eleanor-wsyy/EffMeet2/docs/handoff/README.md

# 交接记录入口

## 装配与硬件（现行）

[2026-10-21装配实施方案](2026-10-21-装配实施方案.md)：今晚装配执行版——跨轴 11 根、全杜邦、唯一焊点=喇叭端 2；屏接线与固件、P03 决策门、执行顺序。

机器人设计正文、BOM、模型与视觉稿统一在 [hardware/robot-design](../../hardware/robot-design/README.md)；历次打印作业包归档在 [hardware/print-jobs](../../hardware/print-jobs/README.md)。

## 软件与联调

[2026-10-20 ESP32 实机 bring-up](2026-10-20-esp32-bringup.md)：烧录、外设驱动、全链路现状与踩坑。

[2026-10-20 换机环境重建](2026-10-20-machine-switch.md)：换机后的环境重建与联调拓扑，异地演示前对照。

[2026-10-19 GitHub 新版用户端 APP 审查](2026-10-19-github-app-review.md)：远端 `apps/web` 已重写为纯本地演示版（localStorage，不接后端/音视频/ASR/AI/硬件）；建议保留功能版 `/app/`，新版作为 UI 参考或独立演示，不直接合并。

[2026-10-19路线A远程音频链路](2026-10-19-software-route-a.md)：用户端 LiveKit 入会/按需发布麦克风/离开、服务端 token 与 relay 解耦、CSP 放行；真实服务器与两端音频仍未验收。

[2026-10-16未完成软件搭框架](2026-10-16-software-scaffold.md)：ESP32 固件骨架、LiveKit 部署骨架、连续实机验收 harness，全部 NOT-VERIFIED/NOT_RUN。

[装配联调计划](2026-10-07-装配联调计划.md)（10-07；尺寸口径已被文首横幅作废）：机械装配后的功能联调七步，仍是计划而非执行记录。

[AFE 配置与双讲样例](2026-10-06-afe配置与双讲样例.md)（10-06）：AEC 目前为桩，这是后续实做时的配置与样例依据。

[场景测试用例表](2026-10-06-场景测试用例表.md)（10-06）：20 条演示/决赛前回归用例。

## 历史记录

10-05 台架交接组、10-06 任务单组、10-10 设计交接 stub 等已移入 [docs/archive/handoff/](../archive/handoff/)；旧版产品文档（整改、分工、D 端任务书等）在 [docs/archive/product/](../archive/product/)。历史记录只代表当日状态，不当作今日测试结果。

各记录按日期及模块判读；新增设计交接不自动表示软件、硬件或连续真人链路已经验收。
