eleanor-wsyy/EffMeet2/hardware/robot-design/layout-options/README.md

# 布局候选 · 二选一（2026-10-11 推出，未决策）

> **状态：两个候选并行准备，未选定。** 决策人：组长。决策前**不得下单 E04/E05，不得开模打印**。
> 本目录**不是 BOM，不替代** [round-yaw-v2/BOM.md](../round-yaw-v2/BOM.md)。BOM §12 在决策后统一更新，采购最终以 BOM §12 为准。

## 前提（两个候选共用）

- **主板走方案 W**：微雪 `ESP32-S3-CAM-OV3660`（一板替代原 E01+E02，板载 OV3660，Type-C，3.7V 充放）
- **材料**：**PLA Matte 哑光**（机身灰 / 细节黑，已下单 2 灰 + 1 黑），PETG 仅作 A1 配合验证件，普通 0.4mm 喷嘴
- **外观方向**：NOMI 球头 + 近圆黑面板 + 中央矩形 LCD 窗；形态服从功能位与实物尺寸，不反推概念图
- **打印路线**：A1 + PETG 打 1:1 配合样片 → 小件走 A1、三件大壳走学校 H2D/H2S（见 PRINT_PLAN §4.5）→ 去毛刺 → 螺接装配

## 建模先读：[`MODELING_BRIEF.md`](MODELING_BRIEF.md)

**美学锁死、工程重做。** 上一版（NOMI 方向）的审美模式原样保留，只换工程实现。
内含：美学不变量（禁止改动）、15 条「不许乱整」红线、因换主板/布局而变的工程变量、更新版功能位规格表 12 项。
旧功能位表（`archive/legacy-enclosure/EffMeet2_外壳说明_v2.md` §7）含旧尺寸 90×90×110 与旧 ±120°，**已作废**。

## 两个候选的本质差异

| | **方案 A · 板在底座** | **方案 B · 整板进头部** |
|---|---|---|
| 主板位置 | 底座 | 头部 |
| 跨轴线束 | **LCD FPC + 摄像 FPC + 电源 + 舵机 PWM + 键/灯**（多） | **电源 + 舵机 PWM + 键/灯**（少） |
| E04 / E05 | **必须买**（定长跨轴 FPC） | **删除** |
| **麦克风** | **固定在底座，拾音整间** ✅ | **随头转** ⚠️ 需改写 C06 |
| 头部重量/惯量 | 轻 | **重**，SG90 带载与 E10 供电须重核 |
| 过轴断帧/夹线风险 | **高**（两条 FPC 反复弯折） | 低 |
| 头部散热 | 无压力 | 主板在头，须核 |
| 装配复杂度 | 高 | 低 |
| 材料成本 | 多两条定长 FPC | 少 |
| 产品语义 | ✅ 麦不随头转，符合会议拾音 | ⚠️ 麦随头转，与既有结论冲突 |

## 决策判据（按权重）

1. **麦克风要不要随头转**——这是产品语义问题，不是工程问题。会议设备的麦应固定拾音整间；随头转会让转头动作改变拾音特性。
2. **过轴 FPC 能否接受反复弯折**——需要实测寿命，本轮只有 10 天，做不到 50 次循环以外的验证。
3. **SG90 带载余量**——方案 B 头部加重后，舵机啸叫/抖动若影响会议，即判不达标。

**倾向：方案 A。** 理由是判据 1 权重最高，且 A 的代价（多两条 FPC）是可控的采购与结构问题，B 的代价（麦随头转）是产品缺陷。

## 决策后必须同步修改的文档

- [ ] `round-yaw-v2/BOM.md` §12.1 末段声明（不采用微雪分支 → 采用 W + 选定布局）
- [ ] `round-yaw-v2/BOM.md` §12.2 的 E01 / E02 / E03 / E04 / E05 / E07 / E08 / E13
- [ ] `round-yaw-v2/BOM.md` §12.4 第一批清单
- [ ] `round-yaw-v2/BOM.md` §12.2 C01 机身色（白 → 灰，若最终用灰）
- [ ] `HANDOFF.md` 主板节（待定 → 已定）
- [ ] `round-yaw-v2/README.md` + `parameters.json`（标注封装布局需按选定布局重做）
- [ ] `manifest.json` **不动状态字段**（AGENTS.md：未验证项不能改写成已完成）
- [ ] 未选中的候选目录移入 `archive/`

## 与本目录相关的红线

- 本目录两个候选都是**计划**，不是已完成、不是 PASS、不是制造放行
- 不得以任一候选的尺寸反推当前 `round-yaw-v2/` 的 .blend 结论
- 两个候选的采购清单有**互斥项**（E04/E05），下单前必须先决策
