eleanor-wsyy/EffMeet2/hardware/robot-design/round-yaw-v2/fit-coupons/README.md

# 上机样片包 · 外观/材料样片 + 1:1 公差阶梯

> **材料用 PLA Matte 灰（2026-10-12 已到货）**——用它打，选出的公差档就是正式件的档位。
> 黑色 PLA Matte 尚未到货；以下 5 件**颜色无关**（A0 球冠模拟的头壳本身就是灰色），**用灰料全打**。
> **在自有 A1 打**，不必占用学校机时（学校留给三件灰料大壳）。
> PETG 仅在 PLA 未到货时作过渡；**PETG 的档位不能直接当正式料档位**（收缩率不同）。

## A0_appearance_coupon.stl —— 外观／材料样片（**先打这个**）

单件，148×97×54mm，落在平台上（Z 0→53.8），一盘可打完。

| 部位 | 验什么 |
|---|---|
| **球冠 R70 × Ø88** | **曲面质量与层纹**（贴近头壳曲率 70mm 量级）——判断哑光观感是否可接受 |
| **45° 悬臂** | **支撑痕**（需支撑，看接触面质量） |
| **2.4mm 薄壁** | 名义壁厚是否透光/变形 |
| **孔阶梯 Ø2/3/4/5/6** | 小孔成形质量 |
| **R4 圆角块** | 倒角/圆角表面 |
| **竖直平面** | 层线密度与均匀度 |

**判据**：PRINT_PLAN 要求「样片接受裸打哑光后才继续」。**这一件就是那个判据的载体。**
- 接受 → 记录层高/朝向参数，采买正式件
- 不接受 → 换层高/朝向重打，或重估外观预期

**切片起点**：0.2mm 层高、3–4 墙、20–30% 填充、**开启支撑**（45°悬臂需要）、平放不加裙边。

---

**用途**：验「装不装得进、哪一档公差合适、装配顺序对不对」。**不验最终材料强度。**
最终公差要在正式材料（PLA Matte）上再打一组同尺寸复验。
生成脚本：`generate_fit_coupons.py`（Blender 无头，`blender --background --python generate_fit_coupons.py`）。

尺寸来源：`BOM.md` §12.2 —— M02 轴承 6806 = **内径 30 / 外径 42 / 厚 7**；M01 舵机 MG90S 本体 **22.8×12.2×28.5**；转轴名义外径 **46**；头-底座间距 **14**。

---

## 01_bearing_OD_ladder.stl — 轴承外圈压配（188×52×7）

四档 Ø42 孔，从左到右：

| 位置 | 孔径 | 用途 |
|---|---|---|
| 1（最左） | **Ø42.0** | 名义值，通常过紧 |
| 2 | **Ø42.2** | |
| 3 | **Ø42.4** | 通常最接近可用 |
| 4（最右） | **Ø42.6** | 偏松 |

**怎么判**：手压轴承外圈进孔。**能推进去、不晃、不裂**的最小那档就是设计值。
⚠️ **不许用锤子强装**——PLA/PETG 脆，强压会裂（`BOM.md` M04 明确要求分体夹紧/螺接，不做强过盈）。

## 02_bearing_ID_and_shaft_ladder.stl — 内圈/轴配合（208×52×7）

从左到右：

| 位置 | 孔径 | 用途 |
|---|---|---|
| 1 | **Ø30.0** | 轴承内圈名义 |
| 2 | **Ø30.1** | |
| 3 | **Ø30.2** | |
| 4（最右） | **Ø46.0** | **转轴名义外径校核** |

**怎么判**：Ø30 三档试轴承内圈 / 轴肩；Ø46 试转轴外径是否打得准。

## 03_servo_pocket_and_wall.stl — 舵机口袋 + 壁厚/孔质量（90×70×6）

| 部位 | 内容 |
|---|---|
| 左半凹槽 | **MG90S 口袋 22.8×12.2，深 5mm** |
| 凹槽两侧 | 舵机固定耳孔 **Ø3.2**（间距 32mm，**按实测再调**） |
| 右上一排 | 通孔阶梯 **Ø2 / Ø3 / Ø4 / Ø5 / Ø6** |
| 右下窄梁 | **2.4mm 名义壁厚**（看层纹与强度观感） |

**怎么判**：舵机能不能落进口袋、耳孔对不对得上、孔是否圆、壁厚梁是否透光/开裂。

## 04_shortneck_clearance.stl — 短颈裙边间隙（Ø58×14）

外径 Ø58（= 46 轴 + 两侧各 6 壁）、内孔 **Ø46**、**高度 14 = 头-底座真实间距**。

**怎么判**：套在转轴上看 14mm 这段里裙边能不能藏住、又留出诚实间隙（见 [`../MODELING_BRIEF.md`](../MODELING_BRIEF.md) §1.5：装饰裙边必须与底座有可见间隙，不许焊死、不许为好看缩间距）。

---

## 上机安排（2026-10-12）

**分两盘**（A1 256³）：

| 盘 | 件 | 层高 | 支撑 | 说明 |
|---|---|---|---|---|
| **盘1** | `A0_appearance_coupon` | 0.2mm（可另跑 0.16 对比） | **开** | 单独一盘，看观感；95×148，居中 |
| **盘2** | `01` + `02` + `03` + `04` | 0.2mm | 不需要 | 01(188×52) 与 02(208×52) 上下叠放，03(90×70) 与 04(58×58) 并排放下方 |

> 盘2 总占约 208×174，A1 摆得下。两盘都可一次跑完。

## 打印参数（PLA Matte 为主）

| 项 | 建议 |
|---|---|
| 材料 | **PLA Matte（正式料）**；PLA 未到货时 PETG 过渡 |
| 层高 | 配合样片 0.2mm；**外观样片可试 0.16 / 0.2 对比** |
| 墙 | 3–4 |
| 填充 | 20–30%（样片不需要实心） |
| 支撑 | 仅 A0 的 45° 悬臂需要；配合样片不需要 |
| 朝向 | 平放，孔轴朝 Z |

## 旧表（保留）

| 项 | 建议 |

| 项 | 建议 |
|---|---|
| 层高 | 0.2mm |
| 墙 | 3–4 |
| 填充 | 20–30%（样片不需要实心） |
| 支撑 | 不需要（全是通孔/开口朝上） |
| 朝向 | **平放**，孔轴朝 Z |
| 材料 | 见上 |

## 打完记录

把结果写进 `TEST_RECORD_TEMPLATE.csv`，或直接记：

```
01 轴承外圈：Ø42.__ 合适 / 02 内圈：Ø30.__ 合适 / 02 轴径 Ø46 实测 __
03 舵机口袋：松紧 __ / 耳孔对位：对/差 __mm
04 短颈 14mm：间隙 OK / 夹线 OK
```

**这四档里挑出来的数值，就是后面正式建模 `parameters.json` 要写进去的设计值。**
