eleanor-wsyy/EffMeet2/hardware/robot-design/round-yaw-v2/stl/README.md

# 历史STL草案：不是v4打印放行包

保留本目录既有STL用于追溯。它们由旧build_print_parts.py生成，不能对应当前GOOUU／NOMI-v4的屏窗、头颈接收、动态走线和真实支架。

**不要直接整机打印／下单。** 当前入口见[新版v4](../revision-20261011-nomi-layoutA/README.md)，正式打印条件见[PRINT_PLAN](../PRINT_PLAN.md)。配合样片可在核尺寸和打印安全后单独试验，不代表全件通过。
