eleanor-wsyy/EffMeet2/hardware/enclosure/EffMeet2_外壳说明_v2.md

# 外壳说明v2（历史入口）

原文已移至[历史外壳说明](../robot-design/archive/legacy-enclosure/EffMeet2_外壳说明_v2.md)。

当前圆润转头版见[统一README](../robot-design/README.md)、[交接说明](../robot-design/HANDOFF.md)及[当前BOM](../robot-design/round-yaw-v2/BOM.md)。旧说明不是当前外观/打印规格。
