eleanor-wsyy/EffMeet2/hardware/robot-design/round-yaw-v2/GOOUU-BOARD-SPEC.md

# GOOUU ESP32-S3-CAM · 硬件规格（建模依据）

> **⚠️ 2026-10-13 v6/A2 口径更新（优先于下文 v4 内容）：** 核心板装在**头部**（旧"板在底座"作废）；**电池/TP4056 推迟到路线B/决赛，本轮不装、不买**；**扩展板实测 95×87×12 放不下，v6 不装**；底座内腔与整机按 v6/A2 重建（153×139.4×200.8）。下文 §4.5/§5/§6 的扩展板与电池讨论仅作历史。

> **安装安全补充（v4）：** 采购与下单记录保持不变。排针上存在GPIO不等于可随意分配；摄像／SPI触摸／I2S／PSRAM／启动脚／LED必须统一核表。HSD028309丝印和14针只能支持SPI推断，不能证明驱动型号或实际针序。TP4056保护版不是5V升压、也不自动支持安全边充边用；Demo默认外置5V，电池独立运行另验。扩展板未实测，当前模型不声称它放得下。

> 来源：淘宝「深圳市轩特佳电子」商品页 + 官方尺寸图/引脚图抓取，2026-10-12。
> **当前采购口径。** 微雪 ESP32-S3-CAM-OV3660 的评估已归档到 `archive/waveshare-board-eval-20261012/`。

---

## 0. 一句话结论

**买得到、明天到、尺寸已知（62.6×28.3mm），但没有板载音频**——麦克风/功放/电池管理要靠外接模块补。
选它的唯一理由是**交付速度**：微雪那块省事得多（板载双麦 + 音频编解码），但国内拿货要等。

---

## 1. 商品与采购

| 项 | 值 |
|---|---|
| 商品 | **GOOUU ESP32-S3-CAM 核心开发板**（+ 可选扩展板） |
| 店铺 | 深圳市轩特佳电子（4.7 分、7 蓝冠） |
| 销量/口碑 | **已售 2000+、评价 700+、近 3 月好评 100%**、回头客 140 |
| 价格 | 单板 **¥7 起**；**已下单套装 ¥86.5** |
| 物流 | **今日发、次日 18 点前到**（深圳→广州） |
| 售后 | 7 天无理由、极速退款 |
| 链接 | https://item.taobao.com/item.htm?id=865566019186 |
| **下单记录** | **2026-10-12 已下单 SKU ⑩「核心板+OV3660+扩展板+2.8寸TFT」，¥86.5，预计次日达** |

### 该选哪个 SKU

| SKU | 买？ |
|---|---|
| **核心板+OV3660+扩展板+2.8寸TFT** | ✅ **已下单（¥86.5）**——一套齐、有实拍在跑 |
| ESP32-S3-CAM（带 OV3660 摄像头） | 备选：不想带扩展板/屏时选这个 |
| ESP32-S3-CAM 单板（不带摄像头） | ❌ 没镜头 |
| ESP32-S3-N16R8 模组 | ❌ 只是裸模组 |
| 单独扩展板 | 按需，见 §5 |

---

## 2. 板体尺寸（尺寸图实测标注）**建模直接可用**

| 参数 | 数值 |
|---|---|
| **板长** | **62.6 mm** |
| **板宽** | **28.3 mm** |
| 排针内侧间距 | 24.7 mm |
| 排针间距 | 2.54 mm（标准） |
| 摄像头 | 经 FPC 连出，**镜头突出量待实物实测** |
| Type-C 凸出量 | **待实物实测** |

---

## 3. 引脚（全部 GPIO 引出到 2.54mm 排针）

| 位置 | 引脚 |
|---|---|
| 左列（上→下） | `3V3` `G4` `G5` `G6` `G7` `G15` `G16` `G17` `G18` `G3` `G46` `G9` `G10` `G11` `G12` `G13` `G14` |
| 右列（上→下） | `3V3` `G43` `G44` `G1` `G2` `G42` `G41` `G40` `G39` `G38` `G37` `G36` `G35` `G0` `G45` `G48` `G47` `G21` `G19` `G20` |
| 底部 | `5V` `RST` `BOOT` `GND` + USB |

**关键**：`G10–G14` 都在排针上 → **I2S 可以用**（外接麦克风与功放）。
`G0` 是 BOOT 键，可复用为停止键。

---

## 4. 板载有什么 / 没有什么

| 有 | 没有（必须外接） |
|---|---|
| ESP32-S3-**N16R8**（16MB Flash + 8MB PSRAM） | ❌ **麦克风** |
| 摄像头 FPC 座（OV2640/OV3660/OV5640 可选） | ❌ **音频编解码（ES8311/ES7210）** |
| **USB Type-C**（+ 另一 USB 口） | ❌ **功放（NS4150B）** |
| TF 卡槽 | ❌ **喇叭接口** |
| **W2812B RGB 灯** | ❌ **电池充放管理** |
| 0.96″ OLED 座 | ❌ 18PIN LCD 专用座（屏经排针接） |
| 45 GPIO / SPI / **I2S** / I2C / PWM / RMT / ADC / UART | |

**⚠️ 对方案的影响**：「可核对的会后记录」依赖麦克风拾音，本板无麦 → 必须外接，**这是选它付出的代价**。

---

## 4.5 套装里额外含「扩展板」——体积要留意（历史讨论；v6 结论：不装）

商品实拍显示：核心板插在**扩展板**上，扩展板带屏幕座、Type-C、蓝色接线端子、排针，2.8″ TFT 直接插上即可运行。

**v6 结论（2026-10-13）：扩展板实测 95×87×12，放不下，不装。** 以下决策点仅作历史：
- ~~用扩展板：省接线、有屏幕座，但整体体积大，底座内腔 180×164×76 塞不塞得下要算~~（旧 v4 内腔；v6/A2 已重建为整机 153×139.4×200.8）
- 不用扩展板：核心板直接排线接屏与模块 ← **v6 采用这条**

## 5. 外接件（v6 实配：麦＋功放；电池/TP4056 推迟）

| 件 | 型号 | 数量 | 作用 | 参考价 |
|---|---|---|---|---|
| I2S 麦克风 | **INMP441** | **2** | 双麦拾音（替代板载麦阵列） | ¥8–15/个 |
| I2S 功放 | **MAX98357A** | 1 | 接喇叭播放提醒 | ¥8–12 |
| 锂电充电／保护 | **TP4056**（带保护） | **0（推迟）** | v6 不装；路线B/决赛再议 | — |

**代价（如实记录）**：
- 多 3 类模块 + 接线，比微雪方案麻烦
- **AEC 更难**：无硬件回声参考通路，只能软件兜底
- 双麦阵列要自己搭，声学通道自己设计
- **C06 麦孔不再按整板开**，改为按 **INMP441 模块**安装位开

---

## 6. 对建模的直接结论

| 项 | 结论 |
|---|---|
| **板体尺寸** | ✅ **62.6 × 28.3 mm**，可立即开腔体 |
| 摄像头 | 经 FPC 外接，**镜头位置由实际安装方式定**，到货实测 |
| 麦克风 | 装 **INMP441 ×2**，固定在**底座**（不随头转；v6 布局A2：麦/功放/喇叭/舵机/按键都在底座） |
| 喇叭 | MAX98357 → 扬声器，底座前部声槽不变 |
| 电池 | **不装**（v6 外供 5V≥2A；TP4056＋锂电推迟到路线B/决赛） |
| 屏 | **2.8″ TFT 带触摸（随套装）**：面板丝印 `HSD028309 A6`；**单排 14 针 J2 连接器** → 判定为 **SPI**（高置信度，非规格书）；标准分配 VCC/GND/CS/RESET/DC/MOSI/SCK/BL/MISO + 触摸 5 线 |
| 停止键 | 复用板载 `BOOT(G0)` 或另接轻触开关 |
| 舵机 PWM | 核空闲可输出GPIO及启动／摄像／屏／音频占用后用LEDC/RMT |

---

## 7. 仍缺的（到货当天实测）

| 缺项 | 怎么拿 |
|---|---|
| 镜头突出量 | 卡尺实测 |
| Type-C 凸出量 | 实测 |
| 摄像头 FPC 出口方向与长度 | 实测 |
| 扩展板外形尺寸（若用） | 实测 |
| INMP441 / MAX98357 模块外形 | 到货实测 |

---

## 8. 参考

| 资源 | 地址 |
|---|---|
| 商品页 | https://item.taobao.com/item.htm?id=865566019186 |
| 资料网盘（含烧录视频教程） | 见商品图文详情 |
| 微雪方案评估（已归档，未采用） | `archive/waveshare-board-eval-20261012/WAVESHARE-BOARD-SPEC.md` |

> **未采用微雪的原因**：国内拿货要等（官方店海外仓/代理链路），赶不上 10.21。
> 若后续微雪国内现货到位，其**板载双麦 + ES8311/ES7210 + NS4150B** 明显更省事，可再评估切换。
