eleanor-wsyy/EffMeet2/hardware/robot-design/round-yaw-v2/MODELING_BRIEF.md

> **v5/v4 均为历史；当前见 [v6](revision-20261011-nomi-layoutA/print-split-v6/README.md)。** 本文以下为 v4 建模任务书，仅作追溯。

# 建模更新任务书 · 美学锁死 / 工程重做（2026-10-11 · 布局 A 已定案）

> **⛔ 历史建模任务书（v4，2026-10-11）。** 现行执行是 v6 布局A2（板/屏/摄像头在头部）、32 件；**TP4056/电池推迟、扩展板不装**。尺寸以 parameters.json 与 [v6 README](revision-20261011-nomi-layoutA/print-split-v6/README.md) 为准；下文的 180×164×222、Ø106、1:1 传动与 TP4056 预留仅供追溯。

> **原则：上一版（NOMI 方向）的审美模式原样保留；只换工程实现。**
> 来源：`round-yaw-v2/concept/nomi-aligned-20261010/prompt.txt`（审美契约原文）+ `round-yaw-v2/EXTERIOR_ASSEMBLY_REVISION.md`（组装接口）。
> **本文件不是 CAD、不是制造放行、不是实机验收。** 未验证项一律不得标 PASS。

---

## 0. 为什么写这份

工程方案变了（主板 Korvo → **GOOUU ESP32-S3-CAM**，屏/相机/线材随之更换），但**外观审美不许跟着乱动**。
仓库里 `archive/legacy-enclosure/EffMeet2_外壳说明_v2.md` §0.1 记着 v3-a 的失败教训：

> 「仅用形态描述建模……结果**功能全丢**。**教训：形态描述会压倒功能描述，功能必须逐项显式点名。**」

本次的对偶风险是反过来的：**工程改造会压倒审美**。所以这份文件把审美先锁死，再改工程。

---

# 第一部分 · 美学不变量（**禁止改动**）

以下逐条摘自已认可的 NOMI 方向审美契约。**建模时逐条对账，任何一条不满足即打回。**

## 1.1 头部形态

- 近球形、轻微压扁的柔软头部，名义 **150 × 128 × 144 mm**
- 灰色PLA Matte柔和外壳，**真实球面侧体量、圆剪影**
- **禁止方脸颊、方形侧壁**
- 分模缝细、零件边界极少
- 头部几何可极轻微朝上，但**不得增加任何俯仰机构**
- **禁止**：椭圆肖像框、圆角方屏、巨大白额头上的小黑药丸

## 1.2 面部语言（这是审美核心）

- **Ø104–108 mm 圆形黑面板**，居中偏前，周围只留克制的白壳边
- 必须读作「球头上的一个黑圆」，**不是**显示屏、**不是**圆角矩形监视器
- 圆面板是**哑光打印炭黑板**（PLA Matte 裸打），**不是**圆屏、**不是**玻璃罩、**不是**光学透明片
- 中央是**真实矩形 LCD 贯通窗**；屏面接近齐平，矩形边是**低对比细缝**，近看才隐约可见
- **禁止**：粗凸起的矩形边框、大面积高光圆片、曲面玻璃、宣称"完美 OLED 黑"

## 1.3 眼睛

- **只有两只**，在矩形 LCD 有效区**内**（不得溢出 49mm 屏宽）
- 暖白色、柔和弯月形闭眼/微笑，或简单直立小椭圆，表情松弛
- **眼睛是视觉焦点**——不是"小平板贴在大盘子上"
- **禁止**：嘴、文字、其他 UI 元素

## 1.4 摄像头与隐私

- 小镜头 + **物理滑动遮罩**，位于圆面板内**上部居中**
- 低对比黑细节，融入深色板；镜头近看可见，滑盖齐平
- **禁止**：明显方块徽章、把摄像头移到白额头、为视觉隐藏而删掉隐私操作

## 1.5 转颈（短、藏）

- **极短居中 yaw 接头**，轴外径名义 **46 mm**，头-底座真实间距 **14 mm**
- 克制的嵌套壳/领口 + 阴影间隙，把转轴**藏在球头下缘**
- 装饰裙边**必须与固定底座有诚实间隙**——不焊死、不悬空飘头
- **禁止**：高白管/黑管、为藏转轴而缩小真实机械间距、把裙边与底座粘连成环

## 1.6 底座

- 软圆灰色椭圆鹅卵石，**180 × 164 × 76 mm + 2mm 黑硅胶脚垫**
- 产品总高约 **222 mm**；**头部明显比底座窄**
- 平滑宽肩、下缘圆角，**有实质内部体积**
- **禁止**：薄的 NOMI 车机垫、花瓶细腰、第二层叠底座
- 保留既有上盖/杯体细缝，可拆修

## 1.7 开孔与细节

- **扬声器**：直接开在下前白壳，**3–4 条短槽、宽约 35–40 mm**，**无对比色喇叭徽章**
- **麦克风**：小而安静的开孔
- **停止键**：前肩部**小齐平帽**
- **状态指示**：**微小暖珊瑚色短划**（在底座）——不是环形灯带、不是 RGB 灯带
- **外供电**从**后部固定底座**进入，**无可见乱线**
- 硅胶脚垫薄、黑、大部分隐蔽

## 1.8 材质与质感

- **灰 + 黑，未喷漆哑光 PLA Matte**，裸打，**全部打印件同一种料**（件数以拆分结果为准）
- 真实细聚合物纹理 + 细微规则层纹
- **禁止**：绒面 / 石膏 / 水泥质感
- 圆面板的反光**只应来自里面的矩形 LCD**——不得把打印面做成/画成光学玻璃
- **PLA Matte 热变形约 55℃**：结构设计不得依赖高温工况；散热缝与内部风道仍按 §第四部分 保留

---

# 第二部分 · 「不许乱整」红线清单

任何一条命中即打回重做：

| # | 禁止项 |
|---|---|
| 1 | 加耳、帽、手臂、金属饰条、品牌标识 |
| 2 | 砂磨、补土、喷漆、退火、喷漆服务 |
| 3 | 激光切割亚克力/PC 透明罩、圆屏/AMOLED、LED 灯带 |
| 4 | 复制 NOMI 商标、车内安装、音乐图标、吐舌表情 |
| 5 | 带回上一轮的「小横窗 / 大白脸颊」 |
| 6 | 做成椭圆肖像框或圆角方屏 |
| 7 | 把摄像头移到白额头 |
| 8 | 为藏转轴而缩小真实机械间距（14mm 不许动） |
| 9 | 为好看而缩孔、缩小声槽、盖住麦孔 |
| 10 | 移动实板麦孔去迎合图上的对称装饰 |
| 11 | 把 PLA Matte 打印面做成/画成玻璃或高光 |
| 12 | 用涂料修补装不上的接口 |
| 13 | 编造爆炸图、制造放行、实机验收结论 |
| 14 | **只写形态描述不逐条点名功能位**（v3-a 原罪） |
| 15 | **让工程改动吃掉上表第一部分的任何一条**（本次的对偶风险） |

---

# 第三部分 · 工程变量（本次真正要改的）

## 3.1 因换主板而变

| 项 | 原（Korvo） | 新（GOOUU ESP32-S3-CAM） | 对建模的影响 |
|---|---|---|---|
| 主板 | Korvo-2 V3.1（底座） | **GOOUU ESP32-S3-CAM（62.6×28.3mm，含 OV3660）** | 板体尺寸已知，**预留盒按此重做** |
| 屏 | 乐鑫 Korvo-2-LCD 2.4″（有效区约 49×37mm） | **2.8″ SPI TFT（240×320）** | **圆面板 Ø104–108 与中央矩形窗按 240×320 竖放重算**；1.2 的面板语言保持不变 |
| 摄像头 | 外接 OV2640 | **OV3660 经 FPC 接板** | 镜头为**独立模组**，安装位由我们定；面板开孔按实际安装迁就，不为对称好看挪孔 |
| USB | Micro-USB | **Type-C** | 底座侧面浅凹槽**重开**（1.7 的位置语言不变） |
| 舵机 PWM | 可能要 E13 扩展板 | LEDC/RMT 直出 | E13 删除，内部空间释放 |
| 电池 | 无 | **3.7V 锂电 + TP4056 模块** | 底座内部容积/重心重算 |
| 音频 | ES7210/ES8311/NS4150B | **GOOUU 板无音频** → 外接 **INMP441×2 + MAX98357** | 麦/喇叭全部外接；**AEC 只能软件兜底，风险高于原方案** |

## 3.2 布局 A（已定案）带来的工程变量

| 项 | 内容 |
|---|---|
| 主板位置 | **底座**（与电源、电池、扬声器、舵机同舱） |
| 头部腔体 | **只装 LCD + 摄像头**（轻，利于转头） |
| 跨轴通道 | **LCD（E04，SPI 6–8 芯）+ 摄像（E05）** + 电源 + 舵机 PWM + 键/灯。引脚与尺寸见 [`GOOUU-BOARD-SPEC.md`](GOOUU-BOARD-SPEC.md) |
| **麦克风** | **固定在底座上缘，不随头转**（C06 维持原结论） |
| 扬声器 | 底座前下，3–4 条短槽 |
| 散热 | 底座内主板 + 电源，背部细缝保留 |
| 头部重量 | 轻，SG90 带载宽松 |

**美学不变量在布局 A 下不变**——开孔的归属件固定为：麦孔/声槽/USB/状态短划在底座，屏窗/镜头/滑盖在头部。

---

# 第三部分之二 · 建模任务清单（布局 A，逐件）

> 按 AGENTS.md：保留原生 Screw/Boolean 控制、分件与姿态依赖；未验证项不得标 PASS；不导出伪参数 CAD。
> **前置：板体尺寸已知（62.6×28.3mm）**，可直接开腔体；镜头/Type-C/FPC 出口到货实测后回填。

| # | 零件 | 要做什么 | 关键约束 |
|---|---|---|---|
| 1 | **头壳** | 腔体只容纳 LCD＋摄像头（轻）；预留 FPC 过轴通道与弯折半径；**镜头开孔坐标由实板决定** | 过轴孔不得夹线；内悬垂可取支撑；面罩口 Ø104–108 不变 |
| 2 | **底座杯体** | 容纳 GOOUU 主板、TP4056+锂电、5V 电源、扬声器、舵机、按钮；**预留 INMP441×2 麦模块位与 2 路声孔** | 板柱/出声孔/麦孔直接建入 CAD；底面朝下、杯口朝上 |
| 3 | **底座上盖** | 保留可拆接缝 + 转轴孔；承力区局部加肋 | 接缝藏于隐藏面 |
| 4 | **圆形黑面板** | 近圆黑框 + 中央真实矩形 LCD 窗贯通 | **窗尺寸按新屏（E02′）重算**；屏自带面板露出，不做透明盖 |
| 5 | **短颈** | 颈内藏边 + 两条 FPC 通过空间 | 与头壳接收面配作；裙边留诚实间隙 |
| 6 | **轴承座 ×2** | 按 6806（30×42×7）实尺寸 | **分体夹紧/螺接**，不做强过盈；先打轴配合样片 |
| 7 | **舵机架** | 按 MG90S 实测固定耳/花键 | 不自造未经核验的花键 |
| 8 | **轮毂/连接盘** | 与轴承座、舵盘配合 | 螺接，不胶粘定位 |
| 9 | **同齿数带轮 ×2** | 齿形 + 中央孔按实测 | 先验证齿形/花键连接 |
| 10 | **滑盖/按钮帽/线夹/硬声学通道** | 同批黑料小件 | 滑槽行程靠试片调 |
| 11 | **过轴通道结构（A 特有）** | LCD SPI + 摄像排线的固定、导向、防夹、限弯 | 线序到货点清后定；仍须 1:1 打样验证 50 次循环 |
| 12 | **parameters.json** | 记录新腔体/孔位/过轴尺寸 | 未实测项标 `unverified` |

### 建模顺序（按风险）

1. **过轴通道 + 头壳 LCD/摄像支架**——先证布局 A 成立
2. 底座杯体（主板/电池/扬声器/麦孔布局）
3. 面板 + 短颈 + 上盖
4. 受力件（轴承座/舵机架/轮毂）
5. 小件

### 验收要点

| 项 | 通过标准 |
|---|---|
| **过轴 FPC 寿命** | 连续 50 次 ±45° 转向无断屏/断帧/断线（**第一验收项**） |
| 夹线 | 转动全程不夹线、不磨线 |
| 转向 | 1–2s 单次、头角误差 ≤3°、无啸叫影响会议 |
| **麦克风拾音** | **底座固定双麦**，1m 正常说话可转写、3m 小声触发 AGC |
| AEC | 重测（换板必做）；初赛不阻塞，决赛 11.5 前必须 |

---

# 第四部分 · 功能位规格表（更新版，建模强制输入）

> 原表见 `archive/legacy-enclosure/EffMeet2_外壳说明_v2.md` §7，含**旧尺寸 90×90×110 与旧 ±120°**，已作废。
> 下表按当前 round-yaw-v2 尺寸与 NOMI 审美契约重写，**建模时逐条点名**。

| # | 功能位 | 位置 | 数量/规格 | 可见性 | 本次变更 |
|---|---|---|---|---|---|
| 1 | 圆形黑面板 | 头部正面居中 | **Ø104–108mm** 哑光打印炭黑板 | 外露 | 面板直径起点不变；**中央矩形窗按新屏重算** |
| 2 | 双眼 | 矩形 LCD 有效区内下部 | 左右各 1，暖白弯月/小椭圆 | 屏内显示 | 屏变则眼距按比例；**不得溢出屏宽** |
| 3 | 摄像头 | 圆面板内**上部居中** | 1 颗小型广角 | 近看可见 | **改板载 OV3660，开孔坐标由实板决定** |
| 4 | 遮罩拨片 | 镜头旁 | 1 个上下拨动拨片 | 外露可拨 | 随板载镜头位置重排 |
| 5 | 停止/静音键 | **前肩部** | 1 个小齐平帽 | 外露 | 不变（B 则信号过轴） |
| 6 | 状态指示 | **底座前部** | 1 条微小暖珊瑚短划 | 外露发光 | 不变；**不是环灯带**（B 则信号过轴） |
| 7 | 舵机颈段 | 头与底座之间 | 短颈 + 轴外径约 46mm，**±45°** | 外露，裙边留诚实间隙 | **腔内走线通道按 A/B 重做**；间距 14mm 不许动 |
| 8 | 麦克风 | **底座上缘（布局 A）** | **2× INMP441 模块**，安装位由我们定 | 微孔可见 | **模块外接**，不随头转；开孔按模块尺寸 |
| 9 | 扬声器开孔 | **A：底座前下 / B：待定** | 3–4 条短槽，宽 35–40mm | 槽可数 | **不加对比色徽章**；开孔率/声腔另测 |
| 10 | USB-C | 底座侧面 | 1 个，带浅凹槽 | 外露 | **Micro-USB → Type-C，凹槽重开** |
| 11 | 散热缝 | 背部中线 | 1 条细长缝 | 外露 | 不变；**B 方案内部加散热路径** |
| 12 | 硅胶脚垫 | 底面 | 1 圈环形约 2mm | 底部 | 不变 |

**建模 prompt 必带句式**（替代旧的 90×90×110 版本）：

> 形态比例（**180×164×222mm**，头 150×128×144，底座 180×164×76+2mm）+ 上表 12 项**逐条点名** + 材质（灰色哑光 PLA Matte 裸打 / 炭黑哑光 PLA Matte 面板 / 屏内暖白眼睛 + 底座微小珊瑚短划）+ 纯中性背景。
> **只写「圆润造型 + 黑面板」会丢掉全部功能位。**

---

# 第五部分 · 建模作业约束（按 AGENTS.md）

- 保留模型**原生 Screw/Boolean 控制**、分件与姿态依赖
- 新建模遵循适用 Blender 技能；不以预览动画代替固件验收
- `parameters.json` 与现有 `.blend` 的旧检查证据**不改写**；新参数另记并标 `unverified`
- `manifest.json` 的 `stage` **保留 `reversible_blockout`**（枚举）；`manufacturing_ready` / `hardware_validated` **保持 false**
- 不导出伪参数 CAD（不把三角网格换后缀充当 STEP）
- **导出白名单**：只导出已完成结构的零件；排除 MAINBOARD/LCD/CAMERA/SERVO/BEARING/SPEAKER 代理、KEEP_OUT 与布尔控制

## 建模顺序

1. **先无电测件**：新屏总厚度/有效区、板载镜头突出量、FPC 出口方向、Type-C 凸出量
2. **圆面板 + 矩形窗**（审美核心，先定死）
3. 头部腔体（按 A 或 B）
4. 短颈 + 转轴接收面（14mm 间距、46mm 轴径）
5. 底座杯体 + 上盖
6. 受力件（轴承座/舵机架/轮毂/带轮）
7. 小件（滑盖/按钮帽/线夹/声学通道）
8. 更新 `parameters.json`（新参数标 unverified）

---

# 第六部分 · 与本文件配套

| 文件 | 关系 |
|---|---|
| `concept/nomi-aligned-20261010/prompt.txt` | **审美契约原文**，本文件第一部分的来源 |
| `round-yaw-v2/EXTERIOR_ASSEMBLY_REVISION.md` | 组装接口与装入顺序 |
| `layout-options/README.md` | A/B 二选一与决策判据 |
| `layout-options/layout-A-base-board.md` / `layout-B-head-board.md` | 各布局的采购 + 建模包 |
| `archive/legacy-enclosure/EffMeet2_外壳说明_v2.md` §7 | **旧功能位表（含旧尺寸/±120°，作废）** |

**已定**：布局 A、机身灰/细节黑（PLA Matte 已下单）、打印走 A1 + 学校机器分工、主板 GOOUU（**板体 62.6×28.3mm 已知**）。**可开工**：不依赖摄像/屏实物的零件先建；腔体按 62.6×28.3 预留，实物差异到货回填。
