eleanor-wsyy/EffMeet2/hardware/robot-design/layout-options/layout-B-head-board.md

# 方案 B · 整板进头部（2026-10-11 候选，未决策）

> **状态：候选，未选定。** 决策前**不得开模**。
> 本文件不是 BOM；采购最终以 `round-yaw-v2/BOM.md` §12（决策后更新）为准。

**一句话**：微雪整板连 LCD、摄像头、麦克风全进头部；底座只留舵机、电源、电池、按钮/灯。跨轴只剩电源 + 舵机 PWM + 键/灯等低速细线，**E04/E05 可删**。代价是**麦克风随头转**、头部加重。

---

## 1. 采购清单

### 1.1 与方案 A 共用（两套都要买，可先下）

| ID | 物料 | 数量 | 参考 | 备注 |
|---|---|---|---|---|
| E01 | **微雪 ESP32-S3-CAM-OV3660** | 1 | ≈¥180 | **必须 OV3660 版**（带硬件 JPEG；GC 系列没有） |
| E02′ | 微雪 18PIN FPC 屏模块 | 1 | 待定 | 2.0″ 或 2.8″，**必须先拿接口定义再下单** |
| E06 | 4Ω/3W 扬声器 ≤Ø40×18 | 1 | — | **本方案放头部**，深度约束更紧，须核头部容积 |
| E07 | Type-C 数据线 | 1 | 复用 | 烧录/日志，必须传数据 |
| E08 | Type-C 供电线 | 1 | 复用 | 足够电流 + 插头弯曲空间 |
| E09 | 5V/≥2A 合规电源 | 1 | 复用 | 不是裸无保护板 |
| E10 | 舵机独立稳压供电 + 保护线 | 1套 | — | **本方案头部加重，须核额定与压降** |
| E11 | 轻触开关 / 板载 MUTE 引出 | 1套 | — | **键位在底座，信号须过轴** |
| E12 | 板载状态灯 + 导光窗 | 0 新增 | — | **灯在底座，信号须过轴** |
| 新增 | 3.7V 锂电池（板载充放） | 1 | 待定 | 演示可脱线 |
| M01 | MG90S 位置舵机 | 1 | — | **本方案带载更大，啸叫/抖动须实测** |
| M02 | 6806-2Z/ZZ 轴承 30×42×7 | 2 | — | 旧 56×18 预留不保证仍在 |
| M03 | 打印同齿数带轮 + GT2 带 | 2 + 1 | — | 长度按 CAD |
| M04 | PLA Matte 轴承座/舵机架/轮毂 | 各1套 | — | 与外壳同材同喷嘴，螺接 |
| M05 | 软行程 + 机械挡块 | 左右各1 | — | 软目标 ±45° |
| M07 | 线夹 + 柔性护套 | 1套 | — | **走线按本方案重做**（只剩细线） |
| M08 | 接插件/线材/绝缘件 | 小套装 | — | 杜邦线不作最终活动线束 |
| M09 | M2.5/M3 螺钉、安装柱、黄铜嵌件 | 小套装 | — | 定长螺钉等实板 |
| C01 | 头壳 / 底座杯体 / 上盖 | 各1 | PLA Matte 灰 | **腔体结构按本方案重切** |
| C02 | 近圆黑面板（面罩框） | 1 | PLA Matte 黑 | 中央矩形 LCD 窗贯通，不采购透明板 |
| C03 | 隐私滑盖 + 打印导向 | 1套 | PLA Matte 黑 | 同批打印 |
| C04 | 按钮帽 + LED 出光小孔 | 1 + 0 | PLA Matte 黑 | 取消第三色/喷漆 |
| C05 | 闭孔硅胶/EPDM 声学垫片 | 小片 | 买现成片材 | 不打印密封圈 |
| C06 | **头部**麦声孔通道 + 密封片 | 2路 | — | **孔位按实板；麦随头转，C06 必须改写** |
| C07 | 防滑硅胶片 ≈2mm | 1份裁切 | 买现成 | |
| **料** | PLA Matte 灰 + 黑 | 已下单 2 灰 + 1 黑 | 拓竹官方店 | **全件同料**；A1 配合样片另用现有 PETG |
| **料** | PETG | 1卷（有则不买） | | 仅 A1 配合验证件 |
| **喷嘴** | 0.4mm 硬化钢（H2S） | 1 | | 优先学校已有；玻纤料必须硬化 |

### 1.2 方案 B 特有

| ID | 物料 | 数量 | 备注 |
|---|---|---|---|
| **M08-B** | 过轴低速细线束（电源 + 舵机 PWM + 键 + 灯） | 1套 | 比 FPC 容易做，可用常规线 + 软护套 |
| **C01-B 散热** | 头壳内散热路径（导热垫/风道预留） | 按需 | 主板在头，先按被动散热设计 |

### 1.3 本方案**删除**（这是 B 的主要收益）

| ID | 原方案 | 为什么删 |
|---|---|---|
| **E04** | LCD 跨轴 FPC | 屏与板同在头部，无跨轴 |
| **E05** | 摄像跨轴 FPC | 同上 |
| **E13** | PWM 扩展板 | LEDC/RMT 直出 |

### 1.4 本方案不买

- 圆屏/AMOLED、PC/PAHT-CF/PPA-CF、亚克力/PC 透明面板、喷漆补土、激光切割
- 零位传感器、配重、滑环、连续旋转舵机、RGB 环带

---

## 2. 建模任务清单

> 按 AGENTS.md：保留原生 Screw/Boolean 控制、分件与姿态依赖；未验证项不得标 PASS；不导出伪参数 CAD。
> 前置：**先拿到微雪板体尺寸图 + 18PIN 屏接口定义 + 镜头位置 + 板载麦孔位置**，再动手。

| # | 零件 | 本方案要做什么 | 关键约束 |
|---|---|---|---|
| 1 | **头壳** | 腔体容纳 **主板 + LCD + 摄像头 + 双麦 + 扬声器**（重）；镜头开孔坐标**由实板决定**；**麦声孔在头壳**（C06）；散热路径 | **本方案最大风险点：容积与重量**；内悬垂可取支撑 |
| 2 | **底座杯体** | 只留舵机、5V 电源、3.7V 电池、按钮/灯；容积压力小 | 底面朝下、杯口朝上 |
| 3 | **底座上盖** | 保留可拆接缝 + 转轴孔 | 与头壳接收面配作 |
| 4 | **圆形黑面板** | 近圆黑框 + 中央真实矩形 LCD 窗贯通 | 屏尺寸随 E02′ 实物 |
| 5 | **短颈** | 颈内藏边 + 低速细线通过空间 | 线少，比 A 好做 |
| 6 | **轴承座 ×2** | 按 6806（30×42×7）实尺寸 | 先打轴配合样片 |
| 7 | **舵机架** | 按 MG90S 实测固定耳/花键 | **头部加重后须复核带载** |
| 8 | **轮毂/连接盘** | 与轴承座、舵盘配合 | 螺接，不胶粘定位 |
| 9 | **同齿数带轮 ×2** | 齿形 + 中央孔按实测 | 先验证齿形/花键连接 |
| 10 | **滑盖 / 按钮帽 / 线夹 / 硬声学通道** | 同批黑料小件 | 滑槽行程靠试片调 |
| 11 | **过轴细线通道（B 特有）** | 电源 + PWM + 键/灯 的固定、导向、限弯 | 比 A 简单，但仍要防夹 |
| 12 | **散热路径（B 特有）** | 头壳被动散热（导热垫/风道预留） | 不承诺主动散热 |
| 13 | **parameters.json 更新** | 记录新腔体/孔位/重量 | 未实测项标 unverified |

### 建模顺序（按风险）

1. **头壳容积与重量核算**——先证 B 方案装得下且转得动
2. 头壳 LCD/摄像/麦孔/散热
3. 底座杯体（舵机/电源/电池）
4. 面板 + 短颈 + 上盖
5. 受力件（轴承座/舵机架/轮毂）
6. 小件

---

## 3. 验收要点（本方案特有）

| 项 | 通过标准 | 说明 |
|---|---|---|
| **头部重量/惯量** | 装整头后 SG90 仍能 1–2s 转向、头角误差 ≤3°、无明显啸叫抖动影响会议 | **本方案第一验收项**；不达标即判不通过 |
| 转动连续 50 次 | 无断屏/断帧/复位/夹线 | |
| **麦克风拾音** | **头部双麦随头转**——转头时拾音特性变化须实测并写入说明 | ⚠️ **C06 必须改写**；不得宣称"转头实现指向性拾音" |
| 温升 | 30 分钟组合运行记录板端压降与头部温升 | 被动散热不够即须改结构 |
| AEC | 重测（换板 + 麦位变化） | **比 A 更需要重测**；初赛不阻塞，决赛 11.5 前必须 |

---

## 4. 工期影响

| 环节 | 说明 |
|---|---|
| 采购 | 无定长 FPC，**全部可第一批下**，不压节点 |
| 建模 | 头壳容积/重量/散热是新增核算，但少做一条过轴通道 |
| 打印 | 无额外 |
| 装配 | 穿线简单，约省 0.5 天 |
| **合计** | 比方案 A 约**省 1 天**，但多出麦随头转的产品问题 |

**风险**：头部加重导致 SG90 带载不达标 / 啸叫影响会议 —— 这是本方案的硬风险。
**缓释**：先用现有 SG90 打 1:1 头部配重件试转，不达标就退回方案 A（此时 A 的 FPC 尚未下单，回退窗口仍在）。

---

## 5. 若采用本方案，必须改写的既有文档

- `round-yaw-v2/BOM.md` **C06**：「板载双麦固定在**底座**」→「固定在**头部**」
- 删除同条中的「**麦克风不随头转**，不能宣称通过转头实现指向性拾音」——**该结论在 B 下不成立，须改为"麦随头转，转头会改变拾音特性"**
- `TEST_GUIDE` T07/T08：拾音验收增加"转头工况"测试
- `EffMeet2_判断样例与提示文案_v1.md` §3.3 状态表：不受影响，但 `apps/web` 与产品说明中"现场拾音"的表述须复核
