eleanor-wsyy/EffMeet2/hardware/robot-design/layout-options/MODELING_BRIEF.md

# 建模更新任务书 · 美学锁死 / 工程重做（2026-10-11）

> **原则：上一版（NOMI 方向）的审美模式原样保留；只换工程实现。**
> 来源：`round-yaw-v2/concept/nomi-aligned-20261010/prompt.txt`（审美契约原文）+ `round-yaw-v2/EXTERIOR_ASSEMBLY_REVISION.md`（组装接口）。
> **本文件不是 CAD、不是制造放行、不是实机验收。** 未验证项一律不得标 PASS。

---

## 0. 为什么写这份

工程方案变了（主板 Korvo → 微雪 ESP32-S3-CAM-OV3660，屏/相机/线材随之更换），但**外观审美不许跟着乱动**。
仓库里 `archive/legacy-enclosure/EffMeet2_外壳说明_v2.md` §0.1 记着 v3-a 的失败教训：

> 「仅用形态描述建模……结果**功能全丢**。**教训：形态描述会压倒功能描述，功能必须逐项显式点名。**」

本次的对偶风险是反过来的：**工程改造会压倒审美**。所以这份文件把审美先锁死，再改工程。

---

# 第一部分 · 美学不变量（**禁止改动**）

以下逐条摘自已认可的 NOMI 方向审美契约。**建模时逐条对账，任何一条不满足即打回。**

## 1.1 头部形态

- 近球形、轻微压扁的柔软头部，名义 **150 × 128 × 144 mm**
- 白 / 米白柔和外壳，**真实球面侧体量、圆剪影**
- **禁止方脸颊、方形侧壁**
- 分模缝细、零件边界极少
- 头部几何可极轻微朝上，但**不得增加任何俯仰机构**
- **禁止**：椭圆肖像框、圆角方屏、巨大白额头上的小黑药丸

## 1.2 面部语言（这是审美核心）

- **Ø104–108 mm 圆形黑面板**，居中偏前，周围只留克制的白壳边
- 必须读作「球头上的一个黑圆」，**不是**显示屏、**不是**圆角矩形监视器
- 圆面板是**哑光打印炭黑板**（PLA Matte 裸打），**不是**圆屏、**不是**玻璃罩、**不是**光学透明片
- 中央是**真实矩形 LCD 贯通窗**；屏面接近齐平，矩形边是**低对比细缝**，近看才隐约可见
- **禁止**：粗凸起的矩形边框、大面积高光圆片、曲面玻璃、宣称"完美 OLED 黑"

## 1.3 眼睛

- **只有两只**，在矩形 LCD 有效区**内**（不得溢出 49mm 屏宽）
- 暖白色、柔和弯月形闭眼/微笑，或简单直立小椭圆，表情松弛
- **眼睛是视觉焦点**——不是"小平板贴在大盘子上"
- **禁止**：嘴、文字、其他 UI 元素

## 1.4 摄像头与隐私

- 小镜头 + **物理滑动遮罩**，位于圆面板内**上部居中**
- 低对比黑细节，融入深色板；镜头近看可见，滑盖齐平
- **禁止**：明显方块徽章、把摄像头移到白额头、为视觉隐藏而删掉隐私操作

## 1.5 转颈（短、藏）

- **极短居中 yaw 接头**，轴外径名义 **46 mm**，头-底座真实间距 **14 mm**
- 克制的嵌套壳/领口 + 阴影间隙，把转轴**藏在球头下缘**
- 装饰裙边**必须与固定底座有诚实间隙**——不焊死、不悬空飘头
- **禁止**：高白管/黑管、为藏转轴而缩小真实机械间距、把裙边与底座粘连成环

## 1.6 底座

- 软圆白椭圆鹅卵石，**180 × 164 × 76 mm + 2mm 黑硅胶脚垫**
- 产品总高约 **222 mm**；**头部明显比底座窄**
- 平滑宽肩、下缘圆角，**有实质内部体积**
- **禁止**：薄的 NOMI 车机垫、花瓶细腰、第二层叠底座
- 保留既有上盖/杯体细缝，可拆修

## 1.7 开孔与细节

- **扬声器**：直接开在下前白壳，**3–4 条短槽、宽约 35–40 mm**，**无对比色喇叭徽章**
- **麦克风**：小而安静的开孔
- **停止键**：前肩部**小齐平帽**
- **状态指示**：**微小暖珊瑚色短划**（在底座）——不是环形灯带、不是 RGB 灯带
- **外供电**从**后部固定底座**进入，**无可见乱线**
- 硅胶脚垫薄、黑、大部分隐蔽

## 1.8 材质与质感

- **灰 + 黑，未喷漆哑光 PLA Matte**，裸打，**全 14 件同一种料**
- 真实细聚合物纹理 + 细微规则层纹
- **禁止**：绒面 / 石膏 / 水泥质感
- 圆面板的反光**只应来自里面的矩形 LCD**——不得把打印面做成/画成光学玻璃
- **PLA Matte 热变形约 55℃**：结构设计不得依赖高温工况；散热缝与内部风道仍按 §第四部分 保留

---

# 第二部分 · 「不许乱整」红线清单

任何一条命中即打回重做：

| # | 禁止项 |
|---|---|
| 1 | 加耳、帽、手臂、金属饰条、品牌标识 |
| 2 | 砂磨、补土、喷漆、退火、喷漆服务 |
| 3 | 激光切割亚克力/PC 透明罩、圆屏/AMOLED、LED 灯带 |
| 4 | 复制 NOMI 商标、车内安装、音乐图标、吐舌表情 |
| 5 | 带回上一轮的「小横窗 / 大白脸颊」 |
| 6 | 做成椭圆肖像框或圆角方屏 |
| 7 | 把摄像头移到白额头 |
| 8 | 为藏转轴而缩小真实机械间距（14mm 不许动） |
| 9 | 为好看而缩孔、缩小声槽、盖住麦孔 |
| 10 | 移动实板麦孔去迎合图上的对称装饰 |
| 11 | 把 PLA Matte 打印面做成/画成玻璃或高光 |
| 12 | 用涂料修补装不上的接口 |
| 13 | 编造爆炸图、制造放行、实机验收结论 |
| 14 | **只写形态描述不逐条点名功能位**（v3-a 原罪） |
| 15 | **让工程改动吃掉上表第一部分的任何一条**（本次的对偶风险） |

---

# 第三部分 · 工程变量（本次真正要改的）

## 3.1 因换主板而变

| 项 | 原（Korvo） | 新（微雪 ESP32-S3-CAM-OV3660） | 对建模的影响 |
|---|---|---|---|
| 主板 | Korvo-2 V3.1（底座） | 微雪单板（含摄像头） | 板体尺寸/孔位/高度全变，**预留盒重做** |
| 屏 | 乐鑫 Korvo-2-LCD 2.4″（有效区约 49×37mm） | 微雪 18PIN FPC 屏（2.0″ 或 2.8″） | **圆面板 Ø104–108 与中央矩形窗必须按新屏重算**；1.2 的面板语言保持不变 |
| 摄像头 | 外接 OV2640，可自由定位 | **板载 OV3660，镜头位置由板决定** | **面板上部开孔坐标迁就实板**，不得为对称好看挪孔 |
| USB | Micro-USB | **Type-C** | 底座侧面浅凹槽**重开**（1.7 的位置语言不变） |
| 舵机 PWM | 可能要 E13 扩展板 | LEDC/RMT 直出 | E13 删除，内部空间释放 |
| 电池 | 无 | **新增 3.7V 锂电** | 底座内部容积/重心重算 |
| 音频 | ES7210/ES8311/NS4150B | **相同芯片组** | 麦/扬声器接法可迁移；**AEC 必须重测** |

## 3.2 因布局 A/B 而变（二选一，见 `layout-options/`）

| | **A · 板在底座** | **B · 整板进头部** |
|---|---|---|
| 头部腔体 | 只装 LCD + 摄像头（轻） | 装主板 + LCD + 摄像 + 麦 + 扬声器（重） |
| 底座腔体 | 主板 + 电源 + 电池 + 扬声器 + 舵机 | 舵机 + 电源 + 电池 |
| 跨轴通道 | **LCD FPC + 摄像 FPC** + 电源 + PWM + 键灯 | 只剩电源 + PWM + 键灯 |
| **麦克风位置** | **底座上缘**（1.7 的"安静开孔"在底座） | **头部**（随头转，须改写 C06） |
| 扬声器位置 | 底座前下 | 可能上移至头部 |
| 散热 | 无压力 | **需加强**（背部细缝 1.7 保留，内部加散热路径） |
| 头部重量 | 轻 | **重**，须复核 SG90 带载 |

**美学不变量在 A/B 下都不变**——只是开孔的**归属件**（头壳还是底座）不同。

---

# 第四部分 · 功能位规格表（更新版，建模强制输入）

> 原表见 `archive/legacy-enclosure/EffMeet2_外壳说明_v2.md` §7，含**旧尺寸 90×90×110 与旧 ±120°**，已作废。
> 下表按当前 round-yaw-v2 尺寸与 NOMI 审美契约重写，**建模时逐条点名**。

| # | 功能位 | 位置 | 数量/规格 | 可见性 | 本次变更 |
|---|---|---|---|---|---|
| 1 | 圆形黑面板 | 头部正面居中 | **Ø104–108mm** 哑光打印炭黑板 | 外露 | 面板直径起点不变；**中央矩形窗按新屏重算** |
| 2 | 双眼 | 矩形 LCD 有效区内下部 | 左右各 1，暖白弯月/小椭圆 | 屏内显示 | 屏变则眼距按比例；**不得溢出屏宽** |
| 3 | 摄像头 | 圆面板内**上部居中** | 1 颗小型广角 | 近看可见 | **改板载 OV3660，开孔坐标由实板决定** |
| 4 | 遮罩拨片 | 镜头旁 | 1 个上下拨动拨片 | 外露可拨 | 随板载镜头位置重排 |
| 5 | 停止/静音键 | **前肩部** | 1 个小齐平帽 | 外露 | 不变（B 则信号过轴） |
| 6 | 状态指示 | **底座前部** | 1 条微小暖珊瑚短划 | 外露发光 | 不变；**不是环灯带**（B 则信号过轴） |
| 7 | 舵机颈段 | 头与底座之间 | 短颈 + 轴外径约 46mm，**±45°** | 外露，裙边留诚实间隙 | **腔内走线通道按 A/B 重做**；间距 14mm 不许动 |
| 8 | 麦克风 | **A：底座上缘 / B：头部** | 按实板双麦孔位（不照抄 20 孔阵） | 微孔可见 | **A/B 分叉点**；B 须改写 C06 |
| 9 | 扬声器开孔 | **A：底座前下 / B：待定** | 3–4 条短槽，宽 35–40mm | 槽可数 | **不加对比色徽章**；开孔率/声腔另测 |
| 10 | USB-C | 底座侧面 | 1 个，带浅凹槽 | 外露 | **Micro-USB → Type-C，凹槽重开** |
| 11 | 散热缝 | 背部中线 | 1 条细长缝 | 外露 | 不变；**B 方案内部加散热路径** |
| 12 | 硅胶脚垫 | 底面 | 1 圈环形约 2mm | 底部 | 不变 |

**建模 prompt 必带句式**（替代旧的 90×90×110 版本）：

> 形态比例（**180×164×222mm**，头 150×128×144，底座 180×164×76+2mm）+ 上表 12 项**逐条点名** + 材质（灰色哑光 PLA Matte 裸打 / 炭黑哑光 PLA Matte 面板 / 屏内暖白眼睛 + 底座微小珊瑚短划）+ 纯中性背景。
> **只写「圆润造型 + 黑面板」会丢掉全部功能位。**

---

# 第五部分 · 建模作业约束（按 AGENTS.md）

- 保留模型**原生 Screw/Boolean 控制**、分件与姿态依赖
- 新建模遵循适用 Blender 技能；不以预览动画代替固件验收
- `parameters.json` 与现有 `.blend` 的旧检查证据**不改写**；新参数另记并标 `unverified`
- `manifest.json` 的 `stage / manufacturing_ready / hardware_validated` **保持 false**
- 不导出伪参数 CAD（不把三角网格换后缀充当 STEP）
- **导出白名单**：只导出已完成结构的零件；排除 MAINBOARD/LCD/CAMERA/SERVO/BEARING/SPEAKER 代理、KEEP_OUT 与布尔控制

## 建模顺序

1. **先无电测件**：新屏总厚度/有效区、板载镜头突出量、FPC 出口方向、Type-C 凸出量
2. **圆面板 + 矩形窗**（审美核心，先定死）
3. 头部腔体（按 A 或 B）
4. 短颈 + 转轴接收面（14mm 间距、46mm 轴径）
5. 底座杯体 + 上盖
6. 受力件（轴承座/舵机架/轮毂/带轮）
7. 小件（滑盖/按钮帽/线夹/声学通道）
8. 更新 `parameters.json`（新参数标 unverified）

---

# 第六部分 · 与本文件配套

| 文件 | 关系 |
|---|---|
| `concept/nomi-aligned-20261010/prompt.txt` | **审美契约原文**，本文件第一部分的来源 |
| `round-yaw-v2/EXTERIOR_ASSEMBLY_REVISION.md` | 组装接口与装入顺序 |
| `layout-options/README.md` | A/B 二选一与决策判据 |
| `layout-options/layout-A-base-board.md` / `layout-B-head-board.md` | 各布局的采购 + 建模包 |
| `archive/legacy-enclosure/EffMeet2_外壳说明_v2.md` §7 | **旧功能位表（含旧尺寸/±120°，作废）** |

**待你醒来一并定的三件事**：布局 A/B、机身色（官方灰 已有货 / 白）、打印机约 H2D 还是 H2S。
