eleanor-wsyy/EffMeet2/hardware/robot-design/layout-options/layout-A-base-board.md

# 方案 A · 板在底座（2026-10-11 候选，未决策）

> **状态：候选，未选定。** 决策前**不得下单 E04/E05，不得开模**。
> 本文件不是 BOM；采购最终以 `round-yaw-v2/BOM.md` §12（决策后更新）为准。

**一句话**：主板、电源、电池、扬声器、舵机全在底座；头部只留 LCD + 摄像头，靠两条 FPC 跨轴送上去。**麦克风固定在底座，不随头转。**

---

## 1. 采购清单

### 1.1 与方案 B 共用（两套都要买，可先下）

| ID | 物料 | 数量 | 参考 | 备注 |
|---|---|---|---|---|
| E01 | **微雪 ESP32-S3-CAM-OV3660** | 1 | ≈¥180 | **必须 OV3660 版**（带硬件 JPEG；GC 系列没有） |
| E02′ | 微雪 18PIN FPC 屏模块 | 1 | 待定 | 2.0″ 或 2.8″，**必须先拿接口定义再下单** |
| E06 | 4Ω/3W 扬声器 ≤Ø40×18 | 1 | — | 板若含喇叭也不能直接用，须按尺寸/声腔独立确认 |
| E07 | Type-C 数据线 | 1 | 复用 | 烧录/日志，必须传数据 |
| E08 | Type-C 供电线 | 1 | 复用 | 足够电流 + 插头弯曲空间 |
| E09 | 5V/≥2A 合规电源 | 1 | 复用 | 不是裸无保护板 |
| E10 | 舵机独立稳压供电 + 保护线 | 1套 | — | MG90S 按 4.8V 基线，不默认喂 6V |
| E11 | 轻触开关 / 板载 MUTE 引出 | 1套 | — | 停止播报用，不承诺硬件断麦 |
| E12 | 板载状态灯 + 导光窗 | 0 新增 | — | 状态表冻结后再定灯色 |
| 新增 | 3.7V 锂电池（板载充放） | 1 | 待定 | 演示可脱线 |
| M01 | MG90S 位置舵机 | 1 | — | 已有 SG90 先用其验证 |
| M02 | 6806-2Z/ZZ 轴承 30×42×7 | 2 | — | 旧 56×18 预留不保证仍在 |
| M03 | 打印同齿数带轮 + GT2 带 | 2 + 1 | — | 长度按 CAD |
| M04 | ABS-GF 轴承座/舵机架/轮毂 | 各1套 | — | 与外壳同材同喷嘴，螺接 |
| M05 | 软行程 + 机械挡块 | 左右各1 | — | 软目标 ±45° |
| M07 | 线夹 + 柔性护套 | 1套 | — | **走线按本方案重做** |
| M08 | 接插件/线材/绝缘件 | 小套装 | — | 杜邦线不作最终活动线束 |
| M09 | M2.5/M3 螺钉、安装柱、黄铜嵌件 | 小套装 | — | 定长螺钉等实板 |
| C01 | 头壳 / 底座杯体 / 上盖 | 各1 | ABS-GF 机身色 | **腔体结构按本方案重切** |
| C02 | 近圆黑面板（面罩框） | 1 | ABS-GF 黑 | 中央矩形 LCD 窗贯通，不采购透明板 |
| C03 | 隐私滑盖 + 打印导向 | 1套 | ABS-GF 黑 | 同批打印 |
| C04 | 按钮帽 + LED 出光小孔 | 1 + 0 | ABS-GF 黑 | 取消第三色/喷漆 |
| C05 | 闭孔硅胶/EPDM 声学垫片 | 小片 | 买现成片材 | 不打印密封圈 |
| C06 | **底座**麦声孔通道 + 密封片 | 2路 | — | **孔位按实板，麦克风固定在底座** |
| C07 | 防滑硅胶片 ≈2mm | 1份裁切 | 买现成 | |
| **料** | ABS-GF 机身色 + 黑 | 各1kg 起 | 官方店 | **白黑同品牌**；A1 验证另用 PETG |
| **料** | PETG | 1卷（有则不买） | | 仅 A1 配合验证件 |
| **喷嘴** | 0.4mm 硬化钢（H2S） | 1 | | 优先学校已有；玻纤料必须硬化 |

### 1.2 方案 A 特有（**决策为 A 才买**）

| ID | 物料 | 数量 | 备注 |
|---|---|---|---|
| **E04** | **LCD 跨轴 FPC（18PIN，微雪规格）** | 1 + 备件1 | **必须先拿微雪 18PIN 接口定义**；连接器方向、过轴弯折半径、头转不断帧须实测 |
| **E05** | **摄像跨轴 FPC（24PIN DVP）** | 1 + 备件1 | 同针数不等于通用；须核信号与方向 |
| **M07-A** | 过轴线束固定/防夹结构件 | 1套 | 随结构打印，不在外购清单 |

### 1.3 本方案不买

- **E13 PWM 扩展板**（LEDC/RMT 直出）
- 圆屏/AMOLED、PC/PAHT-CF/PPA-CF、亚克力/PC 透明面板、喷漆补土、激光切割
- 零位传感器、配重、滑环、连续旋转舵机、RGB 环带

---

## 2. 建模任务清单

> 按 AGENTS.md：保留原生 Screw/Boolean 控制、分件与姿态依赖；未验证项不得标 PASS；不导出伪参数 CAD。
> 前置：**先拿到微雪板体尺寸图 + 18PIN 屏接口定义 + 镜头位置**，再动手。

| # | 零件 | 本方案要做什么 | 关键约束 |
|---|---|---|---|
| 1 | **头壳** | 腔体只容纳 **LCD + 摄像头**（轻）；预留 FPC 过轴通道与弯折半径；镜头开孔坐标**由实板决定** | 过轴孔不得夹线；内悬垂可取支撑 |
| 2 | **底座杯体** | 容纳主板、5V 电源、3.7V 电池、扬声器、舵机、按钮；**底座壁开 2 路麦声孔**（C06） | 板柱/出声孔/麦孔直接建入 CAD；底面朝下、杯口朝上 |
| 3 | **底座上盖** | 保留可拆接缝 + 转轴孔；承力区局部加肋 | 接缝藏于隐藏面 |
| 4 | **圆形黑面板** | 近圆黑框 + 中央真实矩形 LCD 窗贯通 | 屏尺寸随 E02′ 实物；屏自带面板露出，不做透明盖 |
| 5 | **短颈** | 颈内藏边 + FPC 通过空间 | 与头壳接收面配作 |
| 6 | **轴承座 ×2** | 按 6806（30×42×7）实尺寸 | 先打轴配合样片，不靠强装 |
| 7 | **舵机架** | 按 MG90S 实测固定耳/花键 | 不自造未经核验的花键 |
| 8 | **轮毂/连接盘** | 与轴承座、舵盘配合 | 螺接，不胶粘定位 |
| 9 | **同齿数带轮 ×2** | 齿形 + 中央孔按实测 | 先验证齿形/花键连接 |
| 10 | **滑盖 / 按钮帽 / 线夹 / 硬声学通道** | 同批黑料小件 | 滑槽行程靠试片调 |
| 11 | **过轴通道结构（A 特有）** | 两条 FPC 的固定、导向、防夹、限弯 | **本方案最大风险点**，必须 1:1 打样验证 |
| 12 | **parameters.json 更新** | 记录新腔体/孔位/过轴尺寸 | 未实测项标 unverified |

### 建模顺序（按风险）

1. **过轴通道 + 头壳 LCD/摄像支架**——先证 A 方案成立
2. 底座杯体（主板/电池/扬声器布局）
3. 面板 + 短颈 + 上盖
4. 受力件（轴承座/舵机架/轮毂）
5. 小件

---

## 3. 验收要点（本方案特有）

| 项 | 通过标准 | 说明 |
|---|---|---|
| **过轴 FPC 寿命** | 连续 50 次 ±45° 转向无断屏/断帧/断线 | **本方案第一验收项** |
| 夹线 | 转动全程不夹线、不磨线 | 软限位 + 硬挡都要查 |
| 头部重量 | 比 B 轻，SG90 转向 1–2s、头角误差 ≤3° | 首轮目标，非已实现性能 |
| **麦克风拾音** | **底座固定双麦**，1m 正常说话可转写、3m 小声触发 AGC | C06 按底座孔位，不随头转 |
| AEC | 重测（换板必做） | 初赛不阻塞，决赛 11.5 前必须 |

---

## 4. 工期影响

| 环节 | 说明 |
|---|---|
| 采购 | E04/E05 是**定长件**，必须等实板与 CAD 才能定长度 → 落在第二批，可能压 10.16 打印节点 |
| 建模 | 过轴通道是新增工作量，约多 0.5–1 天 |
| 打印 | 无额外 |
| 装配 | 过轴穿线是精细活，约多 0.5 天 |
| **合计** | 比方案 B 约多 **1 天**，但换来麦不随头转 |

**风险**：若 FPC 定长件到不了，本方案无法装配 → 这是它相对 B 的唯一硬风险。
**缓释**：下单时同步问卖家是否可发**通用长线 + 现场裁剪/折叠固定**作为过渡。
