eleanor-wsyy/EffMeet2/hardware/robot-design/round-yaw-v2/revision-20261011-nomi-layoutA/SPLIT_PLAN.md

> **执行产物入口：[v5独立件交付](print-split-v5/README.md)。本文件仍是v1.1任务书；真实件数/起点盘/朝向以v5件表为准，不能按任务书预设件数。**

# 在议 · 打印件拆分方案（交给建模接管方）

> **文件性质：任务书 + 现状说明，不是已完成拆分。** 2026-10-12 由 A 位起草，交给接管 v4 建模的一方执行。
> **v1.1 修正（采纳执行方反馈）**：①朝向不得写死，须切片＋样片决定；②PLA 受潮仍须按官方干燥参数，不得称「免干燥」；③`stage` 保留 `reversible_blockout`（是枚举不是 false）；④件数与盘数不预设，待拆分结果冻结。
> **建模、渲染、拆分本轮全部交由该方**；本文件只定义「拆什么、按什么规则拆、拆完要满足什么」。
> 尺寸真源：[`../parameters.json`](../parameters.json) · 采购真源：[`../BOM.md` §12](../BOM.md#final-purchase-decision) · 模型入口：[`README.md`](README.md)

---

# 一、硬件现状（拆分前必须知道）

## 1.1 主板：GOOUU ESP32-S3-CAM 套装

| 项 | 现状 |
|---|---|
| 下单 | ✅ **已下单 ¥86.5**，套装 = 核心板 + OV3660 摄像头 + 扩展板 + 2.8″TFT |
| 物流 | 深圳发出，预计次日达 |
| **板体尺寸** | **62.6 × 28.3 mm**（尺寸图记录，可用于预留） |
| 芯片 | ESP32-S3-**N16R8**（16MB Flash + 8MB PSRAM） |
| 接口 | USB Type-C（+另一 USB）、TF 卡槽、W2812B RGB、44 路 GPIO 全引出排针 |
| **无板载音频** | ❌ 无麦、无音频编解码、**无功放**、**无电池管理** → 必须外接 |
| **扩展板** | ⚠️ **尺寸未测**，v4 模型**不把它算进"放得下"**；当前作台架工具，到货量尺寸后决定用不用 |

## 1.2 外接模块（GOOUU 无音频，必须补）

| 模块 | 数量 | v4 模型预算尺寸 | 位置（v4 候选） | 状态 |
|---|---|---|---|---|
| **INMP441** I2S 麦克风 | **2** | 16×6×12 | 中心 (±16.3, 69, 52) | 🔴 待下单；实模块未测 |
| **MAX98357A** I2S 功放 | 1 | 23×16×4 | 中心 (38, −31, 20) | 🔴 待下单；实模块未测 |
| **TP4056** 充电/保护 | 1 | 28×17×4 | 中心 (−40, 36, 16) | 🔴 待下单；**不是 5V 升压** |
| 扬声器 4Ω/3W | 1 | ≤Ø40×18 | 底座前部 | 🔴 待下单 |
| 3.7V 受保护锂电 | 1 | 55×30×10 | 右下 | 🔴 待下单 |

> ⚠️ 上表"预算尺寸"**是本轮为建模留的占位，不是实际 PCB 尺寸**。到货实测后必须回填。

## 1.3 机构件

| 件 | 规格 | 状态 |
|---|---|---|
| **轴承** | **6806-2Z/ZZ，30 内径 × 42 外径 × 7 厚，2 只** | 🔴 待下单；v4 分置 Z49.5 / Z69.5 |
| **舵机** | **MG90S**（本体 22.8×12.2×28.5，固定耳/花键须实测）；已有 SG90 可先验 | 🔴 待下单 |
| **传动** | 1:1 GT2，**64T/64T、中心距 50mm、节线长 228mm 仅是 v4 匹配起点** | 🔴 待定；齿形/舵盘/带长/张紧须核 |
| 螺钉/嵌件/线材/接插件 | M2.5/M3 小套装 | 🔴 待下单 |

## 1.4 硬件边界（拆分不得违反）

1. **排针上有 GPIO ≠ 可随意分配**——摄像、SPI 触摸、I2S、PSRAM、启动脚、LED 需要一张统一分配表。
2. **BOOT/G0 是启动脚**，按下状态跨复位/上电必须验证；v4 已优先改用**前肩外接轻触键**，不用机械连杆硬推后部板载键。
3. **TP4056 不是 5V 升压，也不自动等于安全边充边用**；Demo 默认外供合规 5V。
4. **屏是 J2 单排 14 针**，SPI 只是商品图推断；**驱动 IC、针序、电压未冻结**。不得沿用微雪的 18PIN 定义。
5. **摄像 FPC 禁止裁剪**；延长须用厂家支持方式。

---

# 二、打印工作室现状

## 2.1 学校实验室（主力大件）

| 项 | 现状 |
|---|---|
| 名称 | 广州美术学院 实验教学中心 **模型实验室** |
| 设备 | **拓竹 P2S ×8、H2S ×10、H2D ×10**（共 28 台）+ 高精密激光切割机 ×2 |
| **通风限制** | ⚠️ **目前不允许打印 ABS/ASA**（后期改造后才放开）→ **这是本项目改用 PLA 的直接原因** |
| 喷嘴 | 实验室通用 **0.4mm**；**0.2mm 需自备** |
| H2D | 双喷嘴，可上专用支撑材料（若可用，内部悬垂处理更好） |
| 预约 | 需走实验室预约/审批流程 |

## 2.2 自有机器（小件与迭代）

| 项 | 现状 |
|---|---|
| 机器 | 自有 **拓竹 A1**（256³，非封箱） |
| 材料 | **PETG 现有库存**（配合样片用） |
| 定位 | 打配合样片、小件、需要反复迭代的件 |

## 2.3 材料（已下单）

| 材料 | 数量 | 用途 | 状态 |
|---|---|---|---|
| **PLA Matte 灰** | 2 卷 | 机身（头壳 / 底座杯 / 上盖） | ✅ 已下单 |
| **PLA Matte 黑** | 1 卷 | 细节（面板 / 短颈 / 支架 / 带轮 / 小件） | ✅ 已下单 |
| PETG | 现有 | 仅配合样片 | ✅ 有 |

- **全件同一种料**，不做一件多色反复换料
- PLA **不需要硬化喷嘴、不需要封箱**（普通 0.4 即可）；**吸湿性低于 ABS/PA，拆封即可打**，但**受潮时仍须按拓竹官方 PLA 干燥参数处理**——**不得写成"免干燥材料"**
- ⚠️ **PLA 热变形约 55℃**，禁止暴晒/密闭高温

## 2.4 机器分工（已定）

| 谁打 | 打什么 | 理由 |
|---|---|---|
| **自有 A1** | 配合样片 + 全部小件（含圆黑面板） | 迭代快、打废立刻重来 |
| **学校机器** | **三件大壳**：头壳、底座杯体、上盖 | 体积大、CoreXY 封箱更稳、可并行且有重打余量 |

> 具体到件、到盘的分配见 [§五 合盘策略](#五合盘策略重要不要把每件单独打一盘)；拆出多少件、哪些是"大件"，以拆分完成后的件表为准。

---

# 三、建模现状（v4，接管起点）

**模型**：[`EffMeet2_NOMI_布局A_工程候选_v4.blend`](EffMeet2_NOMI_布局A_工程候选_v4.blend) · 场景 `N4_NOMI_LAYOUT_A_CANDIDATE`
**生成源**：[`update_nomi_layoutA.py`](update_nomi_layoutA.py) · **工程复核**：[`ENGINEERING_REVIEW.md`](ENGINEERING_REVIEW.md)

## 3.1 已拆出制造边界的只有 5 件

| 对象名 | 件 | 修改器栈 | 是否可打印 |
|---|---|---|---|
| `N4_HEAD_SHELL` | 头壳 | SCREW + LATTICE + SOLIDIFY + 6×BOOLEAN | 有边界，**未放行** |
| `N4_FACE_PANEL` | 圆黑面板 | 3×BOOLEAN | 有边界，**未放行** |
| `N4_SHORT_YAW_NECK` | 短颈 | 4×BOOLEAN | 有边界，**未放行** |
| `N4_BASE_LID` | 底座上盖 | SCREW + 2×BOOLEAN | 有边界，**未放行** |
| `N4_BASE_CUP` | 底座杯体 | SCREW + 5×BOOLEAN | 有边界，**未放行** |

`production/construction_graph.json` 明确写着 **`part_graph_status: provisional`**，每件还带 **`blockout_proxy: True`**。

## 3.2 机构件**全部是代理/包络，一个都没拆**

| 应该是打印件的 | v4 里的现状 | 要做的 |
|---|---|---|
| 轴承座 ×2 | `N4_BEARING_LOWER_SEAT_PROXY` / `UPPER_SEAT_PROXY`（+`_BORE`） | **拆成真件** |
| 同齿数带轮 ×2 | `N4_DRIVER_PULLEY_ENVELOPE` / `DRIVEN_PULLEY_ENVELOPE` | **拆成真件（含齿形）** |
| 空心轴 / 轮毂 / 连接盘 | `N4_HOLLOW_SHAFT_PROXY`（+`_BORE`） | **拆成真件** |
| 舵机架 | **无独立对象**（只有外购 `N4_SERVO` + `N4_KEEP_OUT_SERVO`） | **新建** |
| 隐私滑盖 + 导向 | `N4_PRIVACY_SLIDER_PROXY` | **拆成真件** |
| 停止键帽 | `N4_STOP_BUTTON_CAP_PROXY` | **拆成真件** |
| 线夹 | **无** | **新建** |
| 硬声学通道 | **无**（只有壳上的孔） | **新建或明确建入壳体** |
| 限位（软行程 + 硬挡） | **无** | **新建** |
| 独立电子支架 | **无** | **新建（主板/麦×2/功放/充电各一）** |

> v4 的 `README.md` 也自述：「电子件、**轴承座、轮／带是名义占位，不照图下单打印**」；「待完成：**独立电子支架**、滑盖导向防脱、**分体轴承座到底座的承力固定**、轴向锁定、**带轮齿形／舵盘／张紧**…」

## 3.3 不是件、不要误拆的

- **15 个 `N4_KEEP_OUT_*`**：遮挡盒（排版检查用）
- **外购件占位**：`N4_MAINBOARD` / `N4_SERVO` / `N4_SPEAKER` / `N4_I2S_AMP` / `N4_BATTERY` / `N4_BATTERY_CHARGER` / `N4_BEARING_LOWER|UPPER` / `N4_KEY` / `N4_PURCHASED_SILICONE_FOOT`
- **评审/控制件**：`N4_TWO_EYES_REVIEW` / `N4_STATUS_DISPLAY_REVIEW` / `N4_HEAD_LATTICE` / `N4_YAW_LAYOUT_ANCHOR` / 各类 `_SOURCE` `_CONTROL` `_BORE`
- **历史场景**：`EFFMEET2_PACKAGING_V1`、`R2_ROUND_YAW_BLOCKOUT`、`Scene` —— **不得覆盖**

## 3.4 必须保留的模型约定（AGENTS.md + modeling_contract）

- 保留**原生 Screw / Boolean / Lattice / Solidify**，不得烘成死网格冒充成品
- **单一连续壳体必须单连通分量**
- **难度不是有效的分离理由**（`difficulty_is_valid_separation_reason: False`）
- **功能/细节不得先于过渡**（`functional_or_detail_before_transition_allowed: False`）
- **材质/灯光不得掩盖几何失败**
- **需要线框验收 + 真实倒角几何**
- 所有头部布尔控制**跟随同一 yaw 姿态锚点**
- 不把三角网格换后缀冒充 STEP

---

# 四、拆分任务清单（**交给接管方执行**）

> 目标：把全部可打印件拆成**独立、闭合、可导出**的实体，且每件能单独上机。
> **件数不预设。** BOM §12.2 的打印件**条目**为 14 类，但**实际件数会多于 14**：分体轴承座可能每只拆 2 片、滑盖＋导向是 2 件、电子支架按模块数拆（主板/麦×2/功放/充电）……**件数以拆分结果为准，不得硬凑**。
> **拆完不是制造放行**，仍须样片与实测。

## 4.1 已拆的 5 件：复核并转正

| # | 件 | 要做 |
|---|---|---|
| 1 | `N4_HEAD_SHELL` 头壳 | 复核闭合/单连通；确认面罩口 Ø104–108、Ø22 过轴通道、头底接收面 3.2、Ø62 法兰、两处 M3 孔；**清掉独立审计提示的亚打印尺度布尔短边/小面** |
| 2 | `N4_FACE_PANEL` 圆黑面板 | 复核矩形贯通窗 58.2×43.8（按屏预算）、摄像孔、滑盖槽；确认 Ø106 外圈 |
| 3 | `N4_SHORT_YAW_NECK` 短颈 | 复核外露 Ø46、内孔、裙边与底座**诚实间隙**（14mm 间距不许缩） |
| 4 | `N4_BASE_LID` 底座上盖 | 复核可拆接缝、转轴孔、承力区加肋 |
| 5 | `N4_BASE_CUP` 底座杯体 | 复核 4 条 38mm 前声槽、后通风/线口、Type-C 口、麦孔、停止键孔、状态窗、底脚槽 |

## 4.2 待新建/拆出的件

| # | 件 | 数量 | 拆分要点 | 打印方向 | 颜色 |
|---|---|---|---|---|---|
| 6 | **轴承座（分体夹紧式）** | **2** | **必须分体/抱箍 + 螺钉夹紧**；抱 Ø42 外圈，**不做强过盈、不做薄壁压配**；与底座有承力固定接口与轴向锁定位 | **待定**（见 §5.2 朝向导则） | 黑 |
| 7 | **舵机架** | 1 | 按 MG90S 实测固定耳与花键；**不自造未经核验的花键**；侧置 | 平放 | 黑 |
| 8 | **空心轴 / 轮毂 / 连接盘** | 1套 | 中央走线（Ø22 通道）、30mm 轴级、D 形扁位（从 Z73 起）、与轴承内圈接口；**螺接定位，不胶粘** | 轴线竖直 | 黑 |
| 9 | **同齿数带轮** | **2** | **64T GT2 齿形**；与舵盘/轴的接口按实测；张紧槽配合位 | 平放（齿朝上） | 黑 |
| 10 | **隐私滑盖 + 导向** | 1套 | 滑槽间隙与行程；**导向防脱**；去毛刺即可滑动 | 平放 | 黑 |
| 11 | **停止键帽** | 1 | 前肩齐平小帽；配合实际开关行程/盖板孔 | 平放 | 黑 |
| 12 | **线夹** | 1套 | 固定两路跨轴线束**两端**；**弯折区不固定死**；接触排线处留软护套位 | 随意 | 黑 |
| 13 | **硬声学通道** | 1套 | 麦通道（对 INMP441 实际端口）+ 喇叭通道；**不堵振膜/出声孔**；或明确建入壳体并说明 | — | 黑 |
| 14 | **限位（软行程 + 硬挡）** | 左右各1 | 软目标 ±45°；硬挡不得被正常动作反复顶撞 | 随结构 | 黑 |
| 15 | **电子支架（新增，v4 列为待完成）** | 主板1 / 麦×2 / 功放1 / 充电1 | 各模块独立可拆小支架；**减少大壳重打**；板柱/螺钉孔按实测 | 平放 | 黑 |

## 4.3 每件必须交付的属性

对**每一个**拆出的件：

- [ ] **独立对象**，命名单一（建议 `P_<件名>` 或沿用 `N4_` 前缀）
- [ ] **闭合网格**：`boundary_edges = 0`、`nonmanifold_edges = 0`、`loose_edges = 0`、`zero_area_faces = 0`、`components = 1`
- [ ] **无亚打印尺度面**（`sub_print_scale_faces = 0`）
- [ ] **真实壁厚**（名义 2.4mm 起；受力区局部加肋）
- [ ] **打印方向 + 支撑建议**（写进件表）
- [ ] **材料/颜色**（灰 / 黑）
- [ ] **关键接口尺寸标注**（在件表里，不要求出正式工程图）
- [ ] 加进 `production/construction_graph.json` 的 `parts`（`separation_policy` / `construction_method` / `final_object_name`）
- [ ] 更新 `production/evaluated-shells.json`

---

# 五、合盘策略（**重要：不要把每件单独打一盘**）

> 小件单件单盘是纯浪费——每次都有升温/调平/首层/冷却的固定开销，且喷嘴擦料在小件上占比极高。
> **拆分完成后，按下面的盘表合盘切片。** 盘表的件清单会随拆分结果更新。

## 5.1 分组约束（决定哪些能同盘）

| 约束 | 说明 |
|---|---|
| **颜色** | 灰 / 黑**不能混盘**（单喷嘴换色会反复冲刷，浪费且拖时间） |
| **层高** | 同一盘共用层高最省事；外观件要 0.16，结构件 0.20 |
| **朝向** | **每件单独设朝向是允许的**（切片器支持逐件设置），不受同盘限制 |
| **墙/填充** | 结构件要 4–6 墙 + 局部加肋；外观件不需要。同盘可用逐件参数 |
| **风险隔离** | **最高风险的件不与非关键件混盘**——一件失败会拖累整盘 |
| **备件** | 小件**同盘多打 2–3 个备件**，成本几乎为零，省一次重打 |

## 5.2 盘表

### 灰 · 大件（3 盘，各件独立成盘）

| 盘 | 件 | 尺寸 | 理由 |
|---|---|---|---|
| **G1** | 头壳 | 150×128×144 | 体积大、耗时长；失败即重打，不与其他件捆绑 |
| **G2** | 底座杯体 | 180×164×78 | 同上；且是承力主体 |
| **G3** | 底座上盖 | 180×164×~10 | 可与其他灰小件同盘（若有），目前无其他灰件 |

> 三件大壳**不建议互相合盘**：单件失败会整盘报废，而它们是最耗时也最需要重打余量的件。
> 走学校机器**并行**（3 台同时打），比合盘更省时间。

### 黑 · 外观盘（**B1**，1 盘）

| 件 | 数量 | 层高建议 |
|---|---|---|
| 圆黑面板 | 1 | **0.16mm**（审美核心，表面优先） |
| 短颈外观件 | 1 | 0.16mm |
| 隐私滑盖 + 导向 | 1套 | 0.16mm |
| 停止键帽 | 1 + **备2** | 0.16mm |

> 这四件都是**外露可见**的，共用 0.16mm 层高合理。朝向逐件设：面板平放、短颈轴线竖直、滑盖平放。

### 黑 · 结构盘（**B2**，1 盘）

| 件 | 数量 | 层高建议 |
|---|---|---|
| 轴承座（分体夹紧） | **2 + 备1套** | 0.20mm |
| 舵机架 | 1 | 0.20mm |
| 空心轴 / 轮毂 / 连接盘 | 1套 | 0.20mm |
| 同齿数带轮 | **2 + 备1** | 0.20mm |

> **朝向逐件设，但不得在任务书里写死。** 朝向须**同时权衡孔形、受力层向与支撑**，最终由**切片预览 + 样片实打**决定，本文件只给待验证的起点：
> - 轴承座：孔轴线方向与受力层向要一起看——水平打印有利于孔形，**但不构成充分条件**，须切片验证
> - 带轮：齿面朝向与层间强度、齿形精度一起权衡
> - 轮毂：轴线方向与承力层向一起权衡
> ⚠️ 本表**不预设任何件的最终朝向**；由执行方切片与样片后确定并回填。
> **墙 4–6 + 受力区加肋**；这盘是受力件集中盘。
> ⚠️ **轴承座是最高风险件**——它若失败会拖累整盘。两种处理：
> - **优选**：轴承座**先单独与配合样片一起验证**，通过后再进 B2 合盘
> - 或利用 Bambu 的**跳过失败对象**功能，失败单件不整盘报废

### 黑 · 小件盘（**B3**，可并入 B2）

| 件 | 数量 |
|---|---|
| 线夹 | 1套 + **备2** |
| 硬声学通道 | 1套 |
| 限位（软行程 + 硬挡） | 左右各1 + **备** |

> 层高/朝向与 B2 一致，**建议直接并入 B2**，减少一次打印。件小、不占地方。

## 5.3 样片（**必须先跑，且独立成盘**）

| 盘 | 件 | 材料 | 机器 | 目的 |
|---|---|---|---|---|
| **S1** | 配合样片 4 件（轴承内外圈阶梯/舵机口袋/壁厚孔质量/短颈间隙） | **PETG（现有）** | **自有 A1** | 定公差档，打废立刻重来 |
| **S2** | 同尺寸配合样片 + 曲面样片 | **PLA Matte（正式料）** | 学校或 A1 | **验证 PLA 收缩/孔径/表面/支撑界面** |

> ⚠️ **PETG 试片不能代替 PLA 正式料配合**——收缩率不同，配合孔/轴承座/滑槽必须在正式料上重新验证。
> ⚠️ **不用缩比样件验收安装孔，必须 1:1。**

## 5.4 汇总

| # | 盘 | 件数 | 材料 | 建议机器 |
|---|---|---|---|---|
| S1 | 配合样片 | 4 | PETG | 自有 A1 |
| S2 | 正式料样片 | 4+1 | PLA Matte 黑/灰 | 学校或 A1 |
| G1 | 头壳 | 1 | PLA Matte 灰 | 学校 |
| G2 | 底座杯体 | 1 | PLA Matte 灰 | 学校 |
| G3 | 底座上盖 | 1 | PLA Matte 灰 | 学校 |
| **B1** | 面板 + 短颈 + 滑盖 + 键帽 | 4类 | PLA Matte 黑 | 自有 A1 |
| **B2** | 轴承座 + 舵机架 + 轮毂 + 带轮（+B3 小件） | 6类 | PLA Matte 黑 | 自有 A1 |

**上表是分组原则，不是锁定的盘数。** 件表确定后再冻结盘数——分体式轴承座、滑盖导向、电子支架会增加实际零件数，**盘数随之变化，不得提前写死**。

**自有 A1 承担 3 盘**（S1、B1、B2）；**学校承担 3 盘**（G1/G2/G3 并行）；S2 可任一侧跑。

---

# 六、拆分铁律（违反即返工）

1. **不做强过盈压装**——轴承座必须分体夹紧/螺接。PLA 偏脆，压装会裂。
2. **不做薄弹性卡扣**——一切靠螺钉 + 圆角 + 受力肋。
3. **不靠材料弹性变形做功能**。
4. **不为好看缩孔、不为省空间折死排线**。
5. **不删功能换外观**：声槽、麦孔、通风、Type-C 口、停止键、状态窗都是真开孔。
6. **不移动实板麦孔去迎合对称装饰**。
7. **不改 `manifest.json` 的状态字段**：`stage` **保留 `reversible_blockout`**（它是阶段枚举，不是布尔，**不要写成 false**）；`final_design_approved` / `manufacturing_ready` / `hardware_validated` 保持 `false`。
8. **不生成"伪装成放行件"的 STL**，不把网格改后缀冒充 STEP。
9. **不覆盖旧场景**（`EFFMEET2_PACKAGING_V1` / `R2_*` / `Scene`）。
10. **未实测的项一律标 `unverified`**，不得写 PASS。

---

# 七、拆完之后：仍是待实测项

拆完只代表"几何可生产"，**不等于可以打印整机**。以下必须等实物：

| 待实测 | 影响 |
|---|---|
| GOOUU 完整排针 / 双 USB / 元件最高点 / 四孔位置 / Type-C 凸出 | 主板支架、底座凹槽 |
| **扩展板外形** | 决定用不用扩展板（用则重算内腔） |
| HSD028309 的玻璃 / PCB / 厚度 / J2 针序 / 驱动 IC | 屏窗、屏支架、跨轴线数 |
| OV3660 模组外形 / 镜头突出 / FPC 触点方向 | 面板摄像孔、头部支架 |
| INMP441 / MAX98357 / TP4056 实际模组 | 电子支架、麦孔位置 |
| MG90S 固定耳 / 舵盘孔距 / 输出轴偏心 | 舵机架、带轮接口 |
| 6806 实物公差 / 轴肩 | 轴承座夹紧量 |
| 电池 / 扬声器 / 接头 | 底座布局 |
| **正式 PLA 配合样片** | 所有功能孔/配合尺寸的最终档位 |

> 回填流程：**实测 → 填 `parameters.json` → 更新生成源 → 重建模型与证据**。不用旧报告给改动后的件背书。

---

# 八、参考文件（按优先级）

| # | 文件 | 用途 |
|---|---|---|
| 1 | [`README.md`](README.md) | v4 成果入口、发布边界 |
| 2 | [`ENGINEERING_REVIEW.md`](ENGINEERING_REVIEW.md) | 电子舱布局、电气边界、待实测清单 |
| 3 | [`../parameters.json`](../parameters.json) | **尺寸唯一真源** |
| 4 | [`../BOM.md` §12](../BOM.md#final-purchase-decision) | **采购唯一真源**（C01–C08 / M03–M07 是打印件条目） |
| 5 | [`../MODELING_BRIEF.md`](../MODELING_BRIEF.md) | **美学不变量 + 15 条"不许乱整"红线 + 功能位规格表** |
| 6 | [`../PRINT_PLAN.md`](../PRINT_PLAN.md) | 机器分工、切片起点 |
| 7 | [`../ASSEMBLY_GUIDE.md`](../ASSEMBLY_GUIDE.md) | 装配顺序（拆完要同步更新） |
| 8 | [`../GOOUU-BOARD-SPEC.md`](../GOOUU-BOARD-SPEC.md) | 主板规格与必配外接件 |
| 9 | [`../../AGENTS.md`](../../AGENTS.md) | 目录协作规则 |

---

**起草：A 位（2026-10-12） · 执行：建模接管方 · 本文件只定义需求，不含已完成的拆分成果**
