eleanor-wsyy/EffMeet2/hardware/robot-design/round-yaw-v2/revision-20261011-nomi-layoutA/ENGINEERING_REVIEW.md

# v4 · GOOUU布局A工程复核

> **⛔ 历史文档（v4，2026-10-11）。** 现行接口门槛与状态见 [print-split-v6/INTERFACE_GATES.md](print-split-v6/INTERFACE_GATES.md)；本文的 180×164×222、Ø106 圆脸、TP4056 预留等均为旧口径，勿作当前依据。

当前采购定案与下单记录见 [GOOUU-BOARD-SPEC](../GOOUU-BOARD-SPEC.md) 和唯一 [BOM§12](../BOM.md#final-purchase-decision)。此前微雪原型已被当前方案替代；不复用其麦克风／功放／屏接口结论。

## 外观不变量和实际改造

- 保留NOMI圆润球头、Ø106哑光圆黑脸、暖白双眼和短连接；180×164×222外包络、14mm真实间隔、±45°、固定宽底座不变。
- 头部母体150×128×144，Z92截底后占位高约130；原生Screw/Lattice/Solidify/Boolean保持可编辑。
- 为套装屏背板预算，前口曲面与接收唇略加宽，圆脸仍Ø106。58.2×43.8矩形贯通窗，玻璃占位73.06×50.54、PCB占位85×55，仅是**预算而非HSD028309实测**。
- 3.2mm头底接收、Ø46.6孔、隐藏Ø62法兰、两处M3候选孔、30mm轴级阶梯D接收、Ø22通道保持；螺母接收、轴向锁定／公差未放行。
- 四条38mm前声槽、固定外接麦声孔、后通风与线入口、齐平停止帽和状态窗都是真实开孔，不为了外观删功能。

## 最新电子舱（固定底座）

| 部件 | 本轮模型／位置（mm） | 证据边界 |
|---|---|---|
| GOOUU核心板 | 板体62.6×28.3；中心(0,54,48)；预留72×18×36，后部竖置 | 板体来自仓库采购尺寸图记录；完整排针／USB／元件高待到货 |
| INMP441×2 | 候选中心(±16.3,69,52)，模块预算16×6×12 | 两只固定，不随头转；实际模块／底声孔位置／接头未测 |
| MAX98357A | 候选中心(38,-31,20)，预算23×16×4 | 外置I2S功放，喇叭接差分端，不拿微雪板载功放作替代 |
| TP4056保护版 | 候选中心(-40,36,16)，预算28×17×4 | 充电／保护；不是5V升压或自动电源路径 |
| 扬声器／电池 | 前扬声器；右下55×30×10电池预算 | 实际壳体／焊片／接头、锂电极性／保护与稳定性待测 |
| 舵机／轴承／传动 | 双6806分置Z49.5／69.5，侧置MG90S，64T/64T GT2候选 | 分体座到底座承力固定、齿形／舵盘／张紧／轴向锁定未完成 |

**套装扩展板未测，当前不宣称“整个套装放得下”。** 当前整机候选采用核心板＋标号直连线束；扩展板保留作台架联调工具。到货尺寸可容纳时再复用以减少接线，不丢弃已有件、不额外买一块屏。

## 转动头部与线束

- 只有套装2.8TFT和OV3660模组进入头部。显示为14PIN J2，SPI是照片推断，触摸／MISO／电源会影响实际线数；驱动芯片、针序和电压尚需冻结。
- 显示线束＋摄像FPC两路跨轴，不是微雪18PIN LCD＋24PIN相机固定定义。其余主板／功放／麦／按钮／灯／舵机线留在底座。
- 完整端接必须通过实际Ø22通道。两个7芯接头只是装配候选，不能未经对角线／公差检查就宣称可穿入。
- 禁止裁剪摄像FPC，禁止折死／塞入轴承。两路一起穿装、信号完整性与50循环需要实机；预留立方体不是最小弯折半径证明。

**额外静态复核：** 舵机本体下移到Z38，顶面52.25低于主动轮底55.3，名义间隙3.05mm；空心轴45–93覆盖两只7mm内圈，D扁位从73开始不在短颈内保留错误圆段。实际舵盘偏心／轴向锁定仍需样件。活动区105–129位于隐藏法兰99.2之上，不能把原低位预留与法兰叠在一起。

## 电气边界

1. Demo默认外供合规5V，舵机独立额定稳压供电／信号共地。TP4056＋电池不是自动的5V整机电源；独立电池模式需额外确认转换与充电电源路径。
2. INMP441实际供电／L/R／I2S同步，MAX98357供电和差分喇叭接法按模块资料，不能直接照猜测GPIO接。
3. 排针引出的GPIO不等于都空闲：摄像、SPI触摸、I2S、PSRAM、启动脚与LED需要一张统一分配表。BOOT/G0复用停止键时，按下状态跨复位／上电必须验证。
4. 不宣称GOOUU与微雪的AEC／音频性能相同。外接音频和软件AEC、真实停止／回执需要重新跑T07–T25。

## 已检查与未通过项

五个外观／颈部评估网格闭合及连通；十五个名义预留盒内轮廓容纳；三姿态头壳体积／14mm间隙。不是全件装配、工具空间、插头／排线、打印或硬件测试。

独立评估审计的微小布尔短边／小面提示保留原始状态，不改成PASS；正式制造导出前要清理。当前综合状态WARN，manufacturing_ready／hardware_validated仍false。

## 到货后只补这些实测

核心板完整排针／双USB；扩展板外形；HSD028309的玻璃／PCB／厚度／J2定义；OV3660与FPC；INMP441／MAX98357／TP4056完整模组；舵机耳／舵盘、轴承／轴肩；电池／扬声器／真实接头；正式PLA配合样片。填写parameters.json，更新源并重建证据，不用旧15-box报告背书改变后的件。
