eleanor-wsyy/EffMeet2/today-20261019/cards/PLATE-CARD-P15P17P26P29.md

# PLATE-CARD · TMP-FIX-P15P17P26P29_BLACK_016（v2 · 2026-10-19）

> 配合缺陷修复批。**v2 修正**：P26 已按 `PARTS.csv 90×0×0` 在盘里转 90°（镜管朝床）；P15/P17 改为局部支撑；补 P24 摄像孔 4.2→6.8。原 v1 盘“P26 未转、四件全无支撑”与件表/实际悬垂不符，已替换。

## 返工原因（来自 build_v6.py FITFIX）

| 件 | 原问题 | 修复 |
|---|---|---|
| **P15** | MG90S 舵机口袋 12.5+0.6 太紧，舵机塞不进 | 口袋 **+1.2 → 13.7**（`SERVO_BODY_POCKET` / `wy +0.3`） |
| **P17** | 功放只有单柱、板位偏低；MAX98357A 孔距 12.6 对不上 | 改 **两 M2 柱（12.6 距、Ø4.5、孔 Ø1.7）**；代理抬高 2.5；`M2×4` 手拧 |
| **P26** | 镜管 4.6 装不进 6.5 镜头；摄像头腔太紧 | 镜管 **Ø6.5**；腔 **+1.2 → 9.2×9.2** |
| **P29** | 核心板槽 1.6+0.5=2.1 太松，板会晃 | 槽 **1.8（1.6+0.2）**；两侧 rail slot 同步 |
| **P24** | **上次漏改**：摄像孔仍是 4.2，配不上 P26 的 6.5 镜管 | 建模 `CAMERA_APERTURE = camera_lens_d+.3 = 6.8`；已重出 `candidate-stl/P24`；**旧 P24 打印件需钻到 6.8** |

## 一盘决策

| 项 | 值 |
|---|---|
| 盘文件 | `TMP-FIX-P15P17P26P29_BLACK_016.3mf` / `.stl` |
| 件 | P15 舵机耳架、P17 功放托盘、P26 摄像头托架（**绕 X 转 90°**）、P29 核心板托架 |
| 材料/色 | PLA Matte 黑（**先烘干 45–55℃ 4–6h**；黑卷曾确认受潮） |
| 层高 | 0.16 |
| 为何合一盘 | 4 件同料同色同层高；最大 P29 46.1mm；一盘放得下 |

## 朝向与支撑（v2 关键）

| 件 | 朝向 | 支撑 |
|---|---|---|
| **P15** | 口袋朝上；底面朝下 | **局部树支撑**：z≈15–16（72 mm²）+ z≈20–21（142 mm²，耳垫/高墙下沿）。5% 树、仅打印板；若支撑落在舵机耳垫接触面，刷阻挡器，让 8mm 耳垫桥接 |
| **P17** | 托盘朝上；底面朝下 | **局部树支撑**：z≈7–8 的 **376 mm² 托盘下沿**（托盘比 12×12 底座外挑 5mm）。5% 树、仅打印板；支撑落在托盘**外沿**，不碰功放口袋 |
| **P26** | **已绕 X 转 90°：镜管朝床**；摄像头腔朝前 | **关**（镜管垂直、腔侧开；盘里已转好，不要再翻） |
| **P29** | 底朝下 | **关**（>45° 悬垂 0）+ 5mm brim |

> **不要再用 v1 的“四件全无支撑”**：P15 214 mm²、P17 376 mm² 悬垂会塌；P26 v1 盘没转 90°，镜管 6.5 水平桥会垂。v2 已把 P26 转好、P15/P17 改局部支撑。

## 质量参数

| 参数 | 值 |
|---|---|
| 墙层数 | 4；Classic；检查薄壁开 |
| 填充 | 20% gyroid |
| 支撑 | 树状、**仅在打印板生成**、密度 **5%**、分支 **2mm**、顶距 **0.2**、界面 **1 层**、XY **0.5** |
| Brim | 仅 P29 **5mm**；P15/P17/P26 不加 |
| 其他 | Z-hop 0.4；最小层时间 8s；风扇 100%；小周长 30mm/s；接缝对齐 |
| 预设 | 0.16 新预设；**不要用旧 `EffMeet2-v6 0.20 H2S`（wall 6 / sbpo 0）** |

## 切片后预览必看

1. **P26**：镜管是**竖直**的（不是水平）；第一层是镜头面；摄像头腔侧开；无支撑。
2. **P15**：支撑只在 z≈15–16 和 20–21 的下沿；不在舵机耳垫接触面。
3. **P17**：支撑只在 z≈7–8 的托盘外沿；不在功放口袋/柱顶。
4. **P29**：无支撑，5mm brim 完整。
5. 层数：P29 288、P15 148、P17 75、P26 81（13/0.16）。

## 打印后检验

- **P15**：MG90S 滑入 **13.7** 口袋，留 ±2mm 张紧；耳孔对架孔。
- **P17**：MAX98357A 落在 **12.6 距两柱**，`M2×4` 手拧入，板贴平、排针侧不顶围边；总高 12.1。
- **P26**：镜头凸台进 **Ø6.5** 镜管到底、模组不晃；FPC 不折死。
- **P24**：摄像孔 **Ø6.8**（旧件 4.2 需钻）；与 P26 6.5 镜管同轴。
- **P29**：核心板插 **1.8** 槽到底不晃；2×M3 对 P23 头底柱。
- 任一判据不过 → 停，按 `MEASUREMENTS.csv` 记 MEASURED_UNFITTED，不硬装。

## 装前 30 秒

量 **P26 镜管内径 ≈6.5**、**P24 摄像孔 ≈6.8**、**P15 口袋宽 ≈13.7**、**P17 总高 ≈12.1**、**P29 槽宽 ≈1.8**。
