eleanor-wsyy/EffMeet2/hardware/enclosure/README.md

# 外壳资料入口已统一

当前外观、可编辑建模、参数、视觉稿及BOM统一位于[../robot-design/README.md](../robot-design/README.md)。

原有外壳说明和图片归档到[历史资料](../robot-design/archive/README.md)，不再作为当前制造规格。
