eleanor-wsyy/EffMeet2/assets/enclosure/README.md

# 外观视觉资料入口已统一

当前AI主视觉、建模审阅、旧概念图和模型源文件全部迁移到[hardware/robot-design](../../hardware/robot-design/README.md)。

本目录仅保持历史导航，不再分散存放/维护第二份设计资料。
