eleanor-wsyy/EffMeet2/hardware/robot-design/round-yaw-v2/concept/nomi-aligned-20261010/SOURCE.md

# NOMI方向效果图依据

2026-10-10，按用户明确要求重新参考蔚来官方NOMI；不继续白色大脸颊/小横窗方向。

参考角色：

1. 本项目上一轮候选仅用于现有硬件/底座体积/配色约束，不保留其小横窗。
2. [蔚来官方近景](https://cdn-public.nio.com/www-nio-cn/sheng-ji-ang-ran-ling-gan-ji-fa/es6-2025/cockpit/carousel-screen-04-desktop.jpg)和[官方ES6页面](https://www.nio.cn/es6)用于球头、圆面部与短连接的形式参考；不复制商标、车内安装或性能。

仍是普通矩形LCD＋圆形黑打印面板。图像生成不能证明黑框/屏背景真正完全一致，不能从生成图量毫米尺寸。物料/核心布局不换，既有参数文件不改；孔位、面板接收和短颈内藏边以[组装接口更新](../../EXTERIOR_ASSEMBLY_REVISION.md)为待CAD落实事项。

完整提示词见prompt.txt，付费账户/平台回执仅存local-only。图片不作为制造或实机放行。
