eleanor-wsyy/EffMeet2/hardware/robot-design/round-yaw-v2/concept/refined-friendly-20261010/DESIGN_NOTES.md

# 圆润转头版 · 外观整合优化候选

2026-10-10。用户反馈上一版效果图不好看，要求在工程实际基础上优化。此目录保存新的外观候选，不覆盖原模型、BOM或已记录的尺寸验证。

## 改哪里

- 缩小黑面部占比，改为约90×96mm圆角面部区域，白色头壳形成明显的脸颊和额头。
- 仍用普通2.4英寸矩形LCD；周围黑框与屏背景颜色靠近，窗口边缘简洁，但不假装是整片曲面屏。
- 白色短颈外观与头壳连接，降低裸黑轴视觉存在感，仍保留独立转轴和运动间隙。
- 底座保留约180×164×76mm空间目标，改圆润肩部/侧面，不能为好看变成薄盘或缩掉主板空间。
- 取消独立灰色喇叭装饰罩，直接在壳体开短槽；按钮齐平并保持可达，滑盖保留。

## 不增加的工艺

ABS-GF白/黑裸打，不喷漆、不激光切整面透明罩、不采购圆屏/AMOLED，不改成无刷机构。白色按钮/颈属于本候选外观改动，不代表旧打印配色说明已冻结。

## 工程事实与待验证项

现有板形/器件和外包络作为约束目标保持；生成图不保证每处尺寸精确。约90×96mm黑面部仅是设计起点，应检查79.4×58.4mm显示PCB、镜头/滑盖、安装柱和曲面内腔是否能同时容纳。

新底座轮廓、白颈包络及孔位尚未建模。后续CAD需重新核对主板125×90×22mm预留、转台/传动/走线区域、±45°间隙、支撑可取性、线孔与声学。不得把旧fit-report用于证明新轮廓“已经放得下”。

这是AI图生图外观提案，不是新STL/3MF、打印放行或实机等效验证。用户确认方向后再落实CAD/BOM对应改动；不自动升为最终认可视觉。

## 来源

输入为用户本次提供的上一版效果图；完整提示词见prompt.txt。生成平台原始回执只存local-only。

## 候选收敛

候选01仍保留较大的竖向黑面部，只作为过渡稿。候选02进一步改为约82–86×64–68mm的横向小表情框，摄像头和白色滑盖独立放在额头，白壳占比明显增加；这是本轮优先方向。

候选02初始AI图把圆角黑框和屏幕反光画得过于一体，容易被误读为定制胶囊屏。随后局部修订明确：外圈是哑光打印黑框，中间才是普通4:3矩形LCD；不增加整片透明盖。圆角外框可以遮边，不能为了造型切割LCD有效区；实际显示范围与边框设计仍由CAD/实板确认。

各候选约束均未通过新轮廓实物验证，不继承旧布局报告的装配结论。

## 本轮建议展示稿

优先看[白色脸颊＋普通矩形LCD效果图](EffMeet2_白色脸颊_普通LCD_优化效果图.png)。它保留白壳占比、圆润基座和低存在感短颈，同时明确普通矩形LCD与圆角打印框的区别。候选02原图作为视觉探索保留，不作为定制圆角玻璃屏采购依据。

本轮只是外观改进，未改模型及现有装配/测试记录；新小面框和底座曲线仍要实板复核。
