eleanor-wsyy/EffMeet2/docs/handoff/2026-10-21-app-ux-refinement.md

# 2026-10-21 手机端 APP UX/UI 精修

## 范围

真正修改的是 `apps/web-demo/` 可交互 APP，不是只改展示页。展示页 `docs/showcase/在议-手机端界面全景.html` 在 APP 验证后重新截图生成。

修改文件：

- `apps/web-demo/index.html`：首页信息层级、加入会议、候选弹层、地图筛选、我的、状态提示
- `apps/web-demo/app.js`：设备状态、候选状态机、拒绝/过期、参与状态、地图筛选
- `apps/web-demo/styles.css`：品牌色、状态时间线、筛选、套餐折叠、粘性加入按钮
- `apps/web-demo/state.js`：候选状态文案
- `apps/web-demo/store.js`：演示设备默认值
- `apps/web-demo/assets/effmeetbot-logo.png`：正式 Logo
- `apps/web-demo/assets/mic.svg`、`robot.svg`：品牌色替换

## 品牌

- 深海军蓝 `#0A0B27`：标题、主文字
- 亮蓝 `#2857F3`：主操作、焦点、品牌强调
- 暖白 `#F7F6F2`：页面底色
- 语义色保留：绿色已回应、琥珀可能未回应/待核对、红色危险操作
- 橙色不再作为 APP 默认强调色；APP 内所有品牌强调已替换为亮蓝

APP 顶栏改用正式 `effmeetbot` Logo + 中文「在议」，不再使用字体拼写或旧徽章。

## 关键修正

### 1. 演示设备状态

- 默认设备改为 `{connected:false, virtual:true}`。
- 首页显示「演示机器人 · 虚拟设备」，电量显示「76% · 示意」。
- 「重新连接机器人」改为「设备说明」，点击只解释演示环境，不再伪造连接成功。
- 会中/首页均明确「演示环境 · 不连接实体机器人」。

### 2. 候选文案与概念

- 「你的观点可能还没被现场听到」→「你的观点可能尚未得到现场回应。」
- 候选卡显示说话人、原始时间、证据条数。
- AI 判断保持为候选，不写成确定事实。
- 两个操作同等清晰：「请机器人提醒」/「暂不提醒」。

### 3. 确认后的状态

候选状态机：`awaiting_confirmation → queued → broadcasting → completed`。

- 确认后按钮变为「已确认 · 等待处理」，不可重复提交。
- 2.1 秒后进入「本地模拟执行中…」。
- 4.5 秒后进入「已确认」，显示「已生成模拟播报回执 · 未连接真实机器人」。
- 新增三步时间线：本人确认 → 命令生成 → 回执记录。
- 不再出现确认后按钮仍写「请机器人提醒」的问题。

### 4. 拒绝与过期

- 拒绝：按钮变为「已暂不提醒」并禁用；提示「未生成播报命令」；会中参与状态同步为「已暂不提醒」。
- 过期：显示「已过期 · 未提交提醒」；按钮为「重新校验并提醒」，只有显式点击才重新校验并开始新的 120 秒窗口。
- 刷新页面不会自动重新激活已过期候选。
- 重复点击由 `promptBusy` 与状态判断拦截。

### 5. 首页层级

顺序改为：

1. 加入会议（大面积主 CTA）/ 快速会议 / 预定会议
2. 机器人状态（虚拟设备、示意电量、设备说明）
3. 最近会议
4. 更多（扫码加入）

最近会议仍是标题、日期、人数、摘要；扫码从首屏主路径移到次级区域。

### 6. 会中

- 新增「我的参与」状态行：线上成员 / 1 条观点待确认 / 已请求提醒 / 提醒回执已记录 / 已暂不提醒 / 候选已过期。
- 观点地图保留为显眼次级入口。
- 共享内容与转写保持原结构。

### 7. 观点地图

- 新增筛选：全部 / 已回应 / 待核对，实际过滤卡片。
- 统计保持全部观点、已回应、待核对。
- 卡片新增关系表达：「原始观点 → 现场回应」/「原始观点 → 尚待核对」。
- 原话展开保留；证据缺失时显示「暂无关联原话」。

### 8. 我的

- 套餐对比改为折叠的「套餐与额度」，默认收起，降低商业化感。
- AI 额度继续标注「本地演示值，不连接真实计费系统」。
- 联系人、演示模式、重置、设置保持原结构。

### 9. 加入会议

- 标题改为「连接现场，让你的观点进入讨论」。
- 会议号与昵称预填示例值，一次点击即可进入。
- 麦克风/摄像头授权仍为可选模拟，不声称真实采集。
- 「进入会议」按钮改为粘性底部，滚动时始终可见。

## 验收

### 核心状态流（Playwright，390×844）

| 步骤 | 结果 |
|---|---|
| 首页 | 设备显示「演示机器人 · 虚拟设备」；加入会议为最大 CTA |
| 快速会议 → 候选 | 标题「…尚未得到现场回应」；按钮「请机器人提醒」 |
| 确认 → queued | 按钮「已确认 · 等待处理」；时间线出现 |
| 2.1 s → broadcasting | 按钮「本地模拟执行中…」 |
| 4.5 s → completed | 按钮「已确认」禁用；显示模拟回执 |
| 拒绝 | 按钮「已暂不提醒」禁用；待确认卡显示「已暂不提醒」 |
| 过期 | 按钮「重新校验并提醒」；点击后开始新的 120 秒窗口 |
| 地图筛选 | 全部 7 → 已回应 3 → 待核对 4 |
| 390 横向溢出 | 0 |

### 自动化

- `node --test tests/*.test.js`：32 项全过。
- 页面无 JS 错误；资源 200。

## 截图与展示页

- 12 张真实截图：`dist/review/screens/`（01–07、09、11–14）
- 展示页：`docs/showcase/在议-手机端界面全景.html`
- 展示页新增「候选的其他状态」：已暂不提醒、已过期
- 桌面/移动验收图：`assets/submission/screens/local/gallery-*.png`

## 线上静态 Demo

- 地址：https://codyning-effmeetbot.ms.show/demo/
- 已同步 `apps/web-demo/` 并重新部署，静态站状态 `Running`。
- 公网实测：首页显示「演示机器人 · 虚拟设备」；快速会议 → 候选标题更新；确认后按钮为「已确认」且禁用，回执文案为「已生成模拟播报回执 · 未连接真实机器人」。

## 仍未实现

- 执行失败状态：状态机与文案支持 `failed`，但本地演示没有可触发的失败路径，未伪造。
- 真实设备连接、真实机器人转头/灯光/语音联动：仍为集成中/未验收。
- 真实计费、账号、多人服务：保持本地模拟。
- 完整观点关系画布：本轮只做关系标签与筛选，不做无限画布。

## 功能版 apps/web 同步（2026-10-22 收尾）

功能版连接真实控制器，本轮只改 UI 文案、品牌与确认态，不改后端契约、鉴权或 media 逻辑。

- 页眉/会议页改用正式 `effmeetbot` Logo + 在议，移除旧的 EffMeet 2 文案
- 品牌橙 → 深海军蓝/亮蓝；麦克风图标同步；背景从中性暖黄改为冷白/浅蓝
- 候选标题改为「你的观点可能尚未得到现场回应。」
- 候选 helper 改为「只有你确认后，才会请求机器人介入现场。它会在停顿处复述原话，不替人下结论。」
- 次按钮改为「暂不提醒」
- 确认后按钮按真实状态显示：已确认等待处理 / 正在提醒现场… / 已确认 / 执行失败 / 重新校验并提醒，不再停留在「请机器人提醒」
- 候选标签同步为诚实口径（已过期未提交、已暂不提醒等）

验证：

- `apps/web` 前端测试 41/41 通过
- 本地控制器 `/app/` 390px 加载正常，无 JS 错误（仅 favicon 404）
- 全仓 Python 129 项测试通过
