eleanor-wsyy/EffMeet2/docs/product/Spotlight_在议_2026-10-21.md

# 在议：让线上成员的观点真正进入讨论

**在线，不等于在场。**

在议整机渲染

混合会议里，远程成员常常“在场”了，却没有真正进入讨论。话被扬声器播出来，现场继续聊别的；会后记录里有一句话，但没有人回应过它。

在议是一台守在会议桌边的 AI 桌面伙伴。它不替人喊话，而是先判断“这条观点是否已经得到现场回应”，再把决定权交还给观点本人。

---

## 一个常见的会议瞬间

回收箱方案评审，线上丙说：

> 满溢检测的话，用重量传感器比摄像头便宜很多，而且不用处理隐私问题。

接下来的四十秒，现场甲和乙继续争论折叠结构的强度、卡扣和开模成本。没有人提到重量传感器。

这不是注意力问题，是结构问题：发言被记录了，观点却没有进入讨论。

**被听见，不等于被回应。**

---

## 五个动作，一条证据链

### 01 提出观点

线上成员在客户端发言。转写结果带上 `utterance_id` 与说话人归属，实时写入本地事件账本。

会中界面

### 02 识别遗漏

千问对照观点之后的现场窗口，只回答一个问题：有没有可关联的回应。证据不足、说话人不明，就弃权。

```
possibly_unresponded   观点明确，窗口内无关联回应
responded              时间邻近，语义明确承接
uncertain              证据不足，交人工核对
```

### 03 私人确认

候选只发给观点本人。卡片里是原话与倒计时，不是系统替人写好的结论。120 秒未确认自动取消。

本人确认

### 04 现场发声

确认后，机器人转向现场，在停顿处复述观点要点。它复述原话，不替人下结论，也不参与争论。

**当前为模拟回执**：实体整机的连续会议播报仍在装配与联调，不宣称已完成。

### 05 回到地图

散会后打开观点地图：聊了什么、谁持什么观点、哪些问题仍未回应。每条记录都能回到当时那句原话。

观点地图

---

## 给观点一副身体

200 毫米高，一只手掌的占地。头与底座之间只有一圈短颈：转头时，麦克风留在桌面，声音不跟着晃。

正面渲染

- 整机包络：153 × 139 × 201 mm
- 打印件：32 件
- 跨轴走线：11 根
- 焊接：仅喇叭 2–4 处

核心板、摄像头与屏在头部；双麦、功放、喇叭、舵机与停止键在底座。PLA Matte 分段打印，螺纹与卡扣保留在模型原生几何里。

内部结构

以上为 v6 工程模型渲染，不是实机照片。装配与连续会议验收进行中。

---

## 你不点头，它不开口

1. **本人确认**：只有观点所有者能授权提醒。120 秒未确认，候选自动取消。
2. **不确定则弃权**：证据不足、说话人不明、多人混说，一律输出 `uncertain`。宁可不问。
3. **原文可追溯**：每条提醒绑定原始 `utterance_id`，点一下回到当时那句原话。
4. **人保留最终控制权**：AI 只产出候选与证据，不生成动作指令，不评价观点对错。

---

## AI 只提出候选

技术链路：语音输入 → FunASR 转写 → SQLite 事件账本 → 千问三态判断 → 服务端校验 → 本人确认门控 → 机器人 / 观点地图。

实验台使用真实 `qwen-plus`，结果经 `AnalysisResult` 契约校验。三组预设的真实结果：

| 预设 | 真实状态 | 耗时 | 说明 |
|---|---|---|---|
| A 可能未回应 | `uncertain` | 5.5 s | 模型认为现场只讨论折叠结构，证据不足，弃权 |
| B 已回应 | `responded` | 7.6 s | 现场发言明确承接观点，回应证据成立 |
| C 不确定 | `uncertain` | 7.3 s | 转写破碎、多人抢话，无法确认回应关系 |

A 的预设名称与真实结果不一致，这是有意保留的事实：模型在证据不足时弃权，没有为了演示效果改成正向候选。

AI 判断实验台

---

## 现在可以体验

- **产品官网**：https://www.modelscope.cn/studios/CodyNing/effmeetbot
- **AI 判断实验台**：https://www.modelscope.cn/studios/CodyNing/effmeetbot-ai
- **主视频（74 秒）**：https://codyning-effmeetbot.ms.show/assets/film/effmeetbot-film-1080p.mp4
- **GitHub**：https://github.com/eleanor-wsyy/EffMeet2

软件闭环可以完整演示：新建会议、加入发言、以线上成员身份收到候选、确认后看到模拟播报、回到观点地图。整机装配与连续会议验收仍在进行，未完成的部分不写成已完成。

---

## 边界

- 机器人播报与转头为模拟回执；整机装配中。
- 官网机器人图为工程渲染，不是实机照片。
- 公共 Demo 使用免费 CPU，冷启动可能需要数十秒。
- 原始音频与会议记录留在本机；云端只接收必要的发言文本用于判断。

**AI 提出候选，人保留决定权。**
