eleanor-wsyy/EffMeet2/docs/product/官方表单填写稿_2026-10-21.md

# 官方表单填写稿 · 2026-10-21

> 依据天猫 AI 黑客松提交页（2026-10-21 核对）。带 * 为必填；队伍信息需本人补全。

## 队伍信息

| 字段 | 填写内容 |
|---|---|
| 队伍名称* | 待填 |
| 队长姓名* | 待填 |
| 联系手机* | 待填 |
| 学校 / 院系* | 待填 |
| 队员姓名 | 待填 |

## 参赛赛道*

`效率进化`（用 AI 重构学习、研究与工作方式）

## 作品信息

**作品名称***（29/30）

```
在议（effmeetbot）｜让线上成员坐回桌边的会议伙伴
```

**作品介绍***（344/500）

```
在线，不等于在场。在议是一台守在会议桌边的 AI 桌面伙伴，面向 3–6 人线上线下混合的科研组与课程项目组。它替线上成员看见现场：白板与图纸随手一拍，原图直达手机。它替观点开口：本地 FunASR 实时转写，千问判断观点是否已获现场回应，证据不足就弃权；只有本人确认后，机器人才转向现场复述原话，120 秒未确认自动取消；会后观点地图可回到每条原话。当前软件闭环可完整演示，实体整机装配与联调进行中。体验：https://www.modelscope.cn/studios/CodyNing/effmeetbot ，AI 实验台：https://www.modelscope.cn/studios/CodyNing/effmeetbot-ai 。未选择特别赛题，参加「效率进化」主赛道。
```

**作品封面***：`assets/submission/cover-1920x1080-dark.png`（1920×1080，16:9）

**作品提交方式***：魔搭创空间链接

```
https://www.modelscope.cn/studios/CodyNing/effmeetbot
```

## AI 实践说明

**使用的 AI 模型 / 工具 / 开发平台***：千问 Qwen、百炼、其他（本地 FunASR / SenseVoiceSmall）

**AI 技术实践说明***（235/300）

```
本地 FunASR 完成实时转写与说话人归属；云端 qwen-plus 判断线上观点是否已有现场回应，输出 responded / possibly_unresponded / uncertain 三态与证据 utterance_id。服务端校验 JSON、状态、证据是否存在，虚构证据与无现场回应一律报错；不确定直接弃权，不生成提醒。qwen3-vl-plus 用于现场照片文字识别。所有 AI 输出只是候选，须本人在手机端确认后才触发播报，120 秒未确认自动取消。
```

**BONUS · 端云协同技术加分**（选填）

```
端云协同：本地电脑承担 FunASR 转写、SQLite 事件账本与确认门控，原始音频不出本机；云端 qwen-plus 只接收必要的发言文本做候选判断，返回结构化证据。断网时本地仍可转写与记录，联网后补判断。
```

## 同意规则

勾选：我已阅读并同意《活动须知》，承诺作品为本届原创，所提交内容真实有效。

## 提交后回填

- 提交确认截图保存到 `assets/submission/`
- 在 `docs/handoff/2026-10-21-submission-validation.md` 记录提交时间与状态

## 提交结果

- 状态：**已提交**（用户确认，2026-10-21 晚）
- 应用（创空间）：`https://modelscope.cn/studios/CodyNing/effmeetbot`
- 实践内容：**留空**（平台只接受 `modelscope.cn/spotlight/...` 站内链接，当前没有站内发布记录）
- 模型 / 数据集 / Notebook / MCP / Skill：留空
- 公网补充材料（未填入表单，可作传播）：
  - 图文：https://codyning-effmeetbot.ms.show/spotlight/
  - 主视频：https://codyning-effmeetbot.ms.show/assets/film/effmeetbot-film-1080p.mp4
  - 手机端全景：https://codyning-effmeetbot.ms.show/mobile-ui.html
