eleanor-wsyy/EffMeet2/docs/product/参赛提交文案_2026-10-21.md

# 初赛提交文案 · 2026-10-21（截止当日）

> 按官方表单字段拆解（依据：docs/product/EffMeet2_论文依据与技术路径.html §提交要求，2026-10-04 核对）。
> 字数已用脚本核验：名称 29/30，简介 362/500，AI 说明 216/300。

## 作品名称（≤30 字符）

```
在议（effmeetbot）｜让线上成员坐回桌边的会议伙伴
```

## 作品简介（≤500 字符）

```
在线，不等于在场。在议是一台守在会议桌边的桌面机器人，帮线上参会的人重新"坐回桌边"。它替你看：白板草图、摊开的图纸，随手一拍，原图直达远程成员手机；它替你开口：它安静旁听全程，发现你的观点被讨论淹没时，不替你喊——先悄悄问你"要我提醒大家吗"，你点头，它才转向现场替你发声；它替你记住：散会后打开软件，观点地图一目了然——聊了什么、谁持什么观点、哪些问题待回应，点一下回到当时的原话。分寸感是它的底线：你不点头它不开口，拿不准宁可不问，每句提醒都能回溯到你的原话，一键即可静音。技术上，本地语音识别加千问大模型判断，配合"候选—本人确认—播报"门控与证据链设计，把 AI 的发言权牢牢关进人的决定权里。首发场景为 3–6 人线上线下混合的科研组与课程项目组。软件闭环已可完整演示，实体机型装配与联调进行中。
```

## AI 使用实况说明（≤300 字符）

```
本作品使用阿里云百炼/DashScope 模型服务：本地 FunASR 完成实时语音转写；千问 qwen-plus 依据自研候选规则提示词（YAML 管理）判断"哪个观点可能被忽视"，产出带原文引用的结构化候选；qwen3-vl-plus 负责现场照片内容核对。所有 AI 输出仅作为候选，须经本人在网页端确认后才播报，120 秒未确认自动取消，重复命令幂等去重；每条提醒可回溯到发言原文。AI 不替任何人做决定，人保留全部控制权。
```

## 提交链接与配套物料

- 产品官网（静态创空间）：https://www.modelscope.cn/studios/CodyNing/effmeetbot
- AI 判断实验台（Gradio 创空间）：https://www.modelscope.cn/studios/CodyNing/effmeetbot-ai
- 产品交互 Demo：随官网部署在 `/demo/`，无需登录
- 封面：`assets/submission/cover-1080x1920.png`（1080×1920）
- 附件：ZIP 由 `scripts/package_submission.py` 生成，含 `site/`、`apps/web-demo/`、运行说明与技术资料
- 视频：按 `docs/product/EffMeet2_演示脚本_v1.md` 录屏，跳过转头节拍（舵机未实机验收），建议 ≤90 秒；当前状态：未录制

## 提交前操作

1. 用 `site/` 发布静态创空间，确认公开地址可匿名访问。
2. 用 `apps/ai-demo/` 发布 Gradio 创空间，在 Secrets 配 `QWEN_API_KEY`，跑通三组预设并截图留档。
3. 把两个地址回填到官网 `index.html` 的 `#ai-demo-link` 与本文档。
4. 在赛事后台填写必填项，保存提交确认截图。

## 红线自查（提交前过一遍）

- 不写"机器人已实机转头/实播"——舵机与实播未验收
- 不写"LiveKit 公网链路已完成"——真实服务器两端音频未验收
- 现状表述只用："软件闭环可完整演示，实体机型装配联调进行中"
