eleanor-wsyy/EffMeet2/docs/product/EffMeet2_演示脚本_v1.md

# 在议 演示脚本 v1

> 用途：黑客松初赛演示 + B/E 的测试基准。主流程约 5 分钟，负例作为评委问答备答。
> 角色：**甲**（现场成员·主持人）、**乙**（现场成员）、**丙**（远程成员，线上参会）。
> 模式约定：每节拍标注【实时】/【mock】/【人工】——演示时如实标注，不伪称自动成功。

---

## 0. 演示设定

**讨论主题**：课程设计作业——"校园智能回收箱"方案评审（选它的原因：有实体、好画草图、天然产生"传感器选型"这类容易被淹没的技术观点）。

**物理布置**：
- 桌面：机器人（固定底座）、一张 A4 手绘草图、主持电脑
- **丙的声音来源：会议电脑的扬声器外放**（远程人声与现场人声会同时进入机内拾音——这是刻意的，演示 AEC 与来源分离的真实工况）
- 丙的视角：手机或另一台电脑打开软件入口

**测试草图规格**（给 B/E 的固定道具）：
- A4 横向，纸面画回收箱正面结构：顶部投放口、箱体分三格（可回收/厨余/其他）、正面一块小屏幕位置、顶部标注"满溢检测？"——**"满溢检测"处留一个问号，这是丙后面要接的话头**
- 手绘感即可，不需要精美；线条用黑色粗记号笔，保证抓拍可辨认

---

## 1. 主流程逐句脚本

### 节拍 1 · 看见现场【实时：抓拍】

| 时间 | 谁 | 台词/动作 | 系统事件 |
|---|---|---|---|
| 0:00 | 甲 | "人齐了，我们开始。今天把回收箱的方案定下来。" | meeting.created |
| 0:10 | 甲 | （在纸上画草图）"我先画个大概——投放口在顶上，里面分三格。" | utterance.final ×n（现场声道） |
| 0:40 | 丙 | （线上）"等一下，我这儿看不清你画的，摄像头里就是一团影子。" | utterance.final（remote 声道） |
| 0:50 | 甲 | "我让它拍一张给你。"（按机身上的抓拍键） | capture.created |
| 1:00 | 旁白/画面 | 丙的手机弹出原图 + 一行 AI 辅助描述："手绘草图：三格回收箱正面，顶部投放口，右上有'满溢检测？'标注" | analysis（视觉描述，mock 可预置） |
| 1:10 | 丙 | "看到了看到了，哦你还标了满溢检测。" | utterance.final |

**评委视角要点**：线上成员看到的**是原图**，AI 描述只是辅助——说清楚"描述可以回查原图核对"。

### 节拍 2 · 观点被淹没【实时：转写 + 候选】

| 时间 | 谁 | 台词/动作 | 系统事件 |
|---|---|---|---|
| 1:20 | 乙 | "我觉得箱体用折叠的，运输方便。" | utterance.final |
| 1:30 | 甲 | "折叠的结构强度够不够？回收箱会被撞。" | utterance.final |
| 1:40 | 丙 | （线上，认真提）"我说个事——满溢检测的话，**用重量传感器比摄像头便宜很多**，而且不用处理隐私问题。" | utterance.final（remote；**这是种子观点**） |
| 1:50 | 乙 | （没听见/没接话，继续争）"折叠的那个连接件可以用……" | utterance.final |
| 2:00 | 甲 | （也没接丙的话）"对，而且折叠的模具成本高。" | utterance.final；现场讨论继续滚动 |
| 2:10 | 旁白/画面 | 后台：千问分析——丙的观点 40 秒无人回应，且与当前话题（结构/成本）相关 | analysis.completed（status=possibly_unresponded，附 evidence_ids） |
| 2:20 | 旁白/画面 | **丙的手机弹出候选卡**："你的观点可能还没被现场听到：'满溢检测用重量传感器比摄像头便宜'——要请机器人提醒一下吗？" 按钮：请机器人提醒 / 不必提醒（120 秒倒计时） | intervention.created（awaiting_confirmation） |

**评委视角要点**：候选卡上**能看到丙自己的原话**（证据），不是 AI 的凭空判断；强调"AI 提候选，不做判决"。

### 节拍 3 · 本人确认 → 机器人提示【实时：确认 + 播报】

| 时间 | 谁 | 台词/动作 | 系统事件 |
|---|---|---|---|
| 2:35 | 丙 | （看一眼，点）"请机器人提醒。" | intervention.decided（confirm；校验 owner + revision） |
| 2:40 | 旁白/画面 | 机器人**没有立刻开口**——等乙把当前这句话说完（安全停顿），执行前再复核一次：这 15 秒内仍无人回应 | （停顿检测 + 回应复核，复核通过） |
| 2:50 | 机器人 | （转头朝向现场，温和地）"打扰一下——刚才线上成员提到，满溢检测可以试试重量传感器，成本会低一些。现场可以回应一下吗？" | robot.command（speak）→ receipt: accepted → started → completed |
| 3:10 | 甲 | （抬头）"哎这个有道理，重量传感器确实比摄像头便宜一半都不止。" | utterance.final |
| 3:20 | 乙 | "而且不用担心拍到人。那满溢检测就这么定？" | utterance.final；response 绑定到丙的观点（ai_suggested） |

**评委视角要点**：三处设计要讲——①确认后仍等安全停顿；②开口前复核是否已被回应；③机器人说的是**丙的原话摘要**，不是模型即兴发挥。

### 节拍 4 · 会后观点地图【实时：记录生成】

| 时间 | 谁 | 台词/动作 | 系统事件 |
|---|---|---|---|
| 3:50 | 甲 | "今天先到这，散会。" | meeting.ended（或 summary 生成触发） |
| 4:00 | 旁白/画面 | 甲乙丙三人各自打开软件，**看到同一张观点地图**：3 个观点 → "折叠箱体"（甲/乙讨论中，待核对）、"满溢检测用重量传感器"（丙提出，**已回应**·经现场确认）、"连接件方案"（乙提出，待核对） | summary.updated（每项带 evidence_ids + verification_status） |
| 4:20 | 丙 | （点"已回应"那条）"能回到我的原话"——展开当时的转写原文 | 原文回溯演示 |
| 4:35 | 旁白 | "注意地图里**没有伪造任何已达成的决议**——待核对的就标待核对，AI 推测的回应关系和本人确认过的分开标。" | — |

**收尾话术**（甲对镜头/评委）："刚才这个过程里，AI 只做了一件事：提出有证据的候选。要不要提醒，是丙自己决定的；说什么，是丙自己的话。**它把话题还给人，而不是替人说话。**"

---

## 2. 负例备答（评委追问时现场演示，各 30 秒）

| 场景 | 操作 | 预期 |
|---|---|---|
| 无确认不播报 | 重演节拍 2，丙不点任何按钮，等 120 秒倒计时结束 | 候选过期，机器人全程安静 |
| "不必提醒" | 丙点"不必提醒" | 不产生任何动作；地图上该观点如实标"未被回应" |
| 已回应不打扰 | 乙当场接了丙的话之后，系统不再生成候选 | 无候选卡弹出 |
| 不确定就弃权 | 多人同时说话/语音不清的片段 | 状态标"需人工核对"，不产生候选 |
| 重复点击 | 丙连点三次"请提醒" | 只播报一次（幂等） |
| 别人不能替你决定 | 甲的界面上尝试替丙确认 | 被拒绝（403） |

## 3. 给 B/E 的逐句发言文本（测试喂数据用）

上面的台词表就是逐句文本。单独抽出的纯文本版（按 utterance 逐行，格式：`[声道] 说话人: 文本`）见附录 A；**所有数字、观点措辞以台词表为准，测试时不得自由发挥**——同样的输入才能复现同样的候选。

## 4. 演示纪律（红线）

- 每个环节开场先报模式："这段是实时转写 / 这段是预录回放"
- 任何环节失败 → 按 L1/L2 降级路径走（L1 人工补录转写、L2 预录回放），并在界面标注，**不伪装成实时成功**
- 机器人播报期间，旁白必须点一句："它播报的声音不会进入自己的判断链路（自触发抑制）"

---

## 附录 A · 纯文本台词（测试喂数据用）

格式：`[声道] 说话人: 文本`。声道 = onsite / remote。

```
[onsite] 甲: 人齐了，我们开始。今天把回收箱的方案定下来。
[onsite] 甲: 我先画个大概，投放口在顶上，里面分三格。
[remote] 丙: 等一下，我这儿看不清你画的，摄像头里就是一团影子。
[remote] 丙: 看到了看到了，哦你还标了满溢检测。
[onsite] 乙: 我觉得箱体用折叠的，运输方便。
[onsite] 甲: 折叠的结构强度够不够？回收箱会被撞。
[remote] 丙: 我说个事，满溢检测的话，用重量传感器比摄像头便宜很多，而且不用处理隐私问题。
[onsite] 乙: 折叠的那个连接件可以用卡扣，拆装很方便。
[onsite] 甲: 对，而且折叠的模具成本高。
[onsite] 甲: 哎这个有道理，重量传感器确实比摄像头便宜一半都不止。
[onsite] 乙: 而且不用担心拍到人。那满溢检测就这么定？
[onsite] 甲: 今天先到这，散会。
```

**喂数注意**：丙的两句 remote 台词之间必须间隔足够现场台词（乙、甲各一句不接话），候选才成立；"甲: 哎这个有道理……"这句是**对丙观点的现场回应**，回应绑定测试以它为准。负例测试时删掉这句即得"未被回应"场景；把丙的台词换成含糊语气（"呃这个好像也行吧"）即得"不确定"场景。

---

## 附录：手机用户端合成候选演示节奏（2026-10-09）

仅用于本机/临时 HTTPS 的 mock 联调，不替代正文的真实会议验收，也不代表真实模型或机器人实播。

1. 先准备手机、麦克风授权、可信 HTTPS 与屏幕录制，再生成合成会议。
2. 从最后一次生成候选起，**60 秒内**打开新邀请链接并演示「查看状态 → 请机器人提醒」；60 秒是演示节奏建议，**服务端有效期仍为 120 秒**。倒计时以服务器为准，打开/刷新/轮询不会续期。
3. 保留其余独立候选，展示不同候选的确认或不提醒；不要在候选生成后再等待数分钟配置设备。
4. 初始待确认演示超时，可重新生成一场合成会议并使用新的邀请链接。本机控制器默认 8765 端口的备用命令：

   ```powershell
   ./.venv/Scripts/python.exe scripts/seed_participant_demo.py --port 8765 --candidates 4
   ```

   如端口不同，替换 `--port`；临时 HTTPS 网关仅开放其绑定会议，应重新启动原 HTTPS 启动命令并使用新地址/口令/会议 ID，不能把本机新建会议 ID 塞进旧网关链接。
5. 已过期候选可由本人显式重新校验，是否可提醒取决于服务端上下文和最终状态。这与展示「首次生成且未过期」不同，不要当作自动续期。
6. 不增加 `--ttl`，不修改 120 秒产品规则。模拟完成回执只说明 mock 流程成功；真实设备播报与安全停顿由团队联调验证。
