eleanor-wsyy/EffMeet2/docs/product/EffMeet2_报告修改指南_v2.md

# EffMeet2 报告修改指南 v2（增量版）

> 前提：v1 指南的大部分内容已被团队第二修订（commit `3e17e66`）覆盖——**双路线、桌面宠物形态、观点地图、DashScope 均已落地，且双路线口径经宁导线下拍板确认，不再讨论**。
> v2 只列剩余增量。基准版本：报告文本截至 commit `c2e847a`（2026-10-04 20:22）。
> 预计工时：30–45 分钟。

---

## A. "谁使用"扩宽（宁导拍板，10-04）

报告当前口径："以校园科研与课程项目小组作为首个使用场景"——这是场景选择，不是产品定义。黑客松评的是产品，产品定义要放开。

| 位置 | 改法 |
|---|---|
| 开头 hero 定位段 | "以校园科研与课程项目小组作为首个使用场景" → "面向有固定讨论节奏、线上线下并存的小团队；以校园科研与课程项目小组作为首发验证场景" |
| 作品定位块 | 同步一句："首版范围定为小组混合讨论；同一形态适用于分布式小团队例会、远程协作工作坊"（保留"大型会议室/任意会议软件兼容不进首版"的原有边界） |
| 表单草稿·作品介绍 | 见 §C 的新版全文 |

## B. 路线 B 补"账号绑定"（当前缺口）

路线 B 现在只写"接电、连 Wi-Fi 即用，仅需平板或手机"——**缺了账号**。多端软件 + 云端服务的终态必须有账号体系承载身份（契约里的 speaker 是会议内别名，需要账号映射；机器人与用户的归属关系也要靠绑定）。样机阶段用配对码即可，但叙事先立住。

| 位置 | 改法 |
|---|---|
| 产品使用路径块（路线 B 部分） | 补一句："首次使用：注册/登录账号、扫码绑定机器人并完成配网；之后设备上电自动在线，任何成员在自己的手机或平板上加入会议。" |
| 三阶段表·"首个可交付产品"行 | 路线 B 描述后补："账号绑定设备；配网、静音、升级、故障恢复与数据删除纳入验收"（后半句原有，合并即可） |

## C. 外层传播文案（眼球层）

报告整体是工程叙述，缺一个能让路人停下来的入口。两处改动：

**C1. 首页 hero 加痛点钩子**（主标为宁导定稿文案，保留现有副标作为展开）：

> 主标：**"在线，不等于在场。"**
> 副标（保留现状）："让线上观点，进入现场。"

**C2. 表单草稿两段重写**（直接替换现有草稿；字符数已按表单上限控制）：

**作品介绍（≤500 字符）**：

> 在线，不等于在场。EffMeet 2 是一款桌面会议机器人，帮线上的人"坐回桌边"：混合会议里，远程成员的发言划过屏幕、滚出讨论。它以桌面宠物形态守在桌边，替远程成员存在：替他拍下现场草图，原图直达手机；安静倾听讨论，发现观点被淹没时先问一句"要提醒大家吗"——本人点头，它才开口转述原话；散会后打开 App，观点地图一目了然：聊了什么、谁持什么观点、哪些问题待回应，每项都能回到当时的原话。无确认不播报，不确定则弃权。当前参赛 Demo 以电脑伴侣承载本地 AI；最终形态去除电脑依赖，机器人直连云端，平板手机即可完整使用。首个验证场景为校园科研组与课程项目小组，选择「效率进化」自由创作方向。

**AI 技术实践说明（≤300 字符）**：

> 机内 ESP32-S3 负责拾音前处理、Wi-Fi、播放与动作。路线A（Demo）：电脑伴侣应用运行 FunASR、事件账本与安全编排，云端千问（阿里云百炼 DashScope，qwen-plus）产出带原文证据的观点/回应候选、抓拍描述与观点地图数据；API Key 仅存服务端。路线B（最终形态）：机器人经 Wi-Fi 直连云端 ASR 与理解服务。远程音轨与业务事件分通道传输并取得成员同意；候选 120 秒未确认自动弃权，机器人仅在本人确认后播报，机内播放回执逐段记录。按统一契约实施，展示端云分工与完整体验闭环。

## D. 规则数字化小补（一处）

- "播报语气与时机"段："候选过期就取消" → "**候选 120 秒未确认自动取消**（与控制器实现一致）"；段末补："同一观点仅提醒一次；两次播报之间至少间隔 60 秒（防连续打扰，冷却值为建议值，待 B 在控制器实现后确认）"。

## E. 给 B 的同步项（不改报告，改实现）

1. `demo.html` 按钮文字统一为「**请机器人提醒 / 不必提醒**」。文案归 A 管，只换字符串，不动逻辑。
2. README 自述"冷却策略留给后续模块"——全局冷却 60 秒为 A 侧建议值，排进后续迭代即可，不阻塞本周。

## F. 明确不动（防改过头）

契约 JSON、双路线结构、宠物形态、观点地图、DashScope 选型、PNAS 引用区、M0–M5 计划、A–F 分工表——全部保持现状。

## 验收 Checklist

- [ ] 全文搜索"首个使用场景"，仅剩首发验证场景语境
- [ ] 路线 B 相关段落出现"账号绑定"
- [ ] 表单两段草稿已替换，字数在限内
- [ ] "候选 120 秒"出现在产品规则处
- [ ] 保护清单（§F）diff 为空
