eleanor-wsyy/EffMeet2/docs/product/EffMeet2_整改核实记录_2026-10-09.md

# EffMeet2 总体整改方案：核实与实施记录

核实日期：2026-10-09。原始基线：`923a8d0`（计划以此前 `0e35865` 为基线）。本记录只区分能核实的代码事实、环境观察与本轮实施结果，不把原方案当作已经证明的结论。

## 逐项核实

| 项目 | 本轮证据 | 处理 |
|---|---|---|
| P0-1 WAL 只读故障 | 初始化无条件请求 WAL 属实。本机 Python 3.13.13 / SQLite 3.51.2，修改前 88 项测试全部通过；没有复现 A 的 SQLite 3.53.1 环境故障，不能宣称所有平台必现或零业务缺陷。 | 增加只在事务开始前触发的受控 DELETE 降级，以及显式存储配置；故障注入测试，不伪称 Windows 故障已现场复现。 |
| P1-1 bench 异常隐藏/失败状态写入再次报错 | `work_once` 对非业务异常仅转成 `ANALYSIS_FAILED`，缺原始堆栈；失败状态 UPDATE 没有二次保护，worker 可被存储异常终止。 | 保留原错误码与异常日志；写失败时保留内存终态并重试持久化，不重跑模型；worker 遇 SQLite 故障重试，重启仍由已有 recover 标记中断任务失败。 |
| P1-2 重复整仓快照 | 本轮原 HEAD 251 个受控文件（250 加整改方案），其中快照 122 个、4,693,351 字节。四个前端主文件逐字节相同；确有重复后端。 | 删除重复实现，保留用户指定名称下的 README 交付入口；唯一代码源为根 `apps/web/` 与 `services/`。完整快照在 Git 历史 `0e35865`/`923a8d0` 可恢复，并有仓库外本地 ZIP 备份。 |
| P2-1 米白背景 | 用户此前已明确提供白色到 `#FFEFBA` 渐变并要求更换背景；无需再次猜测。 | 完全保留前端文字、样式与交互；本轮不擅改硬件环灯/Figma。 |
| P2-2 候选过期/演示节奏 | 脚本遵守服务器 120 秒 TTL 属实；数分钟后打开会过期是预期行为，不是需放宽规则的 bug。 | 演示脚本增加生成后 60 秒内确认、重新 seed/重新启动 HTTPS 网关的操作说明，不增 `--ttl`。 |

## 没有照搬的部分

- 不使用 `Store._journal_fallback` 这类影响所有数据库的类级布尔开关；按规范化数据库路径共享本进程连接锁和降级状态，不同数据库独立。
- 不在降级验证成功前宣称「已修复」。仅对 WAL、只读错误、事务开始失败进行尝试；切换被其他进程占用或实际权限不允许时保留原异常与原因。
- 初始化 PRAGMA 也纳入故障注入覆盖，不能断言它在一切环境中绝不会失败。
- 不捕获异常后重放整个业务事务，避免重复发命令。已进入事务主体的错误回滚后原样抛出；回滚本身的异常另记日志，不盖掉原异常。
- 仅将带 SQLite BUSY/LOCKED/READONLY 错误码的请求故障返回 retryable 503；缺表、坏 SQL 等不冒充可重试 `STORE_BUSY`。
- 「robot.calls 为 1，因此幂等不依赖事务」不成立：当前决定路径在写事务中校验已有结果、创建命令并存结果。并发测试能证明这条 mock 路径不重复派发，不能证明真实设备网络副作用 exactly-once。真实投递仍需 outbox/设备幂等和团队联调。
- 不依据未在当前可见历史找到的 `4cba335` 作恢复承诺；使用实际存在的历史提交。

## 验证范围

修改前：Python 全量 88 项通过。本轮新增存储/台架恢复回归测试，覆盖 WAL BEGIN/初始化故障、降级验证失败、不同数据库隔离、并发确认仅一次、事务主体不重放、回滚错误保留原因、API 故障分类、bench 终态写入恢复、worker 存储故障存活。

修改后：Python 全量 **102 项通过**（原 88 + 新增 14），前端 Node **32 项通过**。git diff --check 通过，四个前端主文件与原工作台 HTML/JS 对 HEAD 的差异为空。前端四个主文件及原工作台 HTML/JS 不在本轮修改范围。候选 120 秒、身份/版本/上下文保护和 HTTPS 网关隔离不改变。

## 不可由本轮代码测试代替的验收

仍需实际手机信任证书、浏览器权限/PWA/弱网与 4G、真实音频发布、模型描述、真实机器人回执及安全播报、会议结束链路的成员协同验证。当前 LAN HTTPS 不等于长期公网部署。本轮不能宣称 D 或整个项目的实机验收已经全部完成。
