eleanor-wsyy/EffMeet2/docs/product/D端界面说明_v1.md

# D 端界面说明 v1 · 移动优先 PWA + 可选安卓壳

> 给 D（明天 10.06 接管 `apps/web`）的产品方向说明。A 定调，10-05。
> 一句话：**主线是移动优先的 PWA 网页；安卓壳只是条件触发的展示件，永远不进主演示链路。**

---

## 1. 决策与纪律

| 形态 | 定位 | 触发条件 |
|---|---|---|
| **移动优先 PWA**（主线） | 远程成员的唯一入口：入会、看原图、确认候选、观点地图 | 无——这就是原计划 |
| 安卓 WebView 壳 APK（可选） | 评委问"有没有 APP"时的展示件 | **10-07 中午前 Web 全流程跑通才允许开工**；只做三个画面（入会、确认卡、观点地图）；崩了不影响演示 |
| 原生/Flutter 重写、iOS、小程序 | 不做 | — |

纪律三条：

1. PWA 必须可"添加到主屏"（manifest + 图标 + 全屏 standalone）——演示录像里从主屏点开全屏应用，与真 APP 视觉无差别，这就是路线 B"仅需平板或手机"的证据。
2. 麦克风权限被拒时必须**可见提示并给重试引导**，不静默降级（这条本来就在 D 的验收里，移动端浏览器尤其重要）。
3. APK 若做，单独目录 `apps/android-shell/`，不污染 `apps/web`；任何人不许为壳改 Web 代码。

## 2. 三个核心画面（线框稿 v2，Figma 可编辑）

线框以 **SVG 交付，直接进 Figma**：`assets/wireframes/屏1_会中-远程成员_v2.svg`、`屏2_会后-观点地图_v2.svg`。

**导入方法**：Figma 画布上直接把 SVG 文件拖入（或 File → Place image，Ctrl/Cmd+Shift+K）。图层结构（frame/文本/图形）完整保留，全部可继续编辑。注意：原稿字体是 Sarasa Gothic SC，团队字体库没有的话导入后全选文字统一换成你们的设计字体即可。

D 照信息架构实现，视觉风格自定但遵守三条：状态色只用红（录音中）/绿（已回应）/黄（待核对/可能未回应）；确认卡是**浮层**；字号手机端正文 ≥14px。

1. **会中页**：现场原图 + AI 描述（可点核对原图）、我的观点列表（带状态标）、候选确认浮层卡（标题/原话/「请机器人提醒」「不必提醒」/倒计时）、录音中红点常亮
2. **观点地图页**：统计条 + 观点卡（提出人、状态、回应摘要、查看原话）+ 导出
3. **入会页**（PWA 首页）：输入会议链接/粘贴邀请 → 填名字 → 麦克风授权引导 → 进入会中页

## 3. 可参考的现成 APP（照着看，别照抄）

| 参考对象 | 看什么 | 用在哪 |
|---|---|---|
| **Loona（KEYi）配套 App** | 桌面机器人产品的设备绑定、配网、设备状态页的气质——"宠物"感如何通过界面传递 | 设备绑定流程、状态页氛围 |
| **米家** | 扫码绑定设备 → 配网 → 归入账号的 onboarding 流水线，中文用户零学习成本 | 路线 B 叙事的"账号绑定机器人"流程参考 |
| **腾讯会议移动端** | 成员列表、发言状态、举手的表达密度；**同时当反参考**——我们不做完整会议平台，别学它的重 | 会中页的信息密度边界 |
| **企业微信审批卡 / iOS 通知操作** | "一条通知 + 两个动作按钮"的确认交互，按钮主次（主实底/次描边） | 候选确认浮层卡 |
| **flomo** | 卡片流的呼吸感：每条内容一张卡、标签小而清晰、时间戳弱化 | 观点地图的卡片列表气质 |
| **X (Twitter) PWA / Starbucks PWA** | "Web 即 APP"的标杆：主屏图标、离线壳、全屏体验 | PWA 工程参照 |

看的方式：每个装一遍/翻一遍对应页面截图，提炼**布局和交互**，配色字体不搬。

## 4. 移动端特有注意点

- 竖屏优先，不做横屏适配；iOS Safari 与安卓 Chrome 各过一遍麦克风授权流程（两者权限文案和时机不同）
- 页面要在 4G 弱网下可用：原图单独加载占位、事件列表先文字后图
- 任何按钮热区 ≥44px；确认卡两按钮必须拇指可达（下半屏）

## 5. 验收（10-07 晚冻结前）

- [ ] 手机浏览器打开链接 → 授权麦克风 → 入会 → 看到原图与描述
- [ ] 候选弹出 → 点「请机器人提醒」→ 看到状态流转（等待→播报中→已完成）
- [ ] 会后观点地图：三态标签正确、每项可点回原话
- [ ] 主屏添加 PWA，从图标启动全屏运行
- [ ] 刷新/断线重连不重复弹候选（契约已保证，界面验证）
