eleanor-wsyy/EffMeet2/hardware/robot-design/archive/layout-candidates-20261011/README.md

# 归档 · 布局候选（2026-10-11）

> **历史文件，不是当前依据。** 当前方案见 [`../../round-yaw-v2/`](../../round-yaw-v2/README.md) 与 [`../../round-yaw-v2/MODELING_BRIEF.md`](../../round-yaw-v2/MODELING_BRIEF.md)。
> 采购以 [`../../round-yaw-v2/BOM.md`](../../round-yaw-v2/BOM.md) §12 为准。**不得据此采购或建模。**

## 结论

**已定案：布局 A（板在底座，麦克风固定不随头转）**，主板走方案 W（微雪 `ESP32-S3-CAM-OV3660`）。

## 本目录内容

| 文件 | 性质 |
|---|---|
| `layout-A-base-board.md` | 布局 A 候选提案全文（采购包 + 建模包 + 验收 + 工期）。**其有效内容已并入 BOM §12 与 `round-yaw-v2/MODELING_BRIEF.md`**，本文件仅留档 |
| `layout-B-head-board.md` | 布局 B 候选提案全文（整板进头部、麦克风随头转）。**已否决，永不采用** |
| `DECISION-RATIONALE.md` | 当时的二选一说明与决策判据（原文留档，其"未决策"表述已被上文结论取代） |

## 布局 B 被否决的理由（备查）

1. **麦克风随头转**——拾音特性随头角变化，ASR 准确率变成头部朝向的函数；而机器人转头的时刻恰是最需要稳定拾音的时刻。
2. 推翻既有产品规则（`BOM.md` C06）：「麦克风不随头转，不能宣称通过转头实现指向性拾音」。
3. 头部加重，SG90 带载吃紧，宠物形态的灵动性下降。
4. 代价性质不对等：A 的代价是工程努力（两条排线 + 过轴寿命验证），B 的代价是产品功能缺陷（拾音不稳，修不了）。

## 保留价值

- `layout-B` 的采购删减清单（E04/E05/E13 可删）**不适用于布局 A**，仅作历史参考。
- 若未来改用无刷机构或板载麦克风方案重新评审，可从本目录取材；**但在本轮不得复活。**
