eleanor-wsyy/EffMeet2/hardware/robot-design/archive/procurement/README.md

# 原始采购依据（历史）

- [2026-10-05通用清单](2026-10-05-hardware-purchase-list.md)：从原docs/handoff目录迁移，原文保留。
- [2026-10-09分享清单](2026-10-09-original-shared-list.md)：用户提供的《EffMeet2-硬件采购清单-分享版.md》原文副本；源文件未改动。链接均是搜索入口。

当前采购使用[圆润转头版BOM](../../round-yaw-v2/BOM.md)，不按旧资料直接下单。
