eleanor-wsyy/EffMeet2/hardware/robot-design/archive/procurement/2026-10-09-original-shared-list.md

# 在议 硬件采购清单（分享版）

更新日期：2026-10-09

用途：完成机器人拾音、播放、摄像头抓拍、Wi-Fi 通信及 AEC 实机验证。当前先采购开发板与配套器件，之后确定机构和外壳。

**链接说明：以下均为淘宝搜索入口，不是已核验的具体商品页，也不保证搜索结果中的商品兼容。购买前向商家确认板卡版本、接口、供电和套装内容。**

| 物品 | 数量 | 淘宝链接 | 购买注意 |
|---|---:|---|---|
| ESP32-S3 音频开发板 | 1 | [淘宝搜索](https://s.taobao.com/search?q=ESP32-S3-Korvo-2) | 先核对版本、套装内容和电路资料 |
| 麦克风／麦阵列 | 按需 1 套 | [淘宝搜索](https://s.taobao.com/search?q=ESP32%20Korvo%20%E9%BA%A6%E5%85%8B%E9%A3%8E%E9%98%B5%E5%88%97) | 板载已有则不重复购买；匹配音频采集接口 |
| 扬声器 | 1 | [淘宝搜索](https://s.taobao.com/search?q=ESP32%20%E5%BC%80%E5%8F%91%E6%9D%BF%20%E6%89%AC%E5%A3%B0%E5%99%A8) | 阻抗、功率与插头按板载功放要求选 |
| 功放模块 | 按需 1 | [淘宝搜索](https://s.taobao.com/search?q=I2S%20%E5%8A%9F%E6%94%BE%E6%A8%A1%E5%9D%97) | 板载已有则不用买；匹配音频接口 |
| USB 数据线 | 1–2 | [淘宝搜索](https://s.taobao.com/search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) | 确认板卡接口，并支持数据传输 |
| USB 电源适配器 | 1 | [淘宝搜索](https://s.taobao.com/search?q=5V%20USB%20%E7%94%B5%E6%BA%90%E9%80%82%E9%85%8D%E5%99%A8%203A) | 电压及电流按板卡和整机负载确定 |
| 充电宝 | 可选 1 | [淘宝搜索](https://s.taobao.com/search?q=%E5%85%85%E7%94%B5%E5%AE%9D%20%E5%B0%8F%E7%94%B5%E6%B5%81%E6%A8%A1%E5%BC%8F) | 可替代适配器；检查低负载自动关断 |
| 摄像头模块 | 1 | [淘宝搜索](https://s.taobao.com/search?q=ESP32-S3%20OV2640%20%E6%91%84%E5%83%8F%E5%A4%B4) | 核对主板接口、引脚及驱动 |
| 摄像头排线 | 按需 1 | [淘宝搜索](https://s.taobao.com/search?q=%E6%91%84%E5%83%8F%E5%A4%B4%20FPC%20%E6%8E%92%E7%BA%BF) | 针数、间距和同向／反向须匹配 |
| 杜邦线 | 1 套 | [淘宝搜索](https://s.taobao.com/search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) | 用于临时接线 |
| 接插件、排针 | 1 套 | [淘宝搜索](https://s.taobao.com/search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) | 间距按板卡确认 |
| 螺丝、铜柱 | 1 套 | [淘宝搜索](https://s.taobao.com/search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) | 按安装孔径选尺寸 |
| 单轴舵机 | 1 | [淘宝搜索](https://s.taobao.com/search?q=SG90%20%E8%88%B5%E6%9C%BA) | 按头部重量选扭矩；SG90 通常为塑料齿轮 |
| 舵机支架 | 1 | [淘宝搜索](https://s.taobao.com/search?q=SG90%20%E8%88%B5%E6%9C%BA%20%E6%94%AF%E6%9E%B6) | 与实际舵机型号匹配 |
| 静音／停止按键 | 1 | [淘宝搜索](https://s.taobao.com/search?q=%E8%BD%BB%E8%A7%A6%E6%8C%89%E9%94%AE%E6%A8%A1%E5%9D%97) | 核对电平及接线 |
| 状态灯 | 1 套 | [淘宝搜索](https://s.taobao.com/search?q=RGB%20LED%20%E6%A8%A1%E5%9D%97%203.3V) | 按 GPIO 和供电条件选择 |
| 稳压模块 | 按需 | [淘宝搜索](https://s.taobao.com/search?q=5V%20%E5%8D%87%E9%99%8D%E5%8E%8B%20%E7%A8%B3%E5%8E%8B%E6%A8%A1%E5%9D%97) | 输入范围和输出电流匹配电池及负载 |
| 外壳 | 1 | [淘宝搜索](https://s.taobao.com/search?q=3D%E6%89%93%E5%8D%B0%20%E5%A4%96%E5%A3%B3%20%E5%AE%9A%E5%88%B6) | 机构尺寸确定后下单 |

## 采购顺序

1. 音频开发板、配套扬声器、数据线、电源。
2. 确认板卡兼容后，采购摄像头及排线、缺少的麦克风或功放。
3. 音频链路验证后，采购舵机、支架、状态灯和停止按键。
4. 尺寸与布局确定后，定制外壳及固定件。

## 配套与供电

- Korvo-2 搭载双麦克风阵列；购买完整开发板后，先核对是否还需要额外麦克风和功放，避免重复购买。参见 [乐鑫官方说明](https://www.espressif.com/en/dev-board/esp32-s3-korvo-2-cn)。
- 开发阶段优先使用符合板卡要求的 USB 电源或充电宝。干电池可经合适的稳压模块供电，不能只按电池节数判断电压稳定性。
- 扬声器阻抗、功率和接口随板卡确定，不能把任意小音箱视为通用配件。
- AEC 需要匹配的播放参考路径和实际声学测试；仅有麦克风与功放不能保证 AEC 效果。

## 到货验收

烧录与串口日志 → 拾音 → 播放及停止 → Wi-Fi 音频和回执 → AEC 回声参考与双讲 → 摄像头抓拍 → 舵机及整机。
