eleanor-wsyy/EffMeet2/hardware/robot-design/round-yaw-v2/concept/SOURCE.md

# 主视觉来源与使用范围

2026-10-10，按用户指定使用银河智算tt-image-2生成原始概念PNG；prompt.txt保留当次完整提示词。NOMI仅为圆润比例与转向表达参考，不使用其商标或宣称采用相同机构。

生成图不是Blender模型渲染。提示词尺寸为当时方向探索，当前封装尺寸随后调整，以../parameters.json、../BOM.md及实际板卡核验为准。

原始PNG保留；生成平台回执、临时下载地址和付费账户数据不进入团队仓库。
