eleanor-wsyy/EffMeet2/hardware/robot-design/archive/legacy-enclosure/electronics-readme-before-20261010.md

# hardware/electronics — 供电与接线

## BOM（物料清单）

| 部件 | 规格 | 数量 | 备注 |
|---|---|---|---|
| ESP32-S3 开发板 | 待定 | 1 | 主控 |
| 扬声器 | 待定 | 1 | 机内播放 |
| 麦克风 | 板载或外接 | 1 | 拾音 |
| 舵机 | 单轴 | 1 | 转头 |
| 状态灯 | LED | 若干 | 静音/工作状态 |
| 摄像头 | 待定 | 1 | 按需抓拍 |

## 状态

骨架目录，待填充。BOM 和接线图在硬件选型确定后补充。
