eleanor-wsyy/EffMeet2/docs/archive/README.md

# docs/archive：过程文档归档

2026-10-21 整理：对「下一阶段整机装配与参赛」无直接作用、但有史料价值的过程文档集中归档于此。归档文件只代表当日状态，**不作为现行口径引用**；现行入口见根 [README.md](../../README.md) 与 [../handoff/README.md](../handoff/README.md)。

## handoff/（17 个）

- **10-05 台架组**（11 个）：`2026-10-05.md`、`2026-10-05-final-handoff.md`、`2026-10-05-changes.md`、麦克风/图片/qwen 三份测试记录、3 份 log、2 张测试截图——当日台架验收证据链，组内相对链接保持原样。
- **10-06 任务单组**（5 个）：`2026-10-06-A代做记录.md`、`2026-10-06-b-integration-check.md`、`2026-10-06-livekit最小实现任务.md`、`2026-10-06-relay-TTS实现.md`、`给C的移交说明_1005.md`——均已完成或被后续交接取代。
- `2026-10-10-robot-design-and-bom.md`：设计交接跳转 stub，正文在 hardware/robot-design/。

## product/（10 个）

- 整改系列：`EffMeet2_总体整改方案_v1.md`、`EffMeet2_整改核实记录_2026-10-09.md`、`EffMeet2_报告修改指南_v2.md`、`qwen_prompt审核报告_v1.md`——整改与 prompt 修复均已落地。
- 分工/任务书系列：`EffMeet2_分工说明.html`（10-03 排期已过期）、`装配对齐会议程_1005_v1.md`、`D端界面说明_v2.md`、`仓库导览_给D.md`（10-06 时点任务书）。
- `EffMeet2_赛事匹配与参赛建议.docx` + `build_competition_assessment.py`：参赛建议旧版及其生成器；现行版为 `../EffMeet2_competition_assessment_conversational.docx`。
