eleanor-wsyy/EffMeet2/hardware/robot-design/archive/legacy-enclosure/EffMeet2_外壳说明_v2.md

# 在议 外壳说明 v3（A 侧 · 2026-10-06 起，10-09 修订）

> 写入边界：`hardware/enclosure/**`。结构实现（3D 打印 / CNC）由 F 按此意图执行；硬件堆叠与固件配合以 B/C 为准。
> 一句话：**它要坐在桌角像一个安静参会的小东西，不像一个监控设备。**

## 0.1 v3 修订（10-09 · 3D 建模迭代 + 功能位规格化）

本节记录 10-09 的建模过程与结论，**新增 §7 功能位规格表**——它是建模与后续结构实现的共同输入。

### 建模经过（诚实记录）

- **v3-a（失败）**：仅用形态描述建模（"两段式圆润造型 + 黑面板 + 橙眼"），结果**功能全丢**——没有麦克风孔阵、没有扬声器开孔、没有静音键、没有舵机颈、没有 USB-C。**教训：形态描述会压倒功能描述，功能必须逐项显式点名。**
- **v3-b（当前）**：改用**功能驱动** prompt，逐条列出 §5 硬件表的每一个功能位（含数量、位置、可见性要求），功能位全部落地 ✅
  - 产物：`EffMeet2_外壳_v3.glb`（43.9 MB，含 PBR 贴图）、OBJ+MTL+四张 PBR 贴图 zip、官方渲染预览 PNG
  - 建模工具：文生 3D（Normal 类型 + PBR + 30 万面），消耗 40 积分
- **v3-b 的形态偏差（待裁决）**：功能位齐全，但轮廓跑成**球形头 + 独立圆桶底座**（上下两颗球），与 v2 概念图的**蛋形头 + 一体鹅卵石底座 + 矮墩比例**不一致。
  - 原因：功能清单在 prompt 中占比过高，形态权重被挤压。
  - **待宁导裁决**：是接受这个更"机器人感"的球形轮廓，还是回到 v2 蛋形路线重做（重做需在新 prompt 中同时锁定形态比例 + 功能位）。

## 0. v2 修订（10-07 · 参考 EMO / Eilik 打磨）

概念图见 `概念图v2_桌面场景.png`、`概念图v2_三视图.png`。相对 v1 的四处形态调整：

1. **表情屏升级为黑色玻璃大面板**：占正面约 40%，黑玻璃与米白机身形成材质对比（参考 EMO）；眼睛改为**珊瑚橙柔光线条**（与品牌色一致），闭眼态像两弯安静的月牙
2. **摄像头藏进黑面板区**：不再单独开孔——镜头在面板内不可见，物理遮罩拨片仍在（拨下时遮住面板内镜头）
3. **顶部环灯收窄为发丝级细环**：不再是嵌入粗灯带，克制才是高级感
4. **底座改单块鹅卵石形**：去掉 v1 概念图的双瓣式底座，一体圆融；整体比例调矮墩（高约为宽的 1.1 倍），更稳更憨

以下 v1 正文继续有效，与本节冲突处以本节为准。

## 1. 气质基调（和产品语言同源）

产品承诺是"温和干预、未经确认不开口"——外形必须把这句话说出来：

- **抽象形态，不做仿生物**。不画猫狗五官、不做毛绒、不做大眼睛卖萌——那些会把"会议工具"读成"玩具"，评委一眼看穿廉价感。参照 Loona / EMO 的抽象路线：圆润的蛋形小柱，正面一块小表情屏，仅此而已。
- **安静感 > 存在感**。坐姿微微内收（底部略窄于肩部），常态只有一枚低频呼吸的状态光。它 90% 的时间应该让人忘记它在桌上。
- **诚实感**。摄像头、麦克风、状态光的位置全部外露可见，不做隐藏式开孔——隐私不是藏起来，是看得见。

## 2. 表情与状态语言

正面表情屏（小尺寸 OLED/IPS 圆角矩形，约 40×40mm 视区）+ 顶部环形状态灯，二者分工：

| 状态 | 表情屏 | 环灯 | 时机 |
|---|---|---|---|
| idle | 闭眼 / 低频眨眼 | 白·呼吸（4s 周期） | 会外/会后 |
| listening | 睁眼平视 | 橙·常亮微光 | 会议中录音 |
| analyzing | 眼睛向下看 | 蓝·慢闪 | 千问分析中 |
| pending_confirmation | 眼睛看向远程成员方向 + 眉微抬 | 橙·双闪 | 候选等待本人确认 |
| speaking | 嘴部简笔动势 | 橙·流水 | 播报中 |
| error | 眼睛变两条横线 | 红·慢闪 | 断连/降级 |

表情素材属 `assets/face/`（D 的地盘），此处只定义状态-表情的映射关系。规则三条：

1. **播报前必须有 0.8 秒"请示态"过渡**（pending → speaking 不得瞬切）——物理上对应安全停顿复核
2. 表情永不出现在屏幕上卖萌撒娇的动作（捂嘴、委屈、星星眼一律禁止）
3. error 状态表情要"平静地坏掉"，不要警报感——降级是设计能力，不是事故

## 3. 尺寸与桌面占位

- 整机约 **90 × 90 × 110mm**（含底座），小于马克杯占位；桌面参会时不遮挡任何人与白板之间的视线
- 重心压底（电池/配重在下），单轴转头 ±120° 不倾倒；转轴阻尼要让"转头看人"的动作慢下来（0.6–1s 完成一次转向，显得从容，不是警觉）
- 底部：环形硅胶垫，玻璃/木桌均不滑；走线从背后出线（USB-C），桌面看不到线

## 4. 材质与工艺

- 主体：哑光 ABS，**米白**主色（暖白，不是冷白），品牌橙仅用于状态灯与按键点缀
- 表面细砂纹（30–40μm），不反光、不收集指纹；接缝沿背部中线，正面无缝
- 演示样机允许 FDM 3D 打印，但层纹必须打磨+补土+哑光喷漆处理；量产意象按 CNC/注塑写

## 5. 硬件对应（与 B/C 对齐）

| 部件 | 外壳处理 |
|---|---|
| ESP32-S3 主控 | 内仓，背部散热缝 |
| 摄像头 | 正面上部外露，**配物理遮罩拨片**——拨下可见镜头被挡，隐私明示，评委问答时的加分点 |
| 麦克风 | 顶部微孔阵列，远离扬声器轴向 |
| 扬声器 | 正面下部点阵开孔，出音朝向桌面微微上扬（近场清晰、远场不吵） |
| 单轴舵机 | 颈段，转头模块与肩线一体成型，无外露线束 |
| 物理静音键 | 顶部大键，行程长、有明确段落感；按下时**硬件级断开麦克风**且环灯转红——静音是物理承诺，不是软件状态 |
| USB-C 供电 | 背部下沿，带浅凹槽防拽脱 |

## 6. 给演示视频的三个镜头建议

1. 开场：机器人呼吸光中的桌角空镜（安静感）
2. 候选确认时刻：特写表情屏"看向远程成员 + 眉微抬" + 环灯双闪（分寸感的可视化）
3. 隐私问答：手指拨下摄像头遮罩（诚实感）

## 7. 功能位规格表（**建模与结构实现的强制输入**）

> 来源：§5 硬件对应表。此表把每个功能位量化为**位置 / 数量 / 可见性**三项，供 3D 建模 prompt、F 的打印件开孔、以及评委问答时的 BOM 核对共同使用。
> 建模时必须逐条点名——**只写"圆润造型 + 黑面板"会丢掉全部功能位**（见 §0.1 的 v3-a 失败案例）。

| # | 功能位 | 位置 | 数量/规格 | 可见性 |
|---|---|---|---|---|
| 1 | 表情面板 | 头部正面 | 黑玻璃矩形圆角，约占正面 70% 宽 × 42% 高 | 外露，屏内 |
| 2 | 双眼 | 面板内下部 | 左右各一，珊瑚橙弯月形发光 | 屏内显示 |
| 3 | 摄像头 | 黑面板上沿 | 1 颗小型广角镜头 | **镜头外露可见** |
| 4 | 摄像头遮罩拨片 | 镜头旁 | 1 个可上下拨动拨片 | **外露，可拨动** |
| 5 | 物理静音键 | 头顶正中 | 1 个圆形凸起大键，直径约 12mm，有分模线 | 外露凸起 |
| 6 | 环形状态灯 | 头顶外圈 | 1 圈发丝级细环，珊瑚橙 | 外露发光 |
| 7 | 舵机颈段 | 头与底座之间 | 1 段短颈 + 波纹转轴，±120° | 外露无缝 |
| 8 | 麦克风阵列 | 底座上缘一周 | 约 20 个微孔均匀排列 | 微孔可见 |
| 9 | 扬声器开孔 | 底座正面下部 | 约 5×8 圆孔网格 | 孔阵可数 |
| 10 | USB-C 接口 | 底座侧面 | 1 个，带浅凹槽 | 外露 |
| 11 | 散热缝 | 背部中线 | 1 条细长缝 | 外露 |
| 12 | 底部硅胶垫 | 底面 | 1 圈环形 | 底部 |

**建模 prompt 必带句式**：形态比例（90×90×110mm、高≈1.1×宽）+ 上述 12 项逐条描述 + 材质（白色哑光 ABS / 黑亮面玻璃 / 珊瑚橙发光）+ 纯中性背景。
