eleanor-wsyy/EffMeet2/docs/archive/handoff/给C的移交说明_1005.md

# 给 C 的移交说明 · 2026-10-05（A 侧交付 + 今晚执行清单）

> 移交人：A（组长） | 执行人：C（今晚抓总，唯一推送点） | B 明早接手时见 §4
> 原则：本说明是**操作单不是讨论稿**——替换文本照抄落地，有疑义群里问 A，别自由发挥。

---

## 1. 包内容 → 仓库路径（照摆即可）

| 包内文件 | 仓库路径 | 说明 |
|---|---|---|
| `docs/product/EffMeet2_产品说明_v4.md` | 同左 | 产品说明定稿（钩子"在线，不等于在场"） |
| `docs/product/EffMeet2_演示脚本_v1.md` | 同左 | 演示脚本+附录A台词 |
| `docs/product/EffMeet2_判断样例与提示文案_v1.md` | 同左 | 四类样例+全部界面/播报文案 |
| `docs/product/EffMeet2_测试草图_回收箱.png` | 同左 | 演示道具 |
| `docs/product/qwen_prompt审核报告_v1.md` | 同左 | §2 是本次代码修改的依据 |
| `docs/product/装配对齐会议程_1005_v1.md` | 同左 | 其中议题④⑤已转化为你的执行项（见 §3-D/E） |
| `docs/product/D端界面说明_v2.md` | 同左 | D 明天接管用：PWA 主线决策 + 三个画面 + 参考 APP |
| `assets/prompts/qwen_candidate_rules_v1.yaml` | 同左 | 千问 prompt 权威版（版本化管理） |
| `assets/wireframes/屏1_会中-远程成员_v2.svg` | 同左 | 线框 v2（Figma 拖入即可编辑）；v2 改了：加现场转写条、底部改语音发言主按钮 |
| `assets/wireframes/屏2_会后-观点地图_v2.svg` | 同左 | 同上 |
| `figma-wireframe-plugin/`（目录，3 文件） | `tools/figma-wireframe-plugin/` | **首选**：Figma 插件，一键生成原生可编辑原型（比 SVG 导入层级更干净）。使用见目录内 README |
| `fixtures/demo/closed_loop.json` | 同左（**覆盖**） | 回收箱场景台词，替换旧语料 |

## 2. 代码修改（三处文件，按行操作）

### 2a. `services/controller/qwen_client.py`（4 处）

| 位置 | 操作 |
|---|---|
| 第 125 行 system content | 替换为审核报告 §2 的 **system prompt 新版**（逐字） |
| 第 178–183 行 `_build_analysis_prompt` 输出指令段 | 替换为审核报告 §2 的**输出指令新版**（逐字） |
| 第 230 行 `proposed_text` 截断 | `[:120]` → `[:60]` |
| 第 232 行 `prompt_version` | `"qwen-v1"` → `"qwen-v2"` |

### 2b. `services/controller/store.py`（1 处，红线落点）

第 255–256 行，speak 命令的 args：

```python
# 现状（模型原话直接进命令）：
"args": {"text": candidate["proposed_text"], "voice_profile": "mock_voice"}

# 改为（服务端模板拼接，模型只供转述）：
"args": {"text": f"打扰一下——刚才线上成员提到{candidate['proposed_text']}，现场可以回应一下吗？", "voice_profile": "mock_voice"}
```

### 2c. `services/controller/demo.html`（1 处文案）

空态提示里残留的旧描述句"……是否请机器人向现场提示" → "……是否**请机器人提醒**"。按钮文案已是新版，只统一这处。

## 3. 你自己的边界内事项（议程议题④⑤已转化）

- **④ TTS 语气规格**：语速中等偏慢（约 0.9×）；音高自然不刻意上扬；句尾不上挑；不播音腔不卖萌。P0 系统 TTS 只需能导出音频文件，音色终选后置。
- **⑤ 播报期间行为（A 已拍板）**：照常进判断、不设静默窗；仅 `robot_audio` 标记的自声被抑制不产生候选。加一条测试："播报期间现场说话 → 产生正常 utterance，不产生以机器人声音为证据的候选"。

## 4. 推送（两个 commit）与明早 B 的交接

```bash
git add docs/product assets/prompts fixtures/demo/closed_loop.json
git commit -m "docs(A): 产品说明v4、演示脚本、判断样例与文案、qwen审核报告、对齐议程、prompt YAML、回收箱fixture"
git add services/controller
git commit -m "feat: qwen prompt语义对齐v2——proposed_text仅作转述，播报句服务端模板拼接（红线：模型原话不上设备）"
```

推完后跑 `python -m unittest discover -s tests -v` 全绿 + `scripts/smoke_demo.py` 通过，才算今晚收工。

**明早 B 接手看三样**：① `qwen-v2` 的 prompt 与 YAML 权威版；② 审核报告 §3 两条遗留（response_utterance_ids 粗放、冷却去重）排进他的迭代；③ 新 fixture 已生效，他的回归直接可用。

## 5. C 的自检 checklist（推完打勾）

- [ ] 8 个文件全部就位，路径与 §1 一致
- [ ] `_parse_analysis` 输出抽查：喂"破碎混说"文本 → `uncertain`
- [ ] 生成候选后，speak 命令 `args.text` 以"打扰一下——"开头、≤55 字
- [ ] unittest 全绿 + smoke 通过
- [ ] 两个 commit 信息按 §4 格式
