eleanor-wsyy/EffMeet2/docs/archive/handoff/2026-10-05.md

# 2026-10-05 技术交接记录

后续实测补充：已完成[电脑麦克风真人录音转写](2026-10-05-microphone-test.md)及[原始转写与真实 Qwen 三场景联合测试](2026-10-05-qwen-microphone-test.md)。下文早期“没有 Key / 真人录音未验”的描述为当时状态，以这两份实测记录为准；连续实时录音与机器人播放闭环仍未完成。

## 1. 接手结论与当前进度

今日任务为接手技术阻塞，优先音频，其次模型判断与异步通信，并交付可复现说明。已完成本机软件台架实现及合成服务闭环验证；真人语音、云模型和机内播放的最终验收尚未完成。

用户确认当前没有 ESP32 音频板、麦克风、扬声器和千问 API Key，也没有独立的“4 日晚失败记录”。下列历史问题为本次从代码和运行中发现，不冒充前一天的记录。

| 日程项 | 当前结果 | 验收边界 |
|---|---|---|
| 环境、原有基线、阻塞复现 | 完成 | Windows / Python 3.12.14；原有 42 项测试通过 |
| 音频协议、鉴权、网络收发 | 台架完成 | 真实 HTTP/WebSocket + 合成音频验证 |
| FunASR | 本地真实模型上行已通 | SenseVoiceSmall CPU + 合成中文语音 → EFMA/WS → 真实转写入账；真人和噪声效果未验 |
| TTS 与播放 | 合成及协议完成 | Windows 中文 TTS 实际生成 PCM；接收播放使用模拟汇，未验证扬声器 |
| 千问判断 | 异步调用路径与校验完成 | 合成模型通过；没有 Key，真实 API 未验收 |
| 异步通信 | 台架完成 | SQLite 任务、上下文复核、幂等、停止、重启取消、事件恢复 |
| 本人回应核对 | 已实现并验证 | 选择现场证据、本人核对、取消相关提醒、更新原文记录；暂不支持撤回 |
| 台架网页 | 浏览器验收通过 | 修复候选列表字段错误；验证建会、本人决定、取消和回应核对 |
| LiveKit / ESP32 / AEC | 未实现或未验收 | 不是只填几个配置即可完成，需要后续开发联调 |
| 交接材料 | 已更新 | 本文 + [文件修改清单](2026-10-05-changes.md) |

## 2. 最快复现路径：无需账号、模型或硬件

所有命令在项目根目录 PowerShell 执行，路径使用单个反斜杠。本机已有 `.venv`；换电脑需自行安装 Python 3.11+ 并重建环境，不能直接复制虚拟环境。

```powershell
# 新电脑首次安装，已有 .venv 时跳过第一行
python -m venv .venv
.\.venv\Scripts\python.exe -m pip install -r requirements.txt
.\.venv\Scripts\python.exe -m unittest discover -s tests -v
.\.venv\Scripts\python.exe scripts/smoke_bench.py
```

预期：59 项测试通过，冒烟输出 `status: PASS`。冒烟会自行启动临时本机服务、建立临时数据库、测试后关闭服务；不要求先运行 Demo，不调用真实千问，不发声。

冒烟闭环：合成 WAV → EFMA 帧 → 实际 WebSocket → 合成 FunASR 服务 → 最终发言入账 → 合成模型任务 → 本人确认 → 合成 PCM 下行 → 模拟排空回执 → 重试去重 → 事件断点恢复。网络传输是真的，ASR/模型/TTS/音频汇为测试替身。

## 3. 打开可操作的台架页面

```powershell
$env:PYTHONIOENCODING = 'utf-8'
$env:EFFMEET_DB_PATH = (Join-Path (Get-Location) 'data/bench.sqlite3')
# 本机 Windows 有语音包时，可启用离线 TTS
$env:EFFMEET_TTS = 'windows'
.\.venv\Scripts\python.exe scripts/run_bench.py
```

打开 [本机台架](http://127.0.0.1:8768)，健康检查为 `/healthz`。用 Ctrl+C 停止；被占用时用 `--port 8769`，音频客户端同步更改 `--url`。服务是否仍运行以健康检查为准。

页面可新建会议、手工添加发言、提交模型任务、由本人确认/拒绝、查看命令回执、停止命令、查看原文记录。没有 Key 时分析会失败，完整无账号演示请用上面的 `smoke_bench.py`。不要把模型未配置当作程序已经产生候选。

控制器与媒体目前在同一进程。一个台架数据库只能运行一个进程、一个 worker；重启时会取消未完成任务，不能让第二个服务对同一数据库执行恢复。旧 mock Demo 可单独使用 `scripts/run_demo.py`（默认 8765），但必须用不同数据库，并确保 `EFFMEET_BENCH` 未设置为 `1`。

## 4. 配置项

`.env.example` 只是示例，程序不自动加载 `.env`。环境变量需在启动服务的同一个终端设置，更改后重启服务。

| 配置 | 默认 / 作用 |
|---|---|
| `EFFMEET_DB_PATH` | `run_bench.py` 默认项目下 `data/bench.sqlite3`；相对值按工作目录解释 |
| `EFFMEET_BENCH` | `1` 使通用 `create_app()` 使用台架；推荐直接运行 `run_bench.py`，不必设置 |
| `FUNASR_WS_URL` | 无默认地址；例如已启动的 `ws://127.0.0.1:10096`，非回环地址要求 `wss` |
| `QWEN_API_KEY` | 千问服务端密钥；不要发到聊天、前端或提交到仓库 |
| `QWEN_MODEL` | 默认 `qwen-plus`，真实接口兼容性仍需联调 |
| `EFFMEET_TTS` | `windows` 启用 Windows 离线语音；否则未配置 |
| `PYTHONIOENCODING` | 推荐 `utf-8`，便于中文日志显示 |
| `EFFMEET_CONTROLLER_URL` | 旧中继的预留变量，当前统一台架不读取它 |

`/healthz` 的 `asr_configured` / `tts_configured` 表示适配器已配置，不代表外部服务健康、模型权重已加载或扬声器已接通。当前 `hardware_connected=false`。

## 5. 音频输入与播放操作

先在网页创建会议，复制 `meeting_id`。以下尖括号内容均需替换。

```powershell
# 需要真实 FunASR 服务；文件必须为 16kHz、单声道、16-bit PCM WAV，最长 30 秒
.\.venv\Scripts\python.exe scripts/bench_audio.py --url http://127.0.0.1:8768 --meeting '<meeting_id>' upload 'F:\音频\sample.wav' --channel remote --speaker remote_1 --start-ms 0
```

客户端自动取得本机调试身份、配对、绑定来源、发送 EFMA 帧；服务在收到 `audio.end` 后调用 FunASR，完成结果写入账本。`start_ms` 是显式提供的会议时间偏移，不是自动同步的跨设备时钟。不能据此宣称已实现流式 VAD 或多人分离。

只有模型形成候选并由本人确认，才会产生 `command_id`。复制命令 ID，再运行：

```powershell
# 无扬声器：模拟下行消耗与回执，不发声；仍需要服务端 TTS 已配置
.\.venv\Scripts\python.exe scripts/bench_audio.py --url http://127.0.0.1:8768 --meeting '<meeting_id>' play '<command_id>' --safe-pause --simulate
```

`--safe-pause` 表示操作者确认当前可播报；服务还检查近期上行振幅活动与上下文。这个简单门槛未作声学标定，不能代替生产用 VAD/AEC。播报期间上行被阻止以避免自触发，不支持双讲。

去掉 `--simulate` 会调用 `sounddevice` 实际输出音频。该可选库未列入基础依赖，当前分支没有完成真实播放器依赖冻结及扬声器验收；接手人需先准备音频设备、安装并验证依赖，再测排空和停止。

## 6. 接口变更（供 B / D 接入）

| 接口 | 当前行为 |
|---|---|
| `POST /api/v1/meetings/{mid}/analysis` | mock 模式直接返回模拟结果；bench 模式返回 `job_id/status/replayed`，不再立即包含 `analysis` |
| `GET /api/bench/meetings/{mid}/jobs/{job_id}` | 查询 queued/running/completed/failed；完成后从 `result` 读取候选，失败看 `error_code` |
| `POST /api/bench/meetings/{mid}/media-bindings` | 主持人提交 config、speaker_id、channel、start_ms；先配对设备，再绑定会话 |
| `WS /device/v1/audio` | `Authorization: Bearer ...`，仅回环本机客户端；start → ready → EFMA/ACK → end → utterance.final/audio.closed |
| `WS /device/v1/playback` | 带配对凭据，先发 command_id/device_id/boot_id/safe_pause/sink_mode，再按握手收帧、ACK、回执 |
| `POST /api/bench/commands/{command_id}/stop` | 主持人或观点本人可取消；失败回执标记 `CANCELLED` |
| `GET /api/bench/meetings/{mid}/response-tracking` | 原观点、模型判断、可核对现场证据、本人核对结果 |
| `POST /api/bench/meetings/{mid}/claims/{claim_id}/response-verification` | 本人提交 `{"response_utterance_ids":["现场发言UUID"]}`；记录 manual / response.verified；取消相关未完成提醒 |
| `WS /api/v1/meetings/{mid}/events` | 首条 JSON 为 `{ "token": "本机会话凭据", "after_seq": 0 }`；收到有序事件，重连从最后 seq 继续 |

媒体连接不接受 URL 查询凭据或浏览器 Origin，网页不能直接用原生 WebSocket 调用这些设备接口。网页事件 WS 与设备音频 WS 的鉴权机制不同。旧 `/ws/audio/{session_id}` 和任意 `/api/tts/{session_id}` 上传入口已移除。

媒体绑定有效期 10 分钟、配对凭据检查有效期 1 小时；重新配对同一 device_id 会替换旧 token。`remote_1/remote_2` 是台架身份，不能当作正式远程成员权限系统。

命令确认后只是排队。当前目标固定为 `host_speaker_test`；校验目标 ID 不等于完整设备能力协商。TTL 检查针对领取后的开始播放阶段，未等同于设备端完整单调时钟执行策略。发送音频结束不等于播放完成，必须等匹配设备的 completed 回执；模拟汇的回执为 mock。

## 7. 验证证据与历史问题

| 验证 | 已观察结果 |
|---|---|
| 原有 unittest | 42/42；历史日志 [2026-10-05-tests.log](2026-10-05-tests.log) |
| 原有 HTTP 冒烟 | 12 项通过；历史日志 [2026-10-05-smoke.log](2026-10-05-smoke.log) |
| 新增 unittest | 台架 11 + 回应核对 3 + 本地 ASR 协议 3；与原测试一起共 59/59 |
| 真实本地 ASR 上行 | 132640 字节 PCM / 4.145 秒合成语音；识别“先验证线上成员能否看清草图。”；事件 mode=real / source=funasr_offline |
| 浏览器交互 | 候选显示、本人确认、越权拒绝、取消与本人回应核对；[核对截图](2026-10-05-response-review.png) |
| 网络台架冒烟 | `scripts/smoke_bench.py` 实际 TCP/HTTP/WS 验证通过，自动清理测试服务 |
| 离线中文 TTS | 实测 180800 字节 PCM、16kHz mono s16le、5.65 秒；未实际播放 |
| 依赖 | 基础 `.venv` 的 `pip check` 通过 |

原基线日志只对应当时的 42 项测试，不将它改名冒充 53 项报告。后续可使用第 2 节命令重现当前验证。

早期发现的 664 字节帧被按 640 字节拒绝、任意 token 被接受、WebSocket 库未安装三个问题，已由新协议、绑定鉴权与直接依赖修复；历史取证见 [2026-10-05-audio-repro.log](2026-10-05-audio-repro.log)。`scripts/repro_audio_baseline.py` 引用已移除的旧路由，仅作历史脚本，不能再作为当前验收命令。

## 8. 当前已知问题与复现办法

| 问题 / 限制 | 复现及预期 | 处理 |
|---|---|---|
| 千问未配置 | 不设 Key 启动台架，新建会议、添加 remote_1 发言、点击分析；任务 failed / `QWEN_NOT_CONFIGURED` | 在本机配置 Key 后重启；再验真实 API |
| ASR 未配置 | 不设地址，上传合规非空 WAV；结束时 `ASR_NOT_CONFIGURED` | 启动真实 FunASR 服务，配置地址后重启 |
| ASR 地址不可达 | 指向没有服务的本机端口，再上传 WAV | 返回 ASR 错误；configured=true 不等于可达 |
| TTS 未配置或不可用 | 不设 TTS 时领取已确认命令，得到 `TTS_NOT_CONFIGURED`；系统无语音/访问失败时可能为 `PLAYBACK_FAILED` | 检查 Windows 语音包、运行权限及启动配置 |
| 音频会话不可复用 | 复用已消费的 session_id，得到 `INVALID_SESSION` | 断连后生成新 ID，重新绑定 |
| 分析期间来了新发言 | 用 `test_job_idempotency_and_readable_while_model_running` 复现；新发言可写入，旧结果 `CONTEXT_CHANGED` | 新上下文重新分析、本人再次核对 |
| 停止与重启 | `test_stop_cancels_outstanding_frame` / `test_restart_never_replays_queued_command` | CANCELLED / PROCESS_RESTARTED；不自动重播 |
| 沙箱曾出现 SQLite 只读 | 基线 8765 配对阶段返回 500；日志为 attempt to write a readonly database | 经批准在沙箱外、新数据库的 8767 服务冒烟通过；底层权限根因未完全隔离，勿删除旧库规避 |
| 历史说明过期 | 老的 relay README、启动提示和交接文件曾描述旧路由 | 本次已同步文档和提示，以当前台架说明为准 |

其他未完成项：LiveKit 网关与远程浏览器音轨、机内固件、AEC/双讲、正式成员认证、模型效果评测、跨观点冷却策略、真实摄像头采集与联调。会后记录保留原文，仅明确核对的回应证据标 human_verified；部分旧的 meeting/summary 等事件仍标 mock，应按具体事件来源判断，不能把台架整场标为 real。页面刷新暂不恢复当前会议选择，账本仍在数据库中。

## 9. 环境与文件交付

- 已有 `.venv` 使用本机 Codex 附带 Python 3.12.14 创建；原系统 `python` 命令不可用，`py` 未发现已安装解释器。
- `.venv-asr` 已完成真实运行：funasr 1.4.16、torch 2.5.1、torchaudio 2.5.1；模型缓存约 936 MB 权重，位于 `data/models`。基础台架不依赖这个环境。
- 没有改动三份契约快照；新增 `/api/bench/*` 与 ACK、播放器首帧等属于台架扩展，不宣称已经纳入正式 v1 契约。
- 当前文件夹没有 `.git`，本次没有提交、推送或 PR。改动清单根据本次编辑记录及现有文件核对，不是 Git diff。
- 移交源码、文档和测试时排除 `.venv`、`.venv-asr`、`data`、`__pycache__` 和本地凭据；运行数据和环境留在本机，不需要为交接删除。

## 10. 下一位接手人的建议顺序

1. 在干净基础环境执行 59 项回归与台架冒烟，先确认可重复的软件基线。
2. 使用下方已验证的本地 FunASR 服务，上传经授权的真人短 WAV；记录噪声、识别文字、耗时与错误，不把单条合成语音通过当作真实会议效果。
3. 配置真实千问，验证已回应/可能未回应/不确定及错误 JSON、超时、证据不符场景。
4. 准备音频输出依赖与设备，验证实际播放、排空、停止；随后由硬件负责人对接 ESP32。当前回环限制需配套网关、配对和网络保护设计后再扩展。
5. 开发 LiveKit 网关及浏览器音轨，完成身份绑定、回流抑制和双讲方案；这部分尚无可运行实现。
6. 才能进行最终联合验收：真人发言 → 真转写 → 真判断 → 本人确认 → 安全停顿 → 实播 → 回应跟踪 → 可核对记录。

## 11. 本次补完：本地 ASR 与回应核对

终端 A 启动真实本地识别服务；首次下载官方公开模型需要网络，不需要账号。代码只使用安装包中的实现，`trust_remote_code=False`。SDK 首次还会建立用户目录 `.modelscope` 配置，需正常写入权限。

```powershell
# 新电脑首次准备；本机已有 .venv-asr 时跳过安装
python -m venv .venv-asr
.\.venv-asr\Scripts\python.exe -m pip install -r requirements-asr.txt
$env:PYTHONIOENCODING = 'utf-8'
.\.venv-asr\Scripts\python.exe scripts/run_local_asr.py
# 本机已下载，离线启动可明确使用缓存路径：
# .\.venv-asr\Scripts\python.exe scripts/run_local_asr.py --model data/models/models/iic--SenseVoiceSmall/snapshots/master
```

看到 `LOCAL_ASR_READY` 后，在终端 B 设置 `$env:FUNASR_WS_URL='ws://127.0.0.1:10096'`，再按第 3 节启动控制器。页面建会后按第 5 节上传 WAV。本机测试文件为 `data/asr-synthetic-input.wav`（合成语音，未纳入交接源码），可复用测试或换成经授权的 16k mono PCM WAV。

真实上行验收记录：会议 `5b9441b4-df54-472c-ba26-363421b4a0ab`，事件 `e5c3083b-f34c-4ea4-95a3-d13dcea324e1`，本机数据 `data/real-asr-check.sqlite3`。本条仅证明真实模型识别及入库，不含千问、真人录音或扬声器。官方模型用法参考 [SenseVoice](https://github.com/QwenAudio/SenseVoice)。

服务仅监听 127.0.0.1，拒绝浏览器 Origin；最大 30 秒、仅整段 offline、CPU 串行识别，繁忙时拒绝请求，不做说话人分离。Windows 中文路径下原 SentencePiece 原生文件接口失败，启动脚本通过 Python 读取模型字节再加载，未移动模型或修改安装包。`ffmpeg` 缺失警告不影响本台架直接传 PCM 数组。

回应核对复现（无 Key 可用 tests.network_fixture 合成模型，不能冒充真实千问）：

1. 新建会议，加入 remote_1 观点并分析，出现待本人确认候选。
2. 加入一条 onsite 现场回应；第 4 区显示“待核对”，不会自动变成已回应。
3. 勾选该现场发言，以 remote_2 提交，预期 `NOT_OWNER`；切回 remote_1 后提交成功。
4. 页面显示“已确认回应”；待确认候选变为 responded，排队命令产生 `RESPONSE_VERIFIED` 失败回执。正在播放的命令会被请求停止，无法撤销已发出的声音。
5. 再生成原文记录，所选现场证据标记 human_verified。同样提交幂等；更改已保存证据返回 `VERIFICATION_CONFLICT`，当前不提供撤回。

模型任务轮询已改成独立短轮询，等待期间可以继续输入或核对；若输入改变分析上下文，任务返回 CONTEXT_CHANGED，需重新分析。
