eleanor-wsyy/EffMeet2/docs/archive/product/EffMeet2_赛事匹配与参赛建议.docx

# EffMeet 2 赛事匹配与参赛建议

天猫 AI 黑客松高校挑战赛项目评估

评估日期 2026年10月5日 ｜ 面向项目团队的决策与执行参考

## 核心结论

EffMeet 2 的核心方向符合赛事，建议继续选择“效率进化”的自由创作方向。当前主要问题是实际完成度与方案目标之间存在差距：业务流程已经形成模拟闭环，真实模型、语音、远程协作和机器人尚未贯通。参赛准备应优先收紧范围、接通真实体验，而不是换题或继续增加功能。

判断项 | 结论
方向匹配 | 匹配。混合会议协作能够对应学习、研究与工作效率。
产品形态 | 合理。电脑伴侣、远程网页、桌面设备可构成软硬协同方案。
当前成熟度 | 业务流程原型阶段，不能等同于完整 AI 会议机器人。
优先决策 | 围绕本人确认的观点提醒完成一条真实链路。
后续目标 | 去电脑化、独立手机 App、广泛会议软件兼容后置。

## 建议采用的产品定位

EffMeet 2 是面向校园科研组和课程项目的混合会议协作伙伴，通过本人确认的观点提醒与可追溯记录，帮助团队减少线上观点遗漏和会后反复确认。

## 评估依据与使用边界

赛事事实依据官方主页、赛道图和赛程图；项目现状依据 README、产品方案、分工说明、控制器、千问客户端、媒体中继、固件目录及 10 月 5 日接手记录。具体来源见文末。功能规划、现有代码与已记录测试结果分别表述，不以规划替代实际能力。

本文中的优先级、验收指标和排期属于项目建议，不是官方评分或硬性参赛门槛。报名资格及完整规则以提交时的官方公告为准。

# 一 赛事要求与项目方向对照

本赛事是 AI 应用与产品创新比赛，网页是报名和展示入口，并不要求作品必须是网站。官方允许自由创作，并要求说明作品与所选赛道的关联。[1][2]

官方要求或方向 | EffMeet 2 的对应情况 | 判断
效率进化 | 围绕混合会议的信息共享、观点回应与记录核对 | 方向匹配
创新性与实用性为核心 | 本人确认的提醒机制具有辨识度，实际效果待验证 | 潜力较好
完成度为核心 | 现有实现以 mock 为主，核心真实链路未完成 | 当前短板
美观度为加分项 | 桌面宠物及观点地图有展示潜力 | 应在核心稳定后优化
软硬协同与端云结合加分 | 电脑编排、云端模型、现场设备的架构相符 | 需用实物运行证明
允许开源二次开发 | 计划复用语音、模型及嵌入式生态 | 说明原创部分与许可
高校在校学生个人或组队 | 需要核对成员在读资格与正式名单 | 报名时确认

## 赛道选择

建议以“效率进化”自由创作方向参赛。项目服务于团队讨论和研究协作，与该赛道强调的学习、研究和工作方式相符。机器人外观具有陪伴属性，但主要价值仍是协作效率，不宜因此把主定位转向情感陪伴。

赛道图中的阿里云特别赛题强调基于 Qwen 的科研提效、认知增强与研发范式革新。仅使用千问 API，不等于已经满足特别赛题要求。若选择该命题，需要另行核对其完整要求并证明科研场景价值。[2]

## 评审与赛程

主页列明初赛专业评审占 80%、网友人气占 20%，决赛由专家团评审；创新性、实用性和完成度为核心，美观度为加分。以上不等于各专业评分子项的具体权重。[1]

官方赛程图显示：报名与作品提交为 9 月 8 日至 10 月 21 日；初赛评审为 10 月 22—24 日；总决赛为 11 月 5—8 日，基于初赛 Demo 继续迭代。10 月 7 日适合作为内部首版检查点。[3]

# 二 产品价值与差异化重点

用户问题 | 产品能力 | 预期价值
线上成员看不到现场材料 | 抓拍并共享草图或原图 | 减少描述、重画和反复确认
线上观点未被现场回应 | AI 提出候选，本人确认后提醒 | 减少观点遗漏和重复追问
会后难以查清谁说了什么 | 观点与回应关联原始发言 | 减少核对和整理成本

## 把本人确认的观点提醒作为主线

单独的录音转写和自动总结难以突出差异。更有辨识度的体验是：系统发现可能未获回应的观点，向观点本人展示证据与提醒建议；本人决定是否发送；现场设备传达；后续回应进入记录。

本人确认既保留用户控制，也降低 AI 误判造成的打断和尴尬。拒绝提醒、不确定时不提醒、过期候选重新分析，应与成功提醒同样成为产品体验的一部分。

## 将公平性目标落到可验证的问题

“混合会议公平性系统”覆盖范围过大。发言机会、决策权和议题影响力并不能由一个提醒机制直接改善或证明。建议以“减少线上观点遗漏和会后核对成本”为主目标，把参与感作为体验目标。

发言增加也不一定代表效率提升。提醒过多可能延长会议，因此应同时观察误提醒、打断和用户拒绝情况，避免以机器人说话次数作为成功指标。

## 回答为什么需要机器人

需要验证的产品假设是：现场成员关注彼此、纸面材料或白板时，可能错过屏幕上的线上消息；桌面实体能够将经本人确认的提醒带入共同物理空间。这个价值必须通过场景演示和试用证明。

可爱外观和转头动作可以增强注意与状态表达，但不应成为主要成果。评委更需要看到设备在适当时机帮助一个观点得到回应，并且不会反复打断讨论。

## 建议的演示叙事

先展示一次线上观点被遗漏的情境，再展示系统如何识别、征求本人确认、现场提示和记录回应。图片共享与观点地图为这一场景提供支持，不必用功能清单主导演示。

# 三 现有实现与目标之间的差距

模块 | 当前实现证据 | 参赛表述边界
业务与事件账本 | 会议、发言、确认、拒绝、重试、事件恢复已有实现 | 可展示模拟闭环与控制逻辑
千问接入 | 已有 QwenAnalyzer；Store 默认 FakeAnalyzer 且拒绝非 mock 适配器 | 设置 Key 不会自动接通主链路
语音与中继 | 中继有接口骨架；转发 ASR 仍为 TODO | 不能宣称完整实时语音能力
图片共享 | 已有上传与读取接口 | 不等于摄像头自动采集和理解
观点地图与记录 | 根据现有发言和模拟分析生成 | 不等于真实语义判断已验证
多人远程会议 | 当前入口限制本机访问 | 不能当作多人共享线上入口
机器人硬件 | 固件与电子目录为说明骨架 | 拾音、播放、转头尚未验证
独立移动产品 | 手机 App 与去电脑化属于路线规划 | 作为未来目标呈现

## 应首先修正的技术与文档问题

模型主链路：README 对环境变量切换真实模型的描述容易产生误解。实际控制器只允许 mock 适配器，应先完成真实调用接入和状态标识，再更新能力描述。网络调用不能直接塞进现有短数据库事务。

媒体链路：10 月 5 日记录指出，带 24 字节 EFMA 头的标准音频帧被中继按 640 字节裸 PCM 拒绝；无效媒体凭据可被接受；全新依赖安装缺少 WebSocket 运行库。这些问题应在远程或设备联调前处理。[4]

证据映射：观点分析提示词要求返回发言 ID，但构造的对话文本未提供这些 ID；单条分析解析存在将现场发言整体纳入回应证据的逻辑。应按具体观点与回应建立证据关系。[5]

## 如何理解已有测试结果

接手记录报告 42 项 unittest 和 12 项 HTTP 冒烟通过，这支持模拟流程具备一定可靠性。它不证明真实转写效果、模型判断质量、网络语音收发或机器人播放成功；本机身份选择也不等同正式多人身份认证。[4]

# 四 初赛范围与验收建议

## 一条必须真实运行的核心体验

校园项目讨论中，远程成员提出意见，现场继续讨论。系统提出可能未获回应的观点，展示原文与提醒建议；本人确认后，现场输出提示；后续回应进入可回溯记录。该过程应至少由两台设备参与同一会议，并明确展示人工与自动环节。

优先级 | 交付范围 | 建议验收方式
必须 | 真实模型分析与证据引用 | 真实输入和输出可核对，不靠手选状态冒充模型
必须 | 本人确认与真实提示输出 | 未确认不执行；重复请求不重复播报
必须 | 至少两台设备的同一会议 | 线上端与现场端能看到一致事件和状态
必须 | 可追溯会后记录 | 观点和回应可定位原文；不确定项明确标注
优先 | 一条语音转写链路 | 真人输入可进入业务流程，失败有可见状态
简化保留 | 原图共享与观点列表 | 优先保证可用，不先追求自动描述与复杂图谱
有余力 | 自动抓拍、图像理解、转头 | 不影响核心链路稳定性
后置 | 独立 App、去电脑化、广泛兼容 | 放入后续产品路线，不作为初赛承诺

## 路线 A 与路线 B 的边界

路线 A 作为初赛方案是合理的：电脑承担本地服务、语音处理或编排，千问通过云端 API 调用。应明确各模块运行位置，避免“本地 AI”让人误以为所有模型都在电脑上运行。路线 B 的去电脑化可作为后续方向。

## AI 判断需要覆盖的情形

准备人工核对过的短对话，覆盖明确回应、未回应、部分回应、延后处理、身份不明和语义不确定。例如“下周再定”属于回应但不代表解决；“好的”未必代表同意。优先减少错误提醒，不强求每次都给确定答案。

观点地图需区分“已回应”“待回应”“不确定”，不要把已回应自动转为已解决或已达成决议。图像描述属于独立能力，不能仅凭现有文本模型客户端就宣称已经实现。

# 五 效果验证与执行安排

## 分开验证可靠性和实际价值

类型 | 建议记录 | 解释边界
工程可靠性 | 转写与分析是否成功、延迟、重复播放、重连状态 | 证明流程可运行，不等于效率提升
提醒质量 | 正确候选、错误候选、漏识别、用户拒绝及原因 | 记录每类场景和分母，避免只报成功案例
用户效果 | 观点被回应比例、回应时间、会后查证时间 | 小规模结果仅代表本次场景观察
讨论负担 | 插话时机、误打断、用户感受 | 避免以提醒次数或发言量衡量成功

已有的 20 次场景排练可用于工程验收。进一步可安排同类任务的有无系统对照，以及少量真实团队试用。逐次记录真实、人工或回放模式，不能把备用路径计为自动链路成功，也不能直接套用参考论文的效果数字。

## 按团队能力优化后的排期

团队已具备熟练使用 vibe coding 的能力，因此采用接口先定、模块并行、每日集成的开发方式。提前完成代码与首轮联调，将节省的时间用于真实体验验证和展示优化。此调整基于团队能力说明，不改变当前代码完成状态的判断。

时间 | 工作重点 | 阶段产出
10 月 5 日 | 冻结场景与接口；模型、媒体、前端并行启动；核对硬件到位时间 | 统一输入输出样例与验收脚本，各模块负责人明确
10 月 6—7 日 | 真实模型、转写、两端确认同步开发并每日集成 | 首个真实软件闭环，形成可复现演示录像
10 月 8—10 日 | 集成机内采集与播放；并行完善图片共享和观点地图 | 硬件到位前提下完成首轮软硬闭环；记录设备回执
10 月 11—13 日 | 完整场景测试、小范围试用和问题修复 | 完成 20 次工程排练，形成效果记录并冻结核心范围
10 月 14—17 日 | 优化提醒质量、交互和外观；同步录制与编写材料 | 可提交候选版；核心稳定后最多增加一项增强能力
10 月 18—20 日 | 回归、正式录制、上传与检查；只修关键问题 | 正式作品包、备用演示和已检查的提交版本
10 月 21 日 | 按官方要求完成最终提交 | 确认最终版本和提交结果

目标由原先 10 月 13 日前完成设备集成，前移至 10 月 10 日前形成完整演示；核心范围冻结前移至 10 月 13 日。日期为计划目标，硬件到位、账号可用和实际联调结果决定是否达成。提交截止的具体时刻以官方通知为准。

# 六 并行开发与阶段验收

## 把团队能力转化为交付速度

vibe coding 可用于加速接口实现、页面搭建、适配器和测试脚本编写。提速方式是减少模块间等待：先固定数据契约和共同样例，随后并行开发；每个模块交付可运行入口、样例和错误状态，集成负责人每天合并验证。测试与材料负责人从第一天参与，不等功能齐全才开始工作。

各模块保留明确负责人和修改边界，共享契约变更需先同步上下游；每天保留一个可运行版本。代码生成完成、单模块通过和端到端通过分别记录，避免多个模块“各自完成”却无法组合演示。

## 用通过条件决定下一步

节点 | 通过条件 | 未通过时的安排
10 月 7 日 | 两台设备参与；真实模型生成候选；本人确认后真实输出；原文可回溯 | 暂停增强功能，优先修主链路；人工输入或输出须显式标注
10 月 10 日 | 硬件到位；真实拾音与播放可重复验证；执行状态与实际设备一致 | 继续软件台架验证，保留硬件问题清单，不把台架结果当实物完成
10 月 13 日 | 20 次排练逐次记录结果；未经确认不播报、重试不重复、失败可见 | 处理关键缺陷，不扩展范围；效果问题进入提示词和交互修正
10 月 17 日 | 核心体验稳定、材料与版本一致、备用演示可用 | 后续只修关键问题，保留上传和回归缓冲

## 可以压缩和需要实测的工作

接口、页面、状态展示和测试脚本可以并行加速；硬件物流、拾音效果、回声、播放停止、网络重连和模型语义判断仍需真实环境验证。提前安排这些验证，不把它们全部挤到录制前。若硬件尚未到位，先用电脑音频作为明确标注的台架路径，避免其他成员空等。

节省出的时间优先用于降低误提醒和演示失败率。10 月 13 日验收通过后，可选择自动抓拍、图像描述或转头表达中的一项增强能力；独立 App、去电脑化和广泛会议软件兼容仍放在后续路线。

## 建议明确的团队职责

产品负责人固定场景、行为边界和效果指标；集成负责人维护主链路、状态和发布版本；AI 与音频负责人解决模型证据映射、转写和媒体问题；前端负责人完成远程确认和记录核对；测试与演示负责人维护场景记录与参赛素材。分工应按实际正式队伍调整。

# 七 材料口径与提交前检查

## 统一作品介绍

建议介绍：EffMeet 2 面向校园科研组和课程项目的混合会议。系统从讨论中识别可能尚未获回应的线上观点，展示原文证据，经观点本人确认后向现场提醒，并将后续回应关联到可核对的会后记录。现场材料共享辅助远程成员理解讨论。当前交付能力与演示模式以实际运行版本为准。

## 避免能力描述超过实际实现

不宜直接使用的表述 | 建议表述
已经实现会议公平性 | 目标是减少线上观点遗漏，效果通过场景试用验证
设置 Key 即可启用完整真实 AI | 千问客户端已有，真实业务接入以当前版本为准
机器人已经完成播放 | 模拟回执或真实播放回执分别标注
观点已解决或会议已达成共识 | 区分回应、解决与确认后的决议
完整手机 App 与独立机器人 | 分别列出初赛 Demo 能力和后续产品路线

## 建议作品包

准备简洁作品介绍、AI 技术实践说明、核心体验演示、实物照片或明确标注的外观方案、启动或体验说明、测试摘要、架构与开源来源说明。具体提交项、格式和大小以实际表单为准，这份建议清单不等同官方逐项必交要求。

## 提交前检查

核对所有公开能力是否能在演示中复现；明确真实、人工、模拟和回放；核对队员在读资格与正式名单；保留开源署名和适用许可；清理密钥、凭据和未经授权的会议素材；确保提交材料与当前运行版本一致。

现有分工列出 A—F 六人，产品方案记录的报名上限为五人。正式提交前应重新核对完整规则中的人数与协助边界，不应直接把六人内部工作安排视为符合报名要求。

## 建议团队本轮确定的事项

确定“效率进化”自由创作方向；采用减少观点遗漏的产品定位；冻结一个演示场景和初赛范围；明确真实链路负责人；将独立 App、去电脑化和广泛会议软件兼容移入后续路线。核心目标是完成一次真实、连续、可回溯的协作体验。

# 参考来源与证据定位

官方页面用于确认赛事方向与公开赛程；项目文件用于判断当前实现状态。以下来源对应本文编号。

[1] 天猫 AI 黑客松高校挑战赛主页 (https://pages.tmall.com/wow/a/act/tmall/dailygroup/24732/25590/wupr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)

支持内容：核心评审维度、初决赛评审构成、开源二次开发、软硬协同与端云结合、学生参赛。

[2] 官方四大赛道说明图 (https://img.alicdn.com/imgextra/i4/O1CN01PJ0oZ4zOuvH5qXiQ_!!6000000005511-2-tps-2880-1462.png)

支持内容：自由创作机制、效率进化方向及特别赛题概述。

[3] 官方赛事日程图 (https://img.alicdn.com/imgextra/i3/O1CN013sJlL22UefH5qXa0_!!6000000005270-2-tps-2880-940.png)

支持内容：初赛提交、初赛评审与线下总决赛日期。

[4] docs/handoff/2026-10-05.md：记录已有测试结果、音频协议问题、媒体凭据问题、依赖缺失和未验证能力。

[5] services/controller/qwen_client.py：千问客户端、提示词、解析与证据映射；services/controller/store.py：mock 限制、确认和事件账本；services/relay/app.py：媒体中继骨架与 TODO。

[6] README.md：产品定位、路线 A/B、本机模拟演示与模块边界；firmware/esp32/README.md、hardware/electronics/README.md：硬件与固件规划状态。

[7] docs/product/EffMeet2_论文依据与技术路径.html、EffMeet2_分工说明.html：产品规划、分工、内部排期、效果验证设想与报名信息记录。规划内容不等于代码已经实现。

本地文件位置均相对于项目根目录 F:\素材1\EffMeet2-main。团队分享本文时，建议同时保留相应版本的项目文件，以便复核结论。

## 需在提交前再次核对的事项

完整初赛规则中的队伍人数、成员调整、正式评分细则、作品授权及实际表单限制，应在正式提交前复核。本文未将项目文档记录的专业评分细项权重与表单尺寸重新认定为当前官方硬性要求。
