eleanor-wsyy/EffMeet2/assets/enclosure/概念图v2_三视图.png

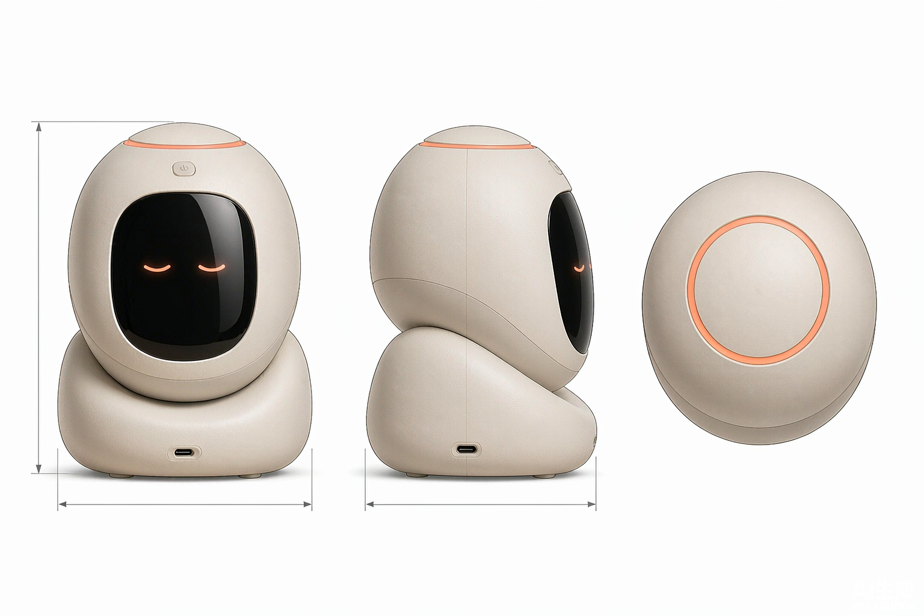
assets/enclosure/概念图v2_三视图.png
