eleanor-wsyy/EffMeet2/assets/enclosure/概念图v2_桌面场景.png

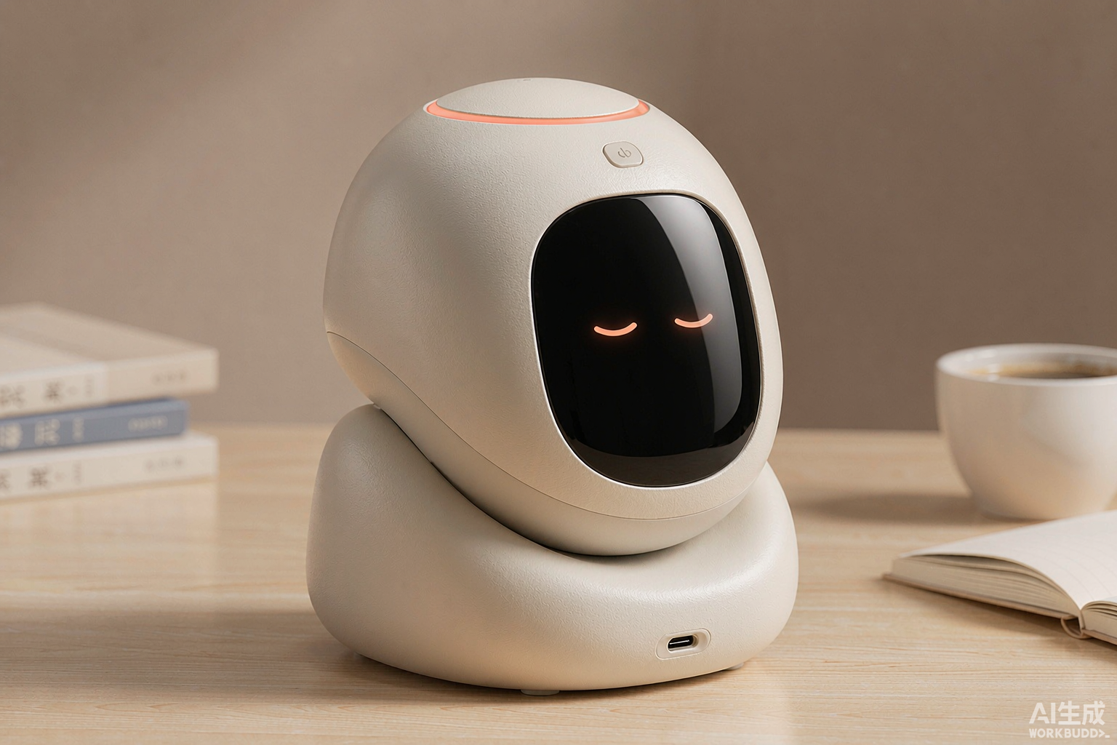
assets/enclosure/概念图v2_桌面场景.png
