eleanor-wsyy/EffMeet2/assets/enclosure/模型v3_预览.png

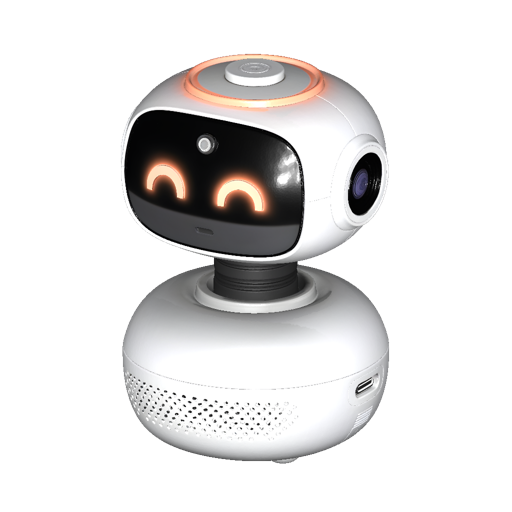
assets/enclosure/模型v3_预览.png
