eleanor-wsyy/EffMeet2/assets/submission/cover-1080x1920.png

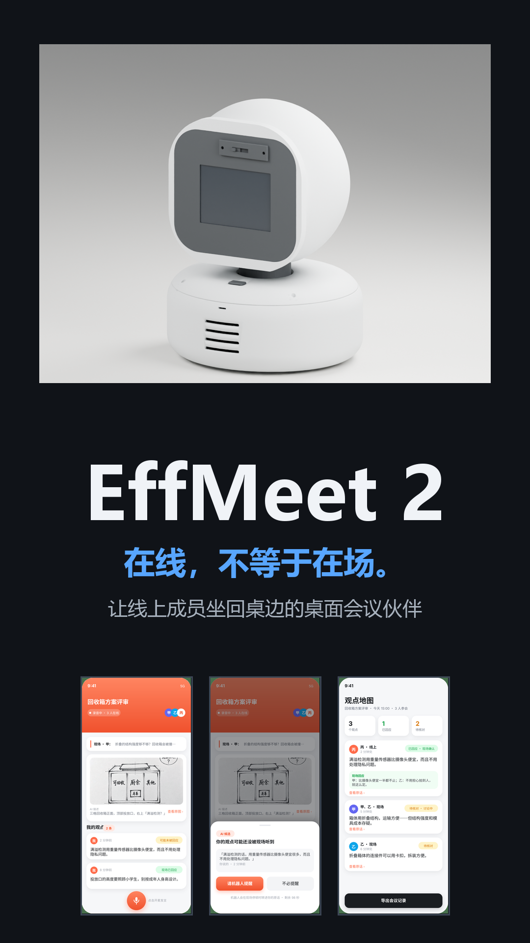
assets/submission/cover-1080x1920.png
