eleanor-wsyy/EffMeet2/assets/submission/cover-1920x1080.png

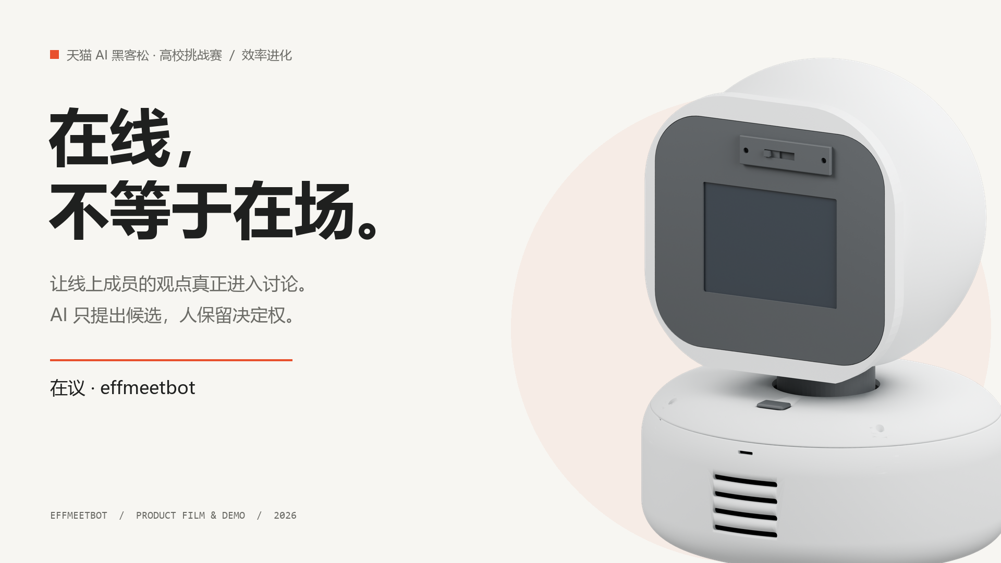
assets/submission/cover-1920x1080.png
