eleanor-wsyy/EffMeet2/assets/submission/screens/ai-demo.png

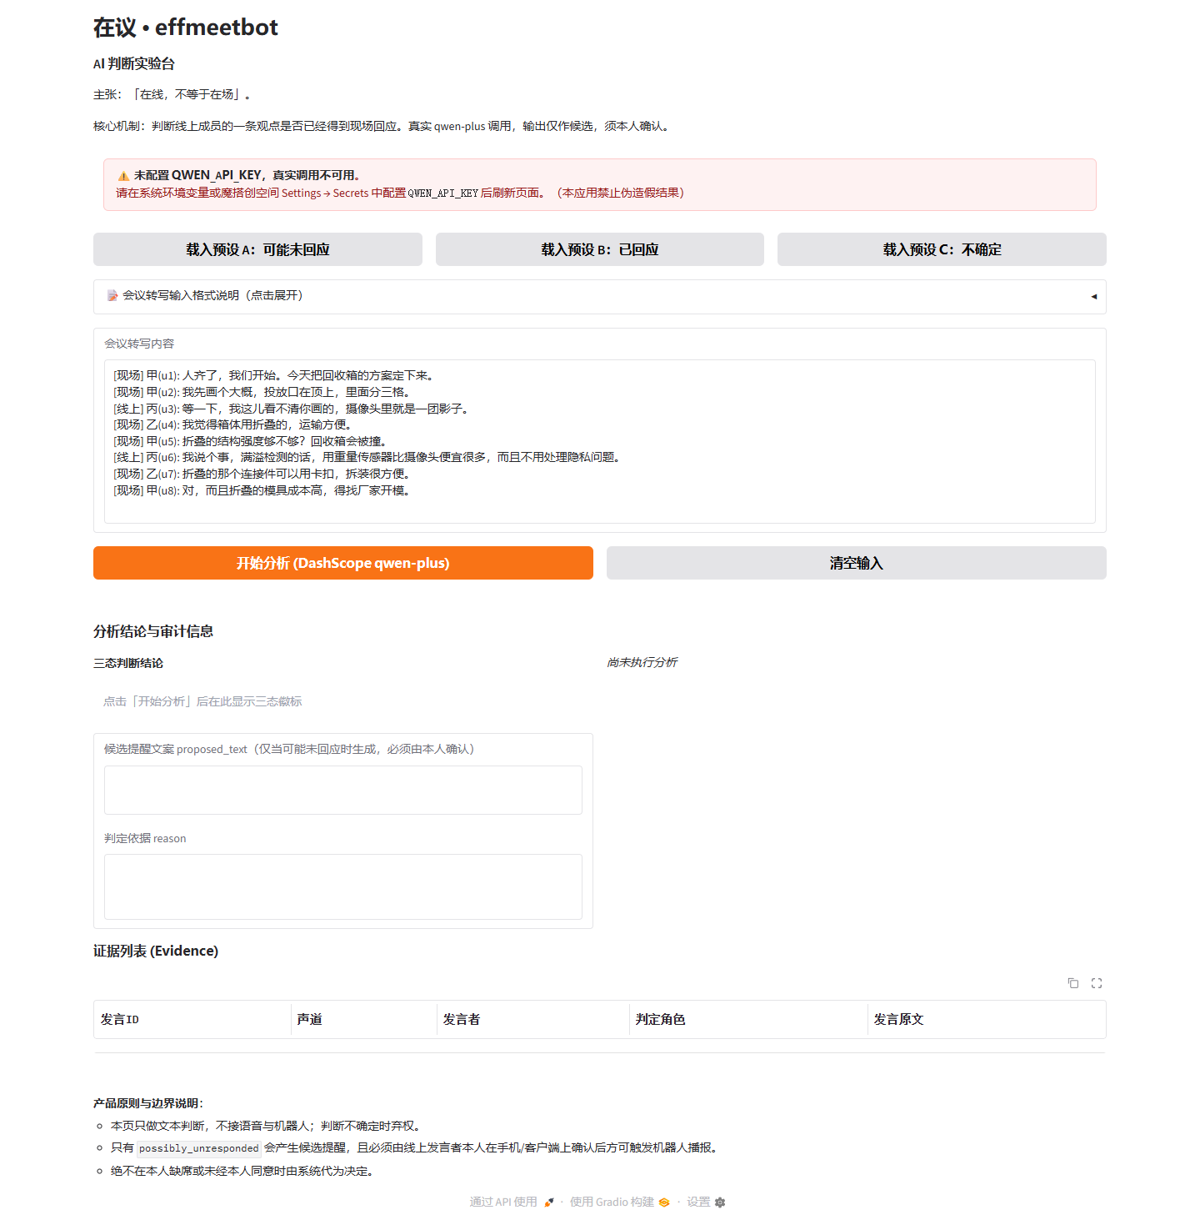
assets/submission/screens/ai-demo.png
