eleanor-wsyy/EffMeet2/assets/submission/screens/design-section.png

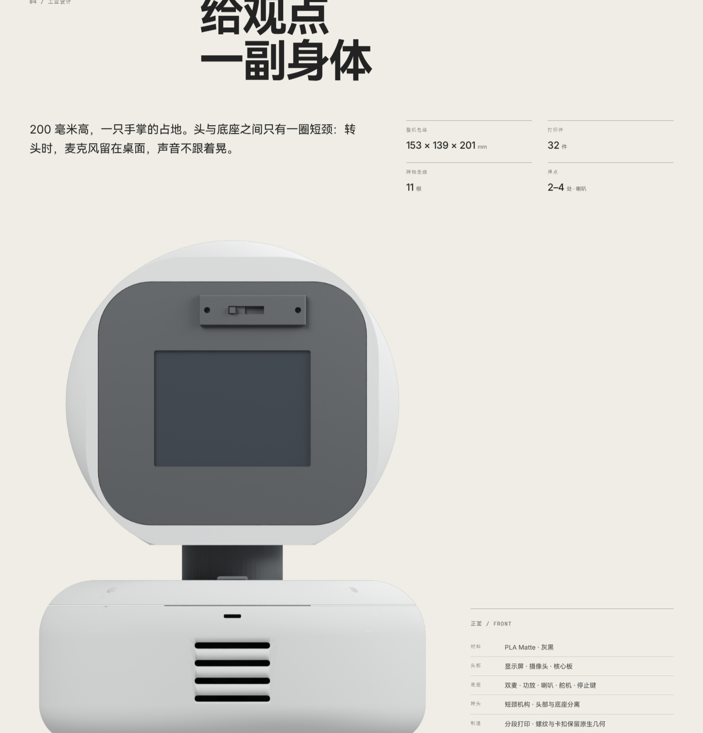
assets/submission/screens/design-section.png
