eleanor-wsyy/EffMeet2/assets/submission/screens/desktop-full.png

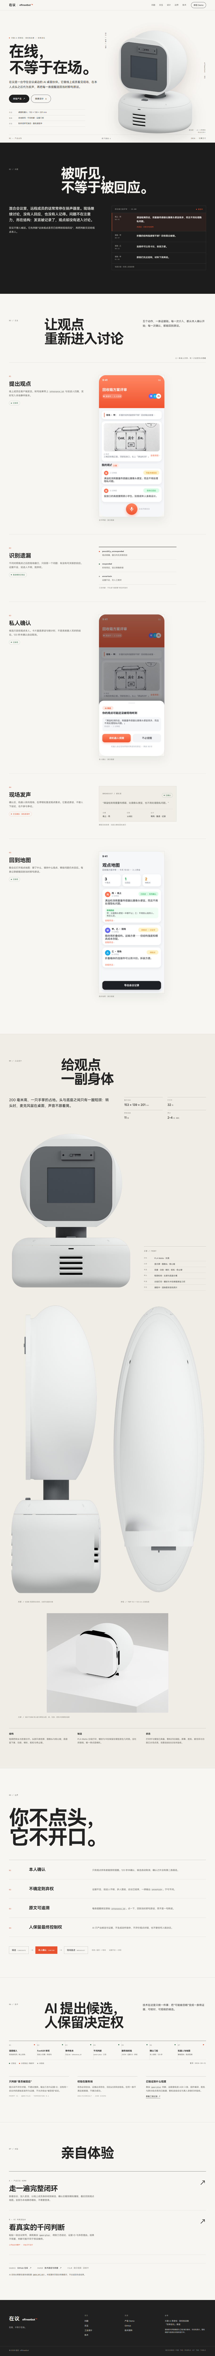
assets/submission/screens/desktop-full.png
