eleanor-wsyy/EffMeet2/assets/submission/screens/desktop-hero.png

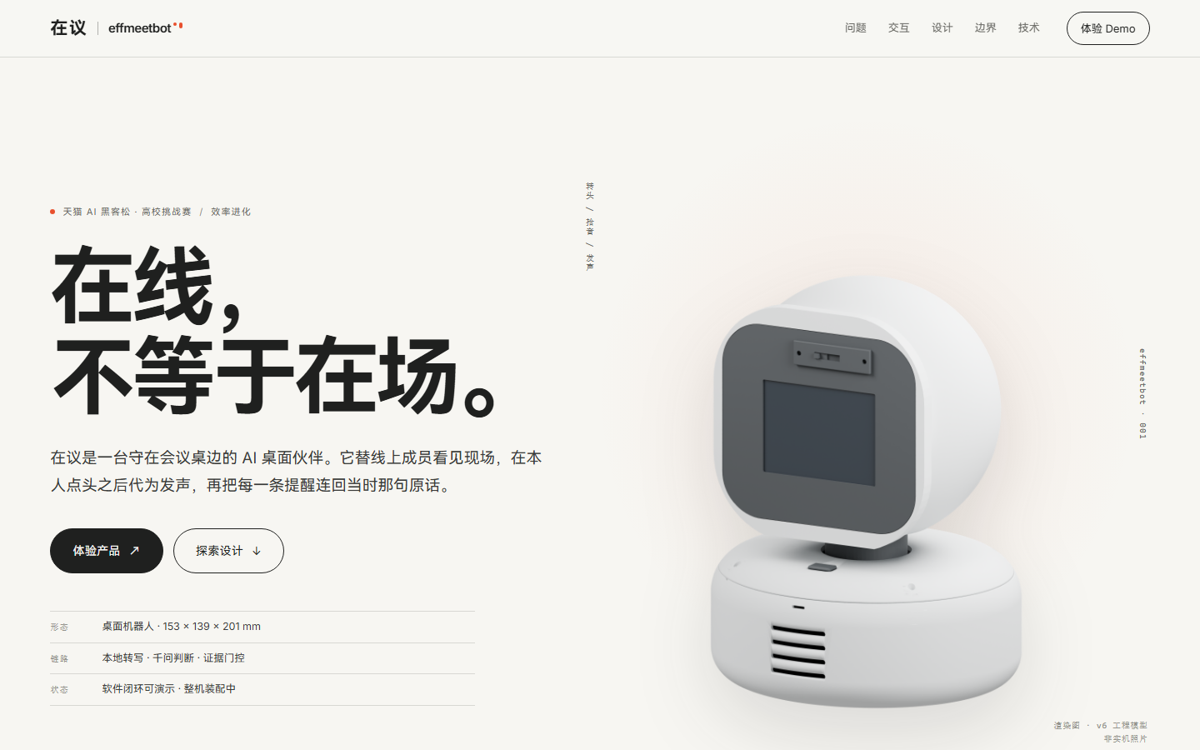
assets/submission/screens/desktop-hero.png
