eleanor-wsyy/EffMeet2/assets/submission/screens/local/ai-desktop.png

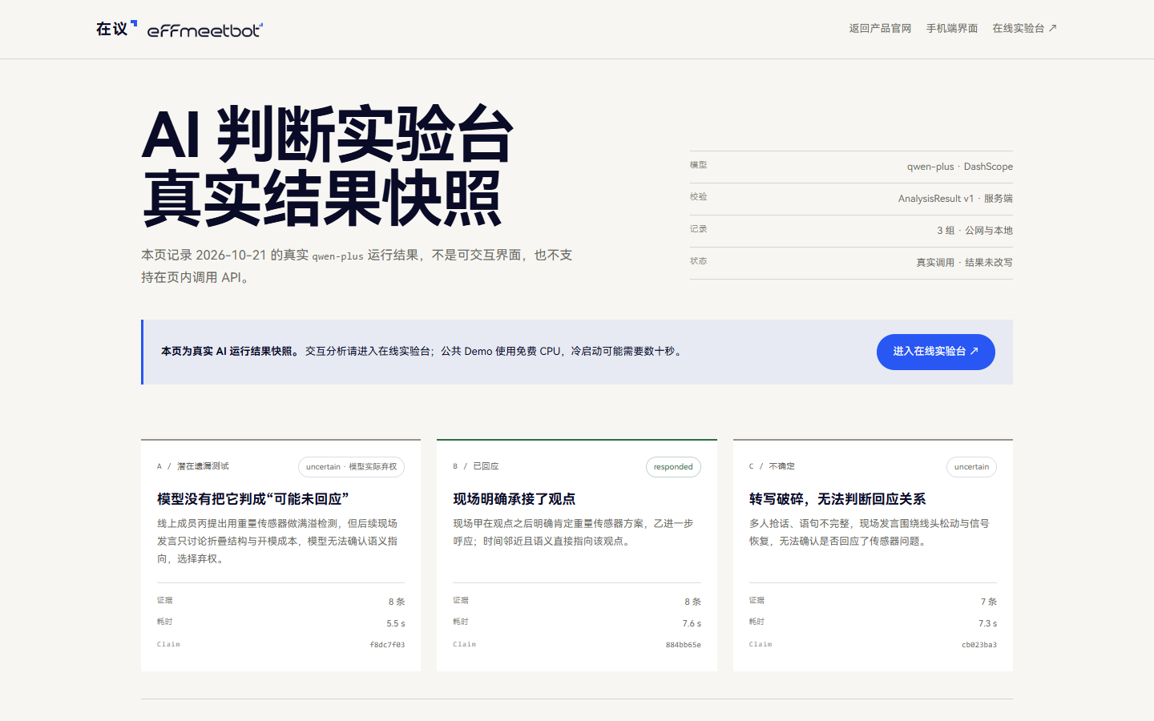
assets/submission/screens/local/ai-desktop.png
