eleanor-wsyy/EffMeet2/assets/submission/screens/local/ai-mobile.png

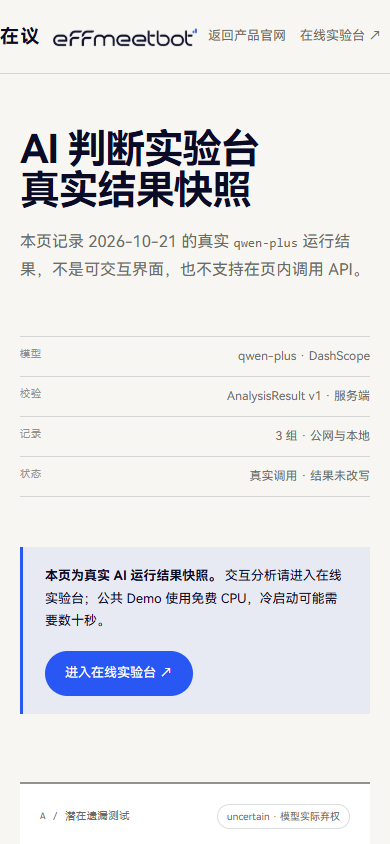
assets/submission/screens/local/ai-mobile.png
