eleanor-wsyy/EffMeet2/assets/submission/screens/local/ai-why.png

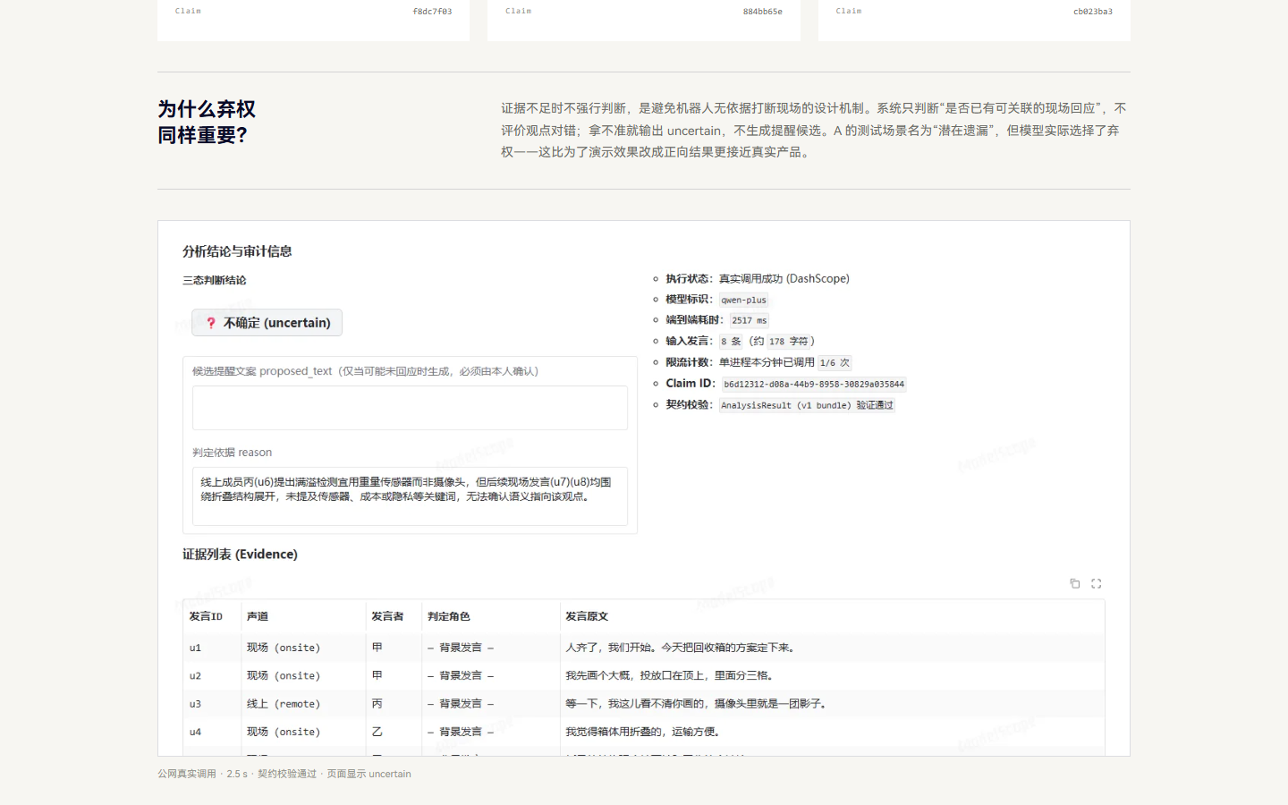
assets/submission/screens/local/ai-why.png
