eleanor-wsyy/EffMeet2/assets/submission/screens/local/functional-app.png

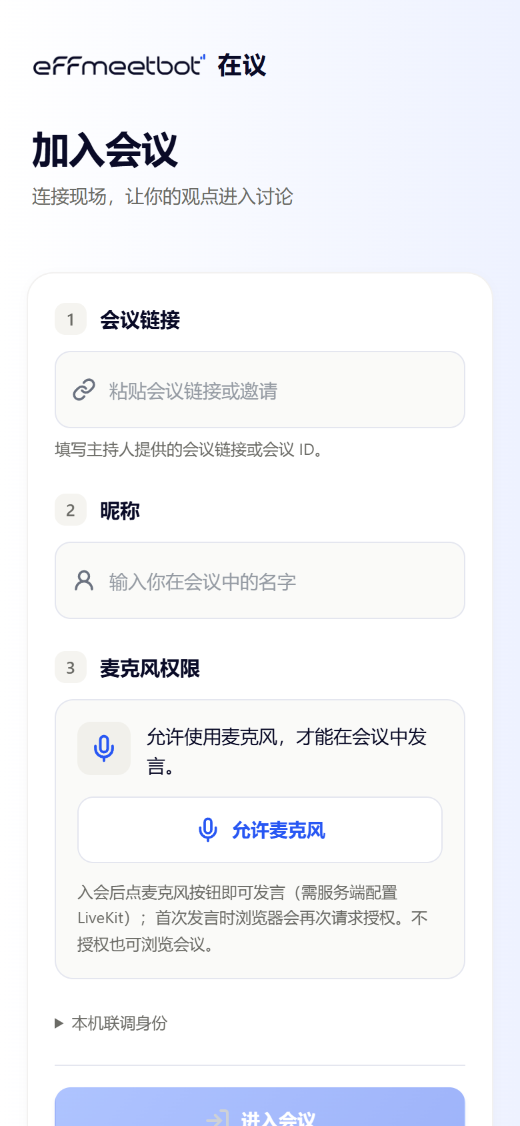
assets/submission/screens/local/functional-app.png
