eleanor-wsyy/EffMeet2/assets/submission/screens/local/gallery-desktop-states.png

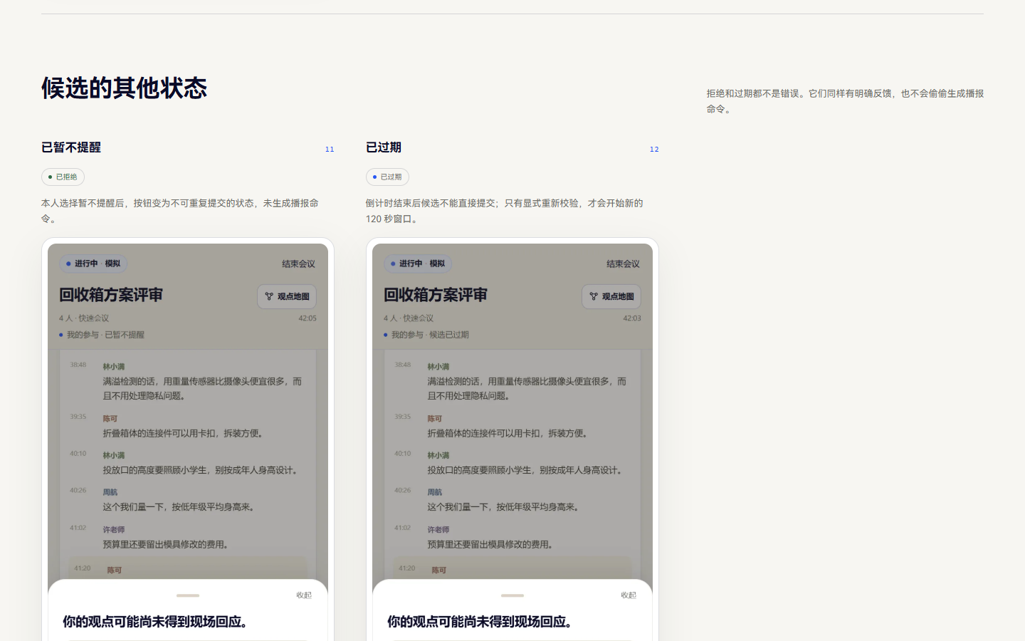
assets/submission/screens/local/gallery-desktop-states.png
