eleanor-wsyy/EffMeet2/assets/submission/screens/local/gallery-desktop.png

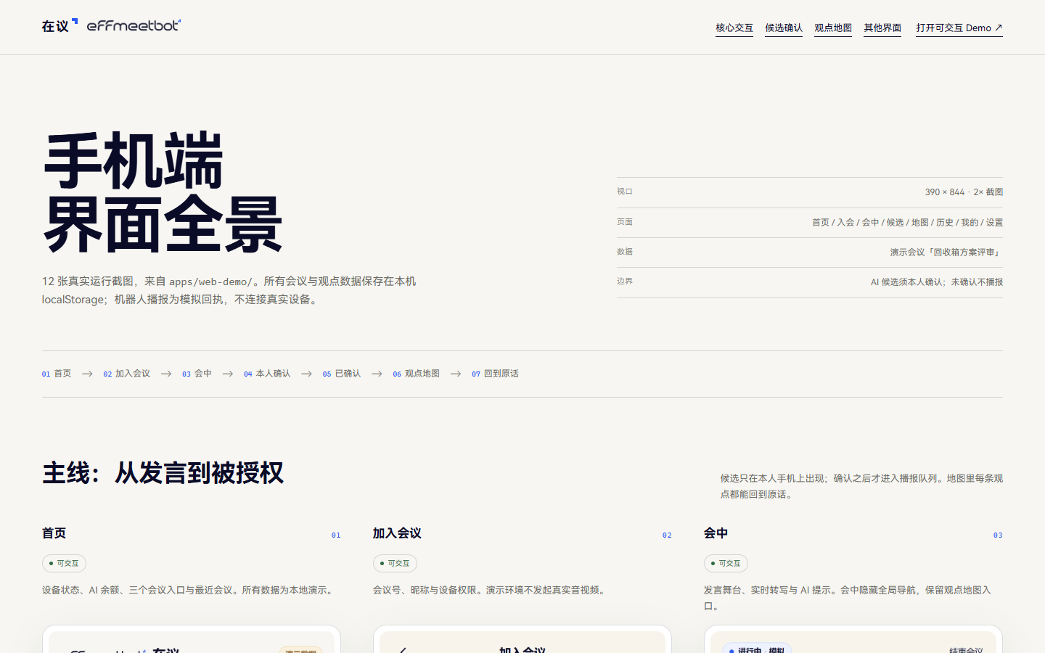
assets/submission/screens/local/gallery-desktop.png
