eleanor-wsyy/EffMeet2/assets/submission/screens/local/gallery-mobile-core.png

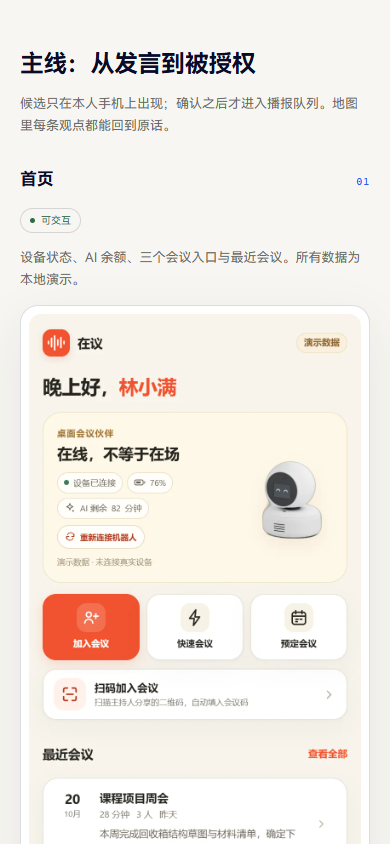
assets/submission/screens/local/gallery-mobile-core.png
