eleanor-wsyy/EffMeet2/assets/submission/screens/local/gallery-mobile-states.png

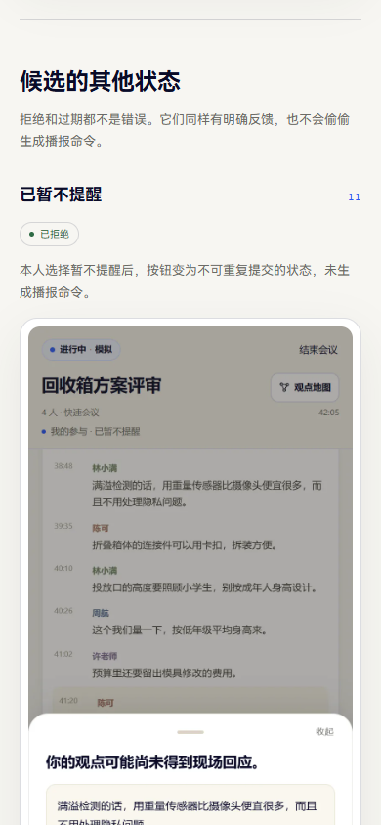
assets/submission/screens/local/gallery-mobile-states.png
