eleanor-wsyy/EffMeet2/assets/submission/screens/local/gallery-mobile.png

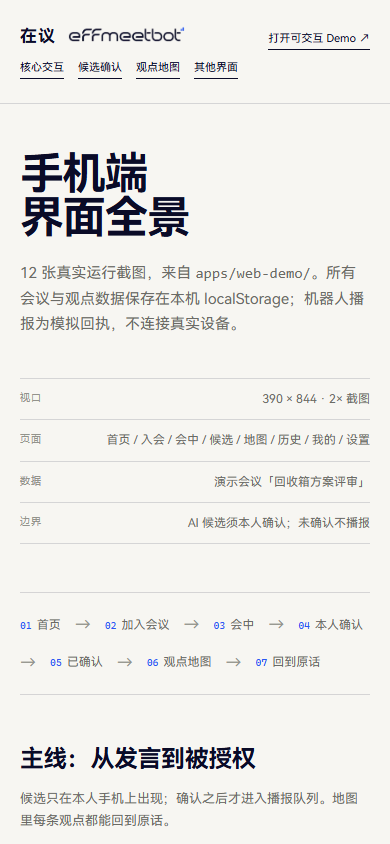
assets/submission/screens/local/gallery-mobile.png
