eleanor-wsyy/EffMeet2/assets/submission/screens/local/gallery-states.png

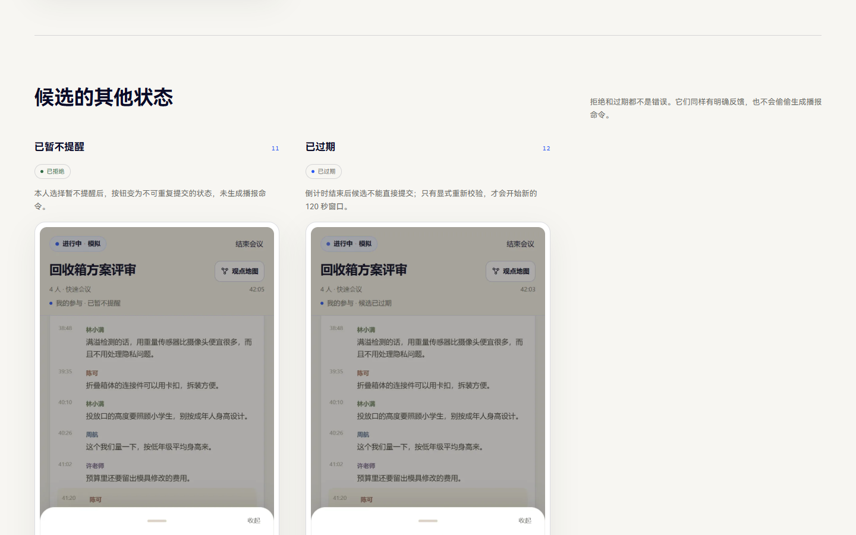
assets/submission/screens/local/gallery-states.png
