eleanor-wsyy/EffMeet2/assets/submission/screens/local/index-desktop.png

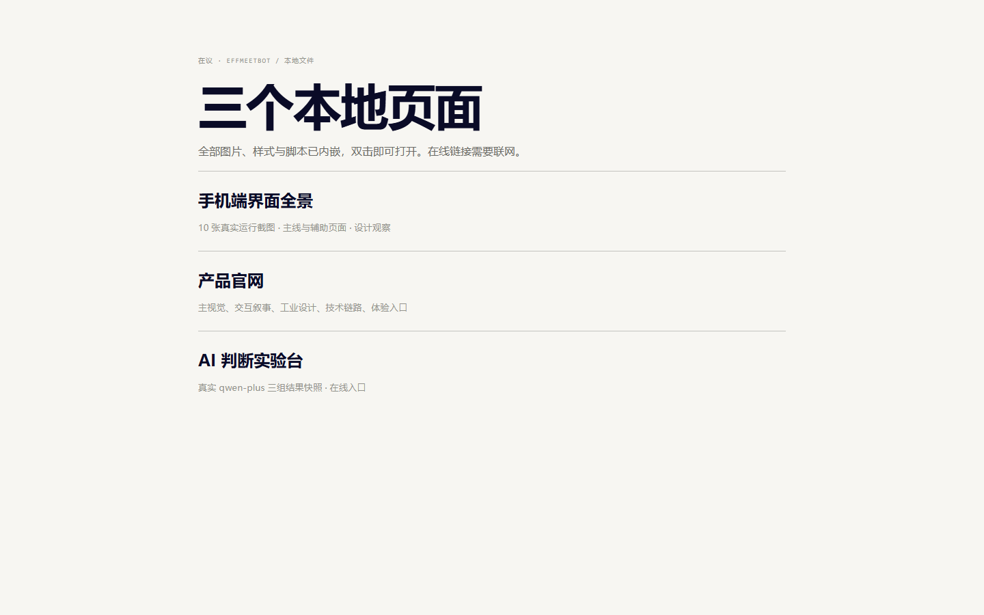
assets/submission/screens/local/index-desktop.png
