eleanor-wsyy/EffMeet2/assets/submission/screens/local/official-design.png

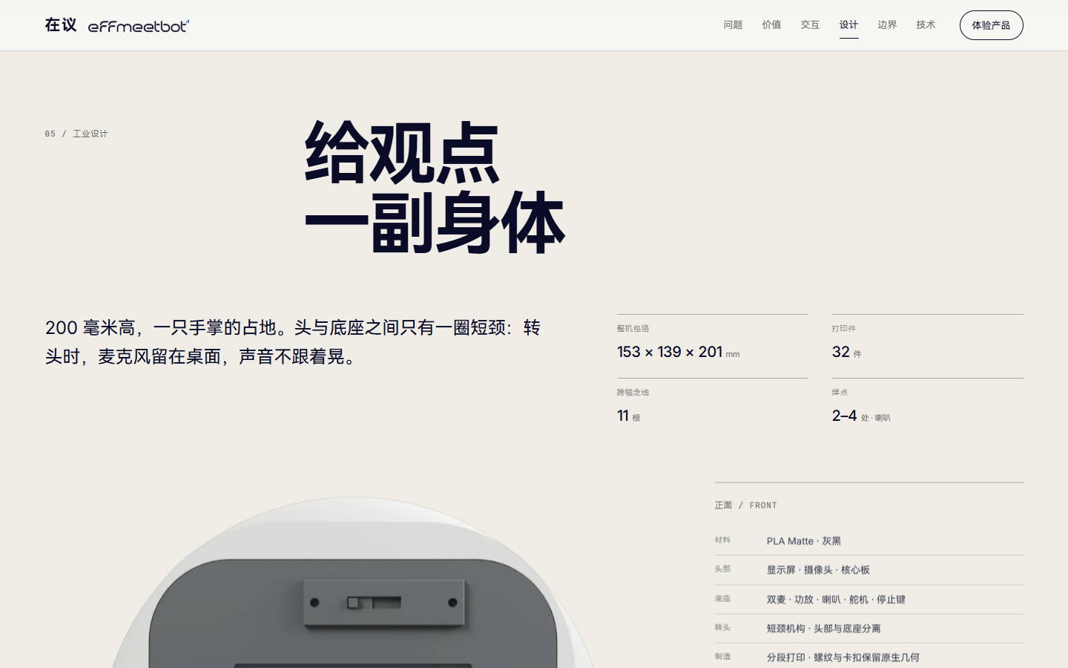
assets/submission/screens/local/official-design.png
