eleanor-wsyy/EffMeet2/assets/submission/screens/local/official-desktop.png

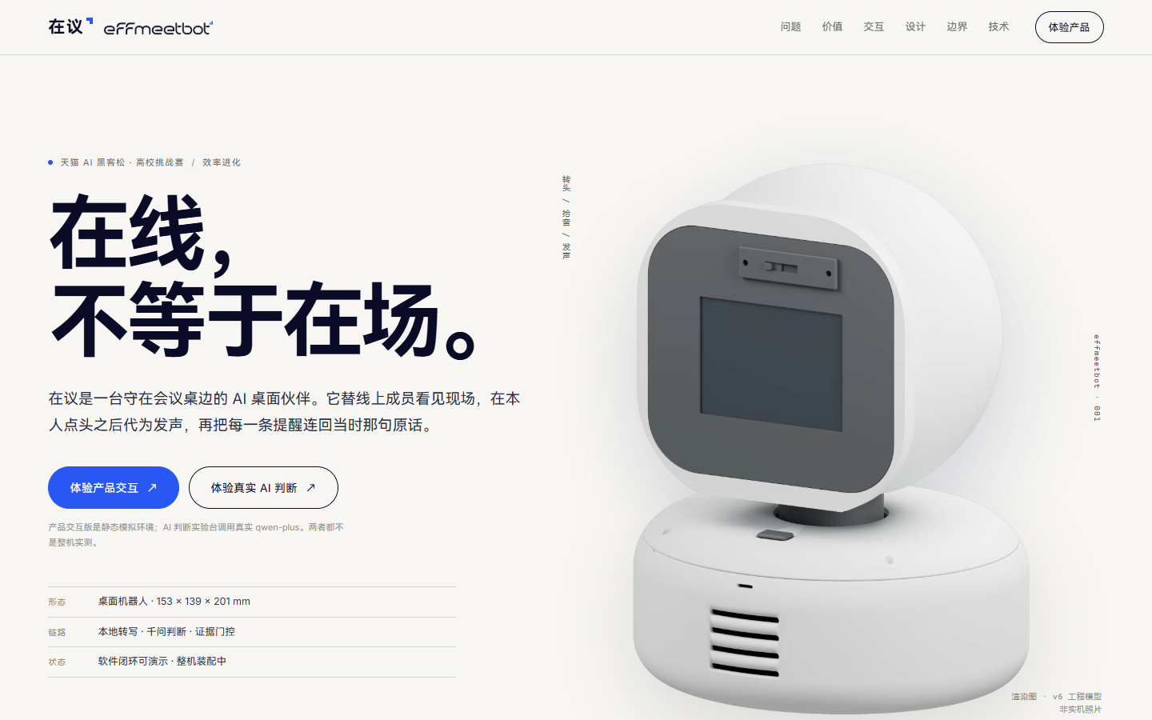
assets/submission/screens/local/official-desktop.png
