eleanor-wsyy/EffMeet2/assets/submission/screens/local/official-interaction.png

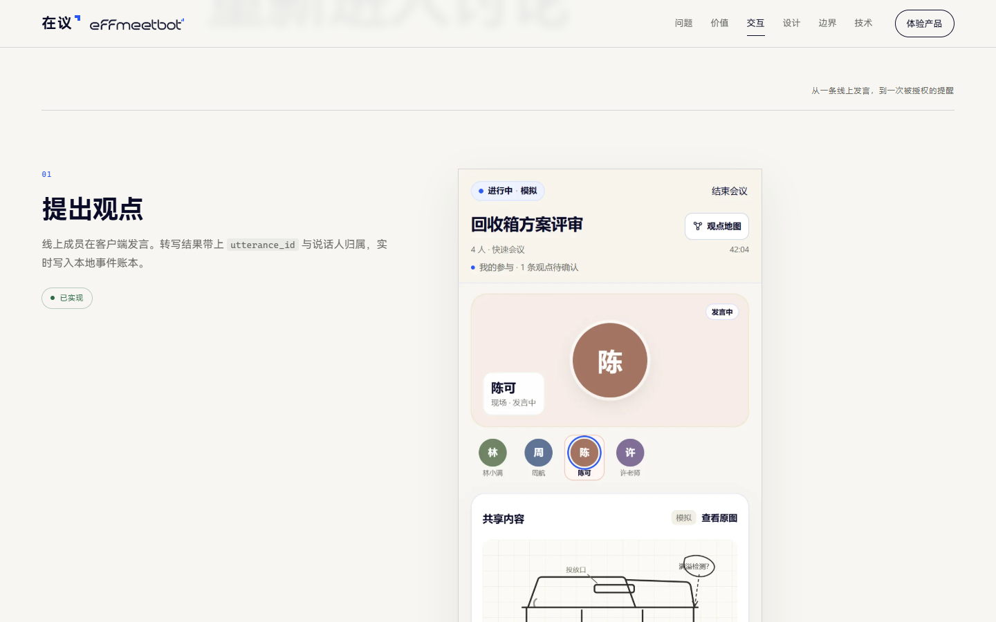
assets/submission/screens/local/official-interaction.png
