eleanor-wsyy/EffMeet2/assets/submission/screens/local/official-mobile.png

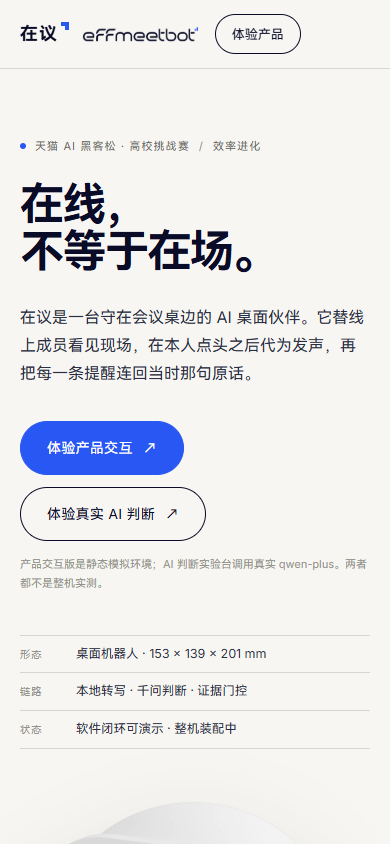
assets/submission/screens/local/official-mobile.png
