eleanor-wsyy/EffMeet2/assets/submission/screens/local/official-values.png

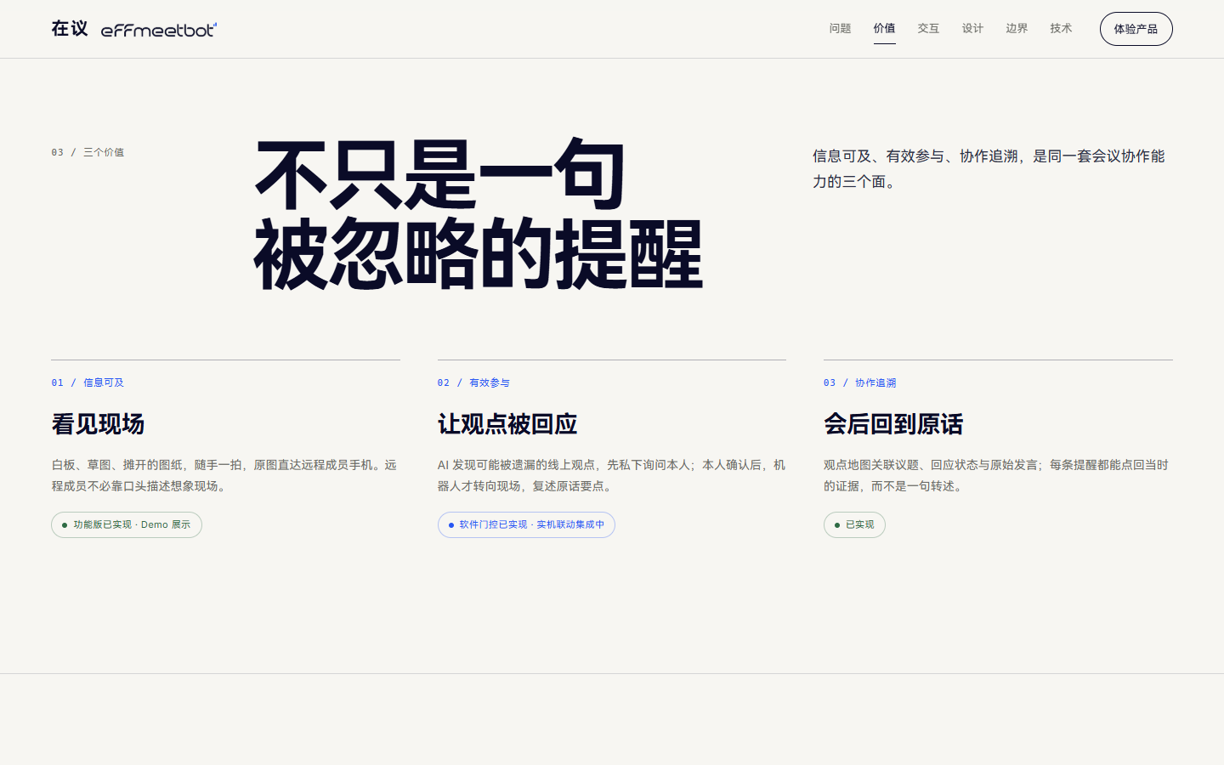
assets/submission/screens/local/official-values.png
