eleanor-wsyy/EffMeet2/assets/submission/screens/mobile-design.png

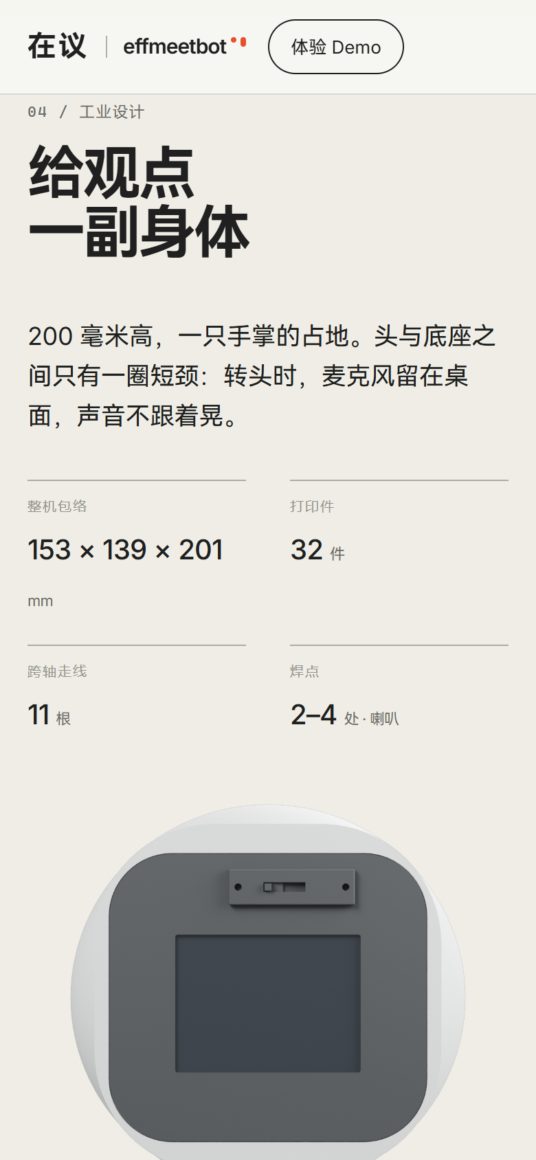
assets/submission/screens/mobile-design.png
