eleanor-wsyy/EffMeet2/assets/submission/screens/mobile-hero.png

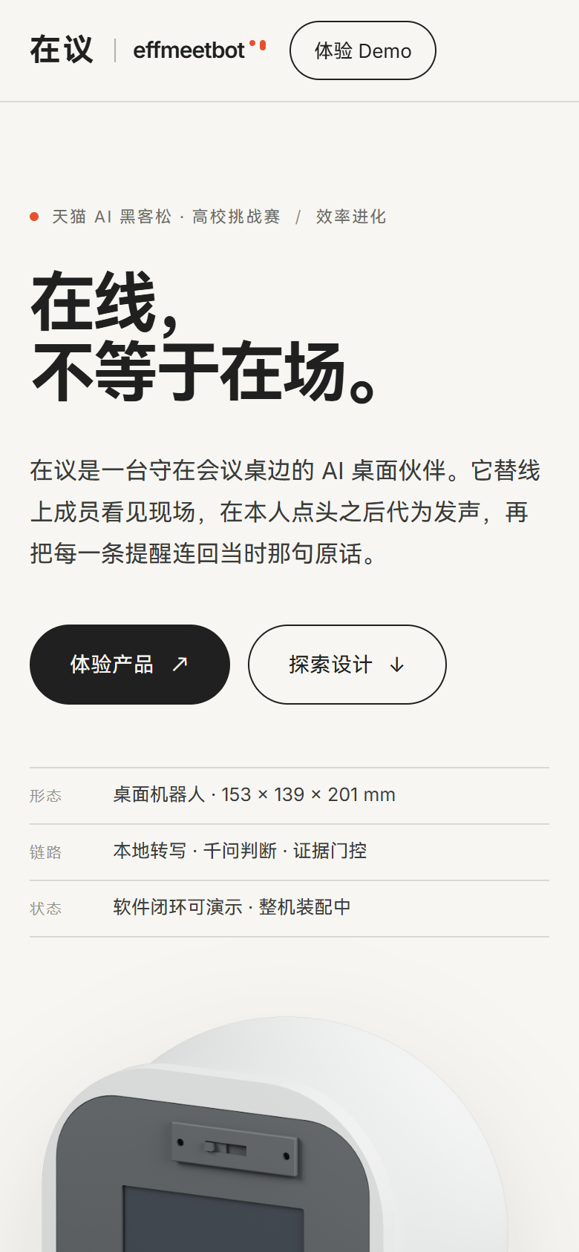
assets/submission/screens/mobile-hero.png
