eleanor-wsyy/EffMeet2/hardware/robot-design/round-yaw-v2/concept/EffMeet2_圆润转头版_主视觉.png

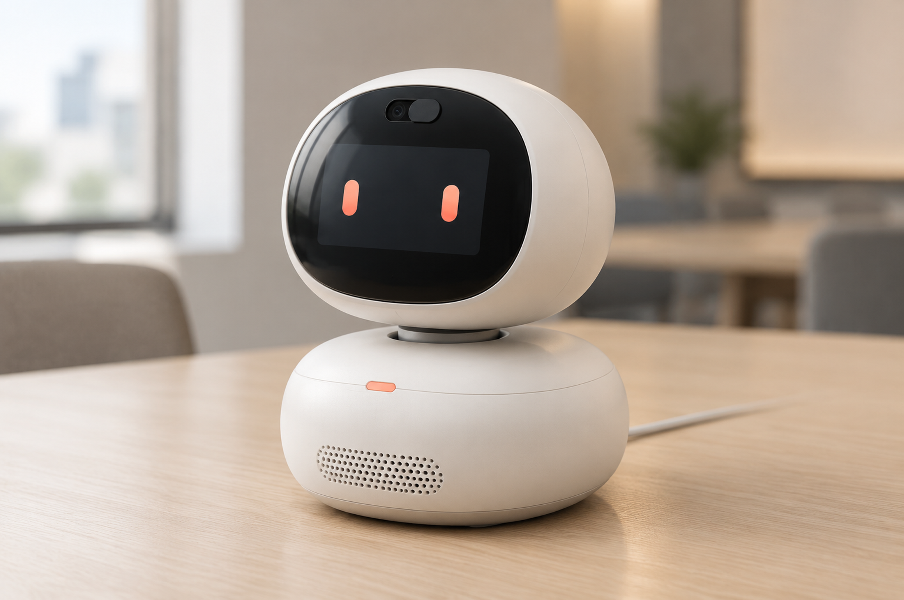
hardware/robot-design/round-yaw-v2/concept/EffMeet2_圆润转头版_主视觉.png
