eleanor-wsyy/EffMeet2/hardware/robot-design/round-yaw-v2/concept/nomi-aligned-20261010/EffMeet2_NOMI方向_现有硬件_效果图.png

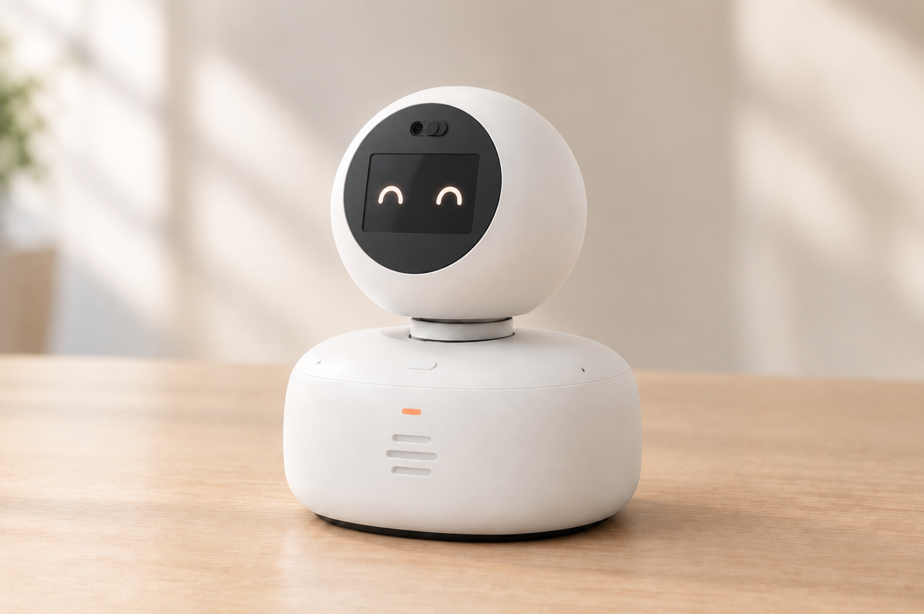
hardware/robot-design/round-yaw-v2/concept/nomi-aligned-20261010/EffMeet2_NOMI方向_现有硬件_效果图.png
