eleanor-wsyy/EffMeet2/hardware/robot-design/round-yaw-v2/concept/refined-friendly-20261010/EffMeet2_外观整合优化_候选01.png

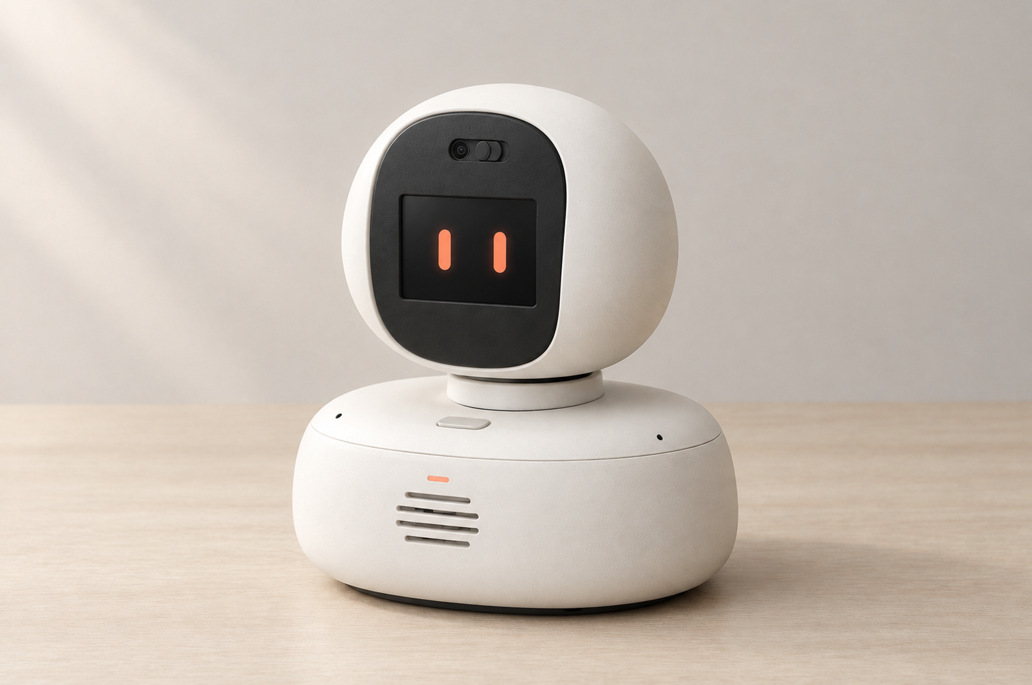
hardware/robot-design/round-yaw-v2/concept/refined-friendly-20261010/EffMeet2_外观整合优化_候选01.png
