eleanor-wsyy/EffMeet2/hardware/robot-design/round-yaw-v2/concept/refined-friendly-20261010/EffMeet2_白色脸颊_普通LCD_优化效果图.png

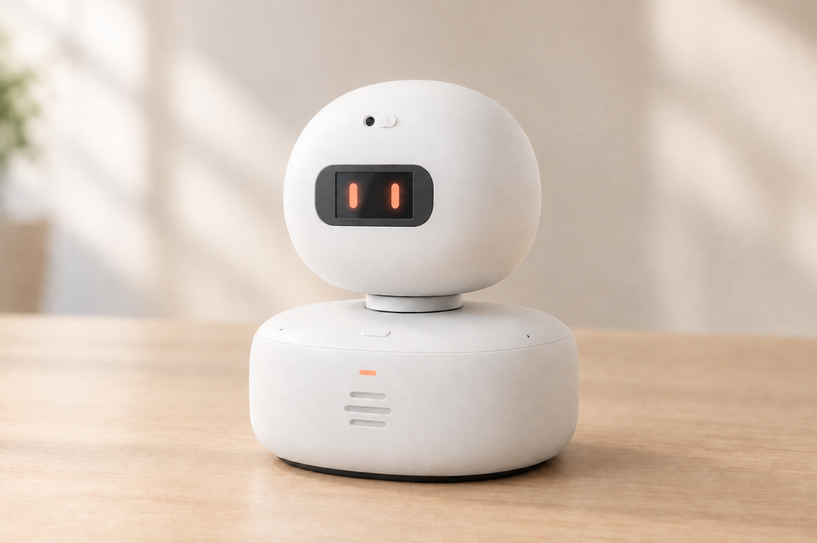
hardware/robot-design/round-yaw-v2/concept/refined-friendly-20261010/EffMeet2_白色脸颊_普通LCD_优化效果图.png
