eleanor-wsyy/EffMeet2/hardware/robot-design/round-yaw-v2/EffMeet2_圆润转头版_三姿态预览_修订.png

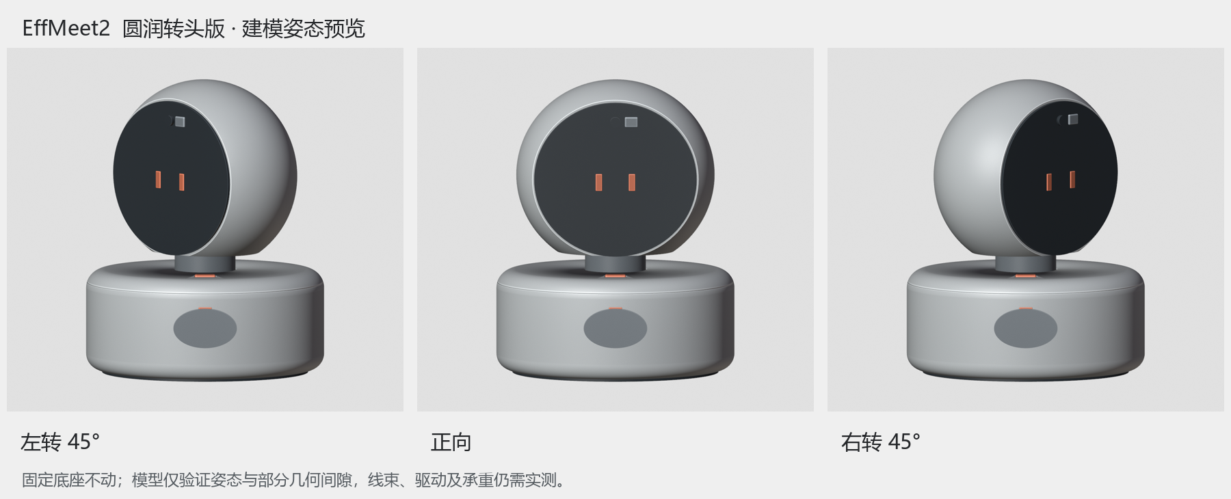
hardware/robot-design/round-yaw-v2/EffMeet2_圆润转头版_三姿态预览_修订.png
