eleanor-wsyy/EffMeet2/hardware/robot-design/round-yaw-v2/renders/review-02/02_front.png

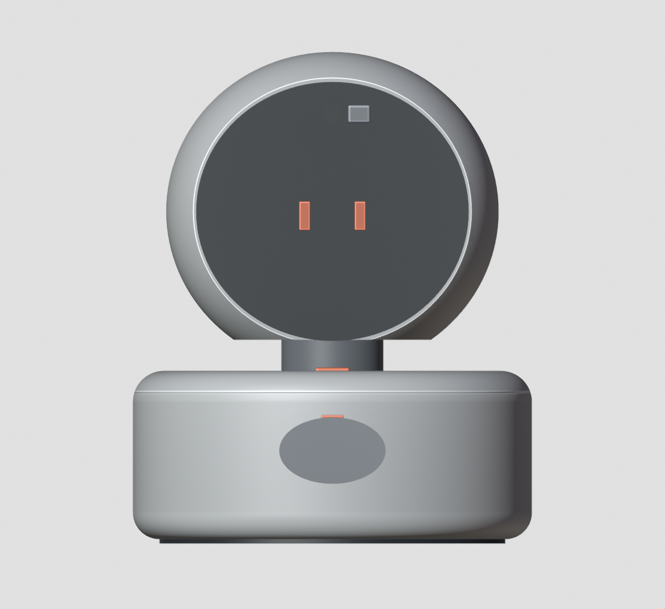
hardware/robot-design/round-yaw-v2/renders/review-02/02_front.png
