eleanor-wsyy/EffMeet2/hardware/robot-design/round-yaw-v2/renders/review-02/03_side.png

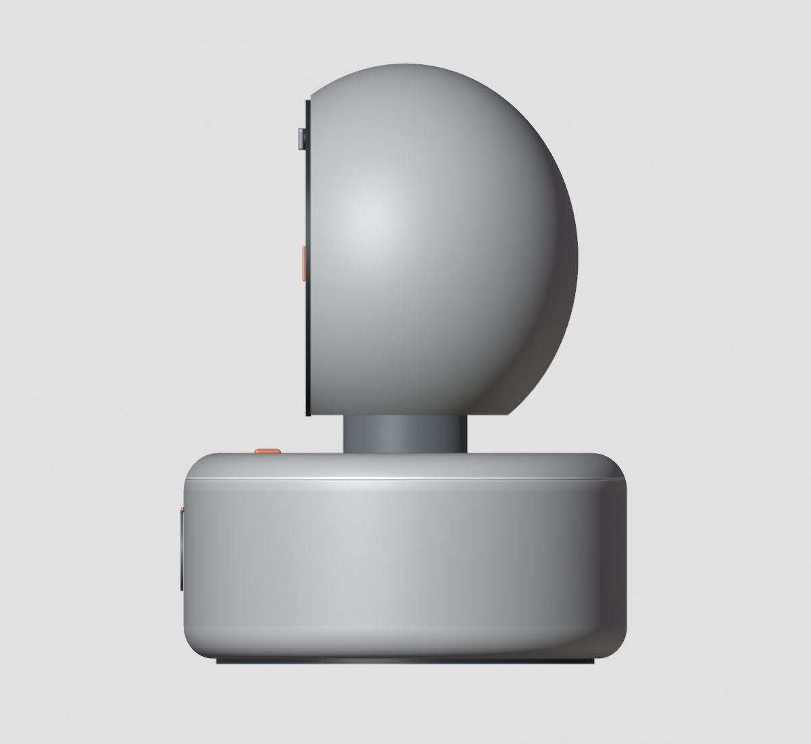
hardware/robot-design/round-yaw-v2/renders/review-02/03_side.png
