eleanor-wsyy/EffMeet2/hardware/robot-design/round-yaw-v2/renders/review-02/04_top.png

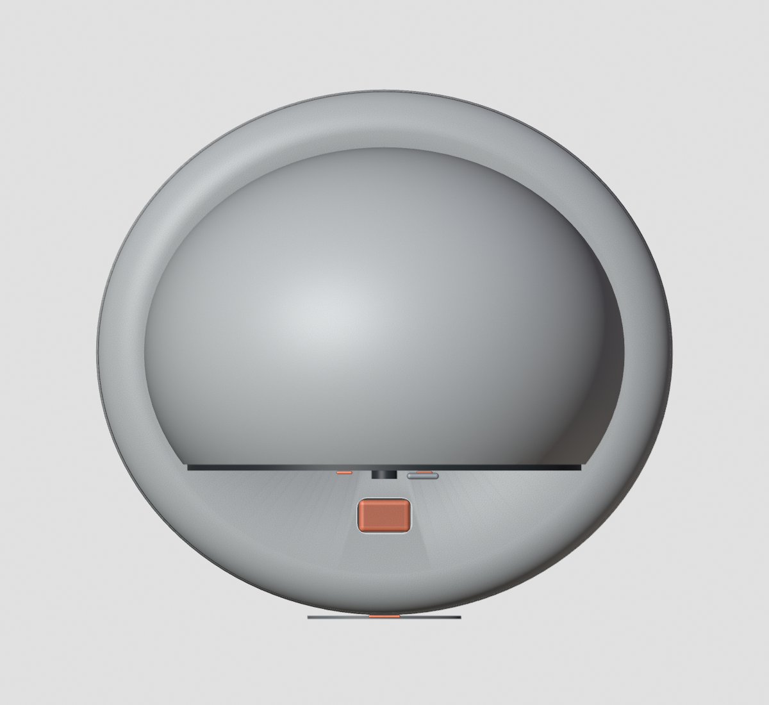
hardware/robot-design/round-yaw-v2/renders/review-02/04_top.png
