eleanor-wsyy/EffMeet2/hardware/robot-design/round-yaw-v2/renders/review-02/06_internal_side.png

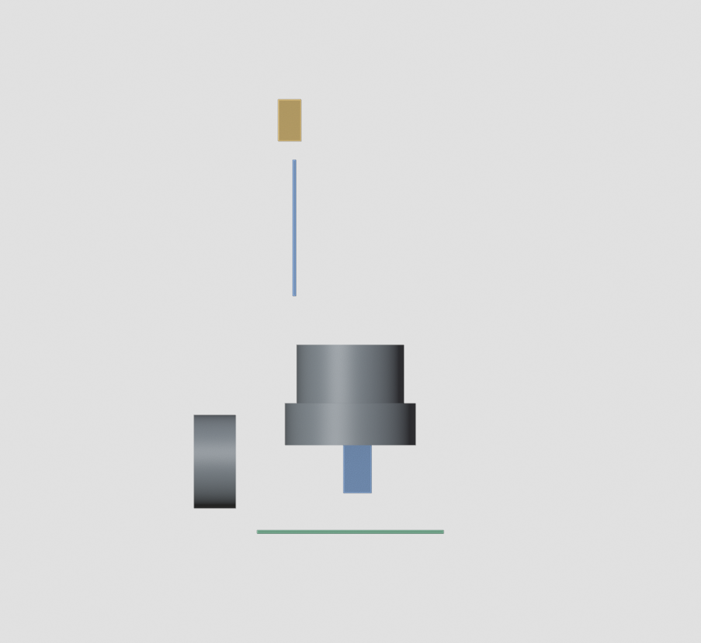
hardware/robot-design/round-yaw-v2/renders/review-02/06_internal_side.png
