eleanor-wsyy/EffMeet2/hardware/robot-design/round-yaw-v2/renders/review-02/07_yaw_left.png

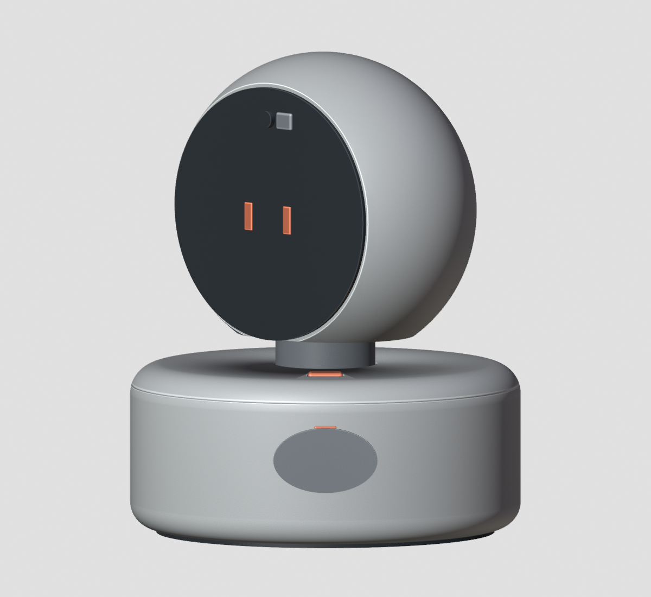
hardware/robot-design/round-yaw-v2/renders/review-02/07_yaw_left.png
