eleanor-wsyy/EffMeet2/hardware/robot-design/round-yaw-v2/renders/review-02/07_yaw_right.png

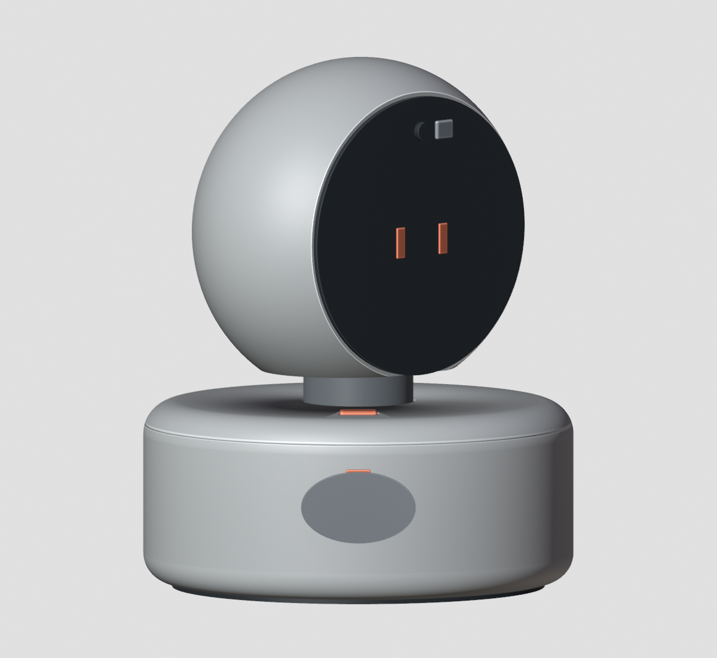
hardware/robot-design/round-yaw-v2/renders/review-02/07_yaw_right.png
