eleanor-wsyy/EffMeet2/hardware/robot-design/round-yaw-v2/renders/v3_layoutA_side.png

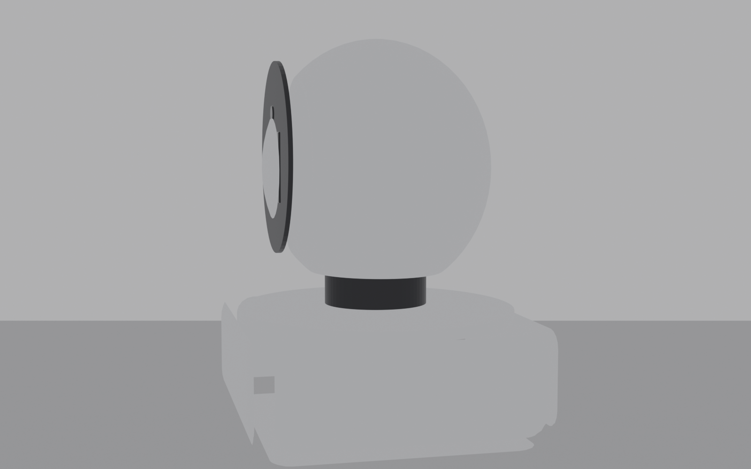
hardware/robot-design/round-yaw-v2/renders/v3_layoutA_side.png
