eleanor-wsyy/EffMeet2/hardware/robot-design/round-yaw-v2/revision-20261011-nomi-layoutA/drawings/01_主视觉_CMF.png

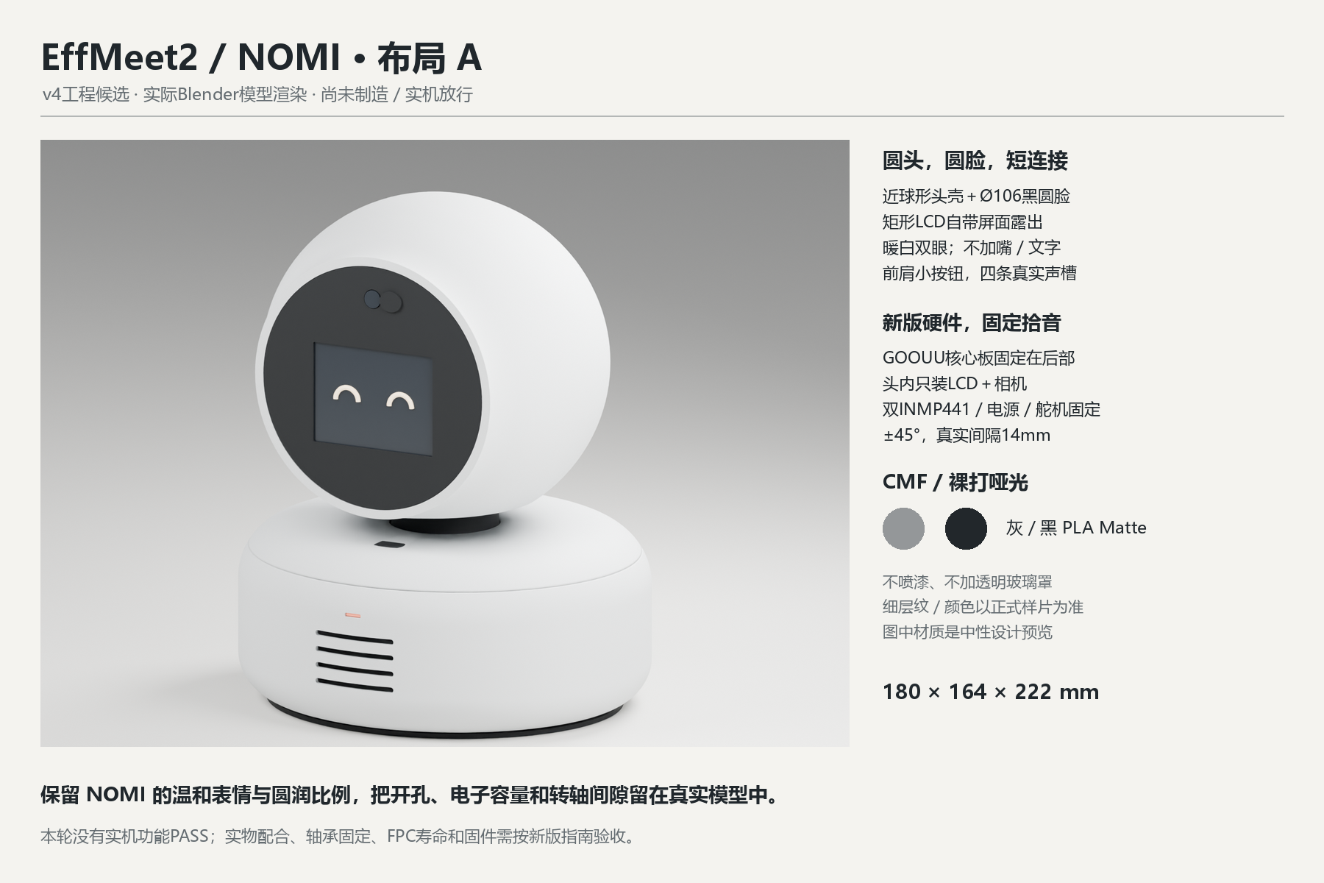
hardware/robot-design/round-yaw-v2/revision-20261011-nomi-layoutA/drawings/01_主视觉_CMF.png
