eleanor-wsyy/EffMeet2/hardware/robot-design/round-yaw-v2/revision-20261011-nomi-layoutA/drawings/02_三视图_名义尺寸.png

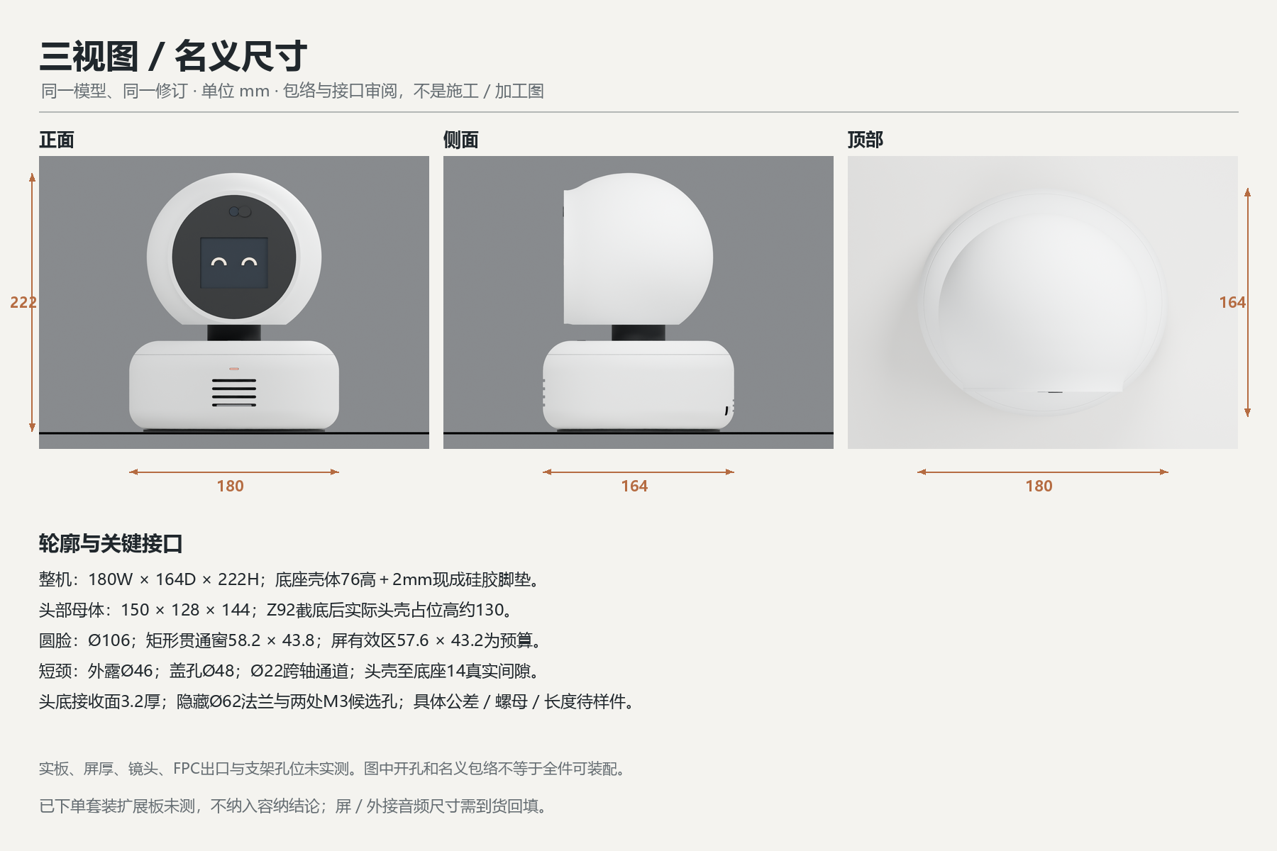
hardware/robot-design/round-yaw-v2/revision-20261011-nomi-layoutA/drawings/02_三视图_名义尺寸.png
