eleanor-wsyy/EffMeet2/hardware/robot-design/round-yaw-v2/revision-20261011-nomi-layoutA/drawings/03_分解与内舱布局.png

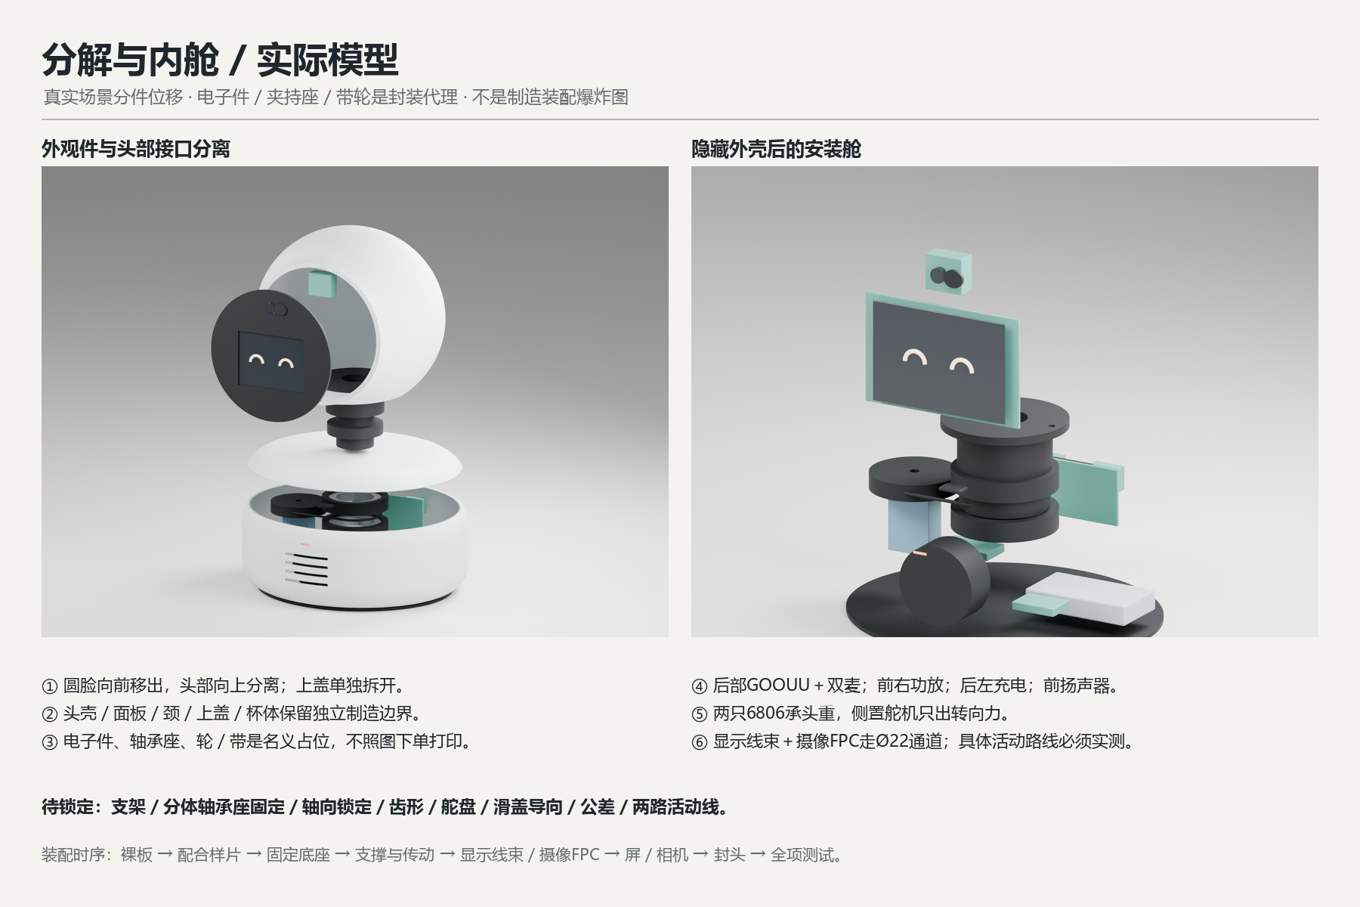
hardware/robot-design/round-yaw-v2/revision-20261011-nomi-layoutA/drawings/03_分解与内舱布局.png
