eleanor-wsyy/EffMeet2/hardware/robot-design/round-yaw-v2/revision-20261011-nomi-layoutA/renders/review-05/01_hero.png

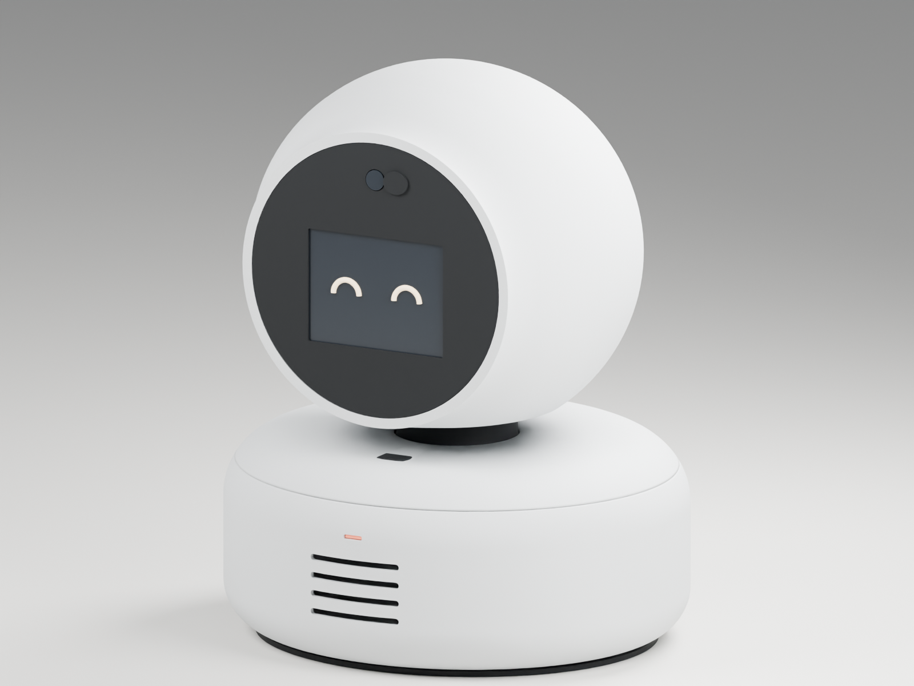
hardware/robot-design/round-yaw-v2/revision-20261011-nomi-layoutA/renders/review-05/01_hero.png
