eleanor-wsyy/EffMeet2/hardware/robot-design/round-yaw-v2/revision-20261011-nomi-layoutA/renders/review-05/04_top.png

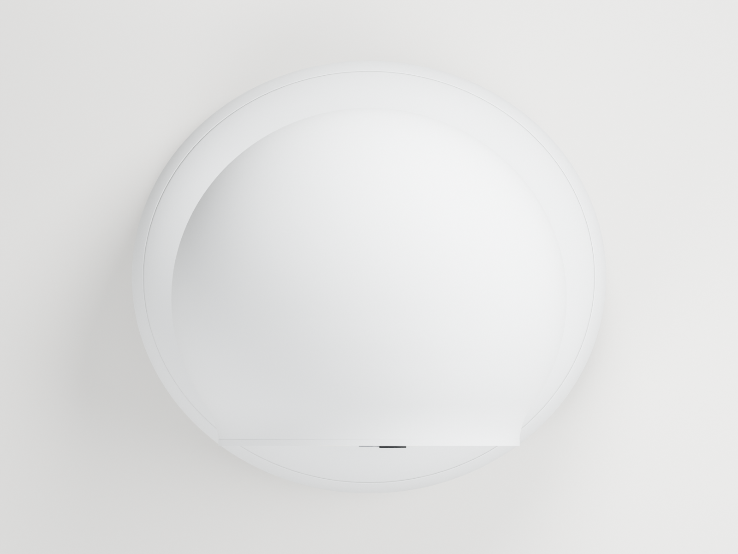
hardware/robot-design/round-yaw-v2/revision-20261011-nomi-layoutA/renders/review-05/04_top.png
