eleanor-wsyy/EffMeet2/site/assets/img/ai-demo.png

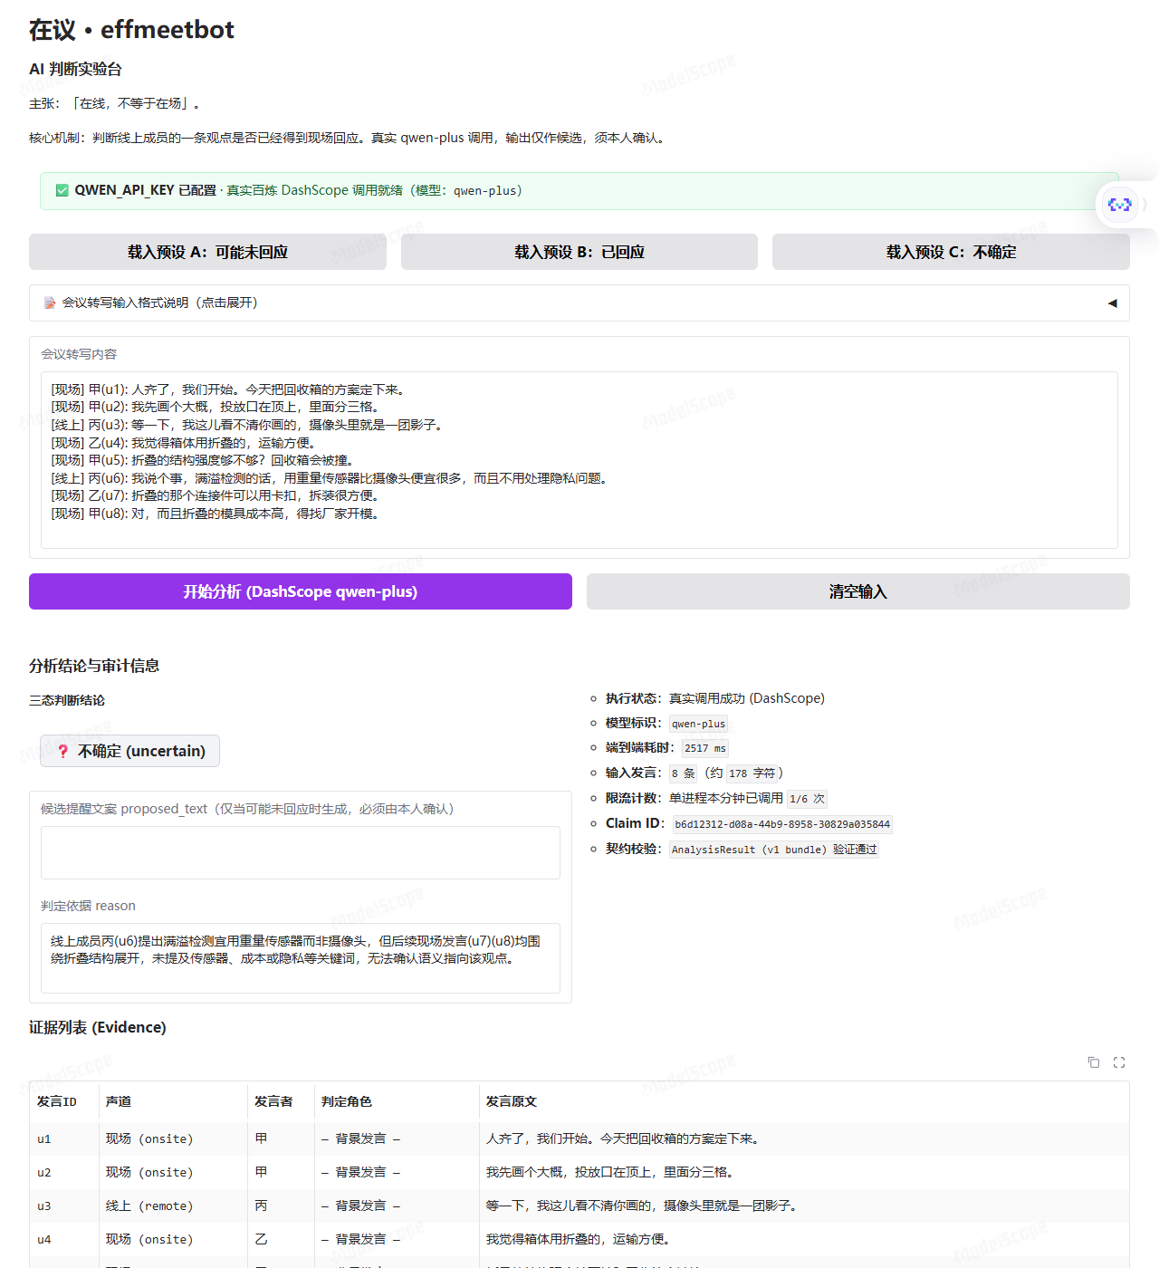
site/assets/img/ai-demo.png
