eleanor-wsyy/EffMeet2/site/assets/img/front.png

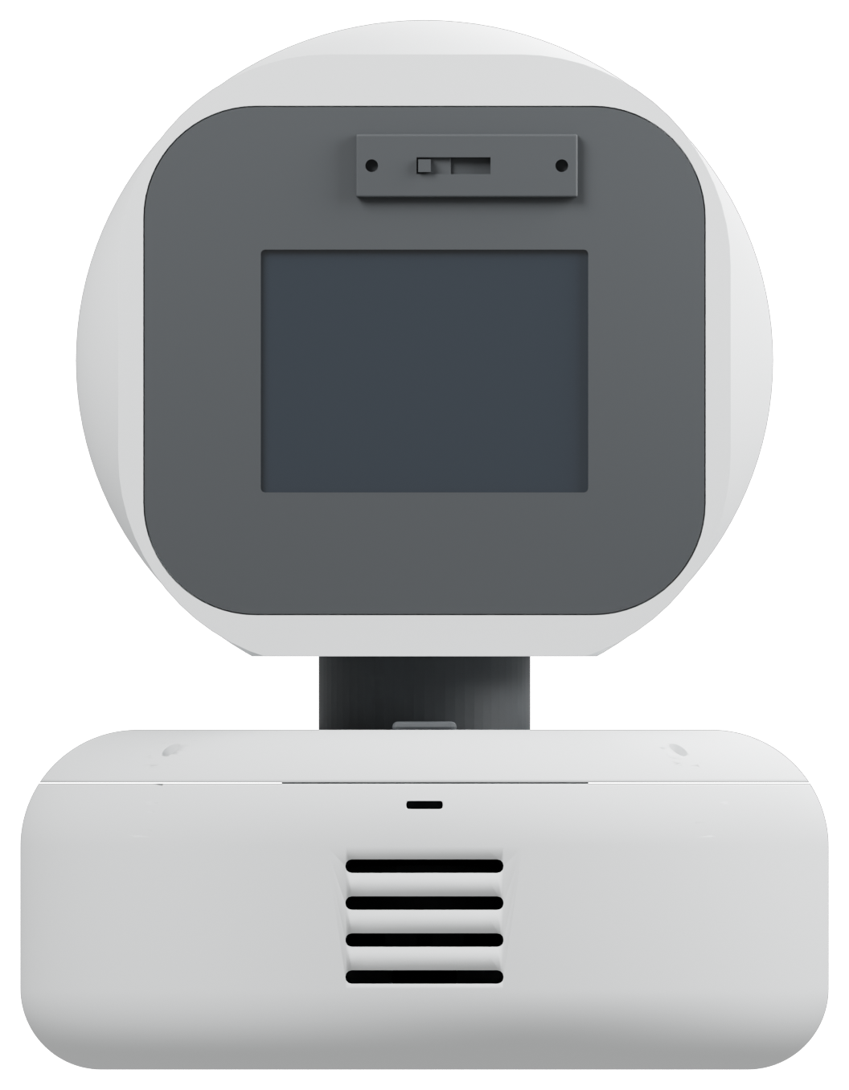
site/assets/img/front.png
