eleanor-wsyy/EffMeet2/site/assets/img/hero.png

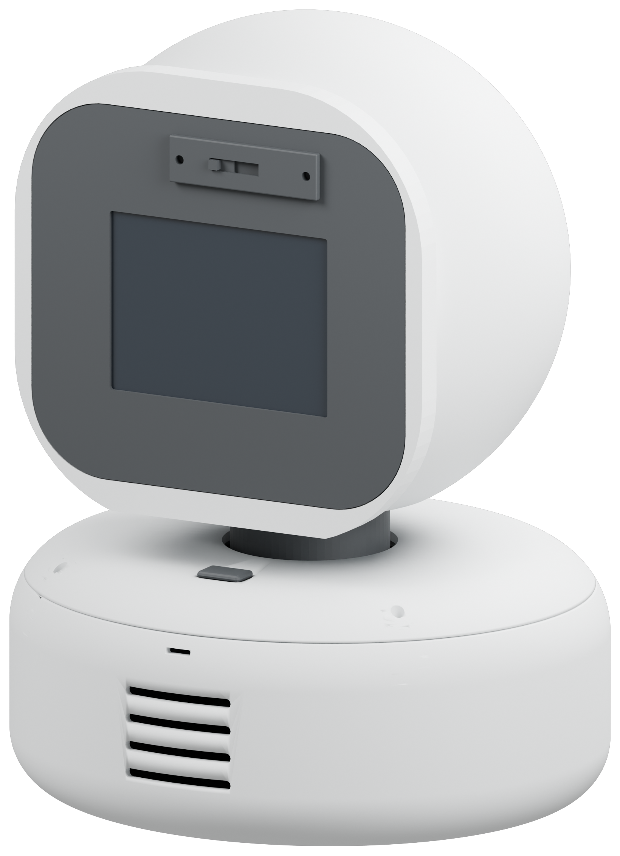
site/assets/img/hero.png
