eleanor-wsyy/EffMeet2/site/assets/img/internal.png

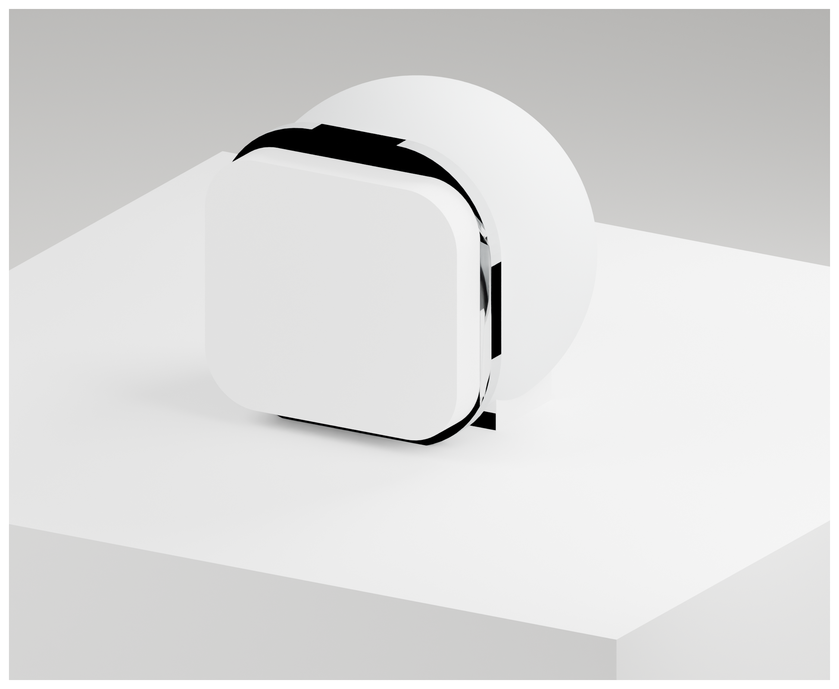
site/assets/img/internal.png
