eleanor-wsyy/EffMeet2/site/assets/img/og-cover.png

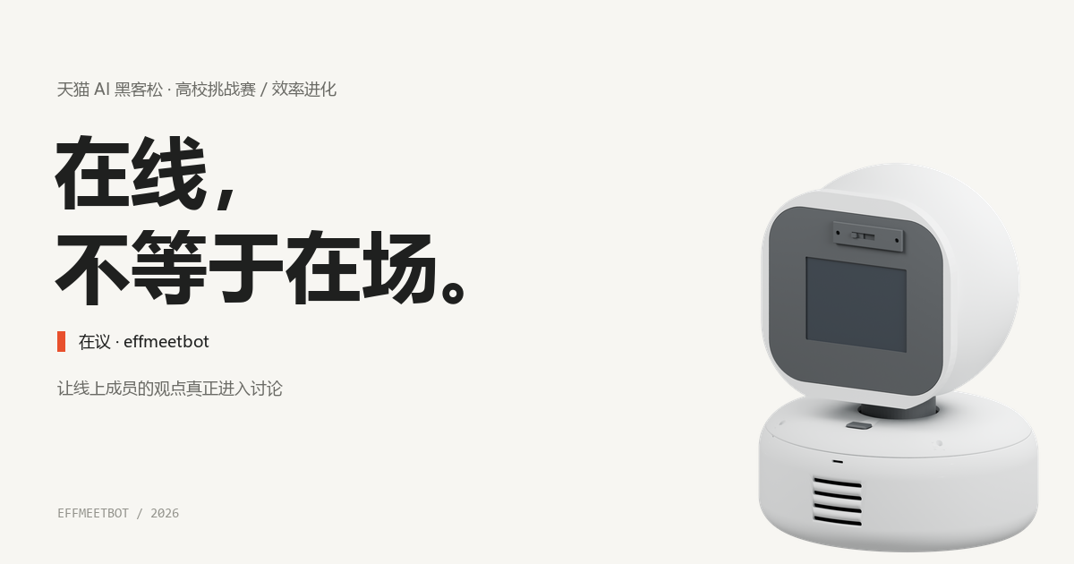
site/assets/img/og-cover.png
