eleanor-wsyy/EffMeet2/site/assets/img/screens/screen-confirm.png

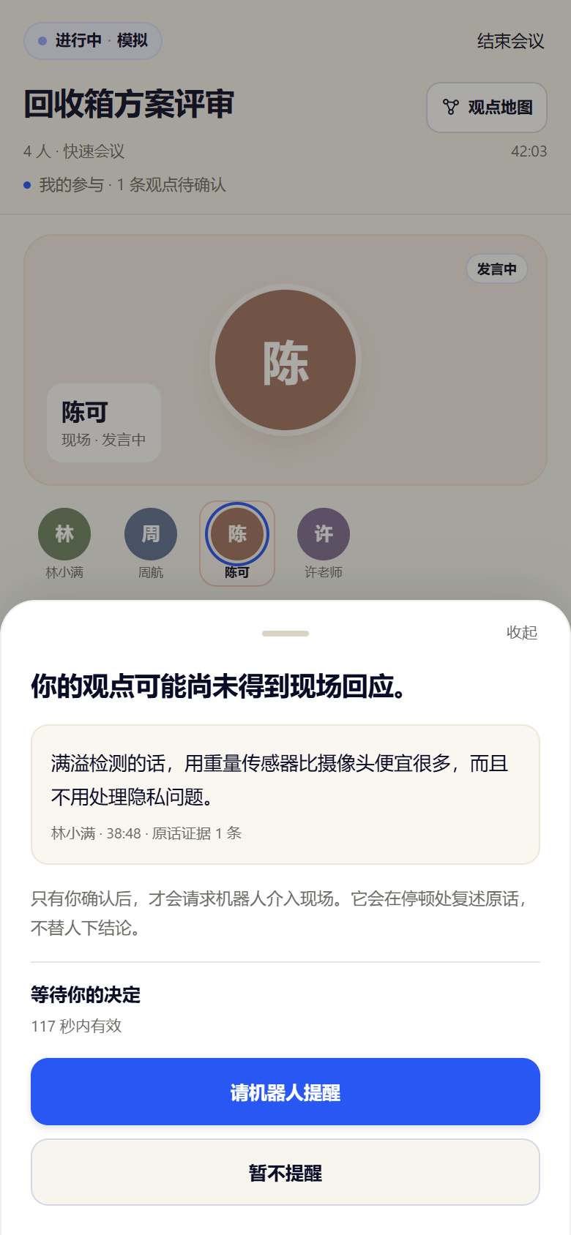
site/assets/img/screens/screen-confirm.png
