eleanor-wsyy/EffMeet2/site/assets/img/screens/screen-live.png

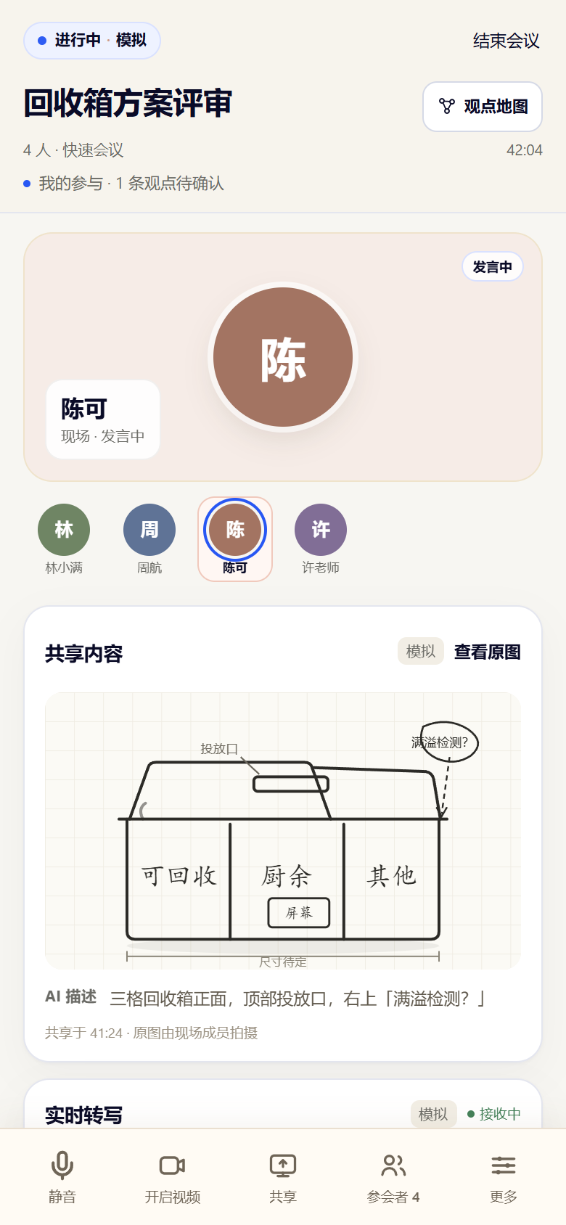
site/assets/img/screens/screen-live.png
