eleanor-wsyy/EffMeet2/site/assets/img/screens/screen-map.png

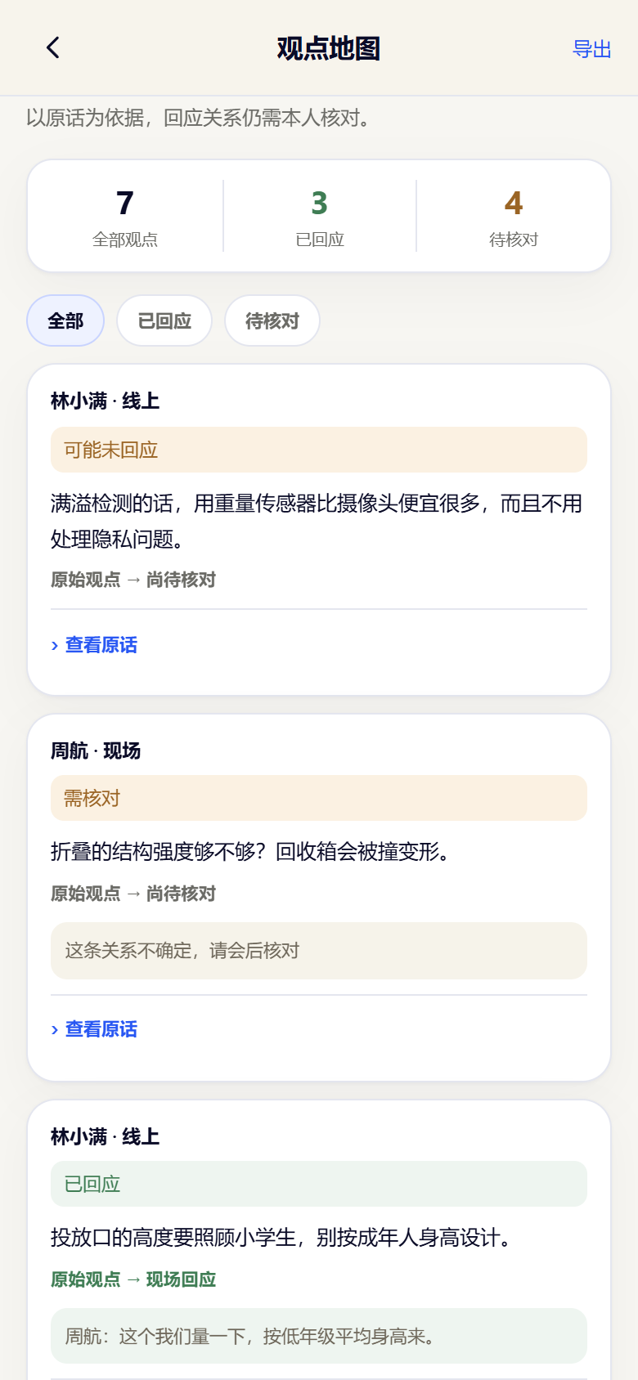
site/assets/img/screens/screen-map.png
