eleanor-wsyy/EffMeet2/site/assets/img/side.png

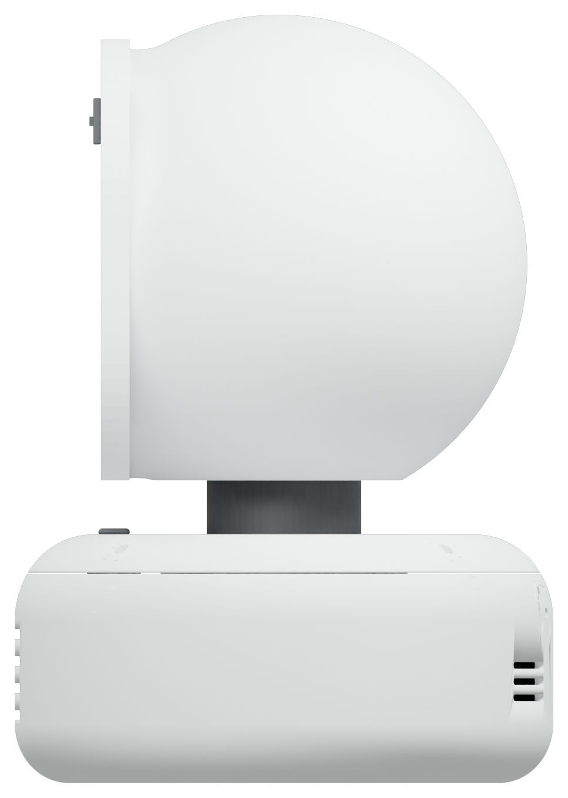
site/assets/img/side.png
