eleanor-wsyy/EffMeet2/site/assets/img/top.png

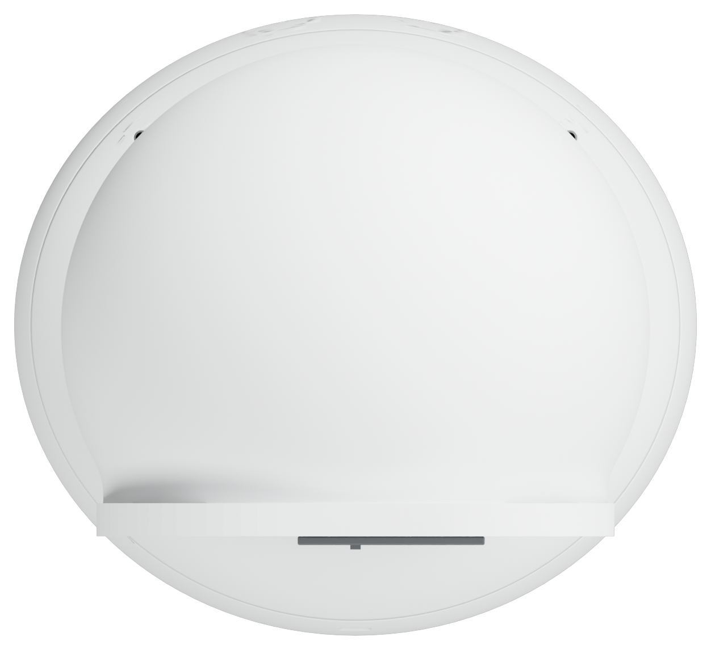
site/assets/img/top.png
