eleanor-wsyy/EffMeet2/site/demo/assets/robot-smile.webp

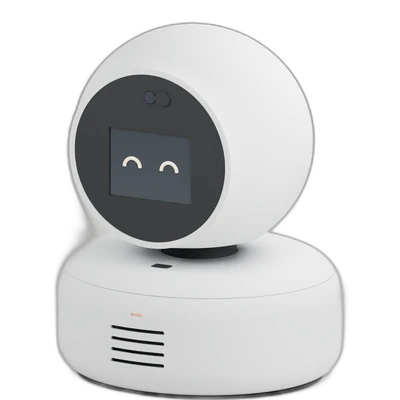
site/demo/assets/robot-smile.webp
