eleanor-wsyy/EffMeet2/docs/handoff/2026-10-10-robot-design-and-bom.md

# 2026-10-10 · 圆润转头版建模与采购交接入口

本次完整交接正文统一在[hardware/robot-design/HANDOFF.md](../../hardware/robot-design/HANDOFF.md)，不在这里复制维护。**2026-10-13：当前版本为 [v6紧凑候选·布局A2](../../hardware/robot-design/round-yaw-v2/revision-20261011-nomi-layoutA/print-split-v6/README.md)，本页其余入口仍有效。**

1. [统一目录README](../../hardware/robot-design/README.md)：当前版本、文件优先级与历史边界。
2. [本次HANDOFF](../../hardware/robot-design/HANDOFF.md)：具体更新、已检查范围、未完成项与协作接口。
3. [当前BOM](../../hardware/robot-design/round-yaw-v2/BOM.md)：30项采购建议与暂缓下单项。
4. [模型说明](../../hardware/robot-design/round-yaw-v2/README.md)：原生.blend、审阅图及参数证据。

**状态：可逆封装布局，未最终定稿、未打印放行、未实机转头验收。** 本次未修改业务/网关/前端/固件功能，不覆盖其他成员的软件交接。
