eleanor-wsyy/EffMeet2/docs/handoff/2026-10-05-hardware-purchase-list.md

# 硬件采购清单（历史入口已迁移）

2026-10-10整理：所有建模和采购正文已集中到hardware/robot-design。

- [当前圆润转头版BOM](../../hardware/robot-design/round-yaw-v2/BOM.md)：现阶段采购唯一维护入口。
- [2026-10-05原始通用清单](../../hardware/robot-design/archive/procurement/2026-10-05-hardware-purchase-list.md)：原文归档，保持可追溯。
- [本次交接](../../hardware/robot-design/HANDOFF.md)：未定型项、验证边界及下一步。

此页仅保持旧链接可用，不维护第二份物料表。
