eleanor-wsyy/EffMeet2/hardware/robot-design/round-yaw-v2/BOM.md

# 在议 圆润转头版 · 硬件采购清单 v2

> **当前v4以GOOUU已下单套装＋布局A为基线。** 第3–11节保留历史；采购只用第12节，实际模型／接口见[v4](revision-20261011-nomi-layoutA/README.md)。微雪／Korvo不能作当前选型。

更新：2026-10-10（北京时间）

> **当前选型优先读[第12节最终采购决策](#final-purchase-decision)与[打印方案](PRINT_PLAN.md)。** 第11节材料建议为此前讨论记录，PLA Matte 裸打＋全部打印件统一同料的最新取舍以第12节为准。最终采购规格不等于制造放行。
对应设计：圆润球面头部＋短颈转台＋固定鹅卵石底座。
对应模型：`hardware/robot-design/round-yaw-v2/EffMeet2_圆润转头版_封装布局_v2.blend`。

本清单承接用户提供的《EffMeet2-硬件采购清单-分享版.md》，保留 Korvo-2、OV2640、SG90 的原型路线，补齐显示、承重转台、传动、活动线束和声学配套。原文件和上一版席位牌清单保留不改。没有下单、未锁定商家或商品价格；“搜索关键词”不是已核验商品。已有器件先盘点，不重复购买。

## 最新外观与装配接口补充

用户要求参考NOMI的球头/圆脸，同时保持本BOM的核心方案：C02按近圆黑打印面板＋中部真矩形LCD窗整合，C01头壳/短颈修正接收与内藏轮廓；**不新增圆屏、玻璃罩、电机或后处理工艺**。物料ID、功能、数量及核心选型不变。接口与安装更新见[EXTERIOR_ASSEMBLY_REVISION.md](EXTERIOR_ASSEMBLY_REVISION.md)，实际孔位/尺寸待CAD和实物核准，旧草模验证不覆盖新面板。

## 1. 这份清单对应的结构

| 部位 | 外观/封装目标 | 放置的器件 | 当前边界 |
|---|---|---|---|
| 转动头部 | 椭球头壳约150宽×128深×144高 mm，底部截平；黑色椭圆面罩 | 2.4英寸矩形LCD及扩展板、摄像头、隐私滑盖 | 黑面罩隐藏矩形屏边框，不采购定制圆屏；不是NOMI零件复刻 |
| 短颈 | 外径46 mm，中央线孔22 mm；底座盖孔48 mm | 转轴连接件、活动线束 | 均为设计预留尺寸，尚未锁定轴承、连接件和FPC折弯半径 |
| 固定底座 | 外包络180宽×164深×76高 mm，外加2 mm脚垫 | 主板、舵机、独立轴承、前向扬声器、按钮、状态灯 | 主板平放下层；驱动及轴承位于上层；电源线从固定底座引出 |
| 整机 | 名义总高约222 mm | 单轴左右转头 | 原型目标左右各45°，不包含俯仰、轮式行走或连续360° |

**核心装配原则：头部重量由独立支撑轴承承担，SG90只提供转向驱动力。** 当前是偏置舵机＋中央空心转台的机构提案；传动比、支架、轴承座和头部连接盘尚未定型。Blender转头姿态不能替代实物负载试验。

## 2. 本次复核修正

1. 官方可核验的LCD文档及PCB图为 **Korvo-2-LCD V1.0**，PCB板形79.4×58.4 mm。上一版写成V1.1，且所列V1.1 PDF链接无法访问，本版不继续把该版本当已核实采购依据。若商家提供V1.1或其他版本，应取得其实际图纸再核对；不据此判断该版本绝不存在。[S2][S3]
2. 摄像头暂按**连接Korvo-2主板的Camera Connector**规划。撤回上一版未经充分核验的“主板18pin／LCD板14pin摄像接口”对比；引脚表中的信号数量、连接器触点数和焊接固定脚不能混为一谈。下单以实际板卡原理图、连接器型号和摄像头定义为准。[S1][S4]
3. 扬声器采用 **4Ω／3W候选**，是本项目的采购筛选条件；这次查到的本板官方指南说明NS4150为3W功放，但未找到其明确“禁止8Ω”的表述，因此不沿用上一版这一官方归因。最终阻抗及额定功率须由实板资料、供应商及播放测试确认。[S1]

## 3. 电子件：先核对套装，再补缺

“可先采购”仍需完成该行的下单前核验。数量指一台原型，库存可用时补购量为0。

| ID | 物品 | 数量 | 安装位置 | 建议规格/筛选条件 | 搜索关键词 | 采购状态与下单前核验 |
|---|---|---:|---|---|---|---|
| E01 | ESP32-S3-Korvo-2 V3.1主板 | 1块 | 底座下层 | 原版板形115×80 mm；沿用板载双麦、ES7210/ES8311和NS4150，不默认另买音频板 | 乐鑫 ESP32-S3-Korvo-2 V3.1 开发板 | 可先采购/复用；核对版本丝印、正反面照片、完整板高、USB/开关位置及安装孔。[S1][S5] |
| E02 | Korvo-2配套LCD扩展板＋2.4英寸屏套装 | 1套 | 头部 | 优先官方可核验V1.0基线，320×240 SPI显示；PCB79.4×58.4 mm；含屏而非仅裸板 | ESP32-S3-KORVO-2-LCD 2.4寸 配套 LCD | 套装确认后采购；要求明确与E01兼容，含配套连接线、显示驱动说明、屏总厚度；不直接替换任意2.4寸SPI屏。[S2][S3] |
| E03 | 配套OV2640摄像头 | 1个 | 头部面罩上方 | 候选本体≤20×10×18 mm，预留24×16×20 mm；必须匹配主板摄像接口及现有固件 | Korvo-2 OV2640 配套 摄像头 尺寸图 | 接口确认后采购；“OV2640”芯片名不能证明排线兼容；核对镜头突出、视场、针脚、电源、接触方向。[S1][S4] |
| E04 | LCD跨转轴FPC/柔性线束 | 1套 | 底座→短颈→头部 | 先按E01/E02实际连接器匹配；沿轴线进入并留受控活动圈，避免夹入轴承 | Korvo-2 LCD 配套 FPC 动态弯折 排线 | **确认连接器与实际路线后再买**；不固定未经核验的针数或长度；先复用原配线测量，原配静态排线不自动满足反复转动寿命 |
| E05 | 摄像头跨转轴FPC/配套延长组件 | 1套或并入E03 | 底座→头部 | 不允许只靠“同针数”选择通用延长线；需要完整针脚一致与信号测试 | OV2640 原板配套 FPC 延长 连接器 | **暂缓定长采购**；加长后检查画面、花屏、丢帧及转动时接触；若厂家不支持该长度，先改布局，不强接 |
| E06 | 小型扬声器 | 1只 | 底座前部 | 4Ω、额定3W候选；外径≤40 mm、总深度≤18 mm；含磁钢、焊片和线头 | 4欧 3W 40mm 小型扬声器 尺寸图 | 与实板功放匹配后采购；模型预留44×24×44 mm；确认接头及极性。不默认外加PAM功放 |
| E07 | **Type-C**数据线 | 1条 | 底座调试接口 | 可传数据；兼顾插头/弯线空间 | Type-C 数据线 可传数据 | GOOUU 板为 Type-C，Micro-USB 作废。[S1] |
| E08 | 主板**Type-C**供电线 | 1条 | 底座固定电源入口 | 按供电口、线长和电流要求选择；可与现有电源线合并 | Type-C 供电线 低压降 | GOOUU 板为 Type-C；不让外部电源线跟头部旋转；避免插头受壳体侧向顶压 |
| E09 | 主板电源 | 1个 | 外置 | 5V、至少2A，正规合规适配器；外置充电宝可替代，不重复买 | 5V 2A USB 电源适配器 | 可先采购/复用；这里是主板官方基线，不代表还能同时承担舵机峰值。[S1] |
| E10 | 舵机独立稳压电源及受保护引出线 | 1套 | 电源外置、分配线在底座 | 电压按实际SG90允许范围；先以4.8–5V台架测试，容量按启动/堵转峰值留余量 | 5V 稳压 电源 舵机 配线 保护 | 核实实际舵机额定范围后采购；信号共地，勿由ESP32的3.3V供电；不直接并联两路5V正极。[S6] |
| E11 | 停止/静音轻触开关＋连接线 | 1套 | 固定底座上前侧 | 小尺寸开关，外观按钮位置约16×10 mm；逻辑电平、去抖由固件组确认 | 小型 轻触开关 按键 连接线 | 可先买开关样品；优先核查板载MUTE键是否能合理引出。GPIO按键只代表软件停止/静音，未设计独立电路前不得标为“硬件断麦” |
| E12 | 小型状态LED＋限流/驱动件 | 1套 | 底座前侧短状态窗 | 小灯珠或小板，按GPIO负载选择；外观窗约10×2 mm | 小型 LED 指示灯 限流 电阻 | 核GPIO后采购；板载系统灯可引光时优先复用；不需要RGB环形灯带 |
| E13 | 舵机控制信号引出/外置PWM驱动（条件项） | 1路或1块 | 底座 | 优先核实主板上真正可引出的空闲GPIO及外设资源；无合适输出时再评估兼容驱动扩展 | 由固件组确定，不预先指定PCA9685等型号 | **信号方案未定，暂缓采购**；屏幕、摄像、音频已占大量引脚，不能随意接GPIO2或复用I²C扩展口当PWM。若新增驱动板，当前模型尚无对应预留，必须重排 |

## 4. 转头机构：这版外观新增的重点

| ID | 物品 | 数量 | 本版空间/功能要求 | 搜索关键词 | 采购状态 |
|---|---|---:|---|---|---|
| M01 | SG90位置舵机（原型） | 1只 | 官方本体23×12.2×29 mm；含舵盘/固定耳/线束预留35×25×44 mm；位于底座左侧 | TowerPro SG90 正品 位置舵机 尺寸图 | 原有可复用，否则先买1只台架测试。厂家页面说明普通舵机范围未必180°，不要仅凭标题承诺转角；±45°头部目标需结合传动比校准。不要买“360连续旋转版”代替位置控制。[S6] |
| M02 | 独立支撑轴承/小型空心转台组件 | 1套 | 当前**整套占位外径≤56 mm、高≤18 mm**；需要承载头部、可固定、中央允许活动线束通过 | 小型 空心 转台 轴承 支撑 尺寸图 | **暂缓型号下单**。Ø56×18是模型预留，不是现成标准件；先拿剖面图、内径、安装面及承载资料。内径需匹配最终走线，不能只买一个外径接近的裸轴承 |
| M03 | 舵机主动轮＋转台从动轮＋传动带/等效传动 | 1套 | 偏置舵机驱动中央转台，保留中间线孔；两轮、舵机花键连接、传动比和中心距成套确定 | 微型 舵机 同步带 传动轮 花键 连接盘 | **机构选型后采购或定制**；模型未证明标准带轮可直接装入。若改直连，必须重新解决空心走线与承重，不可删掉轴承后让舵机单独托头 |
| M04 | 舵机固定架、轴承座、头部连接盘 | 各1件 | 将载荷传到底座；建立可拆装接口、安装孔和防松方式 | SG90 固定支架 小型 舵机 座 | 定制为主；尺寸从实物舵盘、轴承和壳体导出。模型里未完成这些可生产接口，不能照概念图购买通用云台就默认适配 |
| M05 | 机械限位件 | 2处 | 限制左右极限，避开线束夹点；实际硬限位留在固件软限位之外 | 随外壳/连接盘定制 | 机构设计阶段制作。当前±45°为软件/试验目标；限位角、冲击与夹线安全须实测 |
| M06 | 零位检测开关或霍尔＋磁铁 | 0或1套 | 仅在重复回零/机构误差确有需要时加，预留安装与GPIO | 小型 霍尔 位置检测 传感器 | 条件采购；不是默认必需，不把舵机命令角当作实际头角测量 |
| M07 | 应力释放线夹、柔性护套 | 1套 | FPC/电线在固定端和转动端均固定，活动段不磨轴承、不碰皮带 | 小型 排线 固定夹 柔性 护套 | 路线确定后购买；与E04/E05一起验证，勿以热熔胶把活动弯折区粘死 |
| M08 | 可锁接插件、短线、绝缘件 | 少量 | 与实际板卡/器件端子相配；杜邦线仅用于台架 | 小型 接插件 端子 线束 热缩管 | 可备少量样品；不提前冻结未知JST型号或线径 |
| M09 | 安装柱、螺丝、垫片 | 少量 | 实测安装孔后选；可备M2.5/M3样品，定长螺钉待定 | M2.5 M3 尼龙柱 螺丝 小套装 | 不按占位网格批量买定长螺钉；防止穿板或顶到屏幕背面 |

**SG90只是当前低成本原型选择，不承诺达到NOMI的运动噪声和顺滑度。** 换MG90S、减速电机或无刷方案都要重新核对空间、供电、控制与传动；暂不默认加入采购。旋转头的重量、转动惯量、轴承摩擦、线束回弹、齿隙、保持抖动和录音底噪必须一起测试，不能只比较堵转扭矩。

## 5. 外壳、CMF与声学配套

| ID | 物品 | 数量 | 对应外观/功能 | 采购状态 |
|---|---|---:|---|---|
| C01 | 头壳、底座杯体与上盖 | 1套 | 哑光灰机身＋黑色细节（当前口径见 §12）；名义壁厚2.4 mm；分件可拆修 | 已开打（v5 拆件：头壳/杯体上机，上盖待排期）；正式 CAD 未放行，接口按实测回填 |
| C02 | 黑色面罩/屏窗 | 1件 | 约123×117 mm椭圆覆盖范围，隐藏矩形LCD边框 | **已取消整片透明屏窗**（当前口径见 §12）：黑框打印件，屏面直接露出；正式曲率、窗口尺寸与固定方法待定。不能把不透光黑板挡在显示区 |
| C03 | 摄像头物理滑盖 | 1套 | 面罩上部镜头独立滑盖，带滑槽/挡位 | 与壳体定制；验证完全遮挡、不碰镜片、不开口漏光；概念图不等于现成结构 |
| C04 | 按钮帽、LED导光窗 | 各1件 | 固定底座上前按钮；状态灯先按直接出光小孔（发光色暖珊瑚，非喷漆） | 按钮帽随 v5 黑料打印；导光件先 0，LED 过亮再加薄扩散件 |
| C05 | 扬声器密封垫及声腔试装材料 | 少量 | 底座前向出声，与舵机/主板区域合理隔离 | 可备薄泡棉/硅胶样品；不碰振膜，密封后测试响度、共振与AEC |
| C06 | 麦克风声学通道/密封材料 | 1套 | **外接 2× INMP441 模块**固定底座；拾音孔按模块位置布置 | 先测裸模块拾音，再设计通道；不照抄概念图孔阵。麦克风不随头转，不能宣称通过转头实现指向性拾音 |
| C07 | 防滑硅胶脚垫 | 1套 | 当前足垫占位约156×140×2 mm，椭圆轮廓 | 可先买片材；按最终底面裁切，做转头极限时的防滑和倾覆试验 |
| C08 | 底座配重 | 0或1件 | 仅在实物稳定性试验需要时加入 | 条件采购；未预留专用配重空间/固定方案，不直接往壳内塞金属块 |

## 6. 模型预留核对表

坐标与预留来源在同目录模型的parameters.json。下面是**含安装/走线假设的预留盒，不是买到的实物尺寸**。

| 器件 | 预留W×D×H（mm） | 分区 | 布局说明 |
|---|---|---|---|
| Korvo主板 | 125×90×22 | 底座下层 | PCB平放；真实焊接总高、连接器和USB线仍需测量 |
| LCD扩展板/显示堆叠 | 89.4×20×68.4 | 头部前层 | 板面竖放；屏幕/支架/FPC占用厚度是假设 |
| 摄像头 | 24×16×20 | 头部上方 | 与LCD预留盒竖向间隔约1.8 mm，已包含各自预留，不可再任意放大模块 |
| SG90及安装预留 | 35×25×44 | 底座左上层 | 与主板预留盒竖向间隔约1 mm；支架和主动轮仍未实体化 |
| 中央支撑组件 | 56×56×18 | 底座中上层 | 圆柱组件按矩形盒保守核对；不是选定轴承尺寸图 |
| 扬声器 | 44×24×44 | 底座前部 | 与主板预留盒前后分开约1 mm，声腔/线头另须试装 |

这6项预留在当前生成腔体的解析检查中均可容纳，同舱预留盒彼此分离。它只证明这组假设存在一套空间布局；没有验证排线、传动带、实际安装柱和声腔。±45°姿态检查只覆盖刚性头壳与底座的几何间隙；不证明线束寿命、舵机带载或传动可靠。

## 7. 固件与接口前置条件

仓库firmware/esp32目前只有README骨架，文件明确标注“待实现”；当前演示音频走电脑伴侣应用。本次未新增舵机、显示或摄像驱动，也未确认可直接连接舵机的引脚。转头实机联调必须先落实：可引出的控制信号、舵机供电与共地、角度标定、软件限位、异常回中/停止策略。不要把模型时间轴当作已经实现的机器人控制功能。

## 8. 第一批真正下单的范围

1. 盘点现有Korvo板、摄像头、SG90、电源及线材；先索取板卡照片和配件明细。
2. 确认后补齐 **E01主板、E02屏套装、E03配套摄像头、E06扬声器、E07–E10电源/线材、M01舵机**。按钮、指示灯和连接件先少量样品。
3. **E04/E05跨轴排线、M02轴承、M03传动、M04连接架、正式外壳暂缓下单**，先取得机械图和连接器定义；这不是可以删掉的零件，而是会决定结构尺寸的待定项。
4. 裸板跑通显示＋摄像＋录音播放，测转头空载；再做与实际头部质量/惯量相近的负载台架。
5. 最短可用线束先验证，延长后的线束需重复检查画面、显示、触摸及转动过程中的稳定性；相机帧率、显示时钟和线长不能独立承诺。
6. 完成承重、限位、夹线、供电、声学和接口后再打印最终壳体；当前模型不是打印放行CAD。

## 9. 发给商家的核验问题

- 请提供主板和LCD板版本丝印、PCB尺寸图、装配后总高、安装孔和全部连接器型号。
- 显示套装是否包含屏、触摸、背光连接和主板连接排线？是否明确支持Korvo-2 V3.1？
- 摄像头接主板哪个连接器？请提供从连接器编号到摄像头引脚的完整映射及供电要求，不能只答“OV2640通用”。
- 排线触点数、间距、厚度、同面/异面接触、长度和动态弯折寿命各是多少？是否有该长度的显示/摄像稳定性测试？
- 轴承/转台组件的外径、总高、内孔、承载方向、固定面、安装孔和启动摩擦数据是什么？
- 舵机是位置控制还是连续旋转？供电范围、完整尺寸、舵盘花键、转角范围及峰值电流是多少？
- 扬声器总尺寸是否包含磁钢、焊片、线头？阻抗/额定功率、端子和极性是否与实际板卡匹配？

## 10. 每项部件的具体功能、直接效果与最终验收目标

本节逐项对应E01–E13、M01–M09、C01–C08，共30项，不新增物料或改变原有采购状态。

- **具体功能**：部件本身做什么，接收什么/输出什么，负责哪段电气、机械或声学链路。
- **直接效果**：装入并正确驱动/装配后，用户或工程师实际能观察到什么。
- **最终目标/验收**：整机需要实现的可检查结果，**均是待达成目标，不是现阶段已经通过的结论**。具体误差、速度、寿命和声学阈值应在实物选型后冻结。
- “功能必需”不等于每项都要额外下单；套装已含/库存可用时不重复购买。外置PWM板、零位传感器和配重仍是条件项。

### 10.1 电子、显示、采集、供电与控制

#### E01 ESP32-S3-Korvo-2 V3.1主板

**性质：核心必需，优先复用。**

- **具体功能：**作为机内主控，管理板载双麦/音频链路、显示、摄像及Wi-Fi通信，并在固件支持后接收外部控制命令、驱动状态输出。[S1]
- **直接效果：**把现场声音和图像送往处理端，把处理端下发的音频/状态变成机内播放和显示；是外设协作的控制中心，不是单独完成会议理解的大模型电脑。
- **最终目标/验收：**装机后音频采集、播放、联网、显示和摄像可按约定协同运行，记录真实设备状态及错误；转头或播放时不因供电/资源冲突重启。路线A的ASR和观点分析仍由电脑伴侣/服务承担，不能把主板联网说成已实现独立云端机器人。

主板内的部件也各有分工，以下已经集成在E01内，**不是新增采购项**：[S1]

| 板载部件 | 具体功能 | 对整机效果的贡献 |
|---|---|---|
| 双麦克风 | 把声音转换为电信号 | 提供现场人声输入；不自动给出说话人身份 |
| ES7210 | 音频模数转换，并采集板级回声参考 | 给后续录音/音频前处理提供数字输入 |
| ES8311 | 音频编解码，播放链路含数模转换 | 将数字音频送入模拟播放链路 |
| NS4150 | 音频功率放大 | 驱动外接扬声器出声 |
| ESP32-S3及Wi-Fi | 执行固件、控制外设并通信 | 连接电脑/服务与机器人输入输出 |

板级回声参考只是AEC链路基础；消回声算法配置、延迟及双讲效果仍须实机验证。

#### E02 LCD扩展板＋2.4英寸屏套装

**性质：本版表情/状态显示必需。**

- **具体功能：**把主板输出的图形显示在头部；官方配套是矩形SPI LCD，扩展板还包含触摸连接能力，本项目不默认启用触摸交互。[S2]
- **直接效果：**显示暖白色眼睛和简短状态，使人能看出连接、等待、拍摄或播报等实际阶段；不承担手机端完整观点地图。
- **最终目标/验收：**开机、联网失败、等待本人确认、播报和停止等状态与真实设备事件一致；隔着最终面罩仍清楚可见，转头过程中不花屏/复位。不凭动效假装已经识别到发言者。

#### E03 配套OV2640摄像头

**性质：现场材料抓拍必需，接口待确认。**

- **具体功能：**将镜头视场内的材料采集为图像；帧获取、格式和传输由选定驱动/固件配置，OV2640属于乐鑫官方摄像驱动支持的传感器。[S7]
- **直接效果：**为现场纸张或白板共享提供原始图片；摄像头本身不理解文字、不生成会议结论，也不等于自动追踪某个人。
- **最终目标/验收：**在材料进入视场、光照与拍摄距离合适时，完成用户请求的抓拍并交由软件确认/共享，远端能打开实际原图。水平转头不等于可以俯拍整张桌面纸张；需要明确摆放或取景动作。

#### E04 LCD跨转轴FPC/柔性线束

**性质：电气连接必需，原配满足则不另买。**

- **具体功能：**在固定主板与转动头部LCD之间传递所需电源、地和显示/控制信号，具体接法依实际套装连接器定义。[S2]
- **直接效果：**主板留在底座时，头部仍可显示；活动段随左右转动弯折，避免一根绷紧的排线牵制头部。
- **最终目标/验收：**在左45°、正向、右45°及转动过程中显示稳定，活动线不拉插座、不磨轴承、不进传动夹点；动态弯折寿命及长度经选线后试验，静态原配线不自动视为合格。

#### E05 摄像头跨转轴FPC/配套延长组件

**性质：电气连接必需，延长件按实际路线补缺。**

- **具体功能：**在头部摄像头与底座主板之间传输成像所需信号/电源；是否需要延长、接触方向和针脚以实际模块为准。
- **直接效果：**摄像头随头转动取景，主板不必随之转动；布线正确时可保持图像链路连通。
- **最终目标/验收：**三个目标姿态和转动过程都能按测试配置获取有效画面，不因线长、接触或弯折出现花屏/断帧；若加长不稳定，改变路线或布局，不把通用延长线强行接入。

#### E06 小型扬声器

**性质：现场音频输出必需。**

- **具体功能：**把主板功放驱动的电信号转为可听声音，播放软件提供的TTS或约定音频；它不负责生成语音内容。
- **直接效果：**现场成员能听到经过本人确认的线上观点提醒或必要反馈，声音从固定底座前部发出。
- **最终目标/验收：**按实际会议桌距离校验语句可懂、音量适当、无明显削波/箱体共振；未确认观点不触发提醒，停止命令能终止播放。扬声器、声腔、音量和AEC须联合测试，不能由“3W”推断会议室覆盖范围。

#### E07 Type-C数据线

**性质：开发调试必需，不一定常驻整机。**

- **具体功能：**连接电脑与板卡USB-UART调试接口，用于烧录、串口通信和读取诊断日志；充电-only线不能完成此任务。[S1]
- **直接效果：**开发者能刷入固件、观察启动错误、排查摄像/音频/转头问题。
- **最终目标/验收：**板卡可被识别、固件可重复烧录、日志可稳定读取；壳体保留可维护访问方式，成品正常联网使用不必一直拖着调试电脑线。

#### E08 主板Type-C供电线

**性质：供电通路必需，可复用已有线。**

- **具体功能：**把外置适配器的电能送入主板供电口，同时满足电流、插头方向及壳内弯线空间要求。
- **直接效果：**给固定底座电子系统持续供电；线从底座引出，不随头部转动。
- **最终目标/验收：**正常播放、显示、抓拍和联网组合负载下，板端供电符合实板要求，线材/插头无异常发热或松脱；转头不会卷外部电源线。它与数据线用途不同，即使外观相同也须分别验证。

#### E09 主板电源

**性质：能量来源必需，已有适配器/外置充电宝可复用。**

- **具体功能：**向主板供给受控直流电源；本板官方建议基线为5V、至少2A，不代表整机含舵机的总功率已经核算。[S1]
- **直接效果：**支持主板及其音视频外设稳定运行；外置供电避免当前壳体承担内置电池和充电结构。
- **最终目标/验收：**组合负载下主板持续运行，记录实际电流/压降并留合理余量；若用充电宝替代，验证低负载时不自动断电。供电中断应按真实状态处理，不能用灯一直亮来假装联网正常。

#### E10 舵机独立稳压电源及受保护引出线

**性质：舵机供电通路必需，供电实现待冻结。**

- **具体功能：**在实际舵机额定电压范围内提供驱动电能及合适保护，避免将舵机动力负载直接压在主板小电流逻辑输出上。[S6]
- **直接效果：**为启动和带载转头提供动力，并使主板与舵机的电流路径可以分别设计/检查；独立供电不自动保证消除所有电气噪声。
- **最终目标/验收：**受控启动、转向和保持测试时不引发主板复位、明显音频干扰或异常发热；核对共地、保护和电流预算。不把两路5V正极直接并联，不做长时间强制堵转。

#### E11 停止/静音轻触开关＋连接线

**性质：本版实体停止操作必需，可评估引出板载键。**

- **具体功能：**把用户按压转换为主板可读取的输入事件，固件据此执行已定义的停止/静音行为。
- **直接效果：**用户不用打开手机就能打断机器人播报，减少会议现场失控感。
- **最终目标/验收：**最小版本明确实现“停止当前播报”，消抖后一次有效按压对应一次处理，屏幕/状态灯与实际播放结果一致；待播队列和恢复规则另按协议冻结。没有独立断麦电路前，不承诺按下就切断麦克风硬件。

#### E12 状态LED＋限流/驱动件

**性质：状态提示功能必需，可复用板载灯引光。**

- **具体功能：**把设备实际状态转换为可见光；限流/驱动件按灯和GPIO能力匹配，不把GPIO当任意负载电源。
- **直接效果：**从侧面或远处也能发现设备是否连接、工作、停止或故障，无需一直盯屏幕。
- **最终目标/验收：**灯色/闪烁含义由团队定义并与真实事件一致，亮度不刺眼、不持续打扰会议；掉线和停止不能仍显示正常工作。不用炫彩环灯替代真实状态反馈。

#### E13 舵机控制信号引出/外置PWM驱动

**性质：控制通路必需，新增驱动板为条件项。**

- **具体功能：**提供与所选舵机匹配的控制波形，使固件指令能控制输出轴；优先使用真实可引出的空闲资源，必要时才增加扩展驱动。
- **直接效果：**把“转向某个目标位置”的软件意图变为舵机动作，是联网主板和机械转头之间的控制连接。
- **最终目标/验收：**确认引脚/外设不与显示、摄像及音频冲突，命令能稳定执行、重启和异常状态行为明确；新增驱动板时补做供电、空间和接线验证。波形正确不代表头部真实角度已经反馈。

### 10.2 转头、承重、传动与装配

#### M01 SG90位置舵机

**性质：原型驱动候选，先带载验证。**

- **具体功能：**把控制信号转换为输出轴的有限角度动作，为头部转向提供驱动力；本版使用位置舵机路线，不是连续旋转电机。[S6]
- **直接效果：**配合传动和支撑机构，让机器人头部向左/右改变朝向，呈现面向参与者的交流动作。
- **最终目标/验收：**真实头部载荷下能到达左45°、正向、右45°目标，保持时无不可接受的抖动/齿隙/噪声；实际误差和速度实测后冻结。头部角度取决于舵盘标定和传动比，不直接等于舵机命令角；SG90不保证达到NOMI的顺滑度。

#### M02 独立支撑轴承/空心转台组件

**性质：本机构承重支撑必需，SKU待定。**

- **具体功能：**给转动头部提供独立承载和旋转导向，并为中央活动线束保留通道，使载荷经结构传到底座。
- **直接效果：**头部能够绕确定的竖直轴转动，减少晃动和摩擦；避免由舵机输出轴单独承担整个头部的重量。
- **最终目标/验收：**按实物头部重量、偏心和载荷方向选型，装配后无明显卡滞/松旷，线束有足够通行空间；转台实际安装面、轴承座和连接盘形成完整受力链。不能用占位圆柱替代这些接口。

#### M03 主动轮＋从动轮＋传动带/等效传动

**性质：偏置驱动路线必需，类型和尺寸待定。**

- **具体功能：**把侧置舵机的输出传递给中央转台，并通过传动比建立两者的角度/力矩关系；当前尚未选定具体标准件。
- **直接效果：**舵机可以留在底座侧面，中央轴线给头部承重与走线使用。
- **最终目标/验收：**完成实际中心距、啮合/张紧、花键连接和间隙设计；运动时不打滑、跳齿或夹线，三个目标姿态可校准到达。齿隙、噪声和效率需实测，不把“同步带”名称直接当作静音保证。

#### M04 舵机固定架、轴承座、头部连接盘

**性质：装配与受力连接必需，以定制为主。**

- **具体功能：**分别固定驱动件、定位轴承、连接转台与头壳，把独立零件组成可装拆的机械结构。
- **直接效果：**舵机不会在壳内跟着扭动，转台轴线有定位，头壳不会只是悬在转轴上。
- **最终目标/验收：**转头时各安装件不松动/变形，载荷能经过连接盘、轴承座和底座支撑传递；螺钉可装入也可拆出，避免胶粘成为唯一定位。真实孔距、材料和紧固方式确认后才定制。

#### M05 机械限位件

**性质：限位功能必需，与机构一起设计。**

- **具体功能：**用实体结构约束允许的行程边界，作为软件软限位之外的机械约束；本身不能切断舵机电源。
- **直接效果：**降低越程导致活动线过扭、部件碰撞和夹线的风险。
- **最终目标/验收：**正常目标行程不碰硬挡，越程边界在危险位置之前；软件与机械行程协调，不能靠舵机反复顶住硬挡定位。若要求碰限位自动断动力，还需相应检测/控制设计，不能仅凭挡块宣称已实现。

#### M06 零位开关或霍尔＋磁铁

**性质：条件项，回零确有需要才加。**

- **具体功能：**在机构到达指定参考位置时提供检测信号，帮助固件建立或校验头部零位。
- **直接效果：**重启或机构校准时，可以通过实际位置事件找回正向，减少只靠上次命令推测姿态。
- **最终目标/验收：**选用后验证触发位置重复性、安装间隙和回零流程，传感器异常不会造成持续顶限位；单个零位开关/霍尔只检测参考点，不是全角度编码器，也不能保证任意角度精度。

#### M07 应力释放线夹、柔性护套

**性质：活动线保护必需，随走线设计。**

- **具体功能：**固定线束的静止端和转动端，让弯曲发生在受控活动段，并保护与壳边接触的区域。
- **直接效果：**减少转头时拉扯插座、擦伤排线或将电线卷入传动的机会。
- **最终目标/验收：**左右极限和装拆时线束不被拉紧、锐边刮擦或夹住；活动区保持可弯折，不把应弯段粘死；线夹不压坏排线，寿命试验与E04/E05一起进行。

#### M08 接插件、短线、绝缘件

**性质：可靠互连必需，具体型号按实板补缺。**

- **具体功能：**连接供电、按钮、灯及驱动等电路，固定可拆连接，给裸露焊点/导体提供合适绝缘。
- **直接效果：**整机线束比临时杜邦线更易维护，降低装壳后松脱、误接和意外短接的风险。
- **最终目标/验收：**按真实电流、线径、接口和极性选择，锁扣/应力释放可靠，拆装不损坏线束；绝缘完整、不压线。不是采购任意“连接器套装”就算完成。

#### M09 安装柱、螺丝、垫片

**性质：机械固定必需，孔径和长度待实测。**

- **具体功能：**把板卡、支架和壳体固定在规定位置，形成所需离板间隙和可维护的紧固连接。
- **直接效果：**器件不会在底座内移动、互碰或被壳体挤压，维修时可拆下更换。
- **最终目标/验收：**按实物孔径/板厚选型，紧固后不翘板、不顶屏、不穿伤电子件，螺钉长度合适且不会脱落进入电路；需要电气绝缘的部位选用合适支撑方案。

### 10.3 外壳、CMF、隐私与声学配套

#### C01 头壳、底座杯体与上盖

**性质：本版整机外壳必需，暂未打印放行。**

- **具体功能：**包覆并保护内部器件，提供安装、受力、拆装以及线缆/声学/散热通道，形成圆润外形。
- **直接效果：**电子件收纳在整洁、可接触的桌面产品内，头部与底座分区明确，用户看不到散乱线束。
- **最终目标/验收：**装入实物后不干涉运动、线束和天线，接缝与手感满足展示要求，拆装和通风合理；完成结构、公差与温升验证后再打印正式壳体。外形封闭不代表具有防水/防尘等级。

#### C02 黑色面罩/屏窗

**性质：本版面部外观与屏幕保护必需。**

- **具体功能：**遮住LCD矩形边框和内部结构，同时让实际显示区的光透出；透明窗、黑框/遮光层与固定方式需一起设计。
- **直接效果：**视觉上得到整体的黑色“脸”，暖白眼睛更集中，屏幕不显得像裸开发板。
- **最终目标/验收：**最终样件下表情清晰、反光可接受、窗口不裁切显示区域或挡住镜头；若保留触摸能力，还须验证装上面罩后的触摸。不能拿不透光黑板盖住屏幕来实现黑面罩效果。

#### C03 摄像头物理滑盖

**性质：本版可见隐私操作必需，定制结构待完成。**

- **具体功能：**由用户移动实体遮挡件，直接遮住或露出摄像头入光口。
- **直接效果：**用户能够肉眼确认镜头是否被遮挡，而不只依赖软件图标。
- **最终目标/验收：**关闭时对允许视场形成有效遮挡，打开时不遮边、不擦镜片，挡位稳定、操作不误碰屏幕；遮挡镜头不等于断开摄像头电源，也不等于关闭麦克风或停止软件采集。

#### C04 按钮帽、LED导光窗

**性质：外观操作/状态呈现必需，与电子件配套。**

- **具体功能：**按钮帽将手指按压力传到实际开关；导光窗把内部LED的光带到机壳表面。
- **直接效果：**用户能按到外壳上的停止按钮，并从外部看到短状态窗，内部电子件不必直接暴露。
- **最终目标/验收：**按键行程与开关匹配，不常压、不卡死，按一次能触发实际停止；导光窗有清楚且不刺眼的可见输出、不向机内大面积漏光。帽和窗本身不产生控制或状态信息。

#### C05 扬声器密封垫与声腔试装材料

**性质：声学配套，结构随播放测试确定。**

- **具体功能：**密封扬声器安装边缘的非预期泄漏，配合设计声腔管理出声路径，并按需要处理装配振动。
- **直接效果：**目标是减少箱体杂响/声泄漏，改善实际语音输出的一致性，而不是单靠加泡棉就提升功率。
- **最终目标/验收：**装壳后与裸扬声器/不同声腔方案做对比，语音可懂、无明显装配共振，不堵出声口或触碰振膜；连同麦克风与AEC验证，不预先承诺“完全无回声”。

#### C06 麦克风声学通道与密封材料

**性质：板载麦进壳后的声学配套必需。**

- **具体功能：**把外壳拾音孔与板载麦克风实际声孔对齐，控制不期望的壳内串音和漏声；不能让装壳材料把声孔堵住。
- **直接效果：**目标是使固定在底座内的双麦仍能接收现场人声，并减少壳内扬声器/机械噪声的影响。
- **最终目标/验收：**装壳前后用相同声音/位置比较录音，检查人声、噪声及播放时的回声；每只麦通道按实物核验，AEC/双讲另外实测。麦克风固定在底座，不随转头获得自动指向性或说话人识别。

#### C07 防滑硅胶脚垫

**性质：桌面接触配套必需，材料/厚度试装。**

- **具体功能：**提供柔性桌面接触面、摩擦和保护，按实际材料及压缩量匹配底座。
- **直接效果：**目标是减少转头时底座滑移/桌面刮擦，并降低部分接触振动传到桌面的程度。
- **最终目标/验收：**在实际桌面上完成三个姿态及转向测试，底座保持稳定，脚垫不翘起/脱胶，也不因厚薄不均使机身摇晃；脚垫不能代替重心设计或保证所有桌面都不滑。

#### C08 底座配重

**性质：条件项，稳定性试验需要时再加。**

- **具体功能：**将额外质量以受约束方式固定在底座合适位置，按整机重心和支撑范围改善抗倾覆能力。
- **直接效果：**在实际重心需要时，使头部偏转、惯性动作或线缆轻拉不容易让机身翻倒；不作为提高舵机扭矩的办法。
- **最终目标/验收：**先测整机稳定性，再决定质量和位置；需要时配重牢固、绝缘、不挤占电路/线束/声腔，复测滑移与倾覆。当前无专用配重预留，不能直接往壳内塞金属块。

### 10.4 整机最终要达成的效果

以下是这些部件配合现有项目软件后的目标闭环，不是“买齐就自动拥有”的功能，也不是本次已经完成的验收。

1. **有清楚的状态。** 开机后显示真实连接/工作状态；掉线、等待确认和停止可被区分，不用表情或灯效掩盖故障。由E01/E02/E09/E12及C02/C04协作实现。
2. **能获取现场信息。** 固定底座双麦采集人声，交由路线A电脑伴侣处理；按用户请求取景/抓拍，软件确认后向远程成员共享原图。由E01/E03/E05/C03/C06与软件链路协作，摄像头不承担自动理解材料的全部工作。
3. **能以转头表达面向。** 控制器下发允许的朝向后，头部在左右各45°目标范围内转向，固定底座不跟着转，屏幕/摄像链路不断。由E04/E05/E10/E13、M01–M05/M07–M09、C01/C07协作；不包含自动声源定位、连续360°或俯仰。
4. **获得本人确认后再提醒现场。** 线上观点经过项目既定本人确认流程，机器人再呈现对应状态并播放提醒；没有确认不自动播报。由业务软件与E01/E02/E06/E12/C05配合。器件只执行已授权内容，不自行决定谁被忽略。
5. **用户能立即提出停止。** 实体按钮可停止当前播报，实际停止结果与显示/灯一致；物理滑盖能遮挡镜头。由E11/C04和C03分别实现，两种操作不混同为硬件断麦。
6. **装壳后仍可靠且可维护。** 线束不夹、不磨、不卷；主板不因转头复位；语音可懂，结构不松脱，桌面放置稳定；可拆修。依靠供电、传动、紧固、声学及外壳共同完成，条件项M06/C08只在确有需要时加入。
7. **会后记录仍由软件负责。** 观点地图、证据关联、本人确认与会议账本在项目软件链路中完成；小屏、舵机和摄像头不替代这些软件能力。

### 10.5 把“目标”变成验收记录

- 用左45°／正向／右45°检查实际朝向，并同时观察显示、抓拍、线束和底座；头角要实测，不只看PWM或动画。
- 对“未确认不播报→本人确认→允许提醒→实体停止”逐步记录设备事件和现场可观察结果，区分queued、started与实际播放结束。
- 摄像记录取景条件、真实原图和滑盖开/关效果；声音记录装壳前后人声、播报、转动噪声和双讲结果。
- 故障和断电/重启行为单独测试，不能从一次正常演示推出长期稳定；测试轮次、判定阈值及实际结果在选型后形成独立记录。

## 11. 低成本替代路线（提案，未验证）

> **性质声明：**本节是 2026-10-10 讨论中提出的**降本备选路线记录**，不是已生效的采购决定，**不改变第 3–4 节 E01/E02 等项的既有采购状态与“暂缓”结论**。本节所列型号、价格量级、接口均为待核验的选型方向，未下单、未核价、未上机验证。若决定采用，须逐条落实 11.7 并重做固件与排线；不得把本节当作 PASS、已完成或替代第 3–4 节的正式清单。

### 11.1 成本结构：钱在哪

| 项 | 参考量级 | 备注 |
|---|---|---|
| E01 Korvo-2 主板 | ≈$50 | 官方多媒体板 |
| E02 LCD 扩展板＋2.4英寸屏套装 | ≈$53（立创 1+ ¥349） | 官方配套 |
| **E01＋E02 合计** | **≈¥700** | 占整机电子件最大头 |
| M01 SG90 | ¥5–15 | 可忽略 |
| E06–E12 通用件 | 几十元 | 小 |

**结论：**降本的大杠杆只在 E01＋E02；改舵机、排线、扬声器只能省几十元，量级不同。价格均为参考量级，非报价。

### 11.2 【已归档】替换方案：微雪 ESP32-S3-CAM 单板（深圳微雪 Waveshare）

> **2026-10-12 归档**：未采用（国内拿货要等）。评估留档于 `archive/waveshare-board-eval-20261012/`。下文保留为决策依据。

用一块国产单板同时替代 E01＋E02，功能层级基本对等：

| 功能 | 现路线（Korvo-2＋LCD 扩展板） | 替代（ESP32-S3-CAM-OV3660） |
|---|---|---|
| 主控 | ESP32-S3-WROOM-1 N8R8 | ESP32-S3R8，16MB Flash／8MB PSRAM |
| 音频 ADC／Codec／功放 | ES7210／ES8311／NS4150B | **同为 ES7210／ES8311／NS4150B** |
| 麦克风 | 双麦阵列 | 双麦阵列 |
| 摄像头 | 外接 OV2640 | 24PIN DVP，可选 OV3660／OV5640／GC2145／GC0308 |
| 显示 | 乐鑫 LCD 扩展板＋2.4英寸屏 | 外接 18PIN FPC 屏模块（1.83/2/2.8/3.5英寸） |
| 供电 | 5V/2A | Type-C，另带 3.7V 锂电充放电路 |

- **建议选 OV3660 版**：带硬件 JPEG（GC 系列无硬件 JPEG），2048×1536 高于原 OV2640。
- 屏为**外接 FPC 模块**，不是板载 → 可兼容原“板在底座、屏在头部”的分离结构（见 11.4）。
- 参考：微雪 ESP32-S3-CAM 系列产品页与文档（型号 ESP32-S3-CAM-OVxxxx）。价格量级：境外报价约 €19.75–24.95（含摄像头与喇叭），国内以微雪商城实时价为准。

### 11.3 逐项改动与代价

| 现行 ID | 现状态 | 本路线改动 | 代价／风险 |
|---|---|---|---|
| **E01** | Korvo-2 V3.1（可先采购/复用） | 换微雪 ESP32-S3-CAM-OV3660 | 引脚、固件、排线全需重配 |
| **E02** | 乐鑫 LCD 套装 | **删除**；屏改微雪 18PIN 屏模块 | 屏尺寸 2.4″→2.0″/2.8″，面罩 C02 开口需改 |
| **E03** | 单独采购 OV2640 | 由板载 OV3660 替代 | 固定焦；镜头突出尺寸需与预留盒核对 |
| **E04** | 跨轴 LCD FPC | 按微雪 18PIN 规格重配，或随布局取舍 | 连接器规格不同，非原配 |
| **E05** | 摄像头跨轴延长 | 布局 B 下可删除 | 见 11.4 |
| **E07/E08** | Micro-USB 数据/供电线 | **改 Type-C 线**（微雪为 Type-C） | 与原“原版板不是 USB-C”结论相反，线材需换 |
| **E13** | 舵机 PWM 条件项 | **删除**，改用 ESP32-S3 LEDC/RMT 直接出 PWM | 引脚方案须重定 |
| **M01** | SG90 | 不变 | — |
| **M02** | 定制空心转台（暂缓） | 标准深沟球轴承＋推力球轴承组合＋3D 打印轴承座 | 需重画结构，承载/摩擦待实测 |
| **M03** | 同步带＋定制带轮 | 直连或齿轮传动 | 需重画结构 |
| **M04** | 定制支架/座/连接盘 | 3D 打印（打样） | 强度、公差、防松待验证 |
| C01/C02/C03/C05 | 正式壳体/面罩（暂不下单） | 3D 打印，不开模 | 外观、耐久、反光打折 |

### 11.4 结构布局二选一（**已定案为布局 A**，本节保留为决策依据）

- **布局 A：板在底座，屏＋摄像头在头部。** 保留 C06“麦克风固定在底座”，但需**跨轴 DVP 高速并行排线**（8 位并行＋同步时钟），信号完整性与弯折寿命风险高，跨轴线束多。
- **布局 B：微雪整板进头部，底座只留舵机、电源、按钮/灯。** 跨轴仅剩电源＋舵机 PWM＋按钮/LED 等低速细线，**可删除 E04/E05**，最省也最简单。
  - 代价：**麦克风随头转**，与 C06 现设计（麦固定在底座）冲突，需改写 C06；头部重量与转动惯量增大，须核对 SG90 带载与 E10 供电；头部须重排走线与散热。
- **2026-10-11 定案：布局 A。** 决定性理由是拾音稳定性——麦随头转会让 ASR 准确率变成头部朝向的函数，而转头时刻恰是最需要稳定拾音的时刻；且 B 会推翻 C06「麦克风不随头转」的既有产品规则。详见 HANDOFF「2026-10-11 已定案」节。

### 11.5 固件与接口影响（若采用须重做）

- 摄像头：esp32-camera 官方驱动支持 OV3660；
- 音频：esp_codec_dev 支持 ES8311／ES7210（与原板同芯片，但板级布局与麦克风开孔不同，**AEC 必须重测**）；
- 显示：esp_lcd 驱动 ST7789 屏模块；
- 舵机：LEDC／RMT 出 PWM；
- 引脚表按微雪原理图重配，屏幕/摄像/音频 GPIO 冲突须重排。

### 11.6 已评估但未采纳的方案

- **串行总线舵机（幻尔/飞特等）**：可回读真实角度、单线级联，理论上可同时消掉 M06 与 E13，但**单价明显高于 SG90**，与本次降本目标冲突，暂不采纳；若后续更看重精度与角度反馈再评估。

### 11.7 下单前核验（若采用本路线）

- 微雪：确认所选为 **OV3660 版**；索取原理图、引脚定义表、板体尺寸图、18PIN LCD 接口定义与适配屏型号；
- 确认板载双麦与 ES7210 的通道/回声参考接法，评估 AEC 重调工作量；
- 确认屏幕模块驱动 IC、分辨率、可视角度与反光；
- 确认摄像头镜头突出尺寸与头部预留盒（24×16×20 mm 假设）的关系；
- 3D 打印件材料、壁厚、公差、紧固方式先打样验证，不作为打印放行 CAD。

### 11.8 自制外壳：可用打印设备与工艺分配

> 本节记录 2026-10-10 确认的**可用设备**与**打印能力边界**，仍属提案；打印件不是打印放行 CAD，结论不改变第 5 节 C01/C02 的“暂不下单正式壳体”状态。

**可用设备（用户自述 + 学校实验室清单）**：用户自有拓竹 **A1**；学校“激光加工与 3D 打印实验室”另有 **Bambu Lab P2S、H2S、H2D** 三台，及**精密激光切割机（含 4 轴）**。均为 FDM 工艺。

**主要零件尺寸 vs 成型体积**（源：parameters.json，仅外形，非零件拆分后尺寸）：

| 零件 | 外形 W×D×H (mm) | A1(256³) | P2S(256³) | H2S(340×320×340) | H2D(325×320×325 单喷嘴) |
|---|---|---|---|---|---|
| 头壳 HEAD | 150×128×144 | 可 | 可 | 可 | 可 |
| 底座 BASE | 180×164×78 | 可 | 可 | 可 | 可 |
| 短颈 NECK | Ø46×25 | 可 | 可 | 可 | 可 |

→ **尺寸不是约束**：主要外形单件四台机器都能打印。真正的约束是**工艺能力与外观要求**。

**工艺能力对照（官方参数）**：

| 机型 | 喷嘴最高温 | 腔温 | 关键差异 |
|---|---|---|---|
| **A1（自有）** | 300 ℃ | **无主动腔温** | 官方**不推荐** ABS/ASA/PC/PA/PET 及碳纤增强；仅 PLA/PETG/TPU/PVA 属“适合” |
| P2S（学校） | 300 ℃ | 50 ℃ | 硬化钢挤出/喷嘴，支持 PA6-CF/PPA-CF 等工程耗材 |
| H2S（学校） | 350 ℃ | 65 ℃ | 最**大**成型体积；支持**自动孔径补偿**（官方称可用官方耗材达到近机加工级孔精度） |
| H2D（学校） | 350 ℃ | 65 ℃ | 双喷嘴，可**专用支撑材料**；支撑面质量最好 |

**“不影响最终效果”的边界（关键）**：3D 打印**不是开模注塑**，以下三项无法靠换设备完全消除，只能缓解——**与用哪台机器无关**：

1. **接缝**：FDM 逐层堆叠，层纹与分件缝不可避免；C01 要求“接缝与手感满足展示要求”，需靠**分件朝向设计＋打磨＋后处理**达成，不是设备问题。
2. **面罩 C02 的反光/透过率**：打印件表面无法达到注塑级光学面；建议**打印件只做结构支撑，黑框与透明屏窗仍用亚克力/PC 板材**。
3. **各向异性强度**：FDM 件层间强度低于注塑件；M02/M04 等**受力件**须靠**打印朝向（层纹垂直于主受力方向）＋壁厚＋加肋**保证，不能只换机器。

**因此的工艺分配建议**：

| 部位 | 建议工艺／设备 | 理由 |
|---|---|---|
| C01 头壳、底座杯体、上盖 | **H2S 整件打印**（已定，见 11.9） | 尺寸可单件；孔径补偿利于装柱/轴承座；接缝最少 |
| 底座要求平整的接合面、C02 面罩黑框、C03 滑盖 | **激光切割亚克力/PC**（学校有精密激光切割机，含 4 轴） | 切割件平整、无层纹、光学面好，正合面罩与滑盖需求 |
| M02 轴承座、M04 连接盘、支架 | H2S（PA6-CF/PPA-CF 等工程材料）或 PETG，注意打印朝向 | 受力件，优先层间强度与刚度 |
| M07 线夹、M08 绝缘件、C05 声腔垫 | A1（PLA/PETG/TPU） | 非受力、形状自由，自有机器足够 |
| 0.2 mm 喷嘴细件（卡扣、挡位） | 任一机器换 0.2 mm 喷嘴 | 细节与公差优先 |

### 11.9 C01 外壳采用 H2S 整件打印（此前路线记录）

> 最新保留“各壳体独立整件＋H2S正式打印”路线，但材料、支撑和公差解释由第12节及PRINT_PLAN.md更正。不要沿用此节“无可溶支撑”及“底板2mm”等未经核准推论。

> **性质：**本节是用户在 2026-10-10 选定的**工艺路线**（H2S 整件打印），仍属提案记录，**不构成打印放行**；正式打印前须完成分件/加肋/公差设计与打样验证，且不改变第 5 节 C01“暂不下单正式壳体”的状态。

**选定理由**：接缝最少；H2S 尺寸余量大（340×320×340，头壳 150×128×144、底座 180×164×78 均可整件）；支持自动孔径补偿，利于轴承座/安装柱装配精度。

**整件打印的实际约束（须在建模时落实，否则会破坏“不影响效果”）**：

1. **打印朝向**：头壳与底座各为整件一次成型，必须选定朝向以最小化支撑面。椭球头壳与鹅卵石底座都**没有天然平面**，需设计**工艺平面/可拆支撑脚**，否则大面积支撑会在可见面留下粗糙痕迹。
2. **支撑与悬垂**：整件意味着内部腔体、短颈孔、面罩开口都会产生悬垂；H2S 单喷嘴（非 H2D 双喷嘴）**无专用可溶支撑**，只能同材料支撑，接触面需留间隙并后处理。
3. **收缩与公差**：底座 180 mm 属大尺寸件，PA6-CF/PPA-CF 收缩各向异性明显；**自动孔径补偿需配合官方耗材**才生效，非官方耗材须自行做收缩补偿试打。
4. **壁厚与加肋**：名义壁厚 2.4 mm 是外壳目标值，整件受力段（底座顶面、短颈根部）应局部加肋，避免层间剥离。
5. **分件口保留**：C01 原定义“分件可拆修”，整件打印后仍需保留**底座上盖接缝（lid_seam_z=68）**与头壳底部拆装口——整件打印的是**头壳单体**与**底座杯体单体**，不等于整机一体成型。
6. **材料选择**：外观优先 → PETG（表面好、韧性够、不需高腔温）；刚度优先 → PA6-CF/PPA-CF（需 H2S 的 65 ℃ 腔温与硬化钢喷嘴）。
7. **后处理**：整件打印不可避免有层纹与支撑痕，C01 的“手感/展示要求”须靠**打磨、补土、喷漆或贴膜**达成，属后处理工时，不计入打印。

**待核验**：H2S 实际可预约时间与排队；官方耗材型号与库存；整件打印单次耗时与失败重打成本；首件必须**先打 1:1 或缩放样件验证装配孔与朝向**，再打正式件。

**先行验证（A1 + PETG，用户已定 2026-10-10）**：正式去学校用 H2S 之前，**先用自己的 A1 打 PETG 验证件**。A1 成型 256×256×256，经尺寸核对头壳（150×128×144，余 106 mm）、底座杯体（180×164×78，余 76 mm）、上盖、短颈**均可整件打印**；PETG 属 A1 官方“适合”材料，无需腔温。此步骤用于验证**几何、分件、开孔与装配**，失败成本低、可快速迭代；**不代表 H2S 正式件已通过**，也不能用 PETG 验证件的强度数据推断 PA6-CF/PPA-CF 受力件。

**若需更高外观/强度**（超出上述能力时）：可将打印件做**外协**（树脂/尼龙 SLA-SLS 打印、小批量注塑、CNC），属校外采购，不在本节承诺范围。

**核验前提**：上表尺寸为**外形**，不等于拆分后的单件尺寸；实际打印前须完成**分件、加肋、安装柱、公差、收缩补偿**设计并先打样验证，本节不构成打印放行依据。

## 12. 当前采购决策：v6/A2＋灰黑PLA Matte（2026-10-15口径核对）

> **当前执行仅按v6/A2。** 核心板、屏、摄像头在头部；麦/功放/扬声器/舵机/停止键在固定底座。摄像头FPC不跨轴、不延长。电池、TP4056、扩展板不装入本轮Demo。以下订单/到货状态沿用已记录事实，本轮没有新核实物流。v5打印和采购数量不自动继承。

**本节是当前选型和采购顺序的优先入口，覆盖前文第3–5节及第11节中的旧候选材料/未决分支。** 前文保留用于需求解释和追溯。这里“最终”指选型策略已作取舍，**不是已核验现货订单、实物兼容放行或可打印CAD**。数量是一台原型的配置量；已有合格库存可使采购量为0。新SKU和材料需要CAD调整/实际验证；当前模型、唯一parameters.json和32 件表按v6/A2维护；外置双麦/功放保留，电池和TP4056推迟。连接口径：除**喇叭端 2 点**外全杜邦（麦 P32 针朝内、按键/功放/屏/舵机/供电均插接）。正式接口仍未放行。

### 12.1 最新取舍：打印优先，少操作（按用户反馈修订）

- **主材料统一为 PLA Matte 哑光（机身灰 / 细节黑）**：灰色用于头壳/底座/上盖，黑色用于面罩框、短颈及内部支撑件；默认直接使用裸打哑光表面，不安排补土、打磨喷漆、退火或外协。**全部打印件统一同一种料**，观感一致、不换料。[S15]
- **改用 PLA Matte 的原因（2026-10-11）**：实验室通风不允许打印 ABS/ASA（后期改造后才放开）；自有 A1 无主动腔温，拓竹官方亦不推荐 ABS 系。PLA 收缩极小、几乎不翘，恰是大面积薄壳最需要的；PLA Matte 自带磨砂哑光，观感接近原 ABS-GF 目标。**注意 PLA 热变形约 55℃，禁止暴晒/密闭高温环境。**
- **取消本轮PC、PAHT-CF、PPA-CF及激光切透明面板采购。** 内部支架/轴承座**必须分体夹紧或螺钉连接**，不做必须卡扣弹性变形的脆弱结构、不做强过盈压装——该约束正好规避 PLA 偏脆的短板。若实际载荷/疲劳测试失败才局部换材，不假装不同材料强度一样。
- **黑面罩改成打印黑框＋显示窗口**，LCD自身屏面直接露出；取消额外透明屏罩。这是明确的外观取舍：矩形显示区域/窗口接缝可以被看到，不承诺与原整片黑玻璃概念图完全相同。
- 按钮帽/滑盖/线夹/声学通道/连接盘/带轮能打印则打印；LED先用直接可见小孔，确有刺眼/漏光才加单独薄白色扩散小片。
- 舵机、标准轴承、电子件、同步带、线束、螺钉、软硅胶密封/脚垫仍购买现成件，避免用打印替代精密滚动、软密封或电气连接；也GOOUU外置音频必须单独联调，不能宣称与Korvo声学性能相同。
- PLA Matte 对机器无特殊要求：实验室 H2D/H2S 可打，自有 A1 亦可整件打印；普通 0.4mm 喷嘴即可（学校为硬化钢、A1 标配，均无需另购）、不需封箱；干燥为“建议非强制”，正常拆封即打，受潮时按官方参数（45–70℃ 档）处理，不要 80℃。A1与学校机器分工见[打印方案](PRINT_PLAN.md)。[S15]

**当前采用GOOUU核心板＋布局A2（2026-10-13起）**：核心板、LCD和摄像头在头内，满足摄像头FPC实测14mm的约束；麦、功放、扬声器、舵机和停止键固定在底座，麦不随头转。跨轴为**约11根**细软线（麦/功放各一对 I2S；SD 常开），摄像头FPC与屏幕14针连接均不跨轴。旧布局A（板在底座）作废，不与历史布局B混用。

> ⚠️ **换 GOOUU 的代价**：该板**无板载音频**（无麦、无编解码、无功放、无电池管理），当前Demo外接 **INMP441×2 + MAX98357A**；TP4056及电池推迟，不列入本轮必买。规格与引脚见 [GOOUU-BOARD-SPEC.md](GOOUU-BOARD-SPEC.md)。选它的唯一理由是**交付速度**（次日达）；微雪方案评估见 `archive/waveshare-board-eval-20261012/`。

### 12.0 采购执行状态（**接手者先看这张表**）

> 2026-10-15口径核对：**GOOUU核心板 + 布局A2 + PLA Matte**。采购状态不等于已验收。
> **2026-10-13 v6修订（布局A2，见[v6 README](revision-20261011-nomi-layoutA/print-split-v6/README.md)）**：核心板＋摄像头＋屏进头部（摄像头FPC实测仅14mm，禁止裁剪FPC或加长，不跨轴）；麦／功放／扬声器／舵机／按键仍固定底座，麦不随头转。扩展板实测95×87×12不装入。E16 TP4056＋3.7V电池**推迟（路线B／决赛）**，Demo外供5V≥2A经后部USB-C输入小板（预算20×15×6未验）。跨轴改为**约11根**细软线穿Ø22轴孔（2026-10-21 方案1），E04/E05按此改口径。M03改**2:1 GT2：32T＋64T打印轮＋188mm闭环带6mm宽，C=44.84**（下文228mm为v5历史值）。
> **本节是当前采购执行入口**，与下文34项明细配套使用；[接口确认门槛](revision-20261011-nomi-layoutA/print-split-v6/INTERFACE_GATES.md)未通过的项先核实/取样，不冻结批量。

---

#### ✅ 已下单／已有 —— **别重复下单**

| 物料 | 数量 | 状态 |
|---|---|---|
| **GOOUU 套装**（核心板+OV3660+扩展板+2.8″TFT） | 1套 | **¥86.5**，2026-10-12 下单 |
| **PLA Matte 灰** | 2 卷 | ✅ **已到货** |
| **PLA Matte 黑** | 1 卷 | ⚠️ **已下单，尚未到货** —— **不要再下一单** |
| PETG | 现有库存 | 仅用于配合样片 |
| 0.4mm 喷嘴 | 标配 | 学校实验室为**硬化钢**；PLA 不磨嘴，无需另购 |
| E02 2.8″ TFT 带触摸（SPI） | — | 已含在 GOOUU 套装内 |

---

#### 🔴 A. 必买 —— 本轮补齐音频（先核对已有订单/库存）

| 物料 | 数量 | 参考价 | 备注 |
|---|---|---|---|
| **E14 INMP441 I2S 麦克风模块** | **2** | ¥8–15/个 | 双麦拾音；**产品命脉** |
| **E15 MAX98357A I2S 功放模块** | 1 | ¥8–12 | 驱动扬声器 |

#### 🔴 B. 要买 —— 机械与结构

| 物料 | 数量 | 参考价 | 备注 |
|---|---|---|---|
| **M02 轴承 6806-2Z/ZZ** | **2** | ¥20–40 | **30 内径 × 42 外径 × 7 厚**；国产正规渠道 |
| **M01 MG90S 金属齿舵机** | 1 | ¥15 | 已有 SG90 可先验 |
| **E06 扬声器 4Ω/3W** | 1 | ¥10–20 | 外径 ≤40mm、深 ≤18mm |
| **M09 M2.5/M3 螺钉＋标准螺母样品** | 小套装 | ¥20（原参考） | 按v6接口核定；不强制热装嵌件，不自动沿用v5的M3×70数量；面板R1仅取样候选，见下表 |
| **M08 接插件／线材／绝缘件** | 小套装 | ¥20 | 杜邦线不作最终活动线束 |

#### 🟡 C. 先翻库存 —— 大概率已有，没有才买

| 物料 | 数量 | 判据 |
|---|---|---|
| E07 Type-C 数据线 | 1 | **必须能传数据**（烧录/日志） |
| E08 Type-C 供电线 | 1 | 低压降、插头弯线空间够 |
| E09 5V/≥2A 电源 | 1 | 正规合规手机充电器即可，**非裸板** |
| E10 舵机独立稳压供电＋保护 | 1套 | 可调稳压电源亦可；**4.8V 基线，别默认喂 6V** |
| E11 轻触开关（6mm） | 1套 | 前肩停止键用 |

#### 🟡 D. 第二批 —— **今晚别买**，等实物/CAD

| 物料 | 数量 | 等什么 |
|---|---|---|
| E04 LCD头内连接线 | 1套＋备件 | 屏与核心板同在头内；14针定义/端接实核，排针侧按12mm预算验配合；不是LCD跨轴线束 |
| E05 摄像跨轴排线 | 0 | **v6/A2取消**：摄像头FPC 14mm不跨轴 |
| M03 GT2 同步带 | 1 条 | **v6：188mm闭环、6mm宽（2:1，32T/64T）**；v5的228mm仅候选已作废 |
| E16 TP4056＋3.7V受保护锂电 | 0 | **v6推迟（路线B／决赛）**；本轮不备买、不装入 |
| E17 USB-C 5V输入小板 | 1件候选，未选型 | 20×15×6预算和杯壁开口不是已选SKU；先核5V供电路径/插头和板外形，再决定采购 |

#### ❌ 不买

| 物料 | 原因 |
|---|---|
| E03 摄像头 | 已含在 GOOUU 套装 |
| E13 PWM 扩展板 | LEDC/RMT 直出 |
| M06 零位传感器 / C08 配重 | 本轮不装 |
| 0.2mm 喷嘴 | 本轮不用；0.4mm 已足够（学校 0.4 为硬化钢） |
| ABS-GF、PC、PAHT-CF、PPA-CF、圆屏/AMOLED、亚克力/PC 透明板、喷漆补土、激光切割、滑环、连续旋转舵机、RGB 环带 | ABS/ASA 实验室禁打；A1 亦无腔温 |

#### 🟢 打印，不买（当前v6共32件：28 行，P33 为 v6r3 新增）

三件灰色外壳：头壳、底座杯、上盖；其余28件为黑色面板、颈、机构与支架。以[v6 PARTS.csv](revision-20261011-nomi-layoutA/print-split-v6/PARTS.csv)为唯一件表。
→ [v6 PLATE-RUNBOOK](revision-20261011-nomi-layoutA/print-split-v6/PLATE-RUNBOOK.md)：6盘仅为256起点排布，未切片、未样片。旧v5 G1/G2打印记录已停打作废，不是v6进度。

**打印分工**：小件走自有 A1；三件大壳走学校 H2S/H2D。见 [PRINT_PLAN §4.5](PRINT_PLAN.md)。

---

> **建模/接线/选屏前先读 [GOOUU-BOARD-SPEC.md](GOOUU-BOARD-SPEC.md)** —— GOOUU 板体尺寸（**62.6×28.3mm**）、全 GPIO 表、必配外接件。
> **货到后**：按 [v6 MEASUREMENTS.csv](revision-20261011-nomi-layoutA/print-split-v6/MEASUREMENTS.csv) 逐项实测 → 回填 [parameters.json](parameters.json) → 更新源并重建证据。

### 12.2 当前配置（34项，含取消/推迟项；新增E17输入板）

| 原ID | 最终选择 | 数量 | 实惠采购方式／状态 | 达标条件与不能省掉的部分 |
|---|---|---|---|---|
| **E01** | **GOOUU套装：核心板＋OV3660＋扩展板＋2.8″TFT** | 1套 | 已记录2026-10-12下单¥86.5；本轮未更新物流 | 核心板竖装头内；扩展板已记录95×87×12，v6不装；需外接E14/E15，E16推迟 |
| **E02** | 套装内2.8″TFT（HSD028309 A6，J2单排14针） | 随E01一块，另购0 | 已记录PCB85×50、总厚11、四孔；真实针序/电压/触摸接口待确认 | 四孔 77×45、玻璃到 PCB 4mm 已于 10-15 实测放行（LCD-01，见 MEASUREMENTS.csv），夹框与接口已按实测重建 |
| **E03** | 套装内OV3660可拆摄像模组 | 新增0 | 与核心板同在头部，不重复买 | 已记录模组8×8×4、FPC14；禁止裁剪或延长，9.55跨距/4.45余量仅名义直线计算，需试装验证 |
| **E04** | LCD头内14针连接线（SPI/触摸/电源） | 1套＋备件 | 核实针序与端接后定长；不采购LCD跨轴FPC | 保留排针侧12mm预算并实装；约11根跨轴软线另按M08核实 |
| **E05** | 摄像头跨轴FPC/延长组件取消 | 0 | v6/A2不买 | 摄像头与核心板同舱，使用套装原14mm FPC；不得按v5延长方案采购 |
| **E06** | 国产4Ω/3W、外径≤40mm、深≤18mm扬声器候选 | 1只 | 同阻抗尺寸样品，比成品蓝牙音箱省钱 | 实际功放匹配、接头、总深度和语音清晰度确认后定稿 |
| **E07** | 可靠 **Type-C** 数据线 | 1条 | 已有合格线复用，不追品牌 | GOOUU套装接口以实物核对；必须传数据，用于烧录/日志 |
| **E08** | 低压降 **Type-C** 供电线 | 1条 | 已有合格线复用 | 足够电流、插头弯曲空间，随固定底座走线 |
| **E09** | 合规5V/≥2A外置电源 | 电源1；电池0 | Demo外置供电，先检查合格库存；与E17输入板分别核实 | 电池独立供电、升压/充电路径推迟；TP4056不作为5V供电板 |
| **E10** | 与舵机实物额定值一致的独立稳压供电及保护线 | 1套 | 单独供电台架优先；可复用合格可调稳压电源 | MG90S官方页以4.8V给出基线；任何5V方案先核具体件允许范围，不默认喂6V |
| **E11** | 前肩普通轻触停止键＋引线 | 1套 | 模型采用前肩帽对应的外接开关，优先确认空闲非启动GPIO；不要用100mm机械连杆硬推后部板载键 | BOOT/G0只作为已测试引出备选，需验证按下状态跨复位／上电；停止播报不是电机急停或硬件断麦 |
| **E12** | 前部真实状态灯引出候选 | 先复用；不直接另购RGB板 | GOOUU板载WS2812B在固定后部，能否从前窗见到待测；不能则补小LED／限流引出 | 不买环灯带；控制GPIO、真实事件驱动和可见性待确认 |
| **E13** | **删除**——ESP32-S3 LEDC/RMT 直出 PWM | 0 | 不下单 PCA9685 等驱动板 | 舵机 PWM 直出，省一块板与一条走线 |
| **E14** | INMP441 I2S麦克风模块 | 2个 | GOOUU无麦，必须配；固定在底座，不随头转 | 16×6×12是本轮模块安装预算，不是实际PCB尺寸；L/R、时钟／数据、3.3V逻辑与声孔需实测／核表 |
| **E15** | MAX98357A I2S功放模块 | 1个 | GOOUU无功放，必须配；位于底座前右 | 23×16×4预算，实模块／接头回填；扬声器接差分输出，不接成一端共地；供电／I2S按模块定义 |
| **E16** | TP4056充电/保护模块推迟 | 0 | 路线B／决赛再议，v6不装入、不备买 | 不是5V升压器，也不自动等于边充边用管理 |
| **E17** | USB-C 5V输入小板（SKU待定） | 1件候选，未放行 | 预算20×15×6；先确认供电路径、板外形、焊点和插头 | 杯壁开口11.5×7为名义预算；不得据此宣称已选型或已验证≥2A |
| **M01** | MG90S位置舵机样品，来源可追溯 | 1只；已有SG90先用其验证 | 新购选金属齿微型位置舵机，不买无刷云台 | 不是静音升级保证；标称本体22.8×12.2×28.5mm，固定耳/花键/转角必须实测[S8] |
| **M02** | 国产6806-2Z/ZZ尺寸级薄壁深沟球轴承 | 2只，先样品 | 优先正规轴承渠道国产件；不要为本任务买陶瓷或进口精密转台 | 30内径×42外径×7厚的选型基线[S9]；两轴承＋隔圈/止挡/连接座另设计，整套不保证仍在旧56×18预留内 |
| **M03** | **v6：2:1 GT2带传动候选** | 带1（188mm闭环6mm）；32T＋64T轮打印 | 节径20.37/40.74，C=44.84；舵机±90°→头±45°。v5的64T/64T、50mm、228mm作废 | 齿形、原配舵盘、实际库存带长／张紧待确认，未进行传动验收 |
| **M04** | PLA Matte 轴承座、舵机架、空心轮毂/连接盘 | 各1套打印件 | 与外壳同材料/同喷嘴，螺钉连接，不安排机加工 | 先打印两轴承座/轴配合样片，控制夹紧/轴肩，不能靠重锤强装 |
| **M05** | 集成软行程与机械挡块 | 左右各1处 | 随结构打印，无需买整套限位机构 | 软目标±45°；硬挡边界由夹线/碰撞模型确认，正常动作不得反复顶挡 |
| **M06** | 本轮不装零位传感器 | 0套 | 不默认购买霍尔/磁铁 | 仅回零测试确有必要时补，不删机构/控制安全限位 |
| **M07** | 小线夹＋柔性护套 | 1套 | 线夹打印，接触细软线处加软护套 | v6跨轴约11根细软线；直径/端接/弯折寿命实核，摄像头FPC不跨轴 |
| **M08** | 通用合规接插件、线材、绝缘件 | 小套装1 | 用标准件，不买整套不匹配机器人线束 | 端子规格/电流/极性确认；不把杜邦线作为最终活动线束 |
| **M09** | M2.5/M3螺钉＋标准六角螺母样品 | 小套装，按v6接口核定 | 不强制热装嵌件；不自动沿用v5的M3×70×8 | 前面板R1候选：M3×12和M3螺母各3仅作取样预算，正式配置量仍未冻结；头形/头高/螺母厚度和孔配合需样片 |
| **C01** | 正式外壳：灰PLA Matte裸打哑光 | 头壳/底座杯/上盖各1，短颈黑色1 | 小件A1、三件大壳学校机器，不喷漆 | v5旧打印已停打作废；v6尚未切片/样片，正式CAD未放行 |
| **C02** | 黑PLA Matte打印面罩框，显示区贯通 | 1件 | 不采购PMMA/PC透明板，不安排激光 | 屏幕自带屏面露出；黑框遮边但不挡有效区，失去独立透明保护盖须接受 |
| **C03** | 黑PLA Matte隐私滑盖＋打印导向 | 1套 | 同批打印，不上漆 | 保持滑槽间隙；去毛刺即可滑动，若摩擦不合格局部换件，不采购复杂滑轨 |
| **C04** | 黑PLA Matte按钮帽；LED直接出光小孔 | 按钮帽1，导光件先0 | 和黑框同批打印，取消珊瑚色喷漆/第三色换料 | 屏幕使用暖白双眼；LED过亮再加薄白扩散件，不承诺FDM光学透明 |
| **C05** | 闭孔硅胶/EPDM声学垫片 | 小片1份 | 采购工业片材刀切，不必打印声腔密封圈 | TPU95A不自动等于软密封泡棉；不堵振膜/出声孔 |
| **C06** | 固定双INMP441声孔通道＋薄声学密封 | 2路 | 声孔对实际外接麦模块，不再按微雪整板孔位 | 模块端口位置／方向、短通道／密封、入壳拾音与软件AEC须验证 |
| **C07** | 实心防滑硅胶片约2mm | 1份裁切 | 购买片材，按最终底面裁 | v6实体底面z=2对应脚垫预留；厚度/压缩/胶层/贴合和防滑需实测，不能把2mm预算当已装实物 |
| **C08** | 本轮不买配重 | 0件 | 稳定性实测需要再加普通钢片 | 无实测不加；钢片须可靠固定/绝缘，不能挡Wi-Fi或挤占声腔 |

M01/M02/M03是**待实物装配验证的新选型**，并没有套用旧fit-report获得“放得下”的结论。尤其两只轴承的间距、止挡、带轮及中央空心轴会改变原机构，必须重新核对总高/受力与走线。

### 12.3 最少材料/工艺投入

下列是C01/M04/M07等条目的耗材投入，不增加第31项功能部件。

| 项目 | 首批安排 | 决定 |
|---|---|---|
| PETG | 用现有库存；不足买1卷 | A1打印孔径/配合验证件与需要的壳体试装件 |
| PLA Matte 灰 | 已下单 2 卷 | 头壳、底座杯、上盖；裸打即可，不买涂料[S15] |
| PLA Matte 黑 | 已下单 1 卷 | 面罩框、短颈、按钮/滑盖、支架和轮毂，少换材料 |
| 0.4mm 喷嘴 | 学校 H2S/H2D 为**硬化钢**、A1 标配 | PLA 不磨嘴，两者均可，**无需另购**；0.2 本轮不用[S15] |
| 干燥/存储 | 无需专用烘干设备 | 官方口径：干燥**建议非强制**；正常拆封即打，受潮按官方参数（热床 60–70℃/12h、AMS 45℃ 档）处理，**不要 80℃**（那是 ABS/ASA 档）；长期密封防潮[S15] |
| 软硅胶/EPDM片、约2mm硅胶足垫 | 各少量，简单裁切 | 采购现成工业片材，不打印耗时的密封结构 |
| 螺钉、安装柱、端子和线材 | 小包补缺 | 板卡有配套就不重复购买；不新增机加工订单 |
| 喷漆、补土、PMMA加工、PC/PAHT-CF/PPA-CF/TPU整卷 | 本轮均为0 | 不加入必须完成的流程；合格现成软片比打印柔性件更省事 |

两颜色分批打印，不在一个件内频繁换色；黑框与灰壳用螺钉装配。整体需要少量去支撑/去毛刺和装配，这些不能完全取消。

### 12.4 采购分批：可以下单什么

**第一批（按当前§12.0，先查订单/库存，勿重复）。** 订单/到货沿用既有记录。需补音频：E14麦×2、E15功放；机械件按M01/M02/M08/M09取样核实，E07–E11先查库存。E16与电池本轮数量为0。v5旧G1/G2进度不用于v6放行；v6先样片再正式打印。

**第二批（接口核实后再定）：** E04头内线、M08约11根跨轴软线、M03 188mm闭环带、E17输入板；E05跨轴摄像FPC取消。面板R1螺钉仅取样候选，不冻结整套采购。

**本轮不买：** 新打印机、额外麦阵列/功放、圆屏/AMOLED、连续360°舵机、滑环、RGB环带、零位传感器、配重、PC、PAHT-CF、PPA-CF/PEEK、喷漆服务与透明板切割；确有测试证据需要时再单独变更。

报价先拿同规格样件与售后条件，不列未核验的淘宝价格。套装采购不默认比散买便宜，实际比较“含哪些已兼容配件”的总价。

### 12.5 平替必须达到的共同效果

“同样效果”在本项目中定义为**同一套整机验收目标**，不是宣称与NOMI无刷机构、进口轴承寿命或高端音频硬件所有参数一样。没有实测时只能按相同目标选型，不能承诺已等效。

- 带实际头壳/屏/相机，在软目标±45°内转向并回中；提出的首轮目标为头角误差≤3°、单次转向约1–2s，均须实测和反馈确认，不是当前已实现性能。若廉价舵机的保持啸叫/抖动影响会议，即判不达标，换经过测试的驱动，而非继续声称等效。
- 固定底座不随头走，线束不卷/夹；连续50次左右转向观察无断屏/断帧/复位，作为首轮检查而非寿命认证。
- 打样后整机联跑30分钟，记录板端压降、温升、连接与录音；转头噪声与人声同条件比较，检测是否影响实际语音链路。
- 语音清晰、本人才确认后才提醒、实体停止确实停止；打印面罩不能堵麦或挡屏。
- 正式壳以材料实物灰＋黑框呈现整洁哑光，允许均匀细层纹，不接受大支撑疤、拉丝、缺层和翘边；滑盖/按钮顺畅、接缝整齐。无打磨喷漆条件下不承诺注塑光面或与AI整片玻璃脸相同。

打印完整路线见[PRINT_PLAN.md](PRINT_PLAN.md)。

## 官方来源（2026-10-10复核）

- [S1 Korvo-2 V3.1用户指南](https://docs.espressif.com/projects/esp-adf/en/latest/multimedia-boards/dev-boards/user-guide-esp32-s3-korvo-2.html)：板载双麦、音频器件、Micro-B、供电、LCD/摄像接口与GPIO分配。
- [S2 Korvo-2-LCD V1.0用户指南](https://docs.espressif.com/projects/esp-adf/en/latest/multimedia-boards/dev-boards/user-guide-esp32-s3-korvo-2-lcd.html)：配套2.4英寸320×240 SPI显示、FPC连接方式；页面标题为V1.0。
- [S3 LCD V1.0 PCB图](https://dl.espressif.com/dl/schematics/PCB_ESP32-S3-KORVO-2-LCD_V1.0_20210918.pdf)：79.4×58.4 mm板形。63.4 mm不是板高。
- [S4 Korvo-2 V3.1.2原理图](https://dl.espressif.com/dl/schematics/SCH_ESP32-S3-Korvo-2_V3.1.2_20240116.pdf)：从当前V3.1指南链接取得；连接器和电气接法须按实物版本再次核对。
- [S5 Korvo-2 V3.1 PCB图](https://dl.espressif.com/dl/schematics/PCB_ESP32-S3-Korvo-2_V3.1_20221104.pdf)：115×80 mm板形。
- [S6 TowerPro SG90 Digital](https://towerpro.com.tw/product/sg90-7/)：本体尺寸、供电与外部适配器说明；厂家回复提醒普通舵机不默认180°。
- [S7 乐鑫esp32-camera官方驱动](https://github.com/espressif/esp32-camera)：支持OV2640及ESP32-S3，图像格式/缓冲和性能由驱动配置决定，不保证任意排线/模块自动兼容。

- [S8 TowerPro MG90S官方规格](https://towerpro.com.tw/product/mg90s-3/)：标称本体、金属齿、外部供电；不证明仿制件同等效果。
- [S9 NSK 6806官方尺寸](https://www.nsk.com/in-en/engineering/6806-apn.html)：30×42×7mm；用于尺寸级参考，国产品牌实际公差/密封/润滑需单独核验。
- [S10 Bambu PC官方说明](https://bambulab.cn/zh-cn/filament/pc)：透明白60103、封箱、烘干、Brim及推荐温度。
- [S11 Bambu PAHT-CF官方说明](https://bambulab.cn/zh-cn/filament/paht-cf)：PA12＋CF、黑70100、硬化喷嘴、干燥与推荐温度。
- [S12 Epilog PC激光加工说明](https://www.epiloglaser.com/how-it-works/faq/can-you-cut-engrave-polycarbonate-with-laser-machine/)及[材料兼容表](https://www.epiloglaser.com/en-uk/how-it-works/laser-material-compatibility/)：PC薄板可出现热变色；本方案不用它替代高质感PMMA屏窗，实际切割需设备白名单。
- [S13 Bambu H2S官方购买指南](https://bambulab.com/it/support/buying-guide)与[官方产品页](https://bambulab.cn/zh-cn/h2s)：腔温/热端、AMS支持；单喷嘴不等于不能换料，但专用界面料兼容性须核验。
- [S14 H2S官方孔径补偿条件](https://us.store.bambulab.com/en/products/h2s?from=home_page_3dprinter)：需启用功能并采用指定Bambu耗材；仍不替代实际配合试验。

- [S15 PLA Matte官方产品页](https://us.store.bambulab.com/products/pla-matte)及[官方干燥建议](https://wiki.bambulab.com/en/filament-acc/filament/dry-filament)：哑光表面、全机型/全喷嘴兼容；干燥为“建议非强制”，PLA 档 45–70℃，80℃ 属 ABS/ASA 档。

外观参考另见蔚来官方ES6页面的NOMI栏目：只借鉴圆润头部、短颈和面向人的转向表达，不把其电机、屏幕、尺寸或性能当成本项目采购规格。

### v5打印件配套更新（仍属于本表第12节，不是第二份采购清单）

- 41件独立打印候选及数量见 [v5件表](revision-20261011-nomi-layoutA/print-split-v5/PARTS.md)。打印通道、托架、夹座、轮与导向件，不另购同类定制加工件。
- 已含套装屏/摄像头不重复购买。带轮齿槽虽然已建，仍是圆弧候选齿形；先用真实GT2带/原配舵盘试配，M03带长不直接按228下单。
- M09从热装嵌件优先改为标准捕获螺母，减少操作。M3×70共8支仅为当前几何样品用量；其余小螺钉、螺母和声学垫按装配清单核补。
- 固定双麦声管与杯内出音导向已建，C06只补实际所需薄密封垫/柔性护套，不增加透明屏窗、圆屏、喷漆或大幅机加工。
- 当前脚位、驱动、密封、供电、热/强度与真实功能依旧未验收。
