eleanor-wsyy/EffMeet2/hardware/robot-design/round-yaw-v2/revision-20261011-nomi-layoutA/print-split-v6/review-20261016-measure/02_回填数据.csv

id | measure | ref_mm | criteria | photo | photo_estimate_mm | photo_conclusion | actual_mm | tolerance | r1 | r2 | r3 | status | note | evidence
B1 | 齿距（连续10齿总长÷10） | 2.0 | 不跳齿 |  | — | 无照片——未拍摄 |  |  |  |  |  | UNVERIFIED |  | 用户实测（直尺，±0.5mm）
B1 | 带宽 | 6 | 带轮槽配合 |  | — | 无照片——未拍摄 |  |  |  |  |  | UNVERIFIED |  | 用户实测（直尺，±0.5mm）
B1 | 节线长（绕内圈） | 188 | 188±1；张紧槽±2兜底 |  | — | 无照片——未拍摄 |  |  |  |  |  | UNVERIFIED |  | 用户实测（直尺，±0.5mm）
B2① | 外径 OD | 42 | 落入座孔轻压入（座孔按 42.3 打） | B2_轴承_端面搭尺.jpg | ≈42 | 与标称一致（量级核对，不可用于公差判定） |  |  |  |  |  | UNVERIFIED | 0.3mm 补偿量，直尺无法判定 | 用户实测（直尺，±0.5mm）
B2① | 内径 ID | 30 | 套 P11 Ø29.8 顺滑 | B2_轴承_端面搭尺.jpg | ≈30 | 与标称一致（量级核对） |  |  |  |  |  | UNVERIFIED | 建议用 Ø29.8 打印样片试配 | 用户实测（直尺，±0.5mm）
B2① | 宽度 | 7 | 轴向定位 |  | — | 照片未拍到轴向侧视 |  |  |  |  |  | UNVERIFIED | 需补拍或卡尺 | 用户实测（直尺，±0.5mm）
B2① | 盖类型 | 金属盖 | ZZ 金属盖 / 2RS 橡胶盖 | B2_轴承_端面搭尺.jpg | — | ★金属密封盖（ZZ）：外圈可见金属挡圈，无橡胶唇 |  |  |  |  |  | UNVERIFIED | 照片可判，结论明确 | 用户实测（直尺，±0.5mm）
B2② | 外径/内径/宽度/盖 | 42/30/7/金属盖 | 同 B2① |  | — | 仅拍到一只，第二只未拍 |  |  |  |  |  | UNVERIFIED | 仓库要求不能推定同批一致 | 用户实测（直尺，±0.5mm）
B3 | 本体长×宽 | 22.4×12.5 | 入 P15 耳架 | B3_舵机_本体长_最佳.jpg | ≈22×≈12 | 与标称一致（量级核对） |  |  |  |  |  | UNVERIFIED |  | 用户实测（直尺，±0.5mm）
B3 | 含耳总长 | 31.8 | 入 P15 耳架 | B3_舵机_耳_辅助线.jpg | ≈31 | 与标称一致（量级核对） |  |  |  |  |  | UNVERIFIED |  | 用户实测（直尺，±0.5mm）
B3 | 耳孔直径 | ≈2.2 | 与 P15 Ø1.8 导孔匹配、螺钉能过 |  | — | 未拍耳孔特写 |  |  |  |  |  | UNVERIFIED | 需塞针法试配 | 用户实测（直尺，±0.5mm）
B3 | 耳孔中心距 | 27.7 | 外边缘距 − 孔径 |  | — | 未拍耳孔特写 |  |  |  |  |  | UNVERIFIED |  | 用户实测（直尺，±0.5mm）
B3 | 底面到耳高 | 22.8 | — |  | — | 照片角度不足，未读 |  |  |  |  |  | UNVERIFIED |  | 用户实测（直尺，±0.5mm）
B3 | 型号/品牌（新增） | — | — | B3_舵机_平躺_标签面.jpg | — | ★TIANKONGRC MG90S Micro servo（标签清晰可辨） |  |  |  |  |  | UNVERIFIED | 与采购型号一致 | 用户实测（直尺，±0.5mm）
B4① | 圆板直径 | 14 | 入压圈/麦袋 | B4_麦克风_正面_对照_近.jpg | ≈13~14 | 与标称一致（量级核对） |  |  |  |  |  | UNVERIFIED |  | 用户实测（直尺，±0.5mm）
B4① | 含焊盘总宽（新增） | — | 压圈/麦袋需容纳 | B4_麦克风_正面_对照_近.jpg | ≈17~18 | ★两侧焊盘向外凸出，总宽明显大于板径 |  |  |  |  |  | UNVERIFIED | 压圈中心孔径需按此复核 | 用户实测（直尺，±0.5mm）
B4① | 板厚 | ≈1 | 压圈夹持 |  | — | 照片无法读（0.5mm 级） |  |  |  |  |  | UNVERIFIED | 需卡尺 | 用户实测（直尺，±0.5mm）
B4① | 含排针总高 | ≈11 | 总高 ≤ 壁袋深 | B4_麦克风_含针总高_近.jpg | ≈11~12 | 与标称一致（量级核对） |  |  |  |  |  | UNVERIFIED |  | 用户实测（直尺，±0.5mm）
B4① | 两排焊孔中心距 | 7.62 | 对应排针孔位 |  | — | 未读到；实物疑为侧焊，需确认是否穿孔 |  |  |  |  |  | UNVERIFIED | 见 05 报告第 3 节 | 用户实测（直尺，±0.5mm）
B4① | 底面小孔是否居中 | 是 | 偏差 ≤0.5mm |  | — | ★未拍到底面——本项无法判定 |  |  |  |  |  | UNVERIFIED | 仓库标为最重要的一张照片 | 用户实测（直尺，±0.5mm）
B4② | 同 B4① | 同 B4① | 同 B4① |  | — | 仅拍到一只，第二只未拍 |  |  |  |  |  | UNVERIFIED |  | 用户实测（直尺，±0.5mm）
B5 | 外圈直径 | 40 | 入 P16 前托架（≤46 宽） | B5_扬声器_背面.jpg | ≈40 | 与标称一致（量级核对） |  |  |  |  |  | UNVERIFIED |  | 用户实测（直尺，±0.5mm）
B5 | 总厚（含焊片） | 17 | ≤17 入 P16 | B5_扬声器_总厚_最佳.jpg | ≈17 | 与标称一致（量级核对） |  |  |  |  |  | UNVERIFIED | 判据是 ≤17，需卡尺确认不超 | 用户实测（直尺，±0.5mm）
B5 | 阻抗/功率（新增） | 4Ω 3W | — | B5_扬声器_背面.jpg | — | 背面钢印可见（与采购规格 4Ω3W 相符） |  |  |  |  |  | UNVERIFIED |  | 用户实测（直尺，±0.5mm）
B6 | 底面长×宽 | 6×6 | 入 P19/P20 |  | — | 无照片——未拍摄 |  |  |  |  |  | UNVERIFIED |  | 用户实测（直尺，±0.5mm）
B6 | 总高 | 5 | 高 5±0.5 入 P20 口袋 |  | — | 无照片——未拍摄 |  |  |  |  |  | UNVERIFIED |  | 用户实测（直尺，±0.5mm）
B6 | 脚距（对角） | 实测 | — |  | — | 无照片——未拍摄 |  |  |  |  |  | UNVERIFIED |  | 用户实测（直尺，±0.5mm）
B7 | 板宽×板长 | 17.7×19.1 | 入 P17 托盘 |  | — | 无照片——未拍摄 |  |  |  |  |  | UNVERIFIED |  | 用户实测（直尺，±0.5mm）
B7 | 两安装孔中心距 | 12.6 | 对 P17 沉孔复核 |  | — | 无照片——未拍摄 |  |  |  |  |  | UNVERIFIED |  | 用户实测（直尺，±0.5mm）
B7 | 安装孔直径 | ≈2.6 | 沉孔 |  | — | 无照片——未拍摄 |  |  |  |  |  | UNVERIFIED |  | 用户实测（直尺，±0.5mm）
B7 | 板厚 | ≈1.6 | 托盘深度 |  | — | 无照片——未拍摄 |  |  |  |  |  | UNVERIFIED |  | 用户实测（直尺，±0.5mm）
B7 | 含排针总高 | ≈11 | 托盘腔体 |  | — | 无照片——未拍摄 |  |  |  |  |  | UNVERIFIED |  | 用户实测（直尺，±0.5mm）
C1 | 螺钉头径（M3/M2.5） | — | 入沉孔 |  | — | 无照片——未拍摄 |  |  |  |  |  | UNVERIFIED |  | 用户实测（直尺，±0.5mm）
C1 | 螺钉头高（M3/M2.5） | — | 入沉孔不凸出 |  | — | 无照片——未拍摄 |  |  |  |  |  | UNVERIFIED |  | 用户实测（直尺，±0.5mm）
C1 | 螺钉杆长 | 对照标称 | — |  | — | 无照片——未拍摄 |  |  |  |  |  | UNVERIFIED |  | 用户实测（直尺，±0.5mm）
C2 | 垫圈外径（M3/M2.5） | 6 / 5 | ≤ 沉台 |  | — | 无照片——未拍摄 |  |  |  |  |  | UNVERIFIED |  | 用户实测（直尺，±0.5mm）
C2 | 垫圈内径 | 实测 | 套得过螺钉 |  | — | 无照片——未拍摄 |  |  |  |  |  | UNVERIFIED |  | 用户实测（直尺，±0.5mm）
C2 | 垫圈厚度 | 0.3 / 0.5 | 垫圈槽深 |  | — | 无照片——未拍摄 |  |  |  |  |  | UNVERIFIED |  | 用户实测（直尺，±0.5mm）
C3 | 螺母对边宽 | ≈5 | 入螺母陷阱不松转 |  | — | 无照片——未拍摄 |  |  |  |  |  | UNVERIFIED |  | 用户实测（直尺，±0.5mm）
C3 | 螺母厚度 | ≈2 | 陷阱深度 |  | — | 无照片——未拍摄 |  |  |  |  |  | UNVERIFIED |  | 用户实测（直尺，±0.5mm）
C4 | M3×70 是否含螺母 | 有 | 含螺母 |  | — | 无照片——未拍摄 |  |  |  |  |  | UNVERIFIED |  | 用户实测（直尺，±0.5mm）
C4 | M3×70 杆长 / 总长 | 70 / ≈73 | 总长 ≈73 |  | — | 无照片——未拍摄 |  |  |  |  |  | UNVERIFIED |  | 用户实测（直尺，±0.5mm）
C5 | 9 线塞入松紧 | — | ≤Ø22 轴孔、≤ 线鞍槽 |  | — | 无照片——未拍摄 |  |  |  |  |  | UNVERIFIED |  | 用户实测（直尺，±0.5mm）
C5 | 线束外径 | 实测 | ≤ 线鞍槽 |  | — | 无照片——未拍摄 |  |  |  |  |  | UNVERIFIED |  | 用户实测（直尺，±0.5mm）
C6 | 硅胶片 厚/背胶 | 2 / — | 厚 ≈2 与杯底 z=2 预算符 |  | — | 无照片——未拍摄 |  |  |  |  |  | UNVERIFIED |  | 用户实测（直尺，±0.5mm）
C6 | EPDM 厚/背胶 | 1 / — | 厚 ≈1 与预算符 |  | — | 无照片——未拍摄 |  |  |  |  |  | UNVERIFIED |  | 用户实测（直尺，±0.5mm）
C7 | 安装柱 高/外径 | — | 与 P29/板位匹配 |  | — | 无照片——未拍摄 |  |  |  |  |  | UNVERIFIED |  | 用户实测（直尺，±0.5mm）
