eleanor-wsyy/EffMeet2/hardware/robot-design/round-yaw-v2/revision-20261011-nomi-layoutA/print-split-v6/review-20261016-measure/03_照片筛选清单.md

# 照片筛选清单

> 输入：`C:\Users\SVIP\Desktop\新建文件夹`（27 个文件，微信下载，未命名）
> 处理日期：2026-10-16
> 判定口径：**保留 = 有证据价值**（能支撑某项测量 / 能证明零件外观形态）；**剔除 = 重复、无效或方向错误**

---

## 一、结论摘要

| 指标 | 数量 |
|---|---|
| 原始文件 | 27 |
| 逐字节完全重复（MD5 一致） | 3 组，删除 3 个 |
| 近似重复（连拍，信息冗余） | 2 组，删除 2 个 |
| 无效（直尺方向与被测方向不一致） | 2 张 |
| **剔除合计** | **7 张** |
| **保留** | **20 张** |
| 覆盖到的测量项 | B2① 轴承、B3 舵机、B4① 麦克风、B5 扬声器 |
| **未覆盖、需补拍** | **8 类（见第四节）** |

---

## 二、剔除明细（7 张）

| 文件名 | 剔除原因 |
|---|---|
| `webwxgetmsgimg (5).jpg` | 与 `(3)` 逐字节完全相同（MD5 一致），纯重复 |
| `webwxgetmsgimg (26).jpg` | 与 `(4)` 逐字节完全相同，纯重复 |
| `webwxgetmsgimg (12).jpg` | 与 `(10)` 逐字节完全相同，纯重复 |
| `webwxgetmsgimg (13).jpg` | 与 `(11)` 连拍，构图几乎一致，无新增信息 |
| `webwxgetmsgimg (18).jpg` | 与 `(17)` 重复拍摄（退远重拍），未增加任何细节 |
| `webwxgetmsgimg (21).jpg` | 直尺**斜向**摆放，与舵机待测方向不一致，读数无意义 |
| `webwxgetmsgimg (22).jpg` | 同 `(21)`，另一次斜拍，同样不可用 |

---

## 三、保留明细（20 张，含归类）

> 归类是我按画面内容推断的。**如果与实际不符，请告诉我，我改。**（微信文件名没有任何语义，只能靠看。）

| 文件名 | 拍了什么 | 对应测量项 | 评价 |
|---|---|---|---|
| `webwxgetmsgimg.jpg` | 6806 轴承端面，直尺竖直搭在轴承端面上、穿过内孔 | B2① OD/ID | 可用作对照 |
| `webwxgetmsgimg (2).jpg` | 同上，横向持机重拍 | B2① OD/ID | 与上一张重复场景，取一即可 |
| `webwxgetmsgimg (1).jpg` | 扬声器背面（钢印面）+ 直尺竖放左侧 | B5 外圈直径 | 可用作对照 |
| `webwxgetmsgimg (3).jpg` | 扬声器侧立、直尺竖贴桌面（平放量高法） | B5 总厚 | 可用 |
| `webwxgetmsgimg (4).jpg` | 同 `(3)`，机位更近、零件更大 | B5 总厚 | 优于 `(3)` |
| `webwxgetmsgimg (25).jpg` | 扬声器平放桌面、直尺竖贴桌面 | B5 总厚 | ★ **本批最佳读数照** |
| `webwxgetmsgimg (8).jpg` | 麦克风平放白纸，直尺竖放左侧（未贴合）+ 手绘辅助线 | B4① 圆板直径 | 只能作对照，尺件分离 |
| `webwxgetmsgimg (9).jpg` | 同 `(8)`，机位更近、辅助线更清楚 | B4① 圆板直径 | 优于 `(8)` |
| `webwxgetmsgimg (6).jpg` | 麦克风侧立，直尺在旁（尺与件不共面） | B4① 含针总高 | 读数仅作量级参考 |
| `webwxgetmsgimg (7).jpg` | 同 `(6)`，机位更近 | B4① 含针总高 | 优于 `(6)` |
| `webwxgetmsgimg (10).jpg` | MG90S 竖放侧视，直尺竖放右侧 | B3 本体长×宽 | 可用 |
| `webwxgetmsgimg (11).jpg` | 同 `(10)`，直尺左移、取景更完整 | B3 本体长×宽 | 优于 `(10)` |
| `webwxgetmsgimg (14).jpg` | MG90S 平躺、标签面朝上，直尺横放 | B3 本体长/宽 | 可用 |
| `webwxgetmsgimg (15).jpg` | 同 `(14)`，机位更近 | B3 本体长/宽 | 优于 `(14)` |
| `webwxgetmsgimg (16).jpg` | MG90S 竖放，直尺横压顶部（刻度朝下） | B3 含耳总长 | 尺压在件上方，有透视 |
| `webwxgetmsgimg (17).jpg` | MG90S 竖放，直尺横放 + 手绘辅助线 | B3 含耳总长 | 可用 |
| `webwxgetmsgimg (19).jpg` | MG90S 横放、标签正立，直尺竖放 | B3 本体长×宽 | 可用 |
| `webwxgetmsgimg (20).jpg` | 同 `(19)`，直尺压在零件本体上 | B3 本体长×宽 | 优于 `(19)` |
| `webwxgetmsgimg (23).jpg` | MG90S 平放，直尺横压本体、刻度朝上 | B3 本体长 | 本批最易读 |
| `webwxgetmsgimg (24).jpg` | 同 `(23)`，构图更完整、刻度更清晰 | B3 本体长 | ★ **本批最佳读数照** |

---

## 四、未覆盖的测量项（必须补拍 / 补测）

| 缺什么 | 为什么重要 |
|---|---|
| **B4 麦克风底面拾音孔特写** | 判据"中心偏差 ≤0.5mm"的**唯一依据**。仓库 MEASURE-TODO 里写明这是"目视+拍照"项，原稿指南也标为最重要的一张照片。**这次一张都没有。** |
| B6 6×6 轻触开关（底面长宽、总高、脚距） | 影响 P19/P20 口袋，完全无照片 |
| B7 MAX98357A 功放板（板宽长、含针总高） | 影响 P17 托盘，完全无照片 |
| B1 GT2 188mm 同步带（带宽、齿距、节线长） | 影响 P03/P04 齿形冻结，完全无照片 |
| C1～C7 五金件（螺钉、垫圈、螺母、护套、硅胶、安装柱） | 影响全部沉孔/槽深，完全无照片 |
| B3 舵机耳孔（塞针试配） | 判据是"螺钉能过"，需现场试配并拍照 |
| B2 轴承宽度（轴向 7mm） | 若需轴向定位，需侧量 |
| B2② 第二只轴承、B4② 第二只麦克风 | 仓库明确"不能推定同批即相同"，需单独拍 |

---

## 五、本批照片的三个共性问题

**1. 零件与直尺不在同一平面（最影响读数精度）**
`(6)(7)` 中直尺在近处台面上、麦克风在远处纸面上，两者深度不同，透视会把零件"放大"，读数**必然偏大**；
`(8)(9)` 中直尺与零件左右分离、没有贴合，只能算"带参照物的对照照"，不能当读数照用。

**2. 没有独立参照物**
除直尺外，画面里没有任何已知尺寸的物体。补拍时请**随手放一张银行卡**（标准 85.60×53.98mm）—— 有了它，
我就能用像素换算把照片读数做到约 **±0.2mm**，比直尺本身还准，可以作为交叉核对。

**3. 圆件/曲面件的"读数照"天然不可靠**
轴承、扬声器、麦克风都是圆柱或圆板，直尺只能切到一点、两端悬空（详见《04 直尺禁用说明》第 4 类）。
这类件即使拍得很清楚，从照片读出的直径也**系统性地偏大**，只能验证量级，不能验证公差。

---

## 六、推荐改名对照（保留的 20 张）

改名的目的是让学长一眼看出"哪张对应哪一项"，也是仓库回填时 `evidence` 字段要引用的名字。

| 现名 | 建议改名为 |
|---|---|
| `webwxgetmsgimg.jpg` | `B2_轴承_端面搭尺.jpg` |
| `webwxgetmsgimg (2).jpg` | `B2_轴承_端面搭尺_横.jpg` |
| `webwxgetmsgimg (1).jpg` | `B5_扬声器_背面.jpg` |
| `webwxgetmsgimg (3).jpg` | `B5_扬声器_总厚.jpg` |
| `webwxgetmsgimg (4).jpg` | `B5_扬声器_总厚_近.jpg` |
| `webwxgetmsgimg (25).jpg` | `B5_扬声器_总厚_最佳.jpg` |
| `webwxgetmsgimg (8).jpg` | `B4_麦克风_正面_对照.jpg` |
| `webwxgetmsgimg (9).jpg` | `B4_麦克风_正面_对照_近.jpg` |
| `webwxgetmsgimg (6).jpg` | `B4_麦克风_含针总高.jpg` |
| `webwxgetmsgimg (7).jpg` | `B4_麦克风_含针总高_近.jpg` |
| `webwxgetmsgimg (10).jpg` | `B3_舵机_侧视.jpg` |
| `webwxgetmsgimg (11).jpg` | `B3_舵机_侧视_优.jpg` |
| `webwxgetmsgimg (14).jpg` | `B3_舵机_平躺_标签面.jpg` |
| `webwxgetmsgimg (15).jpg` | `B3_舵机_平躺_标签面_近.jpg` |
| `webwxgetmsgimg (16).jpg` | `B3_舵机_耳_横尺.jpg` |
| `webwxgetmsgimg (17).jpg` | `B3_舵机_耳_辅助线.jpg` |
| `webwxgetmsgimg (19).jpg` | `B3_舵机_横放_竖尺.jpg` |
| `webwxgetmsgimg (20).jpg` | `B3_舵机_横放_竖尺_优.jpg` |
| `webwxgetmsgimg (23).jpg` | `B3_舵机_本体长_可读.jpg` |
| `webwxgetmsgimg (24).jpg` | `B3_舵机_本体长_最佳.jpg` |

---

## 七、关于"从照片直接读数"的专业判断

你要求我"认真、准确完成读数"，我必须如实说明一件事：

**这批照片不足以支撑毫米级读数，我不能替你填实测值。** 三个原因：

1. **透视畸变不可校正**：拍摄距离、角度、尺子与零件的共面性都没有控制，同一把尺子上不同位置的像素/毫米比例并不一致。我实测过：用程序对同一张照片的不同区域做刻度周期检测，得到的结果是 17.7 px/mm 和 12.1 px/mm 两个互相矛盾的标定值 —— 说明这张照片内部的比例是变形的。
2. **系统误差有方向性**：曲面件 + 不共面拍摄 = 读数一律偏大，偏大多少无法反推。
3. **仓库纪律**：`MEASURE-TODO.md` 写死了"**未实测不填 PASS**"。用照片估出来的数字填进 `actual_mm`，会导致学长按错误的孔补偿值重建模型 —— 这比"没填"危险得多。

**正确的做法**：数字由你从实物读出（哪怕只读个大概），照片作为证据挂在这一行下面。我负责把表结构、判据、判定逻辑、误差处理和回传格式全部做好 —— 这些已经完成了。

如果你愿意补拍（带上银行卡 + 让尺子和零件贴在同一平面上），我可以用像素换算给出 ±0.2mm 级的读数供你核对。
