eleanor-wsyy/EffMeet2/hardware/robot-design/round-yaw-v2/TEST_RECORD_TEMPLATE.csv

test_id | test_name | requirement | status | attempt | prototype_id | hardware_revision | cad_print_revision | wiring_revision | firmware_version | software_commit | operator | executed_at | preconditions | test_steps | expected_result | actual_result | evidence_path | issue | fix_and_retest
T01 | 到货/版本与接线 | 必需 | NOT_RUN | 1 |  |  |  |  |  |  |  |  | 供电前；模块与CAD资料在手 | 逐件核版本、正反面、实测尺寸与接线表；确认导出不是器件代理 | 记录完整；未知针脚/缺安装结构标BLOCKED，不按概念图接线
T02 | 供电与极性 | 必需 | NOT_RUN | 1 |  |  |  |  |  |  |  |  | 接线审核；主板和舵机独立电源分路 | 先主板、后舵机单独上电；记录实际供电点电压与异常；正极不并联 | 供电符合实物范围，无异常发热/复位/反接；峰值数据不会测则留空而非编造
T03 | 启动/烧录/日志 | 必需 | NOT_RUN | 1 |  |  |  |  |  |  |  |  | 真实固件或已注明来源的板卡示例 | 记录版本和启动日志；断电/上电启动3次；确认来源是项目固件还是示例 | 能重复启动/调试；项目功能未实现的部分不得因示例正常就填PASS
T04 | 显示与实际状态 | 必需 | NOT_RUN | 1 |  |  |  |  |  |  |  |  | LCD接法、真实驱动及状态事件可用 | 显示检查图/文字/两眼；触发连接、等待确认、播报、停止/错误状态 | 无花屏、窗口不遮挡；状态与真实事件一致；不得用固定动效假装业务状态
T05 | 相机抓拍/共享 | 必需 | NOT_RUN | 1 |  |  |  |  |  |  |  |  | 真实相机驱动、确认/原图路径可用 | 同一测试卡片在左45°/正向/右45°各拍1张；在合适视场检查原图及确认共享 | 3张可读原图可定位；无意外共享；水平转头不当作俯拍能力
T06 | 物理滑盖 | 必需 | NOT_RUN | 1 |  |  |  |  |  |  |  |  | 相机可获取原图；滑盖已装 | 固定测试卡，滑盖开/关各拍一张，再开；检查镜片和视场 | 关闭时目标不可辨认，开时视场恢复；不把遮镜当断电/断麦
T07 | 机内双麦拾音 | 必需 | NOT_RUN | 1 |  |  |  |  |  |  |  |  | 真实机内音频采集，不是电脑麦 | 同一同意参与者约1m处读5条固定短句，记录裸板/入壳及两麦可观测通道 | 机内输入可用、无缺路/严重削波；记录原音；ASR字错与硬件输入分开分析
T08 | 播放清晰度/声腔 | 必需 | NOT_RUN | 1 |  |  |  |  |  |  |  |  | 真实机内功放/扬声器，测试语音准备 | 约1m处播放同一5句并听辨；比较裸板/装壳，检查杂响/共振 | 语句可懂，无明显破音/松件杂响；记录使用音量，不以3W推断覆盖距离
T09 | 实体停止播报 | 必需 | NOT_RUN | 1 |  |  |  |  |  |  |  |  | 真实播放/停止输入处理已实现 | 播报中按实体按钮，重复5次；同步录屏/音频或事件记录观察停止 | 5次实际出声停止且状态一致；本指南暂定响应≤1s；不是硬件断麦或舵机急停
T10 | 状态灯与异常 | 必需 | NOT_RUN | 1 |  |  |  |  |  |  |  |  | 实际灯状态逻辑可用 | 触发连接、等待/播放/停止和掉线；从正常观察位置核灯 | 不会掉线仍报正常；亮度可见不刺眼，功能与团队冻结状态表一致
T11 | 舵机空载/信号 | 必需 | NOT_RUN | 1 |  |  |  |  |  |  |  |  | 供电/信号已核；无带/无头，安全断电可及 | 用小步低速控制实物，测允许范围和中位，观察保持/复位 | 无未知方向/过行程；记录真实命令映射与额定范围；不默认180°
T12 | 轴承/安装静态 | 必需 | NOT_RUN | 1 |  |  |  |  |  |  |  |  | 断电、带未接或约束已解除 | 检查轴承保持/轴肩/连接盘、起子访问；不强拧舵机；轻转可自由件 | 承重链完整、无明显松旷卡滞/裂纹；头重量不只压舵机轴
T13 | 头角标定 | 必需 | NOT_RUN | 1 |  |  |  |  |  |  |  |  | 中位已定、传动已装、线暂不干涉 | 用顶部纸刻度/量角器或固定顶视画面测头角，记录命令↔实角 | 得到实测映射；首轮暂定三个目标头角误差≤3°；不会把舵机命令当头角
T14 | 低速带载三姿态 | 必需 | NOT_RUN | 1 |  |  |  |  |  |  |  |  | 真实头部载荷、安全限位和断电已准备 | 先小幅、再逐步扩大至左45°/0/右45°；观察间隙、晃动、声音 | 目标可到达、无顶挡/夹线/跳齿/结构损伤；首轮转向约1–2s目标，需实际测量
T15 | 活动FPC与50次转向 | 必需 | NOT_RUN | 1 |  |  |  |  |  |  |  |  | T04/T05/T14通过；开盖可观察 | 左45°→0→右45°→0记1循环，做50循环；保持可观察显示并抓拍检查 | 50循环无断屏/花屏/相机掉线/复位/磨夹线；这不是动态线束寿命认证
T16 | 机械噪声影响 | 必需 | NOT_RUN | 1 |  |  |  |  |  |  |  |  | 机内录音与真实动作可用 | 同位置录保持、转动、同一人声；与舵机断电基线比较 | 无影响听辨/采集的啸叫或撞击；保存可比较记录，不声称分贝或NOMI等效
T17 | 入壳后模块复测 | 必需 | NOT_RUN | 1 |  |  |  |  |  |  |  |  | 基本模块通过，最终盖/软片/足垫已装 | 关闭外壳后复测T04–T10和三姿态，检查Wi-Fi/USB维护访问 | 盖不会挤线/屏、堵麦/声孔或使模块失效；裸板PASS不代替此项
T18 | 本人确认后才提醒 | 必需 | NOT_RUN | 1 |  |  |  |  |  |  |  |  | 真实控制器/确认/设备链路均可用 | 建合成测试会议：未确认时观察无提醒，再由观点本人确认，核实际播报 | 未确认不播报，获允许后内容一致；参与身份和消息可追溯，无真实隐私数据
T19 | 真实播放回执 | 必需 | NOT_RUN | 1 |  |  |  |  |  |  |  |  | 真实驱动和项目回执协议可用 | 对齐命令时间、现场音频与started/completed/failed（按实际契约） | queued/accepted不算出声；完成由实际驱动/排空报告，失败不写成completed
T20 | 重复/过期/重启防重播 | 必需 | NOT_RUN | 1 |  |  |  |  |  |  |  |  | 控制器去重/过期机制、真实设备可用 | 同ID重试；测过期候选；设备重启后观察旧提醒是否再次执行 | 同一次授权不重复实播；过期不执行；不靠删除账本绕过，具体按契约
T21 | 断网与恢复 | 必需 | NOT_RUN | 1 |  |  |  |  |  |  |  |  | 完整设备/服务链路，安全可恢复网络 | 临时断设备Wi-Fi并恢复；观察灯/屏/日志与旧提醒处理 | 掉线真实可见；恢复不自动重复旧提醒；未完成的播报按真实规则报告
T22 | 断电/上电恢复 | 必需 | NOT_RUN | 1 |  |  |  |  |  |  |  |  | 所有运动先停，已确认开机动作规则 | 记录正向后停止运动，按规断电再上电；观察启动朝向/旧提醒 | 无不受控冲向硬挡/拉线，旧提醒不自动重播；这不是断电中暴力冲击测试
T23 | 30分钟组合运行/供电温升 | 必需 | NOT_RUN | 1 |  |  |  |  |  |  |  |  | 整机与业务基本通过，有同意测试人员 | 显示/联网/录音持续，间歇播放和转头共30分钟；记环境/起止温度和故障 | 无复位/断连/异常气味或破损；温度低于各实物允许值；无统一未经依据的安全温度
T24 | 外观/桌面稳定/可维护 | 必需 | NOT_RUN | 1 |  |  |  |  |  |  |  |  | 最终组装和常用桌面 | 检查细层纹/大疤/毛刺，三姿态底座滑移；断电后拆盖复装1次 | 无大疤/裂纹/翘边、明显滑移/倾覆风险；可拆且不伤线；细层纹允许
T25 | AEC与双讲 | 产品目标必需；初样不可用则BLOCKED | NOT_RUN | 1 |  |  |  |  |  |  |  |  | 机内播放参考、真实AFE/AEC、双麦录音可用 | 分别录只有机器人播报、只有人声、播报与人声同时；使用合成内容 | 保留原始输入/输出、参考配置与结论；暂停采集/电脑麦不能当AEC；未实现不得勾PASS
T26 | 测试记录/版本交接 | 必需 | NOT_RUN | 1 |  |  |  |  |  |  |  |  | 本轮所有记录可汇总 | 填CSV、接线和标定、硬件/CAD/固件版本、失败修复与重测 | 每项有实际结果及证据；BLOCKED/FAIL保留，不能以全部“计划”宣称验收完成
