eleanor-wsyy/EffMeet2/hardware/robot-design/round-yaw-v2/revision-20261011-nomi-layoutA/print-split-v6/review-20261016-measure/01_测量结果总表.xlsx

Sheet: 1-测量结果
编号 | 测量项 | 标称/预算 | 接受判据（仓库原文） | 直尺可行性 | 照片估算(mm) | 照片可判结论 | 实测值(mm) | 误差(mm) | r1 | r2 | r3 | 结论 | 照片 | 备注
B1 | 齿距（连续10齿总长÷10） | 2.0 | 不跳齿 | 可行 | — | 无照片——未拍摄 |  |  |  |  |  | 待实测
B1 | 带宽 | 6 | 带轮槽配合 | 勉强 | — | 无照片——未拍摄 |  |  |  |  |  | 待实测
B1 | 节线长（绕内圈） | 188 | 188±1；张紧槽±2兜底 | 勉强 | — | 无照片——未拍摄 |  |  |  |  |  | 待实测
B2① | 外径 OD | 42 | 落入座孔轻压入（座孔按 42.3 打） | 不可行 | ≈42 | 与标称一致（量级核对，不可用于公差判定） |  |  |  |  |  | 待实测 | B2_轴承_端面搭尺.jpg | 0.3mm 补偿量，直尺无法判定
B2① | 内径 ID | 30 | 套 P11 Ø29.8 顺滑 | 不可行 | ≈30 | 与标称一致（量级核对） |  |  |  |  |  | 待实测 | B2_轴承_端面搭尺.jpg | 建议用 Ø29.8 打印样片试配
B2① | 宽度 | 7 | 轴向定位 | 勉强 | — | 照片未拍到轴向侧视 |  |  |  |  |  | 待实测 |  | 需补拍或卡尺
B2① | 盖类型 | 金属盖 | ZZ 金属盖 / 2RS 橡胶盖 | 目视 | — | ★金属密封盖（ZZ）：外圈可见金属挡圈，无橡胶唇 |  |  |  |  |  | 待实测 | B2_轴承_端面搭尺.jpg | 照片可判，结论明确
B2② | 外径/内径/宽度/盖 | 42/30/7/金属盖 | 同 B2① | 不可行 | — | 仅拍到一只，第二只未拍 |  |  |  |  |  | 待实测 |  | 仓库要求不能推定同批一致
B3 | 本体长×宽 | 22.4×12.5 | 入 P15 耳架 | 可行 | ≈22×≈12 | 与标称一致（量级核对） |  |  |  |  |  | 待实测 | B3_舵机_本体长_最佳.jpg
B3 | 含耳总长 | 31.8 | 入 P15 耳架 | 可行 | ≈31 | 与标称一致（量级核对） |  |  |  |  |  | 待实测 | B3_舵机_耳_辅助线.jpg
B3 | 耳孔直径 | ≈2.2 | 与 P15 Ø1.8 导孔匹配、螺钉能过 | 不可行 | — | 未拍耳孔特写 |  |  |  |  |  | 待实测 |  | 需塞针法试配
B3 | 耳孔中心距 | 27.7 | 外边缘距 − 孔径 | 不可行 | — | 未拍耳孔特写 |  |  |  |  |  | 待实测
B3 | 底面到耳高 | 22.8 | — | 可行 | — | 照片角度不足，未读 |  |  |  |  |  | 待实测
B3 | 型号/品牌（新增） | — | — | 目视 | — | ★TIANKONGRC MG90S Micro servo（标签清晰可辨） |  |  |  |  |  | 待实测 | B3_舵机_平躺_标签面.jpg | 与采购型号一致
B4① | 圆板直径 | 14 | 入压圈/麦袋 | 可行 | ≈13~14 | 与标称一致（量级核对） |  |  |  |  |  | 待实测 | B4_麦克风_正面_对照_近.jpg
B4① | 含焊盘总宽（新增） | — | 压圈/麦袋需容纳 | 直尺 | ≈17~18 | ★两侧焊盘向外凸出，总宽明显大于板径 |  |  |  |  |  | 待实测 | B4_麦克风_正面_对照_近.jpg | 压圈中心孔径需按此复核
B4① | 板厚 | ≈1 | 压圈夹持 | 不可行 | — | 照片无法读（0.5mm 级） |  |  |  |  |  | 待实测 |  | 需卡尺
B4① | 含排针总高 | ≈11 | 总高 ≤ 壁袋深 | 可行 | ≈11~12 | 与标称一致（量级核对） |  |  |  |  |  | 待实测 | B4_麦克风_含针总高_近.jpg
B4① | 两排焊孔中心距 | 7.62 | 对应排针孔位 | 勉强 | — | 未读到；实物疑为侧焊，需确认是否穿孔 |  |  |  |  |  | 待实测 |  | 见 05 报告第 3 节
B4① | 底面小孔是否居中 | 是 | 偏差 ≤0.5mm | 目视+拍照 | — | ★未拍到底面——本项无法判定 |  |  |  |  |  | 待实测 |  | 仓库标为最重要的一张照片
B4② | 同 B4① | 同 B4① | 同 B4① | 混合 | — | 仅拍到一只，第二只未拍 |  |  |  |  |  | 待实测
B5 | 外圈直径 | 40 | 入 P16 前托架（≤46 宽） | 可行 | ≈40 | 与标称一致（量级核对） |  |  |  |  |  | 待实测 | B5_扬声器_背面.jpg
B5 | 总厚（含焊片） | 17 | ≤17 入 P16 | 可行 | ≈17 | 与标称一致（量级核对） |  |  |  |  |  | 待实测 | B5_扬声器_总厚_最佳.jpg | 判据是 ≤17，需卡尺确认不超
B5 | 阻抗/功率（新增） | 4Ω 3W | — | 目视 | — | 背面钢印可见（与采购规格 4Ω3W 相符） |  |  |  |  |  | 待实测 | B5_扬声器_背面.jpg
B6 | 底面长×宽 | 6×6 | 入 P19/P20 | 可行 | — | 无照片——未拍摄 |  |  |  |  |  | 待实测
B6 | 总高 | 5 | 高 5±0.5 入 P20 口袋 | 勉强 | — | 无照片——未拍摄 |  |  |  |  |  | 待实测
B6 | 脚距（对角） | 实测 | — | 勉强 | — | 无照片——未拍摄 |  |  |  |  |  | 待实测
B7 | 板宽×板长 | 17.7×19.1 | 入 P17 托盘 | 可行 | — | 无照片——未拍摄 |  |  |  |  |  | 待实测
B7 | 两安装孔中心距 | 12.6 | 对 P17 沉孔复核 | 不可行 | — | 无照片——未拍摄 |  |  |  |  |  | 待实测
B7 | 安装孔直径 | ≈2.6 | 沉孔 | 不可行 | — | 无照片——未拍摄 |  |  |  |  |  | 待实测
B7 | 板厚 | ≈1.6 | 托盘深度 | 不可行 | — | 无照片——未拍摄 |  |  |  |  |  | 待实测
B7 | 含排针总高 | ≈11 | 托盘腔体 | 可行 | — | 无照片——未拍摄 |  |  |  |  |  | 待实测
C1 | 螺钉头径（M3/M2.5） | — | 入沉孔 | 勉强 | — | 无照片——未拍摄 |  |  |  |  |  | 待实测
C1 | 螺钉头高（M3/M2.5） | — | 入沉孔不凸出 | 不可行 | — | 无照片——未拍摄 |  |  |  |  |  | 待实测
C1 | 螺钉杆长 | 对照标称 | — | 可行 | — | 无照片——未拍摄 |  |  |  |  |  | 待实测
C2 | 垫圈外径（M3/M2.5） | 6 / 5 | ≤ 沉台 | 勉强 | — | 无照片——未拍摄 |  |  |  |  |  | 待实测
C2 | 垫圈内径 | 实测 | 套得过螺钉 | 不可行 | — | 无照片——未拍摄 |  |  |  |  |  | 待实测
C2 | 垫圈厚度 | 0.3 / 0.5 | 垫圈槽深 | 勉强 | — | 无照片——未拍摄 |  |  |  |  |  | 待实测
C3 | 螺母对边宽 | ≈5 | 入螺母陷阱不松转 | 可行 | — | 无照片——未拍摄 |  |  |  |  |  | 待实测
C3 | 螺母厚度 | ≈2 | 陷阱深度 | 勉强 | — | 无照片——未拍摄 |  |  |  |  |  | 待实测
C4 | M3×70 是否含螺母 | 有 | 含螺母 | 目视 | — | 无照片——未拍摄 |  |  |  |  |  | 待实测
C4 | M3×70 杆长 / 总长 | 70 / ≈73 | 总长 ≈73 | 可行 | — | 无照片——未拍摄 |  |  |  |  |  | 待实测
C5 | 9 线塞入松紧 | — | ≤Ø22 轴孔、≤ 线鞍槽 | 主观 | — | 无照片——未拍摄 |  |  |  |  |  | 待实测
C5 | 线束外径 | 实测 | ≤ 线鞍槽 | 可行 | — | 无照片——未拍摄 |  |  |  |  |  | 待实测
C6 | 硅胶片 厚/背胶 | 2 / — | 厚 ≈2 与杯底 z=2 预算符 | 勉强 | — | 无照片——未拍摄 |  |  |  |  |  | 待实测
C6 | EPDM 厚/背胶 | 1 / — | 厚 ≈1 与预算符 | 勉强 | — | 无照片——未拍摄 |  |  |  |  |  | 待实测
C7 | 安装柱 高/外径 | — | 与 P29/板位匹配 | 可行 | — | 无照片——未拍摄 |  |  |  |  |  | 待实测

Sheet: 2-照片索引
原文件名 | 建议改名 | 拍了什么 | 判定 | 用途
webwxgetmsgimg.jpg | B2_轴承_端面搭尺.jpg | 6806 轴承端面 + 直尺竖搭穿内孔 | 保留 | B2① OD/ID 对照、盖类型
webwxgetmsgimg (2).jpg | B2_轴承_端面搭尺_横.jpg | 同上横向重拍 | 保留 | 与上一张同场景，取一即可
webwxgetmsgimg (1).jpg | B5_扬声器_背面.jpg | 扬声器背面钢印 + 直尺 | 保留 | B5 外径对照、阻抗功率
webwxgetmsgimg (3).jpg | B5_扬声器_总厚.jpg | 扬声器侧立 + 尺竖贴桌面 | 保留 | B5 总厚
webwxgetmsgimg (4).jpg | B5_扬声器_总厚_近.jpg | 同 (3) 更近 | 保留 | B5 总厚
webwxgetmsgimg (25).jpg | B5_扬声器_总厚_最佳.jpg | 扬声器平放 + 尺竖贴桌面 | 保留 | ★B5 最佳读数照
webwxgetmsgimg (8).jpg | B4_麦克风_正面_对照.jpg | 麦克风平放白纸 + 尺左侧 | 保留 | 形态对照
webwxgetmsgimg (9).jpg | B4_麦克风_正面_对照_近.jpg | 同 (8) 更近 | 保留 | ★形态最清晰
webwxgetmsgimg (6).jpg | B4_麦克风_含针总高.jpg | 麦克风侧立 + 尺在旁 | 保留 | 含针总高（量级）
webwxgetmsgimg (7).jpg | B4_麦克风_含针总高_近.jpg | 同 (6) 更近 | 保留 | 含针总高（量级）
webwxgetmsgimg (10).jpg | B3_舵机_侧视.jpg | 舵机竖放侧视 + 尺竖放 | 保留 | 本体长×宽
webwxgetmsgimg (11).jpg | B3_舵机_侧视_优.jpg | 同 (10) 尺左移 | 保留 | 本体长×宽
webwxgetmsgimg (14).jpg | B3_舵机_平躺_标签面.jpg | 舵机平躺标签面 + 尺横放 | 保留 | 型号标签
webwxgetmsgimg (15).jpg | B3_舵机_平躺_标签面_近.jpg | 同 (14) 更近 | 保留 | 型号标签（最清晰）
webwxgetmsgimg (16).jpg | B3_舵机_耳_横尺.jpg | 舵机竖放 + 尺横压顶部 | 保留 | 含耳总长
webwxgetmsgimg (17).jpg | B3_舵机_耳_辅助线.jpg | 舵机竖放 + 尺横放 + 辅助线 | 保留 | 含耳总长
webwxgetmsgimg (19).jpg | B3_舵机_横放_竖尺.jpg | 舵机横放标签正立 + 尺竖放 | 保留 | 本体长×宽
webwxgetmsgimg (20).jpg | B3_舵机_横放_竖尺_优.jpg | 同 (19) 尺压本体 | 保留 | 本体长×宽
webwxgetmsgimg (23).jpg | B3_舵机_本体长_可读.jpg | 舵机平放 + 尺横压本体 | 保留 | 本体长
webwxgetmsgimg (24).jpg | B3_舵机_本体长_最佳.jpg | 同 (23) 更完整 | 保留 | ★B3 最佳读数照

Sheet: 3-汇总
项目 | 数量 | 说明
测量项总数 | 47 | 对齐仓库 MEASURE-TODO v2（B1~B7 / C1~C7）+ 3 项照片新增
照片可判（有结论） | 21 | 含定性判定 3 项 + 量级核对 8 项
其中：定性判定（可直接用） | 3 | 轴承盖类型、舵机型号、扬声器阻抗功率
其中：量级核对（±1~2mm） | 8 | 与标称一致，但不能用于 0.5mm 级公差判定
其中：★照片新增发现 | 3 | 麦克风含焊盘总宽、麦克风侧焊排针、轴承金属盖
照片未覆盖 | 26 | B1、B6、B7、C1~C7 全部
照片拍摄但读不出 | 5 | 0.5mm 级项或角度不足（B2 宽、B3 耳孔/耳距/底到耳、B4 板厚）
纪律 |  | 未实测不填 PASS；已测未装机只能写 MEASURED_UNFITTED；照片估算值不得填入 actual_mm
