eleanor-wsyy/EffMeet2/hardware/robot-design/archive/seat-card-v1/BOM.md

> **已归档：不用于当前采购。** LCD版本/接口针数/扬声器官方归因的更正见[当前BOM第2节](../../round-yaw-v2/BOM.md#2-本次复核修正)。以下保留历史方案内容。

# 在议 席位牌方案 · 新版硬件采购清单

更新：2026-10-10（北京时间）
对应外观：01「桌面席位牌」；对应模型：席位牌封装布局 v1（可逆占位阶段）。

> 本清单以用户提供的《EffMeet2-硬件采购清单-分享版.md》（2026-10-09）为基础，补齐显示、机构支撑、线束及声学配套。原文件不改动。淘宝链接全部是**搜索入口，不是经过核验的商品页或兼容性承诺**。未锁定实际商品，不列虚构价格。已有器件先核对，不重复采购。

## 一、与外观方案绑定的决定

- 开发板基线采用**乐鑫原版 ESP32-S3-Korvo-2 V3.1**。克隆板、精简板和其他版本不自动适用本模型。
- 主板约115×80 mm，LCD扩展板约79.4×58.4 mm，分别来源于官方PCB图。之前讨论中LCD的63.4 mm不应作为板高使用；本版按官方58.4 mm修正。
- 主板在上部机身后层，LCD在前层，摄像头在前面板右上；扬声器移至底座前部，舵机位于底座后部。这样不必把扬声器塞在显示板下方。
- 整机占位目标约**148宽×118深×188高 mm**；主机身148×84×120 mm，底座136×118×50 mm，名义壳厚2.4 mm。尺寸是当前封装方案，**不是实物验收尺寸或打印放行尺寸**。
- 使用原版主板的Micro-USB接口，暂不做USB-C外接改造；电源适配器/充电宝外置，无内置电池。
- 灯带改为短状态窗；麦克风孔必须与板载双麦及声学通道对齐，不照抄AI图片上的孔阵。

## 二、电子部分：先买或核对已有套装

| ID | 物品与数量 | 与本方案对应的规格/要求 | 搜索入口 | 下单前核验 |
|---|---|---|---|---|
| E01 | Korvo-2 V3.1 音频开发板，1块 | 官方板形115×80 mm；板载双麦、音频ADC与功放；核对PSRAM、板卡版本及固件资料 | [搜索](https://s.taobao.com/search?q=%E4%B9%90%E9%91%AB%20ESP32-S3-Korvo-2%20V3.1%20%E5%BC%80%E5%8F%91%E6%9D%BF) | 必须提供正反面照片、PCB版本、接口图；若已买原版先不重买 |
| E02 | Korvo-2-LCD V1.1 显示扩展板，1套 | 官方2.4英寸配套LCD方案；扩展板79.4×58.4 mm；要求带LCD与主板连接所需配件 | [搜索](https://s.taobao.com/search?q=ESP32-S3-Korvo-2-LCD%20V1.1%202.4%E5%AF%B8) | 原清单漏项；确认LCD已焊/已装、主板兼容版本、全部排线及连接图。不是随便买一块2.4寸SPI屏就算等价 |
| E03 | 配套OV2640摄像头，1个 | 与E01/E02选定连接路径匹配；本模型暂按模块20×10×18 mm、预留24×16×20 mm占位 | [搜索](https://s.taobao.com/search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) | 官方主板与LCD扩展板摄像接口存在针数差异（主板18 pin、LCD板14 pin）；必须由商家确认具体连接路径、针脚、排线方向和驱动。外形超出占位时先改模型 |
| E04 | 主板↔LCD、摄像头配套FPC，按套装缺口 | 只补缺少的排线，不盲买“通用摄像头排线” | 随E02/E03配套 | 要求针数、间距、同向/反向、长度及插头朝向；已有配套则数量为0 |
| E05 | 小型扬声器，1只 | **4Ω**；候选额定3W，须与板载NS4150实际工作点匹配；圆形外径≤40 mm、总深度≤18 mm；本模型按此采购上限占位 | [搜索](https://s.taobao.com/search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) | 官方指导要求4Ω，不使用8Ω替代；接头/极性与主板匹配；尺寸应含磁钢、焊片及线头，不能只看纸盆直径 |
| E06 | Micro-USB数据线，1条；供电线按需1条 | 用于UART联调与板卡供电；数据线必须能传数据 | [搜索](https://s.taobao.com/search?q=Micro%20USB%20%E6%95%B0%E6%8D%AE%E7%BA%BF%20%E5%8F%AF%E4%BC%A0%E6%95%B0%E6%8D%AE) | 原清单USB-C泛称不适用于原版板；核对插头突出和弯线空间。双USB口供电路径未核验前，不能直接并联两路5V |
| E07 | 主板5V电源，1个或复用已有 | 符合官方5V、至少2A要求；选择有合规标识的正规产品 | [搜索](https://s.taobao.com/search?q=5V%202A%20USB%20%E7%94%B5%E6%BA%90%E9%80%82%E9%85%8D%E5%99%A8) | 电压、电流、接口；确认E06能提供该电流；充电宝可选外置替代，不重复买 |
| E08 | 3.3V逻辑兼容的停止/静音轻触按键，1套 | 头顶实体按键；采购小尺寸开关与连接件，不选大尺寸成品模块 | [搜索](https://s.taobao.com/search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) | 由B/C确认GPIO、上拉/下拉和去抖。**普通GPIO按键只实现软件停止/静音，不等于硬件断麦** |
| E09 | 小型状态LED及限流/驱动配套，1套 | 短状态窗，不买一圈灯带；3.3V逻辑兼容 | [搜索](https://s.taobao.com/search?q=3.3V%20RGB%20LED%20%E5%B0%8F%E6%A8%A1%E5%9D%97) | 确认GPIO余量、驱动电流、板尺寸；若复用板载指示灯可不新增；不得默认与LCD/摄像引脚无冲突 |

**套装优先规则：** 如果E01套装已含LCD、摄像头、FPC或扬声器，逐项勾选后再购买缺件；不要按整张表重复下单。

## 三、转向与机构：先验证，再锁外壳

| ID | 物品与数量 | 对应模型/采购要求 | 搜索入口 | 状态 |
|---|---|---|---|---|
| M01 | SG90舵机，1只或复用已有 | 官方本体23×12.2×29 mm；模型为舵盘、支架及线束合计预留35×25×44 mm；轴偏置仍需实测 | [搜索](https://s.taobao.com/search?q=TowerPro%20SG90%20%E8%88%B5%E6%9C%BA%20%E5%B0%BA%E5%AF%B8%E5%9B%BE) | 先做空载和实际头部负载试验。未测头部重量、重心、摩擦和峰值电流，不能承诺该型号可稳定驱动整机 |
| M02 | 独立转台支撑组件，1套 | 包括支撑轴承/转盘、连接盘、舵机固定架；当前预留约Ø56×14 mm，仅是占位，不是标准件型号 | [搜索](https://s.taobao.com/search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) | **暂缓定型采购**。需要供应商机械图与舵盘孔距，不能让舵机输出轴单独承受整机头部重量；确认后更新支撑结构 |
| M03 | 舵机独立5V供电与配线，1套 | 台架初始可用独立5V/2A电源＋受保护的5V引出配线；最终容量按峰值实测确定；与主板信号共地 | [搜索](https://s.taobao.com/search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) | 不从ESP32的3.3V脚供电；不要把两路5V正极直接并联。单电源方案需先完成电流预算、分支保护及噪声验证 |
| M04 | 连接线与可锁接插件，少量 | 杜邦线仅用于台架；外壳内最终采用固定、绝缘、带应力释放的连接 | [搜索](https://s.taobao.com/search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) | 由板卡实际接口确定，不预设JST规格；旋转线束须留活动圈，避开转轴夹点 |
| M05 | 铜柱/尼龙柱、螺丝垫片，小包 | 核孔后选择；开发阶段可准备M2.5/M3少量样件和5/8/10 mm柱试装 | [搜索](https://s.taobao.com/search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) | 本模型没有冻结真实孔位和螺纹结构，禁止按图直接批量买定长螺钉 |
| M06 | 扬声器密封垫、麦克风声学密封材料，少量 | 试装薄泡棉/硅胶密封，避免声短路并隔离不必要泄漏 | [搜索](https://s.taobao.com/search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) | 不堵拾音口、不触碰振膜；声学通道与AEC须实测，不因材料存在就算通过 |
| M07 | 相机物理遮罩、按键帽、状态窗导光件，各1 | 作为定制小件，与前面板装配；无需购买一整套陌生结构 | 随外壳设计制作 | 现在只是位置占位；还缺滑槽、限位、按键行程、固定方法与光学遮挡核验 |
| M08 | 底部防滑硅胶片，1套 | 模型占位约132×114×2 mm，可按定稿裁切 | [搜索](https://s.taobao.com/search?q=2mm%20%E7%A1%85%E8%83%B6%20%E9%98%B2%E6%BB%91%20%E5%9E%AB%20%E8%87%AA%E7%B2%98) | 实际厚度、胶层和转台稳定性试装后确认 |
| M09 | 外壳打印与内支架，1套 | 先核实物尺寸再打样；名义壁厚2.4 mm只是建模起点 | [搜索](https://s.taobao.com/search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) | **暂不下单正式壳体。** 未完成安装柱、轴承座、排线通道、声学通道、紧固和打印公差；当前不提供打印放行STL |

## 四、当前不买 / 条件购买

- **额外麦克风/麦阵列：** 原版板已有双麦；仅在实物缺少或声学路线变更时再选，不默认再加一套。
- **额外I2S功放：** 原版板已有NS4150；不要重复买，也不要另接未经匹配的功放改变AEC播放参考路径。
- **USB-C面板口或PD触发板：** 当前用Micro-USB；若后续改USB-C，必须单独验证CC、5V供电、数据与防回灌电路，不作为外观装饰直接接线。
- **内置电池、充电板、升降压板：** 当前外置5V供电，无内置电池方案，不提前采购。
- **整圈RGB灯带、大体积按键板、通用摄像头、异形显示屏：** 不符合当前方案或尚未核验；黑面板为遮蔽盖板，内部仍用矩形LCD，不需要定制异形屏。
- **MG90S等替代舵机：** 仅在负载试验表明有必要时评估；“金属齿轮”不代表孔位、轴高、供电、转角或扭矩已满足，替换前更新模型。

**硬件静音承诺待实现：** 如果展板仍保留“硬件断麦”，B/C必须另行设计并验证麦克风断开方案；E08的普通GPIO按键不能证明该功能已实现，不能仅凭外观宣称硬件断麦。

## 五、给商家的核验问题（可直接复制）

1. 主板是否为ESP32-S3-Korvo-2 V3.1？请给正反面照片、版本丝印和机械尺寸图。
2. LCD是否为Korvo-2-LCD V1.1配套板？是否包含2.4寸LCD、全部FPC、摄像头和安装件？
3. 请说明摄像头连接主板还是LCD扩展板，并给针数/间距/同反向/长度、接线图与配套固件例程。
4. 请给主板和LCD**装齐连接器后的总厚度**，以及排线插头、USB插头和弯线所需空间。
5. 扬声器是否为4Ω？外径、深度是否包含焊片和接线？接口与板载功放是否匹配？
6. 舵机是否为真实规格SG90？请给外形、输出轴位置、舵盘、支架尺寸、允许供电、峰值电流与转角。
7. 转台支撑件请给外径、高度、孔距和负载信息，不能仅提供无尺寸的效果图。

## 六、验收与放行顺序

1. 确认已购清单及套装缺件 → 主板/LCD/摄像头/扬声器台架联调。
2. 按本清单核实物尺寸，更新参数模型中的假设值与板载麦位置。
3. 完成拾音、播放停止、播放参考与双讲AEC、摄像头抓拍；外壳安装后必须复测。
4. 舵机空载→带支撑的实际头部负载；本模型±45°仅为可视化预览范围，不是舵机实测行程或固件承诺。
5. 排线、USB和舵机线束活动空间检查 → 安装结构/孔位/公差设计 → 外壳打样。
6. 通过外壳内的声学、温升、供电和转向测试后，才冻结采购型号和生产文件。

## 七、模型证据与当前限制

- 统一参数：`parameters.json`；空间检查：`fit-report.json`；原生可编辑文件：`EffMeet2_席位牌_封装布局_v1_审阅.blend`。
- 主板、LCD、摄像头、舵机和扬声器的**当前预留体积**已检查是否位于相应腔体内、同舱是否互相分离。
- 这只说明当前假设的占位包络有空间。摄像头与扬声器尚未锁商品，板高、接头、线束、支架、实际孔位与声学仍未验证，不等于实物“必定能装”。
- 当前最小包络角点余量约0.6 mm出现在底座器件预留盒与内底面之间；这是**预留盒之外的额外余量**，不应拿来作为打印公差或购买超规格器件的依据。

## 官方依据

- [乐鑫 Korvo-2 用户指南](https://docs.espressif.com/projects/esp-adf/en/latest/multimedia-boards/dev-boards/user-guide-esp32-s3-korvo-2.html)：板载双麦、音频器件、Micro-USB、4Ω扬声器和5V至少2A要求。
- [Korvo-2 V3.1 PCB布局图](https://dl.espressif.com/dl/schematics/PCB_ESP32-S3-Korvo-2_V3.1_20221104.pdf)：115×80 mm板形。
- [乐鑫 LCD 扩展板用户指南](https://docs.espressif.com/projects/esp-adf/en/latest/multimedia-boards/dev-boards/user-guide-esp32-s3-korvo-2-lcd.html)：2.4寸LCD及配套摄像/FPC接口。
- [LCD V1.1 PCB布局图](https://dl.espressif.com/dl/schematics/PCB_ESP32-S3-Korvo-2-LCD_V1.1_20230315.pdf)：79.4×58.4 mm板形。
- [TowerPro SG90](https://towerpro.com.tw/product/sg90-7/)：23×12.2×29 mm本体尺寸；不替代实际舵盘、支架和负载测试。
