eleanor-wsyy/EffMeet2/hardware/robot-design/round-yaw-v2/revision-20261011-nomi-layoutA/print-split-v5/PARTS.md

# v5 独立打印候选件表

**41件装配件 / 41个闭合候选STL / 6张正式几何起点盘。** 件数来自实际结构；盘数、朝向、支撑未冻结。

**全部 UNVERIFIED / NOT_SLICED_NOT_PRINTED / CANDIDATE_NOT_RELEASED。** 闭合网格不证明实物配合、强度或功能合格。

原生模型保留装配坐标。STL采用朝向起点、最低点归零、mm单位。3MF只有几何，没有打印机配置、支撑或G-code。

|件号|件名|数量|材料色|装配尺寸mm|朝向起点XYZ°|支撑建议|起点盘|接口/打印状态|
|---|---|---:|---|---|---|---|---|---|
|P01|[头壳（原生曲面＋新增接收）](candidate-stl/P01_HEAD_SHELL_UNVERIFIED.stl)|1|PLA Matte 灰|150.00 × 128.00 × 130.00|90/0/0|前圈朝下；内底/接收座局部支撑，必须试切片|G1-1|unverified / 未切片未实打|
|P02|[圆形黑面板](candidate-stl/P02_FACE_PANEL_UNVERIFIED.stl)|1|PLA Matte 黑|106.00 × 5.40 × 106.00|90/0/0|面朝平台；后口袋向上，支撑待预览|B1-1|unverified / 未切片未实打|
|P03|[短颈＋止转舌](candidate-stl/P03_SHORT_YAW_NECK_UNVERIFIED.stl)|1|PLA Matte 黑|62.00 × 62.00 × 24.60|0/0/0|轴向孔竖直，肩台局部支撑|B1-1|unverified / 未切片未实打|
|P04|[底座上盖＋机械限位](candidate-stl/P04_BASE_LID_UNVERIFIED.stl)|1|PLA Matte 灰|171.43 × 156.19 × 17.20|0/0/0|接缝圈朝下；中心悬空和螺钉柱局部支撑|G3-1|unverified / 未切片未实打|
|P05|[底座杯体＋接收柱＋出音通道](candidate-stl/P05_BASE_CUP_UNVERIFIED.stl)|1|PLA Matte 灰|180.00 × 164.00 × 64.00|0/0/0|底面朝下；深柱/声学通道支撑待预览|G2-1|unverified / 未切片未实打|
|P06|[双轴承承力塔](candidate-stl/P06_BEARING_TOWER_UNVERIFIED.stl)|1|PLA Matte 黑|70.00 × 38.00 × 34.80|0/0/0|脚面朝下；贯穿孔竖直；顶部接触面预览|B2-1|unverified / 未切片未实打|
|P07|[下轴承座左半](candidate-stl/P07_BEARING_SEAT_LOWER_LEFT_UNVERIFIED.stl)|1|PLA Matte 黑|33.80 × 62.00 × 9.40|0/90/0|分缝朝平台起点；孔形/夹紧与层向需样片|B2-1|unverified / 未切片未实打|
|P08|[下轴承座右半](candidate-stl/P08_BEARING_SEAT_LOWER_RIGHT_UNVERIFIED.stl)|1|PLA Matte 黑|33.80 × 62.00 × 9.40|0/-90/0|分缝朝平台起点；孔形/夹紧与层向需样片|B2-1|unverified / 未切片未实打|
|P09|[上轴承座左半](candidate-stl/P09_BEARING_SEAT_UPPER_LEFT_UNVERIFIED.stl)|1|PLA Matte 黑|33.80 × 62.00 × 9.40|0/90/0|分缝朝平台起点；孔形/夹紧与层向需样片|B2-1|unverified / 未切片未实打|
|P10|[上轴承座右半](candidate-stl/P10_BEARING_SEAT_UPPER_RIGHT_UNVERIFIED.stl)|1|PLA Matte 黑|33.80 × 62.00 × 9.40|0/-90/0|分缝朝平台起点；孔形/夹紧与层向需样片|B2-1|unverified / 未切片未实打|
|P11|[轴承层间支柱 1](candidate-stl/P11_BEARING_STACK_SPACER_1_UNVERIFIED.stl)|1|PLA Matte 黑|8.20 × 8.20 × 10.60|0/0/0|通孔轴竖直；通常无支撑，须预览|B2-1|unverified / 未切片未实打|
|P12|[轴承层间支柱 2](candidate-stl/P12_BEARING_STACK_SPACER_2_UNVERIFIED.stl)|1|PLA Matte 黑|8.20 × 8.20 × 10.60|0/0/0|通孔轴竖直；通常无支撑，须预览|B2-1|unverified / 未切片未实打|
|P13|[轴承层间支柱 3](candidate-stl/P13_BEARING_STACK_SPACER_3_UNVERIFIED.stl)|1|PLA Matte 黑|8.20 × 8.20 × 10.60|0/0/0|通孔轴竖直；通常无支撑，须预览|B2-1|unverified / 未切片未实打|
|P14|[轴承层间支柱 4](candidate-stl/P14_BEARING_STACK_SPACER_4_UNVERIFIED.stl)|1|PLA Matte 黑|8.20 × 8.20 × 10.60|0/0/0|通孔轴竖直；通常无支撑，须预览|B2-1|unverified / 未切片未实打|
|P15|[空心承力轴（轴肩＋两段D面）](candidate-stl/P15_HOLLOW_LOAD_SHAFT_UNVERIFIED.stl)|1|PLA Matte 黑|34.50 × 34.50 × 54.00|0/0/0|轴竖直起点；必须扭转/轴肩样片验证|B2-1|unverified / 未切片未实打|
|P16|[空心轴下止推夹环](candidate-stl/P16_SHAFT_LOWER_LOCK_COLLAR_UNVERIFIED.stl)|1|PLA Matte 黑|38.00 × 42.00 × 13.20|0/0/0|轴向竖直起点；耳部孔/开缝须预览|B2-1|unverified / 未切片未实打|
|P17|[从动64齿候选带轮](candidate-stl/P17_DRIVEN_64T_WHEEL_UNVERIFIED.stl)|1|PLA Matte 黑|43.20 × 43.20 × 8.40|0/0/0|轮轴竖直；齿槽/舵盘口袋须样片验带|B2-1|unverified / 未切片未实打|
|P18|[舵机主动64齿候选带轮](candidate-stl/P18_DRIVER_64T_WHEEL_UNVERIFIED.stl)|1|PLA Matte 黑|43.20 × 43.20 × 8.40|0/0/0|轮轴竖直；齿槽/舵盘口袋须样片验带|B2-1|unverified / 未切片未实打|
|P19|[舵机可调耳槽架](candidate-stl/P19_SERVO_ADJUSTABLE_CRADLE_UNVERIFIED.stl)|1|PLA Matte 黑|29.20 × 34.00 × 44.40|0/0/0|脚面朝下；耳台悬挑局部支撑；耳孔及输出轴偏移未测|B2-1|unverified / 未切片未实打|
|P20|[隐私滑盖后导向座](candidate-stl/P20_PRIVACY_GUIDE_BASE_UNVERIFIED.stl)|1|PLA Matte 黑|38.00 × 3.20 × 13.00|90/0/0|面向平台；导槽向上；不得与滑片融合|B1-1|unverified / 未切片未实打|
|P21|[隐私滑片（13.5mm行程）](candidate-stl/P21_PRIVACY_MOVING_BLADE_UNVERIFIED.stl)|1|PLA Matte 黑|16.00 × 4.70 × 10.00|90/0/0|平放；拨片悬挑局部支撑|B1-1|unverified / 未切片未实打|
|P22|[隐私导向前压框](candidate-stl/P22_PRIVACY_FRONT_RETAINER_UNVERIFIED.stl)|1|PLA Matte 黑|38.00 × 1.20 × 13.00|90/0/0|平面朝平台；单独件，先装滑片再封框|B1-1|unverified / 未切片未实打|
|P23|[LCD后支承框（预算边缘夹持）](candidate-stl/P23_LCD_BUDGET_FRAME_UNVERIFIED.stl)|1|PLA Matte 黑|102.60 × 3.80 × 59.00|90/0/0|框面平放；不使用假定PCB孔位|B3-1|unverified / 未切片未实打|
|P24|[LCD前压框（间距待实测）](candidate-stl/P24_LCD_PRESSURE_FRAME_UNVERIFIED.stl)|1|PLA Matte 黑|102.60 × 1.60 × 59.00|90/0/0|框面平放；仅夹预算边缘，实测玻璃/元件高度|B3-1|unverified / 未切片未实打|
|P25|[摄像模组预算托架](candidate-stl/P25_CAMERA_CRADLE_UNVERIFIED.stl)|1|PLA Matte 黑|50.00 × 14.80 × 27.70|90/0/0|镜头孔轴竖直；FPC出口/镜头凸高未测|B3-1|unverified / 未切片未实打|
|P26|[摄像托架后压片＋排线口](candidate-stl/P26_CAMERA_BACK_RETAINER_UNVERIFIED.stl)|1|PLA Matte 黑|27.20 × 2.40 × 28.00|90/0/0|平面朝平台；不夹排线，不假定模组孔位|B3-1|unverified / 未切片未实打|
|P27|[前肩停止键帽＋短键柱](candidate-stl/P27_STOP_KEY_CAP_UNVERIFIED.stl)|1|PLA Matte 黑|14.20 × 10.20 × 6.30|0/0/0|键面朝平台起点；行程/导向须样片|B1-1|unverified / 未切片未实打|
|P28|[外接轻触键托座及限行程导向](candidate-stl/P28_TACTILE_SWITCH_HOLDER_UNVERIFIED.stl)|1|PLA Matte 黑|40.00 × 15.00 × 10.60|0/0/0|底面朝下；开口朝上；6mm开关预算，非BOOT连杆|B1-1|unverified / 未切片未实打|
|P29|[核心板开放边缘托架](candidate-stl/P29_MAINBOARD_EDGE_CRADLE_UNVERIFIED.stl)|1|PLA Matte 黑|75.80 × 14.00 × 55.50|0/0/0|脚面朝下；槽/跨桥局部支撑，排针口待测|B3-1|unverified / 未切片未实打|
|P30|[核心板可拆上压条](candidate-stl/P30_MAINBOARD_TOP_RETAINER_UNVERIFIED.stl)|1|PLA Matte 黑|70.00 × 7.30 × 6.10|90/0/0|压条面平放；只夹板边，不遮连接器|B3-1|unverified / 未切片未实打|
|P31|[固定麦托架＋硬声管 1](candidate-stl/P31_FIXED_MIC_DUCT_CRADLE_1_UNVERIFIED.stl)|1|PLA Matte 黑|32.00 × 18.30 × 53.80|0/0/0|脚面朝下；声管内孔局部支撑，端口及贴壳位置未测|B3-1|unverified / 未切片未实打|
|P32|[固定麦前压条 1](candidate-stl/P32_MIC_RETAINER_1_UNVERIFIED.stl)|1|PLA Matte 黑|31.60 × 2.40 × 8.00|90/0/0|面平放；不要堵拾音口|B3-1|unverified / 未切片未实打|
|P33|[固定麦托架＋硬声管 2](candidate-stl/P33_FIXED_MIC_DUCT_CRADLE_2_UNVERIFIED.stl)|1|PLA Matte 黑|32.00 × 18.30 × 53.80|0/0/0|脚面朝下；声管内孔局部支撑，端口及贴壳位置未测|B3-1|unverified / 未切片未实打|
|P34|[固定麦前压条 2](candidate-stl/P34_MIC_RETAINER_2_UNVERIFIED.stl)|1|PLA Matte 黑|31.60 × 2.40 × 8.00|90/0/0|面平放；不要堵拾音口|B3-1|unverified / 未切片未实打|
|P35|[功放开放托盘](candidate-stl/P35_I2S_AMP_OPEN_TRAY_UNVERIFIED.stl)|1|PLA Matte 黑|28.40 × 21.40 × 21.50|0/0/0|底面朝下；连线口朝上；预算边缘夹持，焊点/端口未测|B3-1|unverified / 未切片未实打|
|P36|[充电保护板开放托盘](candidate-stl/P36_BATTERY_CHARGER_OPEN_TRAY_UNVERIFIED.stl)|1|PLA Matte 黑|33.40 × 22.40 × 12.50|0/0/0|底面朝下；连线口朝上；预算边缘夹持，焊点/端口未测|B3-1|unverified / 未切片未实打|
|P37|[选装电池开放托盘（90度避让）](candidate-stl/P37_OPTIONAL_BATTERY_TRAY_UNVERIFIED.stl)|1|PLA Matte 黑|36.00 × 74.00 × 12.00|0/0/0|底面朝下；不得压电芯；电源路径仍未放行|B3-1|unverified / 未切片未实打|
|P38|[扬声器圆筒托架＋后挡肩](candidate-stl/P38_SPEAKER_AXIAL_CRADLE_UNVERIFIED.stl)|1|PLA Matte 黑|54.00 × 22.00 × 48.00|90/0/0|扬声器孔轴竖直起点；脚部支撑待预览|B3-1|unverified / 未切片未实打|
|P39|[扬声器前压圈](candidate-stl/P39_SPEAKER_FRONT_RETAINER_UNVERIFIED.stl)|1|PLA Matte 黑|54.00 × 2.40 × 46.00|90/0/0|压圈平放，胶垫/实际外径未测|B3-1|unverified / 未切片未实打|
|P40|[线束固定鞍 1](candidate-stl/P40_CABLE_SADDLE_1_UNVERIFIED.stl)|1|PLA Matte 黑|16.00 × 14.00 × 6.00|0/0/0|平底朝下；槽向上；束带绕槽，禁止扎紧FPC|B3-1|unverified / 未切片未实打|
|P41|[线束固定鞍 2](candidate-stl/P41_CABLE_SADDLE_2_UNVERIFIED.stl)|1|PLA Matte 黑|16.00 × 14.00 × 6.00|0/0/0|平底朝下；槽向上；束带绕槽，禁止扎紧FPC|B3-1|unverified / 未切片未实打|

## 起点盘（不是切片文件）

- [G1-1](plate-start-layouts/G1-1_UNSLICED_START.3mf)：P01
- [G2-1](plate-start-layouts/G2-1_UNSLICED_START.3mf)：P05
- [G3-1](plate-start-layouts/G3-1_UNSLICED_START.3mf)：P04
- [B1-1](plate-start-layouts/B1-1_UNSLICED_START.3mf)：P02, P03, P28, P20, P22, P27, P21
- [B2-1](plate-start-layouts/B2-1_UNSLICED_START.3mf)：P07, P08, P09, P10, P17, P18, P16, P06, P15, P19, P11, P12, P13, P14
- [B3-1](plate-start-layouts/B3-1_UNSLICED_START.3mf)：P37, P23, P24, P38, P39, P26, P25, P36, P35, P31, P33, P29, P41, P40, P32, P34, P30

## 样片批次

- **S1** 现有PETG：P07, P08, P15, P03, P18, P20, P21, P22。6806夹紧/轴D接收/舵盘口袋及真带齿槽/滑盖间隙；直接以这些真实件作为样片。
- **S2** 正式黑PLA Matte：P07, P08, P15, P03, P18, P20, P21, P22, P02。同接口换正式料复测；圆面板表面/屏可视区/相机窗口；直接以这些真实件作为样片。

## 明确薄壁例外

一般壳壁预算2.4mm。轴承挡唇1.0mm、带轮法兰1.2mm、隐私滑片1.6mm/压框1.2mm、键帽2.0mm是候选薄壁例外，不声称满足2.4mm。0.4喷嘴实际路径和功能须预览＋样片。

轴承座分缝朝平台只是试切起点；必须同时验孔形、夹紧方向与层间强度。没有实物验证的最终朝向字段保持空。
