eleanor-wsyy/EffMeet2/hardware/print-jobs/print-20261019/parts/P06_UPPER_SEAT_PRINT.stl

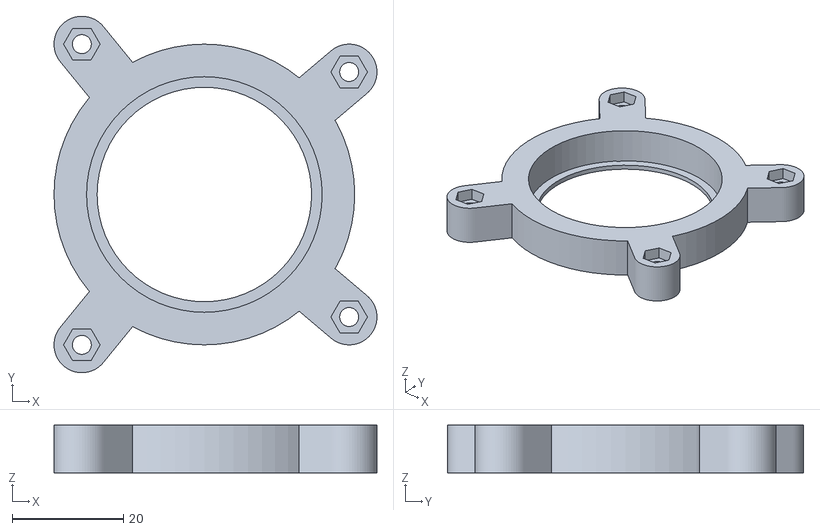
[picture p95: CAD file, 2026-10-21]
hardware/print-jobs/print-20261019/parts/P06_UPPER_SEAT_PRINT.stl
58.0 x 64.0 x 8.60
