eleanor-wsyy/EffMeet2/hardware/print-jobs/print-20261019/plates/01_P15P17P26P29_BLACK_016.stl

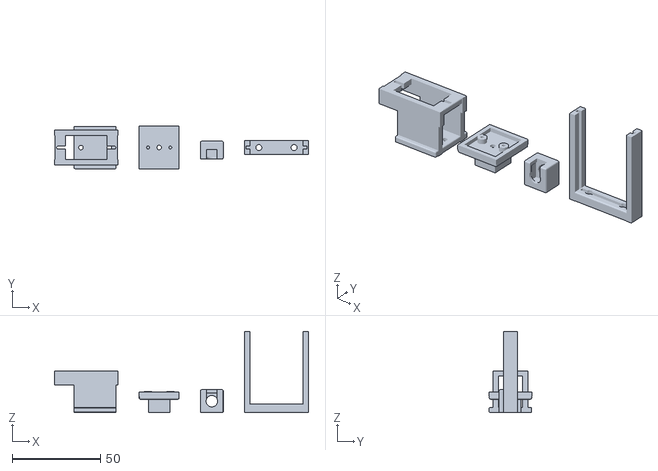
[picture p96: CAD file, 2026-10-21]
hardware/print-jobs/print-20261019/plates/01_P15P17P26P29_BLACK_016.stl
144.0 x 24.1 x 46.1
