eleanor-wsyy/EffMeet2/hardware/print-jobs/reprint-20261018/P05_BEARING_TOWER.stl

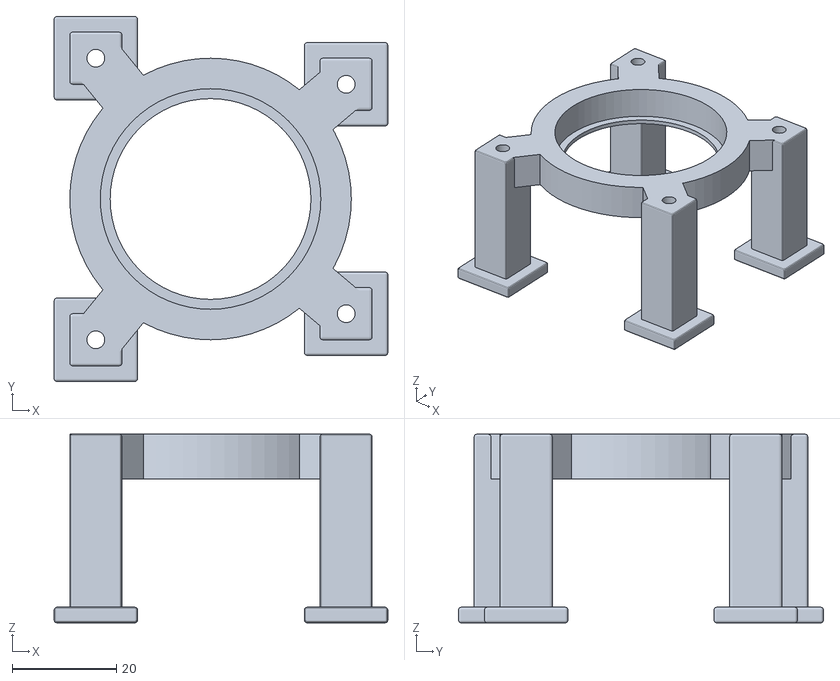
[picture p97: CAD file, 2026-10-21]
hardware/print-jobs/reprint-20261018/P05_BEARING_TOWER.stl
64.0 x 70.0 x 36.2
