eleanor-wsyy/EffMeet2/hardware/print-jobs/reprint-20261019-v6r3/P26_CAMERA_CRADLE_V6R3.stl

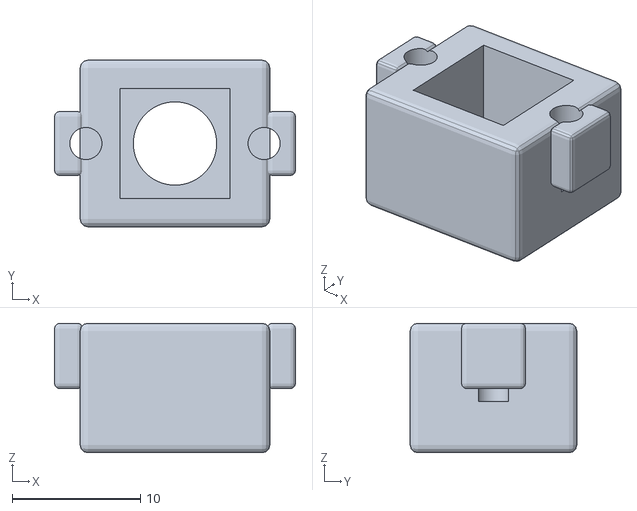
[picture p98: CAD file, 2026-10-21]
hardware/print-jobs/reprint-20261019-v6r3/P26_CAMERA_CRADLE_V6R3.stl
18.8 x 13.0 x 10.1
