eleanor-wsyy/EffMeet2/hardware/print-jobs/today-20261019/plates/TMP-FIX-P28_BLACK_012.3mf

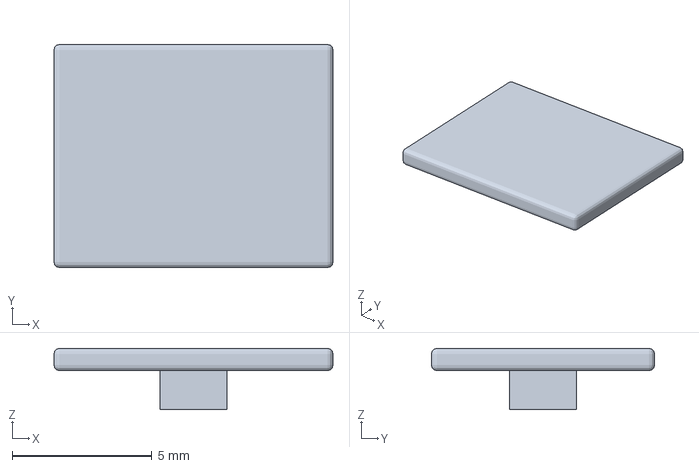
[picture p99: CAD file, 2026-10-21]
hardware/print-jobs/today-20261019/plates/TMP-FIX-P28_BLACK_012.3mf
10.0 x 8.00 x 2.20 mm
