eleanor-wsyy/EffMeet2/hardware/print-jobs/today-20261019/single-parts/P18T_CRADLE.stl

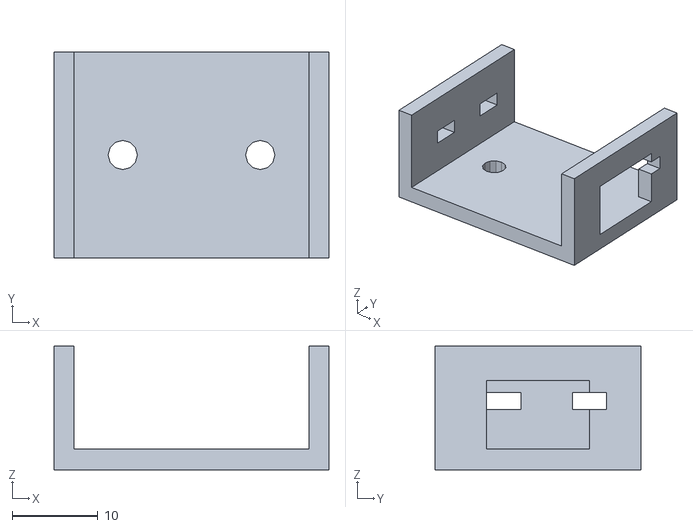
[picture p100: CAD file, 2026-10-21]
hardware/print-jobs/today-20261019/single-parts/P18T_CRADLE.stl
32.0 x 24.0 x 14.4
