eleanor-wsyy/EffMeet2/hardware/print-jobs/today-20261020/plates/TMP-FIX2-ALL_BLACK_016.stl

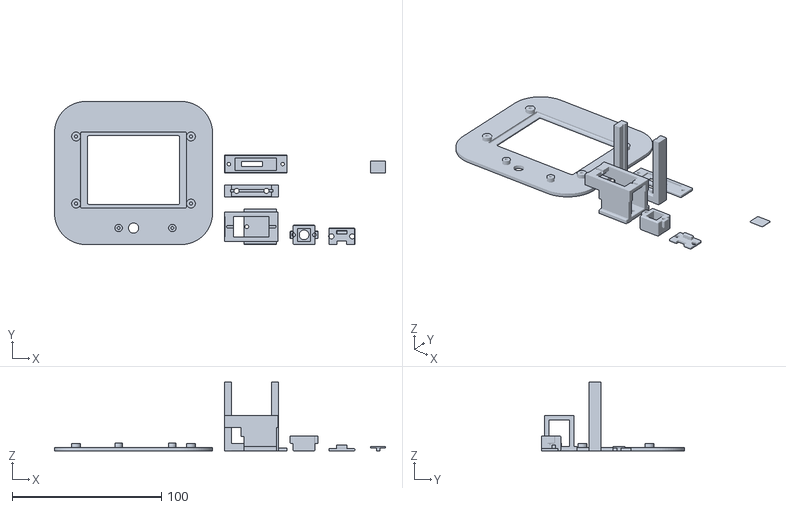
[picture p101: CAD file, 2026-10-21]
hardware/print-jobs/today-20261020/plates/TMP-FIX2-ALL_BLACK_016.stl
222.0 x 96.0 x 46.1
