eleanor-wsyy/EffMeet2/hardware/robot-design/round-yaw-v2/fit-coupons/A0_appearance_coupon.stl

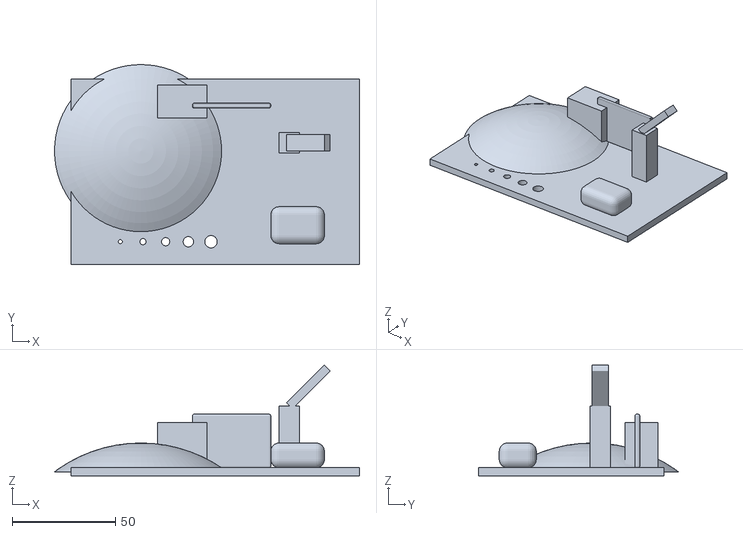
[picture p102: CAD file, 2026-10-12]
hardware/robot-design/round-yaw-v2/fit-coupons/A0_appearance_coupon.stl
147.9 x 96.9 x 53.8
