eleanor-wsyy/EffMeet2/hardware/robot-design/round-yaw-v2/revision-20261011-nomi-layoutA/print-split-v6/candidate-stl/P23_HEAD_SHELL_UNVERIFIED.stl

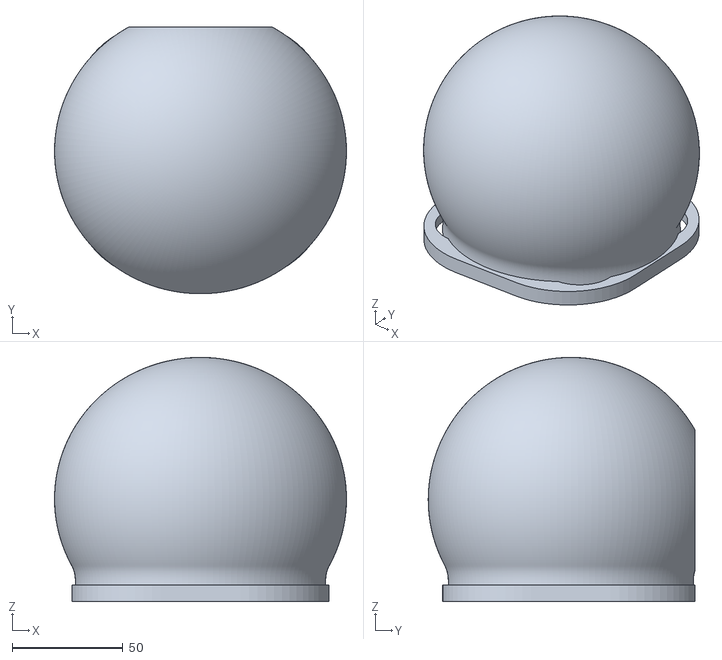
[picture p103: CAD file, 2026-10-19]
hardware/robot-design/round-yaw-v2/revision-20261011-nomi-layoutA/print-split-v6/candidate-stl/P23_HEAD_SHELL_UNVERIFIED.stl
132.0 x 120.5 x 110.4
