eleanor-wsyy/EffMeet2/hardware/robot-design/round-yaw-v2/revision-20261011-nomi-layoutA/print-split-v6/p03_fix/P03_SPLIT_B.stl

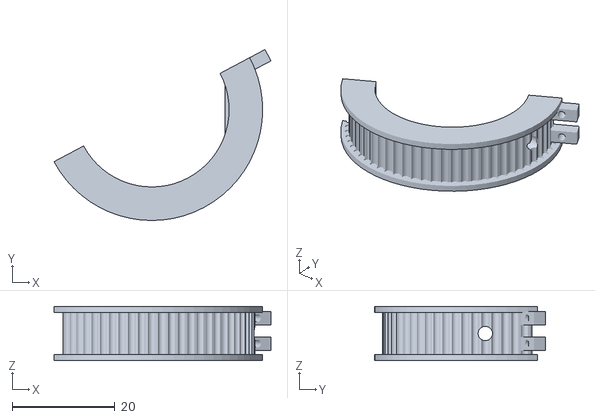
[picture p104: CAD file, 2026-10-21]
hardware/robot-design/round-yaw-v2/revision-20261011-nomi-layoutA/print-split-v6/p03_fix/P03_SPLIT_B.stl
42.3 x 33.4 x 10.6
