eleanor-wsyy/EffMeet2/hardware/robot-design/round-yaw-v2/revision-20261011-nomi-layoutA/print-split-v6/plates-merged/decimated/P04_decimated.stl

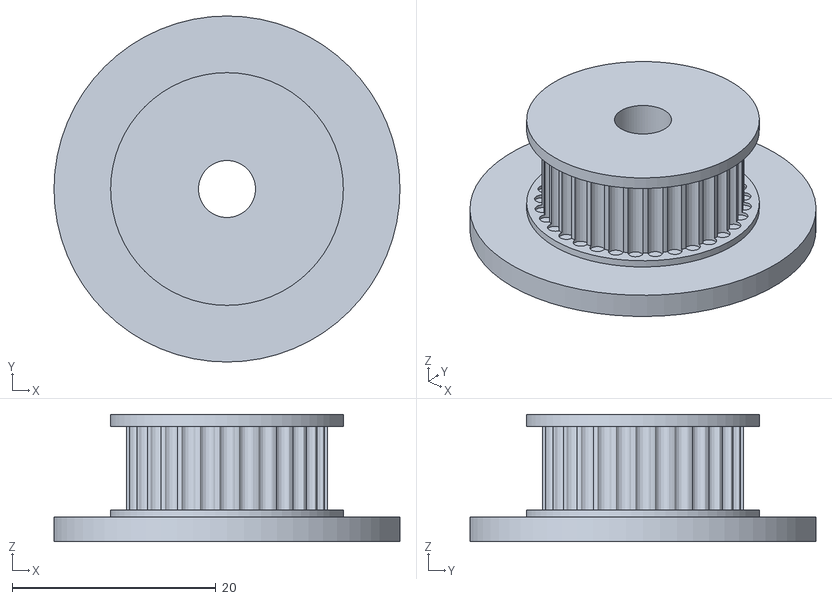
[picture p105: CAD file, 2026-10-16]
hardware/robot-design/round-yaw-v2/revision-20261011-nomi-layoutA/print-split-v6/plates-merged/decimated/P04_decimated.stl
34.0 x 34.0 x 12.5
