eleanor-wsyy/EffMeet2/hardware/robot-design/round-yaw-v2/revision-20261011-nomi-layoutA/print-split-v6/plates-merged/P27_PRIVACY_GUIDE_RETAINFIX.stl

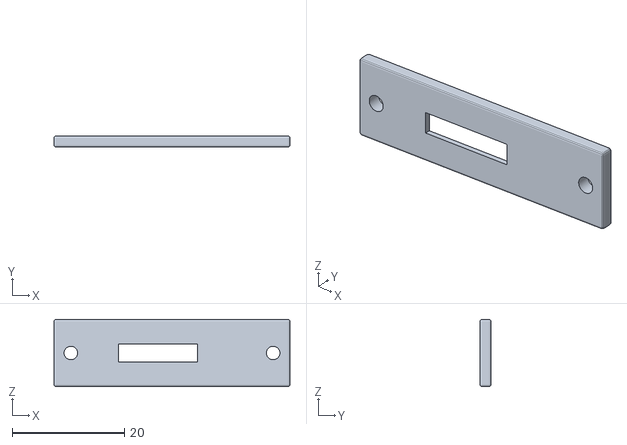
[picture p106: CAD file, 2026-10-19]
hardware/robot-design/round-yaw-v2/revision-20261011-nomi-layoutA/print-split-v6/plates-merged/P27_PRIVACY_GUIDE_RETAINFIX.stl
42.0 x 2.00 x 12.0
