eleanor-wsyy/EffMeet2/hardware/robot-design/round-yaw-v2/revision-20261011-nomi-layoutA/print-split-v6/plates/plate_G1_v6.3mf

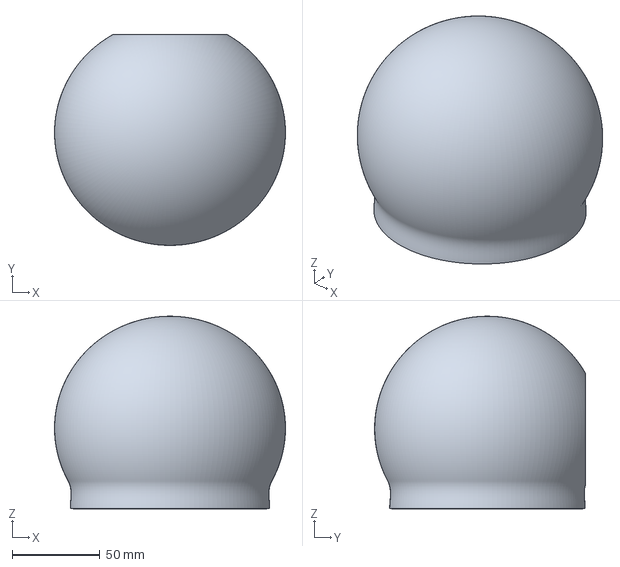
[picture p107: CAD file, 2026-10-13]
hardware/robot-design/round-yaw-v2/revision-20261011-nomi-layoutA/print-split-v6/plates/plate_G1_v6.3mf
132.0 x 120.5 x 110.0 mm
