eleanor-wsyy/EffMeet2/hardware/robot-design/round-yaw-v2/stl/08_hub.stl

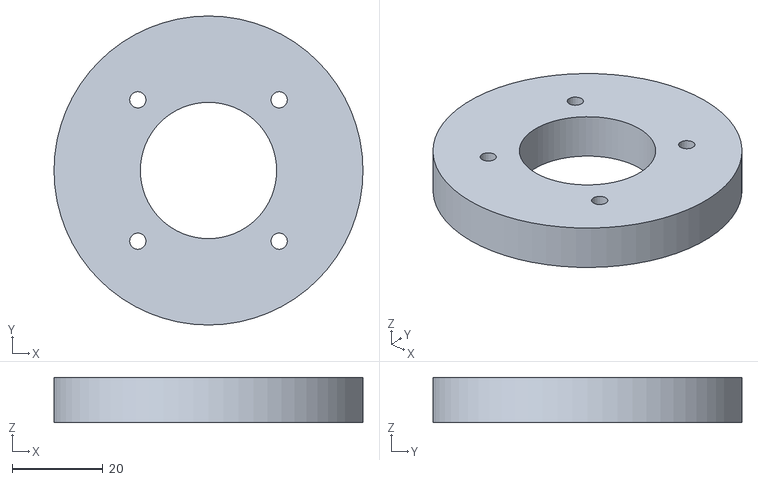
[picture p108: CAD file, 2026-10-11]
hardware/robot-design/round-yaw-v2/stl/08_hub.stl
68.0 x 68.0 x 10.0
