eleanor-wsyy/EffMeet2/print-20261019/parts/P20_TACTILE_HOLDER_PRINT.stl

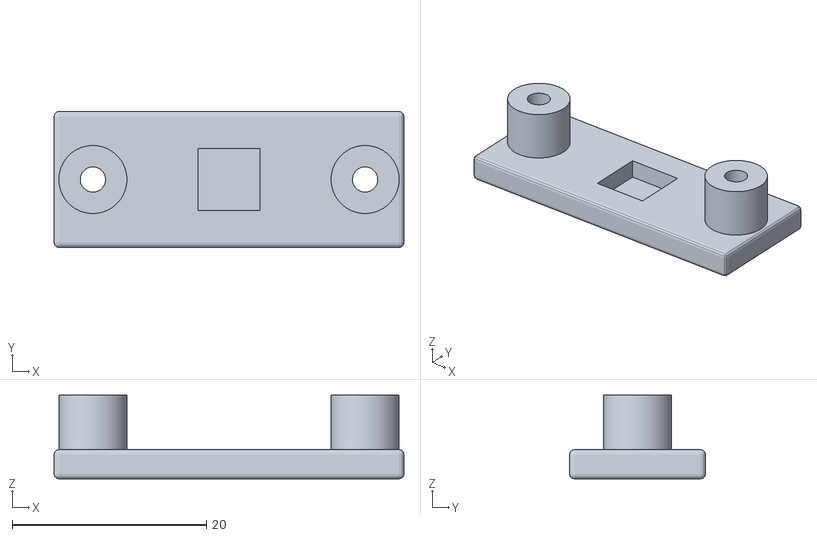
[picture p109: CAD file, 2026-10-21]
print-20261019/parts/P20_TACTILE_HOLDER_PRINT.stl
36.0 x 14.0 x 8.60
