eleanor-wsyy/EffMeet2/reprint-20261018/TMP-FIX-P03P05P06_GREY_016.stl

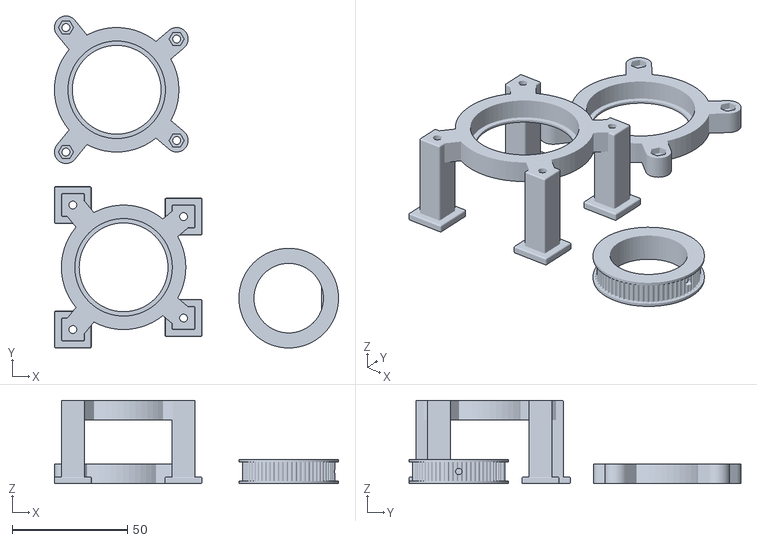
[picture p110: CAD file, 2026-10-18]
reprint-20261018/TMP-FIX-P03P05P06_GREY_016.stl
123.2 x 144.0 x 36.2
