eleanor-wsyy/EffMeet2/reprint-20261019-v6r3/FIX2_P15P26P33_BLACK_016.stl

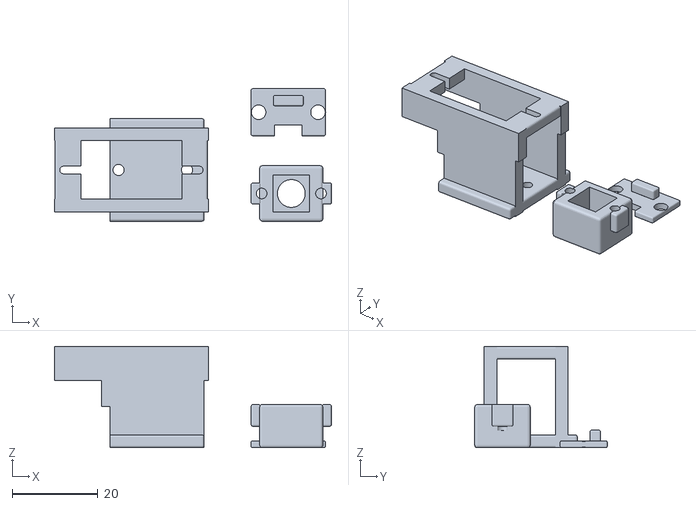
[picture p111: CAD file, 2026-10-19]
reprint-20261019-v6r3/FIX2_P15P26P33_BLACK_016.stl
64.8 x 31.0 x 23.7
