eleanor-wsyy/EffMeet2/hardware/print-jobs/print-20261019/parts/P26_CAMERA_CRADLE_ROT90X_PRINT.stl

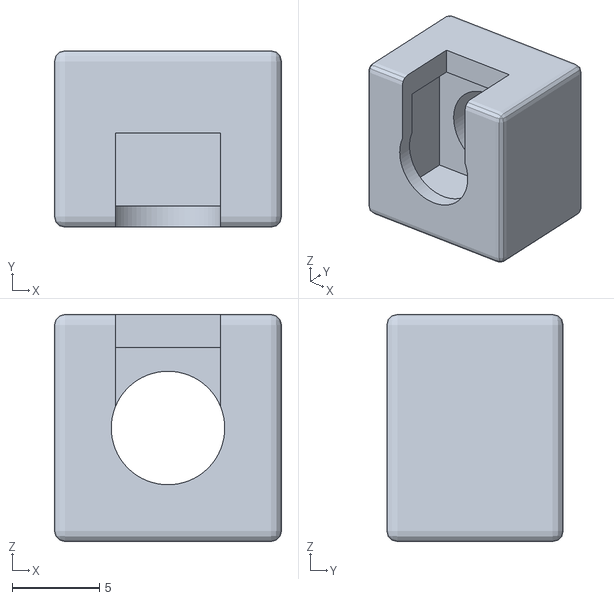
[picture p112: CAD file, 2026-10-21]
hardware/print-jobs/print-20261019/parts/P26_CAMERA_CRADLE_ROT90X_PRINT.stl
13.0 x 10.1 x 13.0
