eleanor-wsyy/EffMeet2/hardware/print-jobs/print-20261019/plates/03_P02P20_GREY_016.stl

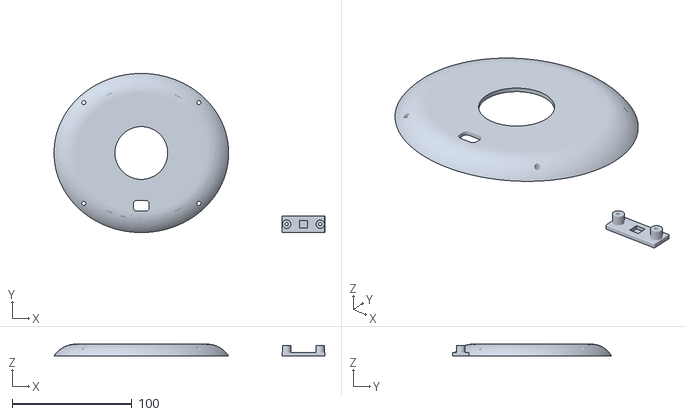
[picture p113: CAD file, 2026-10-21]
hardware/print-jobs/print-20261019/plates/03_P02P20_GREY_016.stl
226.0 x 132.7 x 9.90
