eleanor-wsyy/EffMeet2/hardware/print-jobs/reprint-20261019-v6r3/P15_SERVO_CRADLE_V6R3.stl

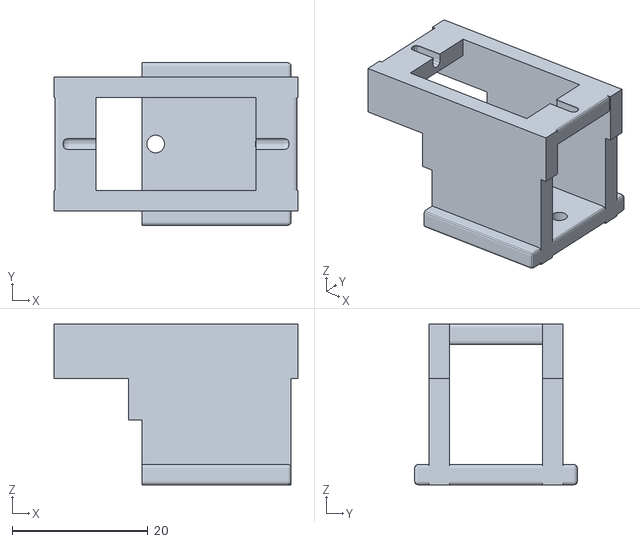
[picture p114: CAD file, 2026-10-21]
hardware/print-jobs/reprint-20261019-v6r3/P15_SERVO_CRADLE_V6R3.stl
36.0 x 24.0 x 23.7
