eleanor-wsyy/EffMeet2/hardware/print-jobs/today-20261019/single-parts/P02_BASE_LID_DECIMATED.stl

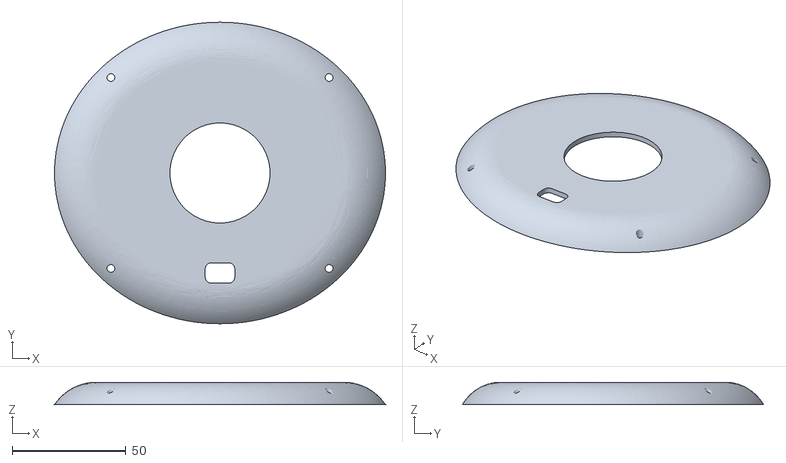
[picture p115: CAD file, 2026-10-21]
hardware/print-jobs/today-20261019/single-parts/P02_BASE_LID_DECIMATED.stl
145.7 x 132.7 x 9.90
