eleanor-wsyy/EffMeet2/hardware/print-jobs/today-20261020/plates/P24_FACE_PANEL_FACEFLAT_CAM68.stl

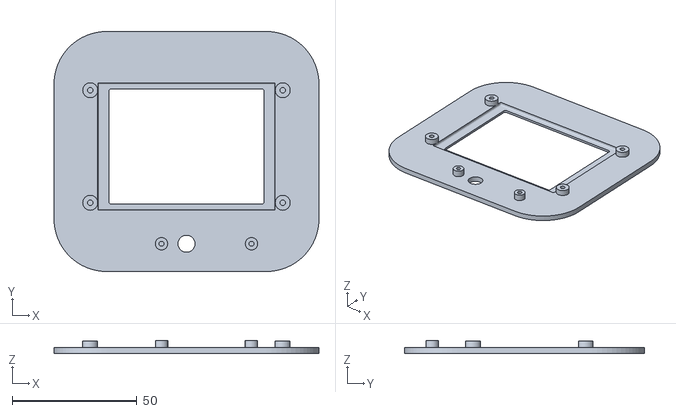
[picture p116: CAD file, 2026-10-21]
hardware/print-jobs/today-20261020/plates/P24_FACE_PANEL_FACEFLAT_CAM68.stl
106.0 x 96.0 x 5.30
