eleanor-wsyy/EffMeet2/hardware/robot-design/round-yaw-v2/fit-coupons/02_bearing_ID_and_shaft_ladder.stl

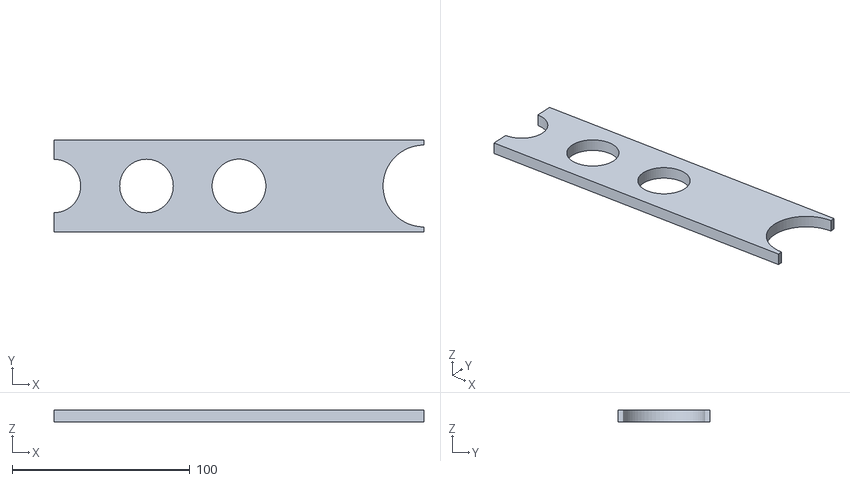
[picture p117: CAD file, 2026-10-11]
hardware/robot-design/round-yaw-v2/fit-coupons/02_bearing_ID_and_shaft_ladder.stl
208.0 x 52.0 x 7.00
