eleanor-wsyy/EffMeet2/hardware/robot-design/round-yaw-v2/revision-20261011-nomi-layoutA/print-split-v6/p03_fix/TMP-FIX-P03-BUSHING-SPLIT_D345.stl

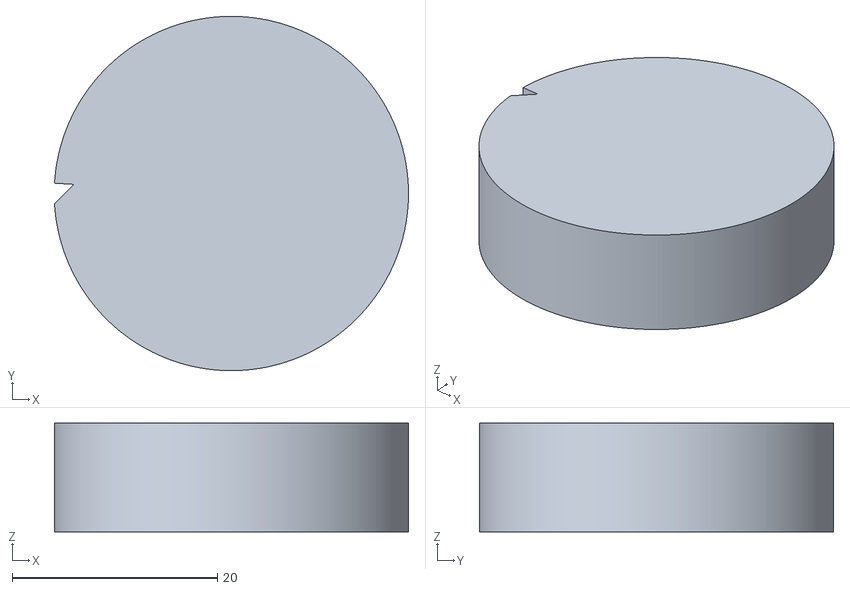
[picture p118: CAD file, 2026-10-21]
hardware/robot-design/round-yaw-v2/revision-20261011-nomi-layoutA/print-split-v6/p03_fix/TMP-FIX-P03-BUSHING-SPLIT_D345.stl
34.5 x 34.5 x 10.6
