eleanor-wsyy/EffMeet2/hardware/robot-design/round-yaw-v2/stl/11_slider.stl

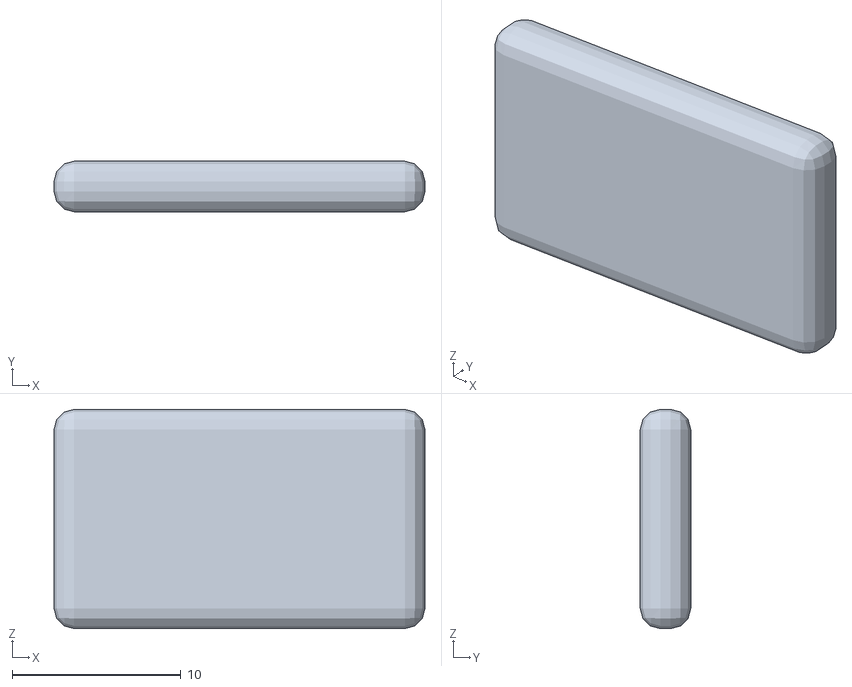
[picture p119: CAD file, 2026-10-11]
hardware/robot-design/round-yaw-v2/stl/11_slider.stl
22.0 x 3.00 x 13.0
