eleanor-wsyy/EffMeet2/hardware/print-jobs/print-20261019/parts/P17_AMP_TRAY_PRINT.stl

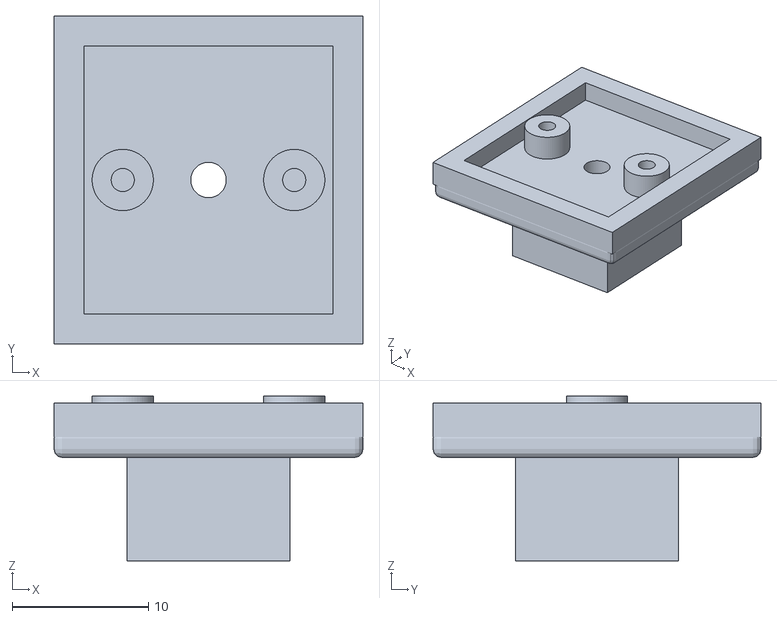
[picture p120: CAD file, 2026-10-21]
hardware/print-jobs/print-20261019/parts/P17_AMP_TRAY_PRINT.stl
22.7 x 24.1 x 12.1
