eleanor-wsyy/EffMeet2/hardware/print-jobs/reprint-20261018/P03_DRIVEN_64T_FLIPPED.stl

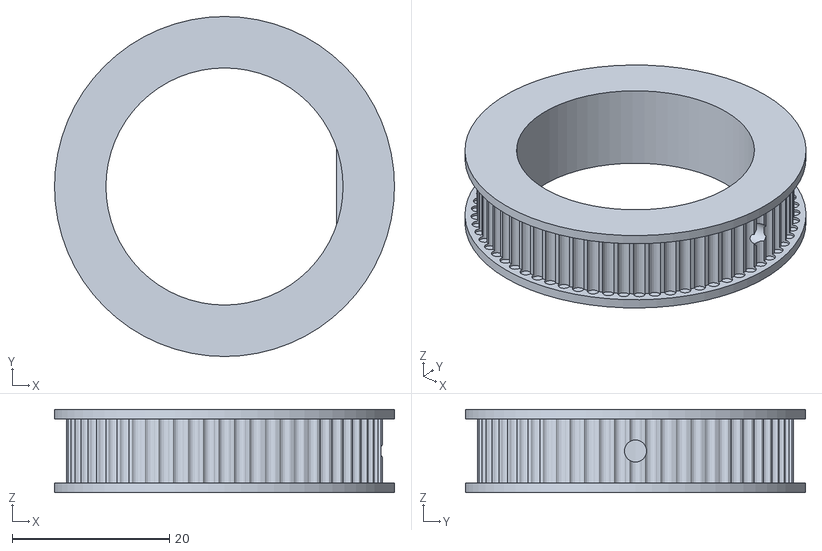
[picture p121: CAD file, 2026-10-21]
hardware/print-jobs/reprint-20261018/P03_DRIVEN_64T_FLIPPED.stl
43.2 x 43.2 x 10.6
