eleanor-wsyy/EffMeet2/hardware/print-jobs/today-20261020/plates/TMP-FIX-P29B_BLACK_016.3mf

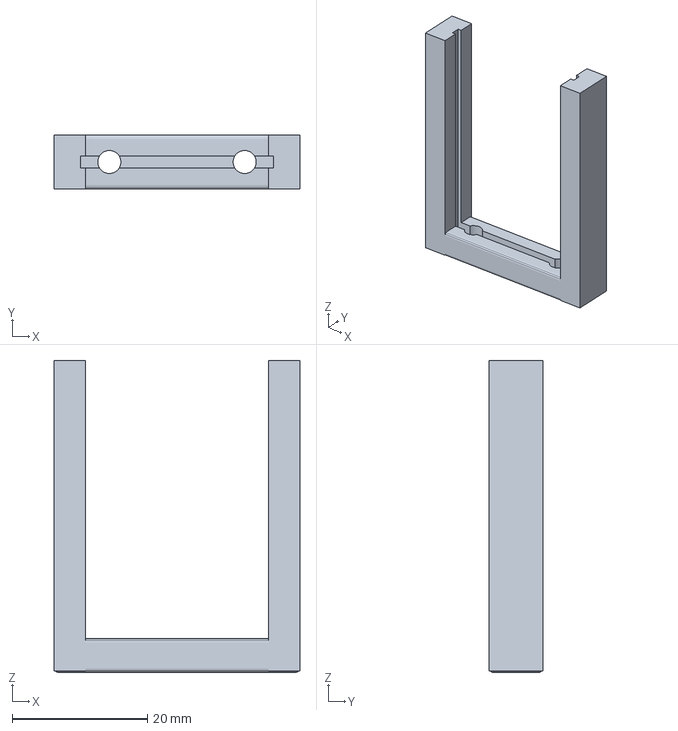
[picture p122: CAD file, 2026-10-21]
hardware/print-jobs/today-20261020/plates/TMP-FIX-P29B_BLACK_016.3mf
36.3 x 8.00 x 46.1 mm
