eleanor-wsyy/EffMeet2/hardware/robot-design/round-yaw-v2/fit-coupons/01_bearing_OD_ladder.stl

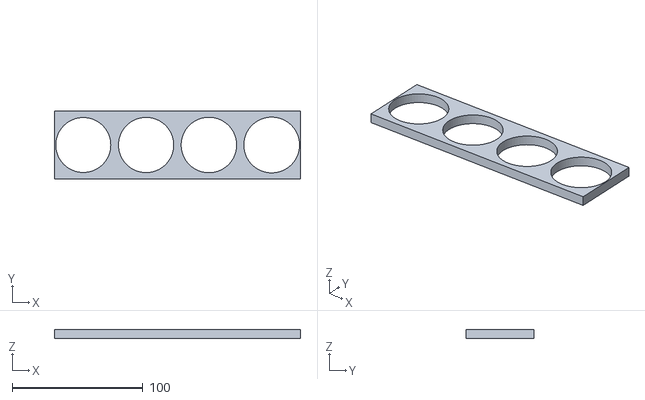
[picture p123: CAD file, 2026-10-11]
hardware/robot-design/round-yaw-v2/fit-coupons/01_bearing_OD_ladder.stl
188.0 x 52.0 x 7.00
