eleanor-wsyy/EffMeet2/hardware/robot-design/round-yaw-v2/revision-20261011-nomi-layoutA/print-split-v6/candidate-stl/P28_PRIVACY_BLADE_UNVERIFIED.stl

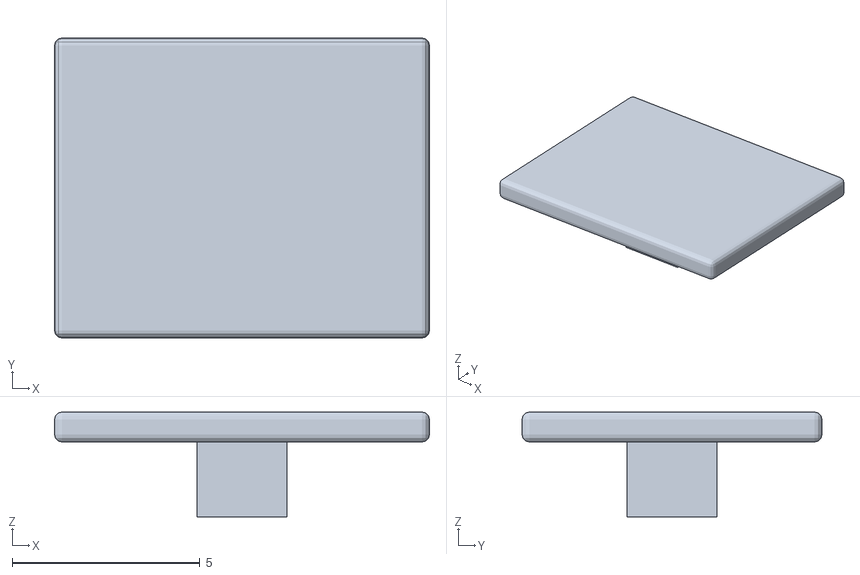
[picture p124: CAD file, 2026-10-19]
hardware/robot-design/round-yaw-v2/revision-20261011-nomi-layoutA/print-split-v6/candidate-stl/P28_PRIVACY_BLADE_UNVERIFIED.stl
10.0 x 8.00 x 2.80
