eleanor-wsyy/EffMeet2/hardware/robot-design/round-yaw-v2/revision-20261011-nomi-layoutA/print-split-v6/p03_fix/P03_SPLIT_A.stl

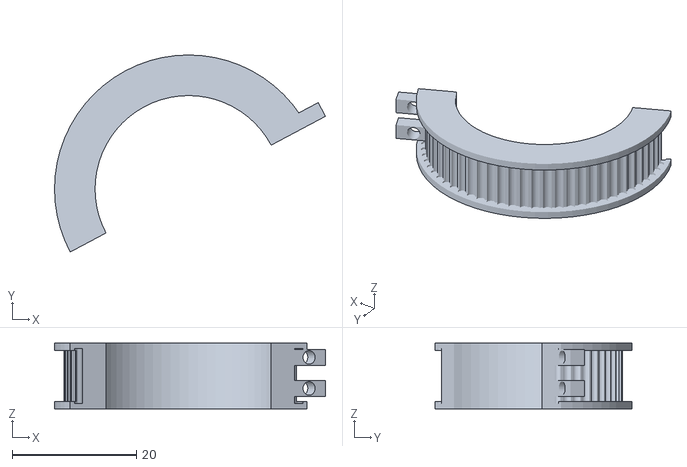
[picture p125: CAD file, 2026-10-21]
hardware/robot-design/round-yaw-v2/revision-20261011-nomi-layoutA/print-split-v6/p03_fix/P03_SPLIT_A.stl
43.7 x 31.8 x 10.6
