eleanor-wsyy/EffMeet2/hardware/robot-design/round-yaw-v2/revision-20261011-nomi-layoutA/print-split-v6/plates/plate_B3_v6.3mf

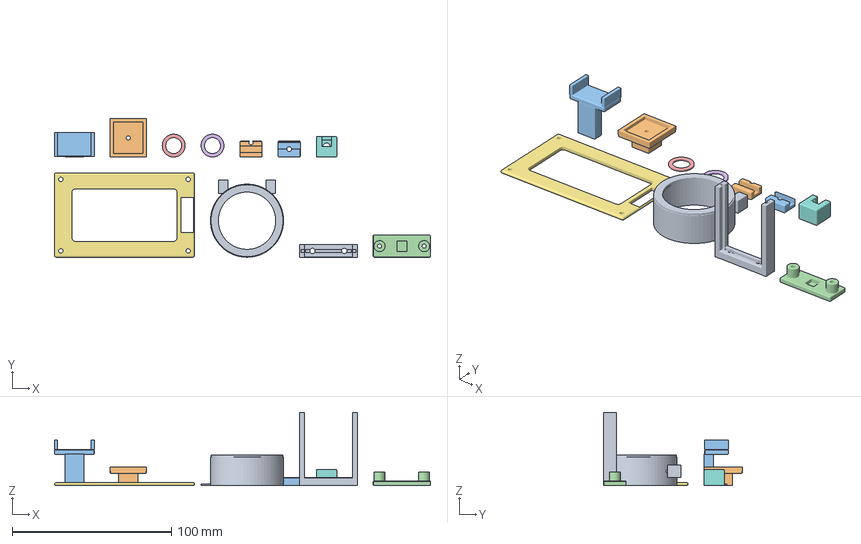
[picture p126: CAD file, 2026-10-13]
hardware/robot-design/round-yaw-v2/revision-20261011-nomi-layoutA/print-split-v6/plates/plate_B3_v6.3mf
236.3 x 87.1 x 46.1 mm
P16_N6_SPEAKER_CRADLE
P17_N6_AMP_LOW_TRAY
P18_N6_POWER_IN_TRAY
P20_N6_TACTILE_HOLDER
P21_N6_MIC_RETAINER_-1
P22_N6_MIC_RETAINER_1
P25_N6_LCD_REAR_CLAMP_FRAME
P26_N6_CAMERA_CRADLE
P29_N6_CORE_BOARD_CRADLE
P30_N6_CABLE_SADDLE_BASE
P31_N6_CABLE_SADDLE_HEAD
