eleanor-wsyy/EffMeet2/hardware/robot-design/round-yaw-v2/stl/04_C02_face_panel.stl

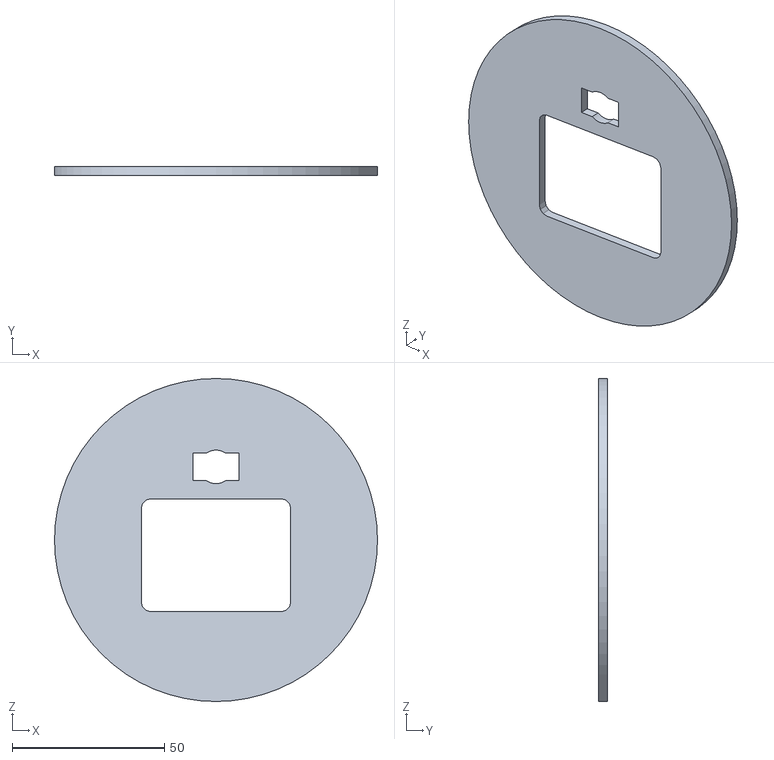
[picture p127: CAD file, 2026-10-11]
hardware/robot-design/round-yaw-v2/stl/04_C02_face_panel.stl
106.0 x 3.00 x 106.0
