eleanor-wsyy/EffMeet2/hardware/print-jobs/today-20261020/plates/TMP-FIX-P27P28_BLACK_016.3mf

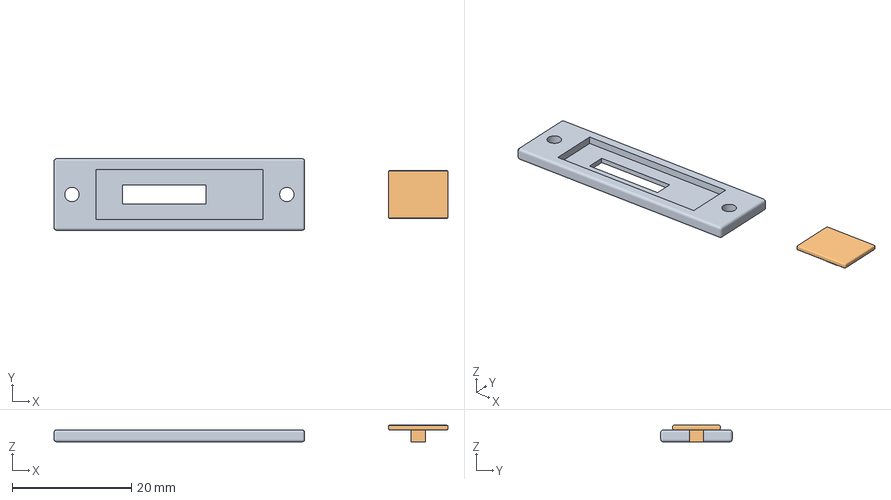
[picture p128: CAD file, 2026-10-21]
hardware/print-jobs/today-20261020/plates/TMP-FIX-P27P28_BLACK_016.3mf
66.0 x 12.0 x 2.80 mm
P27_PRIVACY_GUIDE_RETAINFIX
P28_PRIVACY_BLADE_RETAINFIX
