eleanor-wsyy/EffMeet2/hardware/robot-design/round-yaw-v2/fit-coupons/04_shortneck_clearance.stl

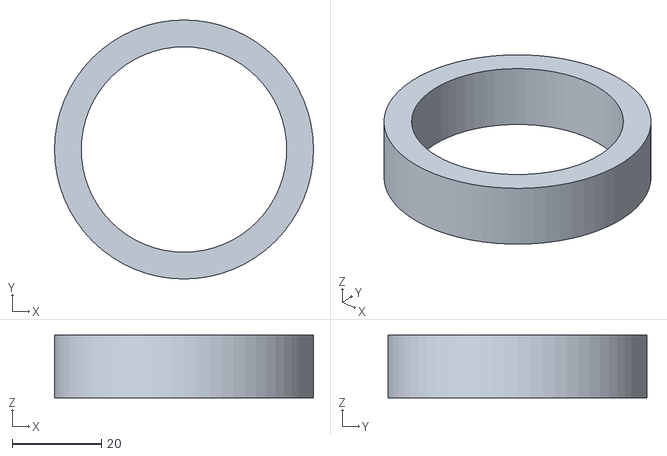
[picture p129: CAD file, 2026-10-11]
hardware/robot-design/round-yaw-v2/fit-coupons/04_shortneck_clearance.stl
58.0 x 58.0 x 14.0
