eleanor-wsyy/EffMeet2/hardware/robot-design/round-yaw-v2/revision-20261011-nomi-layoutA/print-split-v6/p03_fix/TMP-P03-FIX-PLATE_GREY_016.3mf

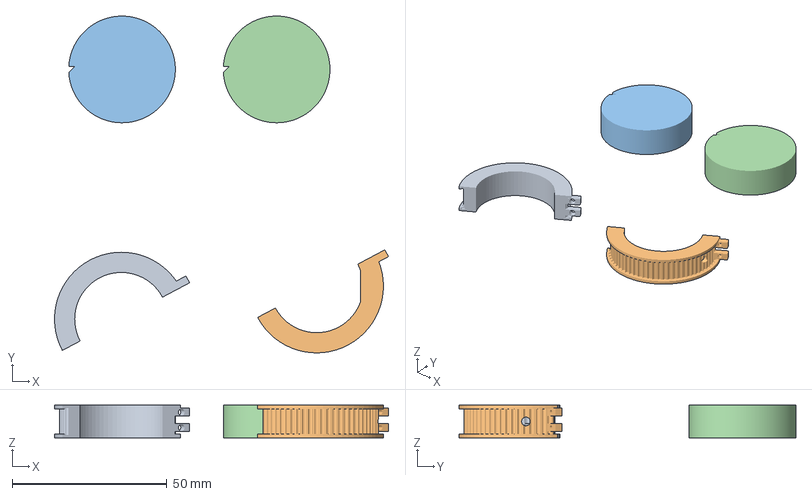
[picture p130: CAD file, 2026-10-21]
hardware/robot-design/round-yaw-v2/revision-20261011-nomi-layoutA/print-split-v6/p03_fix/TMP-P03-FIX-PLATE_GREY_016.3mf
108.0 x 108.9 x 10.6 mm
P03_SPLIT_A
P03_SPLIT_B
TMP-FIX-P03-BUSHING-SPLIT_D345 x 2
