eleanor-wsyy/EffMeet2/hardware/robot-design/round-yaw-v2/revision-20261011-nomi-layoutA/print-split-v6/plates/plate_G2_v6.3mf

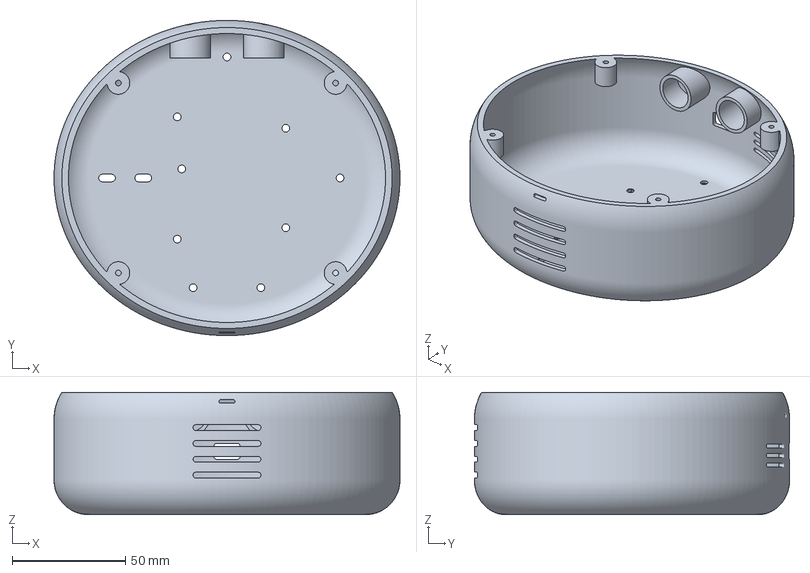
[picture p131: CAD file, 2026-10-13]
hardware/robot-design/round-yaw-v2/revision-20261011-nomi-layoutA/print-split-v6/plates/plate_G2_v6.3mf
153.0 x 139.4 x 54.1 mm
