eleanor-wsyy/EffMeet2/hardware/robot-design/round-yaw-v2/stl/02_C01b_base_cup.stl

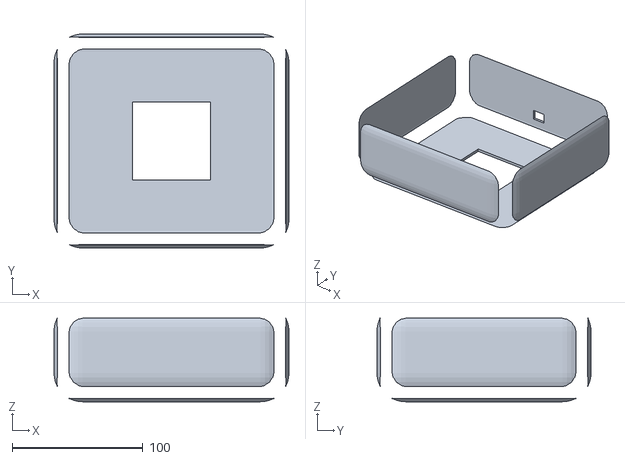
[picture p132: CAD file, 2026-10-11]
hardware/robot-design/round-yaw-v2/stl/02_C01b_base_cup.stl
180.0 x 164.0 x 64.0
