eleanor-wsyy/EffMeet2/hardware/robot-design/round-yaw-v2/fit-coupons/03_servo_pocket_and_wall.stl

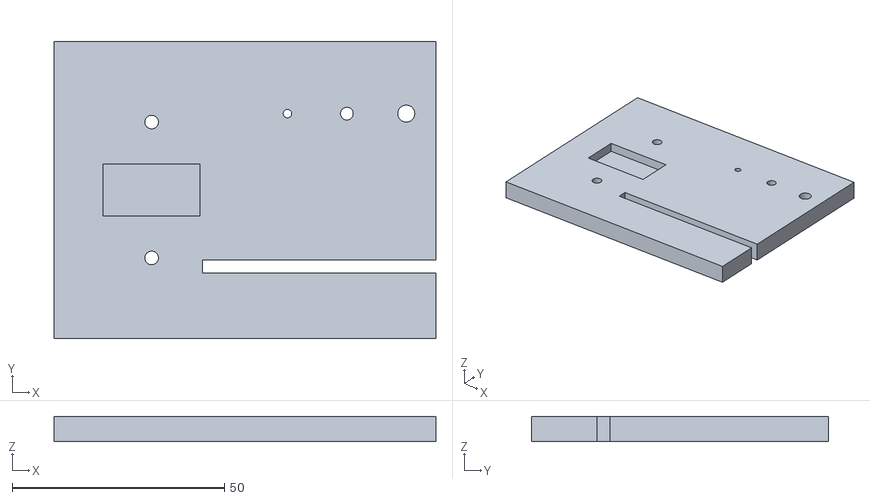
[picture p133: CAD file, 2026-10-11]
hardware/robot-design/round-yaw-v2/fit-coupons/03_servo_pocket_and_wall.stl
90.0 x 70.0 x 6.00
