eleanor-wsyy/EffMeet2/hardware/robot-design/round-yaw-v2/revision-20261011-nomi-layoutA/print-split-v6/candidate-stl/P33_CAMERA_BACK_PLATE_UNVERIFIED.stl

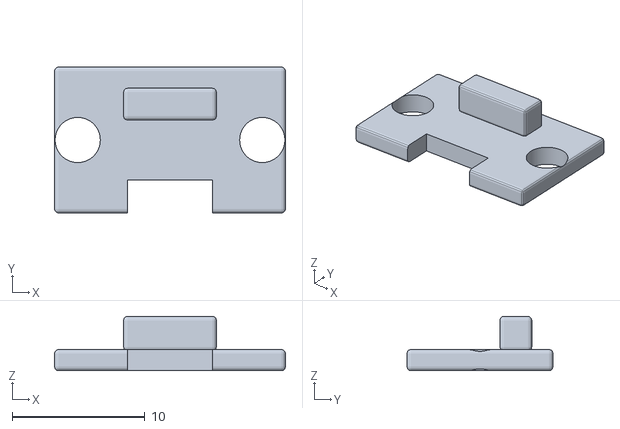
[picture p134: CAD file, 2026-10-19]
hardware/robot-design/round-yaw-v2/revision-20261011-nomi-layoutA/print-split-v6/candidate-stl/P33_CAMERA_BACK_PLATE_UNVERIFIED.stl
17.4 x 11.0 x 4.10
