eleanor-wsyy/EffMeet2/hardware/robot-design/round-yaw-v2/revision-20261011-nomi-layoutA/print-split-v6/plates/plate_B1_v6.3mf

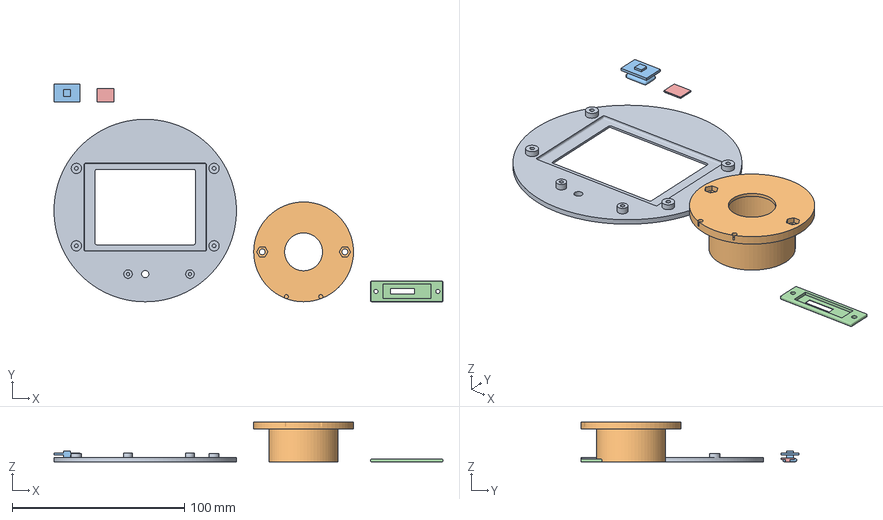
[picture p135: CAD file, 2026-10-13]
hardware/robot-design/round-yaw-v2/revision-20261011-nomi-layoutA/print-split-v6/plates/plate_B1_v6.3mf
226.0 x 126.4 x 23.1 mm
P24_N6_FACE_PANEL
P14_N6_SHORT_YAW_NECK
P19_N6_STOP_KEY_CAP
P27_N6_PRIVACY_GUIDE
P28_N6_PRIVACY_BLADE
