eleanor-wsyy/EffMeet2/hardware/robot-design/round-yaw-v2/stl/01_C01a_head_shell.stl

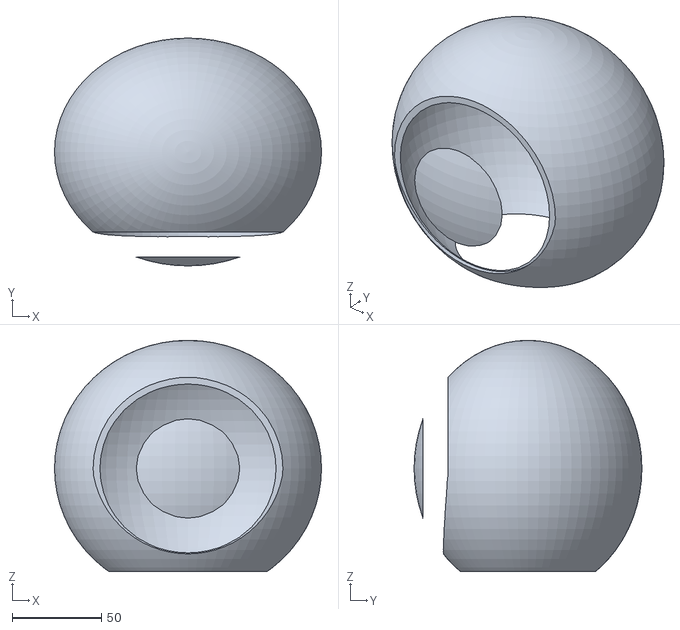
[picture p136: CAD file, 2026-10-11]
hardware/robot-design/round-yaw-v2/stl/01_C01a_head_shell.stl
150.0 x 128.0 x 130.0
