eleanor-wsyy/EffMeet2/hardware/robot-design/round-yaw-v2/revision-20261011-nomi-layoutA/print-split-v6/plates/plate_B2_v6.3mf

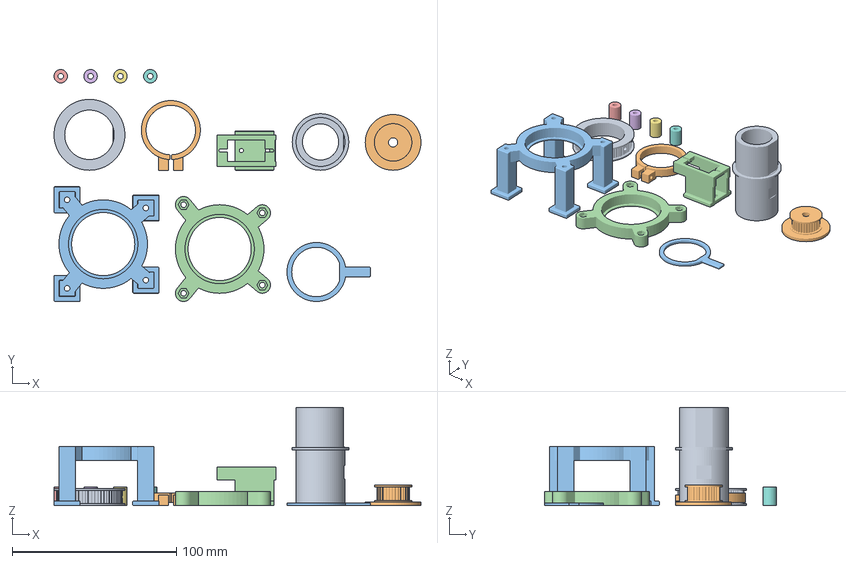
[picture p137: CAD file, 2026-10-13]
hardware/robot-design/round-yaw-v2/revision-20261011-nomi-layoutA/print-split-v6/plates/plate_B2_v6.3mf
223.7 x 141.4 x 60.0 mm
P03_N6_DRIVEN_64T
P04_N6_DRIVER_32T
P05_N6_BEARING_TOWER_LOWER_SEAT
P06_N6_UPPER_BEARING_SEAT
P07_N6_STACK_SPACER_0
P08_N6_STACK_SPACER_1
P09_N6_STACK_SPACER_2
P10_N6_STACK_SPACER_3
P11_N6_HOLLOW_LOAD_SHAFT
P12_N6_SHAFT_LOWER_LOCK_COLLAR
P13_N6_YAW_STOP_ARM
P15_N6_SERVO_ADJUSTABLE_CRADLE
