eleanor-wsyy/EffMeet2/hardware/robot-design/round-yaw-v2/stl/03_C01c_base_lid.stl

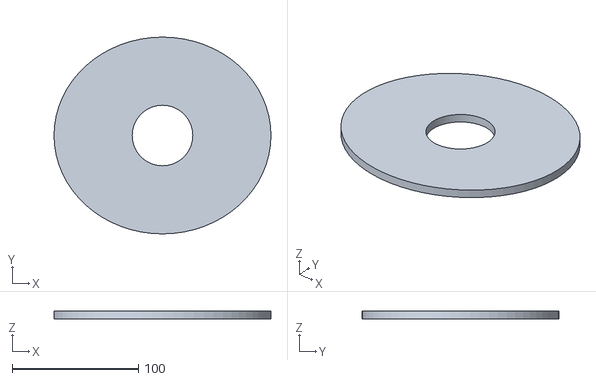
[picture p138: CAD file, 2026-10-11]
hardware/robot-design/round-yaw-v2/stl/03_C01c_base_lid.stl
172.0 x 156.0 x 6.00
