eleanor-wsyy/EffMeet2/hardware/robot-design/round-yaw-v2/revision-20261011-nomi-layoutA/print-split-v6/candidate-stl/P25_LCD_REAR_CLAMP_FRAME_UNVERIFIED.stl

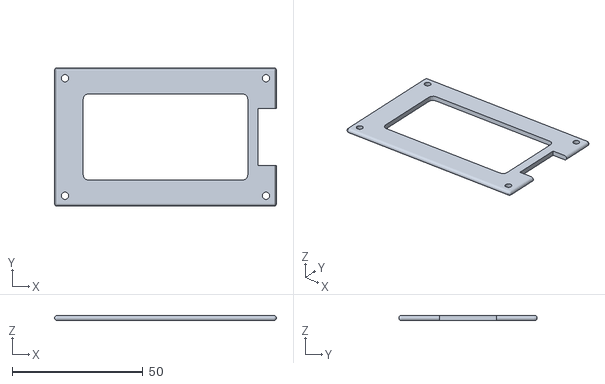
[picture p139: CAD file, 2026-10-18]
hardware/robot-design/round-yaw-v2/revision-20261011-nomi-layoutA/print-split-v6/candidate-stl/P25_LCD_REAR_CLAMP_FRAME_UNVERIFIED.stl
85.0 x 53.0 x 2.00
