eleanor-wsyy/EffMeet2/hardware/robot-design/round-yaw-v2/revision-20261011-nomi-layoutA/print-split-v6/plates-merged/TMP-INTERN2-DEC_GREY_020.3mf

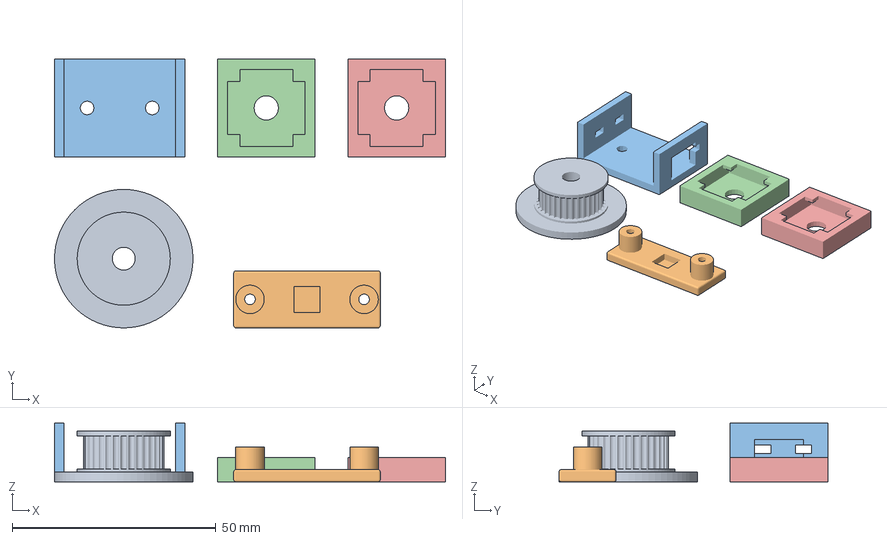
[picture p140: CAD file, 2026-10-16]
hardware/robot-design/round-yaw-v2/revision-20261011-nomi-layoutA/print-split-v6/plates-merged/TMP-INTERN2-DEC_GREY_020.3mf
96.0 x 66.0 x 14.4 mm
P04_DRIVER32T_dec
P20_TACT_HOLDER
P18T_CRADLE
P32_HOLDER_L
P32_HOLDER_R
