eleanor-wsyy/EffMeet2/hardware/robot-design/round-yaw-v2/stl/09_pulley_x2.stl

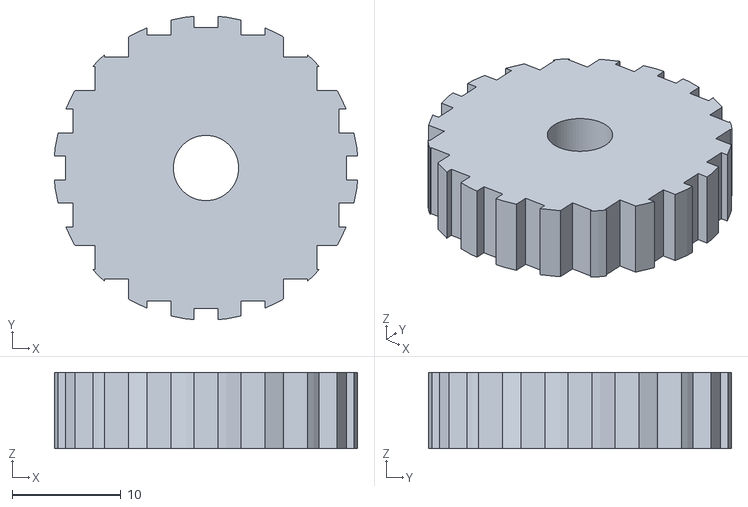
[picture p141: CAD file, 2026-10-11]
hardware/robot-design/round-yaw-v2/stl/09_pulley_x2.stl
27.9 x 27.9 x 7.00
