eleanor-wsyy/EffMeet2/hardware/robot-design/round-yaw-v2/stl/10_button_cap.stl

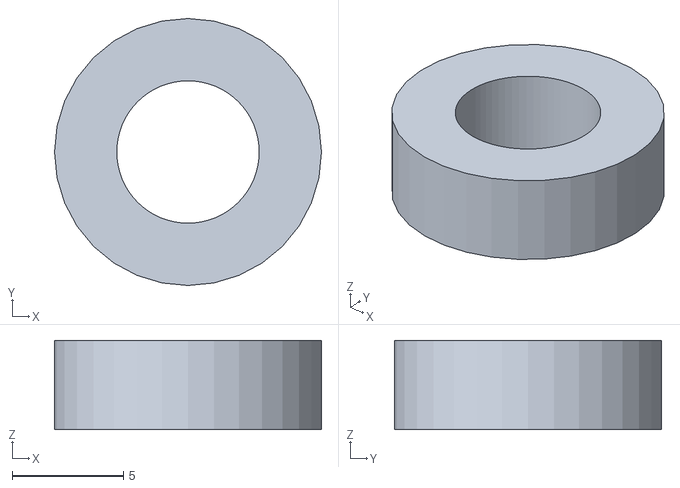
[picture p142: CAD file, 2026-10-11]
hardware/robot-design/round-yaw-v2/stl/10_button_cap.stl
12.0 x 12.0 x 4.00
