eleanor-wsyy/EffMeet2/hardware/robot-design/round-yaw-v2/revision-20261011-nomi-layoutA/print-split-v6/candidate-stl/P24_FACE_PANEL_UNVERIFIED.stl

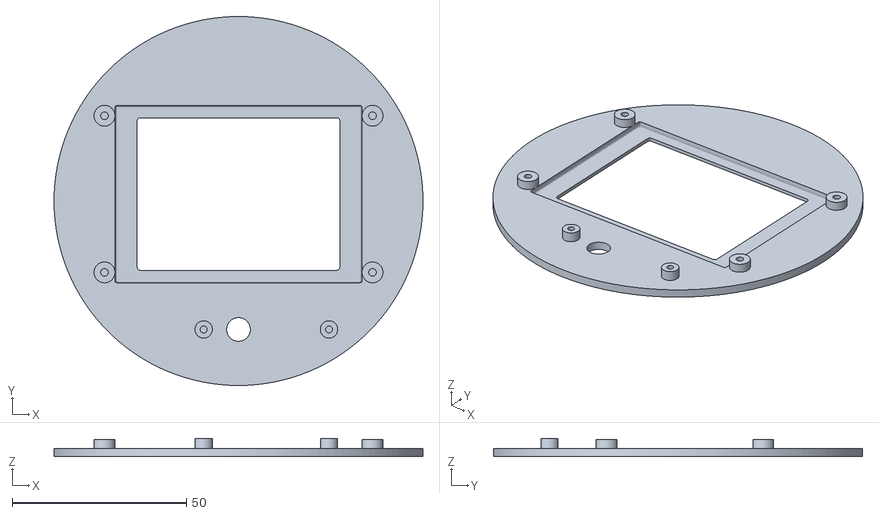
[picture p143: CAD file, 2026-10-18]
hardware/robot-design/round-yaw-v2/revision-20261011-nomi-layoutA/print-split-v6/candidate-stl/P24_FACE_PANEL_UNVERIFIED.stl
106.0 x 106.0 x 5.30
