eleanor-wsyy/EffMeet2/hardware/robot-design/round-yaw-v2/revision-20261011-nomi-layoutA/print-split-v6/plates-merged/TMP-BVIS-TILT-BLACK_012.3mf

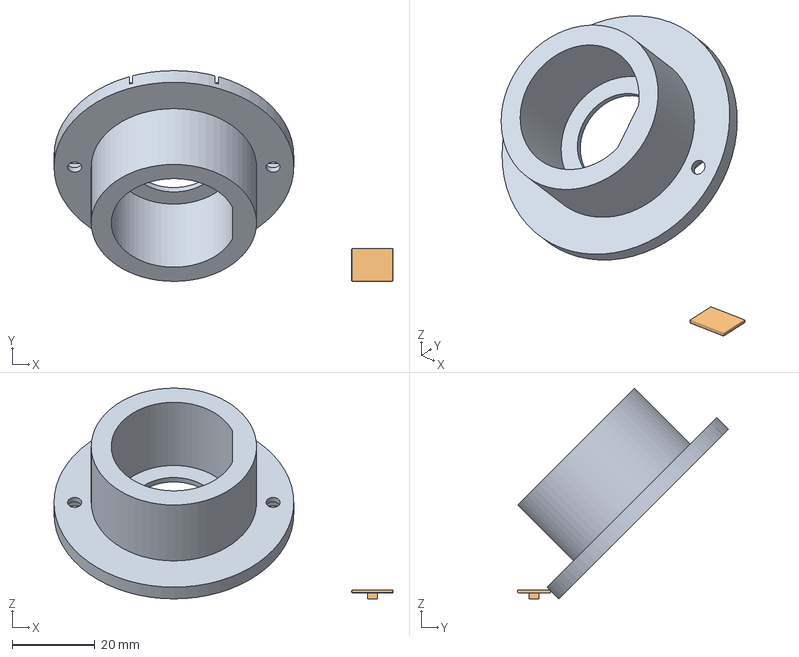
[picture p144: CAD file, 2026-10-16]
hardware/robot-design/round-yaw-v2/revision-20261011-nomi-layoutA/print-split-v6/plates-merged/TMP-BVIS-TILT-BLACK_012.3mf
82.0 x 51.0 x 51.0 mm
P14_TILT45_BAKED
P28_FLAT_BAKED
