eleanor-wsyy/EffMeet2/hardware/robot-design/round-yaw-v2/stl/07_servo_mount.stl

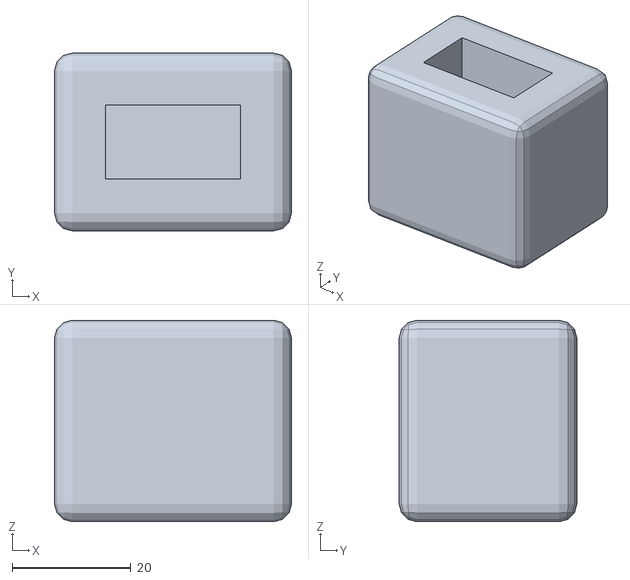
[picture p145: CAD file, 2026-10-11]
hardware/robot-design/round-yaw-v2/stl/07_servo_mount.stl
40.0 x 30.0 x 34.0
