eleanor-wsyy/EffMeet2/hardware/robot-design/round-yaw-v2/revision-20261011-nomi-layoutA/print-split-v6/candidate-stl/P30_CABLE_SADDLE_BASE_UNVERIFIED.stl

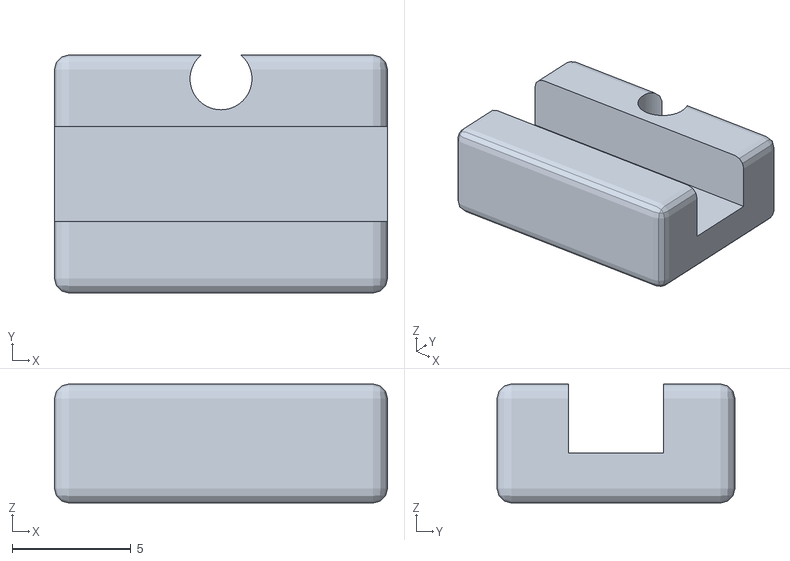
[picture p146: CAD file, 2026-10-13]
hardware/robot-design/round-yaw-v2/revision-20261011-nomi-layoutA/print-split-v6/candidate-stl/P30_CABLE_SADDLE_BASE_UNVERIFIED.stl
14.0 x 10.0 x 5.00
