eleanor-wsyy/EffMeet2/hardware/robot-design/round-yaw-v2/revision-20261011-nomi-layoutA/print-split-v6/plates-merged/TMP-NECK-PETG-A1_020.3mf

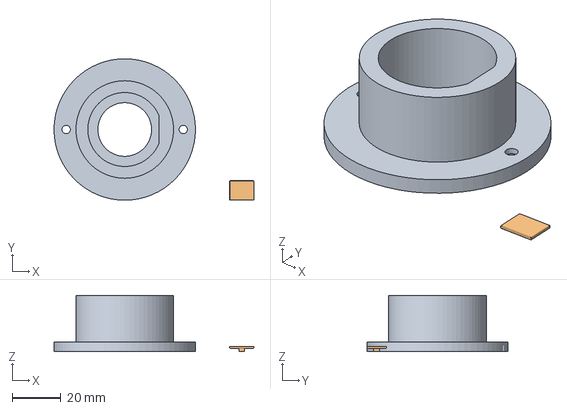
[picture p147: CAD file, 2026-10-16]
hardware/robot-design/round-yaw-v2/revision-20261011-nomi-layoutA/print-split-v6/plates-merged/TMP-NECK-PETG-A1_020.3mf
82.0 x 58.0 x 23.1 mm
P14_NECK_PETG_STANDIN
P28_BLADE_PETG_STANDIN
