eleanor-wsyy/EffMeet2/hardware/robot-design/round-yaw-v2/stl/05_C03_neck.stl

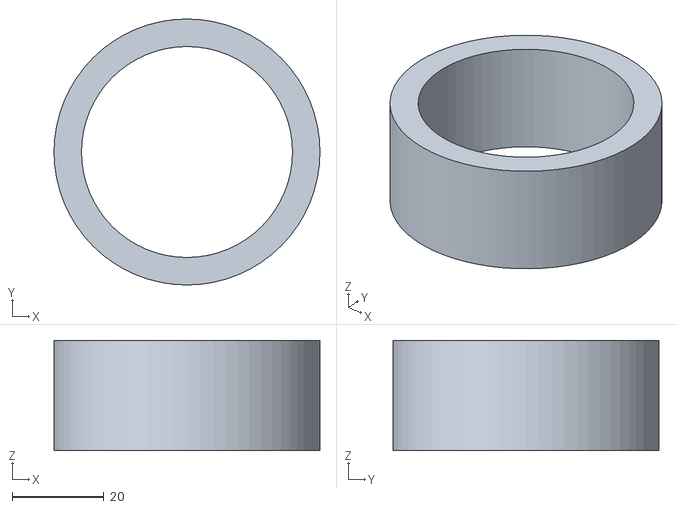
[picture p148: CAD file, 2026-10-11]
hardware/robot-design/round-yaw-v2/stl/05_C03_neck.stl
58.0 x 58.0 x 24.0
