eleanor-wsyy/EffMeet2/hardware/robot-design/round-yaw-v2/stl/12_cable_clip.stl

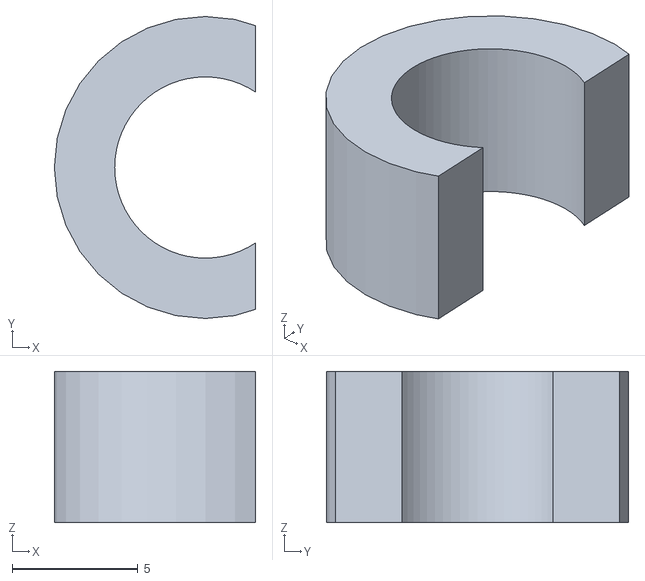
[picture p149: CAD file, 2026-10-11]
hardware/robot-design/round-yaw-v2/stl/12_cable_clip.stl
8.00 x 12.0 x 6.00
