eleanor-wsyy/EffMeet2/hardware/robot-design/round-yaw-v2/revision-20261011-nomi-layoutA/print-split-v6/candidate-stl/P19_STOP_KEY_CAP_UNVERIFIED.stl

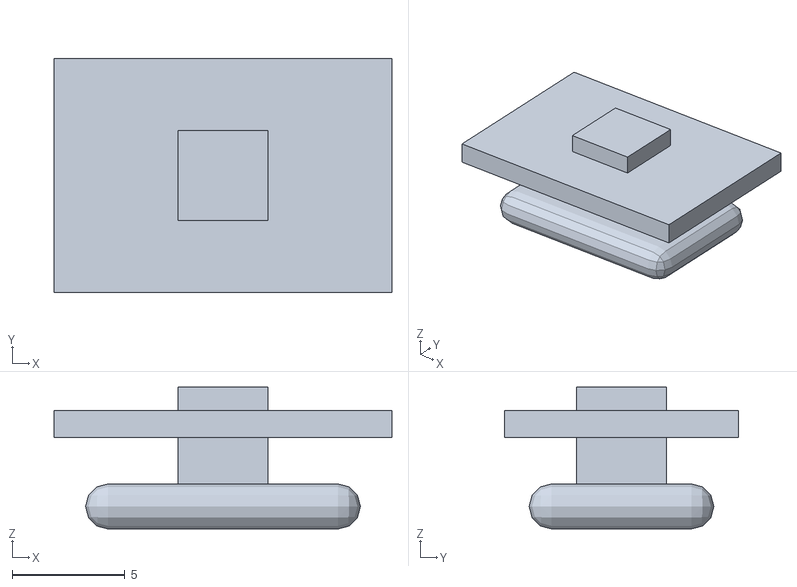
[picture p150: CAD file, 2026-10-13]
hardware/robot-design/round-yaw-v2/revision-20261011-nomi-layoutA/print-split-v6/candidate-stl/P19_STOP_KEY_CAP_UNVERIFIED.stl
15.0 x 10.4 x 6.30
