eleanor-wsyy/EffMeet2/hardware/robot-design/round-yaw-v2/revision-20261011-nomi-layoutA/print-split-v6/plates-merged/TMP-INTERN-GREY_020.3mf

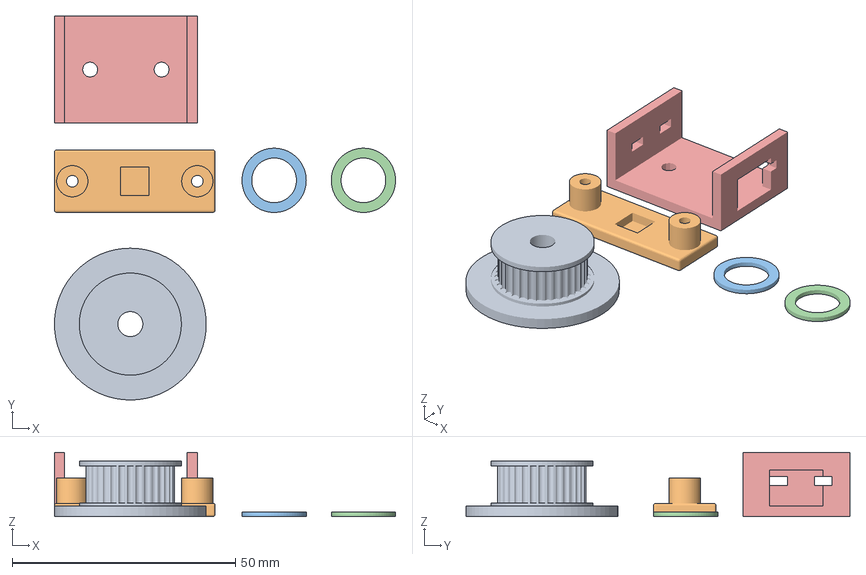
[picture p151: CAD file, 2026-10-16]
hardware/robot-design/round-yaw-v2/revision-20261011-nomi-layoutA/print-split-v6/plates-merged/TMP-INTERN-GREY_020.3mf
76.4 x 86.0 x 14.4 mm
P04_DRIVER32T_GREY
P20_TACT_HOLDER_GREY
P21_MIC_RETAINER_GREY
P22_MIC_RETAINER_GREY
P18T_CRADLE_GREY
