eleanor-wsyy/EffMeet2/hardware/robot-design/round-yaw-v2/stl/06_bearing_seat_x2.stl

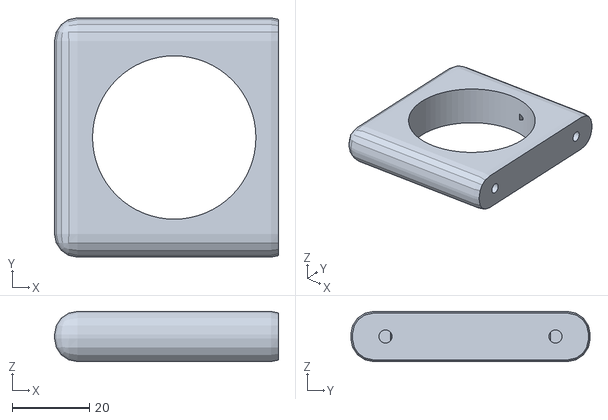
[picture p152: CAD file, 2026-10-11]
hardware/robot-design/round-yaw-v2/stl/06_bearing_seat_x2.stl
58.0 x 62.0 x 13.0
