eleanor-wsyy/EffMeet2/hardware/robot-design/round-yaw-v2/revision-20261011-nomi-layoutA/print-split-v6/candidate-stl/P08_STACK_SPACER_1_UNVERIFIED.stl

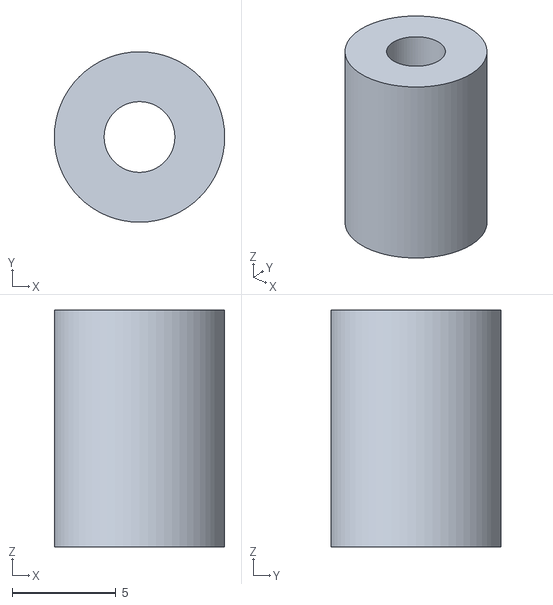
[picture p153: CAD file, 2026-10-13]
hardware/robot-design/round-yaw-v2/revision-20261011-nomi-layoutA/print-split-v6/candidate-stl/P08_STACK_SPACER_1_UNVERIFIED.stl
8.20 x 8.20 x 11.4
