eleanor-wsyy/EffMeet2/hardware/robot-design/round-yaw-v2/revision-20261011-nomi-layoutA/print-split-v6/plates-merged/TMP-MICHOLDER-GREY_020.3mf

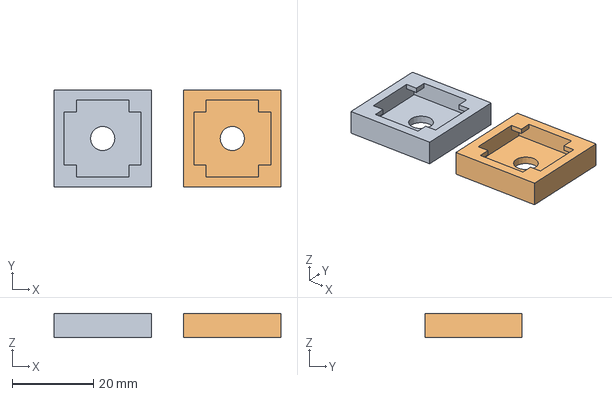
[picture p154: CAD file, 2026-10-16]
hardware/robot-design/round-yaw-v2/revision-20261011-nomi-layoutA/print-split-v6/plates-merged/TMP-MICHOLDER-GREY_020.3mf
56.0 x 24.0 x 6.00 mm
P32_MIC_HOLDER_GLUE_L
P32_MIC_HOLDER_GLUE_R
