eleanor-wsyy/EffMeet2/hardware/robot-design/round-yaw-v2/revision-20261011-nomi-layoutA/print-split-v6/plates-merged/TMP-S1PETG-A1_020.3mf

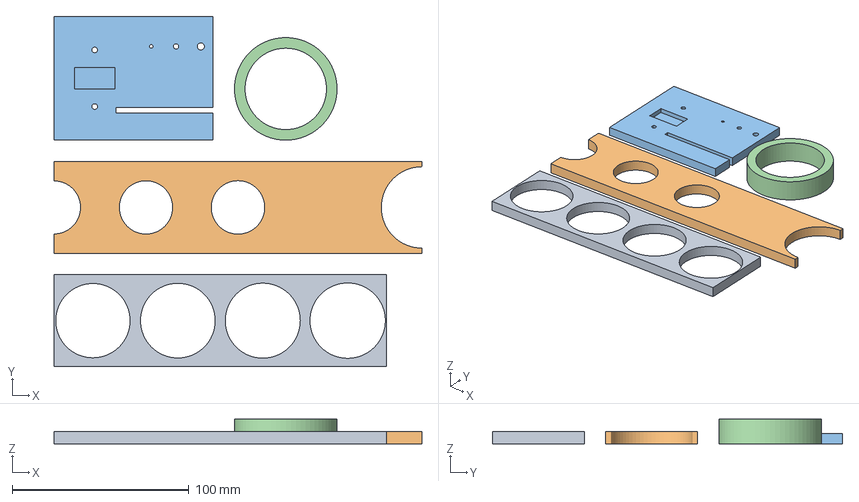
[picture p155: CAD file, 2026-10-15]
hardware/robot-design/round-yaw-v2/revision-20261011-nomi-layoutA/print-split-v6/plates-merged/TMP-S1PETG-A1_020.3mf
208.0 x 198.0 x 14.0 mm
01_bearing_OD_ladder
02_bearing_ID_and_shaft_ladder
03_servo_pocket_and_wall
04_shortneck_clearance
