eleanor-wsyy/EffMeet2/hardware/robot-design/round-yaw-v2/revision-20261011-nomi-layoutA/print-split-v6/candidate-stl/P13_YAW_STOP_ARM_UNVERIFIED.stl

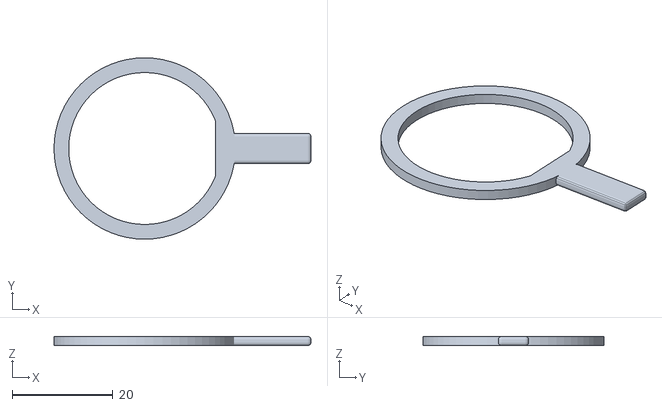
[picture p156: CAD file, 2026-10-13]
hardware/robot-design/round-yaw-v2/revision-20261011-nomi-layoutA/print-split-v6/candidate-stl/P13_YAW_STOP_ARM_UNVERIFIED.stl
51.0 x 36.0 x 1.80
