eleanor-wsyy/EffMeet2/hardware/robot-design/round-yaw-v2/revision-20261011-nomi-layoutA/print-split-v6/plates-merged/TMP-SPARE-PETG-A1_020.3mf

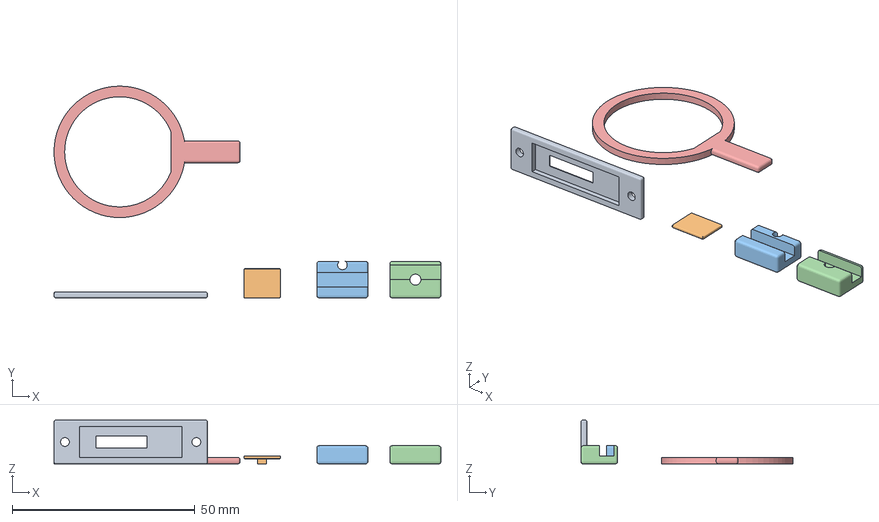
[picture p157: CAD file, 2026-10-15]
hardware/robot-design/round-yaw-v2/revision-20261011-nomi-layoutA/print-split-v6/plates-merged/TMP-SPARE-PETG-A1_020.3mf
106.0 x 58.0 x 12.0 mm
P27_PRIVACY_GUIDE_PETG
P28_PRIVACY_BLADE_PETG
P30_CABLE_SADDLE_BASE_PETG
P31_CABLE_SADDLE_HEAD_PETG
P13_YAW_STOP_ARM_PETG
