eleanor-wsyy/EffMeet2/hardware/robot-design/round-yaw-v2/revision-20261011-nomi-layoutA/print-split-v6/plates-merged/TMP-G2NIGHT_GREY_020.3mf

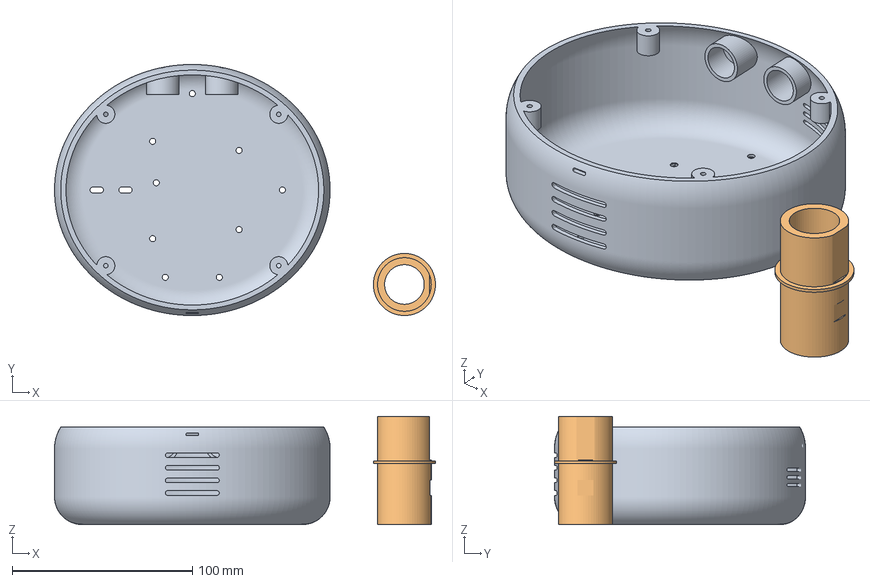
[picture p158: CAD file, 2026-10-15]
hardware/robot-design/round-yaw-v2/revision-20261011-nomi-layoutA/print-split-v6/plates-merged/TMP-G2NIGHT_GREY_020.3mf
211.5 x 139.4 x 60.0 mm
P01_N6_BASE_CUP_v6r3
P11_N6_HOLLOW_SHAFT_reprint
