eleanor-wsyy/EffMeet2/hardware/robot-design/round-yaw-v2/revision-20261011-nomi-layoutA/print-split-v6/plates-merged/TMP-BNIGHT2-BLACK_012.3mf

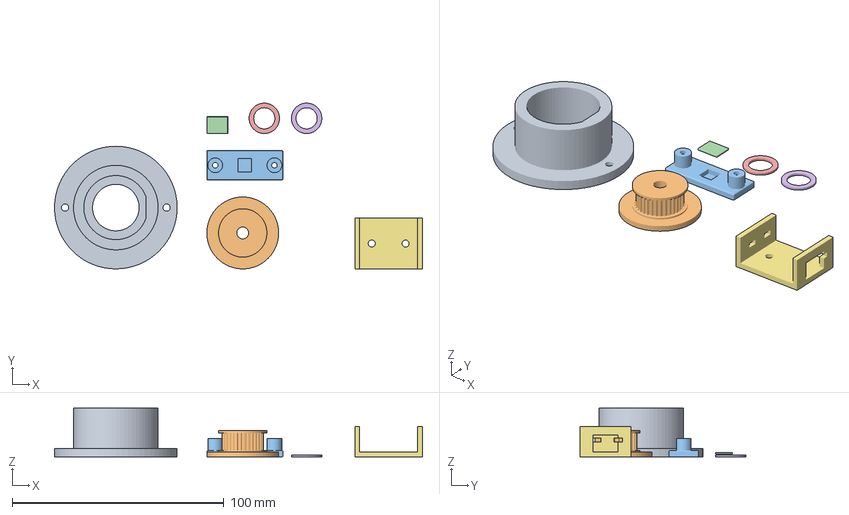
[picture p159: CAD file, 2026-10-15]
hardware/robot-design/round-yaw-v2/revision-20261011-nomi-layoutA/print-split-v6/plates-merged/TMP-BNIGHT2-BLACK_012.3mf
174.0 x 78.4 x 23.1 mm
P14_FLANGEDOWN_BAKED
P04_DRIVER32T_FLAT
P20_TACT_HOLDER_FLAT
P28_FLAT_BAKED
P21_FLAT_BAKED
P22_FLAT_BAKED
P18T_TOLERANT_CRADLE
