eleanor-wsyy/EffMeet2/hardware/robot-design/round-yaw-v2/revision-20261011-nomi-layoutA/print-split-v6/candidate-stl/P21_MIC_RETAINER_-1_UNVERIFIED.stl

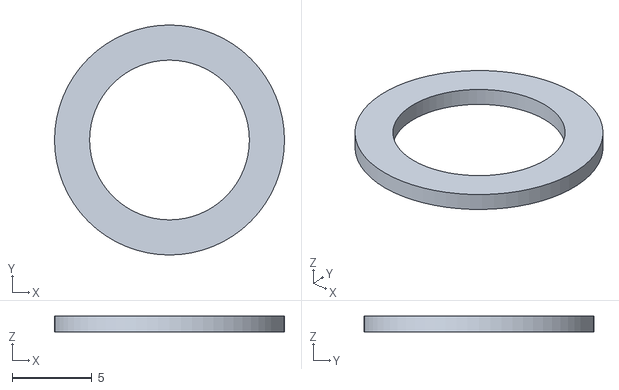
[picture p160: CAD file, 2026-10-13]
hardware/robot-design/round-yaw-v2/revision-20261011-nomi-layoutA/print-split-v6/candidate-stl/P21_MIC_RETAINER_-1_UNVERIFIED.stl
14.4 x 14.4 x 1.00
