eleanor-wsyy/EffMeet2/hardware/robot-design/round-yaw-v2/revision-20261011-nomi-layoutA/print-split-v6/plates-merged/TMP-BMORN_BLACK_016.3mf

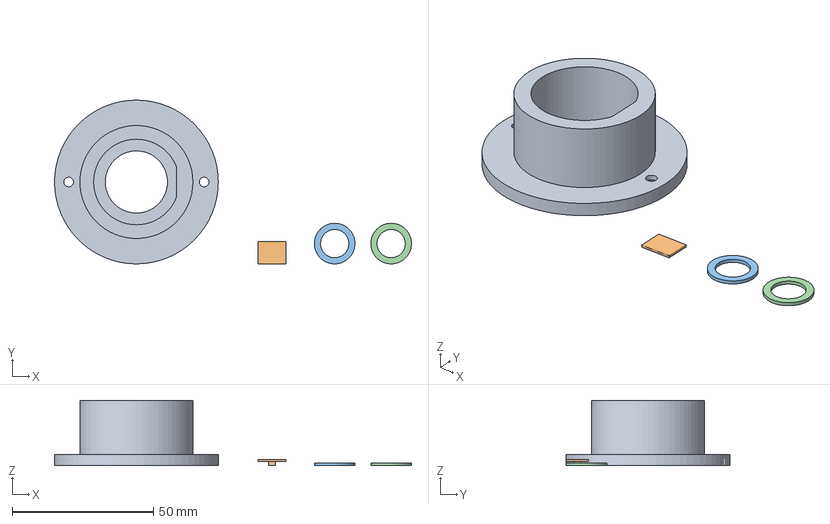
[picture p161: CAD file, 2026-10-15]
hardware/robot-design/round-yaw-v2/revision-20261011-nomi-layoutA/print-split-v6/plates-merged/TMP-BMORN_BLACK_016.3mf
126.4 x 58.0 x 23.1 mm
P14_FLANGEDOWN_BAKED
P28_FLAT_BAKED
P21_FLAT_BAKED
P22_FLAT_BAKED
