eleanor-wsyy/EffMeet2/hardware/robot-design/round-yaw-v2/revision-20261011-nomi-layoutA/print-split-v6/candidate-stl/P17_AMP_LOW_TRAY_UNVERIFIED.stl

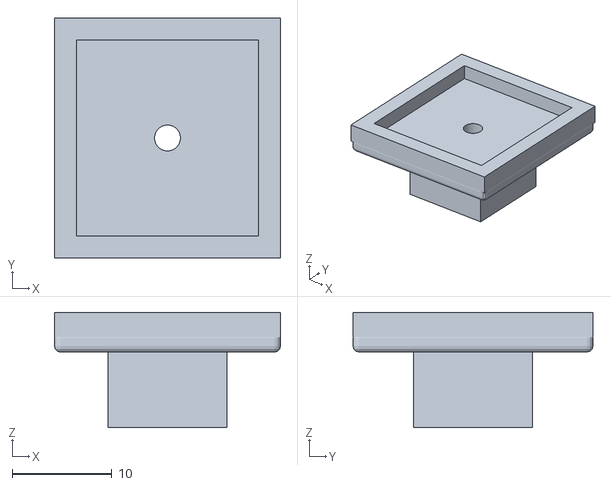
[picture p162: CAD file, 2026-10-13]
hardware/robot-design/round-yaw-v2/revision-20261011-nomi-layoutA/print-split-v6/candidate-stl/P17_AMP_LOW_TRAY_UNVERIFIED.stl
22.7 x 24.1 x 11.6
