eleanor-wsyy/EffMeet2/hardware/robot-design/round-yaw-v2/revision-20261011-nomi-layoutA/print-split-v6/plates-merged/TMP-BLACK-NIGHT_020.3mf

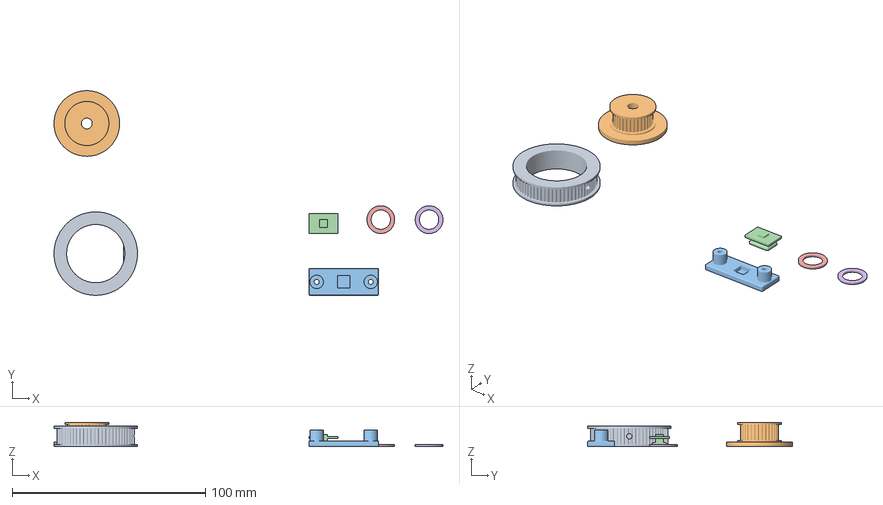
[picture p163: CAD file, 2026-10-15]
hardware/robot-design/round-yaw-v2/revision-20261011-nomi-layoutA/print-split-v6/plates-merged/TMP-BLACK-NIGHT_020.3mf
201.4 x 106.0 x 12.5 mm
P03_v6
P04_v6
P20_v6
P19_v6
P21_v6
P22_v6
