eleanor-wsyy/EffMeet2/hardware/robot-design/round-yaw-v2/revision-20261011-nomi-layoutA/print-split-v6/candidate-stl/P16_SPEAKER_CRADLE_UNVERIFIED.stl

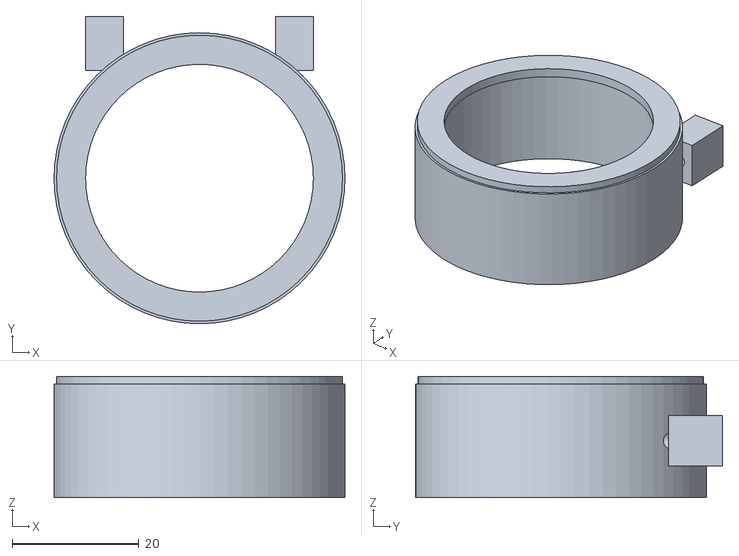
[picture p164: CAD file, 2026-10-13]
hardware/robot-design/round-yaw-v2/revision-20261011-nomi-layoutA/print-split-v6/candidate-stl/P16_SPEAKER_CRADLE_UNVERIFIED.stl
46.0 x 48.6 x 19.2
