eleanor-wsyy/EffMeet2/hardware/robot-design/round-yaw-v2/revision-20261011-nomi-layoutA/print-split-v6/plates-merged/TMP-B23p-SAFE_GREY_020.3mf

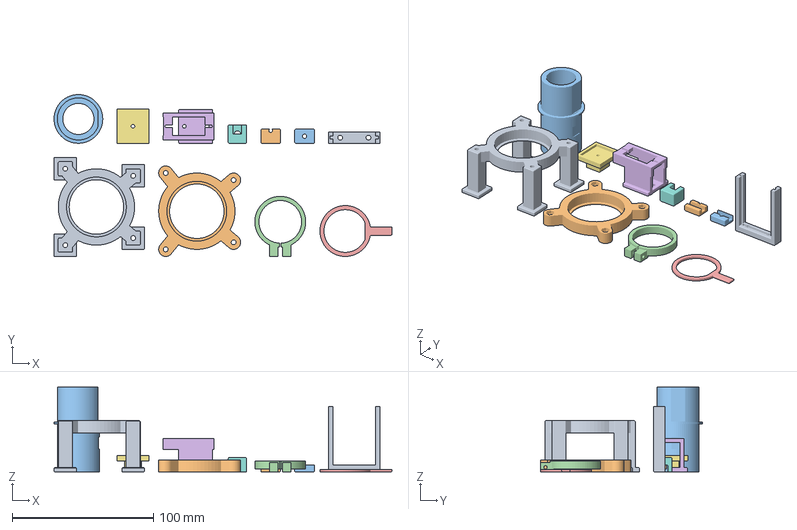
[picture p165: CAD file, 2026-10-15]
hardware/robot-design/round-yaw-v2/revision-20261011-nomi-layoutA/print-split-v6/plates-merged/TMP-B23p-SAFE_GREY_020.3mf
239.0 x 114.5 x 60.0 mm
P05_N6_BEARING_TOWER_LOWER_SEAT
P06_N6_UPPER_BEARING_SEAT
P11_N6_HOLLOW_LOAD_SHAFT
P12_N6_SHAFT_LOWER_LOCK_COLLAR
P13_N6_YAW_STOP_ARM
P15_N6_SERVO_ADJUSTABLE_CRADLE
P17_N6_AMP_LOW_TRAY
P26_N6_CAMERA_CRADLE
P29_N6_CORE_BOARD_CRADLE
P30_N6_CABLE_SADDLE_BASE
P31_N6_CABLE_SADDLE_HEAD
