eleanor-wsyy/EffMeet2/hardware/robot-design/round-yaw-v2/revision-20261011-nomi-layoutA/print-split-v6/candidate-stl/P12_SHAFT_LOWER_LOCK_COLLAR_UNVERIFIED.stl

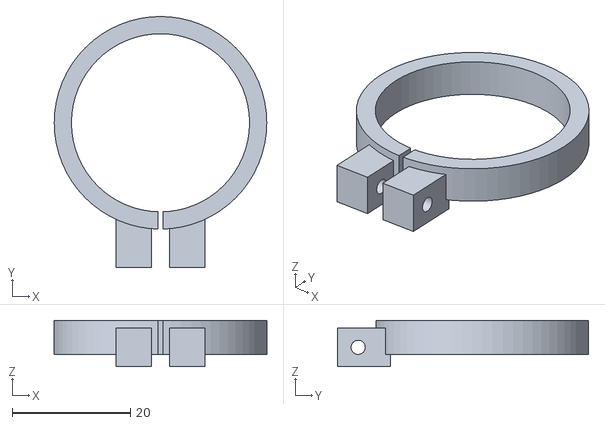
[picture p166: CAD file, 2026-10-13]
hardware/robot-design/round-yaw-v2/revision-20261011-nomi-layoutA/print-split-v6/candidate-stl/P12_SHAFT_LOWER_LOCK_COLLAR_UNVERIFIED.stl
36.0 x 42.5 x 7.80
