eleanor-wsyy/EffMeet2/hardware/robot-design/round-yaw-v2/revision-20261011-nomi-layoutA/print-split-v6/candidate-stl/P11_HOLLOW_LOAD_SHAFT_UNVERIFIED.stl

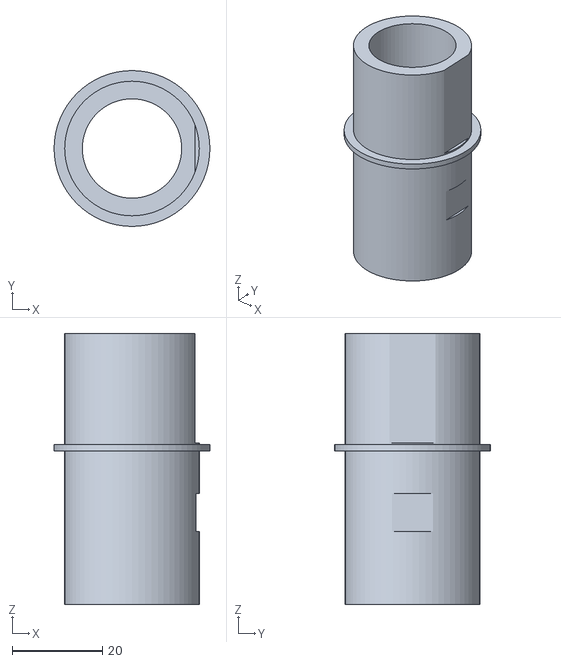
[picture p167: CAD file, 2026-10-13]
hardware/robot-design/round-yaw-v2/revision-20261011-nomi-layoutA/print-split-v6/candidate-stl/P11_HOLLOW_LOAD_SHAFT_UNVERIFIED.stl
34.5 x 34.5 x 60.0
