eleanor-wsyy/EffMeet2/hardware/robot-design/round-yaw-v2/revision-20261011-nomi-layoutA/print-split-v6/plates-merged/TMP-Bsmall_BLACK_020.3mf

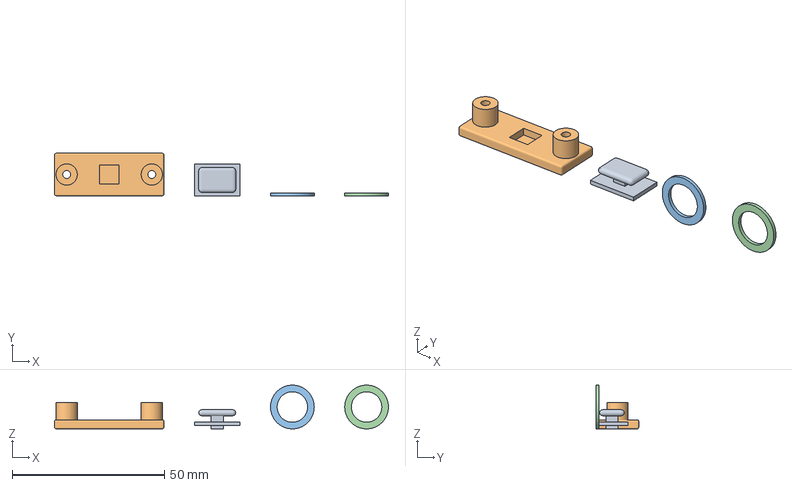
[picture p168: CAD file, 2026-10-15]
hardware/robot-design/round-yaw-v2/revision-20261011-nomi-layoutA/print-split-v6/plates-merged/TMP-Bsmall_BLACK_020.3mf
109.8 x 14.0 x 14.4 mm
P19_STOP_KEY_CAP_v6
P20_TACTILE_HOLDER_v6
P21_MIC_RETAINER_-1_v6
P22_MIC_RETAINER_1_v6
