eleanor-wsyy/EffMeet2/hardware/robot-design/round-yaw-v2/revision-20261011-nomi-layoutA/print-split-v6/plates-merged/TMP-B1p-v2_BLACK_016.3mf

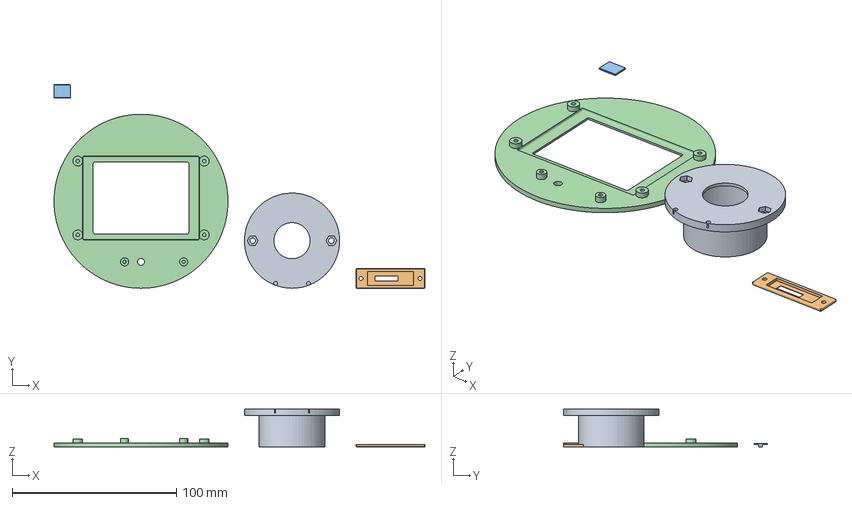
[picture p169: CAD file, 2026-10-15]
hardware/robot-design/round-yaw-v2/revision-20261011-nomi-layoutA/print-split-v6/plates-merged/TMP-B1p-v2_BLACK_016.3mf
226.0 x 124.0 x 23.1 mm
P14_reuse
P27_reuse
P28_reuse
P24_N6_FACE_PANEL_v6r2
