eleanor-wsyy/EffMeet2/hardware/robot-design/round-yaw-v2/revision-20261011-nomi-layoutA/print-split-v6/candidate-stl/P18_POWER_IN_TRAY_UNVERIFIED.stl

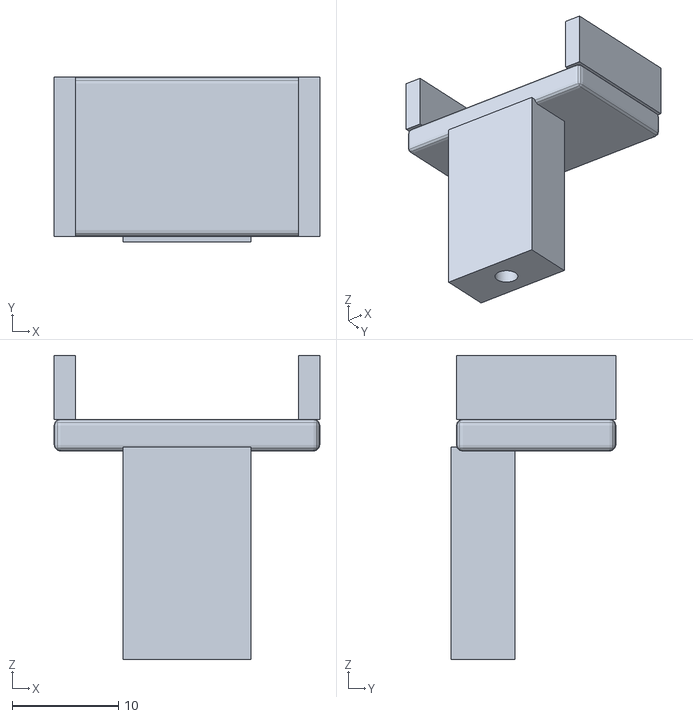
[picture p170: CAD file, 2026-10-13]
hardware/robot-design/round-yaw-v2/revision-20261011-nomi-layoutA/print-split-v6/candidate-stl/P18_POWER_IN_TRAY_UNVERIFIED.stl
25.0 x 15.5 x 28.6
