eleanor-wsyy/EffMeet2/hardware/robot-design/round-yaw-v2/revision-20261011-nomi-layoutA/print-split-v6/plates-merged/TMP-THINP25_GREY_016.3mf

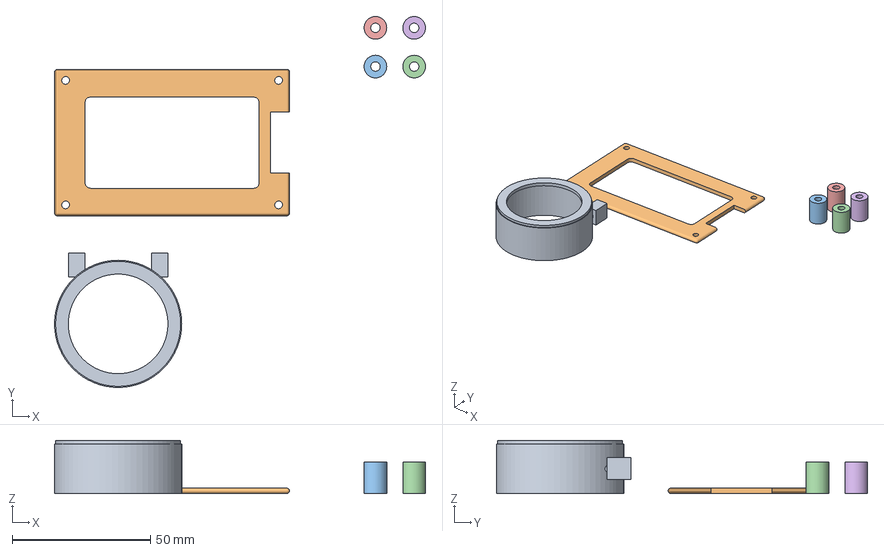
[picture p171: CAD file, 2026-10-15]
hardware/robot-design/round-yaw-v2/revision-20261011-nomi-layoutA/print-split-v6/plates-merged/TMP-THINP25_GREY_016.3mf
134.1 x 134.1 x 19.2 mm
P16_v6r3
P25_v6r3
P07_v6r3
P08_v6r3
P09_v6r3
P10_v6r3
