eleanor-wsyy/EffMeet2/hardware/robot-design/round-yaw-v2/revision-20261011-nomi-layoutA/print-split-v6/candidate-stl/P14_SHORT_YAW_NECK_UNVERIFIED.stl

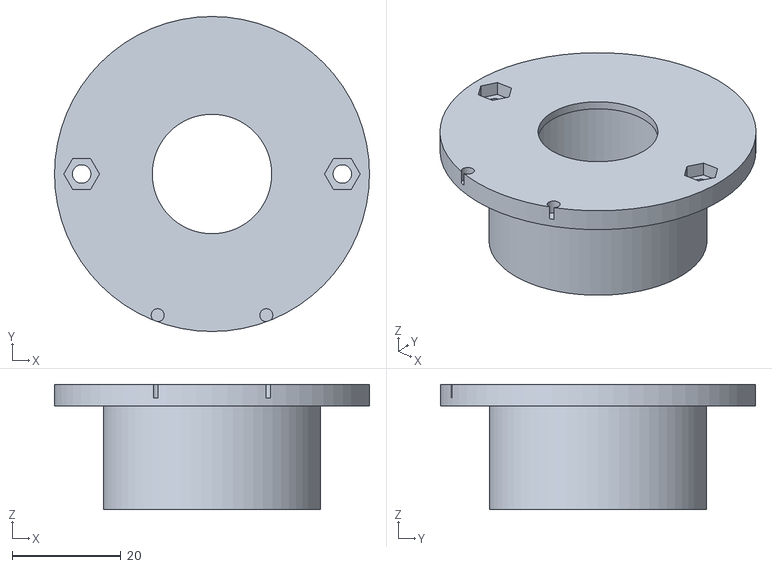
[picture p172: CAD file, 2026-10-13]
hardware/robot-design/round-yaw-v2/revision-20261011-nomi-layoutA/print-split-v6/candidate-stl/P14_SHORT_YAW_NECK_UNVERIFIED.stl
58.0 x 58.0 x 23.1
