eleanor-wsyy/EffMeet2/(list of files, cad)

Other CAD files:
today-20261019/plates/TMP-FIX-P15P17P26P29_BLACK_016.3mf
today-20261020/plates/TMP-FIX-P23_GREY_016.stl
hardware/print-jobs/reprint-20261018/TMP-FIX-P03P05P06_GREY_016.3mf
hardware/robot-design/round-yaw-v2/revision-20261011-nomi-layoutA/print-split-v6/candidate-stl/P27_PRIVACY_GUIDE_UNVERIFIED.stl
hardware/robot-design/round-yaw-v2/revision-20261011-nomi-layoutA/print-split-v6/plates-merged/TMP-FIX-P23_GREY_016.3mf
hardware/robot-design/round-yaw-v2/revision-20261011-nomi-layoutA/print-split-v6/plates/plate_G3_v6.3mf
today-20261019/plates/TMP-P18T_BLACK_020.3mf
today-20261020/plates/FIX2_P15P26P33_BLACK_016.stl
hardware/print-jobs/today-20261019/single-parts/P26_CAMERA_CRADLE_ASIS_ROTATE90X.stl
hardware/robot-design/round-yaw-v2/revision-20261011-nomi-layoutA/print-split-v6/plates-merged/P28_PRIVACY_BLADE_RETAINFIX.stl
hardware/print-jobs/reprint-20261018/TMP-FIX-P28_BLACK_012.stl
hardware/robot-design/round-yaw-v2/revision-20261011-nomi-layoutA/print-split-v6/candidate-stl/P29_CORE_BOARD_CRADLE_UNVERIFIED.stl
hardware/robot-design/round-yaw-v2/revision-20261011-nomi-layoutA/print-split-v6/plates-merged/P29_CORE_BOARD_CRADLE_EDGEGRIP.stl
hardware/print-jobs/reprint-20261018/P28_PRIVACY_BLADE.stl
hardware/robot-design/round-yaw-v2/revision-20261011-nomi-layoutA/print-split-v6/plates-merged/TMP-FIX-P15P17P26P29_BLACK_016.3mf
hardware/robot-design/round-yaw-v2/revision-20261011-nomi-layoutA/print-split-v6/candidate-stl/P15_SERVO_ADJUSTABLE_CRADLE_UNVERIFIED.stl
hardware/robot-design/round-yaw-v2/revision-20261011-nomi-layoutA/print-split-v6/plates-merged/TMP-FIX-P02P20_GREY_016.3mf
hardware/robot-design/round-yaw-v2/revision-20261011-nomi-layoutA/print-split-v6/candidate-stl/P01_BASE_CUP_UNVERIFIED.stl
hardware/robot-design/round-yaw-v2/revision-20261011-nomi-layoutA/print-split-v6/plates-merged/TMP-G3p-DEC_GREY_016.3mf
hardware/robot-design/round-yaw-v2/revision-20261011-nomi-layoutA/print-split-v6/candidate-stl/P06_UPPER_BEARING_SEAT_UNVERIFIED.stl
hardware/robot-design/round-yaw-v2/revision-20261011-nomi-layoutA/print-split-v6/plates-merged/TMP-BVIS-BLACK_012.3mf
hardware/robot-design/round-yaw-v2/revision-20261011-nomi-layoutA/print-split-v6/candidate-stl/P26_CAMERA_CRADLE_UNVERIFIED.stl
hardware/robot-design/round-yaw-v2/revision-20261011-nomi-layoutA/print-split-v6/candidate-stl/P03_DRIVEN_64T_UNVERIFIED.stl
hardware/robot-design/round-yaw-v2/revision-20261011-nomi-layoutA/print-split-v6/candidate-stl/P31_CABLE_SADDLE_HEAD_UNVERIFIED.stl
hardware/robot-design/round-yaw-v2/revision-20261011-nomi-layoutA/print-split-v6/candidate-stl/P04_DRIVER_32T_UNVERIFIED.stl
hardware/robot-design/round-yaw-v2/revision-20261011-nomi-layoutA/print-split-v6/plates-merged/TMP-COUPON_GREY_020.3mf
hardware/robot-design/round-yaw-v2/revision-20261011-nomi-layoutA/print-split-v6/candidate-stl/P09_STACK_SPACER_2_UNVERIFIED.stl
hardware/robot-design/round-yaw-v2/revision-20261011-nomi-layoutA/print-split-v6/plates-merged/P01_v6r3_tolerant_usbc.stl
hardware/robot-design/round-yaw-v2/revision-20261011-nomi-layoutA/print-split-v6/candidate-stl/P02_BASE_LID_UNVERIFIED.stl
hardware/robot-design/round-yaw-v2/revision-20261011-nomi-layoutA/print-split-v6/plates-merged/P23_v6r2_77x45.stl
hardware/robot-design/round-yaw-v2/revision-20261011-nomi-layoutA/print-split-v6/plates-merged/TMP-G1p_GREY_016.3mf
hardware/robot-design/round-yaw-v2/revision-20261011-nomi-layoutA/print-split-v6/candidate-stl/P07_STACK_SPACER_0_UNVERIFIED.stl
hardware/robot-design/round-yaw-v2/revision-20261011-nomi-layoutA/print-split-v6/plates-merged/P25_v6r2_77x45.stl
hardware/robot-design/round-yaw-v2/revision-20261011-nomi-layoutA/print-split-v6/plates-merged/P24_v6r2_77x45.stl
hardware/robot-design/round-yaw-v2/revision-20261011-nomi-layoutA/print-split-v6/candidate-stl/P10_STACK_SPACER_3_UNVERIFIED.stl
hardware/robot-design/round-yaw-v2/revision-20261011-nomi-layoutA/print-split-v6/candidate-stl/P22_MIC_RETAINER_1_UNVERIFIED.stl
hardware/robot-design/round-yaw-v2/revision-20261011-nomi-layoutA/print-split-v6/plates-merged/TMP-G3p_GREY_016.3mf
hardware/robot-design/round-yaw-v2/revision-20261011-nomi-layoutA/print-split-v6/candidate-stl/P05_BEARING_TOWER_LOWER_SEAT_UNVERIFIED.stl
hardware/print-jobs/today-20261020/plates/TMP-FIX-P27P28_BLACK_016.stl
hardware/print-jobs/today-20261020/plates/TMP-FIX-P29B_BLACK_016.stl
hardware/robot-design/archive/seat-card-v1/EffMeet2_席位牌_封装布局_v1_审阅.blend
hardware/robot-design/round-yaw-v2/EffMeet2_圆润转头版_封装布局_v2.blend
hardware/robot-design/round-yaw-v2/revision-20261011-nomi-layoutA/EffMeet2_NOMI_布局A_工程候选_v4.blend
hardware/robot-design/round-yaw-v2/revision-20261011-nomi-layoutA/print-split-v5/EffMeet2_NOMI_布局A_v5_拆件候选.blend
hardware/robot-design/round-yaw-v2/revision-20261011-nomi-layoutA/print-split-v5/candidate-stl/P01_HEAD_SHELL_UNVERIFIED.stl
hardware/robot-design/round-yaw-v2/revision-20261011-nomi-layoutA/print-split-v5/candidate-stl/P02_FACE_PANEL_UNVERIFIED.stl
hardware/robot-design/round-yaw-v2/revision-20261011-nomi-layoutA/print-split-v5/candidate-stl/P03_SHORT_YAW_NECK_UNVERIFIED.stl
hardware/robot-design/round-yaw-v2/revision-20261011-nomi-layoutA/print-split-v5/candidate-stl/P04_BASE_LID_UNVERIFIED.stl
hardware/robot-design/round-yaw-v2/revision-20261011-nomi-layoutA/print-split-v5/candidate-stl/P05_BASE_CUP_UNVERIFIED.stl
hardware/robot-design/round-yaw-v2/revision-20261011-nomi-layoutA/print-split-v5/candidate-stl/P06_BEARING_TOWER_UNVERIFIED.stl
hardware/robot-design/round-yaw-v2/revision-20261011-nomi-layoutA/print-split-v5/candidate-stl/P07_BEARING_SEAT_LOWER_LEFT_UNVERIFIED.stl
hardware/robot-design/round-yaw-v2/revision-20261011-nomi-layoutA/print-split-v5/candidate-stl/P08_BEARING_SEAT_LOWER_RIGHT_UNVERIFIED.stl
hardware/robot-design/round-yaw-v2/revision-20261011-nomi-layoutA/print-split-v5/candidate-stl/P09_BEARING_SEAT_UPPER_LEFT_UNVERIFIED.stl
hardware/robot-design/round-yaw-v2/revision-20261011-nomi-layoutA/print-split-v5/candidate-stl/P10_BEARING_SEAT_UPPER_RIGHT_UNVERIFIED.stl
hardware/robot-design/round-yaw-v2/revision-20261011-nomi-layoutA/print-split-v5/candidate-stl/P11_BEARING_STACK_SPACER_1_UNVERIFIED.stl
hardware/robot-design/round-yaw-v2/revision-20261011-nomi-layoutA/print-split-v5/candidate-stl/P12_BEARING_STACK_SPACER_2_UNVERIFIED.stl
hardware/robot-design/round-yaw-v2/revision-20261011-nomi-layoutA/print-split-v5/candidate-stl/P13_BEARING_STACK_SPACER_3_UNVERIFIED.stl
hardware/robot-design/round-yaw-v2/revision-20261011-nomi-layoutA/print-split-v5/candidate-stl/P14_BEARING_STACK_SPACER_4_UNVERIFIED.stl
hardware/robot-design/round-yaw-v2/revision-20261011-nomi-layoutA/print-split-v5/candidate-stl/P15_HOLLOW_LOAD_SHAFT_UNVERIFIED.stl
hardware/robot-design/round-yaw-v2/revision-20261011-nomi-layoutA/print-split-v5/candidate-stl/P16_SHAFT_LOWER_LOCK_COLLAR_UNVERIFIED.stl
hardware/robot-design/round-yaw-v2/revision-20261011-nomi-layoutA/print-split-v5/candidate-stl/P17_DRIVEN_64T_WHEEL_UNVERIFIED.stl
hardware/robot-design/round-yaw-v2/revision-20261011-nomi-layoutA/print-split-v5/candidate-stl/P18_DRIVER_64T_WHEEL_UNVERIFIED.stl
hardware/robot-design/round-yaw-v2/revision-20261011-nomi-layoutA/print-split-v5/candidate-stl/P19_SERVO_ADJUSTABLE_CRADLE_UNVERIFIED.stl
hardware/robot-design/round-yaw-v2/revision-20261011-nomi-layoutA/print-split-v5/candidate-stl/P20_PRIVACY_GUIDE_BASE_UNVERIFIED.stl
hardware/robot-design/round-yaw-v2/revision-20261011-nomi-layoutA/print-split-v5/candidate-stl/P21_PRIVACY_MOVING_BLADE_UNVERIFIED.stl
hardware/robot-design/round-yaw-v2/revision-20261011-nomi-layoutA/print-split-v5/candidate-stl/P22_PRIVACY_FRONT_RETAINER_UNVERIFIED.stl
hardware/robot-design/round-yaw-v2/revision-20261011-nomi-layoutA/print-split-v5/candidate-stl/P23_LCD_BUDGET_FRAME_UNVERIFIED.stl
hardware/robot-design/round-yaw-v2/revision-20261011-nomi-layoutA/print-split-v5/candidate-stl/P24_LCD_PRESSURE_FRAME_UNVERIFIED.stl
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
