eleanor-wsyy/EffMeet2/hardware/print-jobs/README.md

# print-jobs：按日期归档的打印作业包

每次上机打印的工作副本（单件 STL、整盘 3MF/STL、盘卡、当日计划）按原日期目录归档于此，均为历史记录；**现行件与当前打印入口仍以 [../robot-design/round-yaw-v2/revision-20261011-nomi-layoutA/print-split-v6/README.md](../robot-design/round-yaw-v2/revision-20261011-nomi-layoutA/print-split-v6/README.md) 为准**。

| 目录 | 日期 | 内容 |
|---|---|---|
| `reprint-20261018/` | 2026-10-18 | P03/P05/P06/P28 重打盘（已实打成功），含 PRINT-CARD-REPRINT.md |
| `print-20261019/` | 2026-10-19 | 11 件单件 PRINT STL + 5 盘拼盘 |
| `reprint-20261019-v6r3/` | 2026-10-19 晚 | v6r3 修复盘：P15 让位槽、P26 重设计、新增 P33，含 PRINT-CARD-V6R3.md |
| `today-20261019/` | 2026-10-19 | 当日副本打包（拷 U 盘用）：单件 + 盘 3MF + 盘卡 + MORNING-PLAN |
| `today-20261020/` | 2026-10-20 | 当日打印包：P23 灰盘 + 七合一黑盘 + 盘卡 + MORNING-PLAN |

说明：这些目录是「当次打印怎么打」的证据留档；目录之间以原名互相引用（如同级 `reprint-20261019-v6r3/`），移动后相对关系不变。
