eleanor-wsyy/EffMeet2/reprint-20261019-v6r3/PRINT-CARD-V6R3.md

# v6r3 修复盘 · 2026-10-19 晚（P15 / P26 / P33）

> 实打发现两个装配缺陷后的修复包：①P15 舵机座没有出线让位，MG90S 线束顶住塞不进；②P26 摄像托架没有保持结构，8×8 模组在腔里晃。
> 源：`build_v6.py`（v6r3）→ `candidate-stl/` 重出；**其余 29 件 STL 字节不变**（逐件 diff 0 漂移）。校验：`verify_v6_delivery.py` PASS（32 件，含新增 P33）。

## 件与变化

| 件 | 变化 | 单件 STL |
|---|---|---|
| **P15** 舵机可调耳架 | 新增尾端出线让位槽（宽 6.8、通高 9.6，尾端底角出线落到底板下）；口袋 13.7 与张紧槽不变。**合并 main 后叠加**：耳垫张紧导孔带 1mm 孔底（线不楔入）、底板 M3 导孔改盲孔（螺尖不顶线，用 M3×6）——取代 `plates-merged/P15_SERVO_CRADLE_WIREFIX.stl`（P15B） | `P15_SERVO_CRADLE_V6R3.stl` |
| **P26** 摄像托架 | 重设计：前壁 3.5（镜头凸 4 → 伸入 P24 的 6.8 孔 0.5~0.7 自动导向）；腔 8.6×8.6 贯通背面；背腔 2.6 供 FPC 折弯；两侧背柱（Ø2.5 导孔、柱距 13.9） | `P26_CAMERA_CRADLE_V6R3.stl` |
| **P33** 摄像头背板（新件） | FPC 槽 6.4×2.5；2×Ø3.4 孔（距 13.9）；压筋顶模组背面（名义零压）；2×M3×8 自攻锁 P26 背柱 | `P33_CAMERA_BACK_PLATE_V6R3.stl` |

## 盘

- `FIX2_P15P26P33_BLACK_016.stl`：三件合一盘（已按导出朝向摆好，间距 ≥10）；也可以把三个单件 STL 直接拖进 Bambu（导出朝向即打印朝向，不用转正）。

## 切片设置（黑 PLA Matte，A1）

- 层高 **0.16**、4 墙、Gyroid 15%、检查薄壁开。
- **P26**：镜管朝床（导出朝向）；支撑关；brim 5。
- **P33**：板面平放、压筋/FPC 槽向上；支撑关；brim 5（首层约 150mm² 可不加）。
- **P15**：局部树支撑 5%（z15–16/20–21，同 10-19 修复盘卡）；让位槽是竖直通透槽，不需要支撑。
- 不要用旧 `EffMeet2-v6 0.20 H2S` 预设（wall 6 / sbpo 0）。

## 下机 30 秒检查

- P15：口袋 **13.7**；让位槽宽 **6.8**（舵机线能自由通过）；张紧槽 ±2 完好、**槽底 1mm 未被钻穿**；底板 M3 盲孔**不通**。
- P26：镜管 **6.5**；两背柱导孔 **Ø2.5**、柱距 **13.9**；前壁无堵料（镜头能穿）。
- P33：孔 **Ø3.4** 距 **13.9**；FPC 槽 **6.4×2.5**；压筋完好。
- 超差 → 停，按 `MEASUREMENTS.csv` 记 `MEASURED_UNFITTED`，不硬装。

## 配套装配（详见 ASSEMBLY.md §1.4 / §3.3 / §7）

- 舵机：**线先穿让位槽**再落舵机。
- 摄像头：FPC 先穿 P33 槽 → 模组入腔 → 盖 P33 → **2×M3×8 自攻**（拧到板贴背即停，过拧裂柱）。
- 旧 P15/P26 打印件：P15 可锉/钻尾端槽救场；P26 无救（没有保持结构），用 v6r3 件。
