eleanor-wsyy/EffMeet2/docs/handoff/2026-10-07-装配联调计划.md

# 组装与联调联试计划 · 2026-10-07

> **2026-10-13：本文整机尺寸与布局口径已作废，以 [v6紧凑候选·布局A2](../../hardware/robot-design/round-yaw-v2/revision-20261011-nomi-layoutA/print-split-v6/README.md) 为准（153×139.4×200.8，核心板在头部）。** 下文"180×164×222"等旧数值仅供追溯。

> 2026-10-10补充：外观/采购已切换至[圆润转头版交接](../archive/handoff/2026-10-10-robot-design-and-bom.md)（已归档）。本文是联调计划，不是已完成验收；[原始计划](../../hardware/robot-design/archive/legacy-enclosure/assembly-plan-20261007-original.md)保留用于追溯。

> 面向 F（结构装配）+ C（硬件）+ B（集成）。按 C 的验收顺序展开，每步有明确通过标准。

## 0. 前置

- 硬件采购到位（清单见 [当前 BOM](../../hardware/robot-design/round-yaw-v2/BOM.md)）
- 外壳按 [统一交接](../../hardware/robot-design/HANDOFF.md) 与 [round-yaw-v2 说明](../../hardware/robot-design/round-yaw-v2/README.md) 执行
- ~~实际尺寸以 round-yaw-v2 为准：整机 180×164×222mm~~（2026-10-13 起作废；现行 **153×139.4×200.8**，见顶部横幅）

## 联调联试七步（按序，每步通过才进下一步）

### 第 1 步 · 烧录与启动（F+C，0.5 天）
- 烧录固件，串口日志无报错
- 状态灯上电进入 idle（灯色/含义以冻结后的状态表为准）
- 通过标准：连续重启 3 次均正常启动

### 第 2 步 · 拾音（C，0.5 天）
- 按实板和AFE配置核验双麦输入及播放参考，电平正常；不沿用旧计划“4路麦克风”的未经核验前提
- 距 1m 正常说话可转写；3m 小声说话触发 AGC
- 通过标准：TEST_GUIDE T07 及场景用例表 #11/#12 相关项通过

### 第 3 步 · 播放与停止（C+B，0.5 天）
- TTS 播报出声清晰；停止键立即静音
- 播放互斥：新播报不打断进行中的播报（排队）
- 通过标准：smoke 音频会话开/关通过 + 物理停止键实测

### 第 4 步 · Wi-Fi 音频链路与回执（C+B，1 天）
- 现场 PCM → relay → FunASR → 入账（channel=onsite）
- 远程 LiveKit 音轨 → ASR → 入账（channel=remote）
- 播报回执完整（created→playing→completed）
- 通过标准：联调场景「断网恢复」「重复消息」实测通过

### 第 5 步 · AEC 与双讲（C，1 天，**需真实声学环境**）
- 播报时麦克风回收的自声被 AEC 消除（软件兜底 robot_bleed 只在 AEC 失效时兜底）
- 双讲样例 A/B/C 逐一实测（`docs/handoff/2026-10-06-afe配置与双讲样例.md`）
- 通过标准：播报期间不自我触发；双讲不幻觉候选

### 第 6 步 · 摄像头抓拍（C，0.5 天）
- JPEG 抓拍 → capture 上传 → 线上端可见 + AI 描述
- 物理遮罩拨片遮挡实测（隐私演示点）
- 通过标准：测试用例表 #18 通过

### 第 7 步 · 舵机转头与整机联装（F+C，1 天）
- 本版先验证单轴左右各45°转头；实际角度、速度、噪声、限位及负载按机构/固件实测冻结，不沿用旧±120°指标
- 整机入壳，外观与概念图一致；全链路在壳内联跑 30 分钟无过热/无断连
- 通过标准：整机按演示脚本完整走一遍不出错

## 演示日前最后一天（冻结日后）

整机按演示脚本连排 3 次，每次完整走「建会→线上观点→候选→本人确认→播报→观点地图」，任何一步出错当天必须定位。演示当天不再改代码。
