eleanor-wsyy/EffMeet2/hardware/print-jobs/today-20261019/MORNING-PLAN.md

# 今早打印包 · 2026-10-19

> 这是**副本打包**，方便整包拷 U 盘；源头仍在仓库 `plates-merged/` / `reprint-20261018/`。
> 09:26 整理。按“10-18 已成功的那版就别重打”来排。

## 〇、P18T 急件（09:52 追加）

- 件：**P18T USB-C 输入板容差托架**（对象名 `P18_TOLERANT_CRADLE`，**224 面**，32×24×14.4）；**不是 P18 电源托盘（516 面）**，别拿错。
- 模型：水密、0 空层、首层 750.7 mm²；>45° 悬垂仅 **50.6 mm²**；纯装配损坏，**不用改模型**。
- 盘：`plates/TMP-P18T_BLACK_020.3mf`（黑 0.20，1 件，72 层，**30–40min**）；单件 STL：`single-parts/P18T_CRADLE.stl`。
- 设置：0.20、黑（没黑用灰/INTERN2 盘删其他 4 件）、4 墙、Gyroid 15%、**5% 树/仅打印板**（预览有悬空就留，没有就关）、**不加 brim**。
- 先打这个，再上 P15/P17/P26/P29 主盘。

## 一、盘（plates/）

| 优先级 | 盘 | 料/层高 | 件 | 时间 | 什么时候打 |
|---|---|---|---|---|---|
| **1** | `TMP-FIX-P15P17P26P29_BLACK_016.3mf` | 黑 0.16 | P15/P17/P26/P29 | **2–3h** | **必打**：P26 已转 90°（镜管朝床）；P15/P17 局部树支撑 5%；P29 brim5/支撑关；P26 支撑关 |
| **2** | `TMP-FIX-P28_BLACK_012.3mf` | 黑 0.12/0.16 | P28 | **10min** | P28 还缺/丢了就打；**10mm brim、支撑关** |
| 3 | `TMP-FIX-P02P20_GREY_016.3mf` | 灰 0.16 | P02/P20 | **3–4h** | **只在 P02 修件座圈不平/没打成功时**；P02 是 P14 法兰承力座 |
| 4 | `TMP-FIX-P03P05P06_GREY_016.3mf` | 灰 0.16 | P03/P05/P06 | **2–3h** | **只在 10-18 那版不是“很成功”的那版时**；P03 已翻转、P05/P06 不翻、P06 加 Ø34×1.0 阻挡器 |

**P24 不在这四盘里**：旧 P24 摄像孔 4.2，**先钻到 6.8**；钻坏了再用 `single-parts/P24_FACE_PANEL_CAM68.stl` 补打（v6r2 77×45 + 6.8）。

## 二、机台分配（09:30 起）

| 机器 | 料 | 打什么 | 预计 |
|---|---|---|---|
| A1（家里） | 黑（先烘干 45–55℃ 4–6h） | P28（10min）→ P15/P17/P26/P29（2–3h） | 约 12:00 下机 |
| 学校/办公室 H2S/H2D | 灰 | P02+P20（3–4h）；第二台并行 P03+P05+P06（2–3h） | 约 12:30–13:00 |

- 只有一台机：先 **P15/P17/P26/P29**（最急的 fit-fix），再 **P02+P20**；P03/P05/P06 若 10-18 已成功就跳过。
- 黑料没烘干：**P15/P17/P29 改灰，P26 单独黑**（P26 黑防漏光）；别整盘湿黑。

## 三、单件（single-parts/）——盘失败时再拆

| 件 | 文件 | 注意 |
|---|---|---|
| P26 | `P26_CAMERA_CRADLE_ASIS_ROTATE90X.stl` | 文件是**原方向**；单件打时在 Bambu 里**绕 X 转 90°**（镜管朝床），不要直接平放 |
| P03 | `P03_DRIVEN_64T_FLIPPED.stl` | **已翻转**；不要再翻；支撑只落在顶部减重孔 |
| P05/P06 | `P05_BEARING_TOWER.stl` / `P06_UPPER_SEAT.stl` | **保持原方向**；5% 树；P06 底部 38.5 孔加 Ø34×1.0 阻挡器 |
| P28 | `P28_PRIVACY_BLADE.stl` | 10mm brim、支撑关；首层 5.76 mm² |
| P02 | `P02_BASE_LID_DECIMATED.stl` | 树支撑、顶距 0.2、密度 15–20%；44mm 中心孔 |
| P20 | `P20_TACTILE_HOLDER.stl` | 开关口袋 1.8 深，必须热熔胶 |
| P24 | `P24_FACE_PANEL_CAM68.stl` | **仅备用**；旧的先钻 6.8；要打按 ASSEMBLY §3.2 面朝下、0.16、黑、无支撑 |

## 四、切片关键（详见 cards/）

- **P15/P17/P26/P29**：`cards/PLATE-CARD-P15P17P26P29.md` —— P26 已转 90°；P15/P17 局部树 5%（P15 z15–16/20–21；P17 z7–8 托盘外沿）；P29 brim5/支撑关。
- **P02+P20**：`cards/PLATE-CARD-P02P20.md` —— P02 树支撑、顶距 0.2、密度 15–20%；P20 开关胶固。
- **P03/P05/P06/P28**：`cards/PRINT-CARD-REPRINT.md` —— P03 翻、P05/P06 不翻、P06 Ø34×1.0 阻挡器、P28 10mm brim/支撑关。
- 不要用旧 `EffMeet2-v6 0.20 H2S` 预设（wall 6 / sbpo 0）；用 0.16 新预设，墙 4、检查薄壁开、Gyroid 15–20%。

## 五、下机 30 秒检查

- P15 口袋 **13.7**；P17 总高 **12.1**、两柱距 **12.6**；P26 镜管 **6.5**；P29 槽 **1.8**；P24 孔 **6.8**；P02 中心孔 **44**。
- P03 30.15 孔配 P11；P05/P06 42.3 孔配 6806；P28 试 P27 的 28×8.4 槽。
- 超差 → 停，按 `MEASUREMENTS.csv` 记 `MEASURED_UNFITTED`，不硬装。
