eleanor-wsyy/EffMeet2/hardware/print-jobs/today-20261020/MORNING-PLAN.md

# 今早打印包 · 2026-10-20

> 昨晚合并完成：v6r3（P15 让位槽+P26+P33）× 队友 FACEFLAT/P27P28/P29B 全部进 `candidate-stl`，32 件 verify PASS。
> 今天目标：**头壳大平脸 + 三个修复盘全部下机**，下午进装配。
> 卡片在 `cards/`；P15B 盘（WIREFIX）**已被合并版 P15 取代，别打**。

## 一、机台分配（长杆先开）

| 机器 | 料 | 顺序 | 估计 |
|---|---|---|---|
| **学校 H2S/H2D**（灰） | 灰 | **TMP-FIX-P23_GREY_016（FACEFLAT 头壳，~690 层，一早就开，傍晚下机）** | ~10h± |
| **A1（家，黑）** | 黑 | **TMP-FIX2-ALL_BLACK_016（七件合一盘，一次上机）** | ~4h±，中午前完 |

- P23 是全天长杆：**到校第一件事上机**；灰料按 2 卷备（BOM 已下单，先确认手边这卷余量够一件 ~300g 量级）。
- 合一盘排版（256 床，边距 8）：P24(8,8) / P15(122,8) / P26(166,8) / P33(192,8) / P29B(122,40) / P27(122,56) / P28(220,56 远角留 brim 位)。**逐件设置（Bambu 右键单件改）**：P15 局部树 5%（z15–16/20–21）＋U 槽孔底预览成实底；P26 brim5/支撑关；P28 brim 外侧 10mm/支撑关；P29B brim 5–10mm；P24/P27/P33 无 brim 无支撑。切片总预览确认：P28 brim 已生成、挡墙 0.8 完整、耳槽 0.7 通缝、P24 屏窗通透。
- 合一盘出问题时的兜底：`plates/` 里仍留了四个单盘（FIX2 / P24 / P27P28 / P29B），哪件翻车单独补哪件。
- 黑料若又有受潮迹象（炒面/拉丝）：先 45–55℃ 烘 4–6h，**P26 必须黑（防漏光）**，P15/P33/P27/P28/P29B 可改灰。

## 二、盘与设置

| 优先级 | 盘 | 料/层高 | 件 | 关键点 |
|---|---|---|---|---|
| **1** | `TMP-FIX-P23_GREY_016.3mf` | 灰 0.16 | P23 FACEFLAT 头壳 | 前圈朝下、**支撑关**、brim 外侧 5mm 可不加；预览确认 116×116 边框落床连续、底部无悬空 |
| **2** | `TMP-FIX2-ALL_BLACK_016.stl` | 黑 0.16 | **P24＋P15＋P26＋P33＋P29B＋P27＋P28（七件合一）** | 4 墙 Gyroid 15%；逐件设置见上；**P24 已是 6.8 孔新版（candidate 源），不要用 `TMP-FIX-P24_BLACK_016.3mf`（4.2 旧版）** |

兜底单盘（合一盘失败时拆用，均已在 `plates/`）：

- `FIX2_P15P26P33_BLACK_016.stl`：P15/P26/P33 三件套。
- `P24_FACE_PANEL_FACEFLAT_CAM68.stl`：P24 单件（6.8 孔）；**不要改用 `TMP-FIX-P24_BLACK_016.3mf`（4.2 旧版）**，若误打下机钻 6.8。
- `TMP-FIX-P27P28_BLACK_016.3mf`：P27/P28（brim 外侧 10mm、支撑关）。
- `TMP-FIX-P29B_BLACK_016.3mf`：P29B（brim 5–10mm、无支撑）。

统一纪律：不要用旧 `EffMeet2-v6 0.20 H2S` 预设（wall 6 / sbpo 0）；0.16、4 墙、检查薄壁开、Gyroid 15–20%。

## 三、下机 30 秒检查

- **P23**：前脸 116×116 边框平整不翘、前口 106.6×96.6 无拉丝瘤；与 P24 压配试装（单边 0.3，不用螺钉）。
- **P24**：屏窗 62×46 通透；**镜头孔 6.8**（打 4.2 版就钻）；LCD 四柱 77×45 不缺、孔通。
- **P15**：口袋 **13.7**、让位槽 **6.8** 线能自由穿；**张紧槽底 1mm 没穿**；底板 M3 盲孔**不通**。
- **P26**：镜管 **6.5**、背柱距 **13.9**、导孔 **Ø2.5**；镜头试穿 P24 孔（应轻导向）。
- **P33**：孔 **Ø3.4** 距 **13.9**、FPC 槽 **6.4×2.5**、压筋完好。
- **P27/P28**：P28 放进 P27 导槽**滑到底不脱出**（挡墙 0.8 起作用）；P28 在槽内滑动、不是盖在上面。
- **P29B**：核心板插 **1.8** 槽到底不晃、耳槽咬边 0.7 咬住板边；2×M3 对 P23 头底柱。
- 超差 → 停，按 `MEASUREMENTS.csv` 记 `MEASURED_UNFITTED`，不硬装。

## 四、装配预告（下午，详见 ASSEMBLY.md）

- 舵机：**线先穿 P15 尾端让位槽**再落座；底板螺钉 **M3×6**（不用 M3×8/10，螺尖会顶线区）。
- 摄像头：**FPC 先穿 P33 槽** → 模组入腔 → 盖 P33 → **2×M3×8 自攻**（拧到板贴背即停）。
- P28：**先放进 P27 导槽**（从导轨背面敞口放入）再由面板封背——旧"盖在上面滑"作废。
- 前脸（P24+P25+LCD+P26+P33）最后压进 P23；P24 无面板螺钉。
