eleanor-wsyy/EffMeet2/hardware/robot-design/round-yaw-v2/ASSEMBLY_GUIDE.md

# ⛔ 本指南已作废（2026-10-16）

**唯一有效安装手册：[print-split-v6/ASSEMBLY.md](revision-20261011-nomi-layoutA/print-split-v6/ASSEMBLY.md)（含零件对应表的图解版同目录）**——按完工件实写，含 32 张零件证件照、✅/⏳ 状态与缺件替代法。

本文件为 10-10  era 旧版（按 v4 计划件写），与实物已不符，**不要再照此装配**。历史内容见 git 记录。
