eleanor-wsyy/EffMeet2/hardware/robot-design/round-yaw-v2/PRINT_PLAN.md

# ⛔ 本方案已作废（2026-10-21）

**现行打印执行唯一入口：[print-split-v6/PLATE-RUNBOOK.md](revision-20261011-nomi-layoutA/print-split-v6/PLATE-RUNBOOK.md)**（盘×机器×特殊设置）＋ [SLICE-CARD.md](revision-20261011-nomi-layoutA/print-split-v6/SLICE-CARD.md)（切片卡）＋ [PRINT-LESSONS.md](revision-20261011-nomi-layoutA/print-split-v6/PRINT-LESSONS.md)（教训集）。

本文为 2026-10-11 v4 时代"最少操作打印方案"（布局 A／旧尺寸／旧材料口径），已与 v6/A2 不符，**不要再照此打件**。历史内容见 git 记录。
