eleanor-wsyy/EffMeet2/hardware/print-jobs/today-20261019/cards/PLATE-CARD-P02P20.md

# P02 + P20 补打盘 · 打印设置卡（2026-10-18）

## 文件

| 文件 | 用途 |
|---|---|
| `TMP-FIX-P02P20_GREY_016.3mf` | **推荐**：两个独立对象，Bambu 里可分别设参数 |
| `TMP-FIX-P02P20_GREY_016.stl` | 通用整盘 STL；导入后若成一个对象，右键“拆分为对象” |

- 摆位：P02 x10–155.65 / y10–142.71；P20 x200–236 / y10–24；床 256×256，间距 ≥44mm。
- 材料：PLA Matte 灰（**先烘干**）；PETG 仅作替身。
- 层高：0.16（P02 首选；P20 同盘 54 层，没问题）。
- 总层数：62 层（P02 9.9 / 0.16）；P20 54 层。

## Bambu Studio 设置（中文标签）

| 项 | 设成 | 说明 |
|---|---|---|
| 打印机/喷嘴 | A1 / H2S / H2D，**0.4** | 不要用 0.2 |
| 材料 | PLA Matte 灰 | 床 60–65℃，腔温 <40℃ |
| 层高 | **0.16** | 首层 0.2 |
| 墙层数 | **4** | 不要 6 |
| 墙生成器 | **Classic** | 检查薄壁：**开** |
| 稀疏填充 | **Gyroid 15%** | — |
| 支撑 | **开 + 树状(auto)** | **仅在打印板生成** |
| 支撑阈值 | 30° | P02 内部天花板是水平悬垂 |
| 支撑顶面 Z 距离 | **0.2** | 太大顶板会脱开 |
| 支撑密度 | **15–20%** | 界面 2 层 |
| 过支撑降速 | 50% | 顶板第一层粘牢 |
| Brim | **外侧 5mm** | 两件都要 |
| Z-hop | **0.4** | P20 立柱防喷嘴碰 |
| 避免跨越外墙 | **开** | — |
| 最小层时间 | **8s** | P20 立柱不软化 |
| 风扇 | **100%**（首层后） | — |
| 小周长降速 | 30mm/s | P20 立柱 |
| 接缝 | 对齐 | 不要随机 |
| 悬垂速度 | 20–30mm/s | 支撑界面 40mm/s |

> **不要用旧的 `EffMeet2-v6 0.20 H2S` 预设**：它还是 `wall_loops=6` + `support_on_build_plate_only=0`。新建/重存一个 0.16 预设，按上表。

## 预览必看

1. **P02 支撑**：要长进内腔，但**不许堵 Ø44 中心孔、不许堵 4 个 P01 螺钉孔**；堵了用“支撑阻挡器”刷掉。
2. **P20**：两个立柱周围**不要有支撑**；有就刷掉。
3. **Brim**：两件的 brim 不要连在一起（间距 44mm，正常不会）。
4. **第一层**：P02 是一圈接缝环，P20 是底座；两者都要有。
5. **层数**：总 62 层；如果 App 报的不是 62，说明工程被改过。

## 时间

- A1：约 3–4h。
- H2S/H2D：约 2.5–3h。
- 16:30 起打，约 20:00 下机。

## 失败预案

- **P02 接缝再裂**：支撑顶距改 0.16–0.18、界面 3 层、过支撑再降速；模型在接缝内角加 0.5mm 倒角。
- **P20 立柱再断**：Z-hop 0.6、最小层时间 12s、风扇 100%；在立柱根部加一个 10mm×2mm、100% 填充的修改器；模型加 1.5mm 圆角/撑筋。
- **翘边**：brim 8mm、床温 65℃、避开空调直吹。

## 不要打

- 不要再打整张 `TMP-INTERN2-DEC`：P04/P18T/P32 都是好的，只缺 P20。
- 不要用 `TMP-BVIS-TILT`：P14 斜打首层是刀口，失败率高。
