eleanor-wsyy/EffMeet2/hardware/print-jobs/today-20261019/cards/PRINT-CARD-REPRINT.md

# 重打文件 · P03 / P05 / P06 / P28（2026-10-18）

## 文件

| 文件 | 内容 | 料/层高 |
|---|---|---|
| `TMP-FIX-P03P05P06_GREY_016.3mf` | **P03（已翻转）+ P05 + P06**，3 个独立对象 | 灰 0.16 |
| `TMP-FIX-P03P05P06_GREY_016.stl` | 同一盘整盘 STL（3 parts） | 灰 0.16 |
| `TMP-FIX-P28_BLACK_012.3mf` | P28 单件 | 黑 0.12（或 0.16） |
| `TMP-FIX-P28_BLACK_012.stl` | P28 单件 STL | 黑 0.12 |
| `P03_DRIVEN_64T_FLIPPED.stl` | P03 单件，已翻转 | — |
| `P05_BEARING_TOWER.stl` | P05 单件，原方向 | — |
| `P06_UPPER_SEAT.stl` | P06 单件，原方向 | — |
| `P28_PRIVACY_BLADE.stl` | P28 单件 | — |

摆位（256×256）：P05 x10–74 / y10–80；P06 x10–68 / y90–154；P03 x90–133.2 / y10–53.2；P28 单独盘 x10–20 / y10–18。件与件间距 ≥16mm。

## 重要更正：谁翻、谁不翻

| 件 | 方向 | 原因 |
|---|---|---|
| **P03** | **已翻转**（顶部小圈贴床，安装孔朝上） | 支撑只落在**顶部减重孔**（2.45mm 深），安装孔干净；打后用 30mm 圆棒掏支撑 |
| **P05** | **不翻**，保持原方向（座圈朝上） | 翻了支撑会顶在轴承座面上；支撑留在**座圈下方**，5% 树状，从四条腿之间往外掏 |
| **P06** | **不翻**，保持原方向（轴承座凹口朝上） | 翻了支撑会顶在轴承座面上；支撑在底部 **38.5mm 孔**里，用阻挡器挡掉，肩环只跨 1.9mm，不用支撑 |
| **P28** | 不翻，平放 | 10mm brim，不要支撑 |

> **不要再把 P05/P06 翻过来。** 3MF/STL 里已经是正确方向；直接打开、切片、打。

## Bambu Studio 设置（P03/P05/P06 盘）

| 项 | 设成 |
|---|---|
| 打印机/喷嘴 | A1 / H2S / H2D，**0.4** |
| 材料 | PLA Matte 灰（先烘干）；床 60–65℃，腔温 <40℃ |
| 层高 | **0.16**，首层 0.2 |
| 墙层数 | **4** |
| 墙生成器 | Classic；**检查薄壁：开** |
| 稀疏填充 | **Gyroid 15%** |
| 支撑 | **开 + 树状(auto) + 仅在打印板生成** |
| 支撑密度 | **5%**（不要 15%） |
| 分支直径 | **2mm** |
| 顶面 Z 距离 | **0.2** |
| 支撑界面 | **1 层** |
| 支撑/物体 XY 距离 | **0.5mm** |
| Brim | **外侧 10mm**（P05 四脚、P06 耳、P03 顶圈） |
| Z-hop | **0.4** |
| 避免跨越外墙 | 开 |
| 最小层时间 | **8s**；风扇 100%（首层后） |
| 小周长降速 | 30mm/s |
| 接缝 | 对齐 |

## P06 阻挡器（关键，3 步）

1. 选中 P06 对象 → 右键 **添加修改器 → 圆柱**。
2. 直径 **Ø34**、高 **1.0mm**，放在 P06 底部 **Ø38.5 孔**的中心（贴床面）。
3. 右键这个圆柱 → **更改类型 → 支撑阻挡器**。

这样支撑不会长进 38.5mm 孔；肩环（38.5–42.3，1.9mm 宽）直接桥接。**不要**把阻挡器做成实体打印。

## P28 盘设置

| 项 | 设成 |
|---|---|
| 材料 | 黑 PLA（没有就用灰/PETG；P28 不承力） |
| 层高 | 0.12（或 0.16） |
| 墙层数 | 4；检查薄壁开 |
| Brim | **外侧 10mm**（首层只有 5.76 mm²，必须） |
| 支撑 | **关**（不要支撑，会粘在薄片上） |
| Z-hop | 0.4；风扇 100% |
| 首层速度 | 20mm/s |
| 小周长降速 | 30mm/s |

## 切片后预览必看

1. **P05**：支撑只在座圈**下方**，不在轴承座孔里；如果孔里有，把座圈内壁/座面刷“禁止支撑”。
2. **P06**：Ø38.5 孔里**没有**支撑；轴承座面（Ø42.3 凹口）干净。
3. **P03**：支撑只在**顶部减重孔**（翻转后朝下那个 2.45mm 深孔）里；安装孔（30.15）里没有支撑。
4. **P28**：没有支撑，10mm brim 完整包住底座。
5. 层数：P05 227 层（36.2 / 0.16）；P06 54 层；P03 67 层。

## 时间

- P03/P05/P06 盘：约 **2–3h**（A1）；学校 H2S/H2D 约 2–2.5h。
- P28：约 **5–10min**。

## 打后检查

- **P05/P06**：用 6806 轴承 + COUPON 梯条试座孔；松=生料带/垫片，紧=砂纸/打磨鼓。
- **P03**：用 P11 轴试 30.15 安装孔；**紧定孔有 2 条非流形边（Bambu 判 manifold=yes）**，打后用 1.5–2mm 钻头通一下，别堵。
- **P28**：试 P27 的 28×8.4 槽；能滑即可，端部毛刺修平。

## 不要

- 不要用旧的 `EffMeet2-v6 0.20 H2S` 预设（`wall_loops=6` / `support_on_build_plate_only=0`）。
- 不要再翻 P05/P06。
- 不要把 P06 阻挡器当实体打印。
- P26 不用重打：背后方孔是 `CAMERA_FPC_EXIT`（6×10×8），给 14mm 摄像头 FPC 出线用的。
