eleanor-wsyy/EffMeet2/hardware/print-jobs/today-20261020/cards/PLATE-CARD-P23P24.md

# PLATE-CARD · TMP-FIX-P23_GREY_016 + TMP-FIX-P24_BLACK_016（大平脸圆角屏区）

> 2026-10-19 · 用户选定 B 方案：P24 换概念图那种「大平脸」圆角矩形屏区，P23 前口跟着改轮廓；头还是圆的，正脸变平变黑、屏变大。**只改 P23/P24 两件，内部布局不动。**
> 两件颜色不同（P23 灰壳 / P24 黑脸），分两盘并行打——颜色即质量，且并行总墙钟比合一盘短。

## 改了什么（build_v6.py 重跑）

| 件 | 原来 | 现在 |
|---|---|---|
| P24 面板 | Ø106 圆盘，屏窗 58.2×43.8 | **106×96 圆角 R21** 平面板、厚 2.4；屏窗 **62×46**；镜头孔 Ø4.2；LCD 四柱 77×45、玻璃槽 71×51 不变 |
| P23 前口 | Ø106.6 圆口＋后挡圈 | 106.6×96.6 圆角 R21.3 方口；新 **116×116 R40 大平脸边框**（厚 7.4，前面与面板齐平成一整块平面），后部 face_open 100×90 给 LCD/摄像头/压框让空 |

边框为托住面板四角不裁到球面：圆角方脸贴在圆头正面，从正面看是一整块平脸，侧面看头仍是圆的。

## 不动（P25 / P26 / P27 / P28 继续用，不用重打）

- **LCD 四柱 77×45**（2026-10-15 实测）、玻璃槽 71×51：面板上这些特征没动 → P25 后压框照旧 4×M2.5。
- **摄像头孔绝对高度不变**：窗上沿 +15.9 = 原「窗上沿 +17」的同一个 z（窗高 43.8→46 只是窗变大，孔没挪）→ P26 托架、P27/P28 滑盖位置照旧。
- **压配公差不变**：面板 106.0×96.0 / 前口 106.6×96.6，单边 0.3 压配，**无面板螺钉**。
- P27/P28 挂孔 x=−10/26 不动。

## 打印（两盘，可同时开打）

| 项 | P23 | P24 |
|---|---|---|
| 文件 | `TMP-FIX-P23_GREY_016.3mf` / `.stl`（已摆好位） | `TMP-FIX-P24_BLACK_016.3mf` / `.stl`（已摆好位） |
| 朝向 | 90° about X，**前圈朝下**（打印包围盒 132×120.5×110.4） | 90° about X，**面朝平台、后柱向上**（打印包围盒 106×96×5.3） |
| 材料 | PLA 灰（壳色） | PLA 黑（屏幕区要黑，哑光/亮面均可） |
| 层高 | **0.16** | **0.16** |
| 墙/填充 | 4 墙、Gyroid 15%（壳件） | 4 墙、Gyroid 15%（薄件，打实心也行） |
| Brim | 外侧 5mm（前圈大平面粘床够，可不加） | 外侧 5mm（可不加） |
| 支撑 | **关**（前圈朝下，无需支撑） | **关**（后柱朝上，无需支撑） |
| 切片预览 | ①大平脸边框 116×116 落床连续 ②底部无悬空/无支撑点 | ①屏窗 62×46 通透 ②LCD 四柱 77×45 朝上、孔通 ③镜头孔 Ø4.2 通 |

## 打后检验

1. **P24 平面度**：面板前脸平、黑、无翘边；屏窗 62×46 边缘干净无瘤；四柱不缺。
2. **压配**：P24 压进 P23 前口到底（面板后面贴住内台阶），四周缝隙均匀；装上不掉、不转。无螺钉是设计如此，松了可点胶。
3. **正脸（重点）**：装上后正脸是**一整块平的黑色圆角矩形屏区**（不是圆脸），屏幕窗比旧版大；头整体轮廓仍是圆的，边框四角与圆头平滑相接。
4. **不重打件照旧装**：P25 后压框 4×M2.5 压 LCD（柱距 77×45）；P26 双面胶贴 P24 背面对 Ø4.2 镜头孔；P27/P28 挂 x=−10/26。全部应与新 P24 对得上——对不上按 MEASUREMENTS 报回来。
5. **摄像头**：孔中心高度与旧件一致；装 P26 后镜头正对孔、不歪。

## 不要

- 不要锉边框外缘/四角（116×116 R40 是能在圆头正面上做出的最大方脸轮廓）。
- 不要给 P24 加支撑（柱子朝上，支撑只会粘在平脸上留疤）。
- 压不进或太松：只许在**前口壁**上轻砂，不许锉面板边；仍不行记 MEASURED_UNFITTED 报回来。

---

## ⚠️ 2026-10-20 合并更正：镜头孔 4.2 → 6.8

- 本卡写成时 `build_v6.py` 的镜头孔是 **4.2**（`2d21bdc` 在 P15 修复提交里夹带把 10-19 定案的 6.8 改回了 4.2，无设计说明）；本批 P24 盘即按 4.2 开出。
- 合并后已改回 **6.8**（`P['camera_lens_d']+.3`）：v6r3 P26 前壁 3.5、镜头凸 4，镜筒尖要伸进孔 0.5~0.7 导向，4.2 进不去；且 v6r3 起 P26 不再是「双面胶贴背面对孔」——改为**镜头入孔导向＋P33 背板 2×M3×8 夹持**（见 `reprint-20261019-v6r3/PRINT-CARD-V6R3.md` 与 ASSEMBLY §3.3）。
- **本批已打 P24（4.2 孔）按老规矩钻到 6.8**；重切盘用 `candidate-stl/P24`（FACEFLAT＋6.8）。
- 本卡其余内容（P23 前口/边框、屏窗 62×46、LCD 四柱、压配、打印设置）不受影响。
