eleanor-wsyy/EffMeet2/hardware/print-jobs/today-20261020/cards/PLATE-CARD-P27P28.md

# PLATE-CARD · TMP-FIX-P27P28_BLACK_016（隐私滑片限位返修）

> 2026-10-19 · 返修轮：P27 导轨＋P28 滑片「卡不牢、会掉」。
> 两件同料同色同层高，合一盘（用户原则：能合并一盘尽量合并）。

## 根因与修复（build_v6.py）

**根因：导轨前挡墙只有 0.2mm，根本打不出来。** 原导轨 1.6 厚、滑槽切深 2.0——槽把导轨切穿到只剩 0.2mm 膜（0.2 层高=1 层纸），实际打印中要么没打出来、要么一碰就破，滑片没有任何前向限位，直接脱出掉落。

| 问题 | 根因 | 修复 |
|---|---|---|
| 滑片会掉 | 前挡墙 0.2mm 不可打印，滑片前方无遮挡 | 导轨加厚 1.6→**2.0**，前挡墙 **0.8mm**（2 圈墙，实打）；滑片装进槽后被挡墙（前）+面板（后）夹住，掉不出来 |
| 卡不牢 | 滑片 0.8 厚在 1.4 深的敞口里，Y 向窜 0.6 | 滑槽改 **1.2 深**（切深 1.5），滑片 0.2/边滑配，配合手感与 Z 向（8.0 进 8.4 槽）一致 |
| 拨片够不着 | 挡墙加厚后拨片被埋进墙里 | 拨片 1.6→**2.2 厚**，穿出挡墙面 **1.0mm**，行程仍由拨槽（14×3.2）限制：关 0 / 开 11+ |

不动：拨槽尺寸（14×3.2）、M2 挂孔（x=−10/26）、滑片 10×8 与 Z 向 8.4 槽、打开位置定义。

## 打印（黑 0.16，一盘两件）

| 项 | 值 |
|---|---|
| 文件 | `TMP-FIX-P27P28_BLACK_016.3mf` / `.stl`（已摆好位） |
| 朝向 | **P27 平放导槽朝上**（42×12×2.0，无支撑）；**P28 拨片朝下**（10×8×2.8，首层 5.76mm²） |
| 材料/层高 | PLA Matte 黑，**0.16**（P28 旧配方 0.12 也行；合一盘统一 0.16，P28 教程明示 0.12 或 0.16 均可） |
| 墙/填充 | **4 墙**、Gyroid 20%（P27/P28 都是全墙件，截面小基本实心，正常） |
| Brim | **外侧 10mm**（P28 首层 5.76mm² 是硬门槛；P27 跟着带 brim 无害，铲掉即可） |
| 支撑 | **关**（P28 脸面靠拨片柱桥接约 3mm，支撑会粘在薄片上拔不下来） |
| 其他 | Z-hop 0.4、风扇 100%、首层 20mm/s、小周长 30mm/s |
| 切片预览 | ①P28 第一层只有拨片 2.4×2.4 且 brim 已生成 ②P27 导槽 1.2 开口朝上、挡墙 0.8 是完整墙 ③拨槽窗 14×3.2 通透 |

## 打后检验

1. **P27 挡墙**：0.8mm 挡墙完整连续，不是膜/纸片；拨槽窗口 14×3.2 干净无瘤。
2. **滑配**：P28 滑片放进导槽能滑动（关 0 ↔ 开 11），拨片在拨槽里全程走通不脱轨。
3. **限位（重点）**：滑片在槽内**前后都拉不出来**——前有挡墙、后面装到面板上被面板封住；用力甩不掉。拨片推到头（开位）被拨槽端面挡住，不会滑出导轨。
4. **遮挡**：关位滑片完整盖住摄像头孔（Ø4.2），开位孔完全露出。
5. **挂孔**：2×M2 挂孔对上 FACE_PRIV_BOSS（x=−10/26）。

## 装配顺序（重要）

滑片要**先放进导槽再上螺钉**：滑片+拨片从导轨背面（敞口面）放进去、拨片穿过拨槽窗，再把导轨贴到前贴面板上螺钉——面板把导轨背面封住，滑片从此掉不出来。装上后不需要再拆。

## 不要

- 不要把挡墙锉薄/锉掉（锉掉=回到会掉）。
- 不要给 P28 加支撑（粘薄片）。
- 滑动涩：只许**砂纸轻推**滑片侧面，不许锉导槽；仍涩按 MEASUREMENTS 记 MEASURED_UNFITTED 报回来。
