eleanor-wsyy/EffMeet2/hardware/robot-design/round-yaw-v2/revision-20261011-nomi-layoutA/print-split-v6/PRINT-PLAN.md

# 在议 v6 · 合并同类项打印计划（print-ready · B 方案锁定）

> 生成时间：2026-10-15 ｜ 依据：v6 `MEASUREMENTS.csv` + 购物车采购尺寸表 + `PLATE-RUNBOOK.md` + `BOM §12.0`
> **B 方案（用户 2026-10-15 选定）**：黑料仅 1 卷 → 只有外露件 B1p 用黑；机构/支架件按 RUNBOOK"可灰"改打**灰料**，用上闲置的第 2 卷灰料。结果 **3 盘 / 3 台机器 / 1 轮全并行**。
> ⚠️ 仍是 `CANDIDATE_NOT_RELEASED`：3MF 只含几何＋床面排布，**不含机型/材料/支撑配置**，须在 Bambu Studio 里选学校机型（H2S/H2D/P2S）+ 对应耗材后按下表切片。

---

## 一、本次打印的 3 盘（20 件，1 轮全并行）

| 盘文件 | 颜色/料卷 | 层高 | 机器 | Brim | 支撑 | 件数 | 占用(X×Y) |
|---|---|---|---|---|---|---|---|
| **TMP-G3p_GREY_016.3mf** | 灰 · 灰料卷1 | 0.16 | 学校 1 台 | 5mm | 树状 | 1 | 154×141 |
| **TMP-B23p_GREY_020.3mf** | 灰 · 灰料卷2 | 0.20 | 学校 1 台 | 一般不用 | 按需树状 | 16 | 242×144 |
| **TMP-B1p_BLACK_016.3mf** | 黑 · 黑料卷 | 0.16 | 学校 1 台 | 小件加 | 树状 | 3 | 138×66 |

床面 256×256，margin 8，gap 10；三盘均不超界。学校喷嘴 0.4 硬化钢，PLA Matte 无需腔温，H2S/H2D/P2S 均可。
**三盘颜色/层高互不冲突，3 台机器同时开打，1 轮出全部 20 件。** 黑料只占 1 台（B1p），不再串行卡瓶颈。

### 各盘件清单

**TMP-G3p（灰 0.16 · 灰料卷1）**
- P02 底座上盖＋限位块 —— 接缝圈朝下＝装配面，中心颈孔悬空需树支撑

**TMP-B23p（灰 0.20 · 灰料卷2 · 机构10件+支架6件，原 B2p+B3p 合并改灰）**
- 机构：P05 承力塔+下轴承座、P06 上轴承座、P07–P10 层间支柱×4、P11 空心轴（**竖直打，层向抗扭**）、P12 下止推夹环、P13 限位摆臂、P15 舵机可调耳架
- 支架：P16 扬声器托架、P17 功放慢托盘、P26 摄像头托架、P29 核心板托架、P30 底座线鞍、P31 头侧线鞍
- ⚠️ P05/P06/P11/P12 是轴承配合件，务必等 S1 样片过再打；P29 按已实测元件高 6/排针 8；P30/P31 线鞍束带绕槽、**禁扎紧排线**
- 这些件装在壳内不可见，RUNBOOK 明确"可灰"，故改灰料以释放黑料瓶颈

**TMP-B1p（黑 0.16 · 黑料卷 · 唯一必须黑的盘）**
- P14 短颈＋法兰（D 孔套轴）
- P27 隐私滑盖导轨
- P28 隐私滑片 —— ⚠️ P27/P28 不得融合，盯首层
- 外露件，必须黑料，不动

---

## 二、全局切片设置（所有盘通用，PLATE-RUNBOOK §2）

| 项 | Bambu Studio 默认 | 改成 | 理由 |
|---|---|---|---|
| 打印机 | — | **选学校机型 H2S / H2D / P2S** | 3MF 不含机型预设，须手动选 |
| 耗材 | — | **G3p/B23p 选灰 PLA Matte；B1p 选黑 PLA Matte** | B 方案颜色分配 |
| 墙层数 | 2 | **4** | 0.42线宽×6圈=2.52mm塞不进2.4壁/2mm柱/1.6唇→切片整层丢弃=空层警告真因；4圈=1.68mm+填充足够实心不透光 |
| 稀疏填充 | Grid 15% | **Gyroid 15%** | Grid 交叉点重复挤出，大件刮擦 |
| 支撑 | 关 | **开＋树状**，外墙 2，顶面 Z 0.25–0.3 | 树状好拆、痕浅 |
| Brim | 自动 | 仅外侧 / 5mm（大件） | 防翘边 |
| 热床 | 官方 | 60–65℃ | 防翘 |
| 首层层高 | 0.2 | 不动 | 厚首层粘得牢 |
| 接缝 | 随机 | **对齐** | 别满壳麻点 |
| 腔温（H2D） | 自动 | **盯 <40℃** | PLA 热变形约 55℃，广州室温高要盯 |
| 喷嘴温度/速度/风扇 | 官方 PLA Matte | 不动 | |

材料：PLA Matte 灰（已到货×2，正好 G3p+B23p 各一卷）/ 黑（已下单×1，B1p 用）；受潮按官方 45–70℃ 干燥，**不要 80℃**。

---

## 三、打印顺序（严格先后 + B 方案 1 轮并行）

1. **S1 样片（PETG @A1 或学校）** —— 先打，验配合：
   - 6806 座孔 Ø42.3 / 空心轴 Ø29.8 / MG90S 耳 Ø1.8 / 面板四柱（按 80×45 假定打样，到货实测再核）
   - 结果回填 `MEASUREMENTS.csv`，未实测不填 PASS
2. **S2 正式料样片（PLA Matte）** —— 同接口复测收缩/孔径/表面（**PETG 结论不跨材料套用**）
3. **样片过 → 3 盘 1 轮全并行上学校机器**：

| 机器 / 料卷 | 盘 | 件数 | 备注 |
|---|---|---|---|
| 灰料卷1 · 机器A | TMP-G3p（灰 0.16） | 1 | P02 上盖，大件薄壁，盯翘边 |
| 灰料卷2 · 机器B | TMP-B23p（灰 0.20） | 16 | 机构+支架，P11 空心轴竖直；轴承配合件等 S1 过 |
| 黑料卷 · 机器C | TMP-B1p（黑 0.16） | 3 | 外露件必须黑，盯首层 |

> 三台同时开，1 轮出 20 件。黑料只 1 盘，不再串行。
> 若只想先出低风险结构件：B23p 里 P07–P10 支柱、P13 限位摆臂、P30/P31 线鞍属纯几何件，可不等样片先打；但 P05/P06/P11/P12（轴承配合）务必等 S1 过。
> 灰大件 P23 头壳 / P01 杯体仍阻塞，等数据补齐后单独走灰料卷。

---

## 四、仍阻塞的 11 件（不在本次 3 盘内）

| 件 | 原盘 | 阻塞原因 | 解锁动作 |
|---|---|---|---|
| P23 头壳 | G1 | LCD 四孔按 80×45 假定 | **拿卡尺量 LCD 4 孔孔径+孔距**（屏已到货）→ 回填 → 重建 |
| P24 面板 | B1 | LCD 四柱假定 | 同上 |
| P25 LCD 后压框 | B3 | 四孔假定 | 同上 |
| P01 底座杯体 | G2 | USB-C 输入板未选 + INMP441 拾音孔坐标 | 选 USB-C 板下单；INMP441 到货卡尺 |
| P18 电源板托架 | B3 | USB-C 输入板未选 | 同上 |
| P19 键帽 | B1 | 6×6 轻触开关未定 | 翻库存或下单 |
| P20 开关托座 | B3 | 同上 | 同上 |
| P03 64T 带轮 | B2 | GT2 188 带齿槽未认证 | 下单 GT2 188mm 闭环 6mm 带 + 验齿形 |
| P04 32T 带轮 | B2 | 同上 | 同上 |
| P21 麦压圈左 | B3 | INMP441 底部拾音孔坐标未测 | 到货卡尺 |
| P22 麦压圈右 | B3 | 同上 | 同上 |

**性价比最高的一步**：LCD 已到货，拿卡尺量 4 个孔（孔径 + 孔距）→ 回填 `MEASUREMENTS.csv` LCD 行 → 重建 P23/P24/P25 → 一次解锁 3 件（含 G1 头壳大盘）。

---

## 五、待下单件 · 典型可买案例（2026-10-15 查证）

> 以下为搜索到的典型货源方向与规格口径，**具体链接见对话搜索记录**；下单前按"须确认"逐项核对，到货回填 `MEASUREMENTS.csv`。

### 1. GT2 188mm 闭环 6mm 带（解锁 P03/P04）

- **典型货源**：3D 打印机配件店的「2GT/GT2 环形闭口同步带」，多为**周长 110–1524mm 可定制**款（如 3DSWAY 2GT 橡胶环形带 6mm 宽；淘宝有"周长110-1524mm"任选款）。188mm 属非标长度，需选**支持按周长定制/任选**的店。
- **须确认**：① 节线长 **188mm**（不是外周长）；② 宽度 **6mm**；③ 齿形 **2GT/GT2（节距 2mm）**，与打印的 32T/64T 轮匹配；④ 闭环（环形无缝）；⑤ 材质橡胶+玻璃纤维芯（抗拉伸）。
- **典型价**：¥3–10/条。
- **搜索关键词**：`2GT 环形同步带 6mm 周长188` / `GT2 闭口带 6mm宽 定制周长`
- ⚠️ 齿形未认证是 v6 明确风险（v5 的 228mm 已作废）；带到手后**先与打印的 32T/64T 轮试配**再冻结 P03/P04。

### 2. USB-C 5V 输入小板（解锁 P01 后部开口 / P18）

- **v6 需求**：后部 USB-C 输入 **5V ≥2A** 给整机供电，预算 **20×15×6mm**，**不含充电管理**（TP4056/电池已推迟到路线 B）。
- **典型货源**：「USB-C 母座 5V 引出/供电小板（裸板）」——纯母座+焊盘/排针直通 5V，无升压无充电。淘宝/1688 的"USB-C 母座 充电小板 5V"类即可。
- **不要买错**：① **锂电充电板（TP4056 类，含 CC/CV 充电逻辑）**——v6 不需要充电，且会占体积；② **PD 触发/可调压板（5V/9V/12V…）**——过度设计；③ 带升压（5V→9V/12V）的板——不需要。
- **须确认**：① 输出/直通 **5V**、额定电流 **≥2A**；② 板尺寸 **≤20×15mm**、厚度含母座 **≤6mm**；③ USB-C 母座凸出量（决定 P01 后部 11.5×7 开口与 P18 托架深度）；④ 焊盘/排针间距。
- **典型价**：¥1–5/块。
- **搜索关键词**：`USB-C 母座 5V 供电小板 裸板` / `Type-C 母座 5V 引出板 2A`
- 选定后把**实测板尺寸+母座凸出量**回填 `MEASUREMENTS.csv` 的 `USB_C_POWER_BOARD` 行，再重建 P01/P18。

### 3. 6×6 轻触开关（解锁 P19/P20）

- **典型货源**：「6×6×5mm 四脚 直插 轻触开关（立式）」——淘宝有"直脚 6*6*5MM 立式四脚轻触开关 铜脚"、"6*6*5MM 按键按钮微动轻触开关 小铜脚四脚 直插"等典型款，通常按包（50–100 个）卖。
- **须确认**：① 本体 **6×6mm**；② 高度 **5mm**（v6 预算 6×6×5；若买到 4.3/7/9/11mm 等其他高度，**须回填 `MEASUREMENTS.csv` 的 TACTILE_KEY 行再定 P19 键帽柱高与 P20 托座深**）；③ 四脚直插（非贴片）；④ 按压力度/行程（停止键手感）；⑤ 引脚间距（决定 P20 托座孔位）。
- **典型价**：¥0.05–0.2/个（按包 ¥3–10）。
- **搜索关键词**：`6x6x5 轻触开关 四脚 直插` / `6*6*5 立式 轻触按键 铜脚`
- 用途：前肩停止键（复用 GOOUU 板载 BOOT/G0 或另接，见 BOM E11）。

### 已在购物车、无需另找（到货即测）
- **INMP441×2**（购物车序号 19，Ø14 圆 PCB、焊孔中心距 7.62）→ 到货卡尺**底部中心拾音孔坐标**，解锁 P21/P22/P01 壁袋。

---

## 六、待补数据清单（补完即可解锁剩余 11 件）

### 🔴 硬缺口（5 项）
1. **LCD 四孔孔径 + 孔距** —— 屏已到货，卡尺即量（解锁 P23/P24/P25）
2. **GT2 188mm 闭环 6mm 带 + 齿形认证** —— 见 §五.1（解锁 P03/P04）
3. **USB-C 5V 输入小板选型** —— 见 §五.2（解锁 P01 后部开口/P18）
4. **6×6 轻触开关** —— 见 §五.3（解锁 P19/P20）
5. **INMP441 底部拾音孔坐标** —— 已在购物车，到货卡尺（解锁 P21/P22/P01 壁袋）

### 🟡 到货即测（不阻塞切片，只影响公差/沉孔深度）
- M2.5/M3 短螺钉头部尺寸、M3/M2.5 平垫圈内径、M2.5 螺母外形、M3×70 是否含螺母
- INMP441 PCB 厚度+含排针总高、MAX98357A 安装孔直径+PCB 厚度+含排针总高
- 扬声器焊片是否超 17mm、MG90S 安装孔直径公差、6806 ZZ/2Z 到货核对
- PET 编织护套 Ø3 是否适配 11 根线、硅胶片/EPDM 是否带背胶、安装柱高度

---

## 七、状态纪律（不得违反）
- `manifest.json`：`stage=reversible_blockout`，三个放行布尔保持 **false**
- 26 项测试全部 **NOT_RUN**，不得标 PASS
- 切片确认后把最终朝向/支撑/机时回填 `PARTS.csv` 的 `slicer_status`；没证据的字段保持空
- 禁止裁剪 FPC；禁止生成伪装成放行件的 STL

---

## 八、文件清单（B 方案）
- `TMP-G3p_GREY_016.3mf` —— 灰 0.16 · 灰料卷1 · P02（1件）
- `TMP-B23p_GREY_020.3mf` —— 灰 0.20 · 灰料卷2 · 机构10件+支架6件（16件，原 B2p+B3p 合并改灰）
- `TMP-B1p_BLACK_016.3mf` —— 黑 0.16 · 黑料卷 · P14/P27/P28（3件，外露必须黑）
- `tmp-plates-layout.json` —— 各盘件号/坐标/尺寸核对表
- `PRINT-PLAN.md` —— 本文件
