eleanor-wsyy/EffMeet2/hardware/robot-design/round-yaw-v2/revision-20261011-nomi-layoutA/print-split-v6/PLATE-RUNBOOK.md

# v6 打印执行手册 · 盘 × 机器 × 特殊设置

> 执行口径，不是切片结果。盘文件在 [plates/](plates/)，每盘一个 3MF（256×256 起点排布，俯视预览同名 PNG）。
> 件表真源：[PARTS.csv](PARTS.csv) / [parts.json](parts.json)；排布真源：[plates/plates.json](plates/plates.json)；尺寸真源：[../../parameters.json](../../parameters.json)。
> v5 的 G1/G2 已停打作废；本手册替代 v5 手册执行。

## 0. 总表（先看这张）

| 盘 | 文件 | 件数 | 颜色 | 机器 | 层高 | Brim | 支撑 | 这盘特别要挑的 |
|---|---|---|---|---|---|---|---|---|
| **G1 头壳** | [plate_G1_v6.3mf](plates/plate_G1_v6.3mf) | 1 | 灰 | **学校 H2S**（A1 也可） | **0.16** | **仅外侧 5mm（必须）** | 树状 | 前圈朝下＝接触面只有一圈环；支撑落内腔，确认能从前圆口掏出、**不封死前脸开口** |
| **G2 杯体** | [plate_G2_v6.3mf](plates/plate_G2_v6.3mf) | 1 | 灰 | **学校 H2D / H2S** | 0.20 | 建议 3–5 | 树状 | 底面朝下；深柱/出声通道支撑能掏出，**别堵前部出声槽** |
| **G3 上盖** | [plate_G3_v6.3mf](plates/plate_G3_v6.3mf) | 1 | 灰 | **自有 A1**（扁平小件不占学校机时） | **0.16** | 5（防翘） | 树状 | **接缝圈朝下＝装配面**，支撑不许破坏接缝圈；中心颈孔悬空 |
| **B1 外露件** | [plate_B1_v6.3mf](plates/plate_B1_v6.3mf) | 5 | **黑（必须）** | 自有 A1 | **0.16** | P28/P19 小件加 | 树状 | 面板 P24 面朝下、支撑全落背面；隐私滑片 P28 与导座 P27 **不得融合**；键帽/滑片是薄件，盯首层 |
| **B2 机构件** | [plate_B2_v6.3mf](plates/plate_B2_v6.3mf) | 12 | 黑（急用可灰） | 自有 A1 | 0.20 | 一般不用 | 按需树状 | **先打 S1 样片再决定这盘**：6806×Ø42.3 座孔、Ø29.8 轴、32T/64T 齿槽×188 真带、舵机耳 Ø1.8 导孔；空心轴竖直打（层向抗扭），隔柱/夹环通常无支撑 |
| **B3 支架件** | [plate_B3_v6.3mf](plates/plate_B3_v6.3mf) | 11 | 黑（可灰） | 自有 A1 | 0.20 | 一般不用 | 按需树状 | **LCD 后框 P25/相机托架 P26 等屏四孔已实测 77×45**（LCD-01 放行，10-15；v6r2 起按实测重建，80×45 假定作废）；麦压条 P21/P22 别堵拾音孔；线鞍 P30/P31 束带绕槽、**禁扎紧排线** |

俯视排布预览：[G1](plates/plate_G1_v6_topview.png) [G2](plates/plate_G2_v6_topview.png) [G3](plates/plate_G3_v6_topview.png) [B1](plates/plate_B1_v6_topview.png) [B2](plates/plate_B2_v6_topview.png) [B3](plates/plate_B3_v6_topview.png)

## 1. 机器现状（沿用 v5 手册查证）

| | 内容 |
|---|---|
| 学校 | 广美模型实验室：拓竹 P2S×8 / H2S×10 / H2D×10；喷嘴 0.4 硬化钢；需预约；**通风不允许 ABS/ASA** |
| 自有 | 拓竹 A1（256³，无封箱）＋现有 PETG |
| 材料 | PLA Matte 灰（已到货×2）/ 黑（已下单×1）；受潮按官方 45–70℃ 干燥 |
| 分工 | 大件灰壳 → 学校并行；小件/迭代件 → A1 |

## 2. 全局切片设置（所有盘通用）

| 项 | Bambu Studio 默认 | 改成 | 理由 |
|---|---|---|---|
| 墙层数 | 2 | **4** | 2.2–2.4mm 壁实测 k_max=3（`W=(2k-1)×0.42`），设 4 或 6 结果相同——生成器只生成放得下的圈，**多余圈不会导致丢层**（2026-10-16 实测更正，见 PRINT-LESSONS 教训22 更正/教训30）。4 已够，别当病因调它 |
| 稀疏填充 | Grid 15% | **Gyroid 15%** | Grid 交叉点重复挤出，大件刮擦 |
| 支撑 | 关 | **开＋树状**，外墙 2，顶面 Z 0.25–0.3，**支撑生成位置＝「仅在打印板生成」** | 树状好拆、痕浅。**「仅在打印板生成」必须开**：RUNBOOK:85 已诊断 NIGHT 四废（P04/P20/P21/P22）病根＝支撑长进口袋/孔洞；此前该设置只挂在 BNIGHT2 一行，件一换盘就丢（教训31） |
| **检查薄壁** | 关 | **开**（所有盘，不只 THIN 盘） | 薄于一道挤出的特征在此开关关闭时被整片丢弃。用 `tools/thinwall_audit.py` 的 thin_frac 量，不是数墙圈 |
| Brim | 自动 | 仅外侧 / 5mm（大件） | 防翘边 |
| 热床 | 官方 | 60–65℃ | 防翘 |
| 首层层高 | 0.2 | 不动 | 厚首层粘得牢 |
| 接缝 | 随机 | **对齐** | 别满壳麻点 |
| 腔温（H2） | 自动 | **盯 <40℃**，广州室温高要盯 | PLA 热变形约 55℃ |
| 喷嘴温度/速度/风扇 | 官方 PLA Matte | 不动 | |

## 3. 打印顺序（先样片后整件）

1. **S1 样片（PETG @A1）**：轴承座孔／空心轴配合、带轮齿槽×188 带、舵机耳孔、屏四孔、面板四柱 —— 结果回填 [MEASUREMENTS.csv](MEASUREMENTS.csv)，未实测不填 PASS。
2. **S2 正式料样片（PLA Matte）**：同接口复测收缩/孔径/表面。
3. 样片过了再排 G1–G3、B1–B3。
4. 样片是**正式料的另一次打印**，PETG 结论不跨材料套用到 PLA。

## 4. 状态

32 件全部 `CANDIDATE_NOT_RELEASED`（v6r3 新增 P33；P32 编号保留给无源麦胶座）；`slicer_status` / `sample_print_status` = `NOT_RUN`。
3MF 是几何起点排布，不含机型/材料/支撑配置，**不叫"已切片"**；切片确认后把最终朝向/支撑/机时回填，没有证据的字段保持空。

---

## 5. 2026-10-15 实际开打执行（B方案 · 取代上文六盘的机时安排）

> 上文 §0 六盘（G1/G2/G3/B1/B2/B3）是几何起点；本日按"数据齐×颜色×条件"合并并受**卷数约束**（黑1卷串行/灰2卷并行）重排为四盘，见 [plates-merged/](plates-merged/)。原 plates/ 保留不删。

| 盘文件 | 颜色/料卷 | 层高 | 机器 | 件 | 状态 |
|---|---|---|---|---|---|
| `plates-merged/TMP-B23p-SAFE_GREY_020.3mf` | 灰·卷1 | 0.20 | H2S | P05,P06,P11,P12,P13,P15,P17,P26,P29,P30,P31（11） | **开打中** |
| `plates-merged/TMP-G3p_GREY_016.3mf` | 灰·卷2 | 0.16 | H2D | P02（1） | 排队/开打 |
| `plates-merged/TMP-B23p-THIN_GREY_020.3mf` | 灰·卷1 | 0.20 | H2S（SAFE后） | P07,P08,P09,P10,P16（5） | 切片前勾**检查薄壁** |
| `plates-merged/TMP-B1p-v2_BLACK_016.3mf` | 黑·黑卷 | 0.16 | H2D（G3p后换黑） | P14,P27,P28,**P24(v6r2)**（4） | 末尾换黑料；旧 B1p 已改名 `.SUPERSEDED-by-v2` 作废 |
| `plates-merged/TMP-G1p_GREY_016.3mf` | 灰·卷1/2 | 0.16 | H2S/H2D 空档 | **P23 头壳(v6r2)**（1） | LCD四孔实测77×45后重建；前圈朝下+树支撑 |
| `plates-merged/TMP-P25_GREY_020.3mf` | 灰 | 0.20 | 任一空档 | **P25 后压框(v6r2)**（1） | 85×53（原88）；小盘快 |

**v6r2 重建（2026-10-15）**：LCD 四孔实测 77×45/孔径4（取代80×45假定）→ `build_v6.py` PARAMS `lcd_boss_rect=(77,45)`，在**隔离副本**用 Blender 4.5.3 重建；逐件 diff 确认其余 28 件体积/bbox 与 5.2 版 0.00% 漂移（4.5 复现无偏差）。新 P23/P24/P25 STL 在 `plates-merged/*_v6r2_77x45.stl`。仓库 `candidate-stl/` 未覆盖（仍为 80×45 版），以 plates-merged 的 v6r2 为准。

**FACEFLAT 大平脸返修（2026-10-19，⚠️ 取代上段的 P23/P24）**：B 案大平脸——P24 改 106×96 R21 圆角矩形平脸（屏窗 62×46）、P23 前口 106.6×96.6＋116×116 R40 边框，LCD 四柱/玻璃槽/摄像头高度不动，P25–P28 沿用。**当前 P23 = `plates-merged/P23_HEAD_SHELL_FACEFLAT.stl`、P24 = `plates-merged/P24_FACE_PANEL_FACEFLAT.stl`**，打印盘 `TMP-FIX-P23_GREY_016`（灰）/`TMP-FIX-P24_BLACK_016`（黑），前脸朝下，盘卡 [PLATE-CARD-P23P24.md](plates-merged/PLATE-CARD-P23P24.md)。`P23_v6r2_77x45.stl` / `P24_v6r2_77x45.stl` / G1p / B1p-v2 内的 P23/P24 **全部作废**（P25_v6r2 仍有效）。
**v6r3（2026-10-15）**：P01 后部 USB-C 开口改**容差窗 13.5×9.5**（SKU 未选不再阻塞杯体）；麦袋/声孔本就按 INMP441 中心孔承诺，非阻塞。`plates-merged/P01_v6r3_tolerant_usbc.stl` + `TMP-G2p_GREY_020.3mf`。
**朝向坑（manifold3d 逐层截面扫描发现）**：plates.json 里 **P21/P22 麦压圈 euler90=立1mm边**（截面仅~2.3mm²，又晃又脆）应**平躺**；**P14 短颈须翻180°法兰贴床**（原细管朝下易脱板）。补打盘朝向已烤进网格（自动摆放只动XY，翻不回去）。

### 2026-10-15 晚 · 过夜队列（三机拉满）＋ 2026-10-16 明早最小集

**过夜队列（每机两盘顺序执行，远控可停）**

| 机器/料 | 第1盘 | 第2盘 | 备注 |
|---|---|---|---|
| H2S-A 灰1 | `TMP-G2NIGHT_GREY_020`（P01杯体v6r3 + P11空心轴重打） | `TMP-G3p_GREY_016`（P02上盖重打） | P11 重打因 SAFE 疑似炒面（扫描clean=附着/碰撞，隔离远角）；G3p 床温首层65+Brim10+首层慢 |
| H2D 灰2 | `TMP-G1p_GREY_016`（P23头壳） | `TMP-COUPON_GREY_020`（S2样片4件） | G1 前圈朝下+Brim仅外+树支撑内腔 |
| H2S-B 黑 | NIGHT（在打） | `TMP-BNIGHT2-BLACK_012`（7件质量档） | P14翻面/P04/P20/P28/P21P22平躺/P18T容差托架；**支撑=仅在打印板生成**+检查薄壁+0.12+慢速；远控盯 |

**明早最小集**：inspect 过夜六盘 → 读样片梯条 → 失败件补打（若有）→ 到货试配/装配。无必打新盘。
**朝向坑记录**：P21/P22/P28 原 euler90 会立起（截面2.3mm²）应 rot0 平躺；P14 翻180 法兰贴床；均已烤进网格。NIGHT 四废（P04/P20/P21/P22）病根=支撑长进口袋/孔洞+压圈立打，BNIGHT2 已对症。

**切片参数（简中标签，手设；外部预设注入会被 Bambu 删除，勿再试）**：喷嘴 **0.4**；强度→**墙层数**=4、**墙生成器**=Arachne、**检查薄壁**=开（2026-10-16 实测更正：墙层数设得比几何能容纳的圈数大**不会丢层**，生成器只是不生成多余圈；2.2–2.4mm 壁实测 k_max=3，设 4 与设 6 结果相同。旧文"6圈=2.52mm塞不进→整层丢弃=空层真因"**不成立**，见 PRINT-LESSONS 教训22 更正/教训30）；**稀疏填充图案**=**螺旋体**（密度15%默认）；支撑→**开启支撑**=开、树状、**支撑生成位置**=**仅在打印板生成**（关键，见教训31）、**顶部Z距离**=0.25（需开支撑+面板顶部"高级"开关才显示，找不到用默认0.2可接受）；**接缝位置**=对齐、**Brim宽度**=5（均默认）。
**⚠️ 已存预设需 UI 重存**：`EffMeet2-v6 0.20 H2S` / `EffMeet2-v6 0.16 H2D` 是旧参数集（墙层数 6、无 Arachne/检查薄壁/支撑范围）。外部写入预设会被 Bambu 删除（教训9），**只能在 UI 里改好后「保存为预设」覆盖**。注意：重存是为了参数一致性，**不是**因为墙层数 6 会导致缺特征——那条因果已被实测推翻。

**薄壁结论**：P07–P10/P16 的"空层无法打印"= 薄于喷嘴的薄鳍被丢弃，**非网格真空层**（已逐Z三角面跨距验证）。SAFE 盘零警告可直接打；THIN 盘勾检查薄壁后薄鳍以单道薄壁挤出，缺几道薄边不影响结构主体。

**仍阻塞（不在四盘内）**：P01,P03,P04,P18,P19,P20,P21,P22,P23,P24,P25 —— 待测见 [MEASURE-TODO.md](MEASURE-TODO.md)；LCD四孔为最大解锁面（解锁P23/P24/P25）。

**状态纪律不变**：本次开打为候选件试打，`CANDIDATE_NOT_RELEASED` / `NOT_RUN` 保持；不构成打印放行。

**P21/P22 作废 → P32 胶座（2026-10-16 学妹照片发现）**：INMP441 含两侧焊盘总宽≈17–18 > 板径14，P21/P22 压圈（ID≈14.6）与 P01 壁袋环（ID14.6）均装不进。**P01 不返工**（壁袋环弃用），改新件 **P32 胶座×2**（腔19×19×4.2 避焊盘、底Ø6声孔对 P01 壁Ø2.4声孔、四角压唇固模块、胶贴弯曲壁）：`plates-merged/TMP-MICHOLDER-GREY_020.3mf`（灰0.20，2件小盘）。BNIGHT2 里的 P21/P22 成品报废留档。交付归档：[review-20261016-measure/](review-20261016-measure/)。
> ⚠️ **P32 与 P18T 无仓内建模源**（不在 build_v6.py / blend / candidate-stl / PARTS.csv），只存在于 3MF 内部，不可参数化重出。详见 [UNREGISTERED-PARTS.md](UNREGISTERED-PARTS.md)。

---

## 6. 盘登记总表（2026-10-16 补 · 每盘必须有一行，无条目不许上机）

> 由 `tools/plate_registry.py` 从 3MF 内嵌几何**实测**生成，不是从文档抄的。
> 完整数据（含每物件三角面数/尺寸）见 [production/plate-registry.json](production/plate-registry.json)。
> **补此表的原因**：此前 INTERN2-DEC / MICHOLDER / BVIS* / NECK-PETG / SPARE-PETG 等盘
> 在本手册里**根本没有条目**，支撑/Brim/层高无处可查；P20 从 BNIGHT2 挪到 INTERN2-DEC 后，
> 「支撑＝仅在打印板生成」这条对症设置就丢了（PRINT-LESSONS 教训31）。
> **所有盘一律按 §2 全局表执行**，本表只记该盘额外要注意的。

| 盘文件 | 料/层高 | 件数 | 最高件 | 隐含层数 | 盘内件 | 特别注意 |
|---|---|---|---|---|---|---|
| `TMP-INTERN2-DEC_GREY_020` | 灰 0.20 | 5 | 14.40mm | **72** | P04,P20,P18T,P32×2 | **支撑＝仅在打印板生成**（P20 柱内 Ø2.6 孔与 6.4×6.4 口袋不许进支撑）；P04 名带 `dec` 实为**未减面** 4896 面；P18T/P32 无源 |
| `TMP-MICHOLDER-GREY_020` | 灰 0.20 | 2 | 6.00mm | 30 | P32×2 | P32 无源；小盘快，可先打验证腔径 |
| `TMP-P18T_BLACK_020` | 黑 0.20 | 1 | 14.40mm | 72 | P18T | 对象名写作 `P18_TOLERANT_CRADLE`（无 T），与 P18(516面) 是**不同网格**(224面)，勿混 |
| `TMP-G3p-DEC_GREY_016` | 灰 0.16 | 1 | 9.90mm | 62 | P02(减面13614) | 真减面已验证；接缝圈朝下＝装配面，支撑不许破坏接缝圈 |
| `TMP-B23p-SAFE_GREY_020` | 灰 0.20 | 11 | 60.00mm | 300 | P05,P06,P11,P12,P13,P15,P17,P26,P29,P30,P31 | 零警告盘；轴承配合件等 S1 样片过 |
| `TMP-THINP25_GREY_016` | 灰 0.16 | 6 | 19.20mm | 120 | P16,P25,+4干净管 | 勾**检查薄壁** |
| `TMP-G2NIGHT_GREY_020` | 灰 0.20 | 2 | 60.00mm | 300 | P01(v6r3),P11 | P11 重打（SAFE 疑似炒面） |
| `TMP-G1p_GREY_016` | 灰 0.16 | 1 | 110.04mm | 688 | P23 头壳(v6r2) | 前圈朝下＋Brim仅外＋树支撑落内腔，**不封死前脸开口** |
| `TMP-B1p-v2_BLACK_016` | 黑 0.16 | 4 | 23.10mm | 145 | P14,P27,P28,P24(v6r2) | P27/P28 **不得融合**；旧 B1p 已作废 |
| `TMP-BNIGHT2-BLACK_012` | 黑 0.12 | 7 | 23.10mm | 193 | P14翻面,P04,P20,P28,P21,P22,P18T | **支撑＝仅在打印板生成**＋检查薄壁＋慢速；黑卷受潮已确认，**烘料后再打**；P21/P22 已作废 |
| `TMP-BVIS-BLACK_012` | 黑 0.12 | 2 | 23.10mm | 193 | P14,P28 直打版 | 与 BVIS-TILT 并存，二选一 |
| `TMP-BVIS-TILT-BLACK_012` | 黑 0.12 | 2 | 50.98mm | 425 | P14 倾45°,P28 | 需**筏层＋树支撑**；层数最多，机时最长 |
| `TMP-NECK-PETG-A1_020` | PETG 0.20 (A1) | 2 | 23.10mm | 116 | P14颈,P28滑片 | 宿舍替身件供联调；**PETG 结论不跨材料套用** |
| `TMP-S1PETG-A1_020` | PETG 0.20 (A1) | 4 | 14.00mm | 70 | S1 样片 | 轴承座孔/轴/齿槽/屏四孔；结果回填 MEASUREMENTS.csv |
| `TMP-SPARE-PETG-A1_020` | PETG 0.20 (A1) | 5 | 12.00mm | 60 | 耐磨备件 | — |
| `TMP-COUPON_GREY_020` | 灰 0.20 | 4 | 14.00mm | 70 | S2 样片 | 正式料样片 |
| `TMP-BLACK-NIGHT_020` | 黑 0.20 | 6 | 12.50mm | 63 | （P04,P20,P21,P22 等） | **已作废**：四废盘，病根见 :85；由 BNIGHT2 取代 |
| `TMP-FIX-P15P17P26P29_BLACK_016` | 黑 0.16 | 4 | 46.10mm | 288 | P15,P17,P26(ROT90X),P29 | **P26 已转 90°镜管朝床**；P15/P17 **局部树支撑 5%**（P15 z15–16/20–21；P17 z7–8 托盘外沿）；P29 brim5/支撑关；**P24 摄像孔另钻 6.8**；黑料先烘干 |
| `TMP-FIX-P23_GREY_016` | 灰 0.16 | 1 | 110.40mm | 690 | **P23 FACEFLAT 头壳** | 前圈朝下、支撑关、brim 仅外 5mm 可不加；**当前头壳版次**（取代 G1p 的 v6r2 圆脸）；卡 [PLATE-CARD-P23P24](plates-merged/PLATE-CARD-P23P24.md) |
| ~~`TMP-FIX-P24_BLACK_016`~~ | ~~黑 0.16~~ | ~~1~~ | ~~5.30mm~~ | ~~34~~ | ~~P24 FACEFLAT~~ | **已作废（镜头孔 4.2 系夹带回退）→ `.SUPERSEDED-by-CAM68`**；用 `candidate-stl/P24`（FACEFLAT＋6.8）或已打件钻 6.8 |
| `TMP-FIX-P27P28_BLACK_016` | 黑 0.16 | 2 | 2.80mm | 18 | P27,P28 RETAINFIX | brim 外侧 10mm（P28 首层 5.76mm²）；支撑关；挡墙 0.8 完整；卡 [PLATE-CARD-P27P28](plates-merged/PLATE-CARD-P27P28.md) |
| `TMP-FIX-P29B_BLACK_016` | 黑 0.16 | 1 | 46.10mm | 289 | P29 EDGEGRIP | brim 5–10mm；无支撑；耳槽 0.7 通缝；对象名=盘名（命名漂移，源=`candidate-stl/P29`）；卡 [PLATE-CARD-P29B](plates-merged/PLATE-CARD-P29B.md) |
| ~~`TMP-FIX-P15B_BLACK_016`~~ | ~~黑 0.16~~ | ~~1~~ | — | — | ~~P15 WIREFIX~~ | **已被合并版 P15 取代**（U 槽孔底/盲孔＋尾端让位槽双修）→ `.SUPERSEDED-by-V6R3MERGED`；用 `hardware/print-jobs/reprint-20261019-v6r3/` |
| `FIX2_P15P26P33_BLACK_016`（STL·hardware/print-jobs/reprint-20261019-v6r3） | 黑 0.16 | 3 | 23.70mm | ~148 | **P15 合并版,P26 v6r3,P33 新增** | P15 局部树 5%＋U 槽孔底成实底；P26 镜管朝床 brim5；P33 支撑关；卡 [PRINT-CARD-V6R3](../../../../print-jobs/reprint-20261019-v6r3/PRINT-CARD-V6R3.md) |
| `TMP-FIX2-ALL_BLACK_016`（STL·hardware/print-jobs/today-20261020） | 黑 0.16 | 7 | 46.10mm | ~289 | P24,P15,P26,P33,P29B,P27,P28 | 10-20 早合一盘；逐件 brim/支撑设置见 `hardware/print-jobs/today-20261020/MORNING-PLAN.md` |

**层数指纹用法**：打完看 App 报的总层数，与本表"隐含层数"对不上 → 说明 Bambu 里的工程
不是仓库这盘（层高/朝向/内容被改过）。2026-10-16 的 P20 排查正是靠这条发现
App 报 **128 层**、而 INTERN2-DEC 只有 **72 层**，且 `--match 128` 反查**无任何盘匹配**
→ 实际打印的工程与仓库盘不一致，须先把该工程另存 3MF 入仓再谈排查。

**排查入口**：小件缺特征/圆孔打不出来 → 先看 [SLICE-CARD.md](SLICE-CARD.md)（含第 0 步工程核对、支撑、薄壁、挤出/耗材四条路径与最小验证流程）。
