eleanor-wsyy/EffMeet2/hardware/robot-design/round-yaw-v2/revision-20261011-nomi-layoutA/print-split-v6/INTERFACE_GATES.md

# v6/A2 接口确认门槛（2026-10-15；2026-10-20 状态刷新）

本表把当前预算变成可执行核验，不填充未取得的实测数据。当前 **32 件**（v6r3 新增 P33）和 canonical v6 模型保持不变；R1面板固定是单独候选，未合并、未切片、未制造放行。唯一采购表仍为[当前BOM §12](../../BOM.md#final-purchase-decision)。

> **2026-10-20 刷新**：LCD-01 已于 10-15 实测放行（77×45/孔径4/总厚11，v6r2 重建）；FACE-01 由 FACEFLAT 大平脸以**单边 0.3 压配、无面板螺钉**定案（R1 螺钉候选不采用，已打件按此装配）；CAM-01 跨距更新为 10.75/余量 3.25，摄像头保持结构定案 **P26 v6r3＋P33 背板（2×M3×8）**；P24 摄像孔定案 **6.8**。下表状态列同步。

| 门槛 | 当前依据与缺口 | 要采集的证据/操作 | 通过后动作 | 当前状态 |
|---|---|---|---|---|
| FACE-01 面板锁壳 | ~~canonical v6有接收唇，没有明确锁壳件~~ → **FACEFLAT：P23 前口 106.6×96.6 对 P24 106.0×96.0，单边 0.3 压配锥面自锁，无螺钉**（R1 候选不采用） | 已打 P23/P24 后做压配试装：到底、四周缝隙均匀、装上不掉不转；松动按 ASSEMBLY 三点少量热熔胶/胶带 | 压配实测合格后回填 MEASUREMENTS；不复活 R1 螺钉方案 | GEOMETRY_COMMITTED（FACEFLAT）；压配试装 NOT_RUN |
| LCD-01 屏安装 | ~~孔距80×45假设~~ → **2026-10-15 卡尺实测：孔距 77×45、孔径4、PCB85×50、总厚11、玻璃到PCB4**；v6r2 已按实测重建 | 装配时复核：四孔对四柱、屏面与窗口同心、P25 拧到框贴板即停 | — | **MEASURED**（v6r2 已重建）；实装 NOT_RUN |
| CAM-01 FPC连接 | 实测记录8×8×4、14mm；**跨距 10.75/余量 3.25（v6r3）**；保持结构 P26 镜头入孔导向＋P33 背板 2×M3×8 | 无通电台架先装镜头/FPC；核插座接触面和两端锁紧、安装弯折（R≥5）与无拉扯；不得裁剪或加长；同舱正常动作后再检查稳定成像，沿用测试指南 | 核实际路线，不用直线余量替代弯折寿命结论 | GEOMETRY_COMMITTED（v6r3）；实装 NOT_RUN |
| POWER-01 USB-C输入板 | 20×15×6、开口11.5×7为预算，SKU未选 | 取得供应商图纸/实物；测PCB和突出焊点/USB-C口、插头尺寸；确认板额定输入及5V接口/分配路径，台架确认极性、压降和保护；不得假设任意USB-C裸板满足目标供电 | E17唯一BOM记录SKU，改杯壁开口/托架，重建；台架电气由具备能力的成员按测试指南执行 | SKU_UNSELECTED；ELECTRICAL_NOT_RUN |
| DRIVE-01 传动/轴承 | 32T/64T＋188mm闭环带；圆弧齿槽假设；舵机/轴承未实装 | 测舵机耳位/轴位/原舵盘/最大包络，轴承OD/ID/宽，带型号/宽/节线长；先打轴/轴承/齿形样片；低速台架观察啮合、张紧和限位，禁止反复顶硬挡 | 回填参数并重建；±45/0三静态姿态不等于完整运动/负载验证 | NOT_RUN |
| WIRE-01 跨轴细线 | **约11根**（方案1：麦/功放各一对 I2S；SD 常开；3V3 已定），轴孔Ø22、Ø10禁入 | 按实际GPIO/电源网络冻结线数（3V3?必须消歧）、导体/绝缘外径与端接；穿轴＋线夹后扫连续运动范围并验证无扯线/夹线；弯折耐久按既有测试指南，记录循环条件和结果 | M08线束定型，更新走线与活动禁入区；不得把杜邦端子当最终动态线束 | PINMAP_AND_HARNESS_UNFROZEN |
| FOOT-01 脚垫 | canonical杯底z=2mm；唯一BOM C07约2mm硅胶片，与0基准相符 | 实测脚垫含胶厚度、压缩后厚度、底面贴合；整机放桌上检查稳定、防滑与倾覆；不伪造已安装脚垫 | 渲染区分不带脚垫工程模型和带预算脚垫展示；尺寸标注说明0基准 | NOT_RUN |

## 出图门槛

- 原v6外观主视觉可以继续；需要展示UI时注明表现层，不据此声称固件已实现。
- R1若被采用，会有三处正面螺钉；主视觉不能沿用原v6无螺钉脸冒充R1。
- 爆炸图可以用于讨论，但FACE-01/LCD-01未通过时标为候选；采购件代理与打印件严格分开。
- 三个制造/硬件/最终设计放行布尔值仍false；26项硬件测试仍NOT_RUN。
