eleanor-wsyy/EffMeet2/hardware/robot-design/round-yaw-v2/revision-20261011-nomi-layoutA/print-split-v6/SLICE-CARD.md

# 切片设置卡 · P20 及同类小件（2026-10-16/17 排查后）

> 一页照着点。**先做第 0 步**，否则后面全白搭。
> 依据：全 31 件逐层实测（`tools/thinwall_audit.py`，已按真实双墙宽修正；**审计时 31 件，v6r3 新增 P33 后现为 32 件**）＋ 盘内容实测
> （`tools/plate_registry.py`）＋ **本机 Bambu Studio 02.06.00.51 的 `--info` 与用户实存预设读取**。
> 结论前提：**P20 的模型、盘、朝向、壁厚、墙层数全部无罪**，所以别再改建模、别再调墙层数。

---

## 已查实的铁证（2026-10-17，本机 Bambu Studio）

**① 几何无罪 —— Bambu 自己确认**（`bambu-studio.exe --info P20.stl`）：

```
max_x = 36.000000   max_y = 14.000000   max_z = 8.600002
number_of_facets = 1236    manifold = yes    number_of_parts = 1
volume = 1752.106689
```

与 `tools/thinwall_audit.py`（manifold3d）完全一致：1236 面、36×14×8.6、体积 1752.108、
`genus=2`（两孔全程贯通）、**空层 0**。

**② 墙层数无罪 —— 用真实线宽重算**（此前我用单一 E=0.42 算错了，已修正）：
预设实测 `outer_wall_line_width=0.42`、`inner_wall_line_width=0.45`。
Bambu classic 生成器第 k 圈中心线距边界 `d_1=0.21`、`d_k=0.42+(k-1.5)×0.45`。
P20 的 Ø7 柱环壁 W=2.20mm → **k_max=2**（第 3 圈 d₃=1.095 > 半厚 1.10，只剩 0.005mm
退化脊线，会被丢弃），余 **0.91mm 由 gap fill 接管** → 判 **CLEAN / OK**。
**所以 wall_loops 设 6、4、2 对 P20 结果相同**（都只生成 2 圈）。这就是"改 4 没用"的原因。

**③ 预设铁证 —— 教训31 从推断变成文件级事实**
读 `%APPDATA%\BambuStudio\user\959069435\process\EffMeet2-v6 *.json`：

| 预设 | 保存时间 | wall_loops | enable_support | **support_on_build_plate_only** |
|---|---|---|---|---|
| `EffMeet2-v6 0.20 H2S`（**INTERN2-DEC 用**） | **2026-10-15 16:06:23** | **6** | 1 | **0（未设，继承默认）** |
| `EffMeet2-v6 0.12 H2S`（BNIGHT2 用） | **2026-10-16 09:13:26** | **4** | 1 | **1（已设）** |
| `EffMeet2-v6 0.16 H2S` | 2026-10-15 14:37:14 | 6 | — | 0 |
| `EffMeet2-v6 0.20 H2D` | 2026-10-15 12:55:47 | 6 | — | 0 |

→ **BNIGHT2 的对症修复（sbpo=1、wall_loops=4）只进了 0.12 预设；0.20 H2S 预设在
10-16 之后从未重存，至今仍是 6 + sbpo=0。** P20 从黑盘(0.12)挪到灰盘(0.20)后，
用的正是那个**没被修过的**预设。RUNBOOK:88 警告过"改后须 UI 重存覆盖"，没做。

**④ 环境限制（诚实标注）**：CLI `--slice` 在 H2S 与 A1 两种机型预设下**均段错误**
（`0xC0000005`，崩在 `DynamicPrintConfig::update_values_to_printer_extruders_for_multiple_filaments`
的 "different nozzle volume processing"，发生在预切片之后、导出之前），
**拿不到 G-code**。故"支撑是否真的长进孔"无法用切片产物证实，只能靠你在预览里看。
（崩溃前日志有一行有用信息：`m_support_used 0`，但那是 A1 Standard 预设、非你的 EffMeet 预设，不能外推。）

---

## 第 0 步 · 先确认你打的是不是仓库这盘（最重要）

App 截图显示 **128/128 层**，但仓库 `TMP-INTERN2-DEC_GREY_020.3mf` 最高件 14.4mm、
0.20 层高只有 **72 层**。**128 ≠ 72**，且经反查**没有任何一盘 × 任何常用层高 = 128 层**：

```
python tools/plate_registry.py --match 128
→ （无任何盘×常用层高组合等于该层数）
```

说明 Bambu 里那个工程**跟仓库盘不一致**（层高/朝向/内容被改过，或另存过）。

**必做**：在 Bambu 里 `文件 → 另存工程为 3MF`，把那个工程存进
`plates-merged/`（名字带上日期），然后用
`python tools/plate_registry.py` 核对它的物件与层数。
**在对上之前，任何基于仓库盘的分析都不适用于你手上的实物。**

---

## 第 1 步 · 挤出 / 耗材（**首要嫌疑**，先查这个）

照片形貌直接指向这里，不是切片：5 件里 **3 件只有下半截、断口粗糙不规则、
且停在互不相同的高度**。

判据（记住这条，以后一眼分辨）：

| 断口形貌 | 病因 |
|---|---|
| 平整、顶面是规则层纹 | 切片/设置问题（层没生成或特征被丢弃） |
| **粗糙不规则、多件停在不同高度** | **挤出中断**（堵头／料尽／湿料气泡） |

**任何切片设置都无法让同盘几个件停在互不相同的高度** —— 设置错会一致地错。
而打印机照走完路径，所以 App 报满层"成功"。

| 查 | 怎么查 |
|---|---|
| **料含水** | 拉丝／炒面／表面雾面／爆裂声 → 烘 **45–60℃ 4–6h** ＋拉丝测试（教训25）。**灰卷也必须复测**：教训25 只证明了黑卷受潮，"灰卷不犯"是当时的观察、不是含水实测 |
| 堵头 | 冷拉／热拉喷嘴；查挤出机是否打滑、料丝被啃出坑 |
| 料尽 | 换料瞬间的高度是否正好落在失败高度附近 |
| 温度 | PLA Matte 喷嘴温度是否偏低导致挤不动 |

---

## 第 2 步 · 支撑范围（**已证实的预设偏差，必须修，但不是 P20 缺孔的充分解释**）

`EffMeet2-v6 0.20 H2S` 的 `support_on_build_plate_only = 0`（支撑不限定在打印板），
而 BNIGHT2 的 0.12 预设是 `1`。RUNBOOK:85 记的 NIGHT 四废病根正是
「**支撑长进口袋/孔洞**＋压圈立打」，对症就是这一项。**这条修复没跟着 P20 换盘搬过来。**

| 项 | 简中标签 | JSON 键 | 设成 |
|---|---|---|---|
| 支撑生成位置 | **仅在打印板生成** | `support_on_build_plate_only` | ✅ **1**（现在是 0） |
| 开启支撑 | 开启支撑 | `enable_support` | 1（已是） |
| 支撑类型 | 树状 | `support_type` | tree(auto)（已是） |
| 顶部 Z 距离 | 顶部Z距离 | `support_top_z_distance` | 0.25（已是） |

**但要说清楚**：P20 的 6.4×6.4 口袋是**朝上开口**的凹槽（不是悬空），Ø2.6 孔是**竖直通孔**
（孔壁垂直，不构成悬垂）——两者按几何都**不需要支撑**。所以 sbpo=0 是否真导致支撑长进
P20 的孔，**我无法证实**（CLI 切不出来）。它是一个**确凿的预设偏差、该修**，
但不一定是这次缺孔的原因。**预览里看一眼就有答案**（见下）。

**预览必查**：切片后转到 z≈3–9mm，看两个 Ø7 柱 —— **柱内 Ø2.6 孔里、以及底座
6.4×6.4 口袋里，不许有任何支撑**。有 → sbpo 就是真凶；没有 → 回到第 1 步查挤出。

---

## 第 3 步 · 检查薄壁 / 墙生成器

| 项 | 简中标签 | JSON 键 | 现状 | 设成 |
|---|---|---|---|---|
| 检查薄壁 | **检查薄壁** | `detect_thin_wall` | **已是 1** | 保持开（所有盘，不只 THIN 盘） |
| 墙生成器 | 墙生成器 | `wall_generator` | **classic** | 可改 **Arachne**（变宽墙，薄壁更稳） |

理由：薄于一道挤出的特征在此开关关闭时会被**整片丢弃**。
（实测全 31 件 thin_frac 最大仅 1.53%、FAIL_THIN 0 件，所以这不是 P20 的病因；
但 `detect_thin_wall` 你本来就开着，无需改。Arachne 是可选改进，不是必需。）

---

## 第 4 步 · 墙层数：**别再调它，调了也没用**

| 项 | JSON 键 | 现状 | 说明 |
|---|---|---|---|
| 墙层数 | `wall_loops` | 0.20 H2S 预设 = **6** | 用真实双墙宽（外0.42/内0.45）算，P20 环壁 2.20mm 的 **k_max=2**（第3圈中心线 d₃=1.095 > 半厚 1.10，只剩 0.005mm 退化脊线会被丢弃）。**设 6、4、2 结果完全相同**，都只生成 2 圈 + 0.91mm gap fill |

⚠️ 三处需要更正的历史说法（本仓库文档已改）：

1. 「墙层数 6 → 整层丢弃 → 假性成功」——**机制不成立**。墙层数设得比 k_max 大，
   生成器只是不生成多余圈，**不会丢层**。
2. 「`6×0.42=2.52 > 2.4` 塞不进」——**算式只算了单侧墙**。环形/双侧壁由内外两侧
   同时生成，k_max 由 `W = 2×(外+(k-1)×内)` 决定，不是 `(2k-1)E`。
3. 「改成 4 没用是因为预设没重存」——**不是**。预设确实没重存（仍是 6），
   但**即使真改成 4 也不会有效果**，因为 4 和 6 对 2.20mm 环壁都只生成 2 圈。
   **墙层数从来就不是这个件的病因。**

---

## 第 5 步 · 重打前的最小验证（省机时）

1. 只切 **P20 单件**（别整盘），层高 0.20。
2. 预览逐层拖到柱子顶部（z≈3–9mm）：**每层都要有两个闭合环 + 中心 Ø2.6 孔轮廓**。
3. 确认**无橙色「空层无法打印」警告**。
4. 确认孔内/口袋内**无支撑**（这一步直接判定第 2 步的 sbpo 是不是真凶）。
5. 记下 App 将显示的**总层数**：P20 高 8.6mm ÷ 0.20 = **43 层**。
   打完若 App 报的层数 ≠ 43，说明工程又不是你以为的那个。
6. 以上全过再上机；先打 1 件，别一次排满。
7. **改完预设务必 UI「保存为预设」重存覆盖** `EffMeet2-v6 0.20 H2S`——
   这次排查已证实：10-16 的修复只存进了 0.12 预设，0.20 预设至今是旧值。

---

## 附：本次实测数据（可复现）

```bash
# 逐层薄壁/空层审计（全 31 件）—— 注意用真实双墙宽，别用单一 E
python tools/thinwall_audit.py stl candidate-stl/*.stl \
    --eouter 0.42 --einner 0.45 --lh 0.2 --step 3 --quiet
# → 空层 0、FAIL_THIN 0 件、P20 = k_max 2 / band 0.91 / CLEAN / OK

# 单盘审计（含盘内无源件 P32/P18T）
python tools/thinwall_audit.py 3mf plates-merged/TMP-INTERN2-DEC_GREY_020.3mf

# 盘内容与层数指纹
python tools/plate_registry.py --match 128

# Bambu 自己核对几何（不切片，不会崩）
& "D:\Program Files\Bambu Studio\bambu-studio.exe" --info <件.stl>
```

**P20 实测汇总**：`genus=2`（两孔全程贯通）、空层 0、`k_max=2`、残隙 **0.91mm**（gap fill 接管）、
thin_frac **0.00%**、1236 三角面（盘内与 `candidate-stl/` 逐面一致）、
朝向 36×14 面朝下柱朝上（正确）、Bambu `--info` 报 `manifold = yes`。

**读预设生效值**（预设是增量式的，单看一个文件会漏掉继承项，必须解析继承链）：
`%APPDATA%\BambuStudio\user\<id>\process\EffMeet2-v6 *.json` → `inherits` 逐级向上。
注意 JSON 键名是 **`enable_support`**（不是 `support_enable`）、
**`support_on_build_plate_only`**、**`support_top_z_distance`**。

**诚实边界**：
- 本机 Bambu Studio 的 **CLI `--slice` 会段错误**（H2S/A1 两种机型预设都崩，
  崩在 `update_values_to_printer_extruders_for_multiple_filaments`），
  **拿不到 G-code**。所以"支撑是否真长进 P20 的孔"**无法离线证实**，只能靠第 5 步预览。
- 按几何推理，P20 的口袋朝上开口、Ø2.6 孔是竖直通孔，**两者都不构成悬垂**，
  理论上不需要支撑 —— 所以 sbpo=0 虽是确凿的预设偏差，**未必是这次缺孔的原因**。
- **首要嫌疑是挤出/耗材**（第 1 步）：多件停在互不相同高度＋断口粗糙，
  这是任何切片设置都造不出来的形貌。

---

## 2026-10-20 补：v6r3/FACEFLAT 改动件审计（`production/thinwall-v6r3.json`）

P15（合并版）/P23 见头壳盘卡/P24/P26/P27/P28/P29/P33 七件重测：**FAIL_THIN 0**；P26/P27 为 WARN_SLIVER（切片预览勾「检查薄壁」即可），其余 WARN_TIGHT 与既有 P28 同级（≤1.53%，可接受）。
新增件 **P33 已入薄壁审计与 candidate 链**（对照：P32/P18T 仍无源，见 UNREGISTERED-PARTS）。
