eleanor-wsyy/EffMeet2/hardware/robot-design/round-yaw-v2/revision-20261011-nomi-layoutA/print-split-v6/NEXT-STEPS.md

# LCD 四孔卡尺回填表（GOOUU 2.8″ TFT，屏已到货）

> 量完把数字填进"实测"列，发给我，我重建 P23 头壳 / P24 面板 / P25 LCD后压框 并出 G1 灰盘。
> 单位 mm。卡尺量到 0.1 即可。当前建模假定：孔距 80×45（未验证）。

| 项 | 实测 | 备注 |
|---|---|---|
| 安装孔孔径（4 孔应同径，量 1–2 个） | ____ | 若 4 孔不同径逐个记 |
| 横向孔距（左孔心→右孔心） | ____ | 假定 80 |
| 纵向孔距（上孔心→下孔心） | ____ | 假定 45 |
| 孔心到 PCB 左边缘 | ____ | 可选，用于定位 |
| 孔心到 PCB 下边缘 | ____ | 可选 |
| PCB 长×宽 复核 | ____ × ____ | 已测 85×50，复核 |
| 排针在 FPC 侧短边（是/否） | ____ | 已测，复核 |

量完回填到仓库 `print-split-v6/MEASUREMENTS.csv` 的 LCD 行 actual_mm 列，status 改 MEASURED_UNFITTED。

---

# 待下单 3 件（典型案例口径，见 PRINT-PLAN §五）

| 件 | 搜索关键词 | 必须确认 | 典型价 |
|---|---|---|---|
| GT2 闭环带 | `2GT 环形同步带 6mm 周长188` | 节线长188(非外周长)、宽6、齿形2GT、闭环、橡胶+玻纤芯 | ¥3–10 |
| USB-C 5V 输入小板 | `USB-C 母座 5V 供电小板 裸板` | 直通5V≥2A、板≤20×15、厚含母座≤6、**不要TP4056充电板/PD调压板** | ¥1–5 |
| 6×6 轻触开关 | `6x6x5 轻触开关 四脚 直插` | 本体6×6、高5(若买其他高度须回填TACTILE_KEY)、四脚直插 | ¥0.05–0.2/个 |

已在购物车待确认下单：**INMP441×2**（到货量底部中心拾音孔坐标 → 解锁 P21/P22/P01 壁袋）。
