eleanor-wsyy/EffMeet2/hardware/robot-design/round-yaw-v2/concept/as-printed-abs-gf-20261010/SOURCE.md

# ABS-GF裸打方案 · 新版机器人效果图

日期：2026-10-10；以仓库提交0f33a1e的最新采购/打印决策为依据。使用用户指定的银河智算tt-image-2，输入当前模型组装、正视、侧视3张审阅图，不上传旧Image2概念图作为几何参考。

## 参考与优先级

- [组装模型](../../renders/review-02/01_assembled.png)、[正视](../../renders/review-02/02_front.png)、[侧视](../../renders/review-02/03_side.png)：限制主体比例、分件和短颈/底座关系。
- [PRINT_PLAN.md](../../PRINT_PLAN.md)、[BOM](../../BOM.md#final-purchase-decision)：白/黑ABS-GF裸打、黑色按钮、黑打印框＋外露矩形LCD、不额外做透明屏罩。
- [parameters.json](../../parameters.json)：整机180×164×222mm、头部150×128×144mm。尺寸用于提示约束，不能从AI输出量尺寸。

## 图像与真实图纸的区别

此图是AI辅助产品效果概念，不是Blender渲染或新可打印图纸。颜色/质感呈现和功能孔设计意图按最新计划替换了灰模占位；当前.blend没有因此完成CAD改造。

扬声器槽孔、麦声孔及显示框等在图中的形状/位置是功能意图示意。其实际孔位、公差、声学与配件安装尚未冻结；不能用这张图替代制造检查，也不声称与模型逐像素或毫米一致。

保留原主视觉和全部模型/证据，不覆盖或改变manufacturing_ready=false。生成原始回执保存在local-only，不提交付费账户数据。完整提示词见prompt.txt。

## 本次检查

已目视核对：整体仍为圆润头部、短黑颈与宽固定底座，显示区是独立矩形小屏，按钮为黑色，机身无喷漆高光或额外透明面罩。输出实际2513×1669像素。未用生成图证明毫米尺寸、打印层纹的实物一致性或功能开孔已完成。
