eleanor-wsyy/EffMeet2/hardware/robot-design/round-yaw-v2/revision-20261011-nomi-layoutA/print-split-v6/review-20261015/FEEDBACK.md

# 在议 v6 问题处理反馈

日期：2026-10-15。基于651c6ba；本轮fetch未发现新增远端提交。本目录交付本次采购口径修正、接口门槛及独立R1候选；canonical v6仍保持不变。

## 结论

采购和文档冲突已清理；面板锁壳已推进为可检查的三点螺钉固定R1候选。R1通过局部几何和两个STL独立复读，仍需实物螺钉/螺母和打印样片验证，未并入canonical v6。其余未测接口已转成有操作/证据/后续动作的门槛清单，没有伪填实际尺寸。

## 1. 面板固定

- 左右＋左下三点M3前装螺钉；头壳接收柱与原接收唇以原生Boolean融合，内侧捕获螺母。面板可拆，不靠胶/强过盈/脆性卡扣承力。源外形、Ø106黑脸和屏窗不改。
- 下方孔偏左16mm、相对头中心低45mm，避开原线夹。首版居中柱与线夹干涉；失败证据保留，第二版局部修正通过。
- 只有头壳和面板改变，其他29件签名一致；两个修改件均非流形0、边界0、连通块1、零面积面0、正体积。沿用v6表面内缩0.05mm的BVH方法，未发现与其余打印件/元件代理的新增表面相交。该方法不等于完整容积/公差/强度证明。
- 两个候选STL导出后复读：每边恰有两个反向三角形、体积正、零面积三角形0；未替换正式31件集合。
- 外观代价：正面新增三处螺钉头。当前购买件包络没有螺纹或驱动槽，不是最终五金渲染。M3×12/螺母尺寸仍须实物核验；侧装/保持、工具空间、扭矩、打印公差、强度、疲劳和跌落未验收。

## 2. 唯一BOM已修正

第12节统一为v6/A2，前文历史保留：核心板/屏/摄像头在头内；音频/舵机/键在固定底座；E05摄像跨轴FPC取消，E16 TP4056和电池本轮数量0；E04为头内LCD连接，约9根跨轴软线归M08。打印清单41→31，更新测量表/排盘入口，不继承旧G1/G2进度或M3×70×8。新增E17输入小板预算，SKU仍未选，明细34项（含取消/推迟）。M09只列R1三套螺钉/螺母取样预算；订单物流未凭空更新。

## 3. 未测接口的执行顺序

[INTERFACE_GATES.md](../INTERFACE_GATES.md)含FACE-01/LCD-01/CAM-01/POWER-01/DRIVE-01/WIRE-01/FOOT-01，共7项。每项列缺口、证据、操作、通过后动作。

1. **先补LCD实测**：四孔XY/孔径、玻璃/背光/PCB堆叠深度、排针突出/方向。PCB85×50和总厚11原记录保留；80×45孔距、4mm深度仍是假设。
2. **面板局部样片**：拿到真实螺钉/螺母后核孔配合、侧装捕获螺母、工具可达和拆装；不直接打整头壳。
3. **输入板选型**：SKU/外形/焊点/口/插头/额定值与5V路径确认后，再冻结杯体开口和托架。
4. **传动与线束**：真实舵机/轴承/带参数和线数/直径；三静态姿态不替代连续运动、负载和弯折耐久测试。

## 4. 更正上轮尺寸判断

底部z=2mm与BOM C07约2mm硅胶脚垫预算相符。上轮应说“脚垫未建模/未实测，尺寸基准需标清”，不应暗示为模型高度错误。名义0基准到顶约200.8mm；裸实体跨度约198.77mm；压缩后脚垫厚度待实测。

## 5. 对渲染的影响

原v6主视觉/CMF可继续，标清候选及UI表现层。采用R1时，正面三处螺钉必须反映，不能用无螺钉脸冒充R1；实际五金外形核对后再做高保真。当前[R1拆卸检查图](face-retention-r1/renders/03_exploded_evaluated.png)是固定方案讨论图，非全机正式爆炸图，绿色电子块为包络代理。正式装配/爆炸图在FACE-01和LCD-01通过后冻结。

## 交接入口

- [R1说明](face-retention-r1/README.md)
- [只读核验报告](verification-report.json)
- [复核脚本](verify_review.py)
- [唯一BOM](../../../BOM.md#final-purchase-decision)

canonical v6模型、build_v6.py、parameters.json、31个STL未改；manufacturing_ready / hardware_validated / final_design_approved仍false；26项硬件测试NOT_RUN。
