eleanor-wsyy/EffMeet2/hardware/robot-design/round-yaw-v2/revision-20261011-nomi-layoutA/print-split-v6/plates-merged/PLATE-CARD-P15B.md

# PLATE-CARD · TMP-FIX-P15B_BLACK_016（P15 出线卡滞修复）

> 2026-10-19 · 返修轮 2：FITFIX 盘的 P15 舵机仍放不进——**线卡在架孔（耳垫张紧导孔）**。
> 本盘只含 P15 一件（其余 P17/P26/P29 已检合格，无需重打）。

## 根因与修复（build_v6.py）

| 问题 | 根因 | 修复 |
|---|---|---|
| 线卡在架孔 | 耳垫张紧导孔是上下全通长圆孔（5.8×1.8×8），出线从端面出来一翻就楔进孔里拔不出来 | 导孔改**带 1mm 孔底的 U 槽**（只从上口进螺钉）；M2 仍可穿耳孔进槽、±2mm 张紧不变 |
| 螺尖顶线 | 两颗底板 M3 导孔深 10mm，螺尖会伸进盘上方出线区 | 导孔改**盲孔（止于盘面）**；螺钉用 **M3×6**，尖端与盘面平齐 |

口袋 23.6×13.7（+1.2）不变——本轮问题不在口袋，在线的走法。

## 打印（黑 0.16，同 TMP-FIX-P15 系列）

| 项 | 值 |
|---|---|
| 文件 | `TMP-FIX-P15B_BLACK_016.3mf` / `.stl`（单件居中） |
| 朝向 | 底面朝下（0×0×0），口袋/耳垫朝上，**无支撑** |
| 材料/层高 | PLA Matte 黑，0.16（首层 0.2） |
| 墙/填充 | 4 墙、Gyroid 20% |
| Brim | 不需要（底面 24×24 足够） |
| 附着注意 | U 槽孔底 1mm 是桥面，切片预览确认它打成实底而不是悬空 |

## 打后检验（对应检验单 P15 节）

1. **出线**：MG90S 出线朝任一端，线从端面出来能自然下垂到盘面走掉；翻上去也**滑开，不进导孔**——重点验证这一条。
2. **装入**：从出线侧斜入能落到底，耳底贴耳垫；不强压。
3. **架孔**：M2 螺钉穿耳孔进 U 槽，能在 ±2mm 内张紧后锁住。
4. **底板螺钉**：M3×6 从杯底锁入，尖端不冒出盘面（用手指摸不到）。

## 不要

- 不要用 M3×8/10（长螺钉尖端会重新顶进线区）。
- 不要把 U 槽孔底钻穿（钻穿=回到卡线状态）。

---

## ⚠️ 2026-10-20 合并说明：本盘已被合并版 P15 取代

`feat/software-route-a-20261019` 同晚另修了同一问题的另一面（P15 尾端没有出线让位，线被口袋尾端/底板/侧墙顶住）。合并后的 `candidate-stl/P15` = 本卡的 U 槽孔底＋底板盲孔 **＋** 尾端 6.8×9.6 出线让位槽，两修并存。后续重打请用合并版：`hardware/print-jobs/reprint-20261019-v6r3/`（盘卡含检查项）；本盘 `P15_SERVO_CRADLE_WIREFIX.stl` 留档不再用。
