eleanor-wsyy/EffMeet2/hardware/robot-design/round-yaw-v2/revision-20261011-nomi-layoutA/print-split-v6/plates-merged/PLATE-CARD-P15P17P26P29.md

# PLATE-CARD · TMP-FIX-P15P17P26P29_BLACK_016

> 2026-10-18 · 配合缺陷修复批（P15/P17/P26/P29，见 `PLATE-CARD` 前置讨论与 `build_v6.py` FITFIX）。
> 原则：**能合并一盘尽量合并一盘；保证质量的前提下尽量缩短打印时间。**

## 一盘决策

| 项 | 值 |
|---|---|
| 盘文件 | `TMP-FIX-P15P17P26P29_BLACK_016.3mf` / `.stl` |
| 件 | P15 舵机耳架、P17 功放托盘、P26 摄像头托架、P29 核心板托架（4 件全黑） |
| 材料/色 | PLA Matte 黑 |
| 层高 | 0.16（与 TMP-FIX-P02P20 同预设口径） |
| 为何合一盘 | 4 件同料同色同层高；单件外廓均小（最大 P29 46mm 高），一盘放得下且总高相近 |

## 省时取舍（质量不降）

1. **并盘**：4 件一盘 = 只做一次预热/调平/首层，比 4 个单盘省约 30–40 分钟。
2. **无支撑朝向**（沿用 PARTS.csv 设计朝向）：P15 口袋朝上、P17 托盘朝上、P26 镜管朝床、P29 底朝下——四件都不需要支撑，省支撑材料与拆支撑时间，表面质量也好。
3. **紧凑排布**：X 向单列，件间 12mm，减少空跑。
4. **层高不为省时放大**：配合件（P15 口袋 / P26 腔与镜管 / P29 槽）维持 0.16，不用 0.20 换时间。

## 质量参数（不许省的）

| 参数 | 值 | 原因 |
|---|---|---|
| 墙层数 | 4 | P15/P26/P29 的配合尺寸靠墙成型 |
| 填充 | 20% gyroid | 小件足够，不减 |
| 底板附着 | 仅 **P29 加 5mm brim** | P29 高 46mm 薄壁，防翘；其余不加，省拆边时间 |
| 支撑 | 关 | 四件朝向均无悬空 |
| 速度 | 按机器默认质量档 | 不开「草稿」类预设 |

## 打印后检验

- P15：MG90S 滑入口袋能进、留 ±2mm 张紧；耳孔对架孔。
- P17：MAX98357A 落在两柱上、M2×4 手拧入、板贴平不翘；排针侧不顶围边。
- P26：镜头凸台进 Ø6.5 镜管到底、模组不晃；FPC 出线不折死。
- P29：核心板插到底不晃、2×M3 对 P23 头底柱。
- 任一判据不过 → 停，按 `MEASUREMENTS.csv` 记 MEASURED_UNFITTED，不硬装。

## 装前 30 秒

量 P26 镜管内径 ≈6.5、P29 槽宽 ≈1.8（1.6 板 +0.2）、P15 口袋宽 ≈13.7（12.5+1.2）。
