eleanor-wsyy/EffMeet2/hardware/robot-design/round-yaw-v2/revision-20261011-nomi-layoutA/print-split-v6/EffMeet2-重打件检验单-P03P05P06P15P17P18TP26P28P29-20261019.docx

EffMeet2 · 重打件检验单

P03 / P05 / P06 / P15 / P17 / P18T / P26 / P28 / P29　·　2026-10-19

· 用途：对 2026-10-18/19 重新打印的 9 件做收件检验，确认缺陷已消除、各件能实现自身功能后再进总装。

· 判定：逐项勾选；任一项不过 → 本件判「返修」或「不合格」，不得强压强拧硬装。紧的修塑料（砂纸/铰孔），松的加垫片/生料带，不敲轴承、不扩座孔。

· 纪律：实测值回填仓库 MEASUREMENTS.csv（状态 MEASURED_UNFITTED），本单只做过程记录；禁裁 FPC。量具：卡尺 0.1mm、6806 轴承×2、P11 空心轴、MG90S、核心板、P27 滑槽、COUPON 梯条。

· 重要：P26 背后方孔是 CAMERA_FPC_EXIT（6×10×8，FPC 出线口），不是缺陷，不要当问题报。

一、总览（问题 → 修复 → 来源）

件号 | 名称 | 本次问题 | 修复 / 重打要点 | 来源盘
P03 | 从动 64T 带轮 | 支撑压功能面、顶丝孔易堵 | 翻转打（顶圈贴床）；支撑只进减重孔 | TMP-FIX-P03P05P06_GREY_016
P05 | 承力塔＋下轴承座 | 轴承座面有支撑残留、座孔配合不过 | 不翻（座圈朝上）；支撑只在座圈下方 | TMP-FIX-P03P05P06_GREY_016
P06 | 上轴承座 | Ø38.5 孔进支撑、座面脏 | 不翻；孔内加支撑阻挡器（Ø34×1.0） | TMP-FIX-P03P05P06_GREY_016
P15 | MG90S 舵机可调耳架 | 装不进（口袋不够）；出线卡导孔 | P15B：口袋+1.2；导孔 U 槽带孔底、M3 盲孔 | TMP-FIX-P15B_BLACK_016
P17 | MAX98357A 低托盘 | 无安装柱，板无法固定 | FITFIX：2×M2 柱（距 12.6）与托盘融合 | TMP-FIX-P15P17P26P29_BLACK_016
P18T | USB-C 5V 容差托架 | P18 按未选型 SKU 建，实物装不上 | 容差窗口径；无源件，实测优先 | TMP-P18T_BLACK_020 等
P26 | 摄像头 8×8 托架 | 镜头放不进（镜管 Ø4.6 过小） | FITFIX：镜管 Ø6.5 打穿、腔+1.2 | TMP-FIX-P15P17P26P29_BLACK_016
P28 | 隐私滑片+P27 导轨 | 滑片卡不牢会掉（挡墙 0.2 打不出） | P27P28：挡墙 0.8＋槽 1.2＋拨片加长 | TMP-FIX-P27P28_BLACK_016
P29 | 核心板竖直托架 | 仍插不稳（耳槽没咬住板边，差 0.9mm） | P29B：耳槽咬边 0.6＋槽 1.7/底槽 28.5 | TMP-FIX-P29B_BLACK_016

二、分件检验

P03　从动 64T 带轮（套 P11 空心轴＋M3 顶丝）

来源：reprint-20261018/TMP-FIX-P03P05P06_GREY_016（灰 0.16，翻转：顶部小圈贴床、安装孔朝上）

本次问题：原方向打印时支撑落在安装孔等功能面；M3 顶丝孔有 2 条非流形边，易被材料堵死。

修复/重打：翻转打印，支撑只落顶部减重孔（2.45mm 深）；打后用 Ø30 圆棒掏支撑。

项 | 检查项 | 判据 / 方法（名义） | 实测 / 记录 | 判定
外观 | 顶部减重孔支撑掏净 | Ø30 圆棒能伸进减重孔到底，无残桩 | ________ | □合格 □让步 □返修 □不合格
外观 | 安装孔干净 | Ø30.15 孔内无支撑残留、无瘤；对光看无粘连 | ________ | □合格 □让步 □返修 □不合格
外观 | 顶丝孔通 | 1.5–2mm 钻头能穿过 M3 顶丝孔，孔不堵、不豁 | ________ | □合格 □让步 □返修 □不合格
外观 | 齿形完整 | 64 齿无缺齿、无层错；齿面无支撑疤 | ________ | □合格 □让步 □返修 □不合格
尺寸 | 安装孔内径 | 30.15±0.1（对 P11 轴 Ø29.8，单边旷约 0.18 属正常） | ________ | □合格 □让步 □返修 □不合格
尺寸 | 总厚 / 外径 | 厚 10.6±0.2；外廓约 43.2×43.2 | ________ | □合格 □让步 □返修 □不合格
配合 | P11 轴试装 | 轴能穿入安装孔；M3 顶丝能锁住 D 面，锁后手转不打滑 | ________ | □合格 □让步 □返修 □不合格
配合 | 挂带试转 | 与 P04 挂 GT2 188 闭环带，P15 张紧槽 ±2mm 内能张紧；转一圈无卡滞、无跳齿 | ________ | □合格 □让步 □返修 □不合格

本件判定：□ 合格　□ 让步接收　□ 返修　□ 不合格　　检验人：________　日期：______　备注：______________

P05　承力塔＋下轴承座（一体，四柱落底）

来源：reprint-20261018/TMP-FIX-P03P05P06_GREY_016（灰 0.16，不翻：座圈朝上）

本次问题：上一轮功能检验不过：轴承座面留支撑、座孔与 6806 外径配合未验证。

修复/重打：不翻转（翻了支撑会顶座面）；支撑只在座圈下方（5% 树状），从四条腿之间往外掏。

项 | 检查项 | 判据 / 方法（名义） | 实测 / 记录 | 判定
外观 | 座圈下方支撑掏净 | 四腿之间能掏出全部支撑；外观看座圈底无残桩 | ________ | □合格 □让步 □返修 □不合格
外观 | 轴承座孔干净 | Ø42.3 座孔内无支撑、无瘤；座面平整可贴轴承端面 | ________ | □合格 □让步 □返修 □不合格
外观 | 四脚完整 | 四柱无裂无缺；brim 残边修平，能平放不晃 | ________ | □合格 □让步 □返修 □不合格
尺寸 | 座孔内径 | 42.3±0.15（对 6806 外径 42.0，单边旷约 0.15 属正常） | ________ | □合格 □让步 □返修 □不合格
尺寸 | 堆叠高度 | P05(36.2)+支柱(11.4)+P06(8.6)≈56.2 → 贯穿螺栓用 M3×55–60，不是 M3×70 | ________ | □合格 □让步 □返修 □不合格
配合 | 6806 试座 | 轴承能入座孔：紧=砂纸/旋转锉修孔，松=COUPON 梯条垫片/点 CA；禁敲轴承、禁扩座孔 | ________ | □合格 □让步 □返修 □不合格
配合 | 与 P06 对合 | 4×M3 通孔对 P06 顺畅穿过；对合后轴承被夹住不轴向窜动 | ________ | □合格 □让步 □返修 □不合格
配合 | 落底 | 四脚落在 P01 底面，塔身垂直；与 P12 夹环不干涉 | ________ | □合格 □让步 □返修 □不合格

本件判定：□ 合格　□ 让步接收　□ 返修　□ 不合格　　检验人：________　日期：______　备注：______________

P06　上轴承座（4×M3 贯穿压紧）

来源：reprint-20261018/TMP-FIX-P03P05P06_GREY_016（灰 0.16，不翻：轴承凹口朝上；切片时 Ø38.5 孔内加 Ø34×1.0 支撑阻挡器）

本次问题：上一轮功能检验不过：Ø38.5 孔进支撑、Ø42.3 座面脏，轴承落不到位。

修复/重打：不翻转；阻挡器挡掉孔内支撑，肩环（38.5→42.3，宽 1.9mm）直接桥接。

项 | 检查项 | 判据 / 方法（名义） | 实测 / 记录 | 判定
外观 | Ø38.5 孔无支撑 | 孔内无支撑残留（阻挡器生效的证据）；孔壁光顺 | ________ | □合格 □让步 □返修 □不合格
外观 | 轴承凹口干净 | Ø42.3 凹口面无支撑疤、无瘤；肩环 1.9mm 完整不断裂 | ________ | □合格 □让步 □返修 □不合格
外观 | 耳/brim | 4 耳完整无裂；brim 残边修平 | ________ | □合格 □让步 □返修 □不合格
尺寸 | 凹口内径 | 42.3±0.15；座厚 8.6±0.2 | ________ | □合格 □让步 □返修 □不合格
尺寸 | 4×M3 孔位 | 与 P05 四柱孔距一致，M3 能空穿 | ________ | □合格 □让步 □返修 □不合格
配合 | 6806 试座 | 同 P05 判据：紧修塑料、松加垫片；轴承端面贴住凹口底 | ________ | □合格 □让步 □返修 □不合格
配合 | 压紧检查 | 与 P05 对合锁 M3×55–60 后，轴承外圈被压住、内圈随轴转不别劲 | ________ | □合格 □让步 □返修 □不合格

本件判定：□ 合格　□ 让步接收　□ 返修　□ 不合格　　检验人：________　日期：______　备注：______________

P15　MG90S 舵机可调耳架（±2mm 张紧槽）

来源：TMP-FIX-P15B_BLACK_016（黑 0.16，出线卡滞返修重打）

本次问题：返修轮 2：出线从端面出来一翻就楔进架孔（上下全通导孔）拔不出来；M3 螺尖顶线。

修复/重打：P15B：导孔改带 1mm 孔底 U 槽（只从上口进螺钉）；M3 导孔改盲孔，用 M3×6。口袋 23.6×13.7 不变。

项 | 检查项 | 判据 / 方法（名义） | 实测 / 记录 | 判定
外观 | 无翘曲 | 底面平放不晃；口袋四壁垂直无鼓包 | ________ | □合格 □让步 □返修 □不合格
外观 | 张紧槽完整 | ±2mm 调节槽通透，无缺料 | ________ | □合格 □让步 □返修 □不合格
外观 | U 槽孔底 | 导孔孔底是实底（1mm），没被钻穿成通孔 | ________ | □合格 □让步 □返修 □不合格
尺寸 | 口袋宽 | 13.7±0.2（12.5+1.2） | ________ | □合格 □让步 □返修 □不合格
尺寸 | 口袋长 | 23.6±0.2（22.4+1.2，含出线凸台侧余量） | ________ | □合格 □让步 □返修 □不合格
配合 | MG90S 装入 | 从出线侧斜入能滑进口袋，手压到位；不需砂纸修、不许强压 | ________ | □合格 □让步 □返修 □不合格
配合 | 出线凸台 | 凸台侧不顶壁，出线口顺畅不折线 | ________ | □合格 □让步 □返修 □不合格
配合 | 出线不卡架孔 | 线从端面出来自然下垂走掉；**翻上去要滑开、不进架孔**（重点项）；线不在导孔里拔不出来 | ________ | □合格 □让步 □返修 □不合格
配合 | 螺尖不顶线 | M3×6 从杯底锁入，尖端不冒出盘面（手指摸不到） | ________ | □合格 □让步 □返修 □不合格
配合 | 耳孔对架孔 | 耳距 27.7 对上；M2 螺钉穿耳孔入 U 槽（导孔 Ø1.8）能咬合 | ________ | □合格 □让步 □返修 □不合格
配合 | 张紧功能 | 装到 P04 轴系上，±2mm 槽内能张紧 GT2 带；锁紧后舵机不转、不松 | ________ | □合格 □让步 □返修 □不合格

本件判定：□ 合格　□ 让步接收　□ 返修　□ 不合格　　检验人：________　日期：______　备注：______________

P17　MAX98357A 功放低托盘

来源：TMP-FIX-P15P17P26P29_BLACK_016（黑 0.16，FITFIX 重打）

本次问题：上一轮：板无预留安装位（仅 3mm 深口袋+2mm 围边），排针侧顶围边，板无法贴平固定。

修复/重打：FITFIX：补 2 根 M2 安装柱（Ø4.5/导孔 Ø1.7，柱距 12.6），柱体与托盘融合为一体。

项 | 检查项 | 判据 / 方法（名义） | 实测 / 记录 | 判定
外观 | 安装柱完好 | 两柱不松动、与托盘连为一体（轻掰不脱）；柱顶平整 | ________ | □合格 □让步 □返修 □不合格
外观 | M2 导孔通 | Ø1.7 导孔不堵，M2 螺钉能咬入 | ________ | □合格 □让步 □返修 □不合格
外观 | 托盘底平 | 底面平放不晃；围边无缺 | ________ | □合格 □让步 □返修 □不合格
尺寸 | 柱距 | 12.6±0.2（外缘距−柱径核算） | ________ | □合格 □让步 □返修 □不合格
尺寸 | 口袋 | 约 18.3×19.7（板 17.7×19.1 +0.6）；口袋深≥3 | ________ | □合格 □让步 □返修 □不合格
配合 | 板试装 | MAX98357A 落在两柱上，板贴平不翘；排针侧不顶围边 | ________ | □合格 □让步 □返修 □不合格
配合 | M2×4 手拧 | 螺钉手拧入柱 3–4 牙即咬合；不滑牙、不撑裂柱 | ________ | □合格 □让步 □返修 □不合格
配合 | 稳固性 | 装板后手推不晃不响；焊点/背面元件不与托盘相碰 | ________ | □合格 □让步 □返修 □不合格

本件判定：□ 合格　□ 让步接收　□ 返修　□ 不合格　　检验人：________　日期：______　备注：______________

P18T　USB-C 5V 输入板容差托架（P18 容差版）

来源：TMP-P18T_BLACK_020 / TMP-BNIGHT2-BLACK_012（黑 0.20/0.12；⚠ 无建模源件，CANDIDATE_NOT_RELEASED）

本次问题：P18 原托架按未选型 SKU 建模，实物板装不上；出容差版 P18T 解除阻塞，容差窗口径未经实物验证。

修复/重打：本件为容差版：以实购 USB-C 板实物为准做试装，实测值回填 MEASUREMENTS.csv 的 USB_C_POWER_BOARD 行。

项 | 检查项 | 判据 / 方法（名义） | 实测 / 记录 | 判定
外观 | 无翘曲开裂 | 四壁垂直、无裂纹；落位面平 | ________ | □合格 □让步 □返修 □不合格
尺寸 | 外形 | 32.0×24.0×14.4±0.3 | ________ | □合格 □让步 □返修 □不合格
配合 | 板落位 | 实购 USB-C 5V 板（≤20×15、含母座厚≤6）能放进容差窗，手压到底不强装 | ________ | □合格 □让步 □返修 □不合格
配合 | 口对口 | USB-C 母座对 P01 后壁开口（11.5×7）居中，插头能插拔 | ________ | □合格 □让步 □返修 □不合格
配合 | 插拔空间 | 插线后头内留调试空间约 10mm，线不顶轴、不别弯 | ________ | □合格 □让步 □返修 □不合格
配合 | 固定 | 板放好后不脱出；如松，记录实测并垫泡棉/点胶（不承力处） | ________ | □合格 □让步 □返修 □不合格

本件判定：□ 合格　□ 让步接收　□ 返修　□ 不合格　　检验人：________　日期：______　备注：______________

P26　摄像头 8×8 托架（贴 P24 面板背面）

来源：TMP-FIX-P15P17P26P29_BLACK_016（黑 0.16，FITFIX 重打）

本次问题：上一轮：镜头放不进（镜管 Ø4.6、腔深 5.4，真实镜头凸台更大）。

修复/重打：FITFIX：镜管改 Ø6.5 打穿全深、模组腔+1.2。

项 | 检查项 | 判据 / 方法（名义） | 实测 / 记录 | 判定
外观 | 镜管通透 | Ø6.5 镜管对光看全通，无粘连、无毛刺挡光 | ________ | □合格 □让步 □返修 □不合格
外观 | 方孔=出线口 | 背后 6×10×8 方孔是 CAMERA_FPC_EXIT（FPC 出线口，非缺陷），孔口无毛刺 | ________ | □合格 □让步 □返修 □不合格
外观 | 无翘曲 | 贴合面平；卡爪/槽完整 | ________ | □合格 □让步 □返修 □不合格
尺寸 | 镜管内径 | 6.5±0.15 | ________ | □合格 □让步 □返修 □不合格
尺寸 | 模组腔 | 8×8 模组腔+1.2（约 9.2 宽），深≥4+凸台让位 | ________ | □合格 □让步 □返修 □不合格
配合 | 镜头试装 | 镜头凸台能进 Ø6.5 镜管到底，模组面贴住托架面；不晃不转 | ________ | □合格 □让步 □返修 □不合格
配合 | FPC 出线 | FPC 从方孔走出不折死、不被压；14mm 线长够用（不足即报，禁裁） | ________ | □合格 □让步 □返修 □不合格
配合 | 对 P24 干装 | 托架贴 P24 背面，镜头中心对窗（窗上沿+17）；对不上记录偏差，P24 孔位另行画线 | ________ | □合格 □让步 □返修 □不合格

本件判定：□ 合格　□ 让步接收　□ 返修　□ 不合格　　检验人：________　日期：______　备注：______________

P28　隐私滑片（开位 x=11+，随 P27 导轨返修）

来源：TMP-FIX-P27P28_BLACK_016（黑 0.16 合盘：P27 导轨+P28 滑片；10mm brim、无支撑）

本次问题：上一轮滑片会掉：P27 导轨前挡墙只有 0.2mm 打不出来，滑片前向无限位；滑片在 1.4 深敞口里 Y 向窜 0.6。

修复/重打：挡墙 0.8（导轨 1.6→2.0）；滑槽 1.2 深（0.2/边）；拨片 1.6→2.2 穿出挡墙 1.0。

项 | 检查项 | 判据 / 方法（名义） | 实测 / 记录 | 判定
外观 | 挡墙完整 | P27 前挡墙 0.8mm 连续不是膜；拨槽窗 14×3.2 干净无瘤 | ________ | □合格 □让步 □返修 □不合格
外观 | 薄片平整 | 10×8×2.8 无翘曲、无分层；端部瘤/brim 残边修平，不刮 P27 槽 | ________ | □合格 □让步 □返修 □不合格
尺寸 | 外形 | 滑片 10.0×8.0×2.8±0.15；导轨 42×12×2.0±0.15 | ________ | □合格 □让步 □返修 □不合格
尺寸 | 滑槽 | P27 槽深 1.2、槽宽（Z）8.4±0.1 | ________ | □合格 □让步 □返修 □不合格
配合 | 滑槽试装 | 滑片进槽手推滑动顺畅不卡；关 0 ↔ 开 11 全程不脱轨 | ________ | □合格 □让步 □返修 □不合格
配合 | 限位（重点） | 滑片前后都拉不出来：前有 0.8 挡墙、装到面板后面被面板封住；甩不掉 | ________ | □合格 □让步 □返修 □不合格
配合 | 隐私功能 | 关闭位盖住摄像头孔；拨到开位（x=11+）不挡镜头视野 | ________ | □合格 □让步 □返修 □不合格
配合 | 挂孔 | P27 2×M2 挂孔对 FACE_PRIV_BOSS（x=−10/26） | ________ | □合格 □让步 □返修 □不合格

本件判定：□ 合格　□ 让步接收　□ 返修　□ 不合格　　检验人：________　日期：______　备注：______________

P29　核心板竖直边缘托架（固定于 P23 头底）

来源：TMP-FIX-P29B_BLACK_016（黑 0.16，耳槽咬边返修重打；5-10mm brim）

本次问题：返修轮 2：仍插不稳/松垮——根因是耳槽内口距板边 0.9mm 根本没咬住板边，只有底部 10mm 插座定位；槽宽也偏旷。

修复/重打：耳槽内移咬住板边（板外缘 0.6mm 入槽）；底槽 28.5×1.7、耳槽 Y 1.7（旷 0.05/边）。

项 | 检查项 | 判据 / 方法（名义） | 实测 / 记录 | 判定
外观 | 槽口完整 | 耳槽 0.7 缝通透不糊死；底槽无缺料、无毛刺；底托/柱无裂 | ________ | □合格 □让步 □返修 □不合格
外观 | 无翘曲 | 底面平放不晃；brim 残边修平 | ________ | □合格 □让步 □返修 □不合格
尺寸 | 槽宽（Y） | 1.7±0.05（1.6 板 +0.1） | ________ | □合格 □让步 □返修 □不合格
尺寸 | 底槽宽（X） | 28.5±0.1（28.3 板 +0.2） | ________ | □合格 □让步 □返修 □不合格
尺寸 | 高度/孔距 | 高 46.1±0.3；2×M3 孔距对 P23 头底柱 | ________ | □合格 □让步 □返修 □不合格
配合 | 板边入耳槽 | 插到底后两侧板边都进耳槽（咬进约 0.6mm），不是只靠底槽；对光看槽口贴板边 | ________ | □合格 □让步 □返修 □不合格
配合 | 核心板试插 | 板插到底不晃、不转；手推边缘全高不松垮不咔哒；拔出有轻微摩擦感 | ________ | □合格 □让步 □返修 □不合格
配合 | M3 固定 | 2×M3 对 P23 头底柱能穿入锁紧；锁后板垂直不歪 | ________ | □合格 □让步 □返修 □不合格

本件判定：□ 合格　□ 让步接收　□ 返修　□ 不合格　　检验人：________　日期：______　备注：______________

三、处置纪律

· 每项勾「合格 / 让步 / 返修 / 不合格」之一；实测栏写数字（mm），不写「差不多」。

· 实测值回填仓库 MEASUREMENTS.csv 对应行（P15_SERVO_POCKET / P17_AMP_POST_PITCH / P26_LENS_TUBE / P29_CORE_SLOT 等），状态改 MEASURED_UNFITTED。

· 配合处理铁律：紧的修塑料（砂纸/旋转锉/钻头），松的加垫片/生料带/点 CA；禁敲轴承、禁扩轴承座孔、禁强压强拧、禁裁 FPC。

· P03 顶丝孔、P05/P06 轴承座、P26 镜管、P29 槽为功能面，修配只动塑料件本身，不动对偶金属/板卡件。

· 判「返修」的件在备注写修法与修后复测值；复测通过前不得进总装。

检验人（签字）：______________　　复核：______________　　日期：2026-10-____
