eleanor-wsyy/EffMeet2/hardware/robot-design/round-yaw-v2/revision-20261011-nomi-layoutA/print-split-v6/EffMeet2-零件编号对照表-20261018.pdf

EffMeet2 v6 · 零件编号对照表 · 2026-10-18 | 第 1 页

# EffMeet2 v6 · 零件编号 × 照片对照表

2026-10-18 · 26 个编号 / 31 件（P07×4、P30×2、P32×2；P21/P22 已作废，不列）

已到 = 已到手 待补 = 见安装手册 §0.6 — = 无替代

标号 | 样子 | 名称 | 色 | 状态 / 来源（10-18 实况） | 缺件时替代
P01 | | 底座杯体（后容差窗/声孔/壁袋环*） | 灰 | 已到 G2NIGHT（v6r3，后 USB-C 窗） | —
P02 | | 底座上盖+限位块 | 灰 | 待补 G3p 接缝裂 → 见 §0.6 | 上半做座 + 胶接；泡棉临时挡
P03 | | 从动 64T 带轮 | 黑 | 已到 NIGHT（紧定孔先通毛刺） | —
P04 | | 舵机主动 32T 带轮 | 灰 | 已到 INTERN2（10-18 实况） | 手转演示（不联带）
P05 | | 承力塔+下轴承座 | 灰 | 已到 SAFE | —

EffMeet2 v6 · 零件编号对照表 · 2026-10-18 | 第 2 页
标号 | 样子 | 名称 | 色 | 状态 / 来源（10-18 实况） | 缺件时替代
P06 | | 上轴承座 | 灰 | 已到 SAFE | —
P07 | | 轴承层间支柱 ×4 | 灰 | 已到 THINP25（干净管） | —
P11 | | 空心承力轴 | 灰 | 已到 G2NIGHT 重打 | —
P12 | | 下止推夹环（开口） | 灰 | 已到 SAFE | —
P13 | | 限位摆臂 | 灰 | 已到 SAFE（装 P03 下方 D 平面） | —
P14 | | 短颈+法兰 | 黑 | 已到 BVIS / PETG 替身 | PETG 替身颈

EffMeet2 v6 · 零件编号对照表 · 2026-10-18 | 第 3 页
P15 | MG90S 舵机耳架 | 灰 | 已到 SAFE | —
P16 | 扬声器托架 | 灰 | 已到 THINP25 | —
P17 | 功放慢托盘 | 灰 | 已到 SAFE | —
P18T | USB-C 输入板容差托架 | 灰 | 已到 INTERN2（10-18 实况） | E17 缺→线引到头部
P19 | 停止键帽 | 黑 | 已到 NIGHT | —
P20 | 轻触开关托座 | 灰 | 待补 INTERN2 立柱断 → 见 §0.6 | 底座+开关热熔胶点固

EffMeet2 v6 · 零件编号对照表 · 2026-10-18 | 第 4 页
P23 | 头壳 | 灰 | 已到 G1（v6r2） | —
P24 | Ø106 面板（77×45 四柱） | 黑 | 已到 B1p-v2（v6r2；先量柱距 77） | —
P25 | LCD 后压框 | 灰 | 已到 THINP25（v6r2 77×45） | —
P26 | 摄像头托架 | 灰 | 已到 SAFE | 双面胶贴 P24
P27 | 隐私滑盖导轨 | 黑 | 已到 B1p-v2 | 轨空着
P28 | 隐私滑片 | 黑 | 已到 BVIS（端部瘤，修平） | 轨空着

EffMeet2 v6 · 零件编号对照表 · 2026-10-18 | 第 5 页
P29 | 核心板竖直托架 | 灰 | 已到 SAFE | —
P30 | 线鞍 底座侧/头侧 ×2 | 灰 | 已到 SAFE | —
P32 | 麦克风胶座 ×2 | 灰 | 已到 INTERN2（10-18 实况） | 麦双面胶贴壁对声孔

EffMeet2 v6 · 零件编号对照表 · 2026-10-18 | 第 6 页

## 补打白名单 / 版本陷阱

装前 30 秒：量 P24/P25 四柱距是不是 77（不是 80）；量 P02 中心孔是不是 44。

件 | 不要用 | 用这个
P24 面板 | candidate-stl/P24（旧 80×45） | plates-merged/P24_v6r2_77x45.stl
P25 压框 | candidate-stl/P25（旧 80×45、88mm） | plates-merged/P25_v6r2_77x45.stl
P01 底座 | candidate-stl/P01（v6，无 USB-C 窗） | plates-merged/P01_v6r3_tolerant_usbc.stl
P02 上盖 | candidate-stl/P02（18134 面，未减面） | plates-merged/decimated/P02_decimated.stl
P04 | — | candidate 即 decimated（减面 no-op，4896 面）
P07–P10 / P16 / P11 / P23 | — | candidate 与已打盘一致
P18T / P32 | — | 只在 TMP-INTERN2-DEC / TMP-P18T_BLACK / TMP-MICHOLDER 3MF 内，无独立 STL
P21/P22 | 已作废 | 不打印，麦走 P32

## 今天的两件应急

P02 裂 | 先干装两半对位；从顶板垂直往下钻穿接缝、进下圈壁 4×Ø2，插耗材当定位销；涂环氧夹紧 30min；座面用直尺/砂纸找平。下圈也碎：上半做座 + 3mm 临时环（OD≈147、ID≈44）+ 5mm 泡棉临时挡。
P20 立柱断 | 立柱只是螺钉座；底座 + 开关口袋直接热熔胶点固在杯内壁键位，P19 键帽照装。重打：5mm brim、Z-hop 0.4、最小层时间 8s、风扇 100%、立柱区降速；模型立柱根部加 1.5mm 圆角。
