eleanor-wsyy/EffMeet2/hardware/robot-design/round-yaw-v2/TEST_GUIDE.md

# 在议 圆润转头版 · 测试指南

> **2026-10-11 v4优先补充：** 测试基线改为GOOUU套装／布局A／PLA Matte及[v4工程复核](revision-20261011-nomi-layoutA/ENGINEERING_REVIEW.md)。旧微雪／Korvo和ABS-GF叙述不作为本轮电气／材料依据。新增头颈接收面／D接收、套装2.8屏窗预算／14针真实接线、后部固定板、外接双麦／功放、显示线束／摄像FPC、真实状态引出必须按T04–T17/T23–T25复测；表格和空白记录模板仍全部未实测。

更新：2026-10-10（北京时间；2026-10-21 修链）。与[现行安装手册](revision-20261011-nomi-layoutA/print-split-v6/ASSEMBLY.md)、[当前BOM](BOM.md#final-purchase-decision)、[打印执行手册](revision-20261011-nomi-layoutA/print-split-v6/PLATE-RUNBOOK.md)配套（旧 ASSEMBLY_GUIDE/PRINT_PLAN 仍在库，仅作历史保留，不作现行依据）。**本指南定义待执行测试，不是测试报告。** 当前固件与可打印机构尚未完整落实，未做的测试必须记录为NOT_RUN或BLOCKED；本次文档不升级硬件/制造状态。

## NOMI方向的同步复测

外观改为球头/圆黑面板和内藏短颈后，按[组装接口更新第6节](EXTERIOR_ASSEMBLY_REVISION.md#6-对测试指南的增量要求)复测T04、T05/T06、T12/T14/T15、T07/T08/T17及T24：真矩形屏无遮挡、滑盖有效、内藏边不擦盖/夹线、声孔与装壳表现不退化。26项ID和判定逻辑不变，旧外观测试不能自动沿用。

## 1. 时间有限时按这条顺序

1. **供电前**：T01/T02，确认资料、极性、接线与结构。
2. **裸板/独立模块**：T03–T11；缺固件或对应驱动就停在该项，不装壳掩盖问题。
3. **机构与跨轴线**：T12–T16，先手动/低速/小角度，再三个目标角与50循环。
4. **入壳与整机**：T17–T24，包含授权提醒、实体停止、故障恢复与30分钟运行。
5. **产品音频与交接**：T25/T26。AEC未完成可以注明“仅初样演示”，不能标为完整产品验收。

声卡示例能跑、屏亮、模型能转、网页mock显示completed分别只是局部证据，不自动使整机测试通过。用电脑麦/电脑扬声器完成的路线A软件演示不能填为机内双麦/扬声器通过。

## 2. 统一测试设置

- 给样机编号，记录主板/屏/相机/舵机/轴承实物版本、接线表版本、CAD与打印料/层高、固件来源与提交、软件提交。无真实固件就写“未实现”，不要填README日期冒充版本。
- 台架位于稳定桌面，运动不靠近人手。能随时切断舵机供电；软件停止按钮目前只定义停止播报，不能假设能急停运动。
- 初次带载动作先小角度低速；出现顶挡、跳齿、磨线、冒烟/焦味、异常发热、持续抖动或失控，停止测试、断电排查。不要为了凑50循环强行重复故障。
- 摄像/录音默认用合成文字卡、测试语音或已同意的参与者；原始人声/人像、SSID、凭据、令牌和日志敏感信息不要上传公开仓库。
- 记录角度的是**实际头部**，不是只看舵机PWM。保持供电、桌面、距离与音量一致再比较裸板/入壳、保持/转动。

### 首轮暂定阈值

下表来自本版BOM的样机目标，并补充可执行记录方法；团队可在实物选型后冻结，但不得测试失败后无记录地放宽标准来伪造通过。

| 项目 | 首轮目标 | 记录方法／边界 |
|---|---|---|
| 头角 | 左45°／正向0°／右45°，误差≤3° | 顶视刻度/量角器，记录实角；这是拟定目标，非舵机出厂精度 |
| 转向 | 约1–2s完成一次目标转向 | 视频计时；不靠增速硬顶或用标称空载速度代替 |
| 停止播报 | 暂定≤1s，5次均实际停止 | 播放音频/录像与按钮事件对齐；只测播报，不暗示硬件断麦/运动急停 |
| 重复转向 | 50循环，1循环=左45°→0→右45°→0 | 记录循环数与各故障；是首轮联调，不是寿命测试 |
| 组合运行 | 30min | 定义本轮负载/环境/音量，记录故障、供电和温度；不是长时可靠性认证 |
| 听辨 | 同一约1m位置听5句固定语音 | 写原句、听辨情况和杂响；不自动证明ASR准确率/会议室覆盖 |
| 裸打外观 | 允许均匀细层纹，不接受大支撑疤/毛刺/裂纹/翘边 | 同光照照片＋手感/装配检查；不是注塑质感 |

温度、供电、峰值电流、动态线缆寿命等取各实际器件/线材的允许范围和实测数据；没有根据不编造数值。

## 3. 26项测试用例

| ID | 测试 | 必需性 | 前置条件 | 做法 | 通过条件／证据边界 |
|---|---|---|---|---|---|
| T01 | 到货/版本与接线 | 必需 | 供电前；模块与CAD资料在手 | 逐件核版本、正反面、实测尺寸与接线表；确认导出不是器件代理 | 记录完整；未知针脚/缺安装结构标BLOCKED，不按概念图接线 |
| T02 | 供电与极性 | 必需 | 接线审核；主板和舵机独立电源分路 | 先主板、后舵机单独上电；记录实际供电点电压与异常；正极不并联 | 供电符合实物范围，无异常发热/复位/反接；峰值数据不会测则留空而非编造 |
| T03 | 启动/烧录/日志 | 必需 | 真实固件或已注明来源的板卡示例 | 记录版本和启动日志；断电/上电启动3次；确认来源是项目固件还是示例 | 能重复启动/调试；项目功能未实现的部分不得因示例正常就填PASS |
| T04 | 显示与实际状态 | 必需 | LCD接法、真实驱动及状态事件可用 | 显示检查图/文字/两眼；触发连接、等待确认、播报、停止/错误状态 | 无花屏、窗口不遮挡；状态与真实事件一致；不得用固定动效假装业务状态 |
| T05 | 相机抓拍/共享 | 必需 | 真实相机驱动、确认/原图路径可用 | 同一测试卡片在左45°/正向/右45°各拍1张；在合适视场检查原图及确认共享 | 3张可读原图可定位；无意外共享；水平转头不当作俯拍能力 |
| T06 | 物理滑盖 | 必需 | 相机可获取原图；滑盖已装 | 固定测试卡，滑盖开/关各拍一张，再开；检查镜片和视场 | 关闭时目标不可辨认，开时视场恢复；不把遮镜当断电/断麦 |
| T07 | 机内双麦拾音 | 必需 | 真实机内音频采集，不是电脑麦 | 同一同意参与者约1m处读5条固定短句，记录裸板/入壳及两麦可观测通道 | 机内输入可用、无缺路/严重削波；记录原音；ASR字错与硬件输入分开分析 |
| T08 | 播放清晰度/声腔 | 必需 | 真实机内功放/扬声器，测试语音准备 | 约1m处播放同一5句并听辨；比较裸板/装壳，检查杂响/共振 | 语句可懂，无明显破音/松件杂响；记录使用音量，不以3W推断覆盖距离 |
| T09 | 实体停止播报 | 必需 | 真实播放/停止输入处理已实现 | 播报中按实体按钮，重复5次；同步录屏/音频或事件记录观察停止 | 5次实际出声停止且状态一致；本指南暂定响应≤1s；不是硬件断麦或舵机急停 |
| T10 | 状态灯与异常 | 必需 | 实际灯状态逻辑可用 | 触发连接、等待/播放/停止和掉线；从正常观察位置核灯 | 不会掉线仍报正常；亮度可见不刺眼，功能与团队冻结状态表一致 |
| T11 | 舵机空载/信号 | 必需 | 供电/信号已核；无带/无头，安全断电可及 | 用小步低速控制实物，测允许范围和中位，观察保持/复位 | 无未知方向/过行程；记录真实命令映射与额定范围；不默认180° |
| T12 | 轴承/安装静态 | 必需 | 断电、带未接或约束已解除 | 检查轴承保持/轴肩/连接盘、起子访问；不强拧舵机；轻转可自由件 | 承重链完整、无明显松旷卡滞/裂纹；头重量不只压舵机轴 |
| T13 | 头角标定 | 必需 | 中位已定、传动已装、线暂不干涉 | 用顶部纸刻度/量角器或固定顶视画面测头角，记录命令↔实角 | 得到实测映射；首轮暂定三个目标头角误差≤3°；不会把舵机命令当头角 |
| T14 | 低速带载三姿态 | 必需 | 真实头部载荷、安全限位和断电已准备 | 先小幅、再逐步扩大至左45°/0/右45°；观察间隙、晃动、声音 | 目标可到达、无顶挡/夹线/跳齿/结构损伤；首轮转向约1–2s目标，需实际测量 |
| T15 | 活动FPC与50次转向 | 必需 | T04/T05/T14通过；开盖可观察 | 左45°→0→右45°→0记1循环，做50循环；保持可观察显示并抓拍检查 | 50循环无断屏/花屏/相机掉线/复位/磨夹线；这不是动态线束寿命认证 |
| T16 | 机械噪声影响 | 必需 | 机内录音与真实动作可用 | 同位置录保持、转动、同一人声；与舵机断电基线比较 | 无影响听辨/采集的啸叫或撞击；保存可比较记录，不声称分贝或NOMI等效 |
| T17 | 入壳后模块复测 | 必需 | 基本模块通过，最终盖/软片/足垫已装 | 关闭外壳后复测T04–T10和三姿态，检查Wi-Fi/USB维护访问 | 盖不会挤线/屏、堵麦/声孔或使模块失效；裸板PASS不代替此项 |
| T18 | 本人确认后才提醒 | 必需 | 真实控制器/确认/设备链路均可用 | 建合成测试会议：未确认时观察无提醒，再由观点本人确认，核实际播报 | 未确认不播报，获允许后内容一致；参与身份和消息可追溯，无真实隐私数据 |
| T19 | 真实播放回执 | 必需 | 真实驱动和项目回执协议可用 | 对齐命令时间、现场音频与started/completed/failed（按实际契约） | queued/accepted不算出声；完成由实际驱动/排空报告，失败不写成completed |
| T20 | 重复/过期/重启防重播 | 必需 | 控制器去重/过期机制、真实设备可用 | 同ID重试；测过期候选；设备重启后观察旧提醒是否再次执行 | 同一次授权不重复实播；过期不执行；不靠删除账本绕过，具体按契约 |
| T21 | 断网与恢复 | 必需 | 完整设备/服务链路，安全可恢复网络 | 临时断设备Wi-Fi并恢复；观察灯/屏/日志与旧提醒处理 | 掉线真实可见；恢复不自动重复旧提醒；未完成的播报按真实规则报告 |
| T22 | 断电/上电恢复 | 必需 | 所有运动先停，已确认开机动作规则 | 记录正向后停止运动，按规断电再上电；观察启动朝向/旧提醒 | 无不受控冲向硬挡/拉线，旧提醒不自动重播；这不是断电中暴力冲击测试 |
| T23 | 30分钟组合运行/供电温升 | 必需 | 整机与业务基本通过，有同意测试人员 | 显示/联网/录音持续，间歇播放和转头共30分钟；记环境/起止温度和故障 | 无复位/断连/异常气味或破损；温度低于各实物允许值；无统一未经依据的安全温度 |
| T24 | 外观/桌面稳定/可维护 | 必需 | 最终组装和常用桌面 | 检查细层纹/大疤/毛刺，三姿态底座滑移；断电后拆盖复装1次 | 无大疤/裂纹/翘边、明显滑移/倾覆风险；可拆且不伤线；细层纹允许 |
| T25 | AEC与双讲 | 产品目标必需；初样不可用则BLOCKED | 机内播放参考、真实AFE/AEC、双麦录音可用 | 分别录只有机器人播报、只有人声、播报与人声同时；使用合成内容 | 保留原始输入/输出、参考配置与结论；暂停采集/电脑麦不能当AEC；未实现不得勾PASS |
| T26 | 测试记录/版本交接 | 必需 | 本轮所有记录可汇总 | 填CSV、接线和标定、硬件/CAD/固件版本、失败修复与重测 | 每项有实际结果及证据；BLOCKED/FAIL保留，不能以全部“计划”宣称验收完成 |

## 4. 状态怎么填

- **NOT_RUN**：有方案，但尚未执行。模板默认全部此状态。
- **BLOCKED**：缺实物、固件、接线、CAD或其他前置条件；写阻塞原因和下一步。
- **FAIL**：已执行但不满足目标，保留失败证据、修复动作和复测。
- **PASS**：实际执行且符合该项条件，注明版本/结果/证据；不是根据文档或模拟推断。
- **N/A**：本轮经确认不适用，只用于确实无此功能的条件件；必需测试不能用N/A消除。未做AEC是BLOCKED，不是N/A。

“整体通过”至少要求本轮定义的全部必需项实际PASS；初样只有部分测试通过时，对外只报告范围，例如“已通过显示/摄像/三姿态，AEC和业务回执仍BLOCKED”。不得把NOT_RUN、BLOCKED或FAIL改成绿色状态以形成完整演示。

## 5. 最少记录和文件

复制[TEST_RECORD_TEMPLATE.csv](TEST_RECORD_TEMPLATE.csv)到同目录local-only/test-records，命名为TEST_RECORD_样机编号_日期.csv后填写；保留原模板的NOT_RUN状态不改。一行对应一个测试ID，保留26项；重复修复需要多次记录时复制该行并递增attempt，不覆盖失败历史。CSV没有公式，可直接用表格软件打开。

表头包含：样机/版本、执行人和时间、前置/实际结果、状态、证据位置、问题、修复与重测。证据可以是本地受控目录路径或已脱敏的公开记录，模板不含真实隐私数据。不要只写“OK”，要能定位“哪版、哪步骤、看到了什么”。

头角标定另记：

| 目标头角 | 实际控制命令／单位 | 实测头角 | 接近方向／传动比 | 是否PASS |
|---|---|---|---|---|
| -45° | 待实测 | 待实测 | 待实测 | NOT_RUN |
| 0° | 待实测 | 待实测 | 待实测 | NOT_RUN |
| +45° | 待实测 | 待实测 | 待实测 | NOT_RUN |

记录实际出声时间、停止时间、掉线/重启与驱动回执时，使用能对齐的同一测试时间源/录像，或明确不同设备时钟偏差。HTTP成功/命令排队不单独证明真实设备动作。

## 6. 常见问题先排哪里

| 现象 | 先停止/检查 | 不要采取的捷径 |
|---|---|---|
| 转头时主板复位 | 停舵机；查独立供电/共地、板端压降、日志与线接触 | 增加电压或把两路5V正极并联 |
| 屏花/相机断帧 | 断电查接口方向/锁扣；短线基线与跨轴线对比 | 拔插带电FPC、盲加长或只凭同针数换线 |
| 舵机保持啸叫/抖动 | 解除负载安全排查；供电、齿隙/带张紧、标定与机械卡滞 | 用泡棉封死壳体掩盖噪声；把金属齿当静音保证 |
| 头壳动但底座也转/滑 | 停动作；查固定架、脚垫、重心、线束拉扯 | 先塞未固定配重或提高驱动力硬转 |
| 录音差/播放回声 | 对比裸板/入壳声孔、密封、参考与真实AFE配置 | 用电脑麦替代却写硬件通过，或将暂停采集当AEC |
| 按键盖上后失效 | 断电检查帽/开口行程、是否常压与输入日志 | 强压盖板、把按钮直接接未知GPIO |
| 透光/屏窗不清楚 | 查框是否压/挡有效区、屏自身亮度与表面保护状态 | 临时加不透明黑板或把打印透明件当光学玻璃 |
| 整机未完成但演示赶时间 | 明确只演示已验证范围，保留BLOCKED项 | 让fake/mock回执冒充机内播报/转头完成 |

## 7. 交付给队友/AI的结论模板

```text
样机：____；日期/执行人：____
主板/屏/摄像/舵机版本：____
CAD/打印/接线/固件/软件版本：____
本轮实际PASS：____
FAIL与证据：____
BLOCKED与前置缺口：____
50循环与30分钟实际结果：____
当前可演示范围：____
仍不得宣称的能力：____
下一个负责接口/最小动作：____
```

本指南不修改项目业务契约；真实回执/确认/去重规则及最新模块实现以[项目契约入口](../../../contracts/v1/README.md)和[软件交接（已归档）](../../../docs/archive/handoff/2026-10-05-final-handoff.md)为准。旧软件交接仅代表当日状态，不当作今日测试结果。接线基础官方资料见安装指南。
