eleanor-wsyy/EffMeet2/hardware/robot-design/round-yaw-v2/revision-20261011-nomi-layoutA/print-split-v5/ASSEMBLY.md

# ⛔ 本指南已作废（2026-10-16）

v5 拆件线整体退役。**唯一有效安装手册：[../print-split-v6/ASSEMBLY.md](../print-split-v6/ASSEMBLY.md)（v2 图鉴版）**。

历史内容见 git 记录。
