eleanor-wsyy/EffMeet2/hardware/robot-design/round-yaw-v2/revision-20261011-nomi-layoutA/print-split-v5/PLATE-RUNBOOK.md

# v5 打印执行手册 · 盘 × 机器 × 特殊设置

> ## ⛔ 本手册已作废（2026-10-13 起），仅作历史留档，不要照此打印
>
> - **唯一有效执行手册＝ [v6 PLATE-RUNBOOK.md](../print-split-v6/PLATE-RUNBOOK.md)**（含 §2 全局切片设置与 §6 盘登记总表）。
> - v5 的 G1 头壳／G2 杯体**已停打作废**（用户决定）；v5 不再打印，件表/尺寸/盘均不可用。
> - ⚠️ **本手册第 117 行「墙层数 = 6」是过期下毒源**：2026-10-16 实测证明墙层数设得比几何能容纳的圈数大**不会丢层**（生成器只是不生成多余圈），且 `6×0.42=2.52` 只算了单侧墙、对环形/双侧壁不成立。现行口径＝**墙层数 4 ＋ 墙生成器 Arachne ＋ 检查薄壁开 ＋ 支撑「仅在打印板生成」**，见 v6 PLATE-RUNBOOK §2 与 [PRINT-LESSONS 教训22 更正/教训30](../print-split-v6/PRINT-LESSONS.md)。
> - 小件缺特征/圆孔打不出来 → 走 [v6 SLICE-CARD.md](../print-split-v6/SLICE-CARD.md)。
>
> 以下原文按 AGENTS.md「保留原始来源及更正记录」原样保留，**不代表当前规格**。

---

> **文件性质：执行口径，不是切片结果。** 2026-10-12 由 A 位起草。
> 建模方交付的是**几何 + 盘起点**；**切片、机型、材料、支撑、最终朝向**由打印方在此手册下执行。
> 件表真源：[PARTS.csv](PARTS.csv) · 打印顺序：[PRINTING.md](PRINTING.md) · 尺寸真源：[../../parameters.json](../../parameters.json)

---

## 0. 当前状态（2026-10-12）

| 盘 | 状态 |
|---|---|
| **G1-1 头壳** | 🖨 **已上机**（学校 **H2S**，层高 0.16，Brim 仅外侧 5mm） |
| **G2-1 杯体** | 🖨 **已上机**（学校 **H2D**，层高 0.20） |
| 其余 4 盘 + 样片 | 待打 |

---

## 1. 盘表：盘 × 件数 × 颜色 × **推荐机器**

| 盘 | 件数 | 颜色 | 内容 | **推荐机器** | 理由 |
|---|---|---|---|---|---|
| **G1-1** | 1 | 灰 | 头壳 150×128×130 | **学校 H2S** 首选 | 体积余量最大（340×320×340）；A1 也能整件打（余 106mm）但从盘并行更省时 |
| **G2-1** | 1 | 灰 | 杯体 180×164×64 | **学校 H2S / H2D** | 同上（A1 余 76mm） |
| **G3-1** | 1 | 灰 | 上盖 171×156×17 | **自有 A1** | 扁平小快件 3–4h，**不值得占学校机时** |
| **B1-1** | 7 | 黑 | 面板/短颈/滑盖×3/键帽/键座 | **自有 A1** | 小件需迭代；⚠️ **必须黑料**（外露可见） |
| **B2-1** | 14 | 黑 | 承力塔/轴承座×4/隔柱×4/空心轴/夹环/带轮×2/舵机架 | **自有 A1** | 小件；**可用灰料**（壳内不可见） |
| **B3-1** | 17 | 黑 | LCD框×2/相机架×2/主板架×2/麦架×4/托盘×3/扬声器×2/线束鞍×2 | **自有 A1** | 同上 |
| **S1** | 8 | PETG | 接口样片 | **自有 A1** | 打废立刻重来 |
| **S2** | 9 | 正式料 | 同接口复测 + P02 | **自有 A1** | 同上 |
| **A0** | 1 | 灰 | 外观样片 | **自有 A1** | 纯外观判据 |

**关键前提**：6 个 3MF 全部按 **256×256** 排盘 → **A1 / P2S / H2S / H2D 都能直接打**，只需在切片器里改机型。
**学校机器的价值 = 体积余量 + CoreXY 稳定 + 并行**，不是"只有它能打"。

### 分配原则

1. **大件、耗时件 → 学校**（并行出齐；A1 打它们最慢）
2. **小件、需迭代件 → 自有 A1**（打废即时重来）
3. **外露件必须黑料；壳内件急用时可用灰料**（颜色不影响尺寸）

---

## 2. 每盘特殊设置

### G1-1 头壳（灰 · 外观件）

| 项 | 值 | 为什么 |
|---|---|---|
| 层高 | **0.16** | 球面，层纹最显眼，是产品的脸 |
| **Brim** | **仅外侧 5mm（必须）** | ⚠️ **前圈朝下 = 接触面只有个环**，不开会中途掉件 |
| 支撑 | **开**（树状） | 内底/接收座局部 |
| ⚠️ 特别 | **支撑在内腔** → 确认能从**前圆口**伸进去掏，**不封死开口** | |

### G2-1 杯体（灰）

| 项 | 值 | 为什么 |
|---|---|---|
| 层高 | **0.20** | 侧面基本竖直，层纹本就整齐 |
| Brim | 可选（建议 3–5mm） | 底面 180×164 整面，稳 |
| 支撑 | **开**（树状） | 深柱/声学通道 |
| ⚠️ 特别 | 确认支撑能顺杯口掏出，**不堵声孔** | |

### G3-1 上盖（灰 · 外观件）

| 项 | 值 | 为什么 |
|---|---|---|
| 层高 | **0.16** | 外露件 |
| Brim | **建议开 5mm** | 171×156 扁平件防翘 |
| 支撑 | **开**（树状） | 中心悬空 + 螺钉柱局部 |
| ⚠️ 特别 | **接缝圈朝下 = 装配面** → 别让支撑破坏接缝圈 | |

### B1-1 外露 7 件（黑 · **必须黑料**）

| 项 | 值 |
|---|---|
| 层高 | **0.16**（外观/滑盖件） |
| 支撑 | 开（树状），阈值 30–45° |
| ⚠️ | **必须黑 PLA Matte** —— 面板/短颈/滑盖/键帽全部外露 |
| ⚠️ 逐件朝向 | P02 面朝平台（支撑落背面 ✅）· P20 导槽向上 · P21 拨片悬挑局部支撑 · P22 平面朝平台 |
| ⚠️ | P20 与 P21 **不得融合**（滑盖要能滑动） |

### B2-1 机构 14 件（黑 · 可用灰料）

| 项 | 值 |
|---|---|
| 层高 | **0.20** |
| 支撑 | P11–P14 通常无支撑（通孔轴竖直）· P06 脚面朝下 · P19 耳台悬挑局部 |
| ⚠️ **P07–P10 轴承座** | **必须比较两种朝向**：`分缝朝平台`（当前起点）vs `轴向竖直` —— 看**孔形 / 受力层向 / 支撑**三者，**不按一句"水平就圆"放行** |
| ⚠️ P15 空心轴 | 必须扭转/轴肩样片验证 |
| ⚠️ P17/P18 带轮 | 齿槽/舵盘口袋须**用真带样片**验 |

### B3-1 支架 17 件（黑 · 可用灰料）

| 项 | 值 |
|---|---|
| 层高 | **0.20** |
| ⚠️ **逐件朝向差异大** | **躺着 [90,0,0]**：P23/P24/P25/P26/P30/P32/P34/P38/P39<br>**立着 [0,0,0]**：其余 |
| ⚠️ P31/P33 声管 | 内孔局部支撑 → **别堵拾音口** |
| ⚠️ P40/P41 线束鞍 | 束带绕槽，**禁止扎紧 FPC** |
| ⚠️ | 本盘依赖未测尺寸：P23/P24←屏 · P29/P30←板 · P31–P34←麦 · P35–P37←模组 |

### 样片

| 件 | 层高 | 支撑 |
|---|---|---|
| **A0 外观样片** | 0.20（可另跑 0.16 对比） | **必须开**（45° 悬臂） |
| 01–04 公差阶梯 | 0.20 | 不需要 |
| S1 PETG 七件 | 0.20 | 按件表 |

---

## 3. 全局切片设置（所有盘通用）

| # | 位置 | **Bambu Studio 默认** | **改成** | 理由 |
|---|---|---|---|---|
| 1 | 强度 → 墙层数 | **2** | **6** | 名义壁厚 2.4mm ÷ 0.4 喷嘴 = 6 → 壁才是实心；2 圈会透光 + 内部纹路透到表面（鬼影） |
| 2 | 强度 → 稀疏填充图案 | **Grid** | **Gyroid** | Grid 交叉点重复挤出，大件喷嘴会刮擦填充面 |
| 3 | 强度 → 稀疏填充密度 | 15% | **不动** | 官方建议大件保持 15% |
| 4 | 支撑 → 启用 + 类型 | **关** | **开 + 树状 Tree** | 树状好拆、痕浅、省料 |
| 4b | 支撑 → 支撑外墙数 | 1 | **2** | 1 层墙太脆易断 |
| 4c | 支撑 → 顶面 Z 距离 | 0.2 | **0.25–0.3** | 更好拆 |
| 5 | 其他 → Brim 类型/宽度 | **自动** | **仅外侧 / 5mm** | 防大件翘边 |
| 6 | 耗材 → 热床温度 | 官方 | **60–65℃** | 防翘 |
| — | 质量 → 层高 | 0.20 | 外观 **0.16** / 机构 **0.20** | |
| — | 质量 → **首层层高** | 0.2 | **不动** | 首层要厚才粘得牢、容错平台不平 |
| — | 质量 → 接缝位置 | 随机 | **对齐** | 别用随机（满壳麻点）；斜拼接缝保持开启 |
| — | **腔温** | 自动 | **盯 <40℃**，超了手动拉前门缝 | H2 系列自动顶窗+排风联动，官方 PLA 腔温默认 0℃ |

**没列的都是不动的**——喷嘴温度/速度/风扇全按官方 PLA Matte 预设走。

### 机器相关

| 机器 | 注意 |
|---|---|
| **A1** | 无腔温，PLA 正合适；体积 256³，6 个盘都放得下 |
| **P2S / H2S / H2D** | 盘按 256 排的，改机型不会超界；**不用手动开门**（自动管理），但**广州室温 30℃ 上下要盯腔温** |

---

## 4. 逐件朝向与支撑起点

见 [PARTS.csv](PARTS.csv) 的 `orientation_euler_deg` 与 `support_start` 两列（41 行全表）。

**起点不是最终朝向** —— 用 Bambu Studio / OrcaSlicer 打开后**逐件复核**，把 `final_orientation` / `support` / 机器配置 / 样片证据回填到 [SLICER_CHECKLIST.csv](SLICER_CHECKLIST.csv)。**没有证据的字段保持空。**

---

## 5. 待测项（影响本手册的部分）

见 [MEASUREMENTS.csv](MEASUREMENTS.csv)，16 项**全部 UNVERIFIED**。

**最影响打盘的**：
- **LCD 玻璃/PCB/厚度/J2** → 影响 P23/P24 框 + P02 面板窗
- **核心板四孔/元件高/Type-C 凸出** → 影响 P29/P30 托架
- **6806 实测公差** → 影响 P07–P10 轴承座夹紧量
- **MG90S 耳孔/舵盘** → 影响 P19 舵机架 + P17/P18 带轮

**回填流程**：实测 → 填 `parameters.json` → 更新源 → 重建模型与证据 → 再决定是否重打受影响件。**不用旧报告给改动后的件背书。**

---

## 6. 未完成

真实切片 / 真实打印 / 机械载荷 / FPC 50 循环 / 温升 / 整机功能**均未执行**。
26 项测试模板保持 `NOT_RUN`；`stage=reversible_blockout`，三个放行布尔值全 `false`。
