eleanor-wsyy/EffMeet2/hardware/robot-design/round-yaw-v2/revision-20261011-nomi-layoutA/print-split-v5/PRINTING.md

> **当前分工：本轮只交独立STL及候选模型；实际切片、排盘和机型参数由用户在Bambu Studio处理。本目录3MF是已生成的几何起点附件，不是切片结果，不再由建模方调整。**

# v5 打印候选交付说明

件表：[PARTS.md](PARTS.md) / [PARTS.csv](PARTS.csv)。几何预排：[plate-start-layouts.json](plate-start-layouts.json)。3MF文件名都含UNSLICED_START；STL都含UNVERIFIED。

## 顺序与材料

- 可先复用队友的A0外观样片；配合首先跑ASSEMBLY.md的S1 PETG真实接口件样片；随后跑S2正式黑PLA Matte复测。不是一张盘固定的8件/9件保证装下，须实际切片决定拆盘。
- 灰PLA Matte：P01头壳、P04上盖、P05杯体；学校三件各单盘的起点保持。黑PLA Matte：其余结构/面板/导向件，优先自有A1。
- 0.4喷嘴起点：外观/滑盖0.16层高；机构/支架0.20层高。壁数、填充、支撑和热床/喷嘴温度遵循实际材料与机型配置，不能把这里当可直接开打的参数文件。
- 不喷漆、不打磨整壳、不做透明面罩；只移除支撑、清理必要毛刺和螺钉装配。受潮材料按厂商干燥条件处理，不写“永远免干燥”。

## 逐件切片回填

STL已有一个朝向起点，不是最终朝向。用实际Bambu Studio/OrcaSlicer打开独立件或mesh-only 3MF，选真实打印机/PLA/PETG配置，再做：

1. 检查单位mm、最低点在平台、最小壁和浮岛；禁止将零件自动缩放到“合适大小”。
2. 轴承座同时比较分缝向下/轴向竖直等方案的孔形、受力层向和支撑；不按一句“水平就圆”放行。
3. 检查每个螺钉孔、捕获螺母口袋、轴肩、D面、槽齿、滑盖卡槽、声管。支撑必须能取出，不能封死可视/声学/排线路径。
4. 用实打样片确认夹紧、摩擦、孔径、收缩和层间强度，填写SLICER_CHECKLIST.csv中的final_orientation、support、机器配置、样片证据。没有证据的字段保持空。
5. 最后再修改件表所属盘，并导出真实切片工程/G-code。当前6/7等起点盘数量不构成冻结盘数或打印工时。

## 文件与证据边界

原生.blend保留Screw/Boolean/Lattice/Solidify；STL是评估后的独立候选网格，未改名冒充STEP。3MF是标准Core几何包，不含机型预设、支撑或刀路，不能称为“已切片”。局部薄壁例外在件表明确记录，不虚写全部≥2.4mm。

本轮只做几何/文件检查。实际切片、真实打印、机械载荷、FPC50循环、温升和整机功能尚未执行；manifest四个状态字段保持原值。
