eleanor-wsyy/EffMeet2/docs/archive/product/装配对齐会议程_1005_v1.md

# A↔B/C 装配对齐会 · 议程与 A 侧立场 v1

> 时间：10.05 晚，45 分钟 | 参与：A（主持）、B、C
> 规则：逐议题过，每议题必须出"结论 + 负责人 + 落点文件"，散会即填《纪要》表（见文末）。

## 会前材料（A 已发，要求会前扫一遍）

- `docs/product/EffMeet2_演示脚本_v1.md`（附录 A 台词是今天的主角）
- `docs/product/EffMeet2_判断样例与提示文案_v1.md`
- `docs/product/qwen_prompt审核报告_v1.md`（B 按 §2 替换文本落地）
- `assets/prompts/qwen_candidate_rules_v1.yaml`

## 议题 ① fixture 统一（10 分钟）

- **背景**：B 的 `fixtures/demo/closed_loop.json` 还是旧语料，与演示脚本台词不一致——demo、ASR 测试、回归测试目前各说各话。
- **A 侧立场**：附录 A 台词（回收箱场景）成为全组唯一 fixture 语料。演示当天，评委看到的界面文本和听到的台词必须是同一个故事。
- **要的结论**：B 今天替换 fixture；C 用同一文本做 ASR 测试输入；E 的回归用例以此为准。
- **落点**：`fixtures/demo/closed_loop.json`

## 议题 ② 台词磨损测试（10 分钟）

- **背景**：脚本台词是书面语，真实 ASR 转写会带语气词、断句破碎。候选判断在磨损文本上是否还成立，未验证。
- **A 侧立场**：先改台词，不改模型。候选判断的语义规则（YAML 6 条）不动；如果口语化读法导致候选不生 成，调整的是台词措辞（把关键词说得更完整）。
- **要的结论**：今晚用 mock 闭环跑脚本节拍 2–3，丙的台词按口语化读法（加"呃""就是说"）手输一遍，确认候选正常生成；记录不成立的句子，A 回去改。
- **落点**：磨损测试记录（E 存档，台词 v1.1 若需改动）

## 议题 ③ 状态文案 ↔ 状态脸映射（10 分钟）

- **背景**：D 明天接管 `apps/web`，状态脸六态（idle/listening/analyzing/pending_confirmation/speaking/error）需要配套文案；判断样例文档 §3.3 已有七条状态提示语，两侧未对齐。
- **A 侧立场**：§3.3 是界面状态文案的唯一来源；今天补一张映射表，D 照表实现，不另造词。
- **要的结论**：映射表当场填完（见下），A 今晚补进判断样例文档 §3.3。

| 状态枚举 | 界面文案 | 机器人表情/灯效（D 定） |
|---|---|---|
| listening | 录音中 | （留白，D 填） |
| analyzing | 正在分析讨论… | |
| pending_confirmation | 等待你的决定 | |
| speaking | 正在提醒现场…… | |
| error | 连接异常，本地停止仍可用 | |
| idle | （会后/未开始） | |

## 议题 ④ TTS 语气规格（5 分钟）

- **背景**：C 今天交 TTS 生成器接口。"宠物形态不卖萌"需要落到语音参数上。
- **A 侧立场**：语速中等偏慢（约 0.9×）；音高自然，不刻意上扬；句尾不上挑；不要播音腔、不要卖萌腔。播报句长 ≤40 字（模板拼接后），单次播报 ≤10 秒。
- **要的结论**：C 按此选型/调参；P0 系统 TTS 先满足"能导出音频文件"即可，音色终选随 CosyVoice 评估后置。
- **落点**：纪要一行规格；C 的 TTS adapter 配置注释

## 议题 ⑤ 播报期间行为（已拍板，通报确认）（5 分钟）

- **A 已拍板**：**照常进判断，不设静默窗。** 机器人播报期间现场成员的发言正常转写、正常参与候选判断；仅 `robot_audio` 标记的机器人自声被抑制，不产生候选。
- **理由**（向 C 说明）：设静默窗等于机器人一开口全场进入"无效时间"，违背不打扰原则，也给现场成员"等它说完才敢说话"的反向暗示。
- **要的结论**：C 确认 `robot_audio` 标记与抑制逻辑；E 加一条测试："播报期间现场说话 → 产生正常 utterance，不产生以机器人声音为证据的候选"。
- **落点**：C 的测试样例；E 的负例用例表

---

## 会后产出：《装配对齐纪要》（散会前 5 分钟当场填）

| 议题 | 结论 | 负责人 | 落点文件 | 完成时限 |
|---|---|---|---|---|
| ① fixture | | B | fixtures/demo/closed_loop.json | 今晚 |
| ② 磨损测试 | | B+A | 测试记录 | 今晚 |
| ③ 状态映射 | | A（D 知会） | 判断样例文档 §3.3 | 明早 |
| ④ TTS 语气 | | C | TTS adapter 配置 | 10.06 |
| ⑤ 播报行为 | 照常进判断（已定） | C+E | 测试样例 | 10.06 |

> 纪要由 A 存档到 `docs/product/装配对齐纪要_1005.md`，明天 D 加入时同步。（整理注：该纪要实际从未入库，此处为历史死引用。）
