eleanor-wsyy/EffMeet2/hardware/robot-design/round-yaw-v2/renders/review-02/01_assembled.png

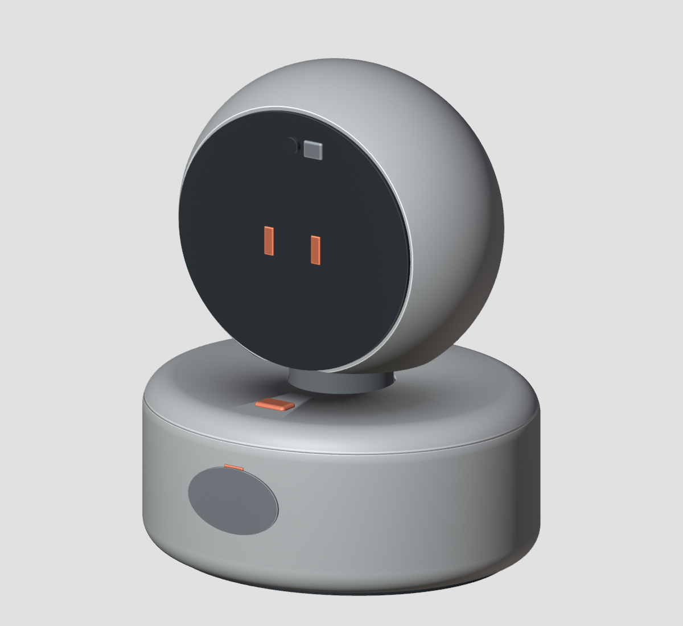
hardware/robot-design/round-yaw-v2/renders/review-02/01_assembled.png
