eleanor-wsyy/EffMeet2/hardware/robot-design/round-yaw-v2/revision-20261011-nomi-layoutA/print-split-v6/_show_p_wire.png

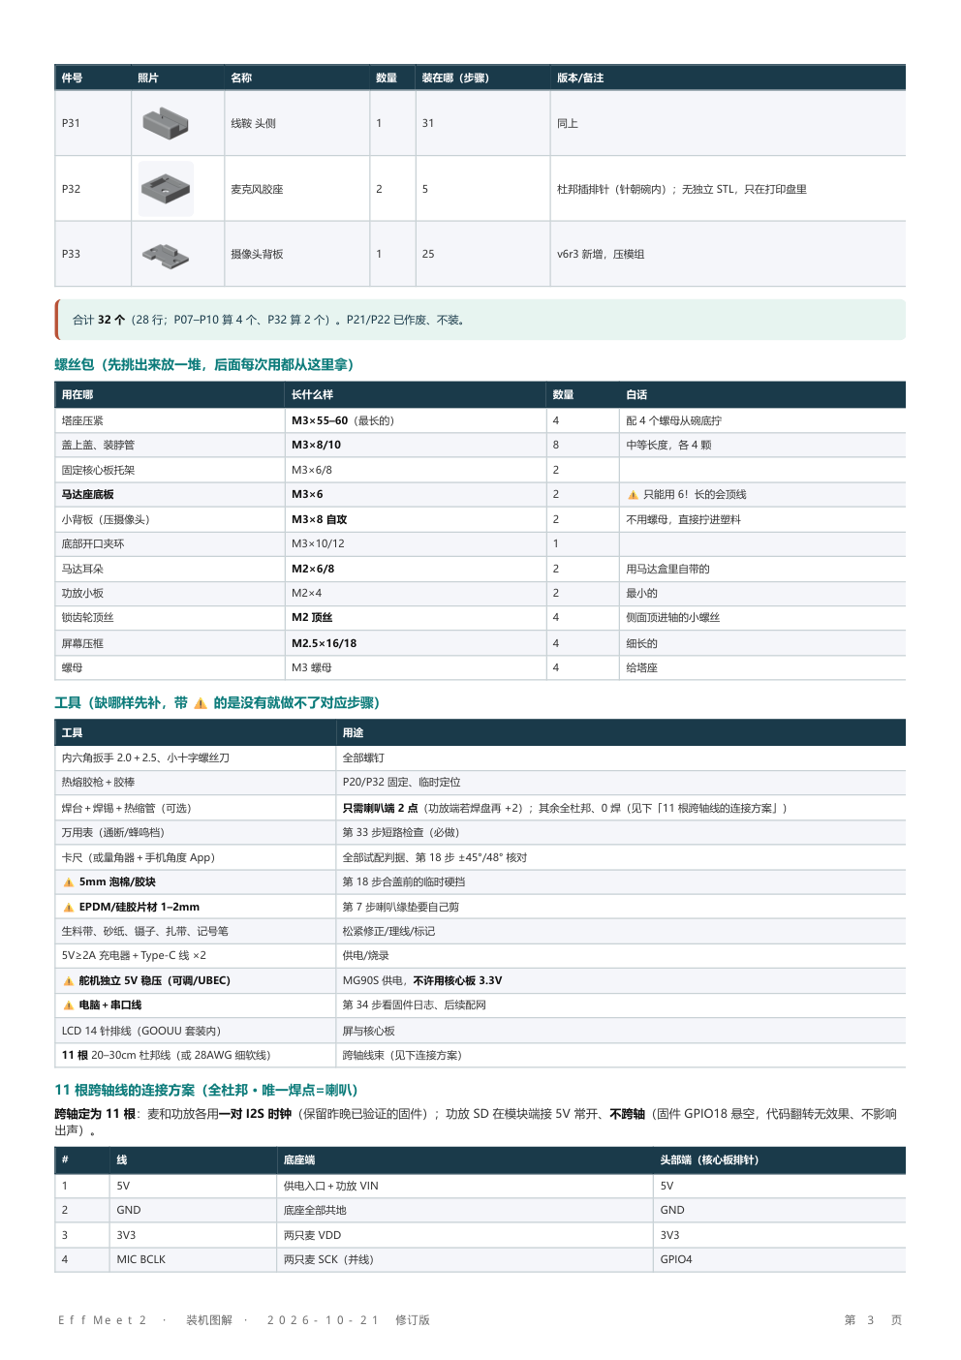
hardware/robot-design/round-yaw-v2/revision-20261011-nomi-layoutA/print-split-v6/_show_p_wire.png
