eleanor-wsyy/EffMeet2/docs/handoff/2026-10-20-esp32-bringup.md

# 2026-10-20 · ESP32-S3 实机 bring-up（烧录 + 外设驱动落地）

> 承接 2026-10-19 路线 A（不依赖单片机的远端链路）。本轮把固件从"编译通过的骨架"
> 推进到"实机运行 + 主要外设驱动落地"，全程不需要百炼 Key 与云端。

## 本轮完成

### 1. 首次烧录与启动
- 板卡：ESP32-S3 rev v0.2，N16R8（**16MB Flash + 8MB Octal PSRAM**），
  CH340 USB-UART 在 **COM3**，MAC `1c:29:04:31:1c:58`。
- `sdkconfig.defaults` 改为 16MB Flash；`scripts/build_firmware.ps1`（清 MSYSTEM、
  固定 `.espressif` py3.12 venv）+ `scripts/flash_firmware.ps1`（自动探测串口）。
- 烧录约 1.0MB（app 分区 3MB，余 68%），Hash verified；未配对时进入
  `effmeet>` 串口配网 REPL（`provision` / `provision_status`）。

### 2. 外设驱动（实机）
- **状态灯**：WS2812 GPIO48，`led <idle|notice|error|off>` 实机可用。
- **舵机**：MG90S GPIO38 LEDC 50Hz；初始化无错误，未做转头动作（安全）。
- **I2S 拾音 INMP441**（`main/audio_capture.c`）：std RX、16kHz 单声道、
  32-bit slot 右移 16 位截 s16；REPL `mic` 实测 50/50 帧读通（rms=0，
  因麦克风尚未接到占位引脚 BCLK=4/WS=5/DIN=6）。
- **I2S 播放 MAX98357A**（`main/audio_playback.c`）：std TX 16kHz 单声道，
  `AMP_ENABLE`(GPIO18) 门控；`begin()` 冲刷残留 DMA 样本，`end()` 等 DMA
  最坏积压排空后才允许 `RobotReceipt(completed)`；REPL `tone 880 500`
  25 帧全部写入无丢帧（放大器未接，无声属预期）。
- **LAN 设备网关与命令订阅**：`services/device_gateway.py` + 设备事件 WS
  （`device_id` + `media_token`），`device_session_subscribe_commands` 按
  `target_device_id` 分发 `robot.command`。

### 3. Wi-Fi 联网与命令链路（当日下午）
- 校园网 GAFA_Stu 有客户端隔离（板 10.15.120.x 与 PC 10.15.155.x 互不可达），
  改用 **PC 移动热点**：WinRT `NetworkOperatorTetheringManager` 可编程配置/开关，
  热点默认 5GHz 必须强制 2.4GHz（ESP32-S3 无 5GHz 射频）。
  热点 `EffMeet-Link` / `effmeet88`，PC 为 192.168.137.1，板得 192.168.137.167。
- bench 控制器（127.0.0.1:8768）+ LAN 设备网关（0.0.0.0:8799，
  `scripts/run_device_gateway.py`）；operator 配对 `robot_a` 得 media_token，
  串口 `provision` 写入 NVS。
- 板事件 WS 长连成功；向 bench DB 注入 `robot.command`（light/speak/stop，
  注意契约：light 要带 color_rgb、stop 要带 reason、speak 的 intervention_id
  须为 UUID）后，板子随即发起 `/device/v1/playback` 连接（网关日志证实）——
  **命令下发链路全通**。
- **上行音频链路全通**：`POST /api/bench/meetings/{mid}/media-bindings` 绑定会话
  （config 必须与设备上行 AudioStreamConfig 完全一致），REPL
  `uplink <session_id> <stream_id> <stream_key>` 触发；板子连 `/device/v1/audio`，
  EFMA 帧持续解码（约 30s 后 PCM 超 960KB 触发 SESSION_TOO_LONG，属预期），
  binding active→closed、audio_sessions ready→ended。ASR 未启动故无转写。
- 固件修复：`command_task` 原把异步 `ws_transport_start` 当同步用（start 后立即
  判 is_connected → 反复销毁重连，2.3s 循环），已加 5s 握手等待；
  `wifi_init_sta` 等 DHCP 拿 IP 后再开 socket；REPL 改为配对后常驻，
  重新配网不再需要 `esptool erase_region 0x9000 0x6000`。

### 4. speak 全链路（当日下午续）
- **固件命令分发架构修复**：`robot.command` 原在事件 WS 回调里直接执行 speak
  （阻塞数秒，堵死 WS 客户端任务），改为回调只入 `cmdq` 队列、`command_task`
  在自己上下文分发；分发日志 `dispatch robot.command action=...`。
- **bench 目标设备**：`DeferredRobot.device_id` 默认 `host_speaker_test`（测试钉死），
  真机联调需 `EFFMEET_ROBOT_ID=robot_a`（`services/controller/app.py` 新增环境变量）。
- **ws 发送超时 tick bug**：`esp_websocket_client_send_*` 超时参数也是毫秒不是 ticks，
  误传 `pdMS_TO_TICKS(5000)`=50ms 会导致 ack 发送在背压下静默失败；
  `ws_transport.c` 已改为直传 5000。
- **media.py 播放 deadline**：原 `pcm时长+10s` 未计单 outstanding 帧的 ack 往返，
  改为 `pcm时长 + 50ms/帧 + 15s`。
- **帧间延迟定位与修复**（esp_timer 实测）：write=47µs、ack 发送=3.3ms、
  **帧到达间隔 ≈175ms**——瓶颈在板端 TCP Nagle + 延迟 ACK（小 ack 被 Nagle 扣住）。
  修复：自建 `esp_transport_tcp` 包 `esp_transport_ws` 作 `ext_transport`，握手后
  对 socket 设 `TCP_NODELAY`（`ws_transport.c`）。修复后帧间隔 **22-28ms**。
  注意 `ext_transport` 会被 client 直接当 WS 传输用：必须自己 `esp_transport_ws_init`
  包一层并 `esp_transport_ws_set_config`（path/headers/control frames），
  否则握手路径会错打到 `/`。
- **speak 全链路验收通过**：回执 accepted → started → **completed** 全程入账，
  700+ 帧 22-28ms/帧稳定传输。media_token 1 小时 TTL 过期会报
  `INVALID_MEDIA_TOKEN`（events WS 不校验 TTL 仍可连），需重新 pair + provision。
- Qwen 分析判定（qwen-plus 真实调用）保守宁缺毋滥，三次均 `uncertain` 不出候选；
  speak 验收用 `store.analyze(..., 'possibly_unresponded')` 走 mock 候选路径
  （真实模型路径已验证可用，判定策略按设计）。

### 5. 踩坑记录（重要）
- `i2s_channel_read/write` 的超时参数是**毫秒**，不是 FreeRTOS ticks。
  误传 `pdMS_TO_TICKS()` 会把超时缩小 10 倍（CONFIG_FREERTOS_HZ=100），
  表现为周期性 `ESP_ERR_TIMEOUT`、队列持续溢出。已通过 `i2srate`
  （ISR 完成率 rx≈49/s、tx≈50/s，理论 50/s）+ ovf 计数器定位。
- `i2s_channel_register_event_callback` 必须在 `i2s_channel_enable` **之前**
  调用，启用后注册静默失败（返回 INVALID_STATE，不查返回值就发现不了）。
- IRAM 接近满（esp-sr 占大头），新增固件代码默认进 Flash，别再开 IRAM 选项。

## 当前状态 / 下一步

- 固件已实现：EFMA 编解码、WS 传输、会话状态机、LED、舵机、I2S 收/播。
  仍是桩：AFE/AEC（esp-sr 接入点已留）、摄像头（型号 TBD）。
- 音频链路未联调的原因不是软件：INMP441/MAX98357A 引脚是占位，需按
  `hardware/electronics` 接线核对 `app_config.h` 后复测 `mic`/`tone`。
- 设备上 Wi-Fi 需要凭据（配网 REPL 已就绪）：
  `provision <ssid> <pass> <controller_url> <meeting_id> <media_token>`，
  之后可跑 bench + 网关验证全链路。
- 详细模块状态见 `firmware/esp32/docs/FIRMWARE_STATUS.md`。
