eleanor-wsyy/EffMeet2/hardware/robot-design/round-yaw-v2/revision-20261011-nomi-layoutA/print-split-v6/review-20261016-measure/05_照片初判结果.md

# 元器件测量 · 照片初判结果

**日期**：2026-10-16
**输入**：27 张现场照片（去重后 24 张独立画面）
**口径**：只写照片能支撑的结论。**凡是读数不足 0.5mm 精度的，一律不给数字**——详见文末说明。

---

## 一、结论一览

| 分档 | 数量 | 说明 |
|---|---|---|
| **A 可直接采用**（定性判定） | 3 项 | 看一眼就能定，结论明确 |
| **B 量级核对一致**（±1~2mm） | 8 项 | 与标称/采购页相符，可用于"有没有买错"，**不能用于公差判定** |
| **C 照片新增发现** | 3 项 | 采购页没有描述、但会影响结构的问题 |
| **D 判定不了** | 其余 | 分两种：没拍到 / 拍到了但精度不够 |
| 覆盖的零件 | 4 类 | 6806 轴承、MG90S 舵机、INMP441 麦克风、扬声器 |

---

## 二、A 档：可直接采用的定性结论

| 项 | 结论 | 依据 |
|---|---|---|
| **B2 轴承 盖类型** | **金属密封盖（ZZ）** —— 外圈可见金属挡圈，没有橡胶密封唇 | 轴承端面照 |
| **B3 舵机 型号** | **TIANKONGRC · MG90S · Micro servo**，标签清晰可辨，与采购型号一致 | 舵机平躺标签照（2 张） |
| **B5 扬声器 规格** | 背面有钢印规格标识（阻抗/功率），与采购的 4Ω3W 相符；侧面为 2 个焊片 | 扬声器背面照 |

这三项不受直尺精度限制，照片即为证据。

---

## 三、B 档：量级核对（与标称一致）

> ⚠️ 表内数字是从**照片**读出的估算值，不确定度约 **±1~2mm**。
> 用途是"确认零件没买错、尺寸量级对得上"，**不能用来判 0.3mm 级的配合公差**。

| 项 | 标称 | 照片估算 | 判断 |
|---|---|---|---|
| B2① 轴承 外径 | 42 | ≈42 | 量级一致 |
| B2① 轴承 内径 | 30 | ≈30 | 量级一致 |
| B3 舵机 本体长×宽 | 22.4×12.5 | ≈22 × ≈12 | 量级一致 |
| B3 舵机 含耳总长 | 31.8 | ≈31 | 量级一致 |
| B4 麦克风 圆板直径 | 14 | ≈13~14 | 量级一致 |
| B4 麦克风 含排针总高 | ≈11 | ≈11~12 | 量级一致 |
| B5 扬声器 外圈直径 | 40 | ≈40 | 量级一致 |
| B5 扬声器 总厚（含焊片） | ≤17 | ≈17 | 量级一致，**是否超 17 必须卡尺确认** |

---

## 四、C 档：照片带来的三个新发现（采购页没写）

**1. 麦克风含焊盘总宽 ≈17~18mm，明显大于板径 ≈14mm**
实物是"圆板 + 两侧焊盘向外凸出"的形状。**如果 P21/P22 压圈按 Ø14 圆板设计，两侧凸出的焊盘可能压不进去或被压坏。** 建议结构侧按实测总宽复核压圈中心孔径。

**2. 麦克风的排针疑似"侧焊"而非"穿孔插件"**
照片上排针焊盘位于板的两侧边缘。如果实际是侧焊/贴片式，那么仓库要求的"**两排焊孔中心距 7.62**"这一测量项**在实物上可能根本不存在** —— 需要实物确认后再决定该项是否作废。

**3. 轴承确认为金属密封盖（ZZ），不是 2RS 橡胶盖**
盖上类型直接影响轴向厚度与旋转阻力，与台账记录一致，无需再复核。

---

## 五、D 档：照片判定不了的

**（1）完全没拍到的（占多数）**
- **B4 麦克风底面拾音孔** —— 判据"中心偏差 ≤0.5mm"的唯一依据，仓库标为"最重要的一张照片"，**本次一张都没有**
- B6 6×6 轻触开关（长宽 / 总高 / 脚距）
- B7 MAX98357A 功放板（板宽长 / 孔距 12.6 / 孔径 / 板厚 / 含针总高）
- B1 GT2 188mm 同步带（带宽 / 齿距 / 节线长）
- C1~C7 全部五金件（螺钉、垫圈、螺母、护套、硅胶、安装柱）
- B2② 第二只轴承、B4② 第二只麦克风（仓库明确"不能推定同批一致"）

**（2）拍了、但精度不够读不出的**
| 项 | 为什么读不出 |
|---|---|
| B2 轴承 宽度 7 | 没有拍到轴向侧视 |
| B3 耳孔直径 Ø2.2 | 没有耳孔特写；直尺物理上够不到内孔 |
| B3 耳孔中心距 27.7 | 同上 |
| B3 底面到耳高 22.8 | 拍摄角度不足，立不起来量 |
| B4 板厚 ≈1 | 0.5mm 级，直尺读不出 |
| B4 焊孔中心距 7.62 | 未拍到焊孔特写（且该项可能作废，见第四节第 2 点） |
| B2 外径/内径的**精确值** | 曲面 + 尺件不共面，读数系统性偏大，无法反推 |

---

## 六、为什么照片估算值不能填进 `actual_mm`

这是本报告的**核心纪律**，务必保留：

1. **照片内部比例是变形的。** 用程序对同一张照片的不同区域检测尺子刻度周期，得到 **17.7 px/mm 与 12.1 px/mm 两个互相矛盾**的标定值 —— 说明透视畸变已经破坏了图内的比例关系，无法用统一系数换算。
2. **误差有方向性且不可反推。** 曲面件（轴承、扬声器、麦克风圆板）配合"尺子与零件不共面"的拍法，读数一律偏大，偏大多少没有规律。
3. **填错的代价高于留空。** 仓库 `MEASURE-TODO.md` 写死"**未实测不填 PASS**"。设计侧已经按座孔 **42.3**、转轴 **Ø29.8** 做了配合补偿 —— 如果实测值填错，学长会按错误的补偿量重建 P05/P06/P11，整批打印件报废。

所以 `01_测量结果总表.xlsx` 里"实测值 / 误差 / r1r2r3"几列**保持空白并标黄**，等拿到卡尺或你亲手读数后再填。

---

## 七、下一步建议（按优先级）

1. **补拍 B4 麦克风底面拾音孔特写** —— 一张照片解决一个判据，成本最低、收益最高。
2. **补拍 B6 / B7 / C1~C7** —— 这四组目前完全空白。
3. **借一把数显卡尺**（哪怕是社团里借）—— **B2 轴承 OD/ID、各孔径孔距、各板厚**这 15 项左右，直尺永远做不了。
4. 补拍时做两件事可让照片读数精度提升到 ±0.2mm：① 让尺子与零件**贴在同一平面**（不要前后错开）；② 画面里**放一张银行卡**（标准 85.60×53.98mm）做像素标尺。

---

*本报告依据：EffMeet2 仓库 `MEASURE-TODO.md`（2026-10-15 v2）、`MEASUREMENTS.csv`、`INTERFACE_GATES.md`。*
*纪律：未实测不填 PASS；已测未装机只能写 `MEASURED_UNFITTED`。*
