eleanor-wsyy/EffMeet2/hardware/robot-design/round-yaw-v2/revision-20261011-nomi-layoutA/print-split-v6/review-20261016-measure/06_照片结果速览.html

# 照片整理结果

来源：27 张现场照片（去重后 24 张独立画面）· 覆盖 6806 轴承、MG90S 舵机、INMP441 麦克风、扬声器 4 类零件 · 2026-10-16

先说清楚这份结果的性质
照片能回答的问题分三种：① 看一眼就能定的、② 只能核对量级（±2mm）的、 ③ 根本回答不了的。下面按这三种分开列，不混在一起。

## 一、照片能定的（4 项，结论明确）

零件 | 项目 | 结论
6806 轴承 | 盖类型 | 金属密封盖（ZZ）——外圈可见金属挡圈，无橡胶唇
MG90S 舵机 | 型号 | TIANKONGRC · MG90S · Micro servo（标签清晰）
扬声器 | 规格 | 背面钢印规格与采购的 4Ω3W 相符
扬声器 | 接线 | 侧面 2 个焊片，非插针

## 二、量级核对（8 项，与标称一致，±2mm）

零件 | 项目 | 标称 | 照片读数
6806 轴承 | 外径 OD | 42 | ≈42
6806 轴承 | 内径 ID | 30 | ≈30
MG90S | 本体长 | 22.4 | ≈22
MG90S | 本体宽 | 12.5 | ≈12
MG90S | 含耳总长 | 31.8 | ≈31
麦克风 | 圆板直径 | 14 | ≈13~14
麦克风 | 含排针总高 | ≈11 | ≈11
扬声器 | 外圈直径 | 40 | ≈40
扬声器 | 总厚（含焊片） | ≤17 | ≈15~16，看起来未超 17

这一档的用途是确认零件没买错。要判"座孔 42.3 能不能轻压入"这种 0.3mm 级的配合，照片读数不够，必须卡尺。

## 三、照片里发现的问题（3 项，采购页没写）

1. 麦克风含焊盘总宽 ≈17~18mm，明显大于板径 ≈14mm 实物是"圆板 + 两侧焊盘向外凸出"。如果 P21/P22 压圈按 Ø14 圆板设计，两侧凸出的焊盘可能压不进或被压坏 —— 建议结构侧按实测总宽复核压圈中心孔径。

2. 麦克风排针疑似"侧焊"，不是"穿孔插件" 焊盘位于板的两侧边缘。若确实如此，仓库要求的"两排焊孔中心距 7.62"这一项在实物上可能根本不存在 —— 需要你回去确认一眼再决定是否作废。

3. 轴承确认是金属盖（ZZ），不是 2RS 橡胶盖 与台账记录一致，无需再复核。

## 四、照片回答不了的

完全没拍到的：

- B4 麦克风底面拾音孔 —— 判据"中心偏差 ≤0.5mm"的唯一依据，这次一张都没有
- B6 6×6 轻触开关（长宽 / 总高 / 脚距）
- B7 MAX98357A 功放板（板宽长 / 孔距 12.6 / 孔径 / 板厚 / 含针总高）
- B1 GT2 188mm 同步带（带宽 / 齿距 / 节线长）
- C1~C7 全部五金件（螺钉、垫圈、螺母、护套、硅胶、安装柱）
- 第二只轴承、第二只麦克风（仓库要求不能推定同批一致）

拍了、但读不出的：

- B2 轴承宽度 7 —— 没有轴向侧视
- B3 耳孔 Ø2.2、耳孔中心距 27.7 —— 没有特写，直尺也够不到内孔
- B3 底面到耳高 22.8 —— 拍摄角度不足
- B4 板厚 ≈1 —— 0.5mm 级，直尺读不出

## 五、为什么"实测值"那一列是空的

不是漏做，是刻意留空。三个原因：

- 照片内部比例是变形的。用程序对同一张照片的不同区域检测尺子刻度周期，得到 17.7 px/mm 与 12.1 px/mm 两个互相矛盾的值 —— 透视已经把图内比例破坏了，没有统一换算系数。
- 误差有方向且不可反推。曲面件 + 尺子与零件不共面，读数一律偏大，偏大多少没有规律。
- 填错比留空更危险。仓库写死"未实测不填 PASS"。设计侧已按座孔 42.3、转轴 Ø29.8 做过配合补偿 —— 实测值填错，学长会按错的值重建 P05/P06/P11，整批打印件报废。

## 六、下一步（按性价比排序）

1. 补拍 B4 麦克风底面拾音孔特写 —— 一张照片解决一个判据
2. 补拍 B6 / B7 / C1~C7 —— 这四组目前完全空白
3. 借一把数显卡尺 —— B2 轴承 OD/ID、各孔径孔距、各板厚这 15 项左右，直尺永远做不了
4. 补拍时：① 让尺子与零件贴在同一平面；② 画面里放一张银行卡（85.60×53.98mm）—— 可把照片读数精度提到 ±0.2mm

依据：EffMeet2 仓库 MEASURE-TODO.md（2026-10-15 v2）、MEASUREMENTS.csv、INTERFACE_GATES.md。
纪律：未实测不填 PASS；已测未装机只能写 MEASURED_UNFITTED；照片估算值不得填入 actual_mm。
