eleanor-wsyy/EffMeet2/hardware/robot-design/round-yaw-v2/revision-20261011-nomi-layoutA/print-split-v6/MEASUREMENTS.csv

id | measure | budget_note | actual_mm | evidence | measured_at | status
MAINBOARD | PCB完整排针/USB/最高元件 | v6：竖装头内，FPC/USB-C端朝上；USB-C插头留10mm头内调试空间；原：62.6x28.3为板体记录，装配空间未测 | PCB上方最高元件6；PCB下排针8；两只Type-C与摄像头FPC座均在远离ESP32模组一端；Type-C母座未突出PCB边缘（2026-10-15实测，后部开口/供电走线无需额外凸出余量） | 用户实测（卡尺） | 2026-10-15 | MEASURED_UNFITTED
LCD | 玻璃/PCB/厚度/J2朝向/元件 | v6：横向贴面板；原4孔按80x45假定已被2026-10-15实测77x45取代；玻璃到PCB深度假定4mm已实测确认；原：窗口58.2x43.8、PCB85x55为预算 | PCB85x50；最厚处总厚11；排针在屏FPC一侧短边；4安装孔孔径4；横孔距77；纵孔距45；玻璃到PCB4（2026-10-15卡尺实测，取代80x45假定） | 用户实测（卡尺） | 2026-10-15 | MEASURED_UNFITTED
CAMERA | 模组/镜头凸高/FPC口 | v6：贴面板背面，镜头中心=窗口上沿+17；FPC直线跨距9.55，余量4.45（目标≥3）；原：20x10x18预算 | 模组8x8x4；FPC长14（不可裁剪；不足以从底座跨轴到头部）；镜头凸出模组面4（2026-10-15卡尺实测） | 用户实测（卡尺） | 2026-10-15 | MEASURED_UNFITTED
INMP441_L | PCB/焊点/底部拾音孔坐标 | 采购页Ø14圆PCB，h≤12，底部中心拾音孔；v6装于后上壁袋；原：16x6x12装配轴预算 |  | ；2026-10-16照片新发现:含两侧焊盘总宽≈17-18>板径14(P21/P22作废改P32胶座,腔19避焊盘);排针疑侧焊,7.62焊孔项可能作废;底面拾音孔未拍(最重要一张缺失) |  | UNVERIFIED
INMP441_R | PCB/焊点/底部拾音孔坐标 | 采购页Ø14圆PCB，同左；不能推定同批即相同；原：同左，不能推定同批即相同 |  | ；2026-10-16:第二只未拍,不可推定一致 |  | UNVERIFIED
MAX98357A | PCB/接头/焊点/元件 | 采购页17.7x19.1，孔距12.6，距底边16.7；v6低托盘；原：23x16x4预算 |  |  |  | UNVERIFIED
TP4056 | PCB/USB/焊点 | v6推迟（路线B／决赛），Demo外供5V；28x17x4预算，不是5V升压 |  |  |  | DEFERRED
MG90S | 固定耳/舵盘/输出轴偏移 | 采购页本体22.4x12.5，带耳31.8，耳孔距27.7（导孔Ø1.8），底到耳22.8/19.8，含舵盘高32.9；双臂舵盘31.2x4.72；原：本体22.8x12.2x28.5，其他未测 |  | ；2026-10-16照片定性:TIANKONGRC MG90S标签确认与采购一致 |  | UNVERIFIED
6806_LOWER | 真实OD/ID/宽/内圈面/配合 | 标称30x42x7（6806）；原：标称30x42x7 |  | ；2026-10-16照片定性:金属密封盖ZZ确认(学妹交付05报告A档) |  | UNVERIFIED
6806_UPPER | 真实OD/ID/宽/内圈面/配合 | 标称30x42x7（6806）；原：标称30x42x7 |  | ；2026-10-16照片定性:同批第二只未拍,不可推定一致,待补拍+卡尺 |  | UNVERIFIED
GT2_BELT | 型号/真实节线长/宽/弹性 | v6：188mm闭环6mm宽，32T/64T，C=44.84；齿槽未认证（v5 228mm作废）；原：228mm仅候选，齿槽未认证 |  |  |  | UNVERIFIED
SPEAKER | 外圈/深/接线/安全夹持边 | 采购页Ø40x17；v6前托架≤46宽；原：预算<=40x18 |  | ；2026-10-16照片定性:背面钢印4Ω3W相符、侧面2焊片;总厚≈17须卡尺确认≤17 |  | UNVERIFIED
BATTERY | 受保护电芯外形/线出/极性 | v6推迟（路线B／决赛），Demo外供5V；30x55x10装配轴预算 |  |  |  | DEFERRED
TACTILE_KEY | 6mm键体/脚/致动高/行程 | 6x6x5预算 |  |  |  | UNVERIFIED
FASTENERS | M3x70头形/头高/螺母厚度 | 不能只看标称长度 |  |  |  | UNVERIFIED
EXTENSION_BOARD | 完整外形/排针 | 95x87x12实测，v6不装入；原：未计入内舱 | 95x87x12 | 用户实测（尺子，毫米级） | 2026-10-13 | MEASURED_UNFITTED
USB_C_POWER_BOARD | PCB/USB-C口/焊盘/输入额定 | v6新增，预算20x15x6，后部杯壁开口11.5x7；具体件未选 |  |  |  | UNVERIFIED
CROSS_YAW_WIRES | 线数/线径/外径/弯折寿命 | v6：约9根细软线（5V,GND,3V3?,BCLK,WS,MIC SD,AMP DIN,SERVO PWM,KEY）穿Ø22轴孔，Ø10禁入区，两端线夹 |  |  |  | UNVERIFIED
FACE_RETENTION | 面板锁壳螺钉/螺母/拆装工具空间 | R1三点M3x12及捕获螺母仅候选预算；canonical v6未合并；详见INTERFACE_GATES.md |  |  |  | UNVERIFIED
FOOT_PAD | 脚垫含胶厚度/压缩/贴合 | C07约2mm硅胶片对应杯底z=2预留；不是已安装实物 |  |  |  | UNVERIFIED
INMP441_PADW | 含焊盘总宽(两侧凸出) | P32腔19须≥实测总宽+0.5余量 | 照片估17-18(±1-2,不可用) | 学妹交付05报告C档1 | 2026-10-16 | UNVERIFIED
INMP441_BOTTOM | 底面拾音孔中心偏差 | ≤0.5mm→P32声孔位置确认 | 缺照片(最重要一张未拍) | 学妹交付D档 | 2026-10-16 | UNVERIFIED
P24_CAMERA_APERTURE | 面板摄像孔 | 6.8（P26镜管6.5+0.3） | 6.8名义（build_v6 2026-10-19 FITFIX）；旧P24 4.2需钻6.8；2d21bdc曾夹带回退4.2已改回，首批FACEFLAT盘（4.2）同规钻6.8 | build_v6 | 2026-10-19 | UNVERIFIED
P26_LENS_TUBE | 摄像头托架镜管内径 | 6.5 | 6.5名义（build_v6 2026-10-19 FITFIX）；旧4.6 | build_v6 | 2026-10-19 | UNVERIFIED
P26_V6R3 | 摄像头托架夹持结构（v6r3） | 前壁3.5（镜头凸4→入P24孔0.5~0.7导向）；背腔2.6供FPC折弯；2×M3自攻背柱（柱距13.9/导孔Ø2.5） | 名义（build_v6 2026-10-19晚 v6r3）；旧版无保持结构（实打发现模组晃） | build_v6 | 2026-10-19 | UNVERIFIED
P33_BACK_PLATE | 摄像头背板（新件P33） | FPC槽6.4×2.5；孔2×Ø3.4距13.9；压筋顶模组背面（名义零压） | 名义（build_v6 2026-10-19晚 v6r3新增） | build_v6 | 2026-10-19 | UNVERIFIED
P15_SERVO_POCKET | 舵机口袋宽 | 13.7（12.5+1.2） | 13.7名义（build_v6 2026-10-19 FITFIX）；旧12.5+0.6 | build_v6 | 2026-10-19 | UNVERIFIED
P15_WIRE_RELIEF | 舵机尾端出线让位槽 | 槽宽6.8/通高9.6（尾端底角出线，实打发现线被顶住后v6r3补） | 6.8名义（build_v6 2026-10-19晚 v6r3）；旧版无槽 | build_v6 | 2026-10-19 | UNVERIFIED
P17_AMP_POST_PITCH | 功放M2柱距 | 12.6 | 12.6名义（两柱Ø4.5/孔Ø1.7；build_v6 2026-10-19 FITFIX） | build_v6 | 2026-10-19 | UNVERIFIED
P29_CORE_SLOT | 核心板槽宽/咬边 | 槽1.7(1.6+0.1)/底槽28.5/耳槽咬边0.6 | EDGEGRIP口径（build_v6 4fd0189；旧1.8为FITFIX、旧2.1更早） | build_v6 | 2026-10-20 | UNVERIFIED
