eleanor-wsyy/EffMeet2/hardware/robot-design/round-yaw-v2/revision-20261011-nomi-layoutA/print-split-v6/MEASURE-TODO.md

# 待测量清单 v3（2026-10-16 · 学妹交付后重划）

> 交付归档：[review-20261016-measure/](review-20261016-measure/)（总表xlsx/回填csv/照片初判md/20张筛选照片）。
> **v3 核心变化**：学妹用**直尺(±0.5)**量的数字**全部作废**（她自己也没填进 actual_mm，纪律正确）；照片带来 3 项定性结论已销账 + 1 个设计坑已处置（P32）；剩下分两路：**卡尺数字路**（~15 项）与**补拍路**（8 组）。
> 回填流程不变：实测 → 本表 + [MEASUREMENTS.csv](MEASUREMENTS.csv) `actual_mm` → status 升 `MEASURED_UNFITTED` → 同步 parameters → 重建 → 出盘。**未实测不填 PASS。**

---

## 0. 已销账（不用再测）

| 项 | 结论 | 证据 | 处置 |
|---|---|---|---|
| LCD 四孔 77×45/孔径4/玻璃4/镜头4/Type-C齐平 | 已测（10-15 卡尺） | MEASUREMENTS.csv | v6r2/v6r3 已重建落地 |
| B2 轴承盖类型 | **金属密封盖 ZZ** | 学妹端面照（A档） | 与台账一致，销账 |
| B3 舵机型号 | **TIANKONGRC MG90S** 标签清晰 | 标签照（A档） | 与采购一致，销账 |
| B5 扬声器规格 | 背面钢印 **4Ω3W**、侧2焊片 | 背面照（A档） | 销账；总厚仍待卡尺 |
| B4 焊盘外凸 | 含焊盘总宽≈17–18 > 板径14 | 正面照（C档发现） | **已处置**：P21/P22 作废→P32 胶座（腔19）；P01 壁袋环弃用不返工 |

## 1. 卡尺数字路（直尺做不了，必须卡尺；~15 项）

> 执行人：**你（有卡尺）10 分钟**，或把卡尺借给学妹重测。判据照 v2 表（B/C 组原文保留在下附）。

| # | 对象 | 量什么 | 判据/影响 |
|---|---|---|---|
| 1 | 6806 ×2（每只） | OD / ID / 宽 | OD 落 42.3 轻压入；ID 套 Ø29.8 顺滑 → P05/P06/P11/P12 孔补偿 |
| 2 | INMP441 ×2 | **含焊盘总宽精确值**、板厚 | 总宽须 ≤19（P32 腔）；超则 P32 扩腔重打（小件便宜） |
| 3 | INMP441 ×2 | 排针/焊盘是**侧焊还是穿孔** | 决定"7.62 焊孔距"项是否作废 |
| 4 | 扬声器 | 总厚含焊片 | ≤17 入 P16；超则 P16 加深 |
| 5 | 6×6 开关 | 总高、底面6×6、脚距 | 高 5±0.5 入 P20；≠5 改 P20/P19 |
| 6 | MAX98357A | 板宽长、孔距12.6、孔径、板厚、含针高 | 对 P17 沉孔复核 |
| 7 | MG90S | 耳孔径、耳孔中心距27.7、底到耳高 | 对 P15 耳架/导孔 |
| 8 | M3/M2.5 螺钉 | 头径/头高（各一支） | 沉孔不凸出 |
| 9 | 垫圈/螺母 | 垫圈内径、螺母对边/厚 | 垫圈槽/螺母陷阱 |
| 10 | M3×70 | 是否含螺母、总长 | P06 贯穿压紧 |

## 2. 补拍路（照片即可，不用量具；8 组）

> 按学妹自己的招：**尺贴同平面 + 画面放银行卡(85.60×53.98)当像素尺**，可把照片读数提到 ±0.2。

| # | 拍什么 | 为什么重要 |
|---|---|---|
| 1 | **INMP441 底面拾音孔特写** | ★最重要：判中心偏差≤0.5 → P32 声孔位置最终确认（现按中心假定） |
| 2 | 第二只轴承 六面 | 不可推定同批一致 |
| 3 | 第二只麦克风 正面+底面 | 同上 |
| 4 | B6 开关 平放+侧立 | 高/脚距照片可读 |
| 5 | B7 功放 正面+背面+侧 | 孔距/板厚照片可读 |
| 6 | B1 GT2 带 平铺+齿特写+绕绳量周长 | 齿形/节线长 |
| 7 | C1–C7 五金各组平铺照 | 头形/对边/厚度照片可读 |
| 8 | 轴承 轴向侧视 | 宽度 7 照片可读 |

## 3. 样片读数路（打印完读）

| 样片 | 状态 | 读什么 |
|---|---|---|
| COUPON（PLA，H2D） | 已打/在打 | 01/02 梯条哪格入 → 孔补偿值 → 超差则重建 P05/P06/P11/P12 |
| A1 PETG 样片 | **降级可选**（A1 改打 PETG 替身颈/滑片） | 若打：PETG 收缩对照；不打不影响 |

## 4. 仍等选型/到货（非测量）

| 项 | 状态 |
|---|---|
| USB-C 5V 输入板 SKU | 唯一设计阻塞残留；P18T 容差托架已打，板到后扎带固+核对连接器对 P01 容差窗 |
| GT2 188 带 | 到货→套 P03/P04 试齿 |
| 黑卷 | 烘干中→拉丝测试→BVIS(P14/P28)；废则购新卷 |

## 5. 状态汇总

- **销账**：5 组（含 1 个设计坑处置）
- **待卡尺**：10 组 ~15 数（你或学妹）
- **待补拍**：8 组（学妹）
- **待样片读数**：COUPON（A1 可选）
- **待选型/到货**：3 项
- **DEFERRED**：TP4056、3.7V 电池（路线B/决赛）

---

## 附：v2 原文判据（B/C 组，供卡尺路对照）

| 组 | 对象 | 接受判据 | 超差处置 |
|---|---|---|---|
| B1 | GT2 188 带 | 188±1 套入、张紧槽±2 内调紧不跳齿 | 改齿槽重建带轮 |
| B2 | 6806 | OD 落 42.3 轻压入、ID 套 Ø29.8 顺滑 | 紧→改孔补偿重建；松→加垫 |
| B3 | MG90S | 耳孔配 P15 Ø1.8 导孔、舵盘入 P04 | 改 P15/P04 |
| B4 | INMP441 | 底孔中心偏差≤0.5、总高≤袋深 | 平移 P32 声孔/扩腔 |
| B5 | 扬声器 | 总厚≤17 | 加深 P16 |
| B6 | 开关 | 高 5±0.5 入 P20 | 改 P20/P19 |
| B7 | MAX98357A | 孔距12.6/板17.7×19.1 | 改 P17 沉孔 |
| C1–C7 | 五金/片材/护套/安装柱 | 见 v2 各行 | 见 v2 各行 |
