eleanor-wsyy/EffMeet2/docs/archive/handoff/2026-10-05-image-test.md

# 图片文件上传验收

用户提供 `data/9d8b8e9fafbc5b3d393f2da10de8d3b6.jpg`，214688 字节。目视为白底黑字的文字图片，主要文字可辨；不能据此确认摄像头设备、对焦或现场光照效果。

在用户运行的本机 8768 台架进行实测：

- 上传返回 201，会议图片列表可查到记录。
- 下载字节与原图完全一致，SHA-256：`b7e9244a02d37c71f3f65af17f37bda810aed7772e546d1ac9c8b7e37ae63699`。
- 从另一测试会议读取该图片返回 404；不带身份凭据读取返回 401。
- 会议：`46cfb0c2-0b67-420d-9b09-ffb0689e8347`。
- 图片：`f83b7a4b-9a45-4b0d-9dad-57e015bed261`。
- 原始结果保存在 `data/image-upload-test-result.json`，原图保留。

验收范围为真实本地 HTTP 上传、SQLite 保存、列表查询、原图读取与会议隔离。当前旧 capture 路由仍将事件标为 mode=mock / source=demo_capture，不能将该事件作为真实摄像头采集来源证明。没有调用千问视觉模型，也没有完成网页摄像头预览、拍照或权限测试。
