eleanor-wsyy/EffMeet2/docs/archive/handoff/2026-10-05-qwen-microphone-test.md

# 真人转写与真实 Qwen 联合测试

## 输入与边界

使用此前电脑自带麦克风录音的原始 ASR 结果，未修正错词：

> 我建议先测试麦克风，确认线上程可以听清，再开始讨论草作。

本轮将转写原样导入用户已启动的 8768 台架，通过真实 DashScope / qwen-plus 分析。导入为手工文本事件，不冒充新的真实 ASR 事件。原始录音及 ASR 入账证据见 [麦克风测试](2026-10-05-microphone-test.md)。本轮没有重新上传音频，没有读取或记录 Key。

会议 ID：`97fe013b-39fd-40be-91c1-f92901bb0c6a`。
详细原始结果：本机 `data/microphone-qwen-test-result.json`。

## 实际结果

| 场景 | 真实模型结果 | 系统行为 | 提交后至轮询完成耗时 |
|---|---|---|---|
| A：仅真人录音转写 | uncertain；缺少现场发言，无法判断回应 | 不产生提醒候选 | 2.015 秒 |
| B：追加手工测试发言“先不谈这个，我接着介绍明天的午餐安排。” | possibly_unresponded；现场转移话题 | 产生 awaiting_confirmation 候选，归属 remote_1 | 3.031 秒 |
| C：追加手工测试发言“同意你的建议，我们先测试麦克风。我这边可以听清，确认线上成员也能听清后，再讨论草图。” | responded | 不产生新候选；response_utterance_ids 指向明确回应 | 3.031 秒 |

B 的提示候选：

> 线上成员提出：先测试麦克风确认音频通畅再开始讨论，现场可以回应一下吗？

C 的回应证据 ID：`3bebf4ca-b4cc-4557-99d7-dab48f557eed`，与实际提交的明确回应匹配。

三项任务均 completed，模型来源 dashscope，model_id qwen-plus，prompt_version qwen-v2。最终命令数量为 0；没有代用户确认、没有播放。模型判断 responded 不等于本人已完成 human_verified 核对。

## 对工作目标的结论

- 真人录音 ASR 与真实千问分析已分别实测，本轮成功连接了转写内容与真实模型判断。
- 判断分支、不自动播报、本人确认候选及回应证据引用均观察到预期结果。
- 现场两句为手工测试数据，不是第二位真人录音；只有三个样例，不能作为整体准确率评估。
- 尚未完成同一服务内实时采集→ASR→千问→本人网页确认→机器人实播→本人回应核对的连续真人闭环。
- 仍需配置原 8768 服务的 ASR/TTS、接入实际输出设备；摄像头、LiveKit、AEC 仍未验收。
