eleanor-wsyy/EffMeet2/assets/brand/ai-result.png

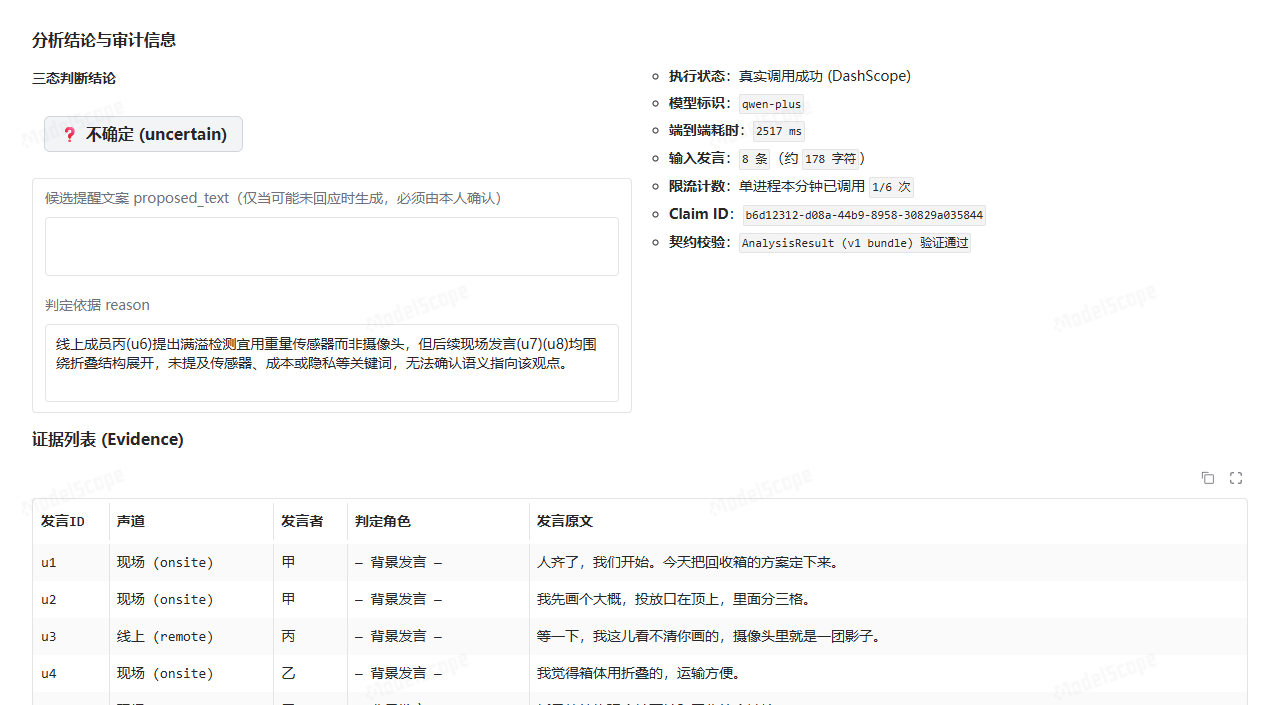
assets/brand/ai-result.png
