eleanor-wsyy/EffMeet2/hardware/robot-design/round-yaw-v2/revision-20261011-nomi-layoutA/print-split-v6/review-20261016-measure/照片_筛选保留/B3_舵机_侧视_优.jpg

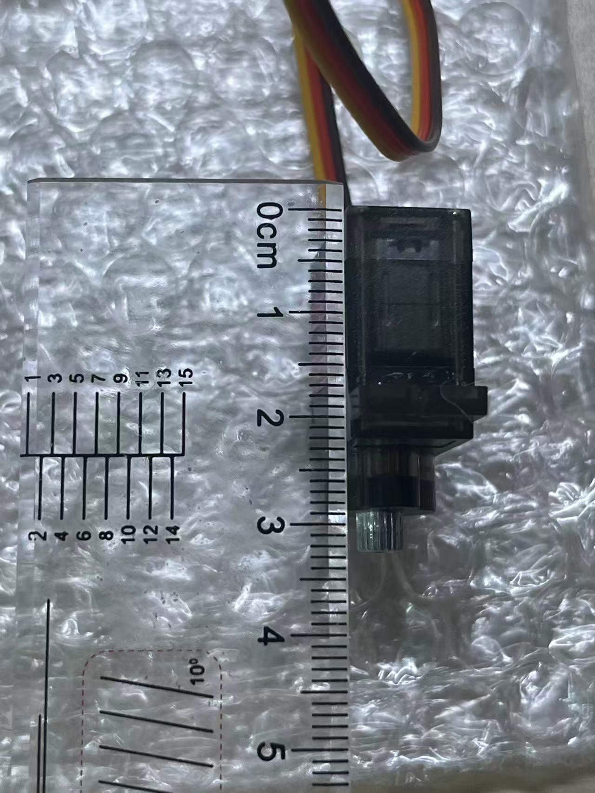
hardware/robot-design/round-yaw-v2/revision-20261011-nomi-layoutA/print-split-v6/review-20261016-measure/照片_筛选保留/B3_舵机_侧视_优.jpg
