eleanor-wsyy/EffMeet2/deploy/livekit/livekit.yaml

# livekit-server config template. NOT-VERIFIED — starting point only.
# Secrets (keys) come from environment / a mounted secrets file, never inline here.
# Docs: https://docs.livekit.io/home/self-hosting/deployment/

port: 7880
bind_addresses: [""]

# TCP/UDP for media. Behind a reverse proxy / NAT, set rtc.use_external_ip and
# configure node_ip or a TURN server (see docker-compose.yml).
rtc:
  port_range_start: 50000
  port_range_end: 50100
  use_external_ip: true

redis:
  address: redis:6379

# Keys are NOT read from this file: livekit-server does not expand ${...} here.
# docker-compose.yml passes them as LIVEKIT_KEYS="<key>: <secret>" instead.

logging:
  level: info

room:
  # The controller does not pre-create rooms via the server API; participants
  # and the relay join by meeting_id, so the server must create rooms on join.
  auto_create: true
  empty_timeout: 300
