eleanor-wsyy/EffMeet2/firmware/esp32/main/ws_transport.c

/* ws_transport implementation over esp_websocket_client. NOT-VERIFIED (uncompiled).
 * Keep the token in the Authorization header; the relay rejects query params and
 * browser Origin for device endpoints (services/relay/media.py: bearer()/local()).
 */
#include "ws_transport.h"

#include <stdio.h>
#include <stdlib.h>
#include <string.h>

#include "esp_log.h"
#include "esp_transport.h"
#include "esp_transport_tcp.h"
#include "esp_transport_ws.h"
#include "esp_websocket_client.h"
#include "lwip/sockets.h"

static const char *TAG = "ws_transport";

/* Declared in tcp_transport's private header; the IDF test app re-declares it
 * the same way. Needed to reach the socket fd for TCP_NODELAY. */
int esp_transport_get_socket(esp_transport_handle_t t);

struct ws_transport {
    esp_websocket_client_handle_t client;
    esp_transport_handle_t ws;  /* WS framing over our tcp transport */
    esp_transport_handle_t tcp; /* owned ext transport: lets us set TCP_NODELAY */
    ws_event_cb_t cb;
    void *ctx;
    char *auth_header; /* persists for client lifetime */
    char *ws_path;     /* persists: ws config is used on every reconnect */
};

/* Nagle + delayed-ACK turns the one-outstanding EFMA frame/ack exchange into a
 * ~175 ms per frame crawl. Disable Nagle on the device socket right after the
 * handshake; the socket fd is only reachable through our ext transport. */
static void enable_tcp_nodelay(ws_transport_t *t) {
    if (!t || !t->tcp) {
        return;
    }
    int fd = esp_transport_get_socket(t->tcp);
    if (fd < 0) {
        return;
    }
    int one = 1;
    if (setsockopt(fd, IPPROTO_TCP, TCP_NODELAY, &one, sizeof(one)) != 0) {
        ESP_LOGW(TAG, "TCP_NODELAY setsockopt failed on fd=%d", fd);
    }
}

esp_err_t ws_build_uri(const char *scheme, const char *base_url, const char *path,
                       char *out, size_t out_cap) {
    if (!scheme || !base_url || !path || !out) {
        return ESP_ERR_INVALID_ARG;
    }
    /* Strip an existing http(s):// or ws(s):// prefix from base_url. */
    const char *host = base_url;
    const char *sep = strstr(base_url, "://");
    if (sep) {
        host = sep + 3;
    }
    int n = snprintf(out, out_cap, "%s://%s%s", scheme, host, path);
    if (n < 0 || (size_t)n >= out_cap) {
        return ESP_ERR_INVALID_SIZE;
    }
    return ESP_OK;
}

static void on_ws_event(void *arg, esp_event_base_t base, int32_t event_id, void *event_data) {
    ws_transport_t *t = (ws_transport_t *)arg;
    esp_websocket_event_data_t *data = (esp_websocket_event_data_t *)event_data;
    (void)base;
    if (!t || !t->cb) {
        return;
    }
    ws_event_t evt = {0};
    switch (event_id) {
        case WEBSOCKET_EVENT_CONNECTED:
            enable_tcp_nodelay(t);
            evt.type = WS_EVT_CONNECTED;
            t->cb(t->ctx, &evt);
            break;
        case WEBSOCKET_EVENT_DISCONNECTED:
            evt.type = WS_EVT_DISCONNECTED;
            t->cb(t->ctx, &evt);
            break;
        case WEBSOCKET_EVENT_ERROR:
            evt.type = WS_EVT_ERROR;
            t->cb(t->ctx, &evt);
            break;
        case WEBSOCKET_EVENT_DATA:
            /* op_code 0x1 = text (JSON control), 0x2 = binary (EFMA frame). */
            if (data->op_code == 0x02) {
                evt.type = WS_EVT_BINARY;
                evt.bin = (const uint8_t *)data->data_ptr;
                evt.len = (size_t)data->data_len;
                t->cb(t->ctx, &evt);
            } else if (data->op_code == 0x01 && data->data_ptr && data->data_len > 0) {
                /* Copy to a NUL-terminated buffer for the JSON layer. */
                size_t n = (size_t)data->data_len;
                char *buf = (char *)malloc(n + 1);
                if (buf) {
                    memcpy(buf, data->data_ptr, n);
                    buf[n] = '\0';
                    evt.type = WS_EVT_TEXT;
                    evt.text = buf;
                    evt.len = n;
                    t->cb(t->ctx, &evt);
                    free(buf);
                }
            }
            break;
        default:
            break;
    }
}

ws_transport_t *ws_transport_create(const char *uri, const char *bearer_token,
                                    ws_event_cb_t cb, void *ctx) {
    if (!uri) {
        return NULL;
    }
    ws_transport_t *t = (ws_transport_t *)calloc(1, sizeof(*t));
    if (!t) {
        return NULL;
    }
    t->cb = cb;
    t->ctx = ctx;
    if (bearer_token && bearer_token[0]) {
        size_t hlen = strlen(bearer_token) + 32;
        t->auth_header = (char *)malloc(hlen);
        if (!t->auth_header) {
            free(t);
            return NULL;
        }
        snprintf(t->auth_header, hlen, "Authorization: Bearer %s\r\n", bearer_token);
    }
    esp_websocket_client_config_t cfg = {0};
    cfg.uri = uri;
    cfg.headers = t->auth_header; /* NULL is allowed by the client */
    cfg.buffer_size = 8192;       /* >= EFMA_MAX_DECODED control + frame headroom */
    cfg.network_timeout_ms = 10000;
    t->tcp = esp_transport_tcp_init();
    if (t->tcp) {
        /* ext_transport must carry WS framing itself: the client uses it as-is.
         * That also means the client skips its own ws config (path/headers/
         * control frames) — we must apply those here. */
        t->ws = esp_transport_ws_init(t->tcp);
    }
    if (t->ws) {
        const char *scheme_end = strstr(uri, "://");
        const char *path = scheme_end ? strchr(scheme_end + 3, '/') : NULL;
        t->ws_path = strdup(path ? path : "/");
        const esp_transport_ws_config_t wcfg = {
            .ws_path = t->ws_path ? t->ws_path : "/",
            .sub_protocol = NULL,
            .user_agent = NULL,
            .headers = t->auth_header,
            .auth = NULL,
            .propagate_control_frames = true,
        };
        esp_transport_ws_set_config(t->ws, &wcfg);
        esp_transport_set_default_port(t->ws, 80);
    }
    cfg.ext_transport = t->ws; /* NULL falls back to the client's own transport */
    t->client = esp_websocket_client_init(&cfg);
    if (!t->client) {
        if (t->ws) {
            esp_transport_destroy(t->ws);
        }
        if (t->tcp) {
            esp_transport_destroy(t->tcp);
        }
        free(t->ws_path);
        free(t->auth_header);
        free(t);
        return NULL;
    }
    esp_websocket_register_events(t->client, WEBSOCKET_EVENT_ANY, on_ws_event, t);
    return t;
}

esp_err_t ws_transport_start(ws_transport_t *t) {
    if (!t || !t->client) {
        return ESP_ERR_INVALID_ARG;
    }
    return esp_websocket_client_start(t->client);
}

bool ws_transport_is_connected(ws_transport_t *t) {
    return t && t->client && esp_websocket_client_is_connected(t->client);
}

esp_err_t ws_transport_send_text(ws_transport_t *t, const char *json) {
    if (!t || !t->client || !json) {
        return ESP_ERR_INVALID_ARG;
    }
    /* NOTE: esp_websocket_client_send_* takes milliseconds, NOT FreeRTOS ticks. */
    int sent = esp_websocket_client_send_text(t->client, json, (int)strlen(json), 5000);
    return sent >= 0 ? ESP_OK : ESP_FAIL;
}

esp_err_t ws_transport_send_bin(ws_transport_t *t, const uint8_t *data, size_t len) {
    if (!t || !t->client || !data || len == 0) {
        return ESP_ERR_INVALID_ARG;
    }
    int sent = esp_websocket_client_send_bin(t->client, (const char *)data, (int)len, 5000);
    return sent >= 0 ? ESP_OK : ESP_FAIL;
}

void ws_transport_stop(ws_transport_t *t) {
    if (t && t->client) {
        esp_websocket_client_stop(t->client);
    }
}

void ws_transport_destroy(ws_transport_t *t) {
    if (!t) {
        return;
    }
    if (t->client) {
        esp_websocket_client_destroy(t->client);
    }
    if (t->ws) {
        esp_transport_destroy(t->ws);
    }
    if (t->tcp) {
        esp_transport_destroy(t->tcp);
    }
    free(t->ws_path);
    free(t->auth_header);
    free(t);
}
