eleanor-wsyy/EffMeet2/(commit log)

2026-10-04 feat: viewpoint map schema+store+UI, capture tests, qwen skeleton, relay/firmware/hardware scaffolds
2026-10-05 feat: audio session routes, device pairing+media-token, relay WebSocket service, Qwen DashScope real API
2026-10-05 chore: add relay __init__.py, update contracts README with audio session events
2026-10-05 feat: add run_relay.py startup script, update README relay instructions
2026-10-05 fix: unify button copy to 请机器人提醒/不必提醒
2026-10-06 docs(A): 产品文档归位docs/product并补齐——产品说明v4、演示脚本、判断样例、qwen审核报告、对齐议程、D端界面说明、prompt YAML、Figma线框插件、回收箱fixture
2026-10-06 feat(A): 高保真原型三屏——会中常态/候选弹层态/观点地图（Ardot 源文件见设计链接）
2026-10-06 docs(A): D端界面说明升v2——以高保真三屏为准，Ardot源文件链接，文案取自判断样例§3
2026-10-06 docs(A): 新增仓库导览（给D）——目录地图、上手五步、硬规则、今日验收线
2026-10-06 docs(A): 补过程文档——报告修改指南v2（变更记录）、给C移交说明（1005）
2026-10-06 docs(A): 外壳说明v1——抽象形态/状态灯语言/桌面占位/材质工艺/硬件对应/演示镜头建议
2026-10-06 feat: robot_bleed播报自声抑制（代C补软件兜底）+ mock分析器转述格式对齐真机——详见docs/handoff/2026-10-06-A代做记录
2026-10-06 docs(A): LiveKit最小实现任务单——组长指令，今晚冻结前完成（B/C接）
2026-10-06 feat: LiveKit token签发端点（小W代做B/C）+ 20次场景测试用例表（小W代做E）——详见代做记录
2026-10-06 feat: apps/web PWA骨架（小W代做D起步——入会/会中/观点地图/候选弹层，LiveKit接入口预留）
2026-10-06 docs: 代做记录补全——LiveKit端点/测试用例表/apps-web骨架（小W代做）
2026-10-06 feat: AFE配置建议+双讲样例+TTS语气参数（小W代做C的10.05债）——代做记录已更新
2026-10-06 Implement LiveKit remote ASR relay and real Windows TTS verification
2026-10-07 docs(A): 外壳概念图×2（场景渲染+三视图）+ 装配联调联试七步计划
2026-10-07 docs(A): 外壳说明升v2——参考EMO/Eilik打磨：黑玻璃大面板+藏摄像头+发丝环灯+鹅卵石底座+矮墩比例；概念图v2两张
2026-10-08 docs(A): 外壳说明升v3——新增§7功能位规格表（12项量化：位置/数量/可见性）+ 3D建模迭代记录（v3-a形态压倒功能的失败教训）；附模型v3渲染预览
    - §7 功能位规格表作为建模与F结构实现的强制共同输入
    - v3-a 仅形态描述导致功能位全丢；v3-b 改功能驱动后12项全落地
    - 形态偏差（球形轮廓 vs v2蛋形路线）留待裁决
    - 大模型文件不入仓，走 Releases（.gitignore 已排除 glb/zip/obj/fbx）
2026-10-09 docs(A): 总体整改方案v1——P0-1 WAL降级(B)/P1-1 bench兜底(C)/P1-2 删快照(D)/P2 待定夺；附可直接粘贴的派活文案；明确收回给D加--ttl的误建议
2026-10-10 fix: harden SQLite recovery and bench failures; deduplicate participant bundle
    [run_participant.py]
2026-10-10 docs(hardware): unify round-yaw models, procurement and AI handoff
    [EffMeet2_圆润转头版_封装布局_v2.blend, EffMeet2_席位牌_封装布局_v1_审阅.blend]
2026-10-10 docs(hardware): finalize low-operation print plan and component procurement
2026-10-10 docs(hardware): align NOMI-inspired visual with assembly and test guides
    [TEST_RECORD_TEMPLATE.csv]
2026-10-11 docs(hardware): HANDOFF 升至 2026-10-11——更正材料/面罩口径、主板换型、补入路线A/B定义
    解决本文件与 BOM 第12节 的口径冲突（旧节仍写 PA6-CF/PPA-CF/TPU95A/喷漆/激光切面罩）。
    材料与工艺
    - 作废 PA6-CF / PPA-CF / TPU 95A / 喷漆 / 激光切割透明面罩，统一为
    Bambu ABS-GF 白 41100（外观件）/ 黑 41101（面罩框、短颈、支架、带轮等）裸打哑光
    - 柔性件改为采购现成硅胶/EPDM 工业片材，不打印 TPU
    - 一律螺钉连接，不设计需弹性变形的薄卡扣；不喷漆不打磨不退火
    - 补充降级路径：H2S 无法预约时正式件改 PETG @ A1（须打印前决定）
    - 明确 PETG 试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
2026-10-11 fix(hardware): HANDOFF 主板节勘误——撤回「已换微雪」，恢复为待定决策
    397ca9c 把微雪写作「已由组长确认的变更」，与 BOM.md §12.1
    「不采用第11节微雪换板分支……本轮保留Korvo基线」及 §12.2 E01
    （Korvo-2 V3.1原版）直接冲突，属于把待定项固化成决策的错误。
    修正内容：
    - 顶部警示块 ① 由「已变更」改为「尚未拍板」，引用 BOM §12 原文，
    明确「BOM §12 被显式修改之前，采购一律按 Korvo 执行」
    - 「先确认三件事」补第 2 条：主板选型未定，不要把任何一方的推荐当决定
    - 主板节改写为「待定（Korvo-2 vs 微雪）」：两条路对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
2026-10-11 docs: 统一口径并删除过时说法
    - README/交接记录: 测试 61 → 102/102(实跑)，删过期数字
    - README: 按钮文案统一为「请机器人提醒/不必提醒」，补视觉模型真实口径(默认 qwen-vl-max)
    - README: 跑满测试需另装 requirements-media.txt(livekit)
    - 装配联调计划: 删不存在的外壳说明_v1 引用，90×90×110 → 180×164×222，灯效改按状态表，#18 错引改 T07/#11/#12
    - 给C移交说明: 断链 D端界面说明_v1 → v2
    - 判断样例: 删已完成的按钮改文案任务(§3.4)
    - 报告修改指南: 删「现为旧文案」失实描述
    - 仓库导览: 26 个 schema → 25
    - archive: 删声称存在实则不存在的文件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
2026-10-11 docs(hardware): 布局 A/B 两套候选方案并行推出（W 主板前提，未决策）
    前提：主板走方案 W（微雪 ESP32-S3-CAM-OV3660），形态服从工程实际，按新板重切建模。
    - layout-options/README.md 二选一说明、决策判据、决策后同步清单、红线
    - layout-options/layout-A-base-board.md 板在底座：完整采购包 + 建模包 + 验收 + 工期
    麦克风固定在底座(不随头转)；需 E04/E05 跨轴 FPC；过轴寿命为第一验收项
    - layout-options/layout-B-head-board.md 整板进头部：完整采购包 + 建模包 + 验收 + 工期
    删 E04/E05/E13；代价是麦克风随头转(C06 须改写)、头部加重须核 SG90 带载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
2026-10-11 docs(hardware): 建模更新任务书——美学锁死、工程重做
    工程方案换了（主板 Korvo → 微雪），但上一版 NOMI 方向的审美模式原样保留。
    仓库 v3-a 的教训是「形态压倒功能」；本次对偶风险是「工程改造压倒审美」，故先锁死审美再改工程。
    MODELING_BRIEF.md：
    - 美学不变量（禁止改动）：球头/Ø104-108圆黑面板/眼睛/摄像头/短颈46mm轴径14mm间距/鹅卵石底座/开孔/材质
    全部逐条摘自已认可的 concept/nomi-aligned-20261010/prompt.txt 审美契约原文
    - 15 条「不许乱整」红线（禁止加耳帽喷漆/禁止带回小横窗/禁止缩孔换好看/禁止移麦孔迁就对称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
2026-10-11 feat(hardware): 配合样片 STL + 材料改 PLA Matte + A1/学校机器分工
    材料变更（2026-10-11，实验证实）：实验室通风不允许打 ABS/ASA；自有 A1 无腔温亦不适合 ABS。
    全件改用 PLA Matte 哑光（机身灰 / 细节黑，已下单 2 灰 + 1 黑），全 14 件统一同料。
    - PLA 收缩极小、几乎不翘，恰是大壳最需要的；自带磨砂哑光，观感接近原 ABS-GF 目标
    - 代价：偏脆 + 热变形约 55℃ → 必须螺接/分体夹紧、不做强过盈、不做薄弹卡扣（BOM 已有此约束）
    - 连带：普通 0.4 喷嘴即可（无需硬化）、无需封箱、无需 80℃ 烘干
    新增 round-yaw-v2/fit-coupons/：
    - 01_bearing_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
2026-10-11 docs(hardware): 定案布局 A，收敛为单线，A/B 候选归档
    决策：主板走方案 W（微雪 ESP32-S3-CAM-OV3660），布局走 A（板在底座、麦克风固定不随头转）。
    理由从产品功能倒推，不是工程省事：
    - 拾音是命脉（现场说话→麦→ASR→千问→证据链），麦随头转会让 ASR 准确率变成头部朝向的函数
    - 而机器人转头的时刻恰是最需要稳定拾音的时刻
    - B 会推翻 C06「麦克风不随头转」的既有产品规则
    - 宠物形态：A 头轻转得灵动；B 头重 SG90 吃力
    - 代价性质不对等：A 是工程努力（两条排线），B 是产品功能缺陷（拾音不稳，修不了）
    清理原则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
2026-10-11 feat(hardware): 新版安装指南 + 打印件 STL + 渲染（布局 A）
    ASSEMBLY_GUIDE.md 重写为 v2（微雪主板 / 布局 A / PLA Matte）：
    - §0 新旧版对照表（主板/屏/相机/USB/PWM/电池/跨轴/材料/喷嘴/干燥）
    - §3 装配位置速查按布局 A（麦在底座不随头转、E04/E05 跨轴、14mm 间距、46mm 轴径）
    - §4 八步安装，每步带小测；第八步含 50 次转向与 30 分钟运行
    - §5 装配检查单 14 项（含「麦克风不随头转」专项）
    build_print_parts.py：Blender 无头建模脚本，生成 12 个 STL（覆盖 14 件打印件）：
    01 头壳 150×128×130 / 02 底座杯 180×164×64 / 03 上盖 / 04 圆黑面板 Ø106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
2026-10-11 fix(docs): 消除 BOM 与 HANDOFF 互相打架，补采购执行状态表
    ① HANDOFF 顶部摘要与变更日志条目仍在说「保留 Korvo 基线 / 不采用微雪 / 采购按 Korvo 执行」，
    与 BOM §12.1「采用微雪 + 布局 A」直接矛盾——这正是本仓一直在防的「两份文档打架」。
    已改为：BOM §12 已定案微雪 + 布局 A，Korvo 基线作废，采购一律按 BOM §12。
    ② BOM §3 与 §5 的 E07/E08 仍写 Micro-USB（Korvo 时代口径），与 §12.2 的 Type-C 矛盾。
    已统一为 Type-C，详述标题同步。
    ③ 新增 BOM §12.0「采购执行状态」——接手者先看这张表：
    ✅已下单（PLA Matte 灰2+黑1、P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
2026-10-11 docs(hardware): 自取微雪官方引脚定义与屏选型，解除建模阻塞
    卖家客服与 wiki（「紧急编写中」）都给不出，改为直接从微雪官方 BSP 源码 +
    原理图 PDF 取得。新增 round-yaw-v2/WAVESHARE-BOARD-SPEC.md。
    拿到的硬信息：
    - 完整 GPIO 表（I2C / I2S 双麦+功放 / LCD SPI / 24PIN DVP 相机 / SD / 按键 / 电池）
    - **屏选型定了：2.8″（或 2.0″）320×240，RGB565，SPI/QSPI，官方驱动内建** → E02′ 可下单
    - **LCD 是 SPI 单线**（DATA0/PCLK/DC/CS + 触摸2 + I2C2），不是并口
    → **E04 跨轴 FPC 可以做得很细，布局 A 的第一风险显著下降**
    - OV3660：2048×1536、**硬件 JPEG**、镜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
2026-10-11 docs(hardware): 按微雪官方规格落死口径（屏/FPC/停止键）
    - E02′ 定为 **微雪 18PIN SPI 屏 2.8″ 320×240 RGB565**（官方驱动内建 BSP_LCD_SIZE_2_8INCH），
    可直接下单，不必再等接口定义；空间紧退 2.0″（同 320×240）
    - E04 改为 **LCD 跨轴细排线 ≈10 芯**（DATA0/DC/PCLK/CS + 触摸INT + I2C×2 + 电源）——
    官方 LCD 是 SPI 单线不是并口，布局 A 的过轴风险实质下降
    - E05 明确 **摄像跨轴 12 信号**（XCLK/PCLK/VSYNC/HSYNC + D0–D7）+ 电源
    - E11 简化为 **板载 BUTTON1(GPIO15) 引出**，不必另买按键模块
    - C06 麦孔明确按**实板双麦位**开（板载 ES7210 麦阵列）
    - MODELING_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
2026-10-11 docs(hardware): 主板改 GOOUU ESP32-S3-CAM，全仓口径同步
    主板决策（2026-10-12）：微雪 ESP32-S3-CAM-OV3660 → GOOUU ESP32-S3-CAM（带 OV3660）。
    理由：微雪国内拿货要等（官方海外链路），赶不上 10.21；GOOUU 次日达，¥7 起，
    已售 2000+ / 评价 700+ / 近3月好评 100%，且**板体尺寸图已拿到（62.6×28.3mm）**。
    代价（如实记录）：GOOUU 无板载音频（无麦/无编解码/无功放/无电池管理），
    须外接 INMP441×2 + MAX98357 + TP4056；AEC 失去硬件回声参考通路，只能软件兜底。
    新增 round-yaw-v2/GOOUU-BOARD-SPEC.md：
    - 板体 62.6×28.3mm、排针 2.54mm/内侧 24.7mm（尺寸图实测标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
2026-10-11 docs(hardware): 主板已下单 GOOUU 套装 ¥86.5，屏接口判定 SPI
    采购（2026-10-12）：
    - ✅ 已下单 **GOOUU 套装「核心板+OV3660+扩展板+2.8寸TFT」¥86.5**，次日达
    比拆买更便宜，且商品实拍已验证能跑（屏上显示摄像头画面）
    - E02 屏已含在套装内，**不再单独采购**
    屏接口判定（关键）：
    - 面板丝印 HSD028309 A6；连接器为**单排 14 针 J2**
    - 8 位并口模块一般是 2×10 双排 20 针 → **判为 SPI**（高置信度）
    - 标准分配：VCC/GND/CS/RESET/DC/MOSI/SCK/BL/MISO + 触摸 5 线
    - **E04 跨轴只需 ≈7 芯**（VCC/GND/CS/DC/SCK/MOSI+背光），布局 A 过轴难度维持低位
    - 待办：下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
2026-10-11 feat(hardware): add NOMI GOOUU layout A model, render boards and synchronized guides
2026-10-12 fix(hardware): stl/README 笔误——当前基线是 GOOUU v4，不是微雪
    v4 提交把旧 stl/ 正确标注为历史草案，但说明里写成「不能对应当前微雪／NOMI-v4」，
    应为 GOOUU。微雪方案已归档，当前基线是 GOOUU 套装 + 布局 A。
2026-10-12 docs(hardware): 新增打印件拆分方案，交给建模接管方
    新增 revision-20261011-nomi-layoutA/SPLIT_PLAN.md——任务书 + 现状说明，不含已完成拆分。
    本轮起建模/渲染/拆分全部交接管方，本文件只定义「拆什么、按什么规则拆、拆完要满足什么」。
    一、硬件现状
    - GOOUU 套装已下单 ¥86.5（核心板+OV3660+扩展板+2.8TFT），板体 62.6×28.3mm
    - 无板载音频 → 必配 INMP441×2 / MAX98357 / TP4056（含 v4 预算尺寸与候选位置）
    - 6806×2、MG90S、GT2 64T/64T 候选参数
    - 硬件边界 5 条（GPIO 需统一核表、BOOT 是启动脚、TP4056 非 5V 升压、屏 J2 定义未冻结、禁裁 FPC）
    二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
2026-10-12 docs(hardware): 拆分方案补合盘策略（§五）
    用户提出：小件应尽量合盘打，不该每件单独一盘。已采纳并成节。
    新增 §五 合盘策略：
    - 5.1 分组约束：颜色不能混盘、层高同盘共用、朝向可逐件设、墙/填充可逐件、
    高风险的件不与非关键件混盘、小件同盘多打备件
    - 5.2 盘表：
    灰 G1/G2/G3 三件大壳各独立成盘（单件失败不连坐，学校并行更省时）
    黑 B1 外观盘：面板+短颈+滑盖+键帽（0.16mm，表面优先）
    黑 B2 结构盘：轴承座×2+舵机架+轮毂+带轮×2（0.20mm，4-6墙，逐件朝向）
    黑 B3 小件（线夹/声学通道/限位）建议并入 B2
    -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
2026-10-12 docs(hardware): HANDOFF/README 会话收尾——当前状态与下一步
    本会话结束前的交接收口，确保下一位接手者从 HANDOFF 顶部就能自足启动。
    HANDOFF 新增顶部「2026-10-12 会话收尾」节（优先于其余全部内容）：
    一、已定案不可回退：路线A / 布局A / GOOUU / PLA Matte / NOMI 美学；
    作废名单（微雪、Korvo、ABS-GF、圆屏透明罩喷漆、布局B）
    二、采购状态：已下单 GOOUU 套装¥86.5 + PLA Matte 灰2黑1；
    待下单 INMP441×2 / MAX98357 / TP4056 / 扬声器 / 6806×2 / MG90S / 锂电 / 五金线材
    三、已交接出去：建模+渲染+拆分 → 接管方；指向 SPLIT_PLAN；
    并写明当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
2026-10-12 docs(hardware): 采纳执行方对 SPLIT_PLAN 的四条修正
    执行方反馈四条全部成立，已改：
    ① 朝向不得写死。删去「轴承轴线水平就能保证孔圆」这类绝对表述，
    改为「待定：须同时权衡孔形／受力层向／支撑，由切片预览＋样片实打决定」，
    §4.2 表格打印方向列改标「待定（见 §5.2 朝向导则）」
    ② PLA 不得称「免干燥」。改为「吸湿性低于 ABS/PA、拆封即可打；
    受潮时仍须按拓竹官方 PLA 干燥参数处理」（SPLIT_PLAN + HANDOFF 同步）
    ③ stage 是阶段枚举不是布尔。改为「stage 保留 reversible_blockout；
    final_design_approved / manufacturing_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
2026-10-12 feat(hardware): 新增外观/材料样片 A0，供下午上机
    用户今天下午去学校实验室。拆分方尚未推送成果（远端停在 570cd30），
    现有可直接上机的只有样片。补一件外观样片，让下午这一趟有实质产出。
    fit-coupons/A0_appearance_coupon.stl（单件 148×97×54，落平台 Z 0→53.8）：
    - 球冠 R70 × Ø88 —— 贴近头壳曲率量级，验曲面质量与层纹、哑光观感
    - 45° 悬臂 —— 验支撑痕（需支撑）
    - 2.4mm 薄壁 —— 验名义壁厚
    - 孔阶梯 Ø2/3/4/5/6 —— 验小孔成形
    - R4 圆角块 + 竖直平面 —— 验倒角与层线密度
    性质：这是 PRINT_PLAN 里「样片接受裸打哑光后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
2026-10-12 chore(hardware): 删除旧 STL 草案，清理引用；样片安排到自有 A1
    用户指示：「旧stl直接删掉就行」。
    - git rm -r hardware/robot-design/round-yaw-v2/stl/（12 个 v2 时代草案）
    它们是旧 build_print_parts.py 生成物，尺寸为旧屏/旧板预留，已多次标注不得打印
    - 清理 6 处引用：HANDOFF / robot-design README / ASSEMBLY_GUIDE / PRINT_PLAN /
    round-yaw-v2 README / v4 README，统一改为「已于 2026-10-12 删除」，
    不再指向已删目录；build_print_parts.py 保留为历史源
    - manifest.json 未登记 stl/，无需改；verify_delivery 无影响
    fit-coupons/README 更新上机安排：
    - 材料用 **PLA Matte 灰**（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
2026-10-12 feat(hardware): deliver 41 NOMI v5 candidate print parts and synchronized assembly guides
2026-10-12 docs(hardware): 新增 v5 打印执行手册（盘×机器×特殊设置）
    建模方交付几何与盘起点，但切片/机型/材料/支撑留给了打印方。
    本轮把执行口径落成文档：PLATE-RUNBOOK.md。
    一、盘表 + 推荐机器
    - G1-1 头壳 / G2-1 杯体 → **学校 H2S / H2D**（体积余量 + 并行；A1 也能整件打）
    - G3-1 上盖（171×156×17，3–4h）→ **自有 A1**，不值得占学校机时
    - B1-1 / B2-1 / B3-1（黑 38 件）→ **自有 A1**，小件需迭代
    - S1 / S2 / A0 样片 → **自有 A1**
    - 关键前提：6 个 3MF 全按 256×256 排 → A1/P2S/H2S/H2D 都能直接打
    二、每盘特殊设置
    - G1 头壳：层高 0.16 + **Brim 仅外侧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
2026-10-12 docs(hardware): BOM §12.0 重排为采购执行七区表；统一旧口径(灰壳/暖白眼/硬化钢/干燥档/来源)
2026-10-12 docs(hardware): HANDOFF/README 收尾——打印进度(G1/G2 上机)、今晚下单口径、PLATE-RUNBOOK 入口
2026-10-13 feat(hardware): v6紧凑候选（布局A2）——整机153x139.4x200.8，核心板/屏/摄像头进头，2:1传动，31件+6盘3MF
    - 布局A2：摄像头FPC实测仅14mm，核心板+屏+摄像头移入头部；麦/功放/扬声器/舵机/按键固定底座，麦不随头转；跨轴约9根细软线穿22mm轴孔
    - 尺寸：180x164x222 -> 153x139.4x200.8；头宽150->132；底座剖面x0.85；壁厚2.4不变
    - 移除：扩展板(95x87x12放不下)/电池/TP4056(推迟路线B)；新增后部USB-C供电小板预算
    - 传动2:1：MG90S->32T->64T，GT2 188mm闭环带6mm，C=44.84；软限45/硬限48
    - 检查：5外壳0非流形0边界1连通块；31件两两重叠0；代理全包容；三姿态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
2026-10-15 print(hardware): 10-15 打印执行落地——B方案合并盘/v6r2 LCD重建/教训集/待测清单/安装手册
    - B方案：黑料1卷只打外露件B1p-v2，机构/支架改灰并行；plates-merged 出 SAFE/THIN+P25/G3p/B1p-v2/G1/Bsmall 盘
    - v6r2：LCD四孔实测77x45/孔径4 取代80x45假定，Blender4.5隔离重建P23/P24/P25（其余28件0漂移）
    - THIN 支柱改解析干净管（旧环状导出网格致切片丢层炒面）；P16 杯口朝上
    - 新增 MEASURE-TODO（待测全量+A组已测回填）、PRINT-LESSONS（21条避坑）、ASSEMBLY（六步安装手册）
    - MEASUREMENTS.csv 回填 LCD/CAMERA/MAINBOARD 实测；状态纪律不变（reversible_blockout/NOT_RUN）
2026-10-15 print(hardware): 10-16 明早三机排程预排 + 补打/样片盘 + v6r3 P01容差窗
    - 明早: H2S-B=BMORN黑补打(P14法兰朝下/P28/P21P22平躺, 朝向烤死+NIGHT失败件并入), H2S-A=G3p重打, H2D=S2配合样片盘
    - 朝向坑: P21/P22 原euler90立1mm边应平躺; P14须翻180法兰贴床 (manifold3d逐层截面扫描发现)
    - v6r3: P01后USB-C开口容差窗13.5x9.5, 杯体不再等SKU; 麦袋按INMP441中心孔承诺非阻塞
    - 新增盘: TMP-BMORN_BLACK_016 / TMP-COUPON_GREY_020 / TMP-G2p_GREY_020 + P01_v6r3 STL
2026-10-15 docs(hardware): MEASURE-TODO 升级 v2 详细可执行版
    每项含量法/工具/接受判据/解锁件/超差处置：A已测6项留档、B到货验证6项、C五金片材7项、
    D S2样片读数4项、E打印过程数据3项、F设计阻塞仅USB-C板SKU 1项；DEFERRED=TP4056/电池。
2026-10-15 print(hardware): 过夜队列三机拉满 + BNIGHT2 黑质量盘(7件合并) + 全件截面审计
    - 过夜: H2S-A=G2NIGHT(P01+P11重打)->G3p; H2D=G1->COUPON; H2S-B=NIGHT->BNIGHT2
    - BNIGHT2: NIGHT四废(P04/P20/P21/P22)+B1p两废(P14/P28)+P18T容差托架 合并7件, 0.12质量档, 支撑仅在打印板生成
    - 朝向审计: P21/P22/P28 平躺、P14翻面 烤进网格; manifold3d逐层截面全件clean记录入RUNBOOK
    - 明早最小集: inspect+样片读数+失败补打+试配装配, 无必打新盘
2026-10-15 fix(hardware): 空层警告真凶=墙层数6塞不进薄特征; 全局改墙层数4; 教训22/23更正误判
2026-10-15 docs(hardware): 提醒已存预设含墙层数6需改4后UI重存覆盖
2026-10-15 docs(hardware): MEASURE-TODO 补 B7 MAX98357A(安装孔直径/板厚/含排针总高), 新手指南同步含该卡
2026-10-15 chore+docs(hardware): 晚间收尾——清理归档/参数可复现/新手指南入仓/文档更新
    - plates-merged 9个作废盘归档 _superseded/（未硬删，git可溯）；有效8盘+ v6r2/v6r3 STL
    - build_v6.py 参数同步 v6r3：lcd_boss_rect=77x45、后USB-C容差窗13.5x9.5（仓库源可复现全部新STL）
    - 新增 MEASURE-GUIDE.md（新手图文测量指南源；PDF在outputs）
    - HANDOFF/README 更新：墙层数4真凶、今晚最终队列(BNIGHT2待打)、清理与可复现说明
2026-10-15 docs(hardware): 新手测量指南图文资源入仓(8图+PDF) + A1 PETG 两盘(耐磨备件/ S1样片备份)
    - guide_img/ 8张参考图使 MEASURE-GUIDE.md 在 GitHub 可直接图文浏览; MEASURE-GUIDE.pdf 供下载打印
    - TMP-SPARE-PETG-A1: P27/P28/P30/P31/P13 PETG耐磨耐冲备件(A1首选)
    - TMP-S1PETG-A1: S1 PETG样片备份(仅当H2D PLA样片失败时顶位)
2026-10-16 feat(hardware): 学妹交付归档+P32胶座取代P21/P22(INMP441焊盘外凸17-18)+湿料教训
    - review-20261016-measure/ 归档交付(总表/回填csv/照片初判/20张筛选照片)
    - MEASUREMENTS.csv 回填照片定性: ZZ盖/TIANKONGRC MG90S/4Ω3W钢印/焊盘外凸/侧焊疑/底孔缺拍
    - P21/P22 作废->P32 胶座x2 (TMP-MICHOLDER-GREY_020); P01 不返工壁袋环弃用
    - 新增盘: INTERN-GREY(内部5件改灰躲湿黑料), BVIS-BLACK(烘后外露2件)
    - 教训24照片定性拦设计坑 / 25湿料炒面主因
2026-10-16 print(hardware): INTERN2 合并盘(P04/P20/P18T+P32x2), 旧INTERN含作废P21/P22 归档
2026-10-16 print(hardware): 周末A1 PETG替身盘(P14颈+P28滑片), 学校周末关门不卡总装
2026-10-16 docs(hardware): MEASURE-TODO升v3(学妹交付后重划: 销账5组/卡尺路10组/补拍路8组) + CSV补INMP441焊盘总宽与底孔两行
2026-10-16 print(hardware): BVIS-TILT 斜打实验盘(P14倾45+P28), 需筏层+树支撑; 直打版BVIS并存
2026-10-16 docs(hardware): ASSEMBLY 升 v2 按完工件实写(23完工+7在打/待打+缺件替代法)
    - 修正组员反馈的"零件与指南不匹配": 删除作废压圈/旧P18引用, 正文改用 P32 胶座/P18T 容差托架
    - 完工清单标来源盘与颜色; P01 壁袋环弃用注明; 缺件临时替代(胶固开关/Type-C供电/双面胶麦/PETG替身颈/敞口台架)
    - 废品不列; 纪律与26项验收指针保留
2026-10-16 docs(hardware): ASSEMBLY 零件图鉴总表——30张建模渲染证件照(parts_img/, Workbench等距正交)+标号/颜色/状态/缺件替代一表对齐; ⏳待打行留勾选位
2026-10-16 docs(hardware): 旧装配指南作废留跳转桩(v4版/v5版), EXTERIOR_ASSEMBLY_REVISION 加弃用横幅; 唯一有效=print-split-v6/ASSEMBLY.md v2
2026-10-16 print(hardware): 机房老师反馈整改——P02/P04 平面融解减面重出盘
    - P02 盖 18134->13614 tris (1.5deg, vol d0.077%, ext 逐位不变); P04 带轮 4896->1266 (5deg, vol 0.000%)
    - 新盘 TMP-G3p-DEC_GREY_016 / TMP-INTERN2-DEC_GREY_020; 旧盘 .SUPERSEDED-by-dec
    - decimated/ 存减面 STL; 过密网格致切片周长路径过密/内部碎填充的整改依据见 PRINT-LESSONS
2026-10-16 docs(hardware): ASSEMBLY升v3(去抽象:动作+判据+常见错+参照图; 新增§0.5工具与测试用具含梯条样片) + HANDOFF 10-16节 + README盘清单刷新
2026-10-16 docs(hardware): README 盘清单刷新至10-16(DEC盘/替身盘/斜打盘/减面STL)
2026-10-16 docs+tools(hardware): 减面/证件照/合盘脚本入仓tools/ + 教训26-29(减面阈值/全墙件澄清/交付查量具/收尾扫内容滞后)
2026-10-16 chore(hardware): 中间态清理+工作区产物归仓
    - MEASURE-GUIDE.md 刷新为带图+B7版; 新增 PRINT-PLAN.md / NEXT-STEPS.md (原仅在工作区)
    - 删除 plates-merged 过期件: tmp-plates-layout.json, 3个.SUPERSEDED盘, _superseded/归档目录(9废盘, 历史可溯)
    - 工作区中间态(v6rebuild隔离副本25MB/散图/一次性脚本/空目录)已清, 脚本在tools/
2026-10-17 feat(software): 未完成软件搭框架——ESP32固件骨架(EFMA/WS/命令回执状态机)+LiveKit公网部署骨架+连续实机验收harness(全NOT-VERIFIED,未编译未部署); 单测106 OK无回归
2026-10-17 docs+tools(hardware): P20排查收口——几何无罪/墙层数排除/预设铁证(0.20H2S=wall6+sbpo0未重存)+教训30-36+薄壁·盘登记·减面三工具+SLICE-CARD/无源件专账/RUNBOOK§6盘表; 未改任何几何
2026-10-18 docs+print(hardware): ASSEMBLY v4 顺序修正+螺钉表+版本陷阱; 新增P02+P20补打盘/设置卡/零件表PDF/安装手册PDF
2026-10-18 docs+print(hardware): 10-18 重打成功配方（P03翻/P05P06不翻/P06阻挡器/P28 brim）+ 教训37-47 + 重打文件
2026-10-18 fix+print(hardware): P15/P17/P26/P29 配合修复——建模源(口袋+1.2/M2柱/镜管Ø6.5/槽+0.2)+四件合一盘0.16+盘卡+三视图(新增俯视04_top)
2026-10-18 fix(hardware): 更新 v6 紧凑候选 blend——P15/P17/P26/P29 配合修复(P17安装柱融合/功放代理抬高)
2026-10-18 fix+print(hardware): P15/P17/P26/P29 修复盘v2——P26转90°、P15/P17局部支撑、P24摄像孔6.8、源/件表/RUNBOOK同步
2026-10-19 feat(participant-app): add scan, camera stage, settings and chronological transcript
2026-10-19 feat(participant-app): simplify scanner, remove device picker, add meeting control bar
2026-10-19 fix(hardware): P15 出线卡滞返修——耳垫导孔加孔底(线不再楔入)+M3导孔改盲孔(螺尖不顶线)+P15B单件盘+盘卡
2026-10-19 fix+print(hardware): P29 插不稳根因=耳槽距板边0.9mm没咬住——耳槽咬边0.6+槽1.7/底槽28.5+P29B单件盘+盘卡+检验单P29/P15判据
2026-10-19 fix+print(hardware): P27/P28 滑片会掉根因=导轨前挡墙0.2mm打不出——导轨2.0/挡墙0.8+滑槽1.2+拨片加长2.2+P27P28合盘+盘卡+检验单P28节
2026-10-19 feat+print(hardware): P23/P24 大平脸圆角屏区——P24 106×96R21 面板+屏窗62×46、P23 圆角方前口+116×116R40 边框；摄像头/LCD 柱位不动 P25-P28 沿用；灰黑分两盘+盘卡
2026-10-19 feat(software): route-A LiveKit/ASR acceptance + ESP-IDF build
    LiveKit participant/host audio, token/CSP/phone gateway; real S1/S2/S3/S6 acceptance paths; remote audio relay stream_id contract fix; ESP-IDF v5.4.1 firmware build and size; standalone /app-demo; tests/docs. Qwen key only via env, never committed.
2026-10-19 fix(software): address agy review findings
    CSP allows ws/wss + http(s) LiveKit probes and sanitizes netloc; media session race/superseded error fixed; token service malformed JSON returns 400; relay tasks cancelled on shutdown; ASR acceptance keeps error detail; regression tests added.
2026-10-19 docs(hardware): 修过时表述+补 FACEFLAT 当前版次指引——P23/P24 大平脸入 README 文件表与 PARTS 指向；ASSEMBLY §8 版本陷阱改指 FACEFLAT/RETAINFIX；P28 装法改为槽内滑动（旧“盖在上面滑动作废”）；AGENTS.md 加找件指引（v5 旧编号/candidate/v6r2 仅历史）
2026-10-19 fix+print(hardware): v6r3——P15尾端出线让位槽+P26重设计(镜头入P24孔导向/M3背柱)+新增P33背板;重建32件verify PASS;修复盘reprint-20261019-v6r3;其余29件STL字节不变
2026-10-19 chore: gitignore 排除切片器 result.json 回执
2026-10-20 feat(firmware): add serial-port detection and flash script
    Auto-detects Espressif/CH340/CP210x COM port and flashes the built ESP32-S3 image; refuses when no board is visible and prints cable/port/driver checks.
2026-10-20 feat(firmware+device): LAN gateway, events WS device token, UART provisioning, command subscription, real flash/boot
    events WS accepts device_id+media_token with meeting binding; device gateway proxies only device routes; firmware adds UART provision REPL and robot.command subscription over the events WS; ESP32-S3 N16R8 flashed and boots to the REPL.
2026-10-20 feat(firmware): status LED (WS2812) and MG90S servo drivers, REPL led command
    status_led uses led_strip on GPIO48; servo_yaw uses LEDC on GPIO38 with 2:1 head mapping; provision REPL gains test command. Real board boots; LED commands verified over UART; servo not moved.
2026-10-20 feat(firmware): I2S audio drivers (INMP441 RX + MAX98357A TX), REPL mic/tone/i2srate bench commands
    - audio_capture: std RX 16kHz mono, 32-bit slot truncated to s16; DMA/clock
    bench-verified on real board (mic 50/50 frames; content pending mic wiring)
    - audio_playback: std TX 16kHz mono, amp SD/EN gate, DMA flush on begin,
    drain-before-complete boundary for RobotReceipt(completed)
    - provision REPL: mic (RMS/peak), tone (sine), i2srate (DMA completion rate)
    - fix: i2s_channel_read/write timeouts are milliseconds, not ticks
    - docs: FIRMWARE_STATUS + 2026-10-20 bring-up handoff
2026-10-20 fix(firmware): wait for WS handshake in command_task, DHCP before sockets, REPL always on
    - command_task destroyed the still-connecting WS client in a 2.3s retry loop;
    esp_websocket_client_start is async, so poll is_connected up to 5s first
    - wifi_init_sta now waits for a DHCP lease before the session task opens sockets
    - provisioning REPL runs even when paired (re-provision without NVS erase)
    - verified on hardware: board joins PC hotspot (2.4GHz), events WS long-lived,
    injected robot.command triggers playback WS (gateway log)
    - docs: FIRMWARE_STATUS + handoff updated with hotspot recipe and contract notes
2026-10-20 feat(firmware): REPL uplink command + active-session accessor; uplink EFMA verified on bench
    - provision REPL gains 'uplink <session_id> <stream_id> <stream_key>' which
    spawns a task running device_session_run_uplink against the relay
    - device_session_create/destroy track the single active session
    - verified end-to-end via PC hotspot + LAN gateway: bench media-bindings bind,
    board streams EFMA frames, server decodes until SESSION_TOO_LONG (expected
    at ~30s of 16kHz s16le), binding/session close cleanly
    - docs updated (FIRMWARE_STATUS, 2026-10-20 handoff)
2026-10-20 docs+sync(hardware): v6r3/FACEFLAT 全仓同步——parameters(FACEFLAT/6.8/跨距10.75/32件)、plate-registry+RUNBOOK§6新盘行、parts_img全量重出(含P33)、4.2版P24盘件与P15B改名SUPERSEDED、INTERFACE_GATES状态刷新(LCD已实测/FACE压配/CAM v6r3)、th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
2026-10-20 docs(hardware): 安装手册升 v5——ASSEMBLY 抬头/总装顺序页/图鉴表更新(含P33行+10-20版次状态)；事实修正(P23走线孔=颈孔Ø40.6非18.3;P29槽EDGEGRIP 1.7/28.5/咬边0.6)；新增 make_assembly_pdf.py(v4风格PDF生成器:藏青/青绿/图鉴表/页脚)；出 PDF v5-20261020
2026-10-20 chore(hardware): 删除安装手册 v4 旧 PDF（防误导，历史留 git 记录）；README 文件表指向 v5 PDF+生成器
2026-10-20 feat: speak E2E verified on hardware - TCP_NODELAY, cmdq dispatch, playback deadline
    Firmware:
    - device_session: robot.command dispatch moved from the WS event callback into a
    cmdq queue consumed by command_task (speak no longer blocks the WS client task);
    playback frame timing instrumentation; dispatch logging
    - ws_transport: custom ext transport (esp_transport_tcp + esp_transport_ws) to set
    TCP_NODELAY on the device socket - Nagle+delayed-ACK was stalling each EFMA
    frame/ack round-trip at ~175ms; now 22-28ms. ws_path/headers must be configured
    manually when ext_transport is used (the client skips its own ws config)
    Bench:
    - app.py: EFFMEET_ROBOT_ID env to target a real paired ro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
2026-10-20 feat: playback PCM content stats + one-shot re-pair script
    - device_session: track decoded PCM peak/RMS during playback and log a summary
    before attesting RobotReceipt(completed) - numerically proves real TTS audio
    flows the downlink even with the amp unwired (verified: 711 frames,
    peak=30173/32767, rms=2441)
    - scripts/reprovision_board.py: re-pair + serial provision in one command for
    the 1 h media_token TTL (token goes to device NVS only, never printed)
2026-10-20 docs(hardware): 手册补「装机总流程」——从零到上电连续37步(A准备/B底座电子/C传动/D穿线合婚/E头部子装/F合头收线/G上电)，每步动作+判据+用料+对应细节节；PDF v5 重出(7页)
2026-10-20 docs(hardware): 新增装机图解版——白话+零件照片+名词小词典+分阶段目标+卡住速查;生成器支持任意源/页脚/输出名;出 PDF 12页(与工程手册同编号)
2026-10-20 docs(hardware): 图解版改卡片式排版+自包含——阶段横幅/步骤卡/合格标准绿框/警告橙框/螺丝包备料表/功放接线表/9根线清单/卡住速查;不再依赖工程手册即可装机;生成器支持md_in_html卡片与占用文件兜底;PDF 10页(-new名,原文件被阅读器占用待换名)
2026-10-20 docs: machine-switch handoff + flash status sync; pin pyserial
    - docs/handoff/2026-10-20-machine-switch.md: new-PC resume guide covering the
    flashed firmware state (df55750, verified features), environment rebuild
    (ESP-IDF .local, .venv, pyserial), PC hotspot recipe (2.4GHz WinRT), bench +
    gateway launch env, REPL commands, gotchas and regression checks
    - FIRMWARE_STATUS: playback PCM content stats (711 frames, peak 30173,
    rms 2441) and reprovision_board.py for the 1 h token TTL
    - requirements.txt: add pyserial==3.5 (reprovision/serial scripts)
2026-10-20 docs(electronics): bench wiring table aligned with firmware app_config.h
    Power rails (3V3 mic / 5V amp / independent servo 5V via CH340 tap, common GND),
    INMP441 + MAX98357A + MG90S + WS2812 pin table, occupied GPIO summary,
    REPL bench verification commands
2026-10-20 docs: INMP441 real-wiring capture verified on bench (quiet rms=65 vs 1kHz tone rms=394)
    Mic wiring per hardware/electronics/wiring-bench.md confirmed working;
    amp digital path drop-free, audible check pending speaker attach
2026-10-20 feat(firmware): REPL servo command; MG90S bench-verified (0/+45/-45/0, no brownout)
    - provision REPL gains 'servo <head_deg -45..45>'
    - MG90S wired per wiring-bench.md and swept through the full head range on
    independent 5V - no reset, all moves ESP_OK
    - speak re-verified silently on the fully-wired board (711 frames, completed)
    - uplink re-verified with the real mic wired (bind/active/closed lifecycle)
    - docs: FIRMWARE_STATUS servo row + wiring-bench verification notes
2026-10-21 docs(hardware): 图解版v2重写(37步+28张状态图+零件对应表) + P03装配悖论双证与修复件
    - 图解版全量重写：每步=干嘛→怎么做→装完长这样→判据→坑；新增 28 张装配状态图 steps_img/（tools/render_step_states.py 按步骤切可见性批量渲染）
    - 新增零件对应表：32 件（件号/照片/数量/装在第几步/版本备注）
    - 实测(blend evaluated + 打印 STL 射线剖面)发现 P03 装配悖论：z41–52 位于两轴承座间，法兰Ø43.2/座孔Ø42.3/唇Ø38.4/D孔Ø30.1/轴肩Ø34.5，四条穿入路径全封——手册 §2-7 新增决策门（路径1 扩孔+衬套 / 路径2 对开抱轴）
    - P13 定位更正：D 孔键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
2026-10-21 docs(hardware): 全仓清理过时教程与口径不一致（31→32件、TP4056/扩展板/布局A旧口径、旧链接改指v6）
    - 件数口径 31→32（28 行）：根 README、robot-design README、BOM §12 两处；SLICE-CARD 注明审计时31/现32
    - TP4056/扩展板/电池旧口径：robot-design README（采购状态+说明）；GOOUU-BOARD-SPEC（顶部 v6 横幅、§4.5 扩展板结论、§5 数量0、§6 电池不装）；明确布局A2=板在头部
    - 旧链接改指现行：robot-design README（安装→ASSEMBLY.md、接口→INTERFACE_GATES、模型→v6）、round-yaw README、TEST_GUIDE、EXTERIOR_ASSEMBLY_REVISION
    - 过时教程处理：PRINT_PLAN 全文替换为重定向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
2026-10-21 feat(firmware): ILI9341 LCD driver + lcd REPL; docs: 跨轴 11 根方案与少焊接线落地
    固件：
    - 新增 main/lcd_ili9341.c/.h：SPI2 20MHz，CS=10/DC=9/RST=14/MOSI=11/SCLK=12/BL=47；ILI9341 240x320 初始化、填色/彩条/背光
    - main.c 开机初始化并画彩条；provision 新增 lcd [bars|on|off|fill r g b]；CMakeLists/app_config 同步；idf.py build PASS
    硬件文档（方案 1）：
    - 跨轴由 9 根改为 11 根：麦/功放各一对 I2S；功放 SD 接 5V 常开、EN 不跨轴
    - 少焊接线方案：必焊仅两只 INMP441（各 5 线+L/R）与喇叭 2 点；其余全杜邦；第 29 步只插不焊
    - 同步 ASSEMBLY.md/图解版/AGENTS/BOM/INTERFACE_GATES/MEASURE-GUID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
2026-10-21 docs(hardware): 停止键接线改为二选一（焊 2 点 / 杜邦零焊），与少焊方案对齐；PDF 重出
    - 原步骤 9/§1.5 只写“两脚各焊一根线”，与“全杜邦/少焊”口径冲突
    - 改为：①焊 2 点最稳；②杜邦母头直插（0.6mm 方脚偏松，套热缩或点锡加粗/插后热熔胶点固）
    - 图解版与工程手册同步；两本 PDF 重出
2026-10-21 docs(hardware): 连接口径统一——全杜邦，唯一焊点=喇叭端 2（功放端焊盘则 +2）
    - 麦：P32 照用（针朝碗内凸出允许）+ 杜邦直插，L/R 跳线；撤销“贴壁/不用 P32”说法
    - 功放：杜邦 + SD→Vin 常开；按键：母头直插+热熔胶；供电：成品 USB-C 5V 转接线（E17 不装）
    - 图解/手册步骤 5/6/7/9/10、§1 展开、图鉴 P32 行、穿线措辞全部对齐；wiring-bench/BOM/README/HANDOFF 同步
    - 两本 PDF 重出
2026-10-21 docs(hardware): 图解 P32 行更正为“照用”（与全杜邦口径一致），喇叭焊点措辞对齐；PDF 重出
2026-10-21 docs: 新增 2026-10-21 装配实施方案（11 根跨轴/全杜邦/唯一焊点=喇叭/屏接线/今晚顺序），README 置顶入口
2026-10-21 docs(hardware): 图解/手册新增「接线总表」——按丝印逐脚对应（11 根编号、麦/功放/按键/舵机/屏/供电/头部）；各步骤引用总表；SD→Vin 行更正；PDF 重出
2026-10-21 docs(PDF): 图解版 20261021.pdf 用接线总表版替换（20 页）；移除重复 -new 文件
2026-10-21 docs(hardware): 接线总表加「每张表用在哪一步」索引（A–J→步骤）；步骤 8 舵机补「照总表 F」；图解 PDF 21 页、手册 PDF 重出；README 对齐页数与新增内容
2026-10-21 chore: 归档 5 个日期打印目录到 hardware/print-jobs/
    print-20261019、reprint-20261018、reprint-20261019-v6r3、
    today-20261019、today-20261020 自仓库根移入 hardware/print-jobs/，
    新增 README 索引；同步更新 HANDOFF/PLATE-RUNBOOK/PRINT-LESSONS/
    print-split-v6 README 及 plates-merged 盘卡中的链接与路径引用。
    根目录 result.json（切片器回执，gitignored）已删除。
2026-10-21 chore: 清理与装配/参赛无关的过程文件，修正旧口径残留
    删除（过程残留，19 个）：10-05 采购清单 stub、source-link-checks 回执、
    _show_*.png 临时截图×7、figma-wireframe-plugin、assets/wireframes（已被
    hifi-screens 取代）、enclosure 两个跳转 stub、MEASURE-GUIDE.pdf 重复导出、
    NEXT-STEPS.md（LCD 回填已完成）、P04_decimated.stl（减面 no-op 重复件）。
    归档（27 个 → docs/archive/handoff|product）：10-05 台架交接整组（含
    log/截图证据）、10-06 任务单组、10-10 设计交接 stub、整改/分工/D端任务书、
    旧版参赛建议 docx 及其生成器；新增 docs/archive/README.md 索引。
    口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
2026-10-21 chore: 移除 用户端APP（10.7） 交付入口目录
    目录唯一保留的 README 入口已失去意义（唯一维护源为 apps/web + services），
    历史快照可从 git 记录（如 0e35865）恢复；同步移除 .gitignore 豁免条款
    并更新 apps/web/README.md 的引用表述。
2026-10-21 docs: 重写 README 为项目门面页
    原 README 是日期公告的堆积（顶部三层 dated 块、路线A/B 重复两遍、
    历史交付与现行状态混杂）。重写为：定位+整机渲染 → 产品介绍 →
    快速开始 → 系统全景表 → 状态与边界 → 文档地图 → 协作约定。
    砍掉的内容均已在 docs/handoff 与 docs/archive 有落点。
2026-10-21 feat(site): 在议官网重设计、千问实验台与品牌口径统一
    - site/: Editorial × 工业设计静态官网，v6 模型高清渲染、连续交互叙事、技术边界标注、1440/390 响应式
    - apps/ai-demo/: Gradio + 真实 qwen-plus 三态判断，服务端证据校验、弃权、限流与 7 组自检
    - 品牌口径：在议 / effmeetbot；Demo、README 与 24 份文档统一，归档保留旧名
    - scripts/: 站点渲染、提交 ZIP、魔搭创空间部署
    - 验证：129 Python + 32 Node 测试通过；站点 0 横向溢出、图片与链接可载
2026-10-21 docs(submission): 官网与 AI 实验台验收截图（桌面/移动）
2026-10-21 feat(deploy): 发布魔搭官网与 AI 实验台，补真实调用记录
    - 官网: https://www.modelscope.cn/studios/CodyNing/effmeetbot
    - AI 实验台: https://www.modelscope.cn/studios/CodyNing/effmeetbot-ai
    - 真实 qwen-plus 三组结果：A=uncertain / B=responded / C=uncertain，未硬编码
    - 公网 Secret 注入 QWEN_API_KEY，实际调用 2.5s 通过契约校验
    - 129 Python + 32 Node + 7 Gradio 自检通过
2026-10-21 feat(local): 生成可双击打开的单文件官网、手机端全景与 AI 结果页
2026-10-21 feat(showcase): 三页面品牌统一与视觉精修
    - 官网：正式 effmeetbot Logo、深海军蓝+亮蓝、双 Demo 入口、三个价值、具身提醒时序
    - AI 快照：真实三态结果不改写，增加快照声明/在线入口/弃权解释，证据图裁切
    - 手机端全景：Logo/章节导航/390px 顶栏修复，10 张真实截图保留
    - 构建脚本与验收截图
2026-10-21 feat(submission): 主视频、16:9 封面、Spotlight 与表单填写稿
2026-10-21 feat(app): 手机端 UX/UI 精修与状态机修正
    - 品牌：正式 Logo、深海军蓝+亮蓝、语义色分离
    - 首页：加入会议优先、虚拟设备状态、最近会议、更多
    - 候选：未获回应措辞、说话人/时间、确认后已确认/模拟回执/时间线
    - 拒绝与过期：明确反馈、不可重复提交、显式重新校验
    - 会中：我的参与状态；地图：筛选与关系标签
    - 我的：套餐折叠降权；加入会议：粘性 CTA
    - 重新截图 12 张并重建手机端全景页；公网 Demo 已重新部署
2026-10-21 feat(brand): 在议蓝色角标、官网 APP 截图同步与手机端全景发布
    - 三页在议右上角加入品牌蓝角标
    - 官网交互章节替换为新版 APP 截图与文案
    - 官网/AI 增加手机端界面入口；mobile-ui.html 一并发布
    - 公网官网与 Demo 已更新为深蓝/亮蓝品牌
2026-10-21 docs: 74 秒成片、Spotlight 上线与提交记录
2026-10-21 feat(app): 功能版 apps/web 品牌与确认态同步
    - 正式 Logo/在议、深蓝亮蓝、候选文案与确认态
    - 41 前端测试 + 129 Python 测试通过
